binphilxiao/AxisLabs/GR0102/Certification/Doc provided/SmartShade Spec.md

**Model:** GR-0203
**Dimensions:** 1.8 x 1.8 x 5.1 in
**Power:** Optional 12V⎓2.0A Adapter (with 9 ft. cable)
**Operating Humidity:** 10% to 85%
**Compatibility:** #10 size beaded chain
**Weight:** 330 g
**Radio Frequency:** 2.4 -2.48GHz
**OS Requirements:** iOS - 16 or later, Android - 8.0 or later
**Connectivity:** Bluetooth LE
**Radio Power:** +8 dBm
**Operating Temperature:** 0°C to 40°C (32°F to 104°F)
**Supported Shade Sizes:** Up to 9 x 9 ft. or 10 lbs of weight
