binphilxiao/AxisLabs/RC0101&DC0101/Docs/Preliminary Industrial Design_Remote_BIN.pptx

## Remote Controller

Preliminary Industrial Design

## Slide 2

Front

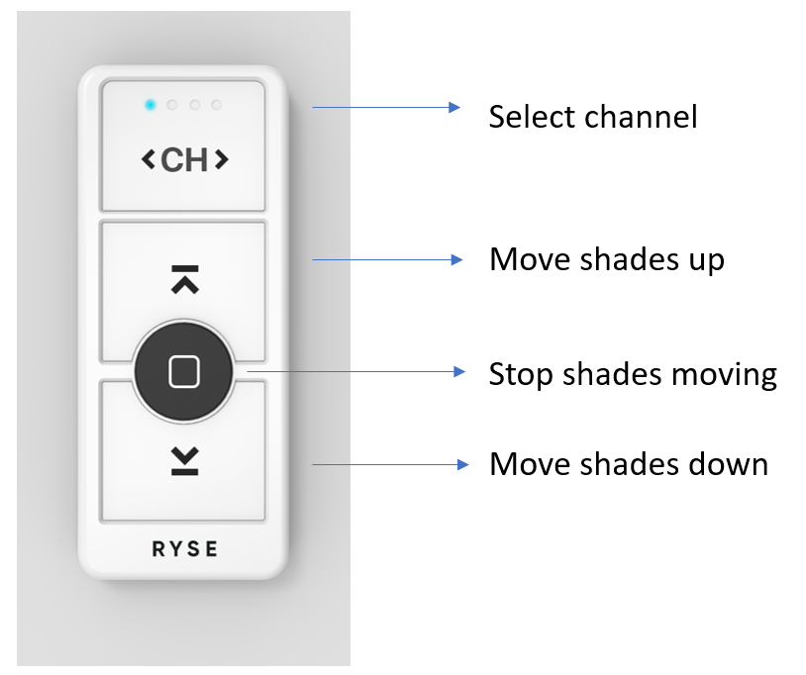
[picture p1: figure]

## Slide 3

Back

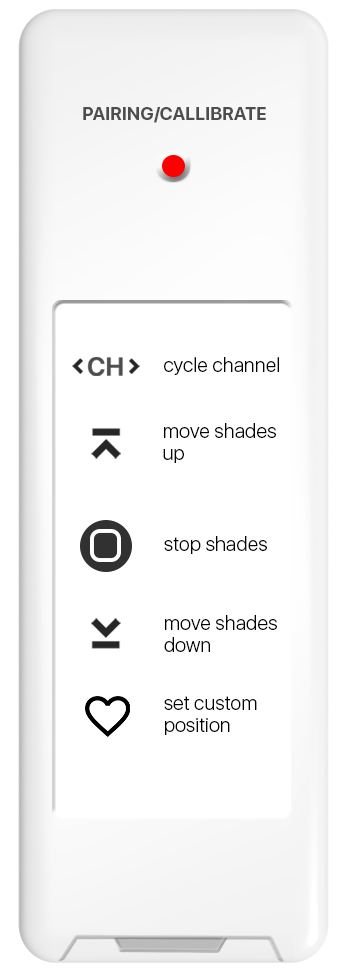
[picture p2: figure]

Reset button

Coin cell Battery Slot
(Doesn’t have to be here)
