binphilxiao/AxisLabs/PositionTracker/Fabric tracker.pptx

## Fabric tracker design thoughts

2024.05

## Inatallation

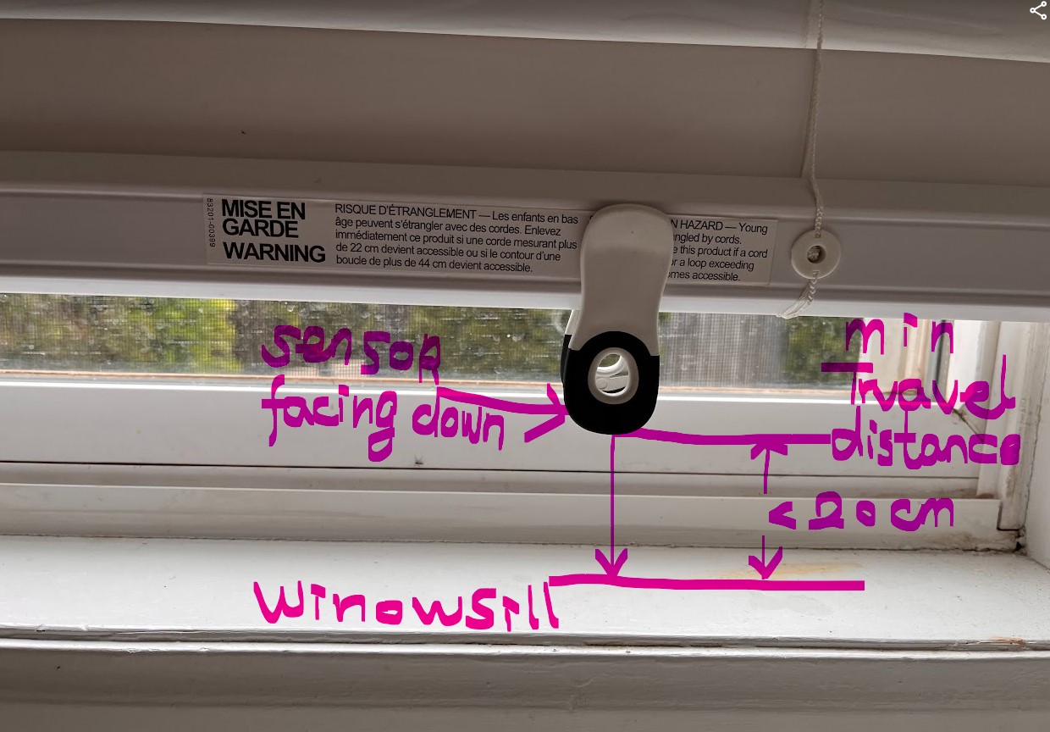
[picture p11: figure]

- Fabric tracker is installed on the bottom rod and looks like a clamp on the bottom rod.
- Time-of-flight sensor is facing down and measure the distance between the sensor and the window sill

## Operation

- Assume that the shade move 10cm/s.
- The sensor will measure the distance every 2S.
- The sensor will report each measure that is <=20cm to SmartShade and Smartshade can compensate.

## Diagram

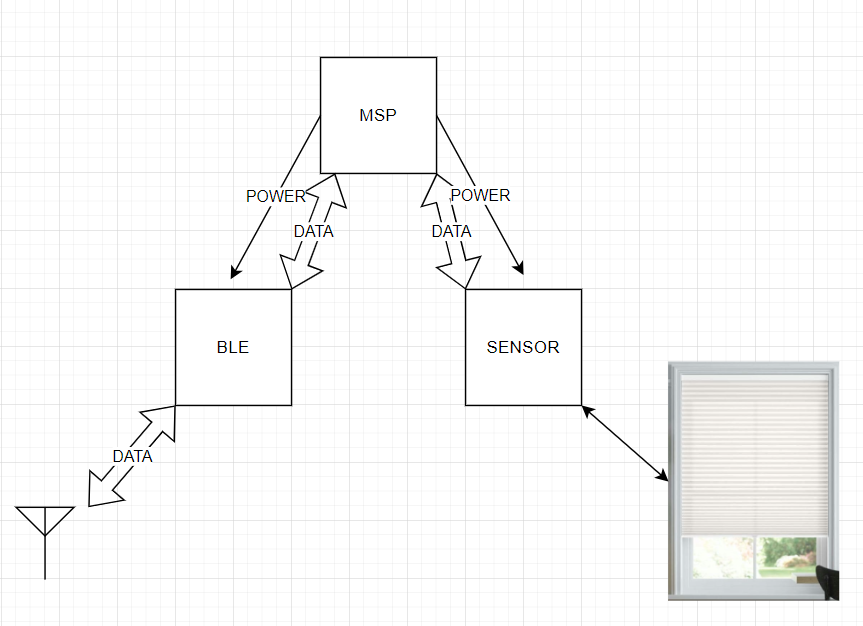
[picture p12: figure]

- MSP controls the power of BLE module and TOF sensor
- MSP get data from TOF and sent it through BLE to Smartshade

## Multi-host and other issues

- The Fabric tracker will be a host in BLE connection.
- Conflicts when Fabric tracker try to sent message and SmartShade is connected to a Mobile, Bridge or Remote ???
- Maybe message sent via broadcasting ???

## TOF sensor

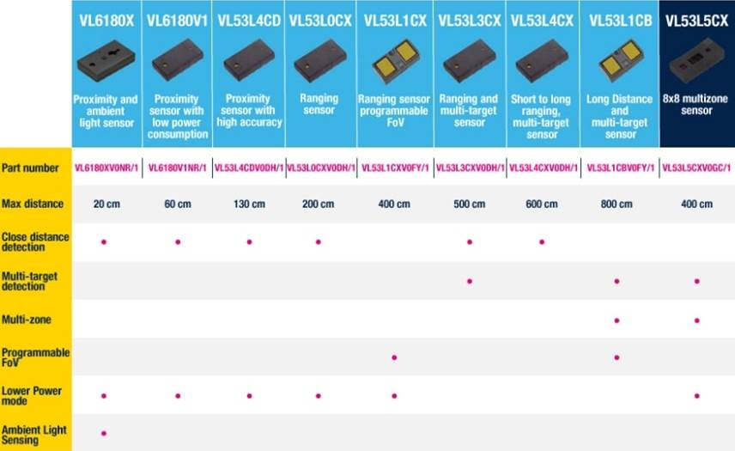
[picture p13: figure]

## BLE module

- ESP32-C3 single chip
- ESP32-C3-MINI-1-N4
- ESP32-C3-WROOM-02

## Power consumption

- Power consumption of TOF sensor(2s interval)
- Power consumption of BLE module(ESP32-C3-WROOM-02U-N4).
(it only works when d <20 cm is detected and only report once.)
- Power consumption of MSP MCU(MSP430FR2311 as example)
standby all the time

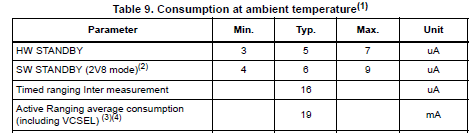
[picture p14: figure]
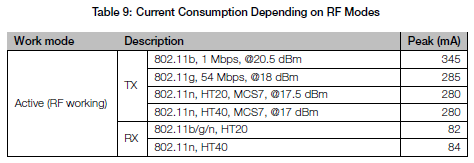
[picture p15: figure]

## Cost estimate

- ESP32-C3-WROOM-02U-N4
- VL53L0X
- MSP
- A boost converter
- Battery
- Plastic

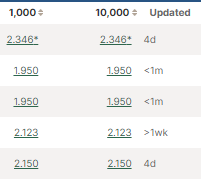
[picture p16: figure]
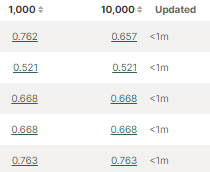
[picture p17: figure]

## The other way to communicate

- Fabric tracker is a z-wave like accessary. It attaches the Smartshade and use MFP to communicate.
- The sensor detect if the window shade is blocking or not.
- It save the money spend on BLE module and batteries.

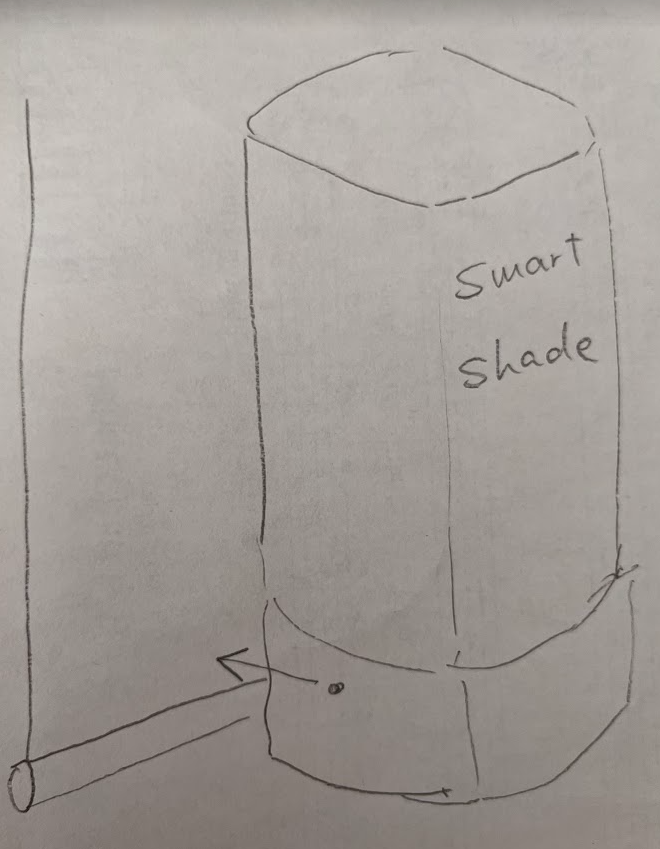
[picture p18: figure]

## Use a buzzer or ultrasound to communicate

- We need to modify Smartshade
- Can not share time stamp and other details?

## Design support

- FW
  - FW in SmartShade monitors messages from Fabric tracker.
  - Decode timestamp and sensor value.
  - Do necessary smooth and average.
  - Estimate speed of window shade.
  - Do compensation
- ID
  - Concepts
- Mechanical
  - Mechanical design, demo, tooling
- Mobile
  - At configuration state, Mobile scan a code on Fabric tracker(maybe MAC)
  - Sync time stamp, position, and speed.
