binphilxiao/AxisLabs/GR0102/Certification/Doc provided/Submitted/QB-Pub-7.1-013-8 化学开案申请表 (通用) RoHs WEEE.docx

以下内容为倍科内部填写： Fill in the item below by BACL only | | Report No.报告号:
Test Start Date测试开始日期： | | Sales Name 销售代表： | | Check By 审核：
Committed Day 结 案 日 期： | | Ext. 分机号： | | Quo. No. 合同号：
CS 客服部确认（样品状态）： | | Accountant财务部确认： | | Engineering工程部确认：

以下内容请客户填写Fill in the item below by customer

Report Required 报告要求 [ ] English 英文 [ ] Chinese中文 [ ] English and Chinese comparison中英文对照 | | | | “” means must be filled items. one application form one report “”号处为必填项目，一份申请表对应一份报告； Default english report, RMB 200 reporting surcharge will be billed if request Chinese-English report. Fax, copy of the application both valid, our test result only responsible for submitted samples. 默认为英文报告，如增加中英文报告，加收200元报告费。该申请表传真件、复印件均有效，实验室的测试结果只对来样负责。
Company Name | RYSE Inc. 公司名称：
Address： | 20 Camden St. Suite 200, Toronto, Ontario, M5V 1V1 Canada 公司地址：
Contact Person联系人： Trung Pham | | | | | Telephone电话/ Fax传真： +1(929)219-3299 / +1(877)563-5047 | | | | E-Mail 电子邮件：support@helloryse.com

请填写以下样品信息：Please test the sample identified as below :

声明Declaration：送测的样品具有Sample Properties: [ ] 危险性Dangerous [ ] 腐蚀性Corrosive [ ] 毒性Toxicity [ ] 易燃易爆Iinflammable and Explosive [ ] 放射性Radioactivity [ ] 其他Others 请注明Pls Specify：_______

测试样品量Sample Weight：[ ] 部件Component：Cd/Pb/Hg (20g/sample)；Cr⁶⁺ (100cm² /sample)；PBBs&PBDEs (20g/sample) [ ] 整机Whole machine：more than 2Sets 2套以上
Sample Description 样品描述: | | | Style/Item No. 型号： | | | | | P.O. No. 订单号：
Sample quantity样品数量： | | | Country of Origin 原产地： | | | | | /Country of Destination 目的地：
Supplier供应商： | | | Manufacturer制造商： | | | | | Buyer买家： Brand 品牌商：

如果您的报告还需要注明其他项目，请说明： If you need other items in report, please specify

Test Required测试项目：(请在所需测试项目前打“[x] ”，以下项目如有指定测试方法请注明). 请务必提供不少于指定重量（或表面积）的样品以避免因样品不足补样而造成的时间损失。Please draw[x] In your choice items and .specify the test method in the following items for your special requirements. pls supply no less than specified sample weight to avoid to waste test time due to sample shortage.

测试的方法/标准test method(请在相应的前面打“[x] ”,如果没有指定，默认为IEC 62321。Please draw [x] on your choice method, default method is IEC 62321.)

[x] IEC 62321 [ ] US EPA [ ] SJ/T 11365:2006 [ ] SN/T2004 [ ] ISO 3613 [ ] GB/T26125:2011[ ] GB/T20155:2006 [ ] GB/T26572-2011[ ] Others其它

[x] RoHS directive指令(请在相应的测试项目前打“[x] ” Please draw [x] on your choice items)

[ ] XRF Scan 扫描测试：[ ] Cd镉: [ ] Pb铅；[ ] Hg汞； [ ] Cr铬； [ ] Br溴； [ ] All所有五项 [ ] Others 其他

[ ] Chemical test化学测试：[ ] RoHS 两项：PBBs多溴联苯；PBDEs多溴二苯醚 [ ] RoHS 四项：Cd镉；Pb铅；Hg汞；Cr⁶＋六价铬 [ ] RoHS六项：Cd镉；Pb铅；Hg汞；Cr⁶＋六价铬；PBBs多溴联苯；PBDEs多溴二苯醚 [ ] RoHS十项：Cd镉；Pb铅；Hg汞；Cr⁶＋六价铬；PBBs多溴联苯；PBDEs多溴二苯醚；DEHP邻苯二甲酸二(2-乙基己基)酯；BBP邻苯二甲酸丁苄酯；DBP邻苯二甲酸二丁基酯；DiBP邻苯二甲酸二异丁基酯[ ] XRF Scan 扫描+Chemical test化学测试: [ ] ROHS1.0（6 项）； [ ] ROHS2.0（10项）；[ ] Others 其他

[x] WEEE directive指令

[ ] EC No. 1907/2006 REACH regulation SVHC高度关注物质

[ ] Other Chemical test items(as below) 其他化学测试项目(如下)：

[ ] SCCP 短链氯化石钠 [ ] HBCDD 六溴环十二烷 [ ] PAH 多环芳香烃（[ ] 8种/[ ] 18种）[ ] TBBPA 四溴双酚A [ ] BPA 双酚A [ ] PFOA, PFOS全氟辛酸铵/全氟辛烷磺酸盐 [ ] 欧盟电池指令(2006/66/EC) [ ] 94/62/EC欧盟包装指令 [ ] PCBs 多氯联苯 [ ] Halogen 卤素（[ ] F/ [ ] Cl/ [ ] Br/ [ ] I） [ ] 美国电池指令（HR.2024））[ ] TPCH/CONEG美国包装指令 [ ] Be content 铍含量 [ ] Hg content 汞含量 (SOR/2014-254) [ ] Others 其他

[x] CA65 加州65法案: [ ] Pb铅 [ ] Cd镉 [ ] Phthalates 邻苯二甲酸盐 P

[ ] Organotin 有机锡 : [ ] TBT 三丁基锡 [ ] 二丁基锡DBT [ ] 一丁基锡MBT [ ] TPhT三苯基锡 [ ] others:TTBT / MOT / DOT / TPT / TCyT / MPhT / DPhT / TOT

判定规则Decision Rule：[ ] 不需要判定No Need

[ ] 根据申请商提供的判定规则According to the rule provided by the applicant. (是否考虑不确定度consider the uncertainty or not：[ ] 否No [ ] 是Yes)

[x] 根据产品法规According to Product Regulations（是否考虑不确定度consider the uncertainty or not：[x] 否No [ ] 是Yes）

Service Required 服务类型：(请在相应选择上打“[x] ”，普通测试星期六，日及节假日不计入工作日内 Saturday, Sunday and holiday not count in workdays)

仅化学测试周期：[x] Regular Service, 5 workdays标准服务, 5个工作日完成; [ ] Express Service (50%Surcharge), 3 workdays加急服务, 加收50%费用, 3个工作日完成; [ ] Emergency Service(100% Surcharge), 1.5 workdays特急服务, 加收100%费用, 1.5个工作日完成;

扫描和扫描+化学测试周期（依据实际样品）：[ ] 7 workdays 7个工作日 [ ] 8 workdays 8个工作日 [ ] 9 workdays 9个工作日 [ ] 其它others：

Report Delivery取报告方式：[x] self Pick-up自取 [ ] express快递(预收费RMB：15) [x] E-mail 邮件__bin@helloryse.com____

Report Delivery To 报告寄往(中文)：bin@helloryse.com Return Sample样品退回： [x] Yes [ ] No

同意倍科集团内分包Agree with subcontracting within BACL Group if need: [x] 是Yes [ ] 否 No
Authorized Signature 申请人签名(盖章)： | | | | | | Date 日期：

※ 客户必须保证所提供的测试样品材质与最终销售产品材质的一致性，否则，本公司不负任何责任！Customer must ensure the submitted sample is consistent with the final products placed in the market, or else , BACL will not be liable for any responsibility. Version 2.0 （2019-09-17） Page 1 of 1 QB-Pub-7.1-013-1

CHEMICAL TESTING APPLICATION FORM 化学测试申请表(电子电器产品)
