binphilxiao/AxisLabs/BR0101/doc/MFI343S00177-L_Mechanical.pdf

... ‘

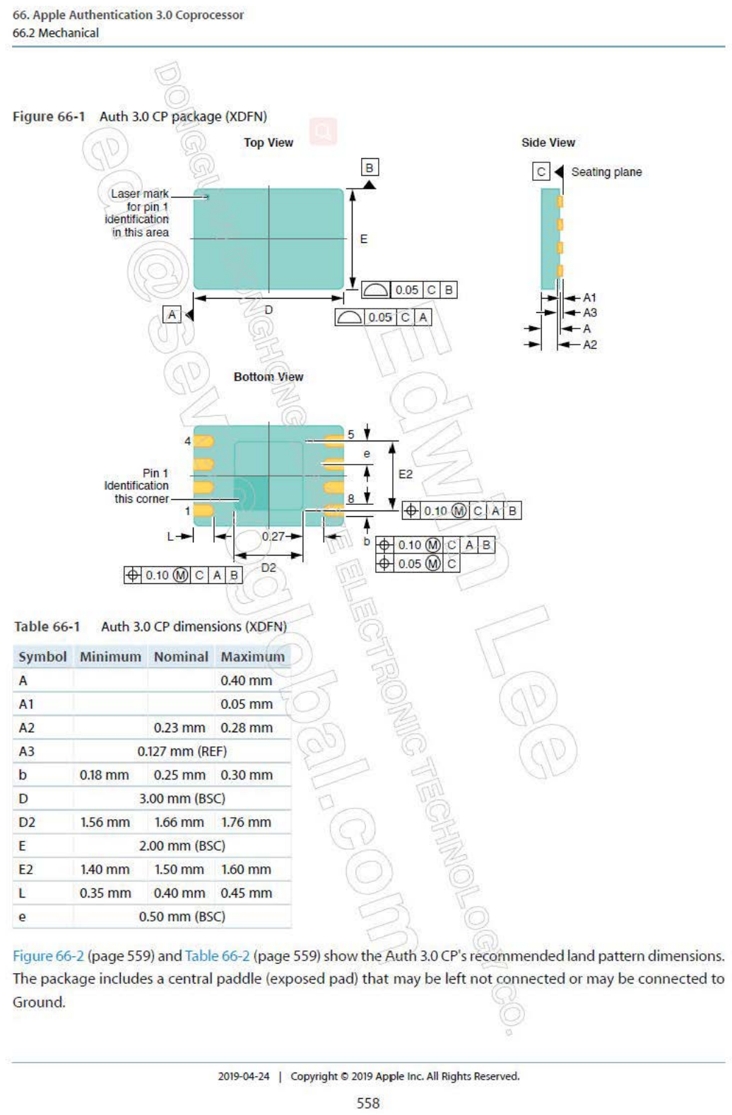
[picture p19: page 1]

66. Apple Authentication 3.0 Coprocessor 66.2 Mechanical

Figure 66·1Auth3.OCPRqEHage {XDFN}

F Laser"mruk ----1!::
10r pin 1 r
identifîcation
his rea

TOp View

BottorÍ1 View

E

### lol o.05 ~

U~1 905 I>.

I

Table 66-1 Auth 3.0 CP dimensions (XOFN)

Symbol Minimum Non>inal Maximum
A | 0.40mm . A1 | 0.05 mm
A2 | 0.23 mm 0.28mm
A3 | 0.127 mm (REF)
b | 0.18 mm | 0.25 mm 0.30 mm
D | 3.00 mm (B5C)
02 | 1. 56 盯1m | 1.66 mm 1.76 mm
E | 2.00 mm (BSC)
E2 | 1.40 1m | 1.50 mm 1.60 町、
L | 0.35 mm | 40 町、 | 0.45mm
e | 0.50 mm (BSC)

Side

plane

Figure 66.2 (page 559) and Table 66-2 (page 559) show the 8uth 0ζp s rRFDmmended |and pattem dimensions-The package includes a central pacldle (exposecl pacl) that may be left not connected or may be connect ecl to Grouncl.

01 9-04剖 | Copyrìght Q 2019 Appl. 10(. AIl Rìghts Reserved
| 558

xt 8

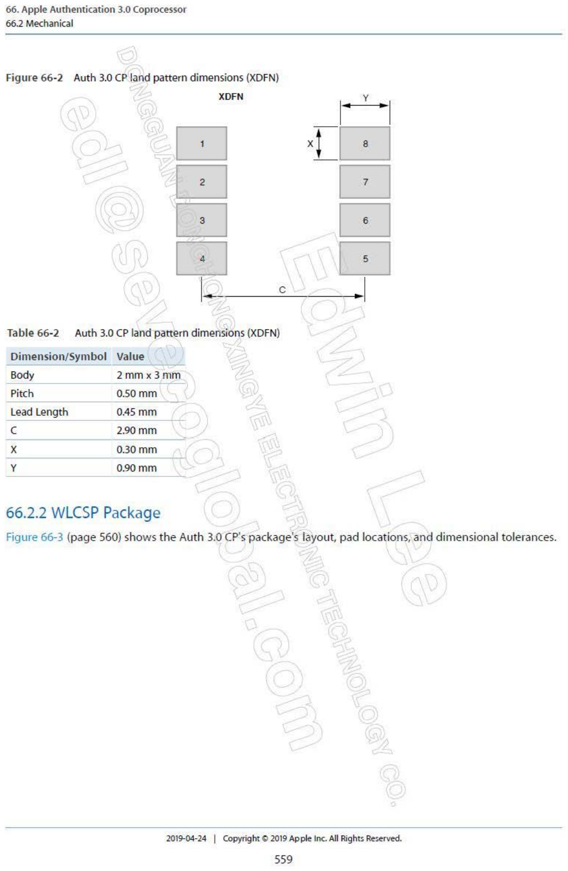
[picture p20: page 2]

66. Apple Authentication 3.0 Coprocessor 66.2 Mechanical

Figure 66.2 Auth 3.0 CP lal1d ern dimensions (XDFN) XDFN

ι

，飞
Table 66.2 | Auth 3.0 CP land p': | rn dimensions (XDFN)

Dimension/Symbol Value
Body | 2 mm x 3 mm
Pitch
Lead Length
c

X
Y

0.50 mm
0.45 mm
2.90 mm

0.30 IT飞
0.90 mm

## 66.2.2 WLCSP Package

Figure 66-3 (page 560) shows the Auth 0ζ s | ag | làyout pad locations,.and dimensional tolerances.
争饵 | ζ0 rig | Q 2019 Appl. 1n(. AII Rights Reserved.
| | 559
