binphilxiao/AxisLabs/ZW0101/2024.08-ZwaveTestJig/doc/PinoutName.pdf

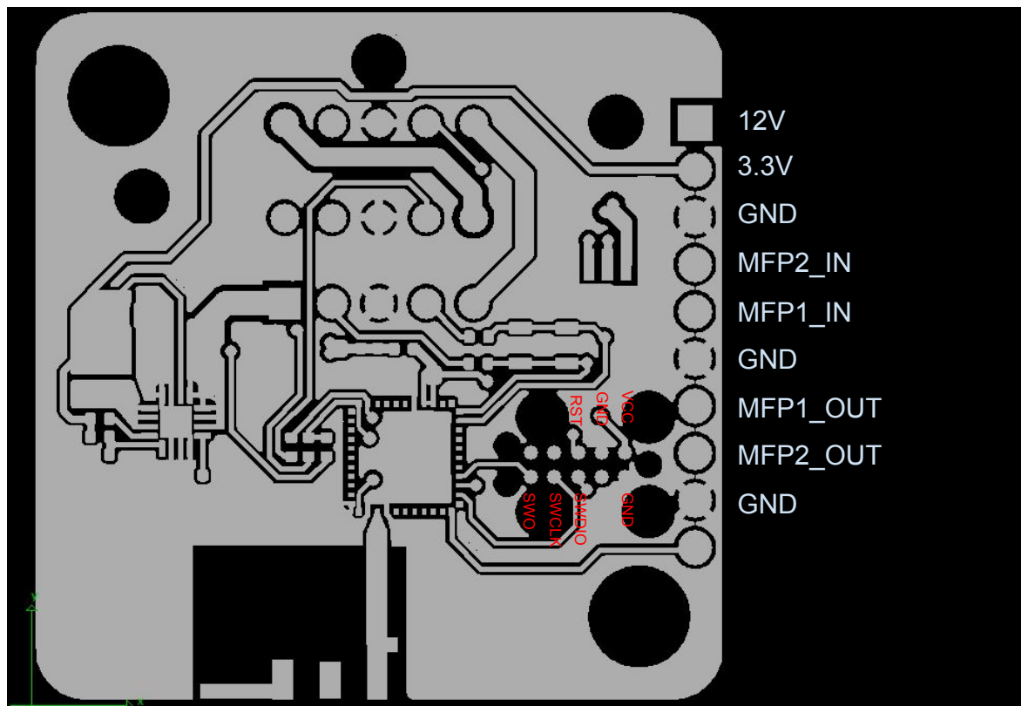
[picture p21: page 1]

12V

3.3V

MFP1_IN

GND

MFP1_OUT

MFP2_IN

GND

GND

MFP2_OUT

RST

GND

VCC

SWO

SWCLK
SWDIO

GND
