binphilxiao/AxisLabs/GB0102/2025.09.11_Rev.F/CN3303.pdf

# 如韵电子 CONSONANCE

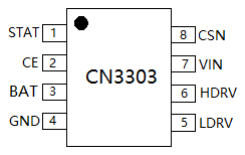
[picture p23: figure]

www.consonance-elec.com | 1 | REV 1.1

# PFM 升压型三节锂电池充电控制集成电路

CN3303

概述：

CN3303是一款工作于2.7V到6.5V的PFM升压型三 节锂电池充电控制集成电路。CN3303采用恒流和
准恒压模式(Quasi-CVTM)对电池进行充电管理，内 部集成有基准电压源，电感电流检测单元，电池
电压检测电路和片外场效应晶体管驱动电路等，
具有外部元件少，电路简单等优点。
当接通输入电源后，CN3303进入充电状态，控制
片外N沟道MOSFET导通，电感电流上升，当上升
到外部电流检测电阻设置的上限时，片外N沟道
MOSFET截止，电感电流下降，电感中的能量转
移到电池中。当电感电流下降到外部电流检测电
阻设置的下限时，片外N沟道MOSFET再次导通，
如此循环。当BAT管脚电压第一次达到内部设置
的12.6V(典型值)时，CN3303进入准恒压充电模 式，以较小电流对电池充电。只有当BAT管脚电
压第二次达到12.6V时，充电过程才结束，片外N
沟道MOSFET保持截止状态。当BAT管脚电压下
降到再充电阈值时，CN3303再次进入充电状态。
CN3303最高工作频率可达1MHz，工作温度范围
从－40℃到＋85℃。
当电池电压低于输入电压或电池短路时，CN3303
在片外N沟道MOSFET和P沟道MOSFET的共同作 用下，用较小电流继续对电池充电，对电池起到
保护作用。
其他功能包括芯片使能输入，状态指示输出端等。
CN3303采用8管脚的SOP8封装。

应用：

⚫ | 三节锂电池充电控制
⚫ | 按摩机，筋膜枪等
⚫ | 音响
⚫ | 独立充电器

特点：

⚫ | 输入电压范围：2.7V 到 6.5V
⚫ | 工作电流：280微安@VIN=5V
⚫ | 电感电流检测
⚫ | 高达1MHz开关频率
⚫ | 准恒压充电模式补偿电池内阻和电池连接线
| 电阻产生的电压损失
⚫ | 自动再充电功能
⚫ | 高达35W输出功率
⚫ | 当电池电压低于输入电压或者电池短路时，
| 以较小电流充电。
⚫ | 输入电源的自适应功能
⚫ | 芯片使能输入端
⚫ | 电池端过压保护
⚫ | 状态指示输出
⚫ | 工作温度范围：－40℃到85℃
⚫ | 8管脚SOP8封装
⚫ | 产品无铅，满足rohs指令要求，不含卤素

## 管脚排列图：

注：Quasi-CV 是如韵电子注册商标

## 典型应用电路：

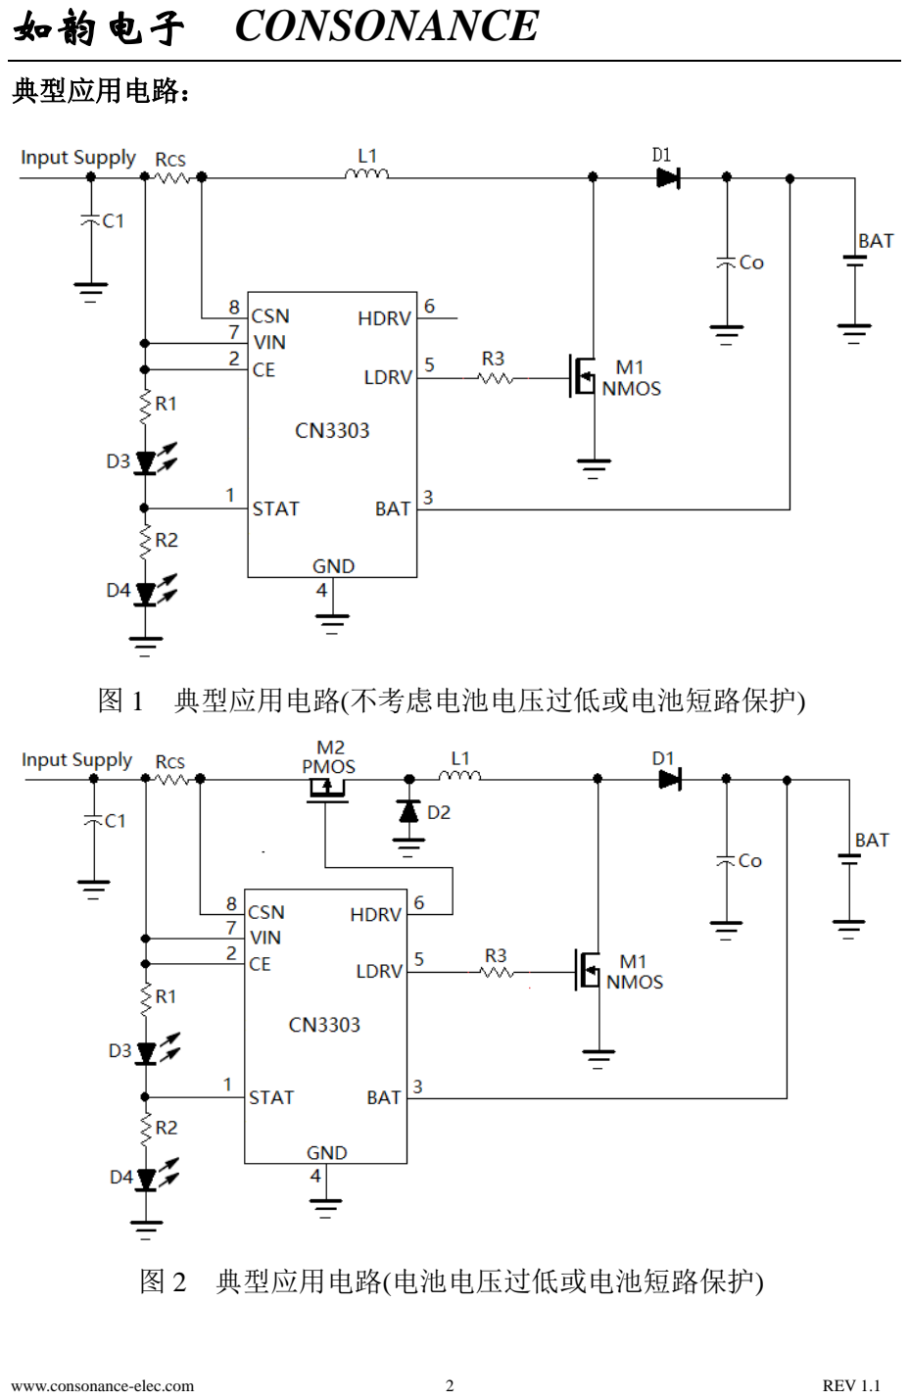
[picture p24: page 2]

www.consonance-elec.com | 2 | REV 1.1

## 图 1 典型应用电路(不考虑电池电压过低或电池短路保护)

## 图 2 典型应用电路(电池电压过低或电池短路保护)

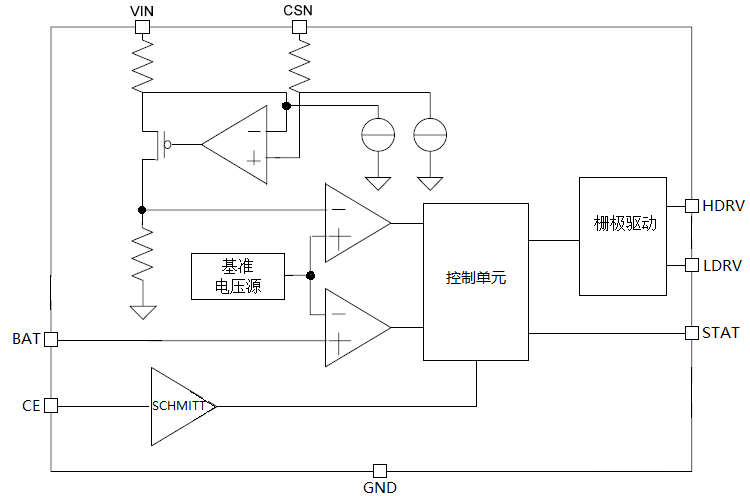
[picture p25: figure]

www.consonance-elec.com | 3 | REV 1.1

## 订购信息：

器件型号 | 封装形式 | 包装 | 工作环境温度
CN3303 | SOP-8 | 盘装，每盘 4000 只 | －40℃ 到 85℃

## 功能框图：

## 图 3 功能框图

www.consonance-elec.com | 4 | REV 1.1

## 管脚描述：

序号 | 名称 | 功能描述
1 | STAT | 充电状态指示输出端。CMOS输出端，当此管脚为高电平时，表示充电器 处于充电状态；当此管脚为低电平时，表示充电器处于充电结束状态。
2 | CE | 芯片使能输入端。高输入电平将使CN3303处于正常工作状态；低输入电平 使CN3303处于被禁止状态。 CE管脚可以被TTL电平或者CMOS电平驱动。
3 | BAT | 电池电压反馈输入端。此管脚直接连接到电池正极以检测电池电压。
4 | GND | 电源地。输入电源和电池的负极。
5 | LDRV | 片外N沟道功率管栅极驱动端。连接到外部N沟道场效应晶体管（MOSFET） 的栅极。
6 | HDRV | 片外P沟道功率管栅极驱动端。连接到外部P沟道场效应晶体管（MOSFET） 的栅极。 当不需要考虑电池电压过低保护或者电池端短路保护时，不需要使用外部 的P沟道场效应晶体管，此管脚悬空即可。
7 | VIN | 电源正输入端。VIN管脚为CN3303内部电路提供工作电源，同时也是电感 电流 (输入电流)检测的正输入端。
8 | CSN | 电感电流检测负输入端。在VIN管脚和CSN管脚之间接一个电流检测电阻 RCS，用以检测电感电流 (输入电流)。正常工作时，(VIN－CSN)的上限为 125毫伏(典型值)，下限为85毫伏(典型值)。

## 极限参数

VIN，CSN 和 CE 管脚电压 | －0.3V to 7.0V | 最大结温 | 150℃
BAT 管脚电压 | －0.3V to 18V | 工作温度范围 | －40℃ to 85℃
CSN 与 VIN 管脚电压 | －0.3V to 0.3V | 存储温度 | －65℃ to 150℃
STAT，LDRV 和 HDRV 管脚电压.. －0.3V to VIN | 焊接温度(10 秒) | 260℃

超出以上所列的极限参数可能造成器件的永久损坏。以上给出的仅仅是极限范围，在这样的极限条件下 工作，器件的技术指标将得不到保证，长期在这种条件下还会影响器件的可靠性。

www.consonance-elec.com | 5 | REV 1.1

## 电气参数：

(VIN = 5V，TA＝－40°C to +85°C，典型值在 TA＝+25°C 时测得，除非另有说明。)
参数 | 符号 | 测试条件 | 最小 典型 最大 | 单位
输入电压范围 | VIN | | 2.7 6.5 | 伏特
工作电流 | IVIN | VBAT＝12.9V，No Switching | 200 280 360 | 微安
关断电流 | Ioff | CE管脚低电平 | 0 2 | 微安
开关频率 | fSW | | 200 1000 | KHz
电感电流检测比较器
检测电压高端阈值 | VCSHI | 恒流 | (VIN－VCSN) 从0V上 升，直到 VLDRV ＜0.5V | 113 123 133 | 毫伏
| | 准恒压 | | 65 75 85
检测电压低端阈值 | VCSLO | 恒流 | (VIN－VCSN) 从0.2V 下降，直到 VLDRV＞ (VCC－0.5V) | 77 87 97 | 毫伏
| | 准恒压 | | 32 42 52
输出高电平传输延时 | tDPDH | (VIN－VCSN)：0.15V到0.075V | | 72 | 纳秒
输出低电平传输延时 | tDPDL | (VIN－VCSN)：0.06V到0.135V | | 66 | 纳秒
CSN管脚输入电流 | ICSN | | | 1 | 微安
BAT管脚
BAT管脚充电终止阈值 | Vterm | BAT管脚电压上升 | 12.478 12.6 12.726 | 伏特
BAT管脚再充电阈值 | Vrech | BAT管脚电压下降 | 11.95 12.14 12.33 | 伏特
BAT管脚电流 | IBAT | VBAT＝12.6V | 10 14 18 | 微安
电池过压保护阈值 | VOV | BAT管脚电压上升 | 1.044 1.0663 1.088
| VOVRLS | BAT管脚电压下降 | 1.003 1.0249 1.047 | %Vterm 电池过压释放阈值

LDRV管脚
LDRV管脚输出电流 | | VCSN＝VIN, VDRV＝0.5×VCC | 0.65 | 安培
LDRV管脚下拉电流 | | VCSN＝VIN－0.2V， VLDRV＝0.5×VCC | 0.65 | 安培
LDRV输出高电平 | VOH | ILDRV＝5mA | VCC－0.3 | 伏特
LDRV输出低电平 | VOL | ILDRV＝－5mA | 0.3 | 伏特
HDRV管脚
HDRV管脚输出电流 | | VCSN＝VIN, VDRV＝0.5×VCC | 0.8 | 安培
HDRV管脚下拉电流 | | VCSN＝VIN－0.2V， VHDRV＝0.5×VCC | 0.8 | 安培
HDRV输出高电平 | VOH | IHDRV＝5mA | VCC－0.3 | 伏特
HDRV输出低电平 | VOL | IHDRV＝－5mA | 0.3 | 伏特
CE管脚
输入低电平 | VCEL | CE电压下降 | 0.7 | V
输入高电平 | VCEH | CE电压上升 | 2.2 | V
输入电流 | ICEL | CE=GND，VIN=6V | －1 | 微安
| ICEH | CE=VIN=6V | 1
STAT管脚
下拉电流 | ISINK | VSTAT=0.3V，结束模式 | 10 | mA
输出电流 | ISRC | VSTAT=4.7V，充电模式 | 10 | mA

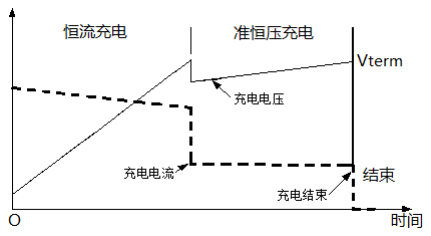
[picture p26: figure]

www.consonance-elec.com | 6 | REV 1.1

## 详细描述：

CN3303是一款PFM升压型三节锂电池充电控制集成电路。CN3303输入电压范围2.7V到6.5V，内部集成有 基准电压源，电感电流检测单元，电池电压检测电路，输出过压保护电路，电池电压过低保护单元，控 制单元和片外场效应晶体管驱动电路等，非常适合5V输入，为三节锂电池的充电控制应用，具有外部元 件少，功能多，电路简单等优点。
当接通输入电源后，CN3303进入充电状态，STAT管脚输出高电平，片外N沟道场效应晶体管导通，电感 电流上升，输出电容中的能量转移到电池中。当电感电流上升到外部电流检测电阻设置的上限时，片外N 沟道场效应晶体管截止，电感电流下降，电感中的能量转移到输出电容和电池中。当电感电流下降到外 部电流检测电阻设置的下限时，片外N沟道场效应晶体管再次导通，如此循环。电池电压经过芯片内部的 电阻分压网络反馈到电压比较器，当BAT管脚电压第一次达到12.6V(典型值)时，经过去抖动延时后， CN3303进入准恒压充电状态，输入电流降低到恒流时的60%，所以充电电流也降低。当电池电压第二次 达到12.6V时，经过去抖动延时后，充电过程结束，片外N沟道MOSFET截止，CN3303进入充电结束状态， STAT管脚输出低电平。在充电结束状态，没有电流从输入端流向电池。当BAT管脚电压下降到再充电阈 值12.142V(典型值)时，CN3303再次进入充电状态。CN3303最高工作频率可达1MHz。 CN3303为升压型充电控制集成电路，正常情况下，电池电压高于输入电压。在某些情况下，如果电池电 压低于输入电压，甚至电池短路，那么片外N沟道场效应晶体管关断时间延长，充电电流变小，对电池起 到保护作用。
其他功能包括芯片使能输入端，BAT管脚过压保护等。

充电过程如图4所示。

## 图4 充电过程示意图

www.consonance-elec.com | 7 | REV 1.1

## 应用信息：

输入电压范围
CN3303 在输入电压在 2.7V 到 6.5V 的范围内均能正常工作。CN3303 内部有输入电源低电压检测电路， 如果输入电压小于 2.65V(最大值)，那么 CN3303 被关断。
芯片使能／关断
当 CE 管脚电压低于 0.7V 时，CN3303 被关断。为了使 CN3303 正常工作，在 CE 管脚需要施加 2.2V 以 上的电压。当 CN3303 被关断时，芯片内部电路被关断。
不要在 CE 管脚施加 0.7V 到 2.2V 电压，否则将使 CN3303 处于不确定状态，并消耗比较大的电流。 关于准恒压（Quasi-CV）充电模式
CN3303 先以恒流模式对电池充电，当电池(BAT 管脚)电压第一次达到充电终止电压 12.6V(典型值)时， CN3303 进入准恒压模式，此时输入电流降低到恒流时的 60%，所以充电电流变小，此时 CN3303 继续 对电池充电，直到电池电压再次达到充电终止电压 12.6V 时，经过去干扰延时后，CN3303 才结束充电。 此充电过程可以部分补偿电池内阻和电池连接线的电阻等引起的电压损失，类似于通常的恒压充电过程， 所以称为准恒压充电过程。
电感电流(输入电流)
在图1和图2所示的电路中，CN3303通过连接在VIN和CSN管脚之间的电流检测电阻RCS设置电感电流。 当外部N沟道场效应导通时，输入电源向电感充电，电感电流上升，当电感电流上升到(典型值)：
ILhigh = 0.123V / RCS | （恒流模式）
ILhigh = 0.075V / RCS | （准恒压模式）
外部N沟道场效应晶体管截止，电感电流开始下降，电感中的能量转移到输出电容和电池中。当电感电流 下降到(典型值)：
ILlow = 0.087V / RCS | （恒流模式）
ILlow = 0.042V / RCS | （准恒压模式）
外部N沟道场效应晶体管再次导通，开始新的周期。
所以，电感平均电流为： | IL = 0.105V / RCS | （恒流模式）
| IL = 0.06V / RCS | （准恒压模式）
在上面的三个公式中，
ILhigh是电感电流上限，单位是安培(A)
ILlow是电感电流下限，单位是安培(A)
RCS是电感电流检测电阻值，单位是欧姆(Ω)
计算开关频率和电感值
在图1所示的应用电路中，外部N沟道场效应晶体管导通时间为：

外部N沟道场效应晶体管截止时间为：

所以CN3303开关频率为：

www.consonance-elec.com | 8 | REV 1.1

CN3303要求根据上式计算的开关频率不小于200KHz。一般开关频率选择在300KHz到600KHz之间可以达 到比较好的转换效率和电感尺寸平衡。
开关频率随着输入电压和电池电压的变化而变化，所以在确定开关频率时，电池电压选用标称电压11.1V。 根据输入电压范围，充电电流和开关频率的要求，一般电感值在4.7uH与22uH之间可以满足要求。 CN3303的LDRV管脚输出脉冲信号占空比为：

在上面的两个公式中，L为电感值，单位为亨利（H）
VIN为输入电压，单位为伏特（V）
VBAT为电池电压，单位为伏特（V）
VD为二极管D1的正向导通电压，单位为伏特（V）
RCS为电感电流检测电阻，单位为欧姆(Ω)
估算恒流模式充电电流
CN3303是通过监测电感电流（输入电流）而控制充电电流，所以恒流模式充电电流会随输入电压和电池 电压的变化而变化。
一般情况下，可通过下面的公式估算恒流模式充电电流：

其中， ICH是流向电池的充电电流，单位为安培(A) VIN是输入电压，单位为伏特(V) IL是电感平均电流，为0.106／RCS，单位为安培(A) η是转换效率，一般在80%到90%之间，可取典型值85% VBAT是电池电压，单位为伏特(V)

充电结束
当 BAT 管脚电压达到 12.6V(典型值)时，充电过程结束，片外 N 沟道场效应晶体管截止，CN3303 进入 充电结束状态。在充电结束状态，没有电流从输入端流向电池。
再充电
在充电结束状态，当 BAT 管脚电压下降到再充电阈值 12.14V(典型值)时，CN3303 再次进入充电状态。 N沟道MOSFET的选择
CN3303需要使用一个外部N沟道场效应晶体管。选择场效应晶体管应考虑最高电池电压，电感电流，开 启电压，导通电阻和栅极总电荷等因素。MOS场效应晶体管的击穿电压应该大于最高电池电压；较低的 导通电阻和较低的总栅极电荷(Qg)有助于提高效率；开启电压要保证MOS场效应晶体管在工作电压最低 端仍能完全导通。
二极管的选择
为了提高效率，在图1和图2中的二极管D1的正向导通电压要尽量低，最好使用肖特基二极管；二极管通 过电流能力要比充电电流大；击穿电压要大于最高电池电压。 图2中的二极管D2只在输入电压大于电池电压的情况下才使用，此时电感电流明显降低。所以二极管D2 的正向导通电压要尽量低，最好使用肖特基二极管；二极管通过电流能力要比电感电流大；击穿电压要 大于最高输入电压。
输入电容
电源输入端VIN和地之间需要接一个至少为4.7微法的陶瓷滤波电容(图1和图2中的C1),如果电感电流比 较大，或者输入电源的输出阻抗比较大，或者输入电源连接导线比较长，电容值要相应增加；电容的耐 压应高于最大输入电压。一般输入电容值在4.7uF到47uF之间，在频率为1MHz时具有比较低的阻抗。推

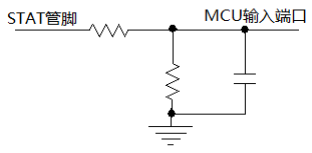
[picture p27: figure]
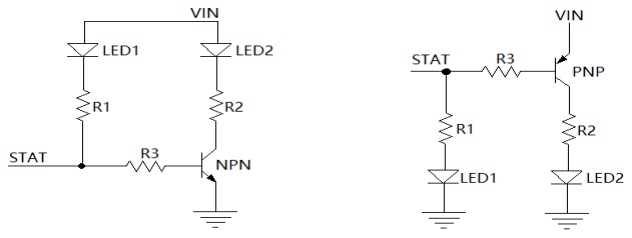
[picture p28: figure]

www.consonance-elec.com | 9 | REV 1.1

荐使用串联等效电阻(ESR)比较低的X5R或X7R贴片陶瓷电容或者贴片陶瓷电容与电解电容并联组成。 输出电容
在充电器的输出端到地之间需要电容对电池电压滤波(图1和图2中的Co)，以及在片外N沟道场效应晶体管 导通时向电池提供充电电流。
对输出电容的要求是有电池正极纹波电压的要求决定的。电池正极纹波电压由下式决定：

其中， ICH是电池端的充电电流
toff是片外场效应晶体管关断时间，由第6页公式(2)决定 Co是输出电容
Resr是输出电容串联等效电阻
Rcs是图1和图2中的电感电流检测电阻
所以要求输出电容的串联等效电阻要小，推荐使用串联等效电阻(ESR)比较低的X5R或X7R贴片陶瓷电容 或者贴片陶瓷电容与电解电容并联组成。
状态指示
CN3303的CMOS输出STAT管脚可以实现状态指示功能，在充电状态，STAT管脚输出高电平；在结束状态， STAT管脚输出低电平。
STAT管脚可以驱动发光二极管(LED)或者与单片机(MCU)接口相连。 在图1和图2中，STAT管脚驱动发光二极管。
当STAT管脚需要同单片机的输入端口连接时，如果CN3303工作电压大于单片机工作电压，那么可以通过 图5所示的电路。

## 图5 STAT管脚与工作电压低的单片机输入端口连接

如果STAT管脚需要驱动两颗共阳或者共阴的发光二极管，那么可以采用图6所示电路：

## 图6 驱动两颗共阳或共阴发光二极管

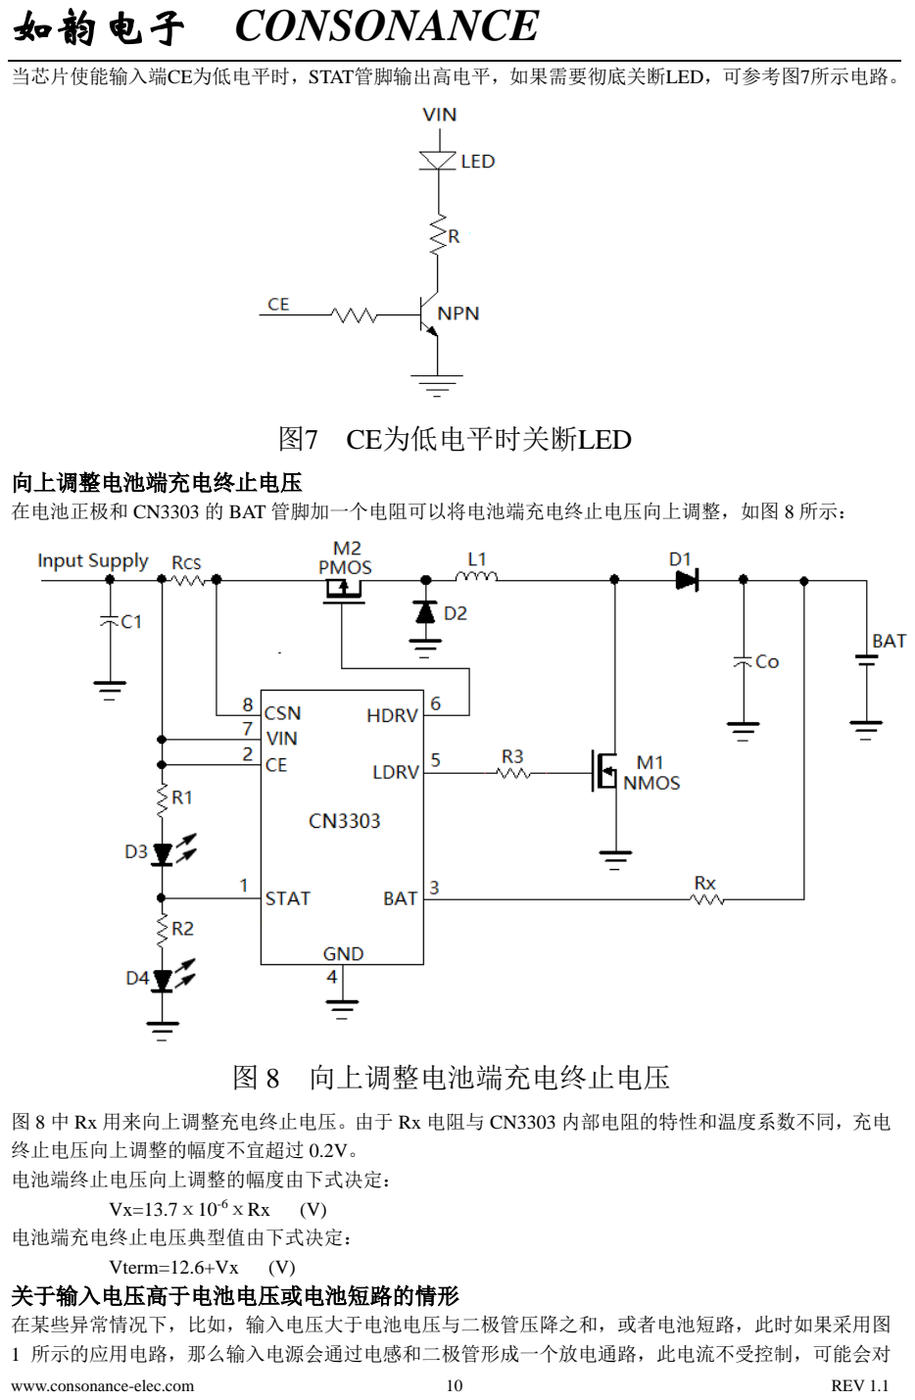
[picture p29: page 10]

www.consonance-elec.com | 10 | REV 1.1

当芯片使能输入端CE为低电平时，STAT管脚输出高电平，如果需要彻底关断LED，可参考图7所示电路。

## 图7 CE为低电平时关断LED

向上调整电池端充电终止电压
在电池正极和 CN3303 的 BAT 管脚加一个电阻可以将电池端充电终止电压向上调整，如图 8 所示：

## 图 8 向上调整电池端充电终止电压

图 8 中 Rx 用来向上调整充电终止电压。由于 Rx 电阻与 CN3303 内部电阻的特性和温度系数不同，充电 终止电压向上调整的幅度不宜超过 0.2V。
电池端终止电压向上调整的幅度由下式决定：
Vx=13.7ⅹ10⁻⁶ⅹRx (V)
电池端充电终止电压典型值由下式决定：

Vterm=12.6+Vx (V)
关于输入电压高于电池电压或电池短路的情形
在某些异常情况下，比如，输入电压大于电池电压与二极管压降之和，或者电池短路，此时如果采用图 1 所示的应用电路，那么输入电源会通过电感和二极管形成一个放电通路，此电流不受控制，可能会对

www.consonance-elec.com | 11 | REV 1.1

电池造成损坏。
此时如果采用图 2 所示应用电路，CN3303 的 LDRV 管脚和 HDRV 管脚会控制片外 N 沟道和 P 沟道场效 应晶体管，采用降压模式对电池充电。在前半个周期，N 沟道和 P 沟道场效应晶体管同时导通，输入电 源对电感充电；在后半个周期，N 沟道和 P 沟道场效应晶体管同时关断，电感通过二极管 D1 和 D2 向电 池释放能量，此半个周期至少维持 5 微秒，有效降低了充电电流，对电池起到保护作用。 关于输入电源自适应功能
CN3303 的输入电压范围在 2.7V 与 6.5V 之间，当输入电源的带载能力小于 CN3303 所设计的输入电流时， 输入电压会被拉低以满足 CN3303 输入电流要求，当输入电压降低到 2.38V 时（典型值），内部电路禁止 LDRV 管脚输出高电平，外部 N 沟道场效应晶体管关断；当输入电压上升到 2.5V 时（典型值），内部电 路允许 LDRV 管脚输出高电平，即允许对电池充电。依此循环，以适应输入电源的带载能力。 在输入电源自适应模式，输入电压可能会降低到 2.4V（典型值），所以须保证所选择的 MOS 晶体管在 2.4V 左右能够完全导通。
设计流程
可根据下面的流程设计CN3303的应用电路参数：
（1） 根据电池容量和充电时间要求确定所需要的充电电流。
（2） 根据输入电压范围，电池电压范围和充电电流，估算电感平均电流，也即输入电流。 （3） 根据输入电源特性，输入电源导线长度和输入电流确定输入滤波电容。
（4） 根据输入电压，电感电流和电池最高电压，选择二极管，N沟道和P沟道场效应晶体管。 （5） 根据电感平均电流计算电流检测电阻RCS
（6） 根据所需要的开关频率确定电感值。开关频率最低200KHz，最高1MHz。一般开关频率选择在 300KHz到600KHz之间可以达到比较好的转换效率和电感尺寸平衡。
（7） 根据选定的开关频率和充电电流，确定输出电容。
设计实例
下表列出了一些典型应用所对应的图 1 和图 2 中的电路参数。由于用户产品的技术要求，应用条件和应 用环境千差万别，下表所列信息是根据典型情况进行计算，仅供参考。用户需要根据产品的具体技术要 求，应用条件和应用环境等因素做差别设计。
下表电路参数都是针对输入电压范围 5V，为 3 节锂电池充电应用，充电截止电压典型值 12.6V。
| 充电电流 0.5A | 充电电流 1A | 充电电流 2A | 充电电流 3A | 充电电流 4A
电感平均电流 | 1.35A | 2.7A | 5.4A | 8.1A | 10.8A
输入滤波电容 C1 | 10uF,0805 | 22uF,1206 | 2 个 22uF,1206 电容并联 | 3 个 22uF,1206 电容并联 | 4 个 22uF,1206 电容并联
二极管 D1 | SS24 或 SS34 | SS24 或 SS34 | SS24 或 SS34 | SS54 或 1N5824 | SS54 或 1N5824
二极管 D2 | SS24 或 SS34 | SS24 或 SS34 | SS24 或 SS34 | SS34 | SS34
N 沟道 MOS M1 | SI2300,SI2302 | AO4468 | AO4468, AO4410 | AO4410, NCE3018S | AON7140
P 沟道 MOS M2 | SI2301,SI2305 | AO4435 | AO4435 | AO4407A | AO4407A
电流检测电阻 RCS | 80mΩ, 0.15W | 40 mΩ,0.25W | 20 mΩ,0.5W | 13 mΩ,1W | 10 mΩ,1W
电感 L1 | 10uH, ISAT>2A | 6.8uH,ISAT>3A | 3.3uH,ISAT>5A | 2.2uH,ISAT>7.5A | 2.2uH,ISAT>7.5A
开关频率 | 568KHz | 420KHz | 430KHz | 420KHz | 310KHz
输出滤波电容 Co | 10uF,0805 | 22uF,1206 | 2 个 22uF,1206 电容并联 | 3 个 22uF,1206 电容并联 | 4 个 22uF,1206 电容并联

注：上表中，二极管和场效应晶体管可以选用电参数类似的其他型号。输入滤波电容和输出滤波电容如 果使用电解电容，那么须同电解电容至少再并联一个尺寸 0805 的 10uF 贴片陶瓷电容。

www.consonance-elec.com | 12 | REV 1.1

关于电磁干扰(EMI)的抑制
电磁干扰(EMI)同电路设计，外围元器件的选择，PCB设计等因素都有关系。
CN3303 的 LDRV 管脚驱动能力比较强，以满足输出 35 瓦功率的要求。如果选用的外部 N 沟道场效应晶 体管(MOSFET)的栅极总电荷 Qg 比较小，那么 LDRV 管脚的脉冲信号上升时间和下降时间比较短，产生 高频电磁干扰。在这种情况下，需要使用图 1 和图 2 中的电阻 R3，增大 LDRV 管脚的脉冲信号上升时 间和下降时间。
电阻 R3 应该使得 LDRV 管脚的脉冲信号上升时间和下降时间在 60 纳秒左右，不超过 80 纳秒为宜，尺 寸 0603 或 0805。
PCB设计注意事项
良好的 PCB 布线对降低开关损耗和保证稳定的工作非常重要。
⚫ | 如果可能的话，尽量使用多层 PCB 布线，以增强抗干扰能力。
⚫ | 输入电容的接地端，N 沟道场效应晶体管的源极，输出电容接地端和电池负极要连到 PCB 上同一块
| 铜皮，然后再返回系统地。此块铜皮要尽量宽，并且与 CN3303 的第 4 管脚分开连接到系统地。
⚫ | 为了保证尽可能低的电磁辐射，二极管，N 沟道 MOS 场效应晶体管，电感，输入电容和输出电容
| 的引线要足够宽，尽量短，连接这些元器件的铜皮的面积要尽量小。
⚫ | 电流检测电阻 RCS要尽量靠近输入电源和输入电源的滤波电容。

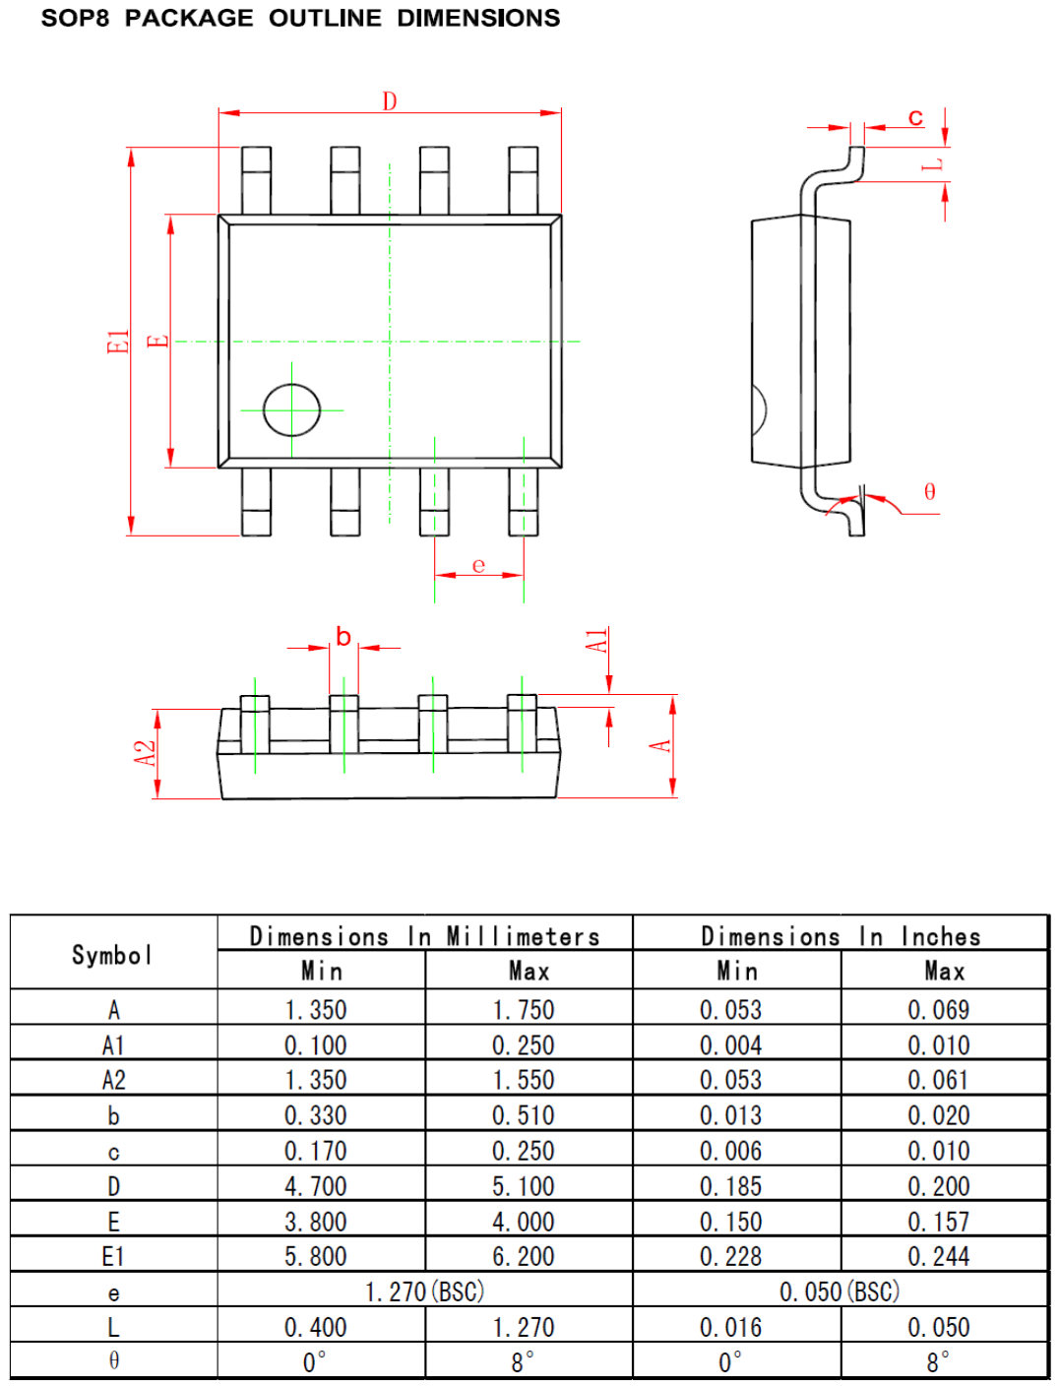
[picture p30: figure]

www.consonance-elec.com | 13 | REV 1.1

## 封装信息

本文中所描述的电路仅供参考，上海如韵电子有限公司对使用本文中所描述的电路不承担任何责任。 上海如韵电子有限公司保留对器件的设计或者器件的技术规格书随时做出修改而不特别通知的权利。
