binphilxiao/AxisLabs/RB0101/Certification/PCBA-000051 PCBA-BUTTON Rev.B_BlockDiagram.pdf

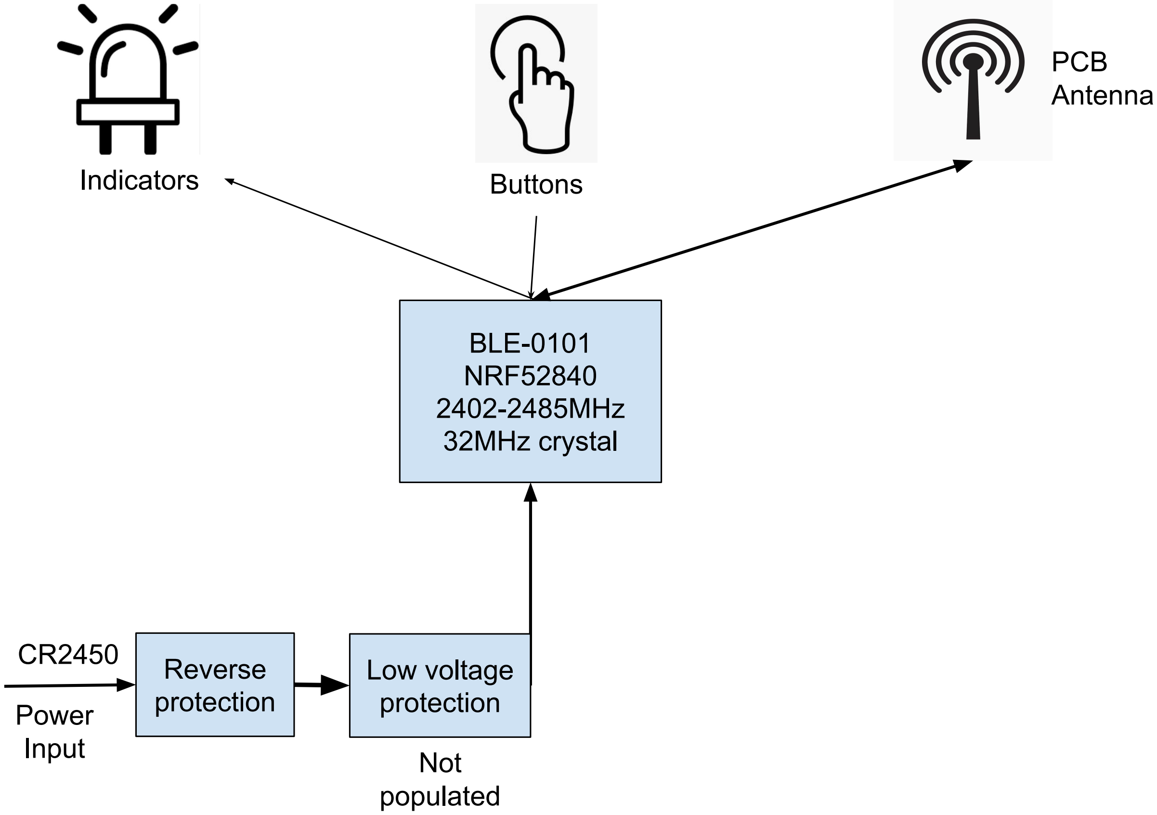
[picture p31: figure]
Indicators; BLE-0101 NRF52840 2402-2485MHz 32MHz crystal; Low voltage protection; Reverse protection; Buttons; PCB Antenna; Not populated; Power Input

## RYSE SmartButton Diagram
