binphilxiao/AxisLabs/SC0101/Certification/SmartCurtain Diagram.pdf

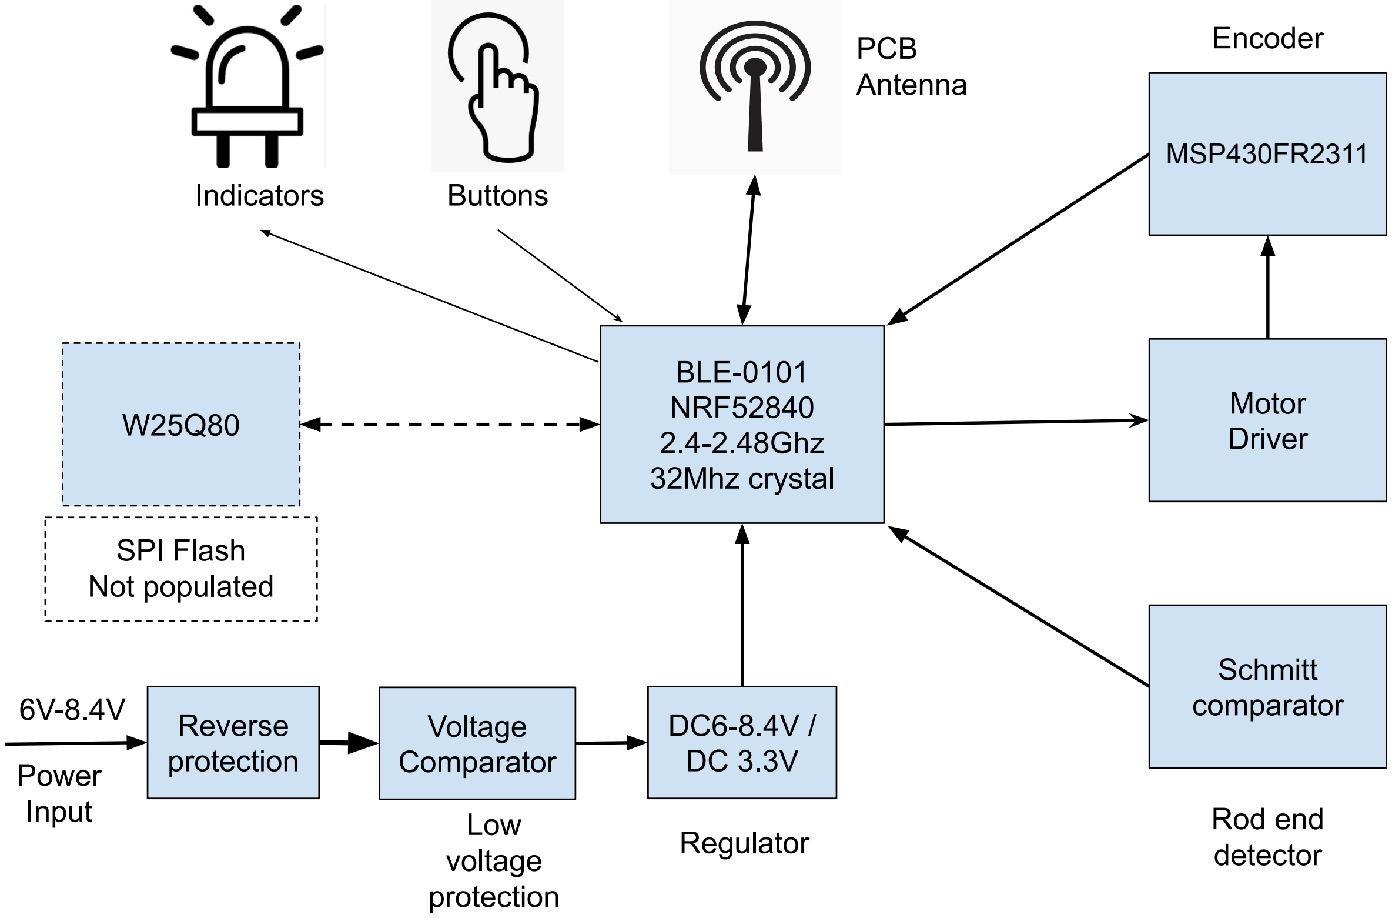
[picture p32: figure]
Indicators; BLE-0101 NRF52840 2.4-2.48Ghz 32Mhz crystal; MSP430FR2311; Motor Driver; Schmitt comparator Voltage; Comparator; Reverse protection; Buttons; PCB Antenna; Regulator; Rod end detector; Encoder; Low voltage protection; SPI Flash Not populated; Power Input

## RYSE SmartCurtain Diagram
