binphilxiao/AxisLabs/GR0102/Certification/Doc provided/SmartShade Diagram.pdf

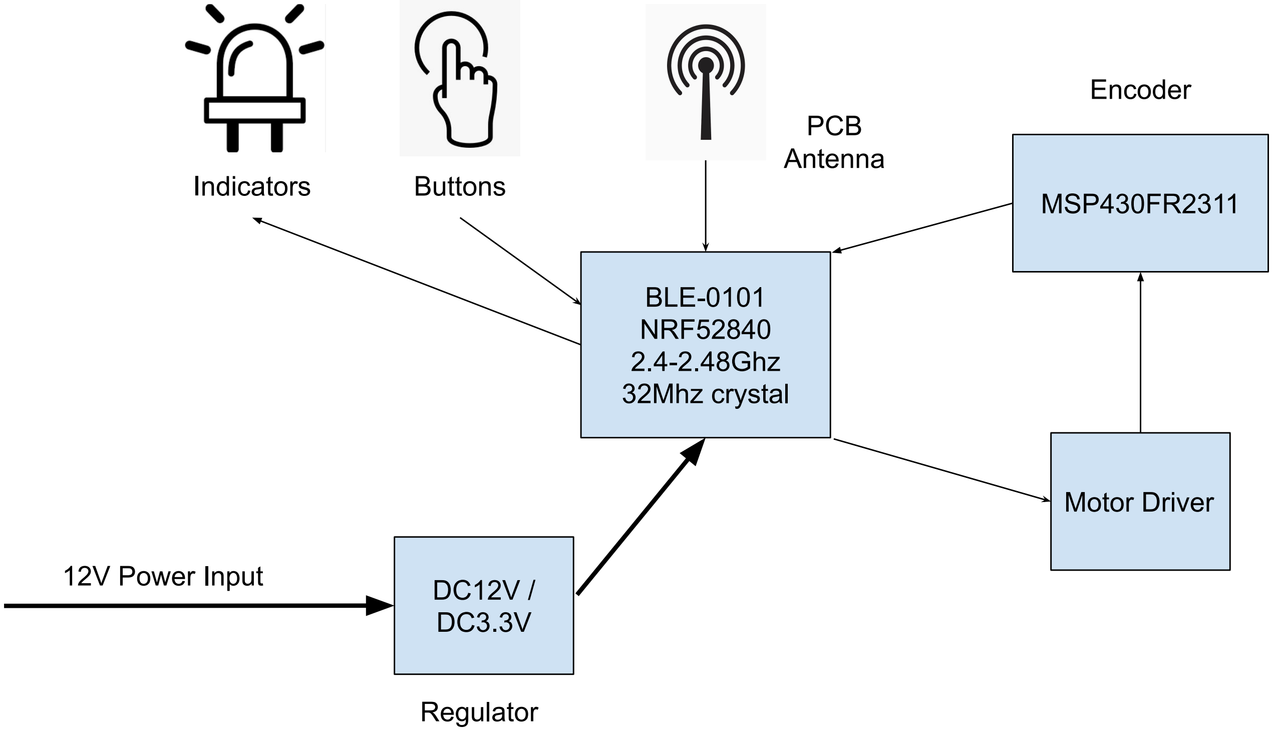
[picture p33: figure]
Indicators; Encoder; Regulator; 12V Power Input; BLE-0101 NRF52840 2.4-2.48Ghz 32Mhz crystal; Motor Driver; MSP430FR2311 Buttons; PCB Antenna

## RYSE SmartShade Diagram
