binphilxiao/AxisLabs/GB0101/DesignNotes/CalSheetGearV2.ods

Sheet: BQ24296
Design Basics | V_bus(V) | V_bat_min(V) | I_chg(A) | I_ripp(%) | T_cold(℃) | T_hot(℃) | V_regn(V) | V_LTF(%) | V_HTF(%) | V_TCO(%)
 | 5.00 | 2.50 | 1.20 | 30.00% | 0 | 45 | 4.8 | 73.50% | 47.20% | 44.70%
Chip Basics | K_lim
 | 435
Design Parameter | D(%) | f-sw(Mhz)
 | 50.00% | 1.5
 | Ind(uH) | I_sat(A) | Ind_sel(uH)
 | 2.31 | 1.38 | 2.20
 | I_cin_rms(A) | C_in(uF)
 | 0.60 | 1.00
 | I_cout_rms(A) | V_ripp(mV) | C_out(uF) | I_ripp(A) | f-res(kHz)
 | 0.10 | 1.43 | 22 | 0.38 | 15-36
 | I_in_max(A) | R_Ilim(kOhm)
 | 1.00 | 0.44
 | V_LTF(V) | V_HTF(V) | V_TCO(V) | RTH_cold(kOhm) | RTH_hot(kOhm)
 | 3.53 | 2.27 | 2.15 | 27.28 | 4.91
 | RT1(kOhm) | RT2(kOhm)
 | 5.25 | 31.23

Sheet: BQ24155
Design Basics | Vbus(V) | Vbat_min(V) | I-chg(A) | I-ripp(%)
 | 5.00 | 2.50 | 1.20 | 30.00%
Chip Basics | f_rsn(kHz) | V_rsns(mV)
 | 40 | 85
Switching Parameter | f_sw(MHz)
 | 3
 | L_out(uH) | C_out | R_sns(mOhm) | L_out_sel(uH)
 | 1.16 | 15.83 | 70.83 | 1.00
 | ∆I_l(A) | I_l_pk(A)
 | 0.42 | 1.41

Sheet: BQ25570
Chip Basics | V_bias(V) | R_sumok(MOhm) | R_sum_oc(MOhm) | R_sum_ov(MOhm) | R_sum_out(MOhm)
 | 1.21 | 13 | 20 | 13 | 13
Solar Basics | Vref_samp(V) | Vin_dc_oc(V) | Maximum Power Point (%)
 | 0.8 | 1 | 80%
Battery Overvoltage | Overvoltage(V) | R_ov1(Mohm) | R_ov2(MOhm) |  |  | The sum of the resistors is recommended to be no higher than 13 MΩ ROV1 + ROV2 <= 13 MΩ.
 | 4.2 | 5.62 | 7.38
Battery Operating range | Stop discharging Voltage(V) VBAT_OK_PROG | Restart charging Voltage(V) VBAT_OK_HYST | R_ok1(MOhm) | R_ok2(MOhm) | R_ok3(kOhm) | The sum of the resistors is recommended to be no higher than 13 MΩ ROK1 + ROK2 +ROK3 <= 13 MΩ.
 | 3 | 3.25 | 4.84 | 7.16 | 1000.0
Vout Regulation | Vout(V) | R_out1(MOhm) | R_out2(MOhm) |  |  | The sum of the resistors is recommended to be no higher than 13 MΩ ROUT1 + ROUT2 <= 13 MΩ.
 | 3.3 | 4.77 | 8.23
MPPT | R_oc1(MOhm) | R_oc2(MOhm) |  |  |  | The sum of the resistors is recommended to be no higher than 20 MΩ Roc1 + Roc2 <= 13 MΩ.
 | 16.0 | 4.00
 |  |  |  |  | `

Sheet: TPS61089
Design Basics | Vin_min(V) | Vin_max(V) | Vin(V) | Vout(V) | Iout(A)
 | 3 | 3.5 | 3.25 | 12 | 2
 | Efficiency(%)
 | 80
Chip Basics | t_dly(ns) | C_freq(pF) | Vref_pwm(V) | Vref_pfm(V) |  | Note: 1. The TPS61089x operates at a quasi-constant frequency PWM at moderate to heavy load currents. At light load current, the TPS61089 operates in PFM mode and the TPS610891 operates in forced PWM (FPWM) mode.
 | 86 | 24 | 1.212 | 1.224
 | Rds_on_main(mOhm) | Rds_on_rec(mOhm) | R_sense(Ohm) | G_EA(us)
 | 19 | 27 | 0.08 | 190
Regulation Parameter | R2(kOhm) | R1(kOhm) | I_lim(A) | R_lim(kOhm)
 | 100 | 890.1 | 8.0 | 128.75
Switching Parameter | f-sw(kHz) | R_freq(kOhm) | Duty(%) |  |  |  | CCM: - The voltage gain is not dependent of the load. - The input current is continuous and not pulsating. - The ripple component of the inductor current is lower than the average component. - Higher efficiencies can be achieved in comparison with DCM. DCM: - The voltage gain depends on the load and design parameters (L and Fs). - The ripple componente of the inductor current is higher and its RMS value is higher. - The on commutation of the controlled switch is made with zero current reducing commutation losses. - The size of the inductor can be considerably reduced in comparison with CCM. - Input current is pulsating. I-Lpeak * R_ESR ???
 | 500 | 280 | 78
 | I_dc(A) | I_pp(A) | I_peak | Ind(uH)
 | 9.23 | 2.1 | 10.3 | 2.26
 | V_ripple_dis(mV) | ESR(mOhm) | V_ripple_ESR(mV) | C_out(uF)
 | 80 | 70 | 147 | 37.5
Compensation Loop | f-crossover(kHz) | Ro(Ohm) |  |  |  |  | Power stage small signal loop response of constant off time D is the switching duty cycle RO is the output load resistance. Rsense is the equivalent internal current sense resistor, which is 0.08 Ω. ƒP is the pole's frequency ƒESRZ is the zero's frequency ƒRHPZ is the right-half-plane-zero's frequency
 | 20 | 6 |  |  |  |  | • Rsense is the equivalent internal current sense resistor, which is 0.08 Ω.
 | R5(kOhm) | C5(pF) | C6(pF) |  |  |  | Small signal transfer function of compensation network. GEA is the amplifier’s transconductance REA is the amplifier’s output resistance VREF is the refernce voltage at the FB pin VOUT is the output voltage ƒCOMP1, ƒCOMP2 are the poles' frequency of the compensation network. ƒCOMZ is the zero's frequency of the compensation network.
 | 90.7 | 1,241 | 29
