binphilxiao/AxisLabs/BLE0101/Docs/mac programing/img/hardware.jpg

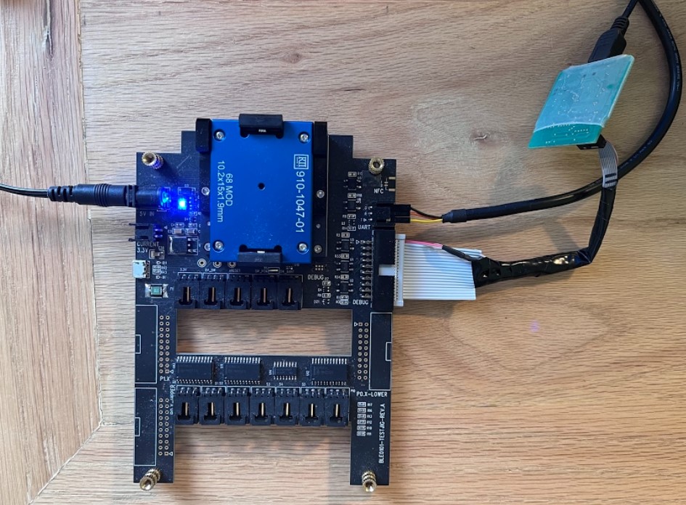
BLE0101/Docs/mac programing/img/hardware.jpg
