binphilxiao/AxisLabs/GR0101/052350-9/Docs/2.JPG

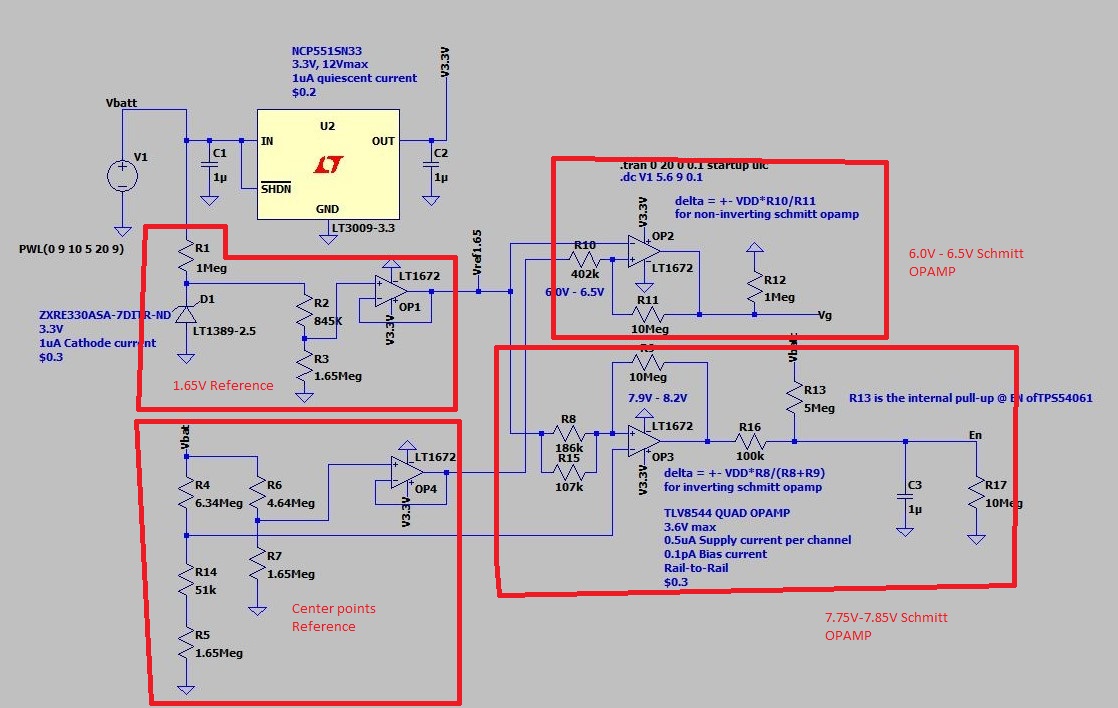
GR0101/052350-9/Docs/2.JPG
