binphilxiao/AxisLabs/GR0101/052350-9/Docs/3.JPG

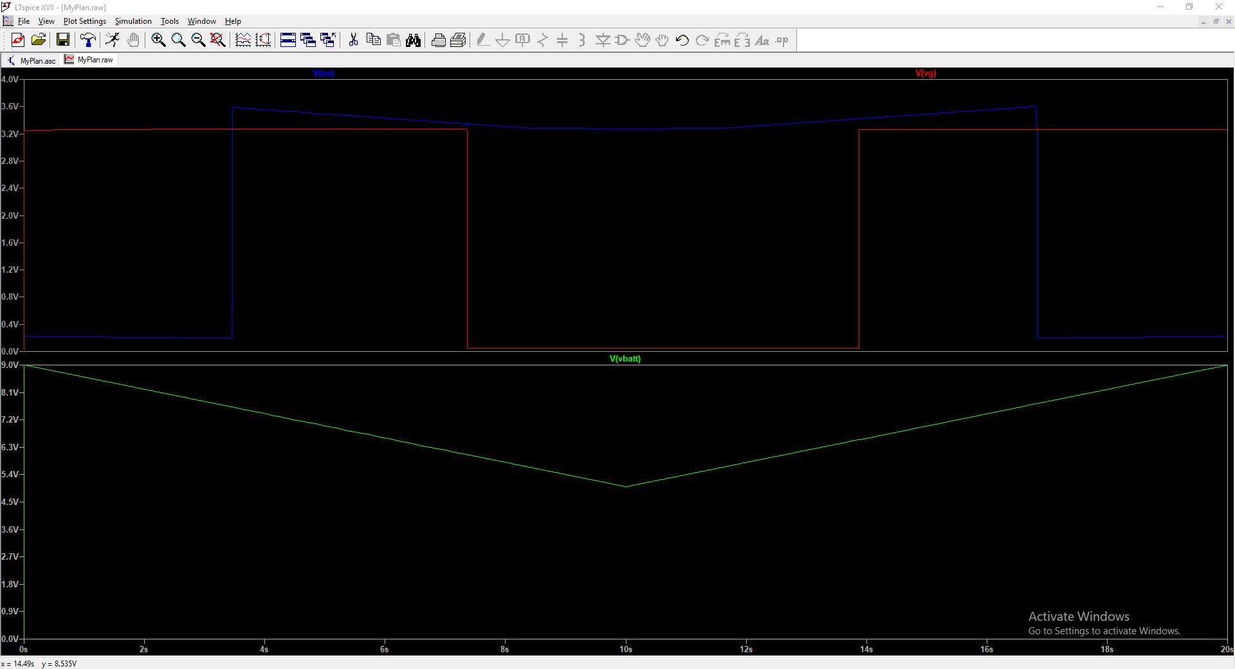
GR0101/052350-9/Docs/3.JPG
