binphilxiao/AxisLabs/GR0101/052350-9/Docs/Diagram.jpg

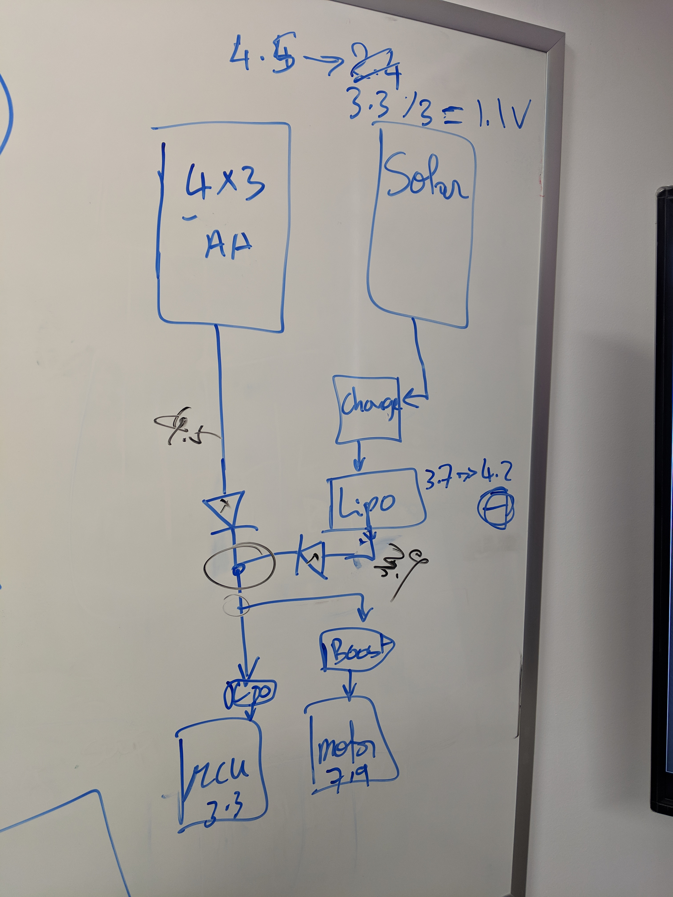
GR0101/052350-9/Docs/Diagram.jpg
