binphilxiao/AxisLabs/GR0101/052350-9/Docs/IMG_20190221_115919.jpg

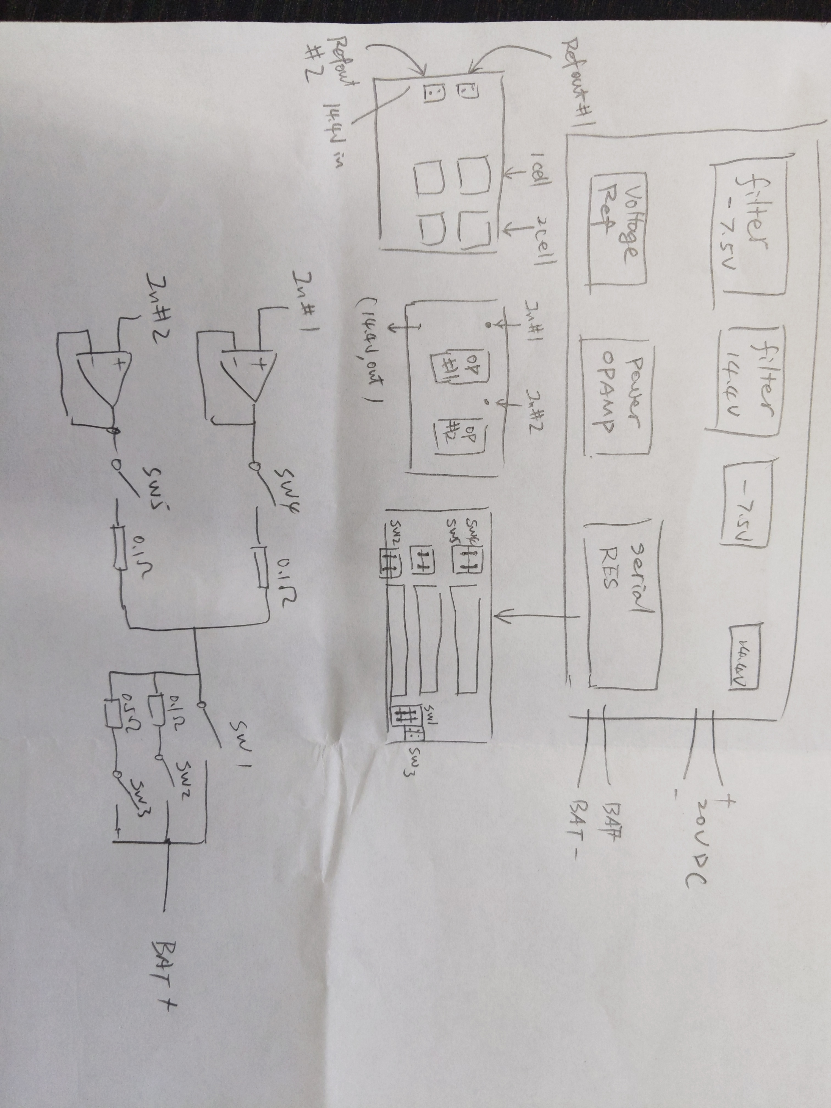
GR0101/052350-9/Docs/IMG_20190221_115919.jpg
