binphilxiao/AxisLabs/GR0101/052350-9/Docs/IMG_20190222_161704.jpg

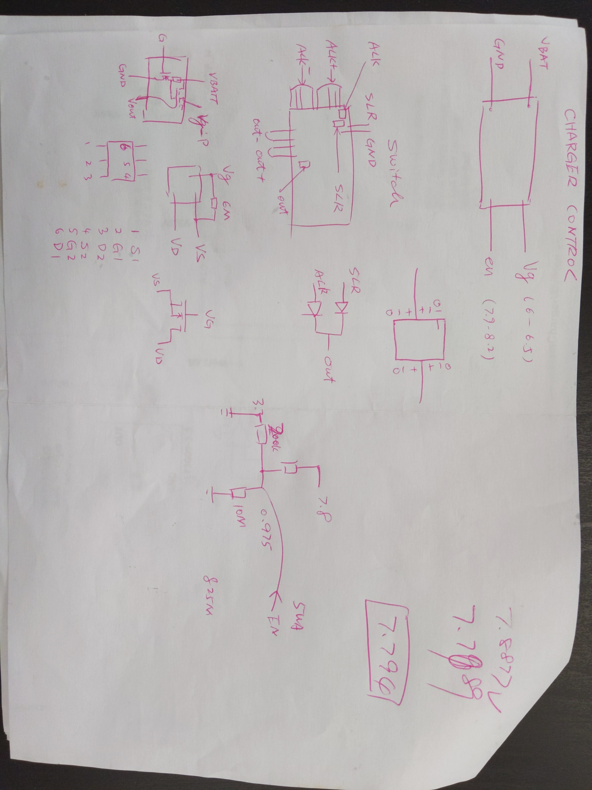
GR0101/052350-9/Docs/IMG_20190222_161704.jpg
