binphilxiao/AxisLabs/GR0101/052350-9/Docs/Interview/Screen Shot 2018-02-03 at 9.51.31 AM.png

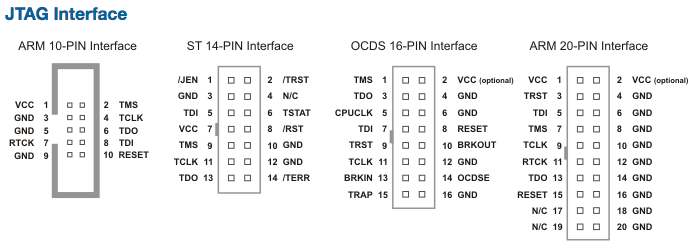
GR0101/052350-9/Docs/Interview/Screen Shot 2018-02-03 at 9.51.31 AM.png
