binphilxiao/AxisLabs/GR0101/052350-9/Simulation/ResistorEqu.png

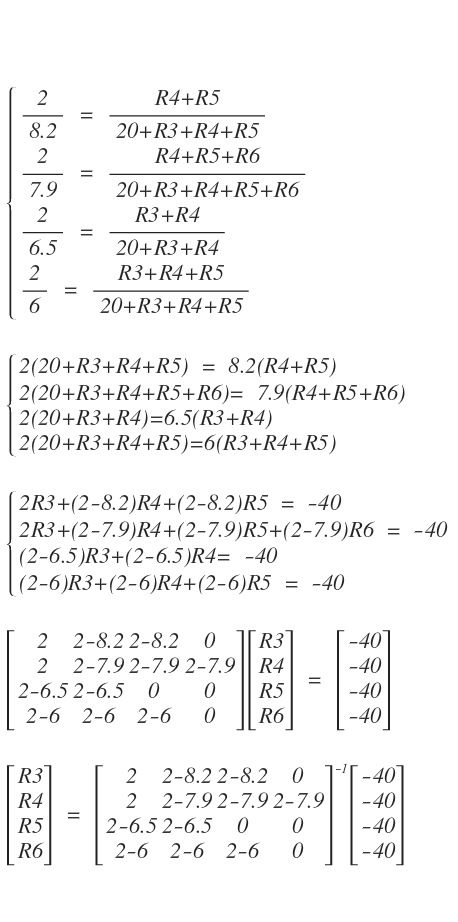
GR0101/052350-9/Simulation/ResistorEqu.png
