binphilxiao/AxisLabs/GR0102/Certification/Doc provided/img/5.jpg

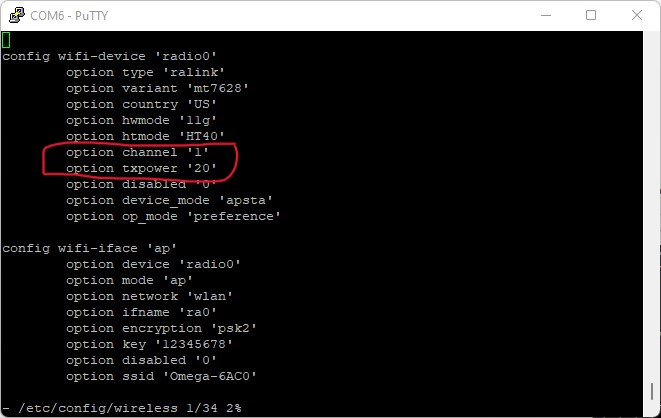
GR0102/Certification/Doc provided/img/5.jpg
