binphilxiao/AxisLabs/GR0102/Certification/Doc provided/img/6.PNG

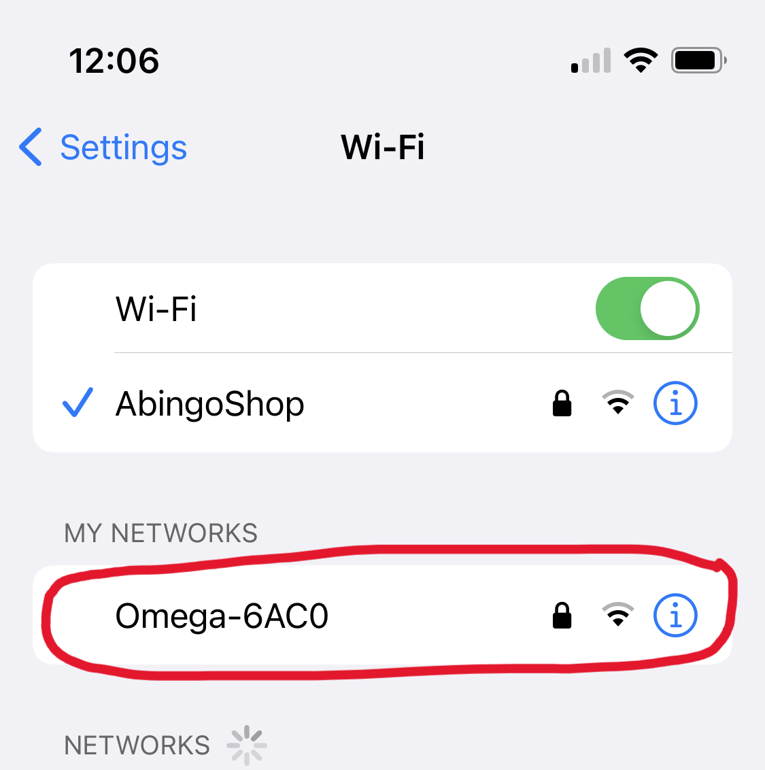
GR0102/Certification/Doc provided/img/6.PNG
