binphilxiao/AxisLabs/GR0102/Certification/Doc provided/img/7.jpg

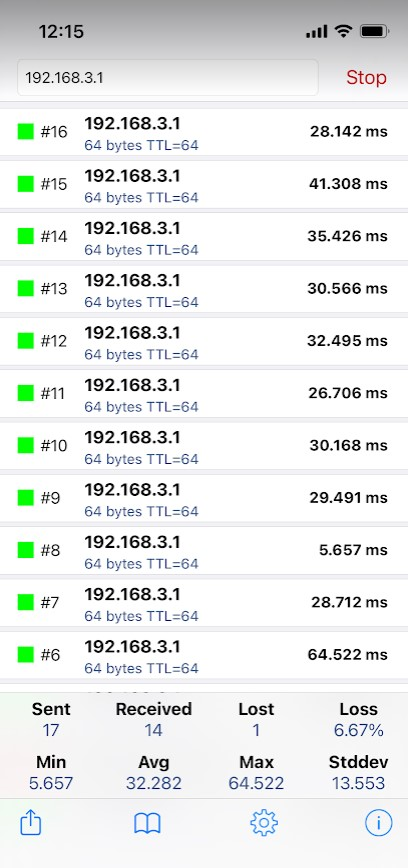
GR0102/Certification/Doc provided/img/7.jpg
