binphilxiao/AxisLabs/GR0102/Certification/Doc provided/img/8.jpg

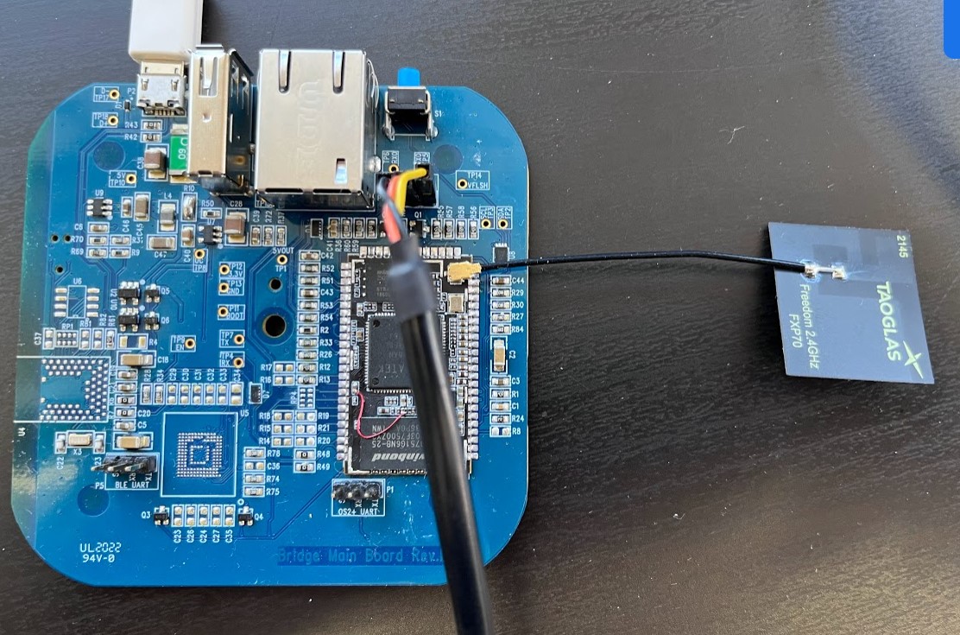
GR0102/Certification/Doc provided/img/8.jpg
