binphilxiao/AxisLabs/GR0102/Certification/Doc provided/img/app.jpg

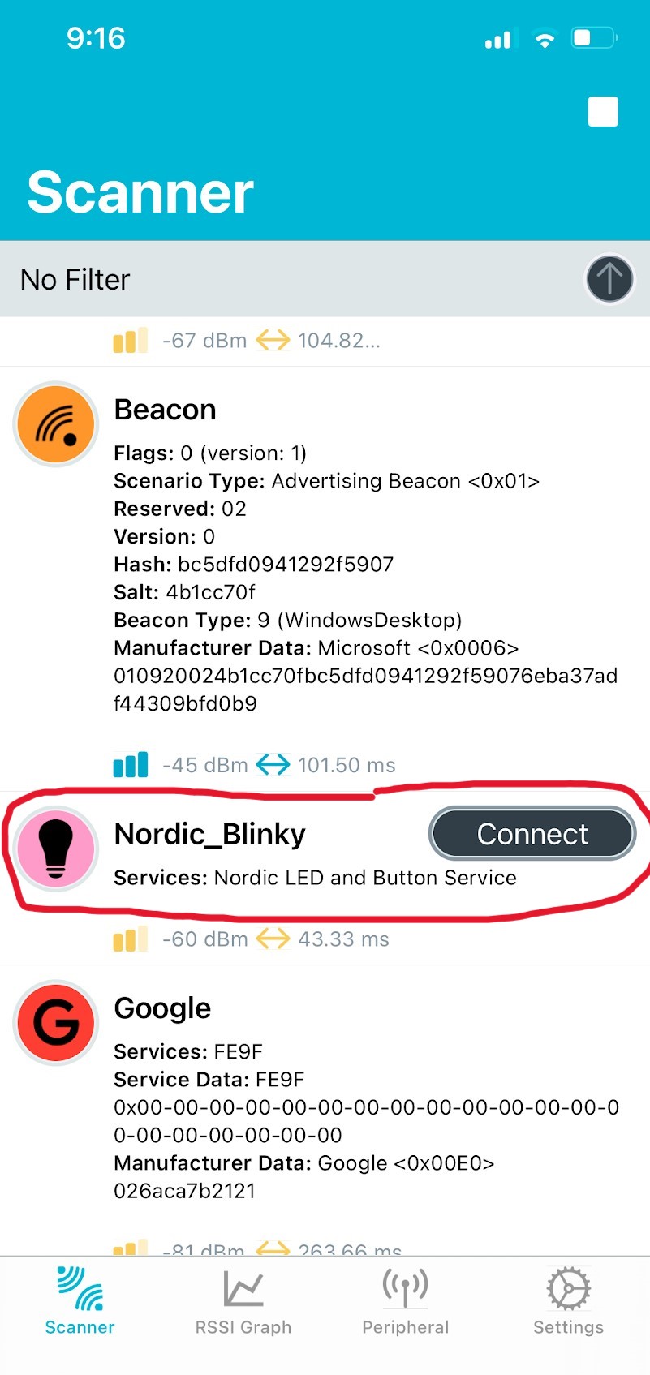
GR0102/Certification/Doc provided/img/app.jpg
