binphilxiao/AxisLabs/GR0102/Certification/Doc provided/img/command promot.jpg

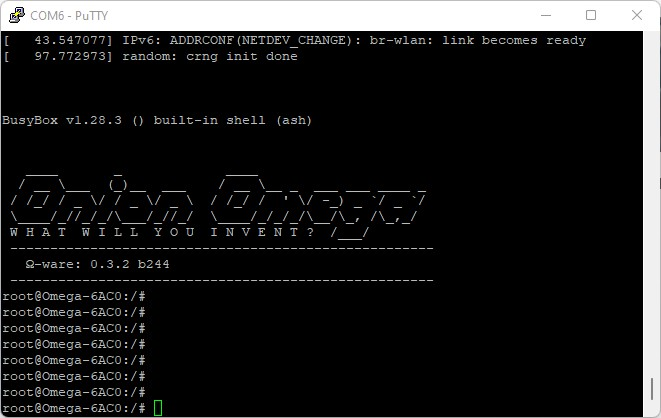
GR0102/Certification/Doc provided/img/command promot.jpg
