binphilxiao/AxisLabs/GR0102/Certification/Doc provided/img/iwinfo.jpg

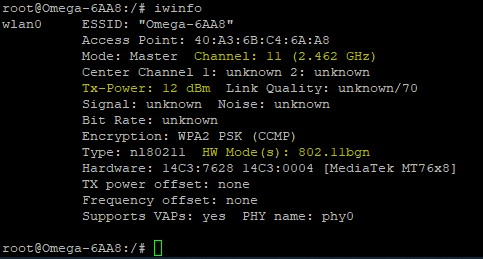
GR0102/Certification/Doc provided/img/iwinfo.jpg
