binphilxiao/AxisLabs/GR0102/Certification/Doc provided/img/Screenshot_20240820-103740.png

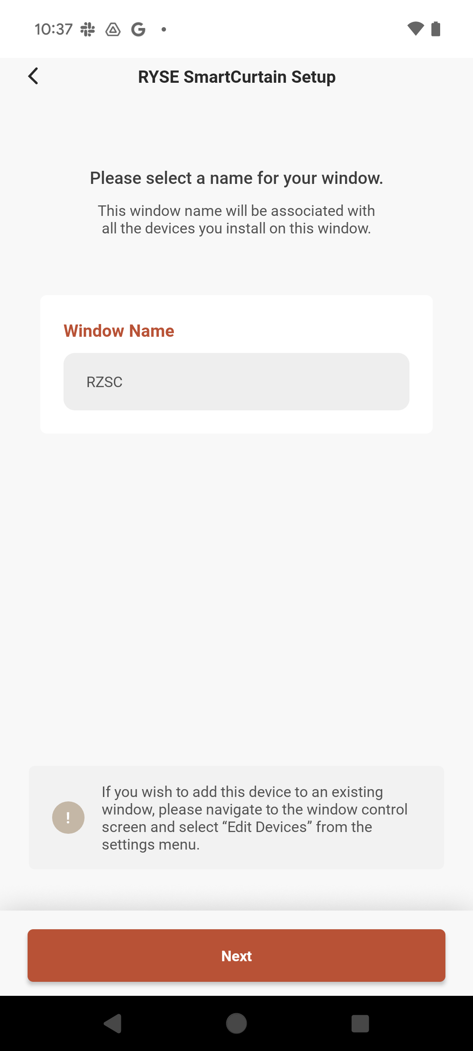
GR0102/Certification/Doc provided/img/Screenshot_20240820-103740.png
