binphilxiao/AxisLabs/GR0102/Certification/Doc provided/img/Screenshot_20240820-104101.png

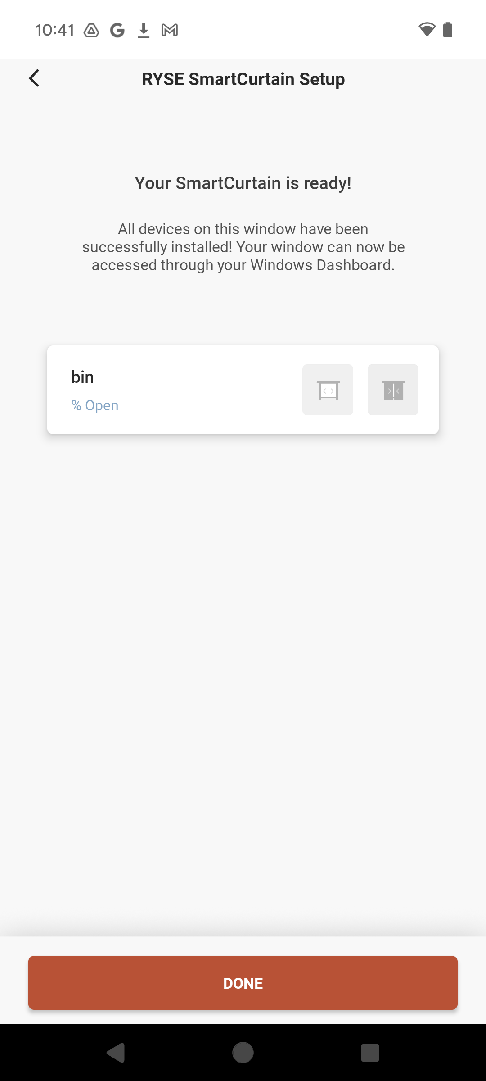
GR0102/Certification/Doc provided/img/Screenshot_20240820-104101.png
