binphilxiao/AxisLabs/GR0102/Certification/Doc provided/img/UART.jpg

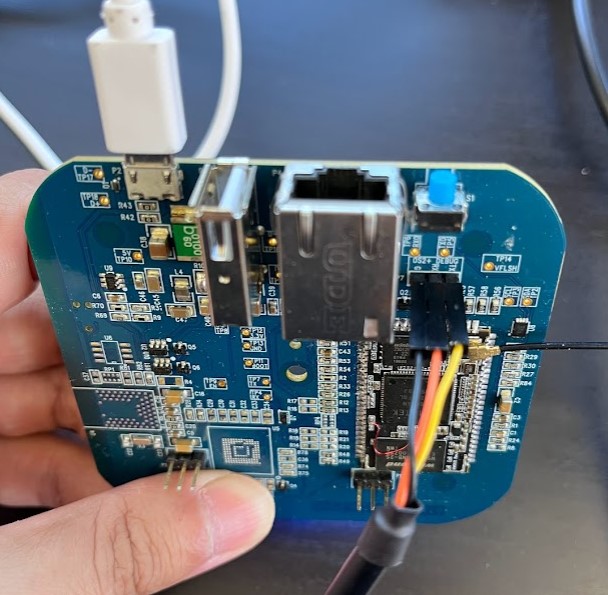
GR0102/Certification/Doc provided/img/UART.jpg
