binphilxiao/AxisLabs/NW0101/Docs/PCB-NW0101 Rev.B_Pogopins.jpg

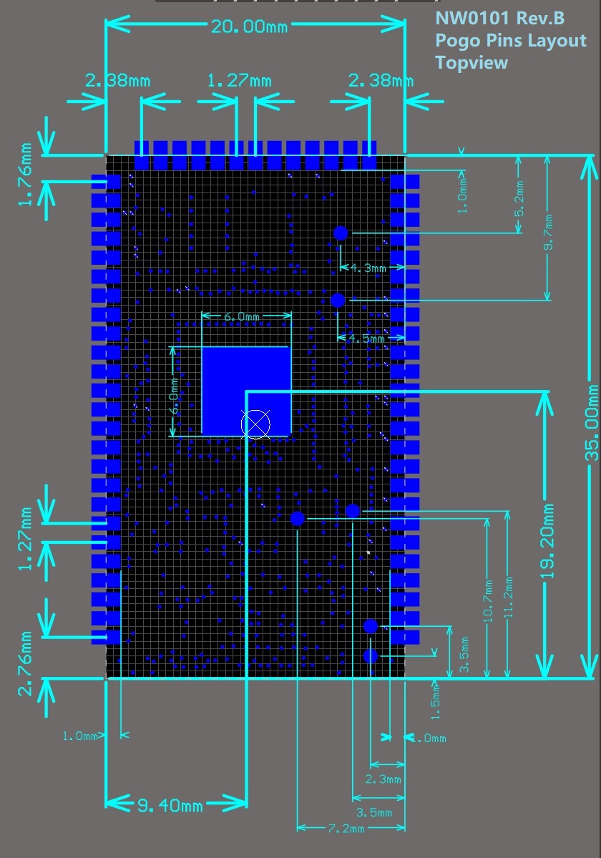
NW0101/Docs/PCB-NW0101 Rev.B_Pogopins.jpg
