binphilxiao/AxisLabs/RC0101&DC0101/Docs/image1.png

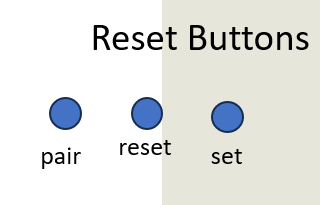
RC0101&DC0101/Docs/image1.png
