binphilxiao/AxisLabs/RC0101&DC0101/Docs/image2.png

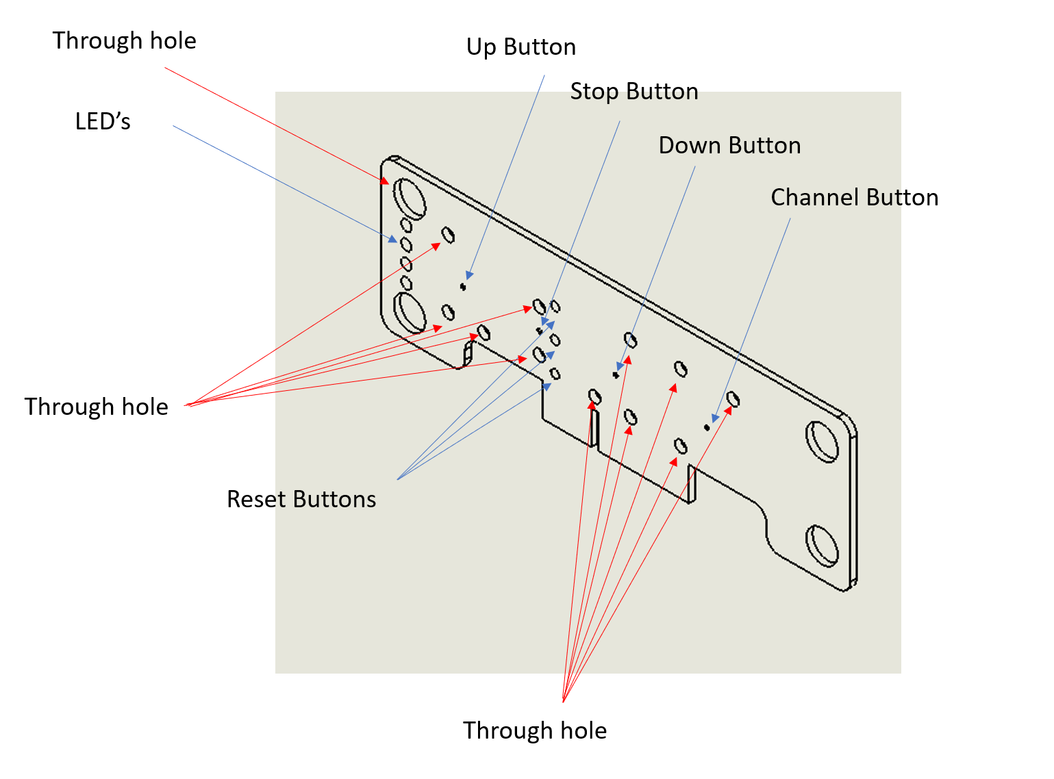
RC0101&DC0101/Docs/image2.png
