binphilxiao/AxisLabs/RC0101&DC0101/Docs/image (2).png

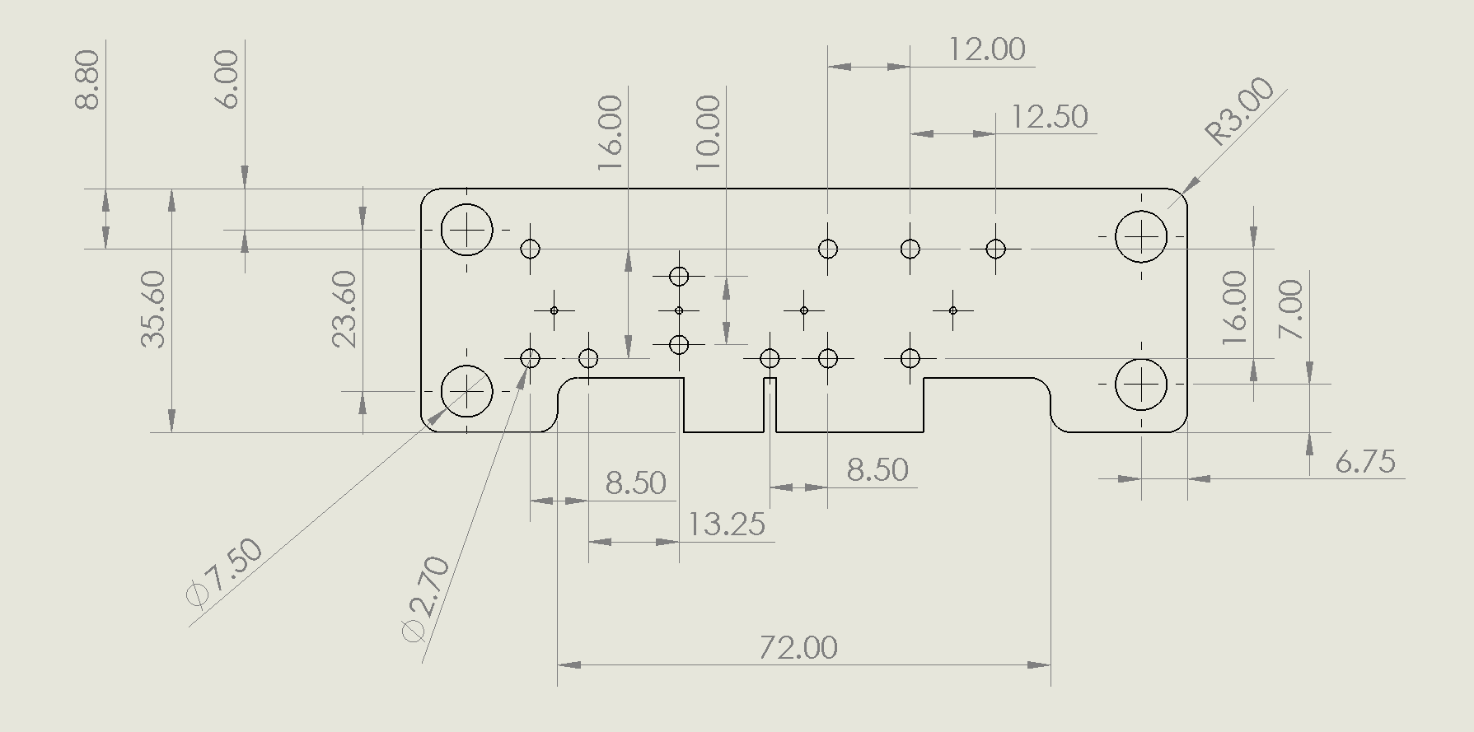
RC0101&DC0101/Docs/image (2).png
