binphilxiao/AxisLabs/RC0101&DC0101/Docs/image.png

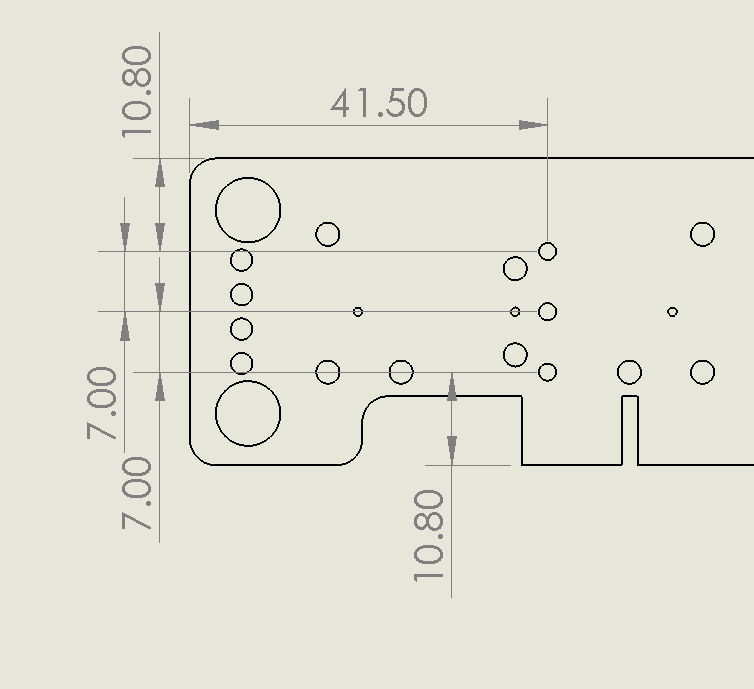
RC0101&DC0101/Docs/image.png
