binphilxiao/AxisLabs/SC0101/Doc/image.png

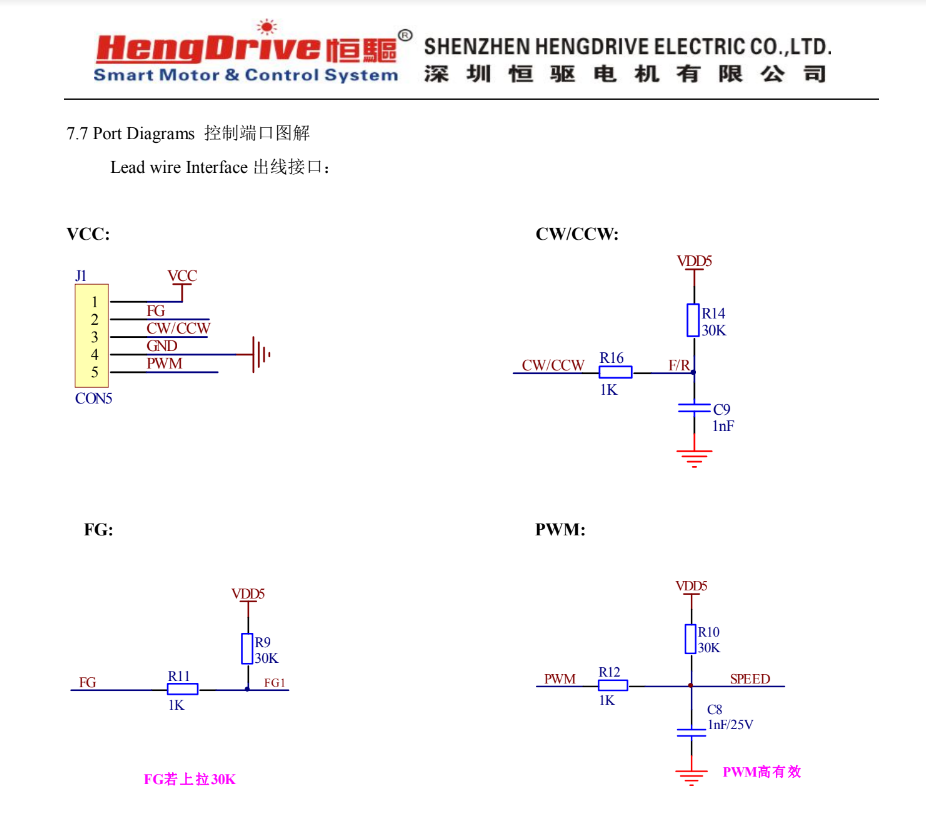
SC0101/Doc/image.png
