binphilxiao/AxisLabs/GR0101/052350-9/Manufacture/BillOfMaterials.rep.xlsx

Reference | Part# | Qty | Link
C1 C2 C5 C6 C7 C8 C11 C12 C13 C14 C15 C16 C17 C18 C19 C20 C26 C29 C31 C34 C36 C38 C39 C40 C42 C44 C46 C47 C52 C53 C55 | GCJ188R71E104KA12D | 31
C10 C48 C49 C54 C35 | CL10B105MO8NNWC | 5
C22 C23 C32 C41 C43 | GRM21BR61E226ME44L | 5
C24 | GRM188R6YA225MA12D | 1
C25 | 06033C100KAT2A | 1
C27 C37 | CC0603JRNPO9BN101 | 2
C3 | CL21B475KPFNNNE | 1
C30 | CC0603KRX7R7BB683 | 1
C33 C51 | GCM31CR71C106KA64L | 2
C4 | GCD188R71H103KA01D | 1
C50 | GCM21BR71C475KA73L | 1
C9 C28 C45 | GRM21BR61E106MA73L | 3
D1 | TV02W200B-G | 1
D4 | ZXRE330ASA-7 | 1
D5 D6 | PMEG10010ELRX | 2
D8 | BAT54WX-TP | 1
F1 | 0ZCF0200AF2C | 1
F3 | 0ZCJ0025AF2E | 1
J3 | DF37B-10DP-0.4V(53) | 1
J4 | B3B-PH-SM4-TB(LF)(SN) | 1
L1 L2 L3 L5 L6 L7 | MPZ1608S331ATA00 | 6
L4 | SRN4018-221M | 1
LED1 LED2 LED3 LED4 LED5 LED6 LED7 LED8 LED9 LED10 | SK6812MINI | 10 | https://cdn-shop.adafruit.com/product-files/2686/SK6812MINI_REV.01-1-2.pdf
P2 P3 | PREC002SBAN-M71RC | 2
P4 | SM02B-SFHRS-TF(LF)(SN) | 1
P5 | A2501LF-06A | 1 | http://www.huakevision.com/h-pd-634.html
P6 | B2B-PH-SM4-TB(LF)(SN) | 1
P7 P8 P9 P10 P11 | 120220-0311 | 5
Q1 Q8 Q15 | DMP3099L-7 | 3
Q2 Q5 | BSS123WQ-7-F | 2
Q4 | BSS223PWH6327XTSA1 | 1
Q9 Q10 Q12 Q19 | SSM3K7002CFU,LF | 4
R1 | CRCW06032R00FKEAHP | 1
R10 | CRCW0603220KFKEAC | 1
R11 | NCP15WF104J03RC | 1
R12 | RC0603FR-07143KL | 1
R15 R59 | CRCW0603174KFKEA | 2 | https://www.digikey.ca/product-detail/en/vishay-dale/CRCW0603174KFKEA/541-174KHCT-ND/1180063
R16 R19 | CRCW060356K2FKEA | 2
R17 R18 | RC0603FR-0743KL | 2
R2 | ERJ-6DQF1R3V | 1 | https://www.digikey.ca/product-detail/en/panasonic-electronic-components/ERJ-6DQF1R3V/P19271CT-ND/6004626
R21 R43 R44 R46 R47 | CRCW060310K0FKEA | 5
R22 | CRCW06031K65FKEA | 1 | https://www.digikey.ca/product-detail/en/vishay-dale/CRCW06031K65FKEA/541-1.65KHDKR-ND/1184965
R23 R68 | CRCW06033K30FKEAC | 2
R24 | CRCW0603560RFKEA | 1
R26 R62 R63 R64 | CRCW06031M65FKEA | 4
R27 | RC0603FR-07100RL | 1
R28 | CRCW06031R21FKEA | 1
R3 R6 R52 R53 R61 | CRCW060310M0FKEAC | 5
R34 | RMCF0603FT2M37 | 1 | https://www.digikey.ca/product-detail/en/stackpole-electronics-inc/RMCF0603FT2M37/RMCF0603FT2M37CT-ND/7790160
R35 R40 | CRCW06036M04FKEA | 2
R37 | RCG06031M00FKEA | 1
R4 R29 R45 R49 R50 R51 R60 | CRCW0603100KFKEAC | 7
R42 | RC0805FR-074M64L | 1
R54 | RC0201FR-07402KL | 1
R55 | RMCF0603FT7M50 | 1 | https://www.digikey.ca/product-detail/en/stackpole-electronics-inc/RMCF0603FT7M50/RMCF0603FT7M50CT-ND/7790073
R56 | RC0603FR-07130KL | 1
R57 R58 | CRCW0603470RFKEAC | 2
R69 | CRCW0603820RFKEAHP | 1
R7 R30 R32 R33 R36 R72 | CRCW06033M00FKEA | 6
U1 | ZXCT1023DFGTA | 1
U10 | AT25SF041-SSHD-B | 1
U11 | CYBLE-214009-00 | 1
U12 | 74LVC1T45Z6-7 | 1
U13 | MCP1702T-3302E/CB | 1
U15 | BQ2057TTSTR | 1
U16 | TLV8544PWR | 1
U17 | NCP551SN33T1G | 1
U2 | TPS76633DR | 1
U3 | MIC5219-5.0YMT-TR | 1
U4 | LMV358DMR2G | 1
U5 | TPS54061DRBR | 1
U6 | 74VHC4052AFT | 1
U7 | DMHC3025LSD-13 | 1
U8 | NC7WZ08K8X | 1
U9 | Z357PA40-SMT-P-NC-N | 1 | https://www.digikey.ca/products/en?keywords=Z357PA40-SMT-P-NC-N
