binphilxiao/AxisLabs/GR0101/052355-9/052355-9G_Manufacture/052355-9G Axis Apollo Proximity PCB BOM.xlsx

Ref | Part Name | Manufacture | Description | Qty
M1, M2, M3, M4 | SMTSO-M1.6-1ET | Penn Engineering | PEM Surface Mount Nut M1.6 Steel | 4
U1 | CY8CMBR3116-LQXI | Cypress | IC SM Capacitive Sensing 16 INput QFN24 4x4-0.55 | 1
R10, R13 | ERJ-2GEJ152X | Panasonic | RES SM 0402 5%, 1K5 | 2
R12 | ERJ-2GEJ222X | Panasonic | RES SM 0402 5%, 2K2 | 1
R9 | ERJ-2GEJ302X | Panasonic | RES SM 0402 5%, 3K0 | 1
R7, R8 | ERJ-2GEJ331X | Panasonic | RES SM 0402 5%, 330R | 2
R6 | ERJ-2GEJ392X | Panasonic | RES SM 0402 5%, 3K9 | 1
R5, R17, R18 | ERJ-2GEJ472X | Panasonic | RES SM 0402 5%, 4K7 | 3
R1, R11, R15, R16, R2, R3, R4 | ERJ-2GEJ561X | Panasonic | RES SM 0402 5%, 560R | 7
R14 | ERJ-2GEJ751X | Panasonic | RES SM 0402 5%, 750R | 1
C3 | UMK107AB7105KA-T | Taiyo Yuden | CAP SM CER 0603 X7R 16V 10%, 1U0 | 1
C1, C4 | CL05B104KO5NNNC | Samsung | CAP SM CER 0402 X7R 16V 10%,100N | 2
C2 | C0402C222K3RACTU | KEMET | CAP SM CER 0402 X7R 16V 10%, 2N2 | 1
P1 | 1447360-9 | TE Connectivity | Contact Spring SMD | 1
D1 | ESD8351XV2T1G | ON Semiconductor | TVS SM SOD523 3V3 | 1
