binphilxiao/AxisLabs/GR0101/currentMonitorWithLED/Production_2018.12.04/BillOfMaterials.xlsx

Reference | Type | Part Number_DiffMode | Part Number_SingleMode | Qty | Description_DiffMode | Description_SingleMode | Manufacturer | FootPrint
J2 | Connector | 801-43-002-20-001000 | 801-43-002-20-001000 | 1 | 2 Pins 2.54mm Long RightAngle Receptacle Header | 2 Pins 2.54mm Long RightAngle Receptacle Header | Mill-Max Manufacturing Corp. | XPXC021LGBN-RC
U1 U3 | IC | MCP6032T-E/SN | MCP6032T-E/SN | 2 | 1.8-5.5V Rail-to-Rail 10khz 1pA IB 0.9uA/ch 150uV offset 115dB | 1.8-5.5V Rail-to-Rail 10khz 1pA IB 0.9uA/ch 150uV offset 115dB | Microchip Technology | SO8
U2 | IC | LTC2064IMS8#PBF | LTC2064IMS8#PBF | 1 | 1.7-5.25V Rail-to-Rail 20khz 3pA IB 1.3uA/ch 1uV offset | 1.7-5.25V Rail-to-Rail 20khz 3pA IB 1.3uA/ch 1uV offset | Linear Technology/Analog Devices | MSOP8
J1 | Connector | BU2450SM-JJ-GTR | BU2450SM-JJ-GTR | 1 | BATTERY HOLDER COIN 24.5MM SMD | BATTERY HOLDER COIN 24.5MM SMD | MPD (Memory Protection Devices) | BU2450SM
Q1-2 | MOSFET | BSS123WQ-7-F | BSS123WQ-7-F | 2 | NMOSFET 0.17A 100V | NMOSFET 0.17A 100V | Diodes Incorporated | SOT323
R18 | Resistor | CRCW06031K00FKEAC | CRCW06031K00FKEAC | 1 | 1k 0603 1% 1/10W | 1k 0603 1% 1/10W | Vishay Dale | RC0603
R29 | Resistor | CRCW06031K00FKEAC | NOP | 1 | 1k 0603 1% 1/10W | NOP | Vishay Dale | RC0603
R19 | Resistor | CRCW0603100KFKEAC | CRCW06031K00FKEAC | 1 | 100k 0603 1% 1/10W | 1k 0603 1% 1/10W | Vishay Dale | RC0603
R28 | Resistor | CRCW06032K00FKEAC | CRCW06030000Z0EAC | 1 | 1k 0603 1% 1/10W | 0ohm 0603 | Vishay Dale | RC0603
R1-2 R4-7 R21 R23 | Resistor | CRCW06031M00FKEAHP | CRCW06031M00FKEAHP | 8 | 1M 0603 1% 1/10W | 1M 0603 1% 1/10W | Vishay Dale | RC0603
R20 R22 | Resistor | CRCW06031K50FKEAC | CRCW06031K50FKEAC | 2 | 1.5k 0603 1% 1/10W | 1.5k 0603 1% 1/10W | Vishay Dale | RC0603
R15 | Resistor | CRCW06033K24FKEA | CRCW06033K24FKEA | 1 | 3.24k 0603 1% 1/10W | 3.24k 0603 1% 1/10W | Vishay Dale | RC0603
R17 | Resistor | NOP | RT0603BRD0730K9L | 1 | NOP | 30.9k 0603 1% 1/10W | Panasonic Electronic Components | RC0603
R9 | Resistor | CRCW0603143KFKEA | CRCW0603143KFKEA | 1 | 143k 0603 1% 1/10W | 143k 0603 1% 1/10W | Vishay Dale | RC0603
R14 | Resistor | CRCW06035K76FKEA | CRCW06035K76FKEA | 1 | 5.76k 0603 1% 1/10W | 5.76k 0603 1% 1/10W | Vishay Dale | RC0603
R11 | Resistor | CRCW0603100KFKEAC | NOP | 1 | 100k 0603 1% 1/10W | NOP | Vishay Dale | RC0603
R16 | Resistor | NOP | CRCW060368K1FKEA | 1 | NOP | 68.1k 0603 1% 1/10W | Vishay Dale | RC0603
R8 | Resistor | CRCW0603866KFKEA | CRCW0603866KFKEA | 1 | 866k 0603 1% 1/10W | 866k 0603 1% 1/10W | Vishay Dale | RC0603
R10 | Resistor | RL2512FK-070R1L | RL2512FK-070R1L | 1 | 100mOhm 2512 1% 1/10W | 100mOhm 2512 1% 1/10W | Yageo | 2512
R3 R12-13 | Resistor | CRCW06030000Z0EAC | CRCW06030000Z0EAC | 3 | 0ohm 0603 | 0ohm 0603 | Vishay Dale | RC0603
C1-4 | Capacitor | GRM188R70J104KA01D | GRM188R70J104KA01D | 4 | 0.1uF 6.3V X7R | 0.1uF 6.3V X7R | Murata Electronics North America | RC0603
C5-6 | Capacitor | GCM21BR70J106KE22K | GCM21BR70J106KE22K | 2 | 10uF 6.3V X7R | 10uF 6.3V X7R | Murata Electronics North America | 1206
D1 | LED | LG L29K-F2J1-24-Z | LG L29K-F2J1-24-Z | 1 | Green 0603 | Green 0603 | OSRAM Opto Semiconductors Inc. | RC0603P
D2 | LED | LTST-C190CKT | LTST-C190CKT | 1 | Red 0603 | Red 0603 | Lite-On Inc. | RC0603P
R27 | resistor | CRCW06030000Z0EAC | NOP | 1 | 0ohm 0603 | NOP | Vishay Dale | RC0603
R25-26 | resistor | NOP | CRCW06030000Z0EAC | 2 | NOP | 0ohm 0603 | Vishay Dale | RC0603
