binphilxiao/AxisLabs/MAT0101/Ref/nRF7002 Development Kit - Hardware files 0_7_2/BOM/nRF6840_BOM.xls

Bill of material
Kit: | nRF6840 - nRF7002 Development Kit
Version: | 0.7.2
Designator | Value | Description | Manufacturer | Manufacturer Part Number
Design_1 | PCA10143 - nRF7002 Development Board | Circuit board assembly
Design_2 | PCA64110 - NFC Listener-6 antenna | Circuit board assembly
