binphilxiao/AxisLabs/BLE0201/Ref/nRF5340 Development Kit - Hardware files 2_0_0/PCA10095-nRF5340 Development Board 2_0_0/Production files/BOM/PCA10095_BOM_Web.xls

Bill of material
Board: | PCA10095
Version: | 2.0.0
Designator | Value | Description | Assembly | Footprint Doc | Manufacturer | Manufacturer Part Number
Bat1 | Bat Holder CR2032 | Bat Holder CR2032 SMD |  | CR2032_HOLDER | KLS Electronic | L-KLS5-CR2032-23-B1
C1 | 0.7pF | Ceramic Capacitor C0G, NP0 0201, ±0.1pF 25V |  | 0201 | Murata | GJM0335C1ER70BB01D
C2, C3, C5, C7, C16, C25, C26, C38, C39, C66, C74 | 1.0µF | Capacitor, X5R, ±5%, 6.3V |  | 0402 | N.A. | N.A.
C4, C27 | 2.2nF | Capacitor, X7R, ±10%, 10V |  | 0201 | N.A. | N.A.
C6, C8, C9, C10, C11, C12, C13, C14, C15, C24, C30, C31, C32, C33, C34, C35, C36, C37, C41, C42, C45, C46, C48, C50, C52, C54, C55, C56, C65, C68, C69, C70, C71, C73 | 100nF | Capacitor, X5R, ±10% |  | 0201 | N.A. | N.A.
C17, C18, C20, C40 | 4.7µF | Capacitor, X7S, ±10%, 10V |  | 0603 | N.A. | N.A.
C19 | 2.2µF | Capacitor, X7R, ±10% |  | 0603 | N.A. | N.A.
C21, C28, C29 | N.C. | Not mounted | Not mounted | 0201 | N.A. | N.A.
C22, C47, C49 | 10nF | Capacitor, X7R, ±10% |  | 0201 | N.A. | N.A.
C23 | 1.2pF | Capacitor, NP0, ±0.1pF |  | 0402 | N.A. | N.A.
C43, C44 | 300pF | Capacitor, NP0, ±5% |  | 0402 | N.A. | N.A.
C51, C53, C67 | 1.0µF | Capacitor, X7R, ±10% |  | 0603 | N.A. | N.A.
C57, C59, C60, C63 | 10µF | Capacitor, X5R, ±20%, 25V |  | 0603 | Samsung Electro-Mechanics America | CL10A106MA8NRNC
C58 | 15pF | Ceramic Capacitor C0G, NP0 0201, ±5% 25V |  | 0201 | Walsin Technology Corporation | 0201N150J250CT
C61 | 4.7µF | CAP CER 4.7UF 10V X5R 0402 |  | 0402 | Murata | GRM155R61A475MEAAD
C62 | 150pF | Ceramic Capacitor C0G, NP0 0201, ±5% 25V |  | 0201 | Murata | GRM0335C1E151JA01D
C64 | 470nF | Ceramic Capacitor X5R 0201, ±10% 16V |  | 0201 | Taiyo Yuden | EMK063BBJ474KPLF
C72 | 4.7µF | Capacitor, X7R, ±10%, 6.3V |  | 0603 | Samsung Electro-Mechanics America | CL10B475KQ8NQNC
D1, D2 | PRTR5V0U2X | Ultra low capacitance double rail-to-rail ESD protection diode |  | SOT-143B | NXP Semiconductors | PRTR5V0U2X
D3, D5, D6, D7 | NSR0620P2T5G | 20V schottky barrier diode, Vf 350 mV @ 100 mA, Ir 2.0 µA @ 10 V, If 500 mA |  | SOD-923 | ON Semiconductor | NSR0620P2T5G
D4 | MBRM110E | Diode Schottky Vf=0.455V @ 100mA, Vr=10V, If=1000mA, Ir=1µA @ 10V |  | DO-216AA | ON Semiconductor | MBRM110ET1G
FB1, FB2, FB3, FB4, FB5, FB6 | 120R/0.55A | Ferrite Bead, 120 Ohm @ 100MHz, 500mA, 250 mOhm Max |  | 0402 | Murata | BLM15AG121SN1D
Fid1, Fid2 |  | Fiducial Mark |  | Fiducial
J1 | MM8130-2600 | Coaxial Connector with Switch |  | COAXIAL-SWF | Murata | MM8130-2600
J2, J3 | MicroUSB-B | MicroUSB-B-SMT |  | USB-Micro-B-RA-SMD-PiP | Allen Creations Corp. | AJU55-BS2111-L
J5 | FPC 0.5mm RA SMD | 0.5mm FPC, 5P,Right Angle SMT,Double Contact,H=1.2mm,White, Tin plated |  | FPC_05P-0.5mm-RA-SMD | W-CON | 5141-05RZDNWR01
J6 | HDR-2, 1mm | 1.0mm pitch connector side entry SMD |  | SM02B-SRSS-TB | JST Sales America Inc. | SM02B-SRSS-TB(LF)(SN)
L1 | 2.2nH | FIXED IND 2.2NH 600MA 120 MOHM |  | 0201 | Murata | LQP03HQ2N2B02D
L2, L3, L4 | 10µH | Inductor, 250mA, ±20%, 1.05ohm. -55°C ~ 125°C |  | 0603 | TDK Corporation | MLZ1608M100WTD25
L6 | 4.7µH | Ferrite Inductor, Shielded, 1,04A, 144mOhm |  | 1212 | Taiyo Yuden | NR3015T4R7M
L7 | 2.2µH | Ferrite Inductor, Shielded, 1,5A, 72mOhm |  | 1212 | Taiyo Yuden | NR3015T2R2M
LED1, LED2, LED3, LED4 | L0603G | LED, Green, 0603, 573nm, Vf=2.0V, 24mcd, - 40 to +85°C |  | 0603 | Victory Electronics | VS 25C7M5
LED5 | L0603G | LED, Green, 0603, 570nm, Vf=1.7V, 2.24..5.6mcd, - 40 to +100°C |  | 0603 | Osram | LG L29K-G2J1-24-Z
P1, P3, P6 | Socket 1x8 | Socket 1x8, 2.54mm (100mil), SMD |  | SOCKET_1x8_SMD | W-CON | 2171-108MS0CUNR1
P2 | Socket 1x6 | Socket 1x6, 2.54mm (100mil), SMD |  | SOCKET_1x6_SMD | W-CON | 2171-106MS0CUNR1
P4 | Socket 1x10 | Socket 1x10, 2.54mm (100mil), SMD |  | SOCKET_1x10_SMD | W-CON | 2171-110MS0CUNR1
P5 | Pin Hdr 2x3 | Pin Header 2x3, 2.54mm (100mil) SMD |  | HDR_2x3-SMD | W-CON | 1125-1203S0M116R1
P7, P9, P12 | Pin List 1x8 | Pin List 1x8, 2.54mm (100mil), SMD | Not mounted | LIST_1x8_SMD | W-CON | 1125-1108S0M116R2
P8 | Pin List 1x6 | Pin List 1x6, 2.54mm (100mil), SMD | Not mounted | LIST_1x6_SMD | W-CON | 1125-1106S0M116R2
P10 | Pin List 1x10 | Pin List 1x10, 2.54mm (100mil), SMD | Not mounted | LIST_1x10_SMD | W-CON | 1125-1110S0M116R2
P11 | Socket 2x3 | Socket 2x3, 2.54mm (100mil), SMD | Not mounted | SOCKET_2x3_SMD-2.54mm-bottom | W-CON | 2171-203MS0CUNR1
P13, P15, P17 | Pin Header 2x8 | Pin Header 2x8, 2.54mm (100mil) | Not mounted | HDR_2x8 | N.A. | N.A.
P14 | Pin Header 2x6 | Pin Header 2x6, 2.54mm (100mil) | Not mounted | HDR_2x6 | N.A. | N.A.
P16 | Pin Header 2x10 | Pin Header 2x10, 2.54mm (100mil) | Not mounted | HDR_2x10 | N.A. | N.A.
P18, P19 | Pin Header 2x5, 1.27mm | Pin Header 2x5, 1.27mm (50mil), SMD, Keying Shroud |  | HDR_2x5-SMD-1.27mm | W-CON | 3132-10MS0BK00R1
P20 | Pin List 1x13 | Pin List 1x13, 2.54mm (100mil), SMD |  | LIST_1x13_SMD | N.A. | N.A.
P21, P22, P23 | Pin List 1x2, Angled | Pin List 1x2, 2.54mm (100mil), Right Angled, SMD |  | LIST_ANG_1x2-SMD-2.54MM | W-CON | 1125B-1102S0Z135R2
P24 | Socket 2x10 | Socket 2x10, 2.54mm (100mil), SMD |  | SOCKET_2x10_SMD-2.54mm | W-CON | 2171-210MS0CUNR1
P25 | Pin Header 2x10, 1.27mm | Pin Header 2x10, 1.27mm (50mil), SMD, Keying Shroud | Not mounted | HDR_2x10-SMD-1.27mm | W-CON | 3132-20MS0BK00R1
P26 | Socket 1x13 | Socket 1x13, 2.54mm (100mil), SMD | Not mounted | SOCKET_1x13_SMD | W-CON | 2171-113MS0CUNR1
P27 | Pin List 1x2 | Pin List 1x2, 2.54mm (100mil) | Not mounted | LIST_1x2 | N.A. | N.A.
P28 | Pin List 1x3 | Pin List 1x3, 2.54mm (100mil) | Not mounted | LIST_1x3 | N.A. | N.A.
Q1, Q2, Q3, Q6, Q9 | RV2C010UNT2L | N-Channel MOSFET, 20V, 1A, 470mOhm, 400mW |  | DFN-3 | Rohm Semiconductor | RV2C010UNT2L
Q5, Q10 | PMCPB5530 | Mosfet Array N and P-Channel 20V 4A (Ta), 3.4A (Ta) 490mW Surface Mount 6-HUSON-EP (2x2) |  | 6-UDFN | Nexperia | PMCPB5530X,115
Q7 | FCX690BTA | 45V NPN high gain power transistor |  | SOT-89 | Diodes Incorporated | FCX690BTA
Q8 | TSM250N02DCQ RFG | Dual N Ch MOFET, 5.8A, 55mOhm max, 620mW |  | VDFN-6 | Taiwan Semiconductor | TSM250N02DCQ RFG
R1, R10 | 2R2 | Resistor, ±1%, 0.05W |  | 0201 | N.A. | N.A.
R2, R3, R4, R5 | 220R | Resistor, ±1%, 0.05W |  | 0201 | N.A. | N.A.
R6, R47, R71 | 100k | Resistor, ±1%, 0.05W |  | 0201 | N.A. | N.A.
R7 | 560R | Resistor, ±1%, 0.05W |  | 0201 | N.A. | N.A.
R8, R25, R51, R57, R68, R69, R72, R74 | 1M0 | Resistor, ±1%, 0.05W |  | 0201 | N.A. | N.A.
R9, R13, R42, R45 | N.C. | Not mounted | Not mounted | 0201 | N.A. | N.A.
R11 | 49.9R | Resistor, ±1%, 0.05W |  | 0201 | N.A. | N.A.
R12, R50 | 47k | Resistor, ±1%, 0.05W |  | 0201 | N.A. | N.A.
R14, R15, R16, R17, R19, R21, R22, R23 | 150R | Resistor, ±1%, 0.05W |  | 0201 | N.A. | N.A.
R20, R24, R43, R46, R53, R54 | 0R | Resistor, ±5%, 0.05W |  | 0201 | N.A. | N.A.
R44, R55, R56, R77 | 10k | Resistor, ±1%, 0.05W |  | 0201 | N.A. | N.A.
R48, R49 | 4k7 | Resistor, ±1%, 0.05W |  | 0201 | N.A. | N.A.
R52 | 150k | Resistor, ±1%, 0.05W |  | 0201 | N.A. | N.A.
R58 | 1k | Resistor, ±1%, 0.05W |  | 0201 | N.A. | N.A.
R59 | 270k | Resistor, ±1%, 0.05W |  | 0201 | N.A. | N.A.
R60 | 330k | Resistor, ±1%, 0.05W |  | 0201 | N.A. | N.A.
R61, R70, R73 | 10M | Resistor, ±1%, 0.05W |  | 0201 | N.A. | N.A.
R62 | 30k | Resistor, ±1%, 0.05W |  | 0201 | N.A. | N.A.
R63 | 120k | Resistor, ±1%, 0.05W |  | 0201 | N.A. | N.A.
R64, R67 | N.C. | Not mounted | Not mounted | 0402 | N.A. | N.A.
R65 | 820k | Resistor, ±1%, 0.05W |  | 0201 | N.A. | N.A.
R66 | 470k | Resistor, ±1%, 0.05W |  | 0201 | N.A. | N.A.
R75 | 205R | Resistor, ±1%, 0.05W |  | 0201 | N.A. | N.A.
R78 | 4R7 | Resistor, ±1%, 0.05W |  | 0201 | N.A. | N.A.
SW1, SW2, SW3, SW4, SW5 | PB SW | Tactile Switch, SPNO, SMD, 160gf, 6.2x6.3x2.5mm |  | Switch-PB-6.2x6.3mm-SMD | Dailywell | TS604VM1-025BR-R
SW6, SW10 | CAS-220TA | Slide Switch DPDT J Hook |  | CAS-220TA | Copal Electronics Inc | CAS-220TA
SW7 | Switch | SMD slide Switch 2xSPDT |  | CAS-D20A | Copal Electronics Inc | CAS-D20TA
SW8 | MK-22D14-G2 | Slide Switch DPDT |  | MK-22D14-G2 | HUA-JIE CORP. | MK-22D14-G2
SW9 | JS203011JCQN | Slide Switch DP3T 300mA 6V |  | Switch-Slide-J-Lead-DP3T-13x3.5mm | C&K | JS203011JCQN
U1, U2 | nRF5340-QKAA | Multi-protocol Bluetooth Low Energy, IEEE 802.15.4, ANT and 2.4GHz proprietary system-on-chip |  | AQFN-98 | Nordic Semiconductor | nRF5340-QKAAD0
U3, U5, U6, U25 | FSA2466UMX | Data / Audio Low-Voltage Dual DPDT Analog Switch |  | UFQFN-16 | ON Semiconductor | FSA2466UMX
U4, U12, U13, U14, U15, U17, U19, U20, U22, U23 | TCK106AG | 1.0 A Load Switch IC with Slew Rate Control Driver in Ultra Small Package |  | WLCSP-4 | Toshiba | TCK106AG,LF
U7 | MX25R6435F | Ultra low power, 64M-bit, serial multi I/O flash memory |  | WSON-8 | Macronix | MX25R6435FZNIL0
U9 | TS27L2IPT | Precision very low power CMOS dual operational amplifier |  | TSSOP-8 | STMicroelectronics | TS27L2IPT
U10 | XC9131 | 1A Driver Transistor Built-In, Multi Functional Step-Up DC/DC Converter |  | UFDFN-10 | Torex Semiconductor | XC9131H05CDR-G
U11 | XC9236 | 600mA Driver Transistor Built-In, Synchronous Step-Down DC/DC Converters |  | USP-6C | Torex Semiconductor | XC9236D08CER-G
U16, U24 | 74LVC1G08 | Single 2-Input AND Gate |  | SC70-5 | NXP Semiconductors | 74LVC1G08GW
U18, U21 | 74LVC1G11 | Single 3-input AND gate |  | SC70-6 | NXP Semiconductors | 74LVC1G11GW
X1, X3 | 32MHz | XTAL SMD 2016, 32MHz, Cl=8pF, Tol: ±10ppm, Stab: ±15ppm |  | XTAL_2016 | Golledge | MP06003
X2 | 32.768kHz | XTAL SMD 2012, 32.768kHz, 9pF, ±20ppm |  | XTAL_2012 | Golledge | MP07668
