binphilxiao/AxisLabs/BLE0201/Ref/nRF5340 Development Kit - Hardware files 2_0_0/PCA64110-NFC Antenna Flexprint 1_0_0/Production files/BOM/PCA64110_BOM.xls

Bill of material
PCB: | PCA64110
Version: | 1.0.0
Designator | Value | Description | Footprint Doc | Manufacturer | Manufacturer Part Number
