binphilxiao/AxisLabs/MAT0101/Ref/nRF7002 Development Kit - Hardware files 0_7_2/PCA10143-nRF7002 Development Kit 0_7_2/Production files/BOM/PCA10143_BOM_Web.xls

Bill of material
Board: | PCA10143
Version: | 0.7.2
Designator | Value | Description | Fitted | Footprint Doc | Manufacturer | Manufacturer Part Number
A1 | 2450AD18A6050 | 2.4, 5, and 6GHz BT/WiFi6E Mini Antenna, Single-feed, Tri-band, Corner Mount | Fitted | 2450AD18A6050 | Johanson Technology | 2450AD18A6050
A2 | 2450AT18D0100 | 2.45 GHz chip antenna | Fitted | 2450AT18D0100 | Johanson Technology | 2450AT18D0100
C1 | 0.7pF | Capacitor, Ceramic, NP0, ±0.1pF, 25V | Fitted | 0201 | Murata | GJM0335C1ER70BB01D
C2, C3, C5, C7, C16, C25, C26, C38, C39, C74 | 1.0µF | Capacitor, X5R, ±5%, 6.3V | Fitted | 0402 | N.A. | N.A.
C4, C27 | 2.2nF | Capacitor, X7R, ±10%, 10V | Fitted | 0201 | N.A. | N.A.
C6, C8, C9, C10, C11, C12, C13, C14, C15, C24, C30, C31, C32, C33, C34, C35, C36, C37, C41, C42, C45, C48, C50, C52, C54, C65, C73, C92 | 100nF | Capacitor, X5R, ±10% | Fitted | 0201 | N.A. | N.A.
C17, C18, C20, C40 | 4.7µF | Capacitor, X7S, ±10%, 10V | Fitted | 0603 | N.A. | N.A.
C19 | 2.2µF | Capacitor, X7R, ±10% | Fitted | 0603 | N.A. | N.A.
C22, C47, C49 | 10nF | Capacitor, X7R, ±10% | Fitted | 0201 | N.A. | N.A.
C43, C44 | 300pF | Capacitor, C0G, ±5%, 50V | Fitted | 0402 | N.A. | N.A.
C51, C53, C67 | 1.0µF | Capacitor, X7R, ±10% | Fitted | 0603 | N.A. | N.A.
C57, C59, C60 | 10µF | Capacitor, X5R, ±20%, 25V | Fitted | 0603 | Samsung Electro-Mechanics America | CL10A106MA8NRNC
C58 | 1.0µF | Capacitor, Ceramic, 1.0µF 16V X6S 0402,±10% | Fitted | 0402 | Murata | GRM155C81C105KE11
C61, C66 | 4.7µF | Capacitor, X5R, 10V | Fitted | 0402 | Murata | GRM155R61A475MEAAD
C62, C69 | 150pF | Capacitor, Ceramic, NP0, ±5%, 25V | Fitted | 0201 | Murata | GRM0335C1E151JA01D
C63, C70 | 10µF | Capacitor, Ceramic, X5R, ±20%, 25V | Fitted | 0603 | Murata | GRM188R61E106MA73J
C64 | 2.2µF | Capacitor, Ceramic, 2.2µF 25V X5R 0201,±10% | Fitted | 0402 | Murata | GRM155R61E225KE11
C68, C77 | 2.2µF | Capacitor, Ceramic, 2.2µF 16V X7S 0603,±10% | Fitted | 0603 | Murata | GRM188C71C225KE11
C71, C80 | 100nF | Capacitor, Ceramic, 100nF 16V X7S 0201,±10% | Fitted | 0201 | Murata | GRM033C71C104KE14
C72 | 4.7µF | Capacitor, X7R, ±10%, 6.3V | Fitted | 0603 | Samsung Electro-Mechanics America | CL10B475KQ8NQNC
C75, C79 | 0.47µF | Capacitor, Ceramic, 0.47µF 6.3V X5R 0201,±10% | Fitted | 0201 | Murata | GRM033R60J474KE90
C76 | 10nF | Capacitor, Ceramic, 10nF 16V X7R 0201,±10% | Fitted | 0201 | Murata | GRM033R71C103KE14
C78, C81, C82, C83 | 4.7µF | Capacitor, Ceramic, 4.7µF 25V X6S 0603,±10% | Fitted | 0603 | Murata | GRM188C81E475KE11
C84 | 22nF | Capacitor, Ceramic, 22nF 10V X5R 0201,±10% | Fitted | 0201 | Murata | GRM033R61A223KE84
C85 | 0.22µF | Capacitor, Ceramic, 0.22µF 10V X5R 0201, ±10% | Fitted | 0201 | Murata | GRM033R61A224KE90
C86 | 2.2µF | Capacitor, Ceramic, 2.2µF 10V X5R 0201,±10% | Fitted | 0201 | Murata | GRM033R61A225KE47
C87 | 1.0µF | Capacitor, Ceramic, 1.0µF 10V X7S 0402,±10% | Fitted | 0402 | Murata | GRM155C71A105KE11
C88 | 1.0µF | Capacitor, Ceramic, 1.0µF 35V X5R 0402,±10% | Fitted | 0402 | Murata | GRM155R6YA105KE11
C91 | 0.5pF | Capacitor, NP0, ±0.05pF | Fitted | 0201 | N.A. | N.A.
D1, D2 | PRTR5V0U2X | Ultra low capacitance double rail-to-rail ESD protection diode | Fitted | SOT-143B | NXP Semiconductors | PRTR5V0U2X
D3, D4, D5, D6, D7, D8 | NSR0620P2T5G | 20V schottky barrier diode, Vf 350 mV @ 100 mA, Ir 2.0 µA @ 10 V, If 500 mA | Fitted | SOD-923 | ON Semiconductor | NSR0620P2T5G
FB1, FB2, FB3, FB4 | 120R/0.55A | Ferrite Bead, 120 Ohm @ 100MHz, 500mA, 250 mOhm Max | Fitted | 0402 | Murata | BLM15AG121SN1D
Fid1, Fid2 | N.A. | Fiducial Mark | Fitted | Fiducial | N.A. | N.A.
J1, J7 | MM8130-2600 | Coaxial Connector with Switch | Fitted | COAXIAL-SWF | Murata | MM8130-2600
J2, J3 | MicroUSB-B | MicroUSB-B-SMT | Fitted | USB-Micro-B-RA-SMD-PiP | Allen Creations Corp. | AJU55-BS2111-L
J5 | FPC 0.5mm RA SMD | 0.5mm FPC, 5P,Right Angle SMT,Double Contact,H=1.2mm,White, Tin plated | Fitted | FPC_05P-0.5mm-RA-SMD | W-CON | 5141-05RZDNWR02
J6 | HDR-2, 1mm | 1.0mm pitch connector side entry SMD | Fitted | SM02B-SRSS-TB | JST Sales America Inc. | SM02B-SRSS-TB(LF)(SN)
JP1, JP2 | Shunt 2.54mm | Shunt Jumper 2.54mm Black, open top | Fitted | SHUNT JUMPER 2.54mm | Samtec | SNT-100-BK-T
L1 | 2.2nH | Inductor, 600mA, ±0.1ｎH, 120mOhm | Fitted | 0201 | Murata | LQP03HQ2N2B02
L2, L3, L4 | 10µH | Inductor, 250mA, ±20%, 1.05ohm. -55°C ~ 125°C | Fitted | 0603 | TDK Corporation | MLZ1608M100WTD25
L5 | 3.3µH | Inductor, 1A, ±20%, 200mOhm | Fitted | 1008 | Murata | LQM2HPN3R3MGCL
L6, L8 | 4.7µH | Ferrite Inductor, Shielded, 1,04A, 144mOhm | Fitted | 1212 | Taiyo Yuden | NR3015T4R7M
L7 | 4.7µH | 4.7µH Shielded Wirewound Inductor 2.23A 201 mOhm Max Nonstandard | Fitted | VLS3012HBX | TDK Corporation | VLS3012HBX-4R7M-N
L40 | 3.3nH | Inductor, 500mA, ±0.1ｎH, 170mOhm | Fitted | 0201 | Murata | LQP03HQ3N3B02
L80 | 1.5nH | Inductor, 1000mA, ±0.1ｎH, 50mOhm | Fitted | 0201 | Murata | LQP03HQ1N5B02
LED1, LED2, LED5 | L0603G | LED, Green, 0603, 573nm, Vf=2.0V, 24mcd, - 40 to +85°C | Fitted | 0603 | Victory Electronics | VS 25C7M5
P1, P3, P6 | Socket 1x8 | Socket 1x8, 2.54mm (100mil), SMD | Fitted | SOCKET_1x8_SMD | W-CON | 2171-108MS0CUNR1
P2 | Socket 1x6 | Socket 1x6, 2.54mm (100mil), SMD | Fitted | SOCKET_1x6_SMD | W-CON | 2171-106MS0CUNR1
P4 | Socket 1x10 | Socket 1x10, 2.54mm (100mil), SMD | Fitted | SOCKET_1x10_SMD | W-CON | 2171-110MS0CUNR1
P5 | Pin Hdr 2x3 | Pin Header 2x3, 2.54mm (100mil) SMD | Fitted | HDR_2x3-SMD | W-CON | 1125-1203S0M116R1
P18, P19 | Pin Header 2x5, 1.27mm | Pin Header 2x5, 1.27mm (50mil), SMD, Keying Shroud | Fitted | HDR_2x5-SMD-1.27mm | W-CON | 3132-10MS0BK00R1
P20 | Pin List 1x13 | Pin List 1x13, 2.54mm (100mil), SMD | Fitted | LIST_1x13_SMD | N.A. | N.A.
P21, P22, P23 | Pin List 1x2, Angled | Pin List 1x2, 2.54mm (100mil), Right Angled, SMD | Fitted | LIST_ANG_1x2-SMD-2.54MM | W-CON | 1125B-1102S0Z135R2
P24 | Socket 2x10 | Socket 2x10, 2.54mm (100mil), SMD | Fitted | SOCKET_2x10_SMD-2.54mm | W-CON | 2171-210MS0CUNR1
Q1, Q2, Q3, Q4, Q6, Q8, Q9, Q10 | RV2C010UNT2L | N-Channel MOSFET, 20V, 1A, 470mOhm, 400mW | Fitted | DFN-3 | Rohm Semiconductor | RV2C010UNT2L
Q5 | PMCPB5530 | Mosfet Array N and P-Channel 20V 4A (Ta), 3.4A (Ta) 490mW Surface Mount 6-HUSON-EP (2x2) | Fitted | 6-UDFN | Nexperia | PMCPB5530X,115
Q7 | FCX690BTA | 45V NPN high gain power transistor | Fitted | SOT-89 | Diodes Incorporated | FCX690BTA
R1, R10 | 2R2 | Resistor, ±1%, 0.05W | Fitted | 0201 | N.A. | N.A.
R2, R3 | 330R | Resistor, ±1%, 0.05W | Fitted | 0201 | N.A. | N.A.
R4, R6, R36, R37, R41, R47, R59, R62 | 100k | Resistor, ±1%, 0.05W | Fitted | 0201 | N.A. | N.A.
R7 | 560R | Resistor, ±1%, 0.05W | Fitted | 0201 | N.A. | N.A.
R8, R25, R51, R57, R69 | 1M0 | Resistor, ±1%, 0.05W | Fitted | 0201 | N.A. | N.A.
R11 | 49.9R | Resistor, ±1%, 0.05W | Fitted | 0201 | N.A. | N.A.
R12, R50 | 47k | Resistor, ±1%, 0.05W | Fitted | 0201 | N.A. | N.A.
R14, R15, R16, R17, R19, R21, R22, R23 | 150R | Resistor, ±1%, 0.05W | Fitted | 0201 | N.A. | N.A.
R20, R24, R26, R27, R28, R29, R30, R31, R43, R46, R53, R54, R81 | 0R | Resistor, ±5%, 0.05W | Fitted | 0201 | N.A. | N.A.
R38 | 560k | Resistor, ±1%, 0.05W | Fitted | 0201 | N.A. | N.A.
R39 | 160k | Resistor, ±1%, 0.05W | Fitted | 0201 | N.A. | N.A.
R48, R49 | 4k7 | Resistor, ±1%, 0.05W | Fitted | 0201 | N.A. | N.A.
R52, R60 | 150k | Resistor, ±1%, 0.05W | Fitted | 0201 | N.A. | N.A.
R58 | 1k | Resistor, ±1%, 0.05W | Fitted | 0201 | N.A. | N.A.
R61, R70 | 10M | Resistor, ±1%, 0.05W | Fitted | 0201 | N.A. | N.A.
R63 | 120k | Resistor, ±1%, 0.05W | Fitted | 0201 | N.A. | N.A.
R75 | 1k62 | Resistor, ±1%, 0.05W | Fitted | 0201 | N.A. | N.A.
R77 | 10k | Resistor, ±1%, 0.05W | Fitted | 0201 | N.A. | N.A.
SW1, SW2, SW5 | PB SW | Tactile Switch, SPNO, SMD, 160gf, 6.2x6.3x2.5mm | Fitted | Switch-PB-6.2x6.3mm-SMD | Dailywell | TS604VM1-025BR-R
SW6, SW10 | CAS-220TA | Slide Switch DPDT J Hook | Fitted | CAS-220TA | Copal Electronics Inc | CAS-220TA
SW7 | Switch | SMD slide Switch 2xSPDT | Fitted | CAS-D20A | Copal Electronics Inc | CAS-D20TA
SW8 | MK-22D14-G2 | Slide Switch DPDT | Fitted | MK-22D14-G2 | HUA-JIE CORP. | MK-22D14-G2
U1, U2 | nRF5340-QKAA | Multi-protocol Bluetooth Low Energy, IEEE 802.15.4, ANT and 2.4GHz proprietary system-on-chip | Fitted | AQFN-98 | Nordic Semiconductor | nRF5340-QKAAD0
U3, U5, U6, U25 | FSA2466UMX | Data / Audio Low-Voltage Dual DPDT Analog Switch | Fitted | UFQFN-16 | ON Semiconductor | FSA2466UMX
U7, U11 | XC9236 | 600mA Driver Transistor Built-In, Synchronous Step-Down DC/DC Converters | Fitted | USP-6C | Torex Semiconductor | XC9236D08CER-G
U8 | nRF7002 | Wifi Dual Band Companion chip | Fitted | QFN-48 | Nordic Semiconductor | nRF7002-QFAABB
U9 | TS27L2IPT | Precision very low power CMOS dual operational amplifier | Fitted | TSSOP-8 | STMicroelectronics | TS27L2IPT
U10 | XC9148 | 1.4A Driver Transistor Built-In, Multi Functional Step-Up DC/DC Converter | Fitted | USP-6C | Torex Semiconductor | XC9148A50CER-G
U12, U14, U16, U19, U20, U22 | TCK106AG | 1.0 A Load Switch IC with Slew Rate Control Driver in Ultra Small Package | Fitted | WLCSP-4 | Toshiba | TCK106AG,LF
U13, U50 | BGS12SN6 | Wideband SPDT RF Switch, 50MHz-6GHz. Max 30dBm, 1.8-3.5V | Fitted | TSNP-6-8 | Infineon Technologies | BGS12SN6E6327XTSA1
U15 | MX25R6435F | Ultra low power, 64M-bit, serial multi I/O flash memory | Fitted | WSON-8 | Macronix | MX25R6435FZNIL0
U26 | LFD182G45DCJD247 | Signal Conditioning 2.4GHz and 5GHz Diplexer | Fitted | CAF | Murata | LFD182G45DCJD247
X1, X3 | 32MHz | XTAL SMD 2016, 32MHz, Cl=8pF, ±30ppm, -40°C ~ 105°C | Fitted | XTAL_2016 | Kyocera | CX2016SA32000D0WRQG1
X2 | 32.768kHz | XTAL SMD 2012, 32.768kHz, 9pF, ±20ppm | Fitted | XTAL_2012 | Golledge | MP07668
X4 | 40MHz | XTAL SMD 1612, 40MHz, Cl=8pF, Total Tol: ±10ppm, -30 - 85C | Fitted | XTAL_1612 | KDS | DSX1612_40MHz
C21, C23, C28, C29, C46, C89, C90, C94 | N.C. | Not mounted | Not Fitted | 0201 | N.A. | N.A.
C55, C56 | 100nF | Capacitor, X5R, ±10% | Not Fitted | 0201 | N.A. | N.A.
C93 | 10µF | Capacitor, X5R, ±20%, 25V | Not Fitted | 0603 | Samsung Electro-Mechanics America | CL10A106MA8NRNC
FB5, FB6 | 120R/0.55A | Ferrite Bead, 120 Ohm @ 100MHz, 500mA, 250 mOhm Max | Not Fitted | 0402 | Murata | BLM15AG121SN1D
P7, P9, P12 | Pin List 1x8 | Pin List 1x8, 2.54mm (100mil), SMD | Not Fitted | LIST_1x8_SMD | W-CON | 1125-1108S0M116R2
P8 | Pin List 1x6 | Pin List 1x6, 2.54mm (100mil), SMD | Not Fitted | LIST_1x6_SMD | W-CON | 1125-1106S0M116R2
P10 | Pin List 1x10 | Pin List 1x10, 2.54mm (100mil), SMD | Not Fitted | LIST_1x10_SMD | W-CON | 1125-1110S0M116R2
P11 | Socket 2x3 | Socket 2x3, 2.54mm (100mil), SMD | Not Fitted | SOCKET_2x3_SMD-2.54mm-bottom | W-CON | 2171-203MS0CUNR1
P13, P15, P17 | Pin Header 2x8 | Pin Header 2x8, 2.54mm (100mil) | Not Fitted | HDR_2x8 | N.A. | N.A.
P14 | Pin Header 2x6 | Pin Header 2x6, 2.54mm (100mil) | Not Fitted | HDR_2x6 | N.A. | N.A.
P16 | Pin Header 2x10 | Pin Header 2x10, 2.54mm (100mil) | Not Fitted | HDR_2x10 | N.A. | N.A.
P25 | Pin Header 2x10, 1.27mm | Pin Header 2x10, 1.27mm (50mil), SMD, Keying Shroud | Not Fitted | HDR_2x10-SMD-1.27mm | W-CON | 3132-20MS0BK00R1
P26 | Socket 1x13 | Socket 1x13, 2.54mm (100mil), SMD | Not Fitted | SOCKET_1x13_SMD | W-CON | 2171-113MS0CUNR1
P28 | Pin List 1x3 | Pin List 1x3, 2.54mm (100mil) | Not Fitted | LIST_1x3 | N.A. | N.A.
R9, R13, R42, R45, R65, R66 | N.C. | Not mounted | Not Fitted | 0201 | N.A. | N.A.
R55, R56 | 10k | Resistor, ±1%, 0.05W | Not Fitted | 0201 | N.A. | N.A.
