binphilxiao/AxisLabs/GB0101/DesignNotes/PowerCordCal.ods

Sheet: Sheet2
Option 1, 2.c, Boost in the power module
PartNo. | AWG | Strand | Jacket | Material | Cross Section Diameter(mm) | length (m) | resistance1 (Ohm) | resistance2 (Ohm) | resistance3 (Ohm) | Avg resistance (Ohm) | offset (Ohm) | Resistance/3m For one way | Voltage drop @ 3m,2A For whole loop | Voltage drop @ 3m,0.5A For whole loop | Efficiency loss @12V, heavy load (%) | Efficiency loss @9V, heavy load (%) | Efficiency loss @12V, light load (%) | Efficiency loss @9V, light load (%)
1552200143 | 19 | 42 | WSOR | Copper, Bare | 6.40 | 1.40 | 0.24 | 0.24 | 0.24 | 0.05 | 0.19 | 0.10 | 0.42 | 0.10 | 3.48% | 4.63% | 0.87% | 1.16%
30-00368 | 20 | 26/34 | PVC | Copper, Tinned | 4.95 | 1.06 | 0.22 | 0.22 | 0.22 | 0.03 | 0.19 | 0.08 | 0.33 | 0.08 | 2.74% | 3.65% | 0.68% | 0.91%
44AM1131-22-MST3-9CS2275 | 22 | 19/34 | PVDF | Copper, Tinned | 3.43 | 0.30 | 0.20 | 0.20 | 0.20 | 0.01 | 0.19 | 0.10 | 0.41 | 0.10 | 3.44% | 4.59% | 0.86% | 1.15%
44AM1131-24-MST3-9CS2275 | 24 | 19/36 | PVDF | Copper, Tinned | 3.02 | 0.30 | 0.21 | 0.21 | 0.21 | 0.02 | 0.19 | 0.24 | 0.97 | 0.24 | 8.11% | 10.81% | 2.03% | 2.70%
55A1836-24-MST3-9CS2275 | 24 | 19/36 | ETFE | Copper Alloy, Nickel Coated | 3.30 | 0.30 | 0.22 | 0.22 | 0.22 | 0.03 | 0.19 | 0.34 | 1.35 | 0.34 | 11.22% | 14.96% | 2.81% | 3.74%
Universal USB3.0 |  |  |  | Copper, Bare |  | 3.00 | 0.30 | 0.30 |  | 0.10 | 0.20 | 0.10 | 0.39 | 0.10 | 3.25% | 4.33% | 0.81% | 1.08%
Option 2.a, 2.b, Boost in the Gear
PartNo. | AWG | Strand | Jacket | Material | Cross Section Diameter(mm) | length (m) | resistance1 (Ohm) | resistance2 (Ohm) | resistance3 (Ohm) | Avg resistance (Ohm) | offset (Ohm) | Resistance/3m For one way | Voltage drop @ 3m,6A For whole loop | Voltage drop @ 3m,1.5A For whole loop | Efficiency loss @12V, heavy load (%) | Efficiency loss @9V, heavy load (%) | Efficiency loss @12V, light load (%) | Efficiency loss @9V, light load (%)
1552200143 | 19 | 42 | WSOR | Copper, Bare | 6.40 | 1.40 | 0.24 | 0.24 | 0.24 | 0.05 | 0.19 | 0.10 | 1.25 | 0.31 | 10.43% | 10.43% | 2.61% | 2.61%
30-00368 | 20 | 26/34 | PVC | Copper, Tinned | 4.95 | 1.06 | 0.22 | 0.22 | 0.22 | 0.03 | 0.19 | 0.08 | 0.98 | 0.25 | 8.21% | 8.21% | 2.05% | 2.05%
44AM1131-22-MST3-9CS2275 | 22 | 19/34 | PVDF | Copper, Tinned | 3.43 | 0.30 | 0.20 | 0.20 | 0.20 | 0.01 | 0.19 | 0.10 | 1.24 | 0.31 | 10.33% | 10.33% | 2.58% | 2.58%
44AM1131-24-MST3-9CS2275 | 24 | 19/36 | PVDF | Copper, Tinned | 3.02 | 0.30 | 0.21 | 0.21 | 0.21 | 0.02 | 0.19 | 0.24 | 2.92 | 0.73 | 24.33% | 24.33% | 6.08% | 6.08%
55A1836-24-MST3-9CS2275 | 24 | 19/36 | ETFE | Copper Alloy, Nickel Coated | 3.30 | 0.30 | 0.22 | 0.22 | 0.22 | 0.03 | 0.19 | 0.34 | 4.04 | 1.01 | 33.67% | 33.67% | 8.42% | 8.42%
Universal USB3.0 |  |  |  | Copper, Bare |  | 3.00 | 0.30 | 0.30 |  | 0.10 | 0.20 | 0.10 | 1.17 | 0.29 | 9.75% | 9.75% | 2.44% | 2.44%

Sheet: Sheet1
AWG gauge | Conductor Diameter Inches | Conductor Diameter mm | Conductor cross section in mm2 | Ohms per 1000 ft. | Ohms per km | Maximum amps for chassis wiring | Maximum amps for power transmission | Maximum frequency for 100% skin depth for solid conductor copper | Breaking force Soft Annealed Cu 37000 PSI | 10ft voltage drop @2A
0 | 0.46 | 11.684 | 107 | 0.049 | 0.16072 | 380 | 302 | 125 Hz | 6120 lbs | 0.00098
0 | 0.4096 | 10.40384 | 84.9 | 0.0618 | 0.202704 | 328 | 239 | 160 Hz | 4860 lbs | 0.001236
0 | 0.3648 | 9.26592 | 67.4 | 0.0779 | 0.255512 | 283 | 190 | 200 Hz | 3860 lbs | 0.001558
0 | 0.3249 | 8.25246 | 53.5 | 0.0983 | 0.322424 | 245 | 150 | 250 Hz | 3060 lbs | 0.001966
1 | 0.2893 | 7.34822 | 42.4 | 0.1239 | 0.406392 | 211 | 119 | 325 Hz | 2430 lbs | 0.002478
2 | 0.2576 | 6.54304 | 33.6 | 0.1563 | 0.512664 | 181 | 94 | 410 Hz | 1930 lbs | 0.003126
3 | 0.2294 | 5.82676 | 26.7 | 0.197 | 0.64616 | 158 | 75 | 500 Hz | 1530 lbs | 0.00394
4 | 0.2043 | 5.18922 | 21.1 | 0.2485 | 0.81508 | 135 | 60 | 650 Hz | 1210 lbs | 0.00497
5 | 0.1819 | 4.62026 | 16.8 | 0.3133 | 1.027624 | 118 | 47 | 810 Hz | 960 lbs | 0.006266
6 | 0.162 | 4.1148 | 13.3 | 0.3951 | 1.295928 | 101 | 37 | 1100 Hz | 760 lbs | 0.007902
7 | 0.1443 | 3.66522 | 10.6 | 0.4982 | 1.634096 | 89 | 30 | 1300 Hz | 605 lbs | 0.009964
8 | 0.1285 | 3.2639 | 8.37 | 0.6282 | 2.060496 | 73 | 24 | 1650 Hz | 480 lbs | 0.012564
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
Metric 1 | 0.00394 | 0.1 | 0.00785 | 670.2 | 2198 | 0.126 | 0.0225 | 1750 kHz |  | 13.404
39 | 0.0035 | 0.0889 | 0.00621 | 831.8 | 2728 | 0.11 | 0.0175 | 2250 kHz | 0.36 lbs | 16.636
40 | 0.0031 | 0.07874 | 0.00487 | 1049 | 3440 | 0.09 | 0.0137 | 2900 kHz | 0.29 lbs | 20.98
