binphilxiao/AxisLabs/GR0101/052357-9/052357-9 Encoder Manufacture/BillOfMaterials.rep.txt

"C1 C4"	""	"GRM188R70J104KA01D"	"2"	"GRM188R70J104KA01D"	"Murata Electronics North America"	"0603"	""
"C2"	""	"CL10B104KO8NNNC"	"1"	"CL10B104KO8NNNC"	"Samsung Electro-Mechanics"	"0603"	""
"C5"	""	"C0603C102K9RAC7867"	"1"	"C0603C102K9RAC7867"	"KEMET"	"0603"	""
"C3"	""	"CL31B106KQHNFNE"	"1"	"CL31B106KQHNFNE"	"Samsung Electro-Mechanics"	"1206"	""
"J1"	""	"DF3EA-6P-2H(21)"	"1"	"DF3EA-6P-2H(21)"	"Hirose Electric Co Ltd"	"DF3EA-6P-2H(21)"	""
"U1-2"	""	"AH1806-P-B"	"2"	"AH1806-P-B"	"Diodes Incorporated"	"SIP-3-50MIL"	""
"U4"	""	"MSP430FR2000IPW16R"	"1"	"MSP430FR2000IPW16R"	"Texas Instruments"	"TSSOP-16"	""
"R4 R6"	""	"CRCW06030000Z0EC"	"2"	"CRCW06030000Z0EC"	"Vishay Dale"	"0603"	""
"R3"	""	"CRCW060347K0FKEA"	"1"	"CRCW060347K0FKEA"	"Vishay Dale"	"0603"	""
"R1-2"	""	"CRCW06035K10FKEA"	"2"	"CRCW06035K10FKEA"	"Vishay Dale"	"0603"	""
