binphilxiao/AxisLabs/GB0102/AWG26 THERMAL TEST/74033002.CSV

START | 2074/03/30 | 11:28:32
ID | 170800000
INTERVAL | 000 | sec
 |  |  | MAIN |  |  | SUB-1 |  |  | SUB-2 |  |  | Remark
No. | Date | Time | Func. | Value | Unit | Func. | Value | Unit | Func. | Value | Unit
1 | 2074/03/30 | 11:28:32 | TEMP. | 00021.1 | 'C
2 | 2074/03/30 | 11:28:32 | TEMP. | 00021.1 | 'C
3 | 2074/03/30 | 11:28:32 | TEMP. | 00021.1 | 'C
4 | 2074/03/30 | 11:28:32 | TEMP. | 00021.1 | 'C
5 | 2074/03/30 | 11:28:32 | TEMP. | 00021.0 | 'C
6 | 2074/03/30 | 11:28:33 | TEMP. | 00021.0 | 'C
7 | 2074/03/30 | 11:28:33 | TEMP. | 00021.0 | 'C
8 | 2074/03/30 | 11:28:33 | TEMP. | 00021.0 | 'C
9 | 2074/03/30 | 11:28:33 | TEMP. | 00021.0 | 'C
10 | 2074/03/30 | 11:28:33 | TEMP. | 00021.0 | 'C
11 | 2074/03/30 | 11:28:34 | TEMP. | 00021.0 | 'C
12 | 2074/03/30 | 11:28:34 | TEMP. | 00021.0 | 'C
13 | 2074/03/30 | 11:28:34 | TEMP. | 00021.0 | 'C
14 | 2074/03/30 | 11:28:34 | TEMP. | 00021.0 | 'C
15 | 2074/03/30 | 11:28:34 | TEMP. | 00021.0 | 'C
16 | 2074/03/30 | 11:28:35 | TEMP. | 00021.0 | 'C
17 | 2074/03/30 | 11:28:35 | TEMP. | 00021.0 | 'C
18 | 2074/03/30 | 11:28:35 | TEMP. | 00021.0 | 'C
19 | 2074/03/30 | 11:28:35 | TEMP. | 00021.0 | 'C
20 | 2074/03/30 | 11:28:35 | TEMP. | 00021.0 | 'C
21 | 2074/03/30 | 11:28:36 | TEMP. | 00021.0 | 'C
22 | 2074/03/30 | 11:28:36 | TEMP. | 00021.0 | 'C
23 | 2074/03/30 | 11:28:36 | TEMP. | 00021.0 | 'C
24 | 2074/03/30 | 11:28:36 | TEMP. | 00021.0 | 'C
25 | 2074/03/30 | 11:28:36 | TEMP. | 00021.0 | 'C
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
2320 | 2074/03/30 | 11:36:15 | TEMP. | 00021.3 | 'C
2321 | 2074/03/30 | 11:36:16 | TEMP. | 00021.3 | 'C
2322 | 2074/03/30 | 11:36:16 | TEMP. | 00021.3 | 'C
2323 | 2074/03/30 | 11:36:16 | TEMP. | 00021.3 | 'C
2324 | 2074/03/30 | 11:36:16 | TEMP. | 00021.3 | 'C
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
