binphilxiao/AxisLabs/CADModels/Shield/GearV2MainRevBShield.STEP

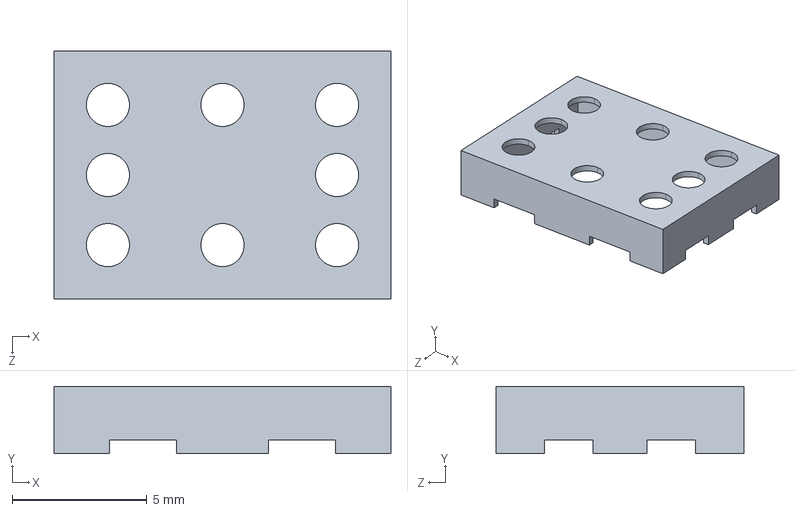
[picture p77: CAD file, 2020-12-17]
CADModels/Shield/GearV2MainRevBShield.STEP
12.5 x 2.50 x 9.20 mm
