binphilxiao/AxisLabs/CADModels/Connectors/PCBA-000029 (Pulley Sensor Assembly A).STEP

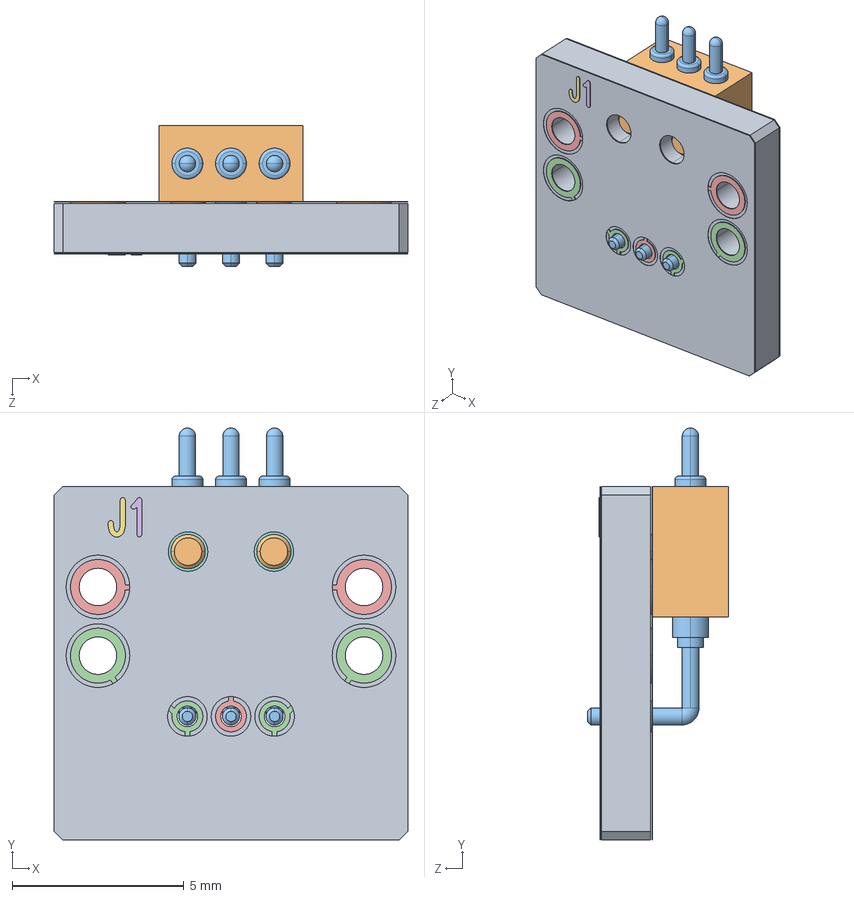
[picture p78: CAD file, 2022-04-04]
CADModels/Connectors/PCBA-000029 (Pulley Sensor Assembly A).STEP
10.3 x 12.0 x 4.11 mm
GearV2PullyARevB_BoardAndModels_REv 3
GearV2PullyARevB_CopperBottom
GearV2PullyARevB_CopperTop
GearV2PullyARevB_Silkscreen
GearV2PullyARevB_Soldermask
CFE Luis Pogo Housing
CFE Luis Pin x 3
