binphilxiao/AxisLabs/BLE0101/Docs/Shield/SH-10.2MM9.8MM1.4MM-AL 3D Rev.A.STEP

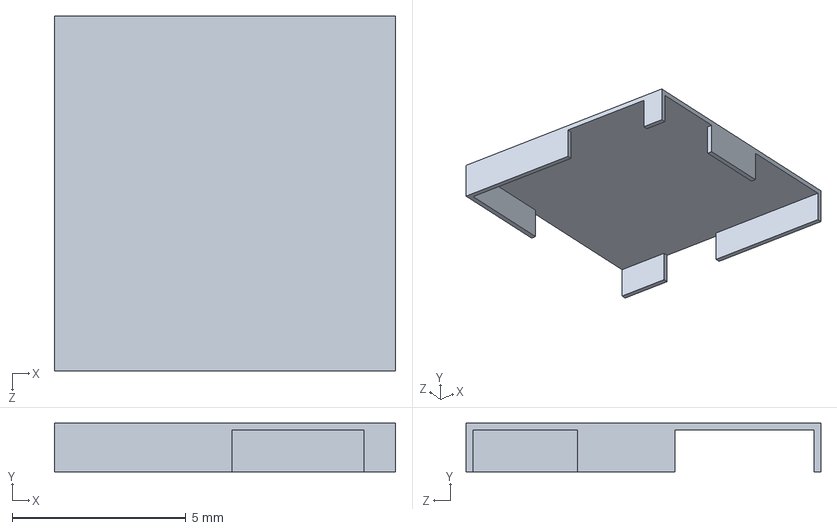
[picture p79: CAD file, 2022-06-01]
BLE0101/Docs/Shield/SH-10.2MM9.8MM1.4MM-AL 3D Rev.A.STEP
9.80 x 1.40 x 10.2 mm
