binphilxiao/AxisLabs/Button/smartbutton_V3-20250328-dwg-forPCB.DXF

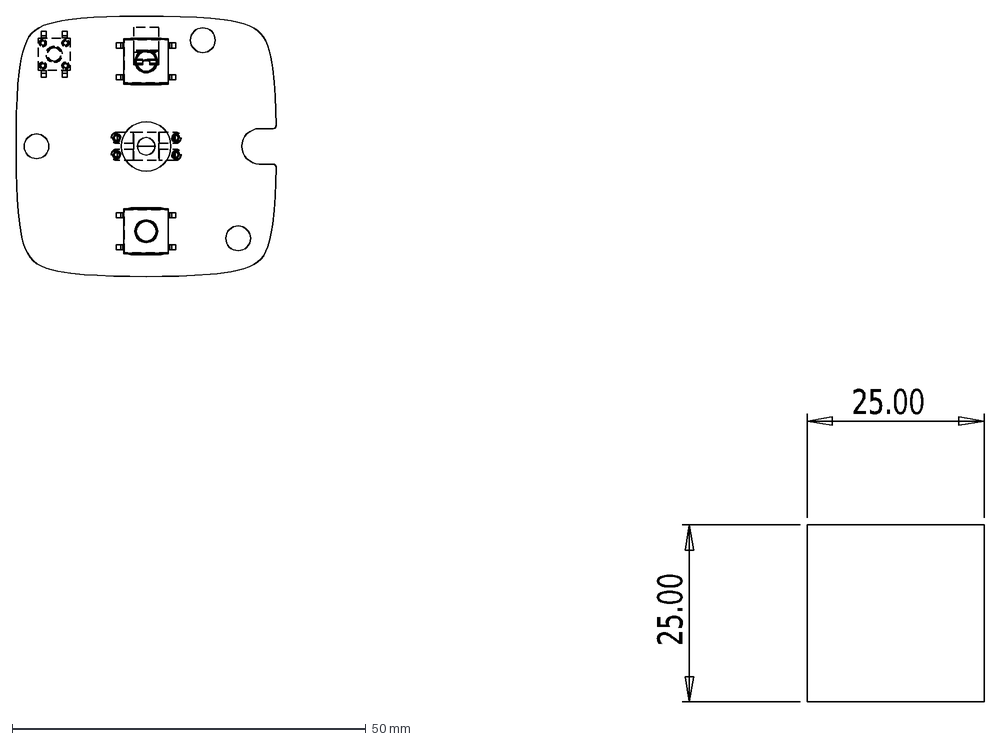
[picture p80: CAD file, 2025-06-10]
Button/smartbutton_V3-20250328-dwg-forPCB.DXF
25.00
