binphilxiao/AxisLabs/CADModels/Buttons/JB15FP.stp

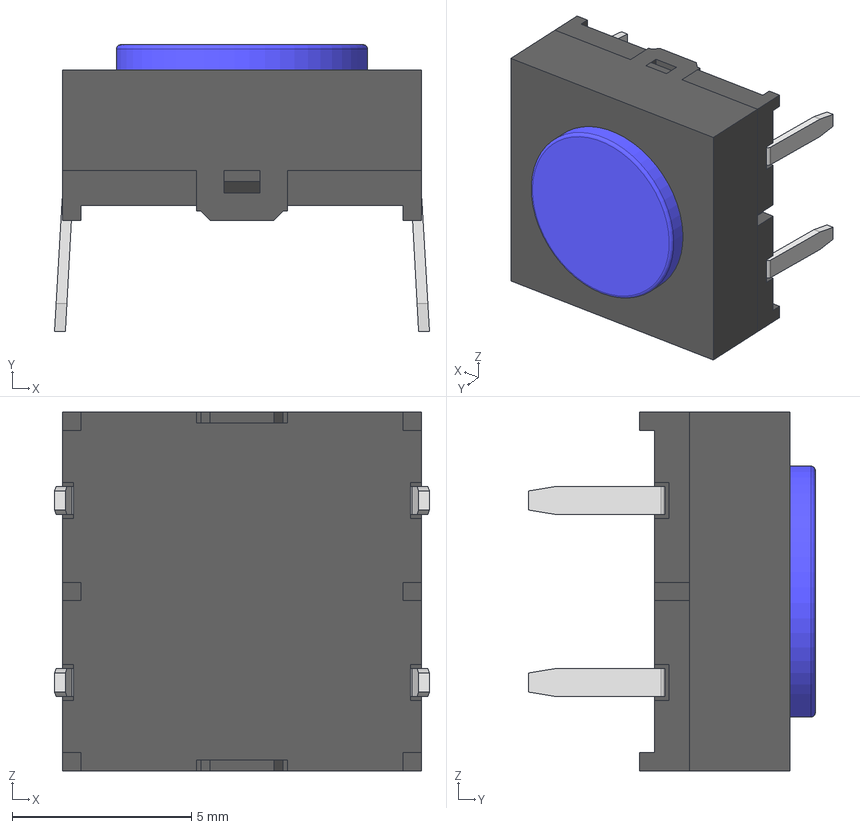
[picture p81: CAD file, 2024-03-25]
CADModels/Buttons/JB15FP.stp
10.5 x 8.00 x 10.0 mm
JB15FPblue
JB15FPtrmn x 4
JB15FPterm
JB15FPfs
