binphilxiao/AxisLabs/CADModels/Chips/DFN-6 2x2 Pad.step

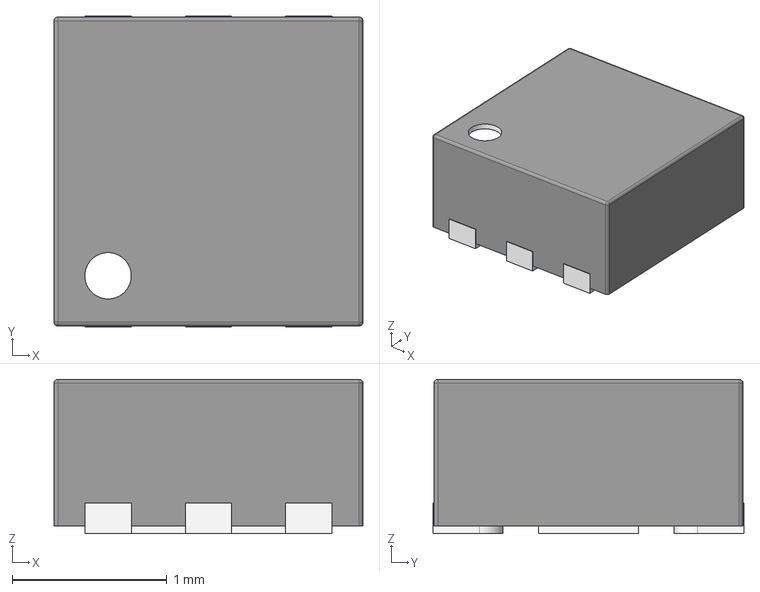
[picture p82: CAD file, 2026-03-16]
CADModels/Chips/DFN-6 2x2 Pad.step
2.00 x 2.01 x 1.00 mm
