binphilxiao/AxisLabs/CADModels/Connectors/0.5K-DX-5PWB.stp

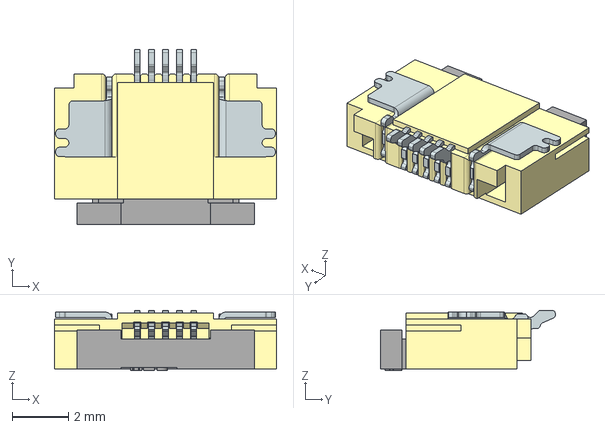
[picture p83: CAD file, 2026-03-16]
CADModels/Connectors/0.5K-DX-5PWB.stp
7.90 x 6.21 x 2.14 mm
