binphilxiao/AxisLabs/CADModels/Crystal/ABM12W-48.0000MHZ-8-D1X-T3--3DModel-STEP-400430.STEP

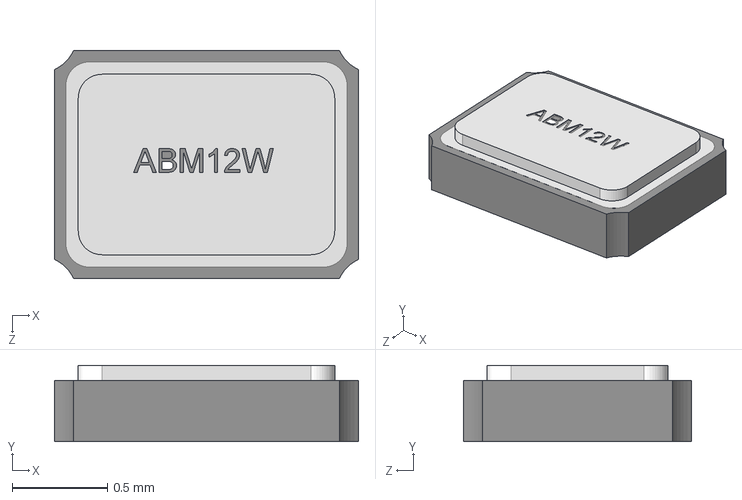
[picture p84: CAD file, 2022-04-04]
CADModels/Crystal/ABM12W-48.0000MHZ-8-D1X-T3--3DModel-STEP-400430.STEP
1.60 x 0.4 x 1.20 mm
