binphilxiao/AxisLabs/CADModels/FET&Diode/SOT-89-5.step

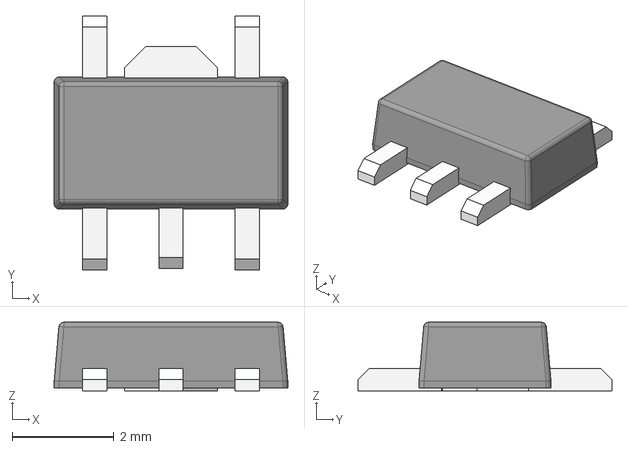
[picture p85: CAD file, 2022-11-22]
CADModels/FET&Diode/SOT-89-5.step
4.60 x 5.00 x 1.35 mm
