binphilxiao/AxisLabs/CADModels/Fuse/PTC1812.stp

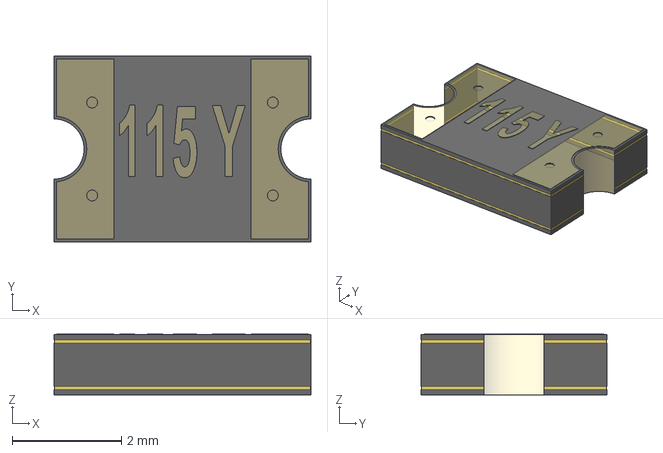
[picture p86: CAD file, 2021-04-16]
CADModels/Fuse/PTC1812.stp
4.70 x 3.40 x 1.11 mm
