binphilxiao/AxisLabs/CADModels/Inductors/L_0806.STEP

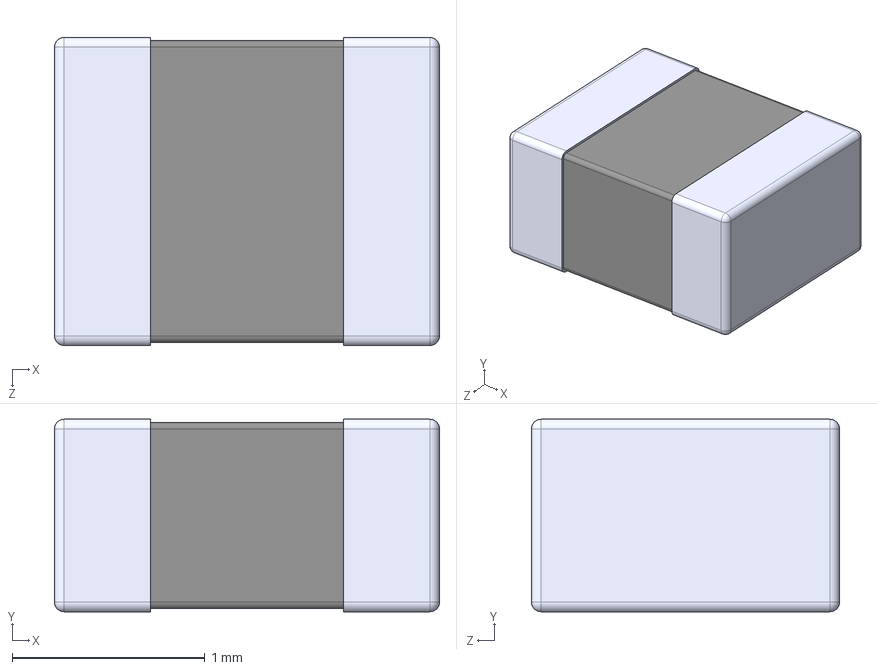
[picture p87: CAD file, 2025-04-29]
CADModels/Inductors/L_0806.STEP
2.00 x 1.00 x 1.60 mm
