binphilxiao/AxisLabs/CADModels/LED/0805 LED.STEP

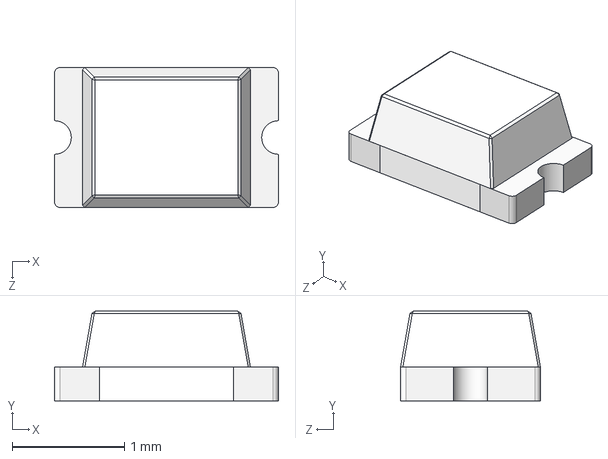
[picture p88: CAD file, 2021-04-16]
CADModels/LED/0805 LED.STEP
2.00 x 0.8 x 1.25 mm
