binphilxiao/AxisLabs/CADModels/Modules/AN7002Q-P.stp

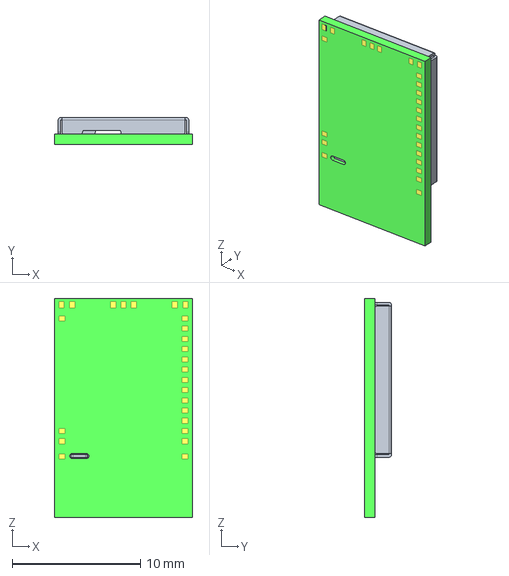
[picture p89: CAD file, 2026-03-16]
CADModels/Modules/AN7002Q-P.stp
10.8 x 2.11 x 17.1 mm
