binphilxiao/AxisLabs/CADModels/RC components/0402 resistor array.step

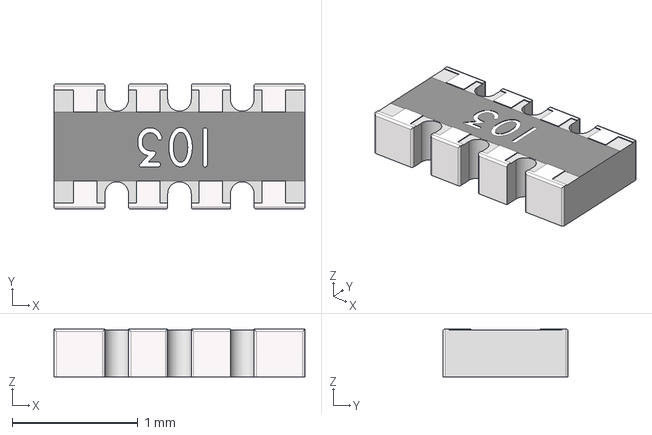
[picture p90: CAD file, 2022-06-01]
CADModels/RC components/0402 resistor array.step
2.00 x 1.00 x 0.381 mm
