binphilxiao/AxisLabs/CADModels/Relay/G5V_1.step

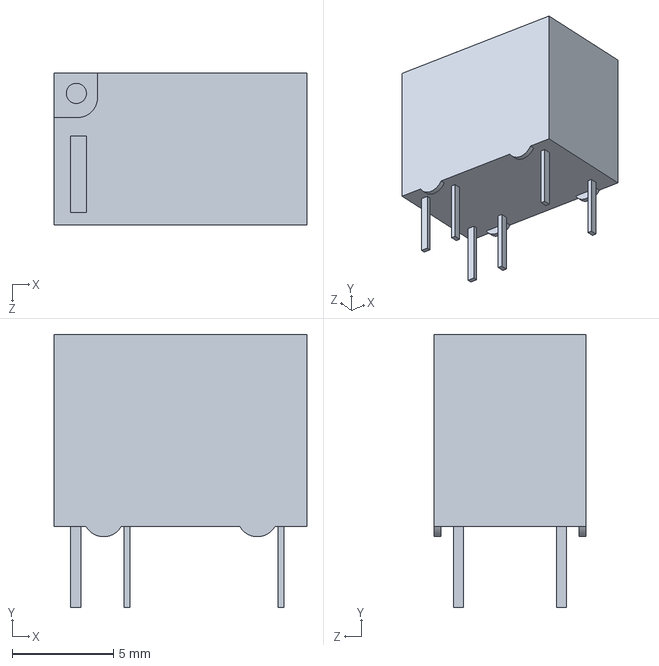
[picture p91: CAD file, 2021-05-04]
CADModels/Relay/G5V_1.step
12.5 x 13.5 x 7.50 mm
