binphilxiao/AxisLabs/CADModels/Switch/Toggle Switch.step

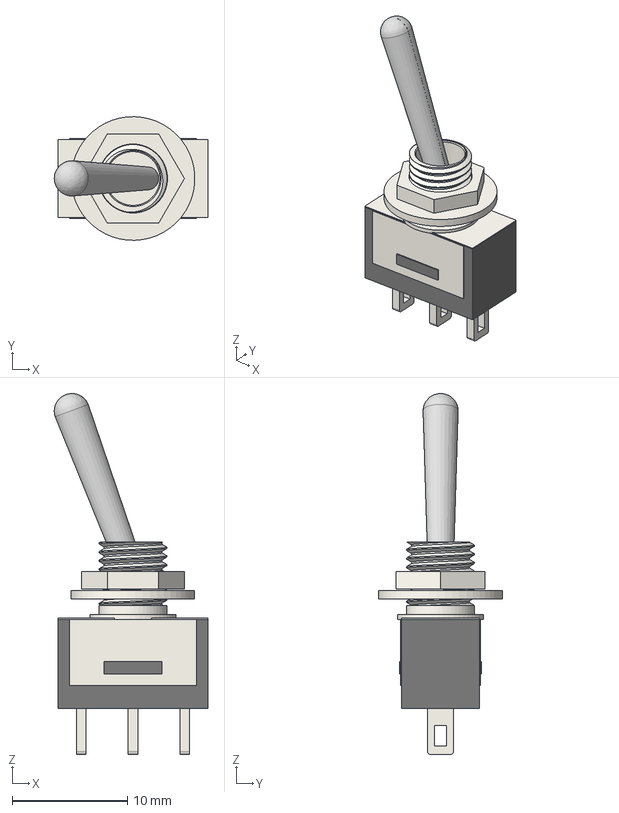
[picture p92: CAD file, 2021-04-16]
CADModels/Switch/Toggle Switch.step
13.3 x 10.7 x 31.4 mm
