binphilxiao/AxisLabs/GB0102/Drawing/BatteryPackRevDShield/BatteryPackRevDShield.STEP

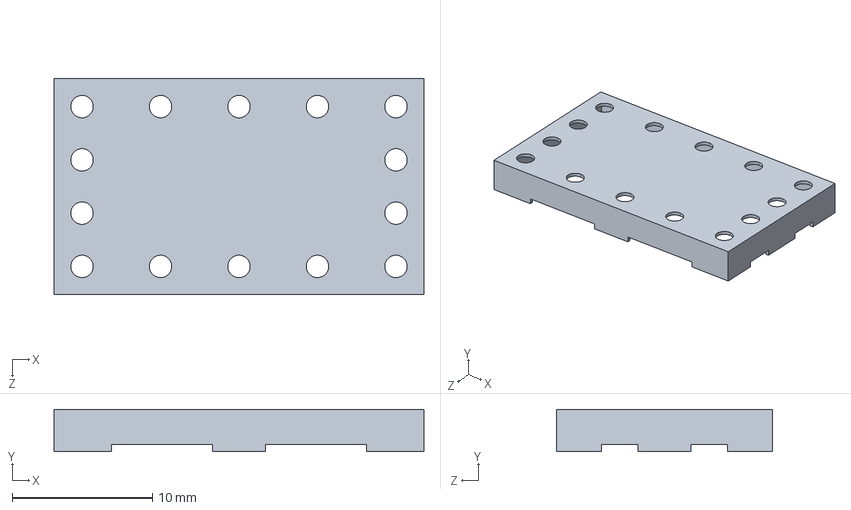
[picture p93: CAD file, 2020-12-17]
GB0102/Drawing/BatteryPackRevDShield/BatteryPackRevDShield.STEP
26.4 x 3.00 x 15.4 mm
