binphilxiao/AxisLabs/CADModels/Buttons/JF15RP2CC.stp

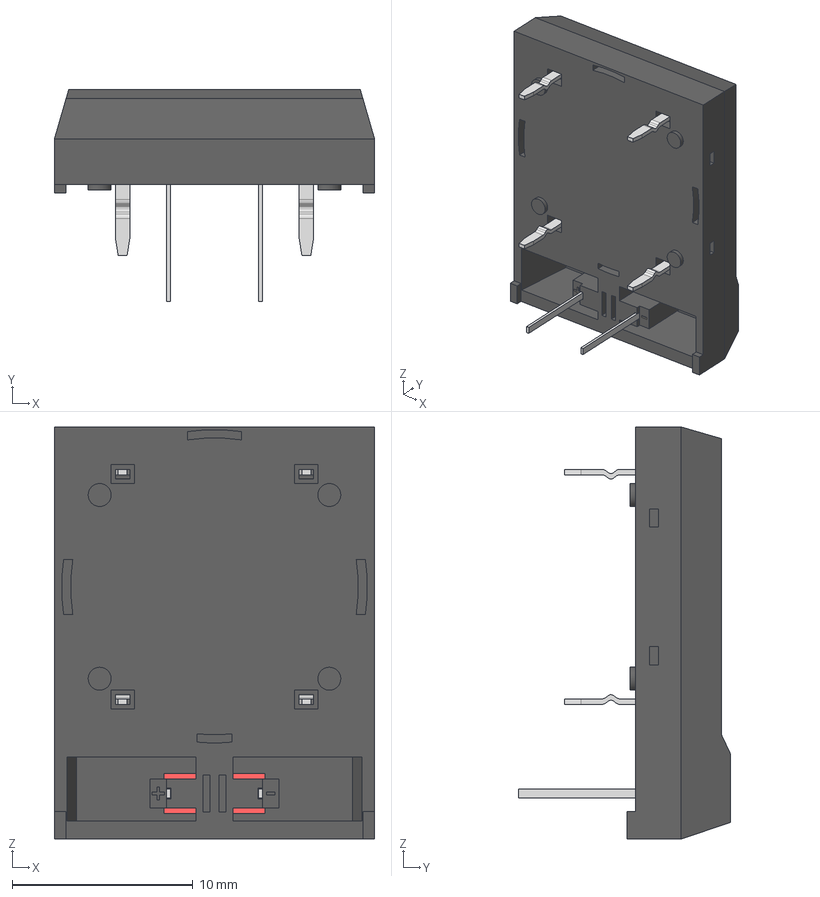
[picture p95: CAD file, 2023-06-06]
CADModels/Buttons/JF15RP2CC.stp
17.7 x 11.7 x 22.8 mm
R2C-actuator
JFRC2C-led
RJF-terminal
JFR2-housing
