binphilxiao/AxisLabs/CADModels/Chips/DFN-8 2x3.step

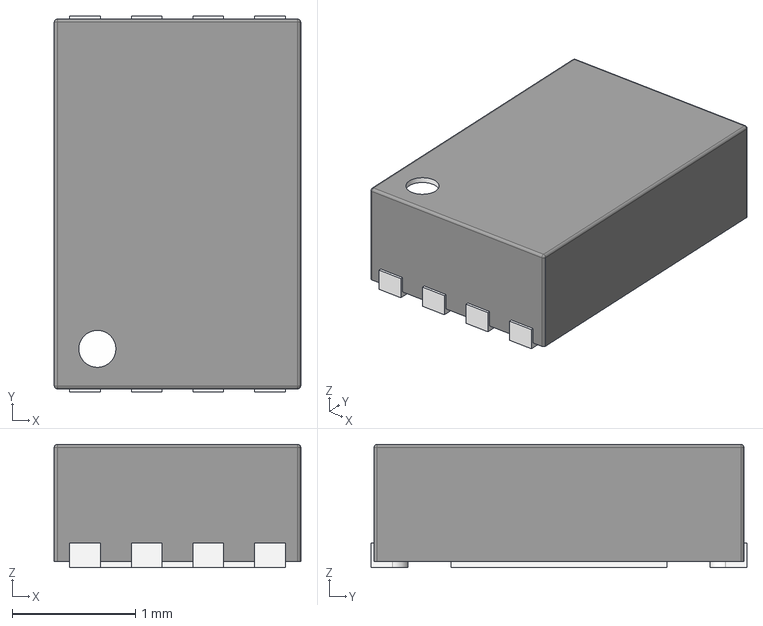
[picture p96: CAD file, 2026-03-16]
CADModels/Chips/DFN-8 2x3.step
2.00 x 3.05 x 1.00 mm
