binphilxiao/AxisLabs/CADModels/Connectors/SM02B-SRSS-TB.stp

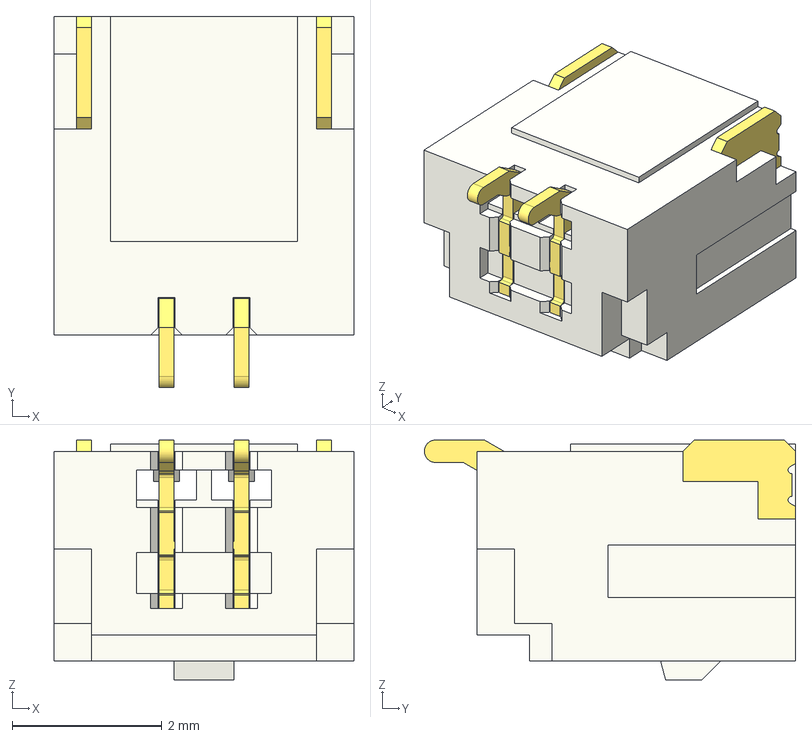
[picture p97: CAD file, 2026-03-16]
CADModels/Connectors/SM02B-SRSS-TB.stp
4.00 x 4.95 x 3.20 mm
T1T1M-02-T-S-RA-TR
P2T1M-02-GF-S-RA-TR
P22T1M-02-GF-S-RA-TR
WT-68-01-X_wt x 2
