binphilxiao/AxisLabs/CADModels/Crystal/2520 SMD Crystal Oscillator.STEP

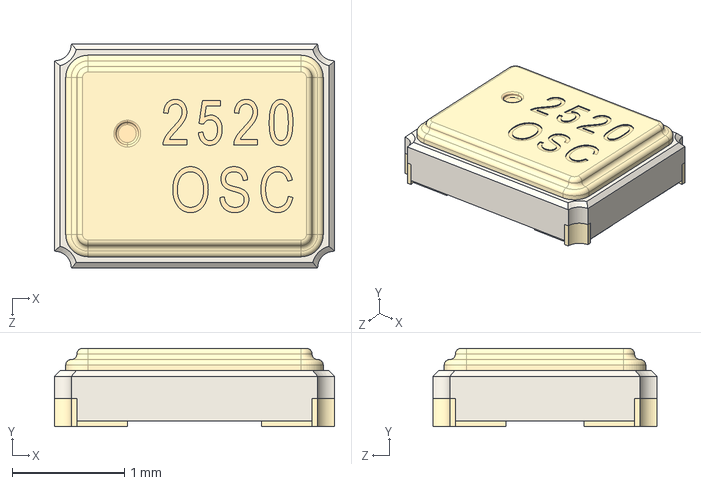
[picture p98: CAD file, 2022-04-04]
CADModels/Crystal/2520 SMD Crystal Oscillator.STEP
2.50 x 0.7 x 2.00 mm
