binphilxiao/AxisLabs/CADModels/FET&Diode/TO-92 flat SMD.stp

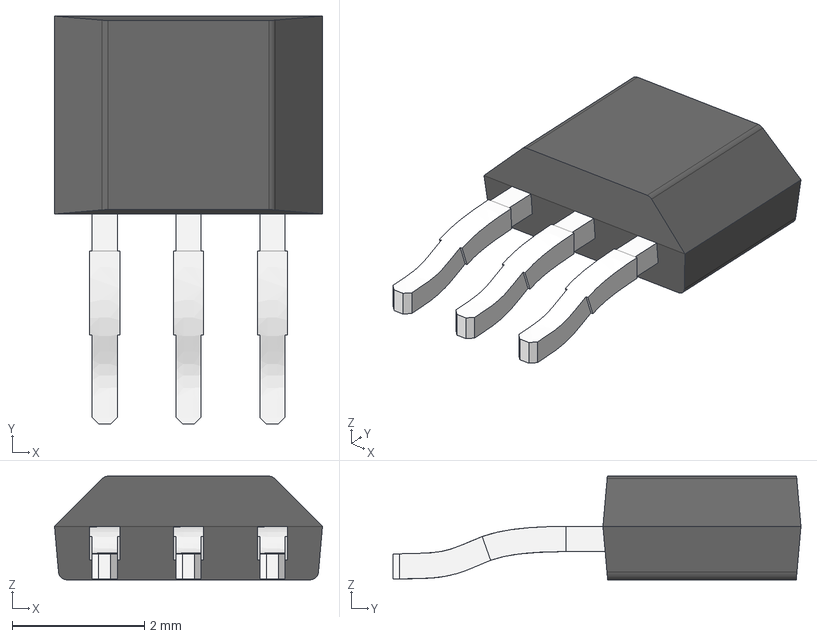
[picture p99: CAD file, 2022-09-12]
CADModels/FET&Diode/TO-92 flat SMD.stp
4.06 x 6.18 x 1.57 mm
