binphilxiao/AxisLabs/CADModels/Inductors/L_0402.stp

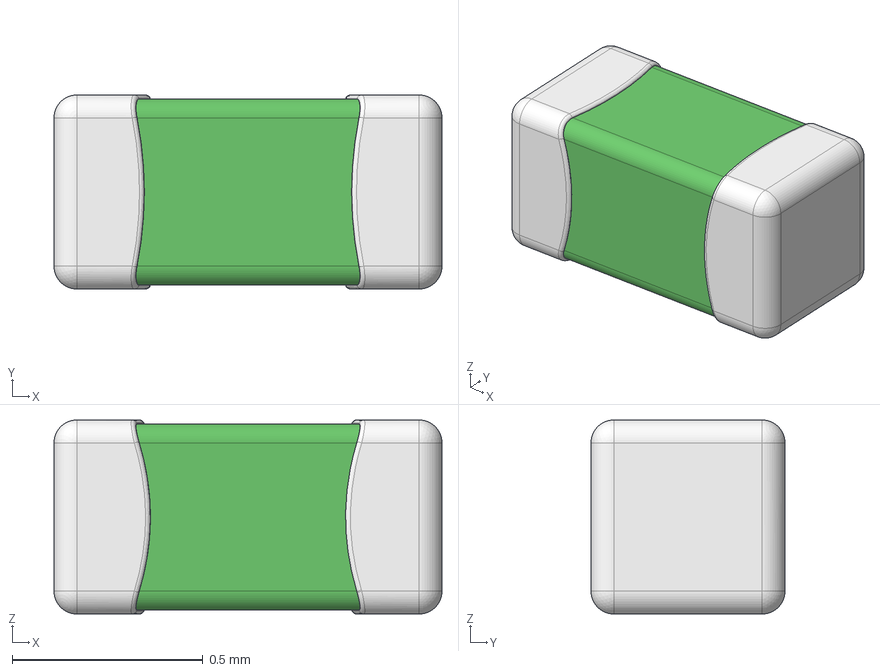
[picture p100: CAD file, 2022-04-04]
CADModels/Inductors/L_0402.stp
1.02 x 0.508 x 0.508 mm
Pin1
Pin2
CeramicBody
