binphilxiao/AxisLabs/CADModels/LED/HSMF-C145.STEP

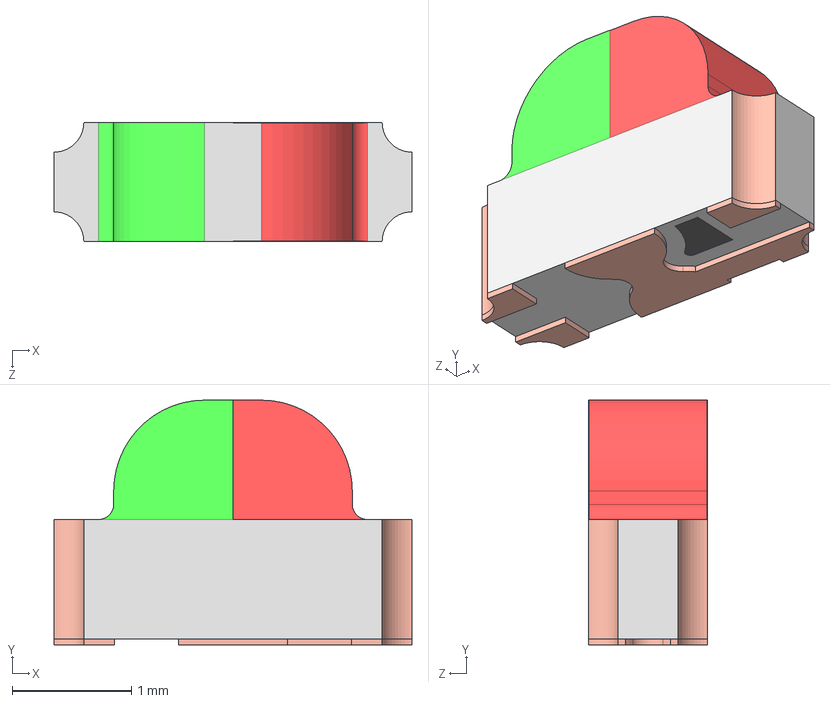
[picture p101: CAD file, 2020-12-17]
CADModels/LED/HSMF-C145.STEP
3.00 x 2.05 x 1.00 mm
