binphilxiao/AxisLabs/CADModels/Modules/ESP32-C3-MINI-1-N4.step

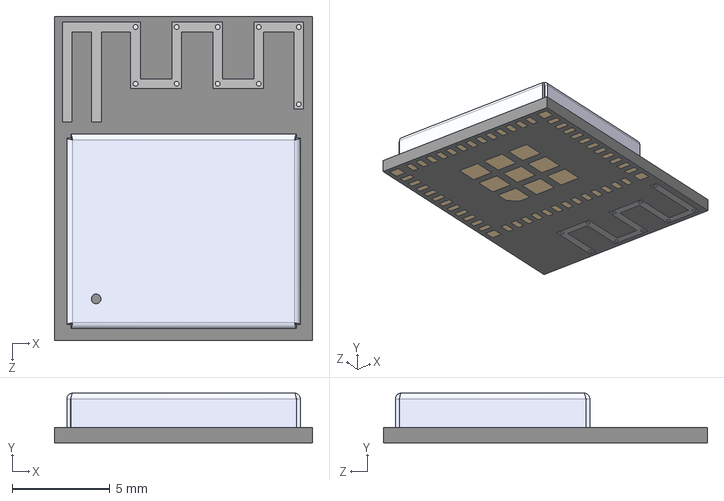
[picture p102: CAD file, 2024-09-04]
CADModels/Modules/ESP32-C3-MINI-1-N4.step
13.2 x 2.55 x 16.6 mm
