binphilxiao/AxisLabs/CADModels/Nuts/MOC-000015 Rev 01 (M2 0.4x2.5MM insert nut).STEP

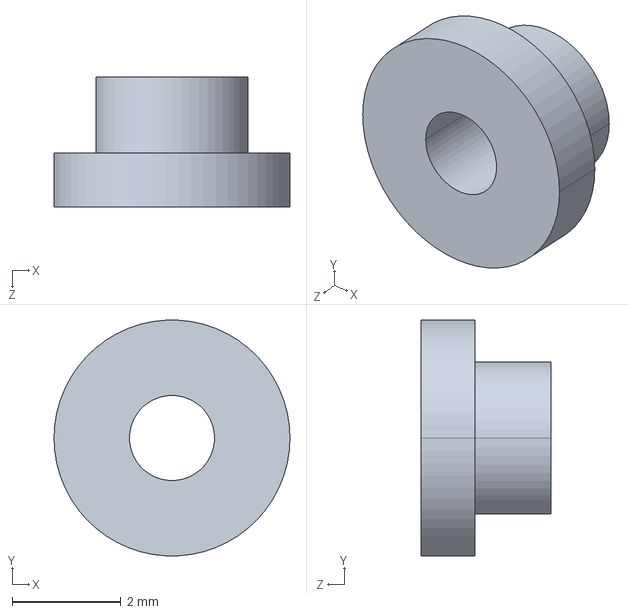
[picture p103: CAD file, 2020-12-17]
CADModels/Nuts/MOC-000015 Rev 01 (M2 0.4x2.5MM insert nut).STEP
4.35 x 4.34 x 2.40 mm
