binphilxiao/AxisLabs/CADModels/RC components/res array 4x 1206.stp

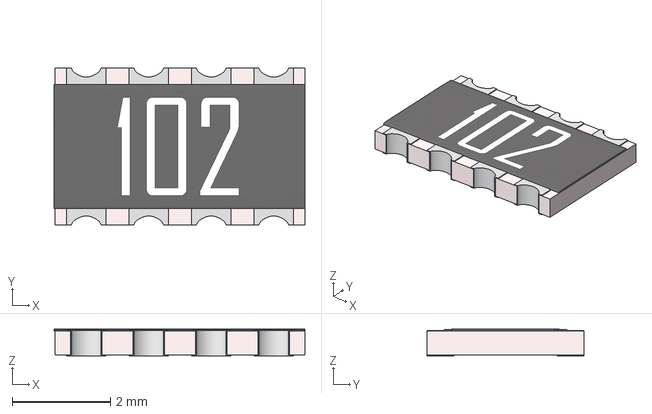
[picture p104: CAD file, 2022-06-01]
CADModels/RC components/res array 4x 1206.stp
5.10 x 3.20 x 0.542 mm
