binphilxiao/AxisLabs/GR0101/052357-9/CAD/ETONM WGM46- Modified - V2.step

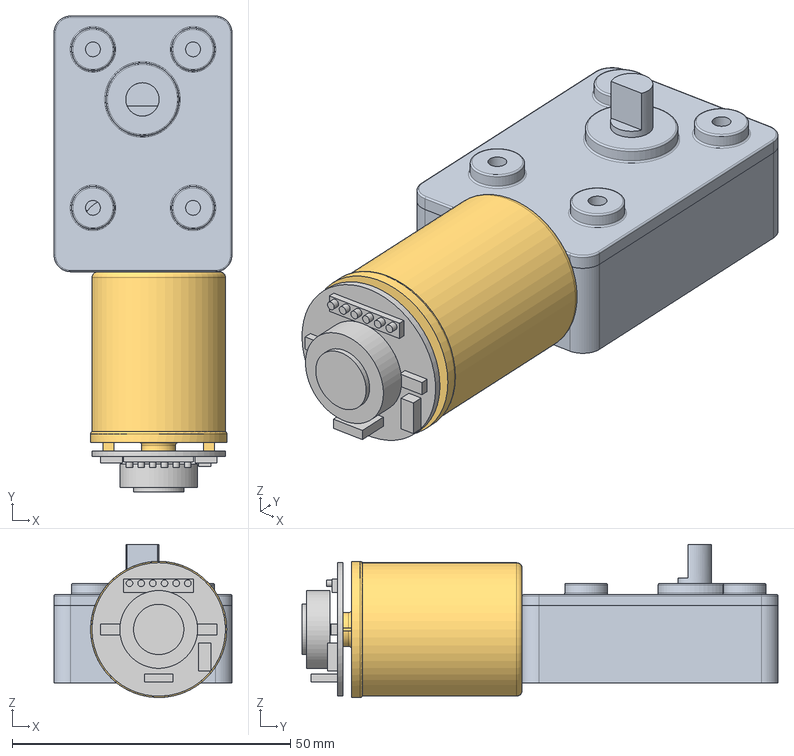
[picture p105: CAD file, 2018-12-14]
GR0101/052357-9/CAD/ETONM WGM46- Modified - V2.step
32.0 x 85.6 x 27.5 mm
Etonm 150901 - Motor v2
Worm
gearbox back
gearbox front
2nd stage
Output Gear
1st stage
Etonm Encoder v5
