binphilxiao/AxisLabs/CADModels/Buttons/JF15CP2C.stp

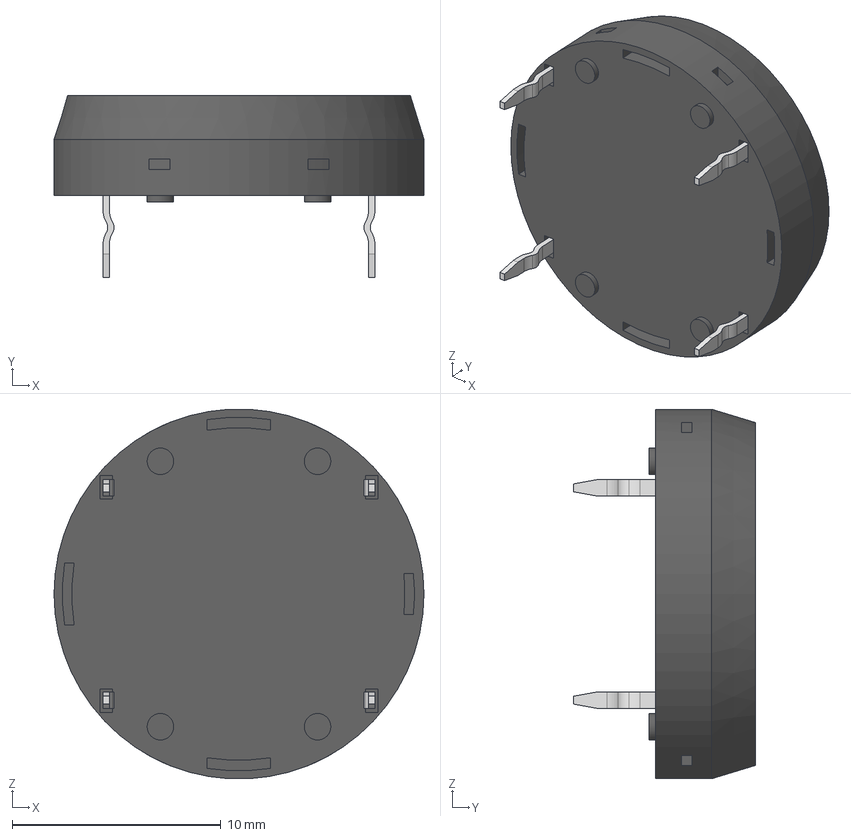
[picture p106: CAD file, 2023-06-06]
CADModels/Buttons/JF15CP2C.stp
17.7 x 8.69 x 17.7 mm
P-Straight_PCJF-terminal
C2C_
C2-body
