binphilxiao/AxisLabs/CADModels/Chips/DFN-8 3x3.step

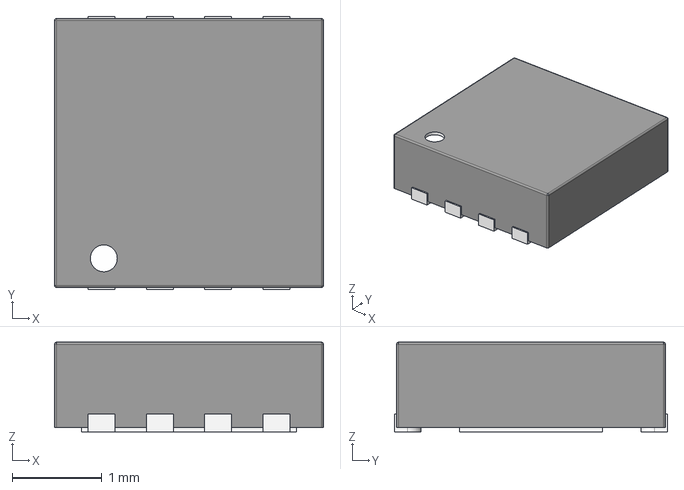
[picture p107: CAD file, 2026-03-16]
CADModels/Chips/DFN-8 3x3.step
3.00 x 3.05 x 1.00 mm
