binphilxiao/AxisLabs/CADModels/Connectors/TSW-105-22-G-S-RA.stp

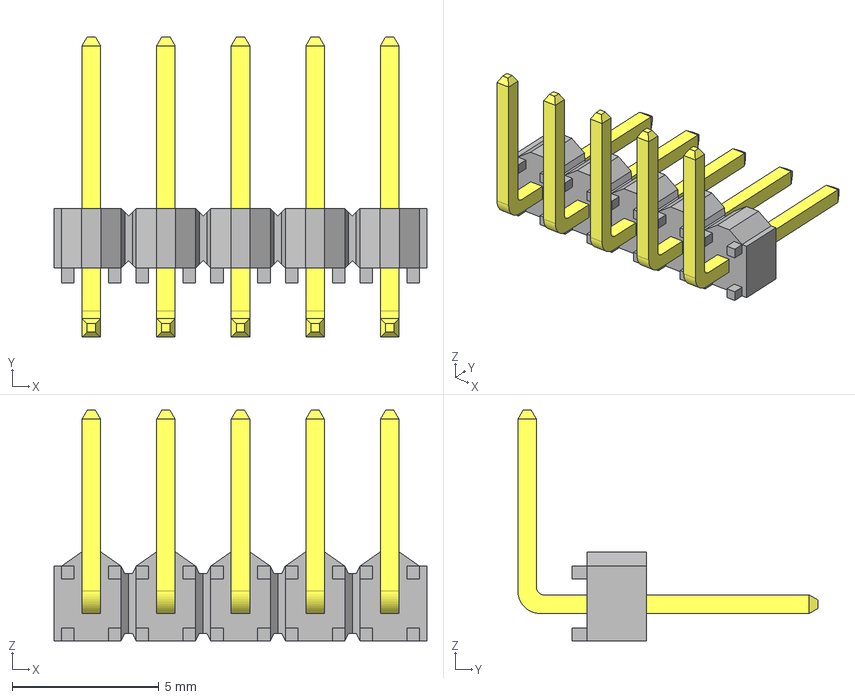
[picture p108: CAD file, 2026-03-16]
CADModels/Connectors/TSW-105-22-G-S-RA.stp
12.7 x 10.2 x 7.85 mm
TSW-105-22-G-S-RA_body
T-1S6-15-TSW-1-22-5-RA-S
