binphilxiao/AxisLabs/CADModels/Crystal/QFN_2016_4pins.STEP

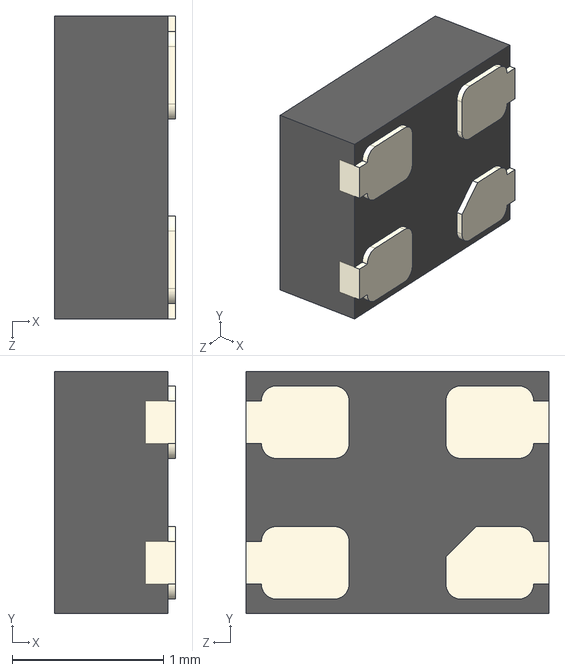
[picture p109: CAD file, 2022-04-04]
CADModels/Crystal/QFN_2016_4pins.STEP
0.8 x 1.60 x 2.00 mm
