binphilxiao/AxisLabs/CADModels/FET&Diode/TO-92 flat Straight Long Leads.stp

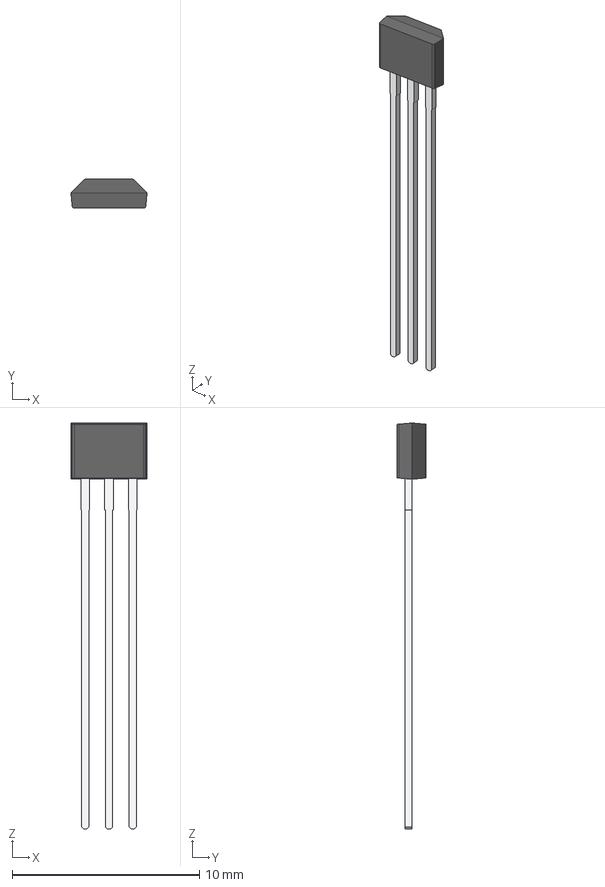
[picture p110: CAD file, 2022-09-12]
CADModels/FET&Diode/TO-92 flat Straight Long Leads.stp
4.06 x 1.57 x 21.7 mm
