binphilxiao/AxisLabs/CADModels/Inductors/L_0603.stp

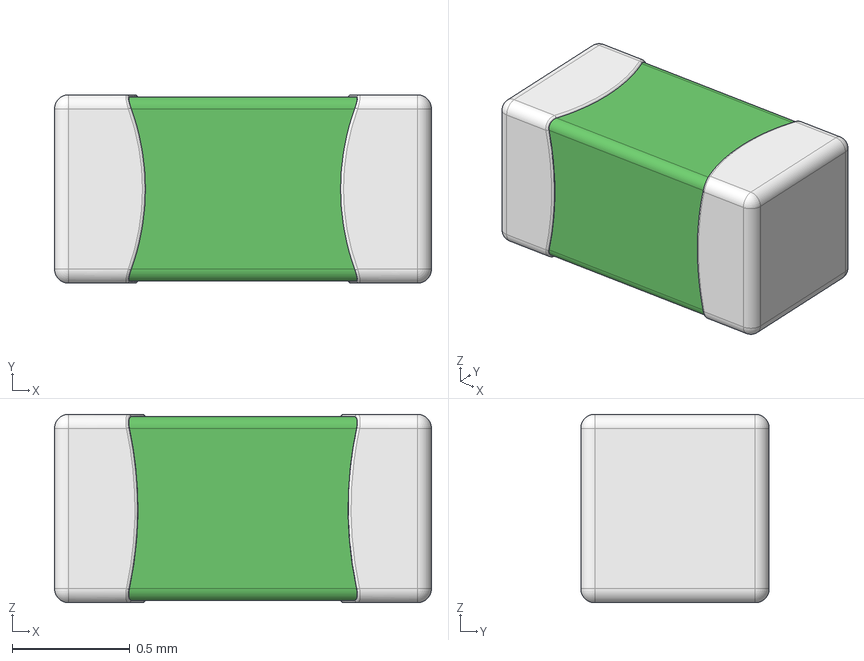
[picture p111: CAD file, 2022-04-04]
CADModels/Inductors/L_0603.stp
1.60 x 0.8 x 0.8 mm
Pin1
Pin2
CeramicBody
