binphilxiao/AxisLabs/CADModels/LED/LED-000002 Rev 01 (Blue LED).STEP

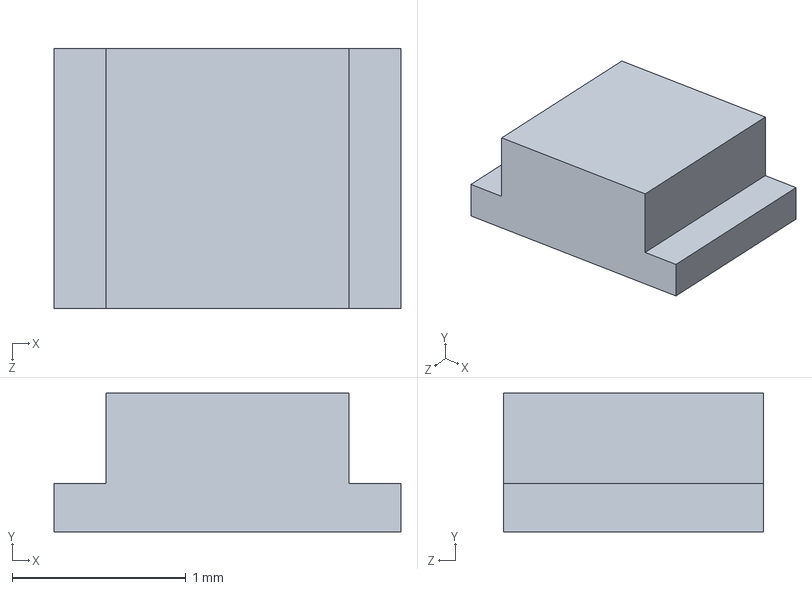
[picture p112: CAD file, 2020-12-17]
CADModels/LED/LED-000002 Rev 01 (Blue LED).STEP
2.00 x 0.8 x 1.50 mm
