binphilxiao/AxisLabs/CADModels/Modules/ESP32-C3-WROOM-02-H4.step

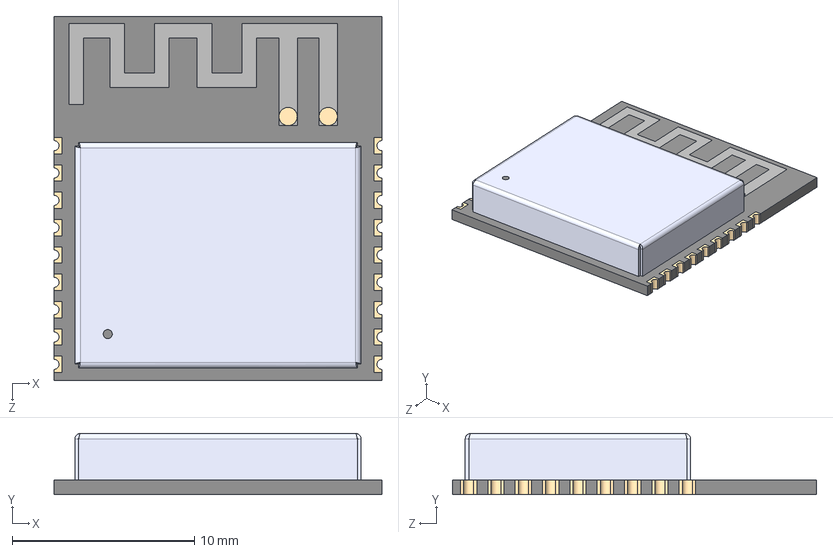
[picture p113: CAD file, 2024-08-21]
CADModels/Modules/ESP32-C3-WROOM-02-H4.step
18.0 x 3.35 x 20.0 mm
