binphilxiao/AxisLabs/CADModels/RC components/CAT16-F4, -J4.STEP

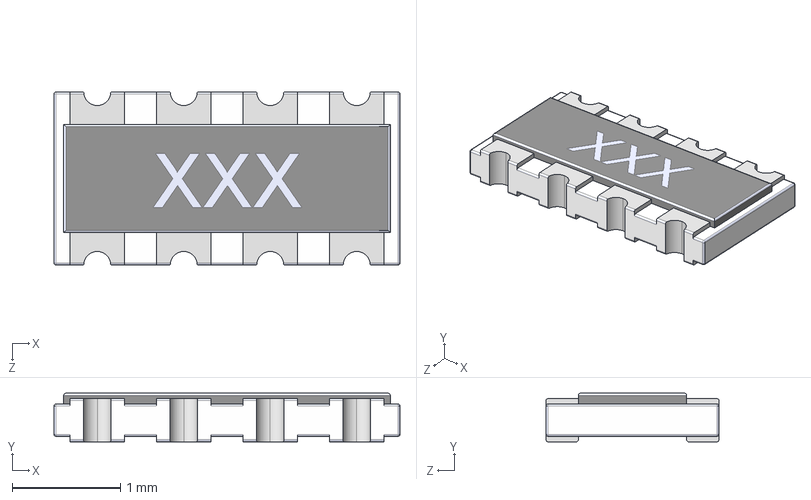
[picture p114: CAD file, 2022-06-01]
CADModels/RC components/CAT16-F4, -J4.STEP
3.20 x 0.45 x 1.60 mm
