binphilxiao/AxisLabs/Button/smartbutton-plastic-parts-V3_PCBRefDXF.DXF

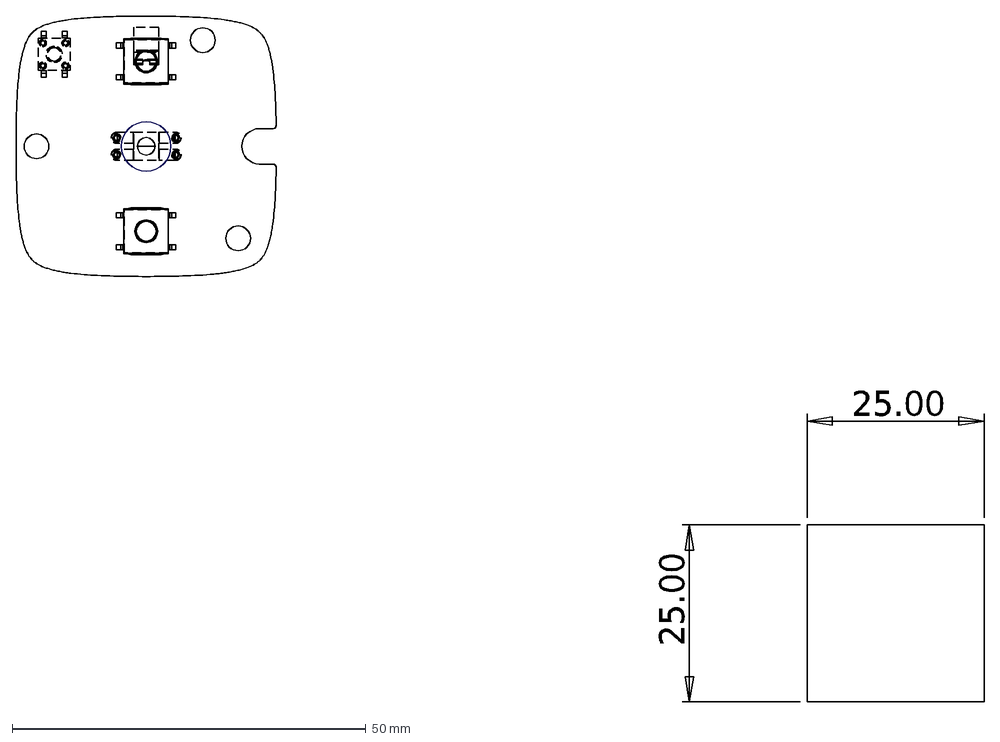
[picture p115: CAD file, 2025-04-29]
Button/smartbutton-plastic-parts-V3_PCBRefDXF.DXF
25.00
