binphilxiao/AxisLabs/CADModels/Buttons/BUT-000002 Rev 01 (Stop Button Switch).STEP

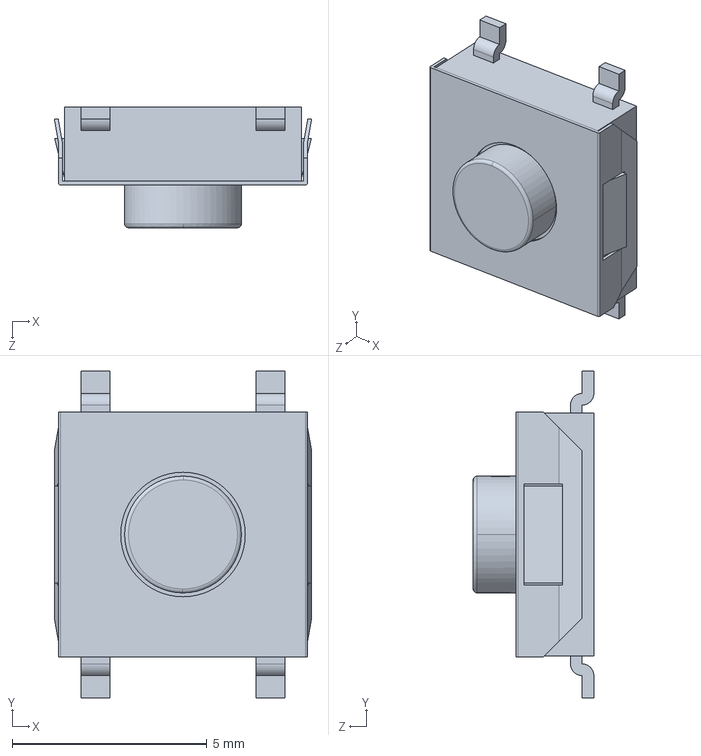
[picture p116: CAD file, 2020-12-17]
CADModels/Buttons/BUT-000002 Rev 01 (Stop Button Switch).STEP
6.61 x 8.40 x 3.10 mm
