binphilxiao/AxisLabs/CADModels/Chips/MSP430FR2476TRHAR.STEP

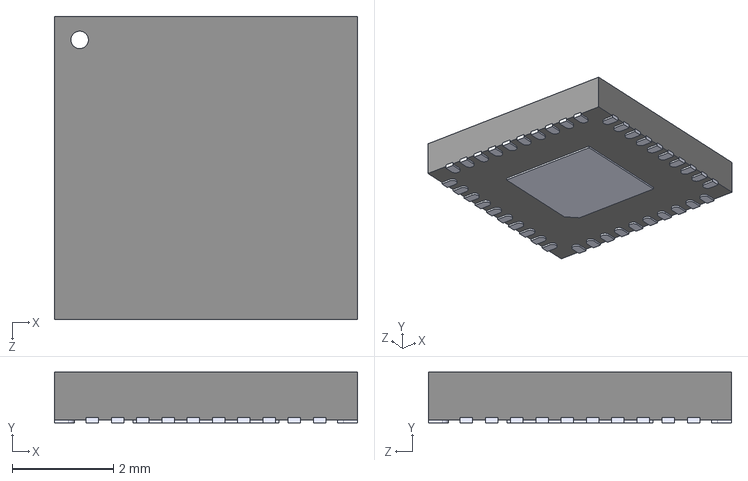
[picture p117: CAD file, 2026-03-16]
CADModels/Chips/MSP430FR2476TRHAR.STEP
6.00 x 1.00 x 6.00 mm
