binphilxiao/AxisLabs/CADModels/Crystal/3225 SMD Crystal Oscillator.STEP

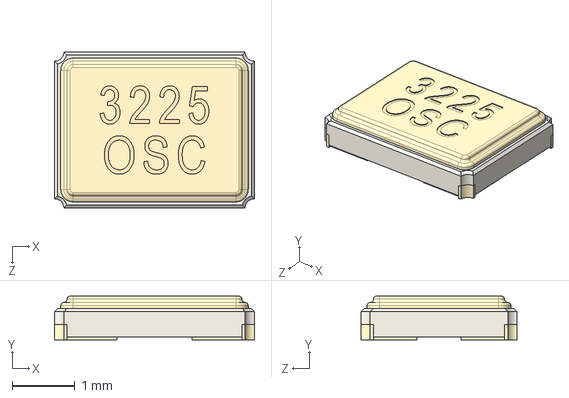
[picture p118: CAD file, 2022-04-04]
CADModels/Crystal/3225 SMD Crystal Oscillator.STEP
3.20 x 0.7 x 2.50 mm
