binphilxiao/AxisLabs/CADModels/Inductors/L_1210.stp

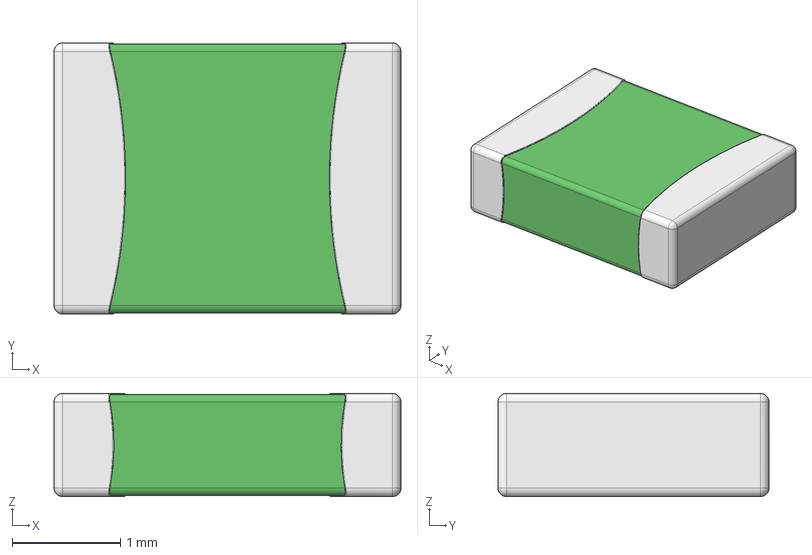
[picture p119: CAD file, 2022-04-04]
CADModels/Inductors/L_1210.stp
3.20 x 2.50 x 0.95 mm
Pin1
Pin2
CeramicBody
