binphilxiao/AxisLabs/CADModels/LED/LTST-S326KGJRKT.STEP

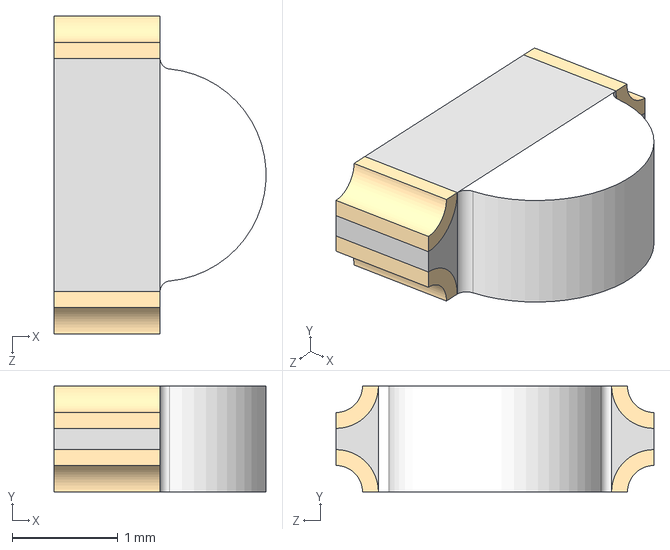
[picture p120: CAD file, 2020-09-30]
CADModels/LED/LTST-S326KGJRKT.STEP
2.00 x 1.00 x 3.00 mm
