binphilxiao/AxisLabs/CADModels/Modules/PCB-NW0101 Rev.A.step

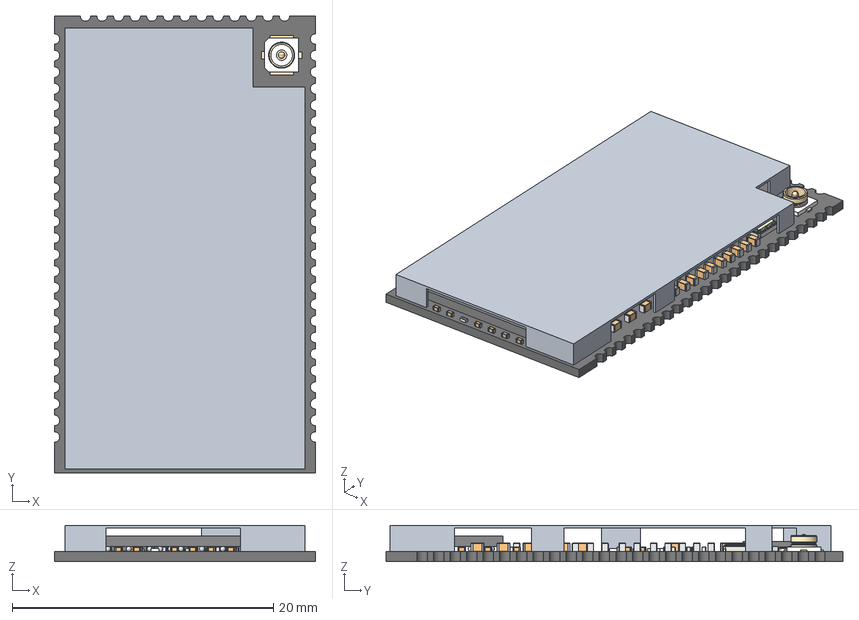
[picture p121: CAD file, 2022-06-01]
CADModels/Modules/PCB-NW0101 Rev.A.step
20.0 x 35.0 x 2.76 mm
C0201_035 x 159
C0402_065 x 72
rsmd-0201_l0-6_w0-3_h0-23 x 23
SH-33.6MM18.2MM2MM-AL_3D_Rev.A
2520_SMD_Crystal_Oscillator
WSON-8
W971GG6KB
L_0201 x 6
Pin1
Pin2
CeramicBody
CONMHF1-SMD-G-T
