binphilxiao/AxisLabs/CADModels/RC components/rsmd-0612_l1-6_w3-2_h0-6.stp

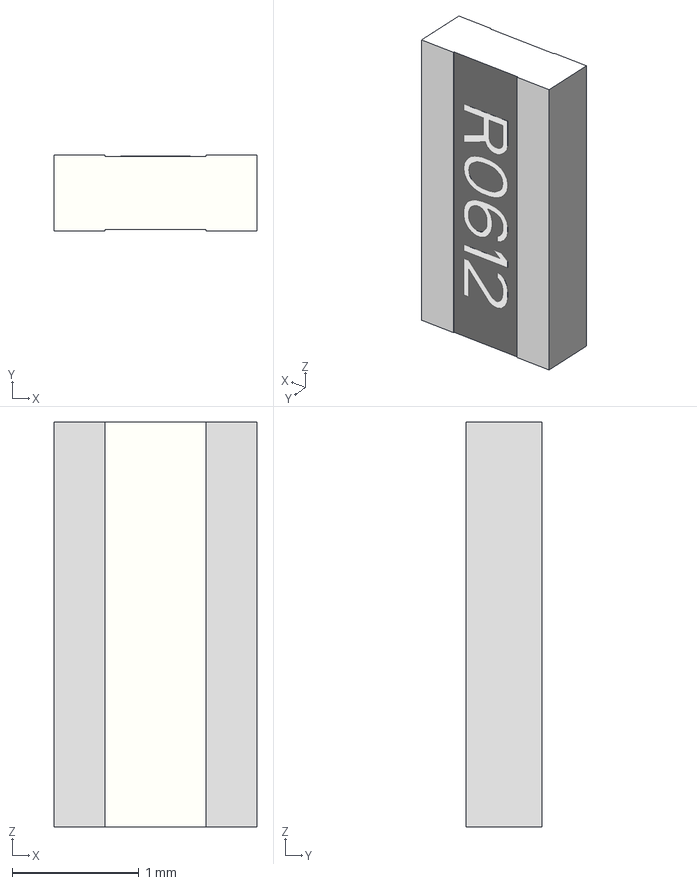
[picture p122: CAD file, 2022-04-04]
CADModels/RC components/rsmd-0612_l1-6_w3-2_h0-6.stp
1.60 x 0.6 x 3.20 mm
