binphilxiao/AxisLabs/CADModels/Buttons/BUT-000000 Rev 01 (Pair,Set button switch).STEP

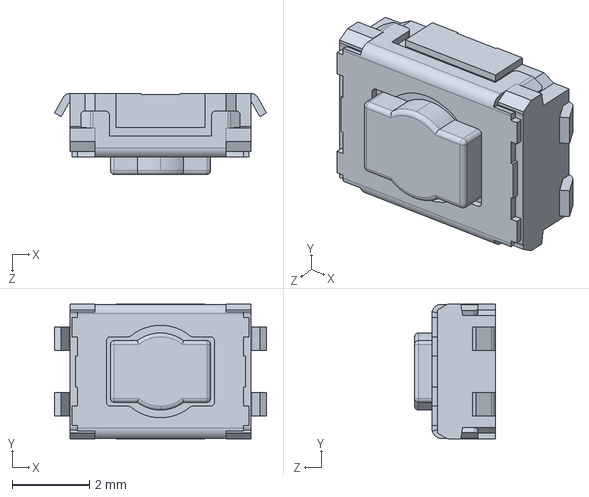
[picture p123: CAD file, 2020-12-17]
CADModels/Buttons/BUT-000000 Rev 01 (Pair,Set button switch).STEP
5.50 x 3.50 x 2.10 mm
