binphilxiao/AxisLabs/CADModels/Chips/DFN-6 2x3 Pad.step

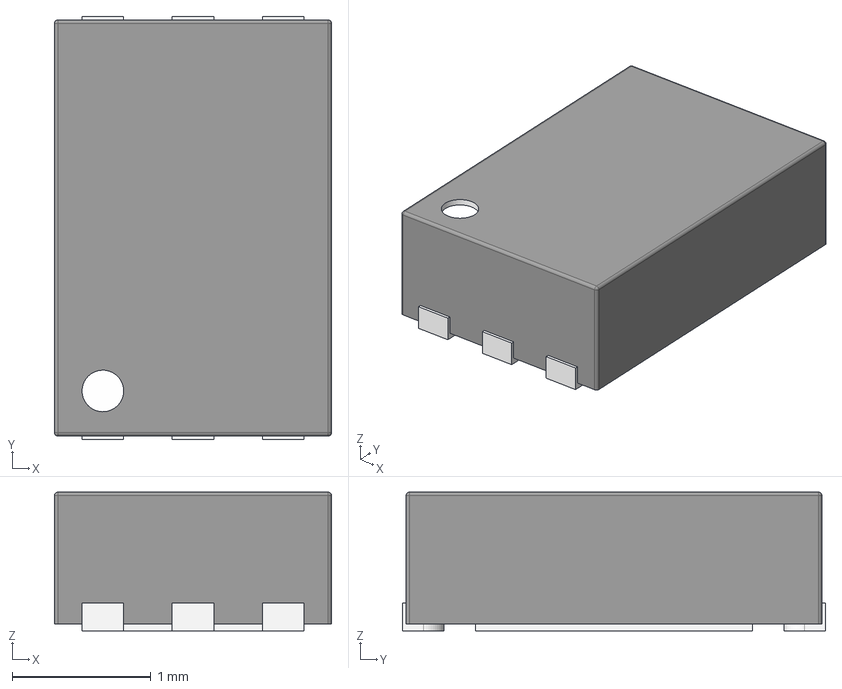
[picture p124: CAD file, 2026-03-16]
CADModels/Chips/DFN-6 2x3 Pad.step
2.00 x 3.05 x 1.00 mm
