binphilxiao/AxisLabs/CADModels/Connectors/112TR.STEP

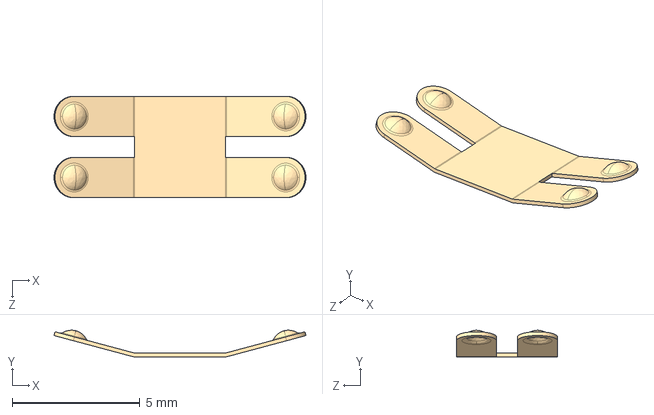
[picture p125: CAD file, 2025-06-10]
CADModels/Connectors/112TR.STEP
9.85 x 1.04 x 3.96 mm
