binphilxiao/AxisLabs/CADModels/FET&Diode/TO-92 flat Formed Leads.stp

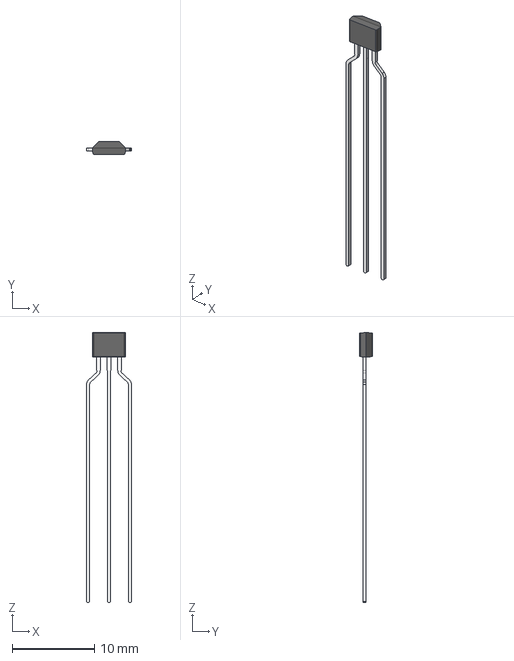
[picture p126: CAD file, 2022-09-12]
CADModels/FET&Diode/TO-92 flat Formed Leads.stp
5.46 x 1.57 x 32.9 mm
