binphilxiao/AxisLabs/CADModels/Inductors/L_0201.STEP

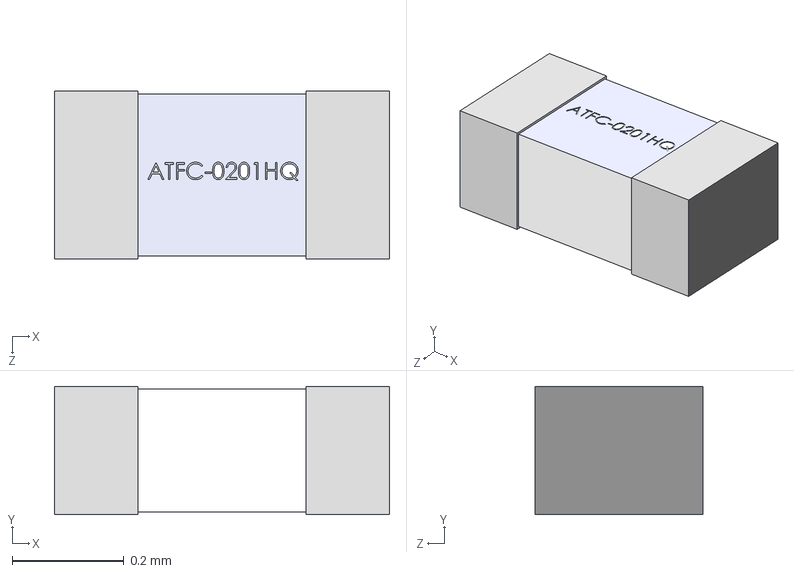
[picture p127: CAD file, 2022-04-04]
CADModels/Inductors/L_0201.STEP
0.6 x 0.23 x 0.3 mm
