binphilxiao/AxisLabs/CADModels/LED/LTST-S270TBKT.STEP

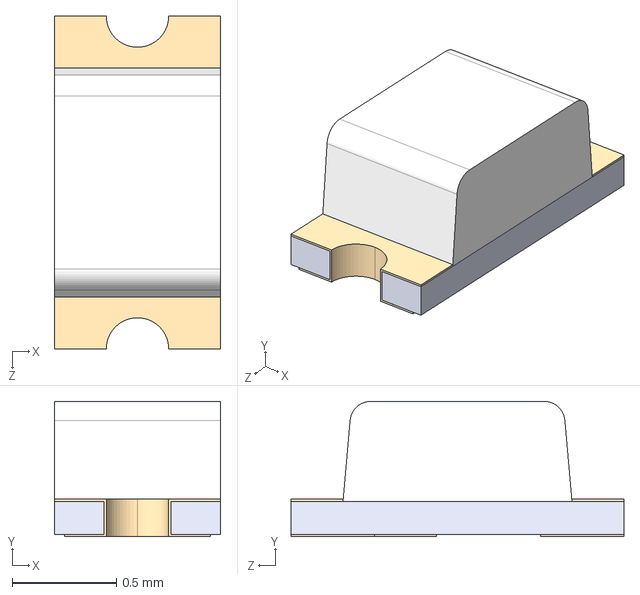
[picture p128: CAD file, 2020-05-12]
CADModels/LED/LTST-S270TBKT.STEP
0.8 x 0.65 x 1.60 mm
