binphilxiao/AxisLabs/CADModels/Modules/Omega2S.STEP

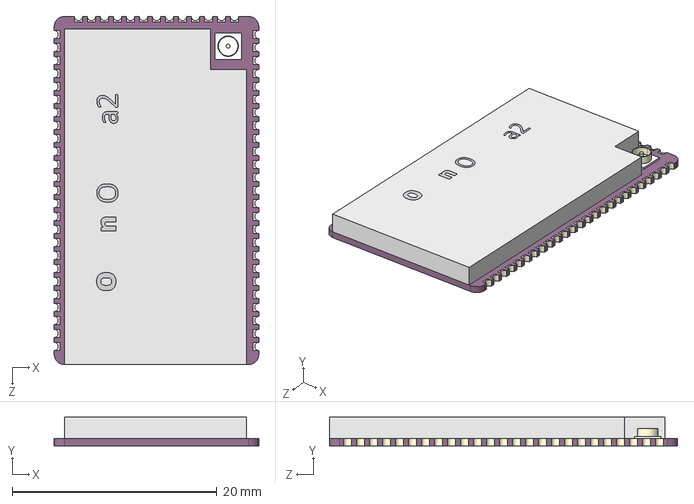
[picture p129: CAD file, 2021-05-04]
CADModels/Modules/Omega2S.STEP
20.0 x 2.80 x 34.0 mm
