binphilxiao/AxisLabs/CADModels/RC components/rsmd-1210_l3-1_w2-6_h0-5.stp

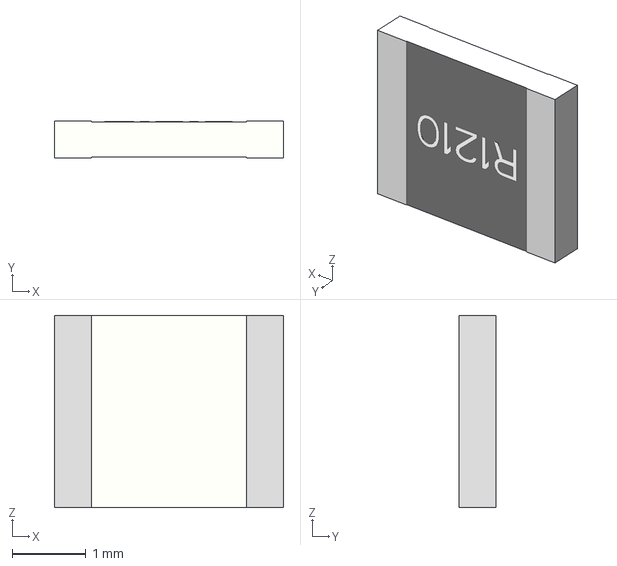
[picture p130: CAD file, 2022-04-04]
CADModels/RC components/rsmd-1210_l3-1_w2-6_h0-5.stp
3.10 x 0.5 x 2.60 mm
