binphilxiao/AxisLabs/CADModels/Buttons/BUT-000001 Rev 01 (Reset Button Switch).STEP

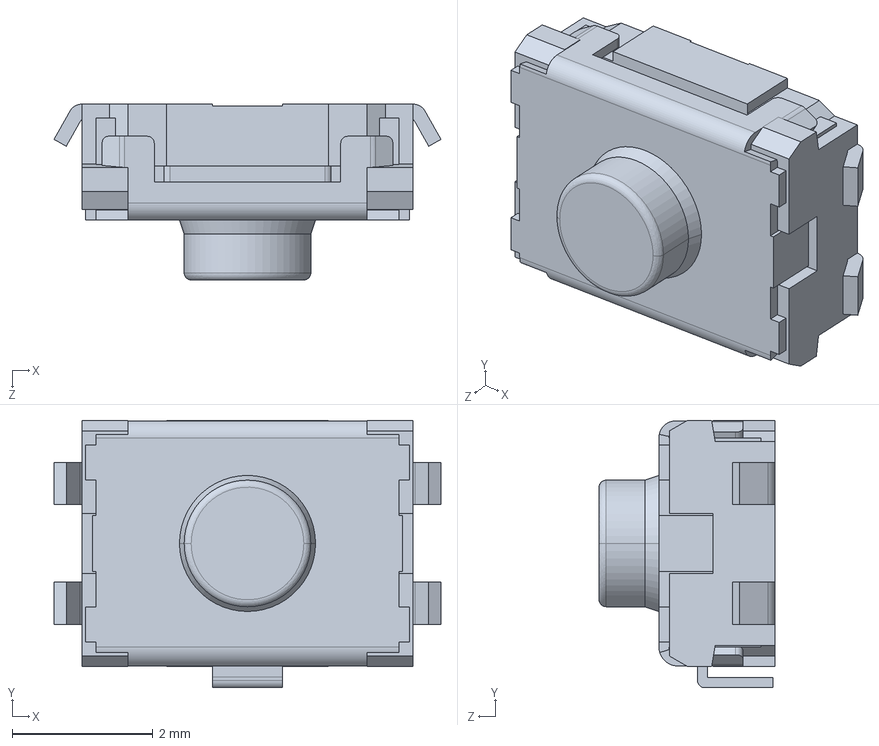
[picture p131: CAD file, 2020-12-17]
CADModels/Buttons/BUT-000001 Rev 01 (Reset Button Switch).STEP
5.50 x 3.80 x 2.50 mm
