binphilxiao/AxisLabs/CADModels/Chips/DFN-8 4x3.step

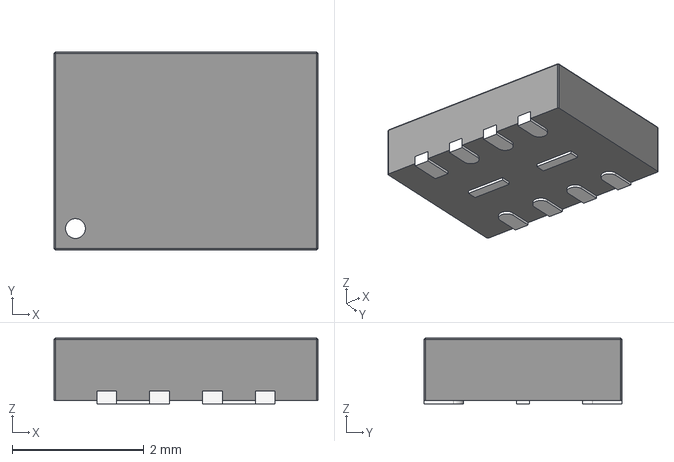
[picture p132: CAD file, 2026-03-16]
CADModels/Chips/DFN-8 4x3.step
4.00 x 3.00 x 1.00 mm
