binphilxiao/AxisLabs/CADModels/Connectors/MEC1-105-02-L-D-RA1-NP-SL-TR.stp

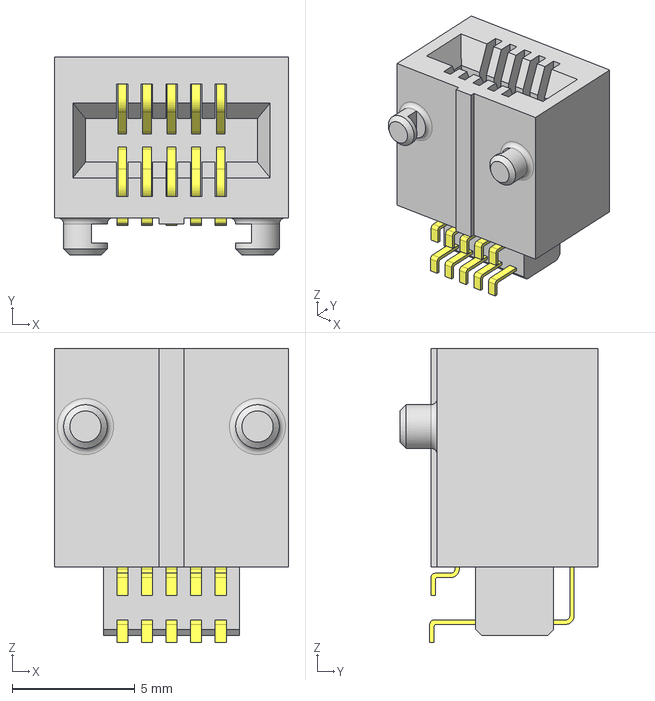
[picture p133: CAD file, 2025-06-10]
CADModels/Connectors/MEC1-105-02-L-D-RA1-NP-SL-TR.stp
9.54 x 8.08 x 12.0 mm
MEC1-105-02-D-RA1-NP_socket
MEC1-105-02-D-RA1-NP_pins
