binphilxiao/AxisLabs/CADModels/FET&Diode/sot223.stp

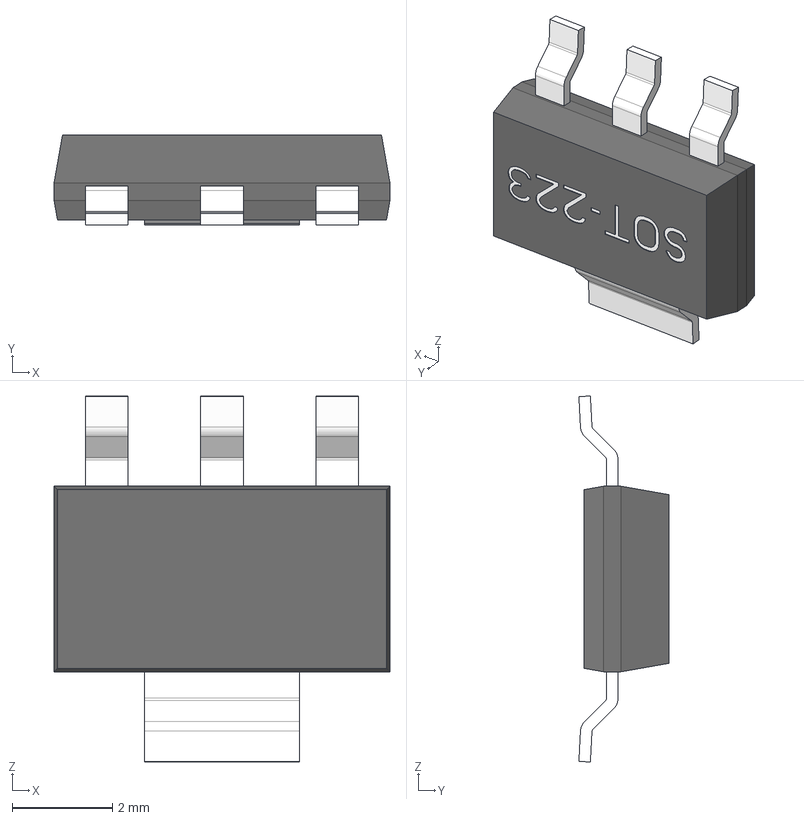
[picture p134: CAD file, 2022-06-01]
CADModels/FET&Diode/sot223.stp
6.70 x 1.80 x 7.30 mm
