binphilxiao/AxisLabs/CADModels/Inductors/L_1812.stp

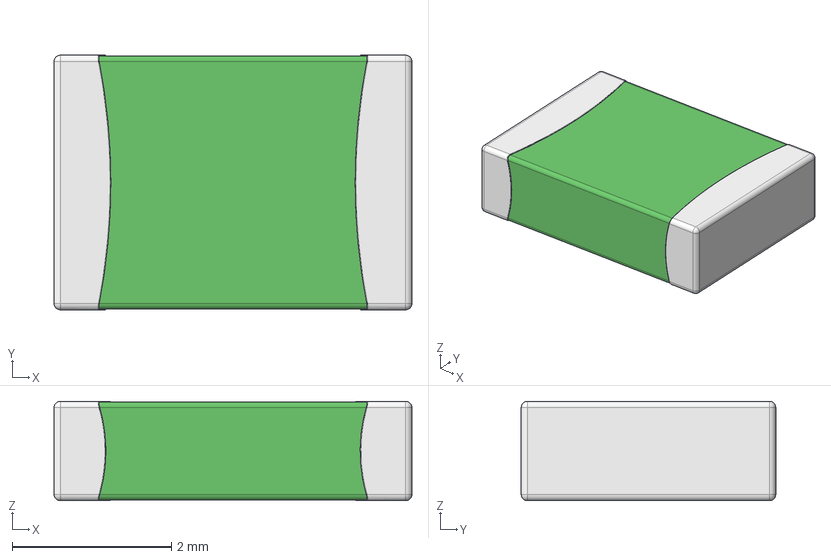
[picture p135: CAD file, 2022-04-04]
CADModels/Inductors/L_1812.stp
4.50 x 3.20 x 1.25 mm
Pin1
Pin2
CeramicBody
