binphilxiao/AxisLabs/CADModels/LED/15-21.STEP

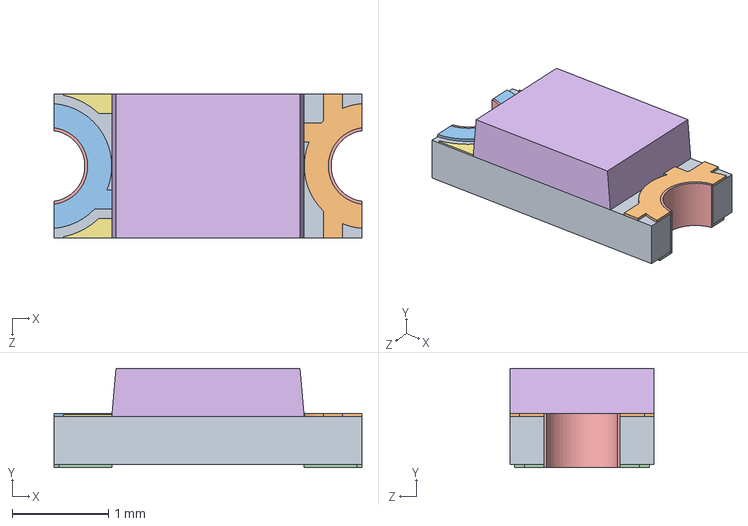
[picture p136: CAD file, 2020-05-12]
CADModels/LED/15-21.STEP
3.20 x 1.03 x 1.50 mm
