binphilxiao/AxisLabs/CADModels/Buttons/c-1825027-8-g-3d.step

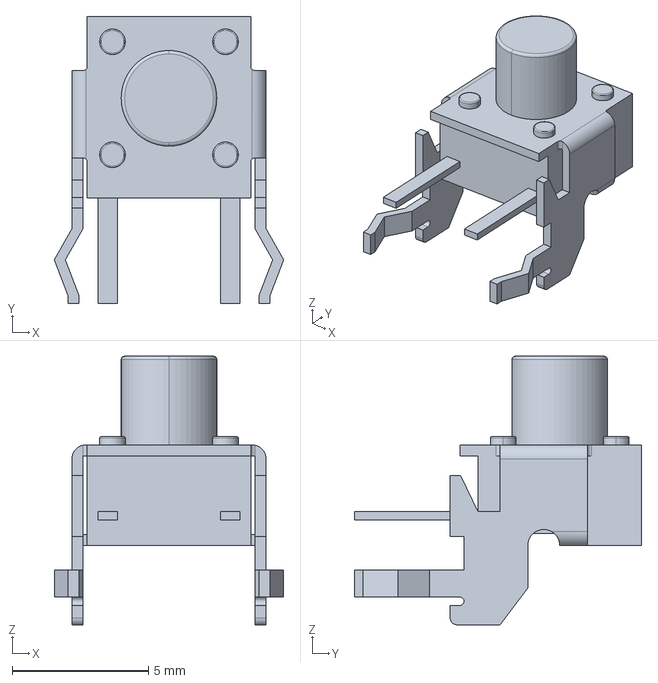
[picture p137: CAD file, 2020-05-12]
CADModels/Buttons/c-1825027-8-g-3d.step
8.41 x 10.5 x 9.84 mm
