binphilxiao/AxisLabs/CADModels/Chips/TSSOP-20.stp

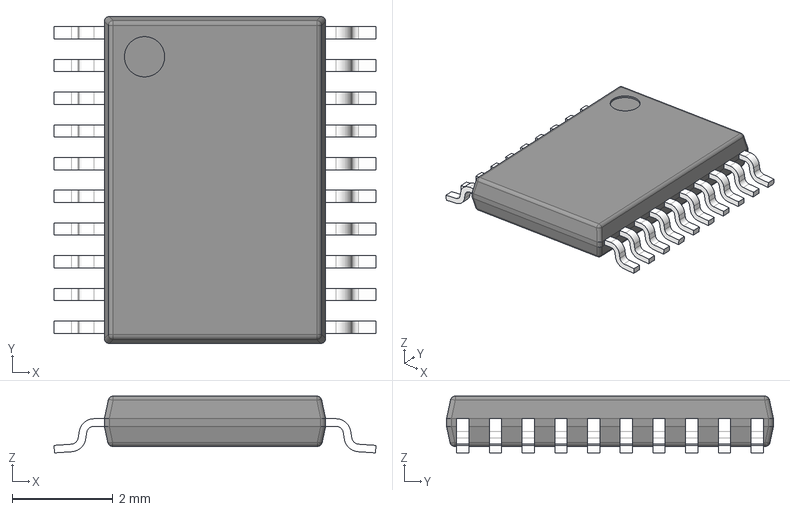
[picture p138: CAD file, 2025-06-10]
CADModels/Chips/TSSOP-20.stp
6.40 x 6.50 x 1.13 mm
BODY-TSSOP
LEAD-TSSOP x 20
PIN1
