binphilxiao/AxisLabs/CADModels/Connectors/122TR.STEP

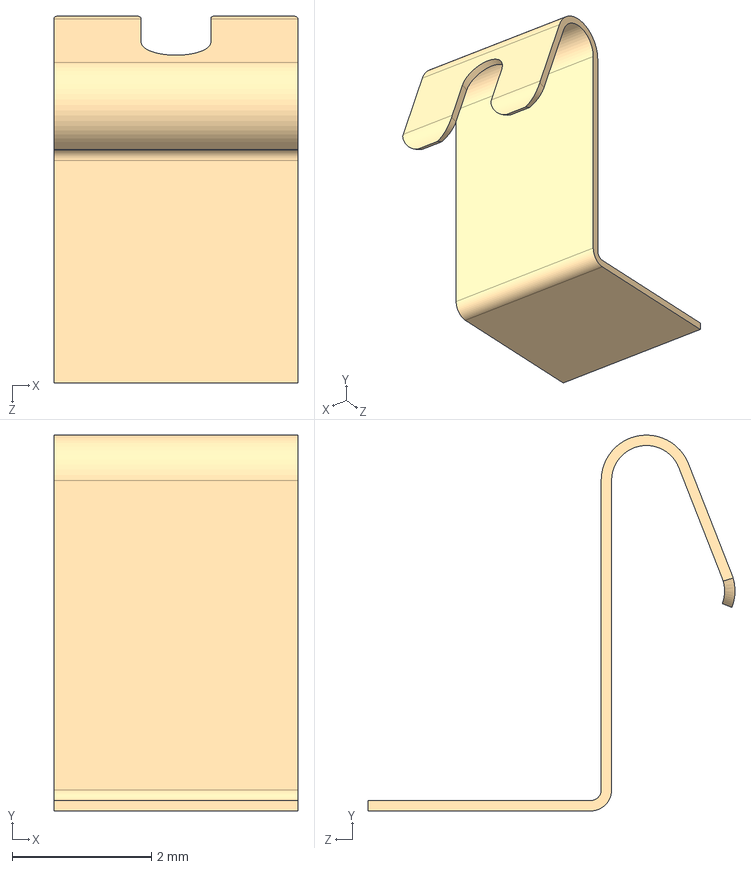
[picture p139: CAD file, 2025-06-10]
CADModels/Connectors/122TR.STEP
3.50 x 5.40 x 5.27 mm
