binphilxiao/AxisLabs/CADModels/FET&Diode/TO-252-3_6P6X6P1_DIO.step

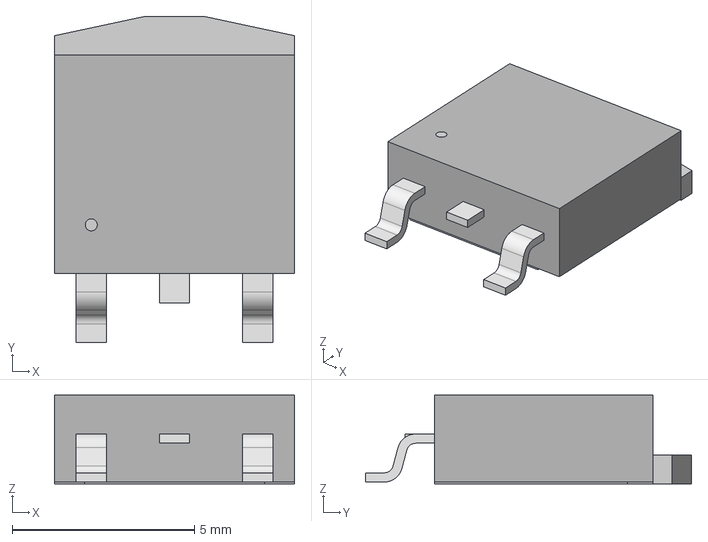
[picture p140: CAD file, 2022-06-01]
CADModels/FET&Diode/TO-252-3_6P6X6P1_DIO.step
6.60 x 8.96 x 2.44 mm
