binphilxiao/AxisLabs/CADModels/Inductors/L_0805.stp

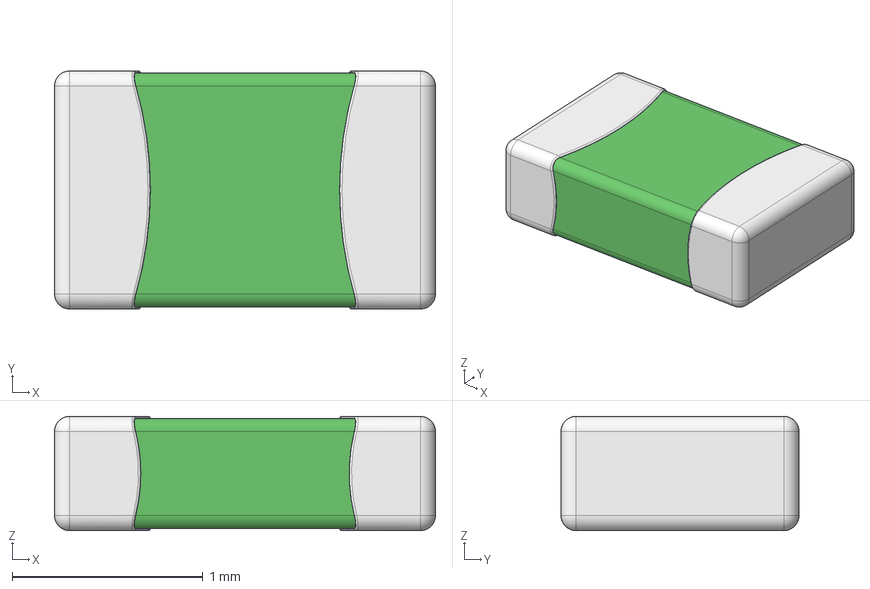
[picture p141: CAD file, 2022-04-04]
CADModels/Inductors/L_0805.stp
2.00 x 1.25 x 0.6 mm
Pin1
Pin2
CeramicBody
