binphilxiao/AxisLabs/CADModels/Buttons/TL3301NFxxxxG.stp

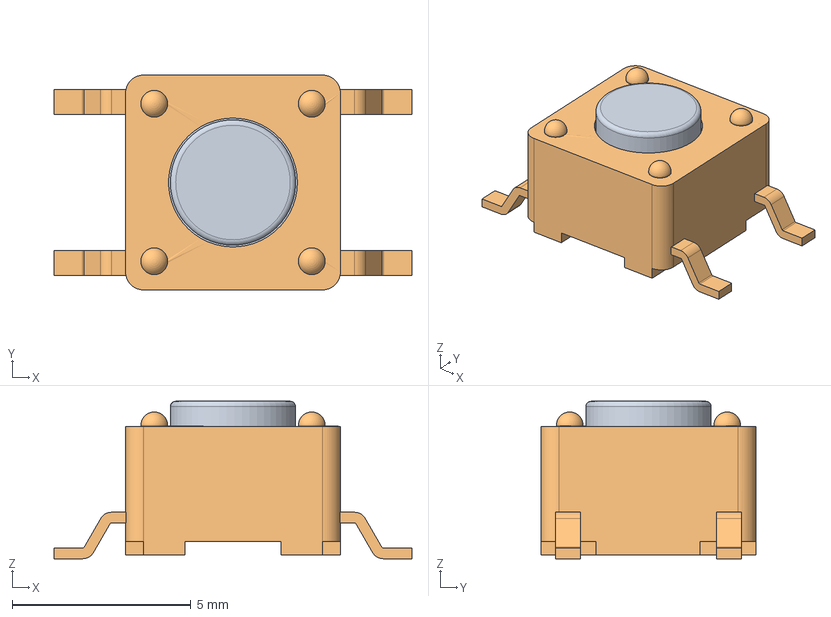
[picture p142: CAD file, 2020-05-12]
CADModels/Buttons/TL3301NFxxxxG.stp
10.0 x 6.00 x 4.40 mm
