binphilxiao/AxisLabs/CADModels/Chips/MSP430FR2433IRGER.step

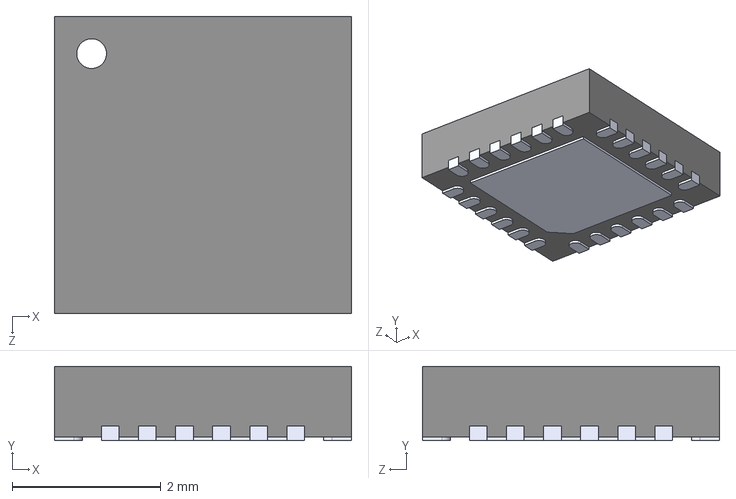
[picture p143: CAD file, 2025-06-10]
CADModels/Chips/MSP430FR2433IRGER.step
4.00 x 1.00 x 4.00 mm
