binphilxiao/AxisLabs/CADModels/Connectors/MEC1-105-02-F-D-A--2X5P.stp

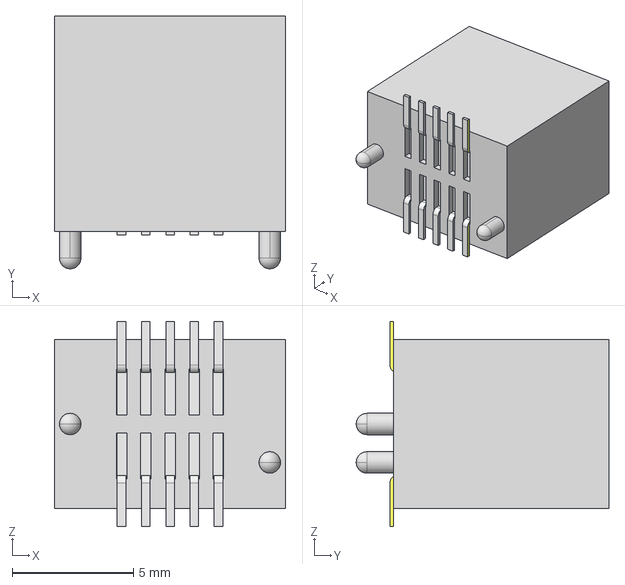
[picture p144: CAD file, 2025-06-10]
CADModels/Connectors/MEC1-105-02-F-D-A--2X5P.stp
9.54 x 10.4 x 8.48 mm
