binphilxiao/AxisLabs/CADModels/FET&Diode/SMA.step

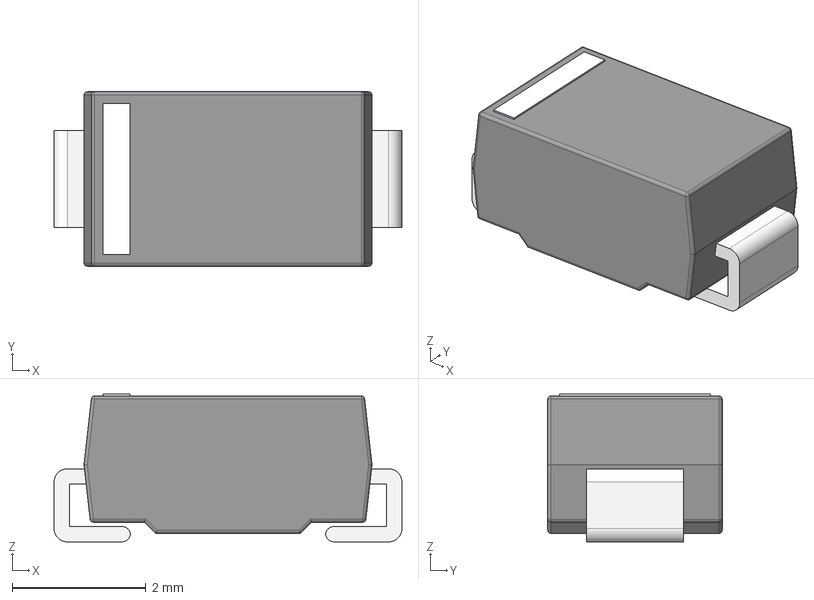
[picture p145: CAD file, 2021-04-16]
CADModels/FET&Diode/SMA.step
5.20 x 2.60 x 2.21 mm
