binphilxiao/AxisLabs/CADModels/Inductors/L_1206.stp

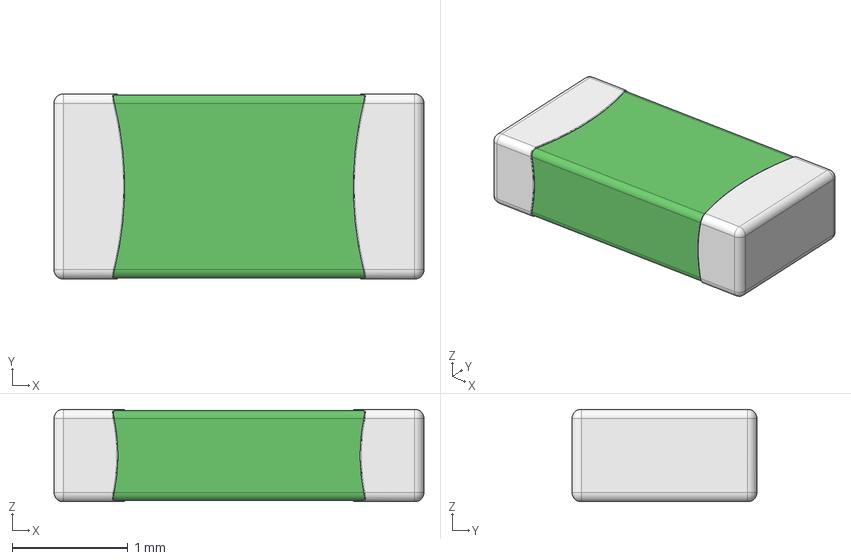
[picture p146: CAD file, 2022-04-04]
CADModels/Inductors/L_1206.stp
3.20 x 1.60 x 0.8 mm
Pin1
Pin2
CeramicBody
