binphilxiao/AxisLabs/CADModels/RC components/rsmd-0201_l0-6_w0-3_h0-25.stp

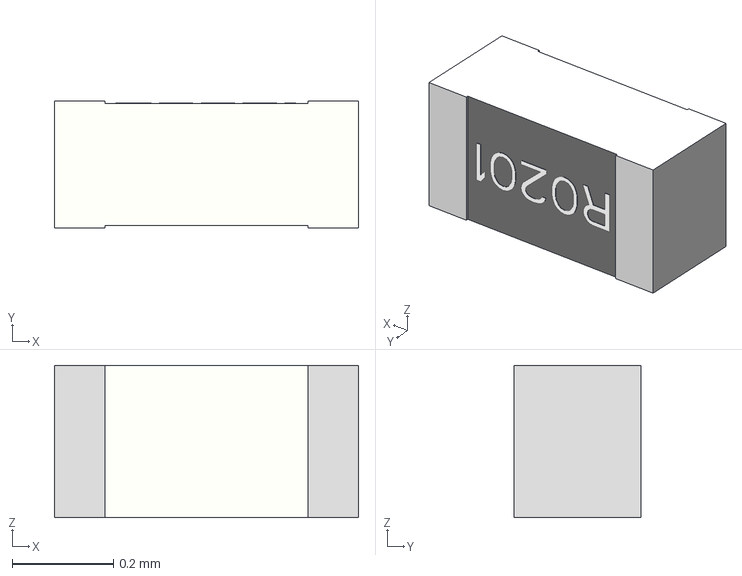
[picture p147: CAD file, 2022-04-04]
CADModels/RC components/rsmd-0201_l0-6_w0-3_h0-25.stp
0.6 x 0.25 x 0.3 mm
