binphilxiao/AxisLabs/CADModels/Chips/MSP430FR2422IRHLR.stp

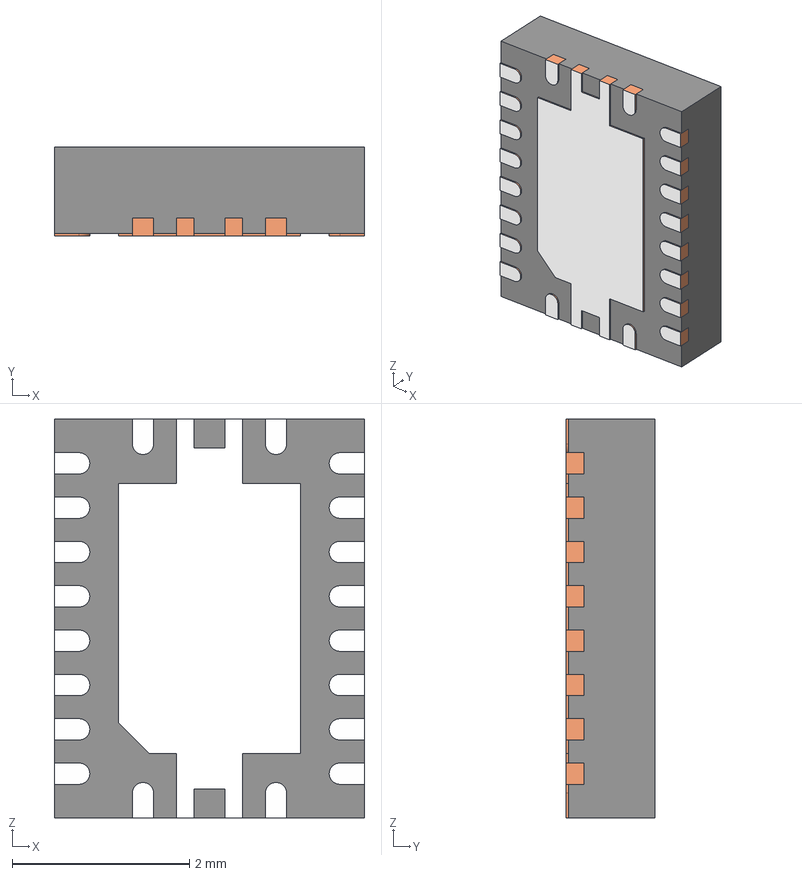
[picture p148: CAD file, 2025-06-10]
CADModels/Chips/MSP430FR2422IRHLR.stp
3.50 x 1.00 x 4.50 mm
BODY-QFN
FRAME-RHL0020A
PIN1-ID
