binphilxiao/AxisLabs/CADModels/FET&Diode/SMB.step

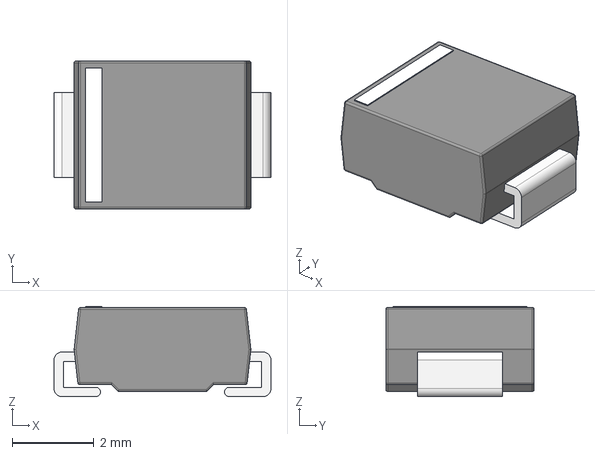
[picture p149: CAD file, 2021-04-16]
CADModels/FET&Diode/SMB.step
5.29 x 3.62 x 2.21 mm
