binphilxiao/AxisLabs/CADModels/RC components/rsmd-0603_l1-6_w0-8_h0-45.stp

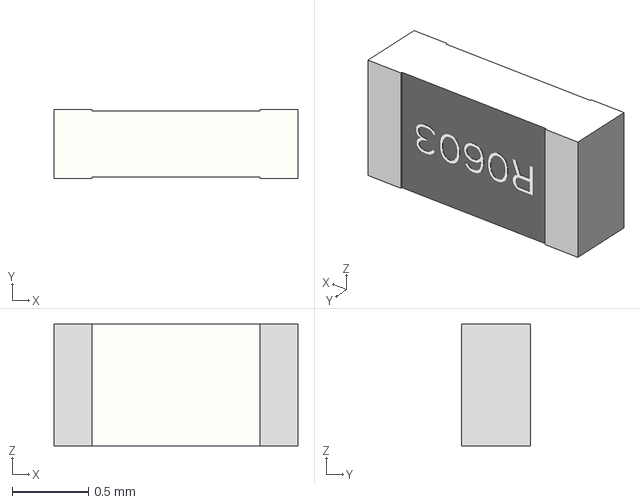
[picture p150: CAD file, 2022-04-04]
CADModels/RC components/rsmd-0603_l1-6_w0-8_h0-45.stp
1.60 x 0.45 x 0.8 mm
