binphilxiao/AxisLabs/CADModels/Chips/DRV8212PDSGR.stp

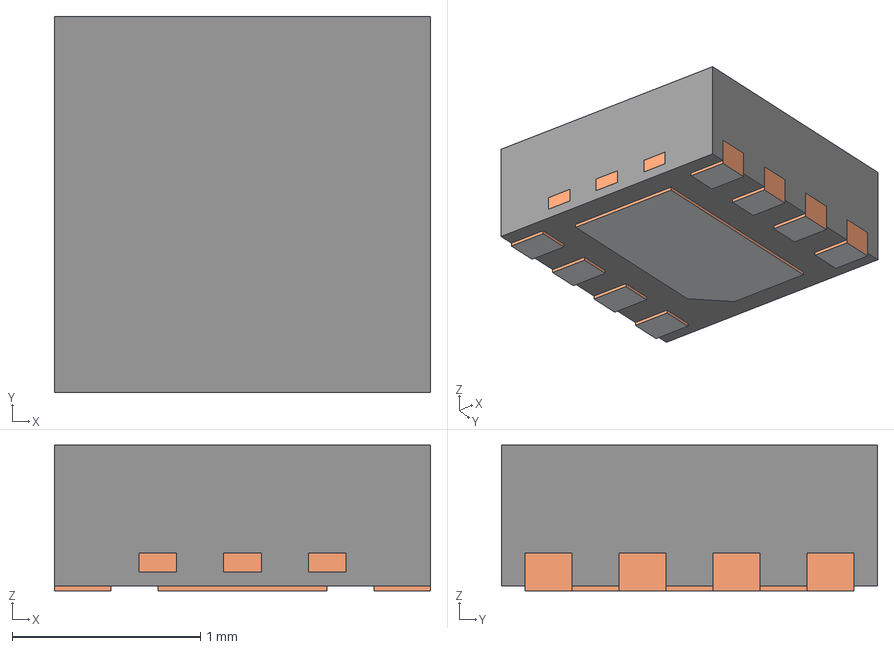
[picture p151: CAD file, 2025-06-10]
CADModels/Chips/DRV8212PDSGR.stp
2.00 x 2.00 x 0.775 mm
BODY-SON
FRAME-DSG0008A
PIN1-ID
