binphilxiao/AxisLabs/CADModels/Connectors/BK-950.STEP

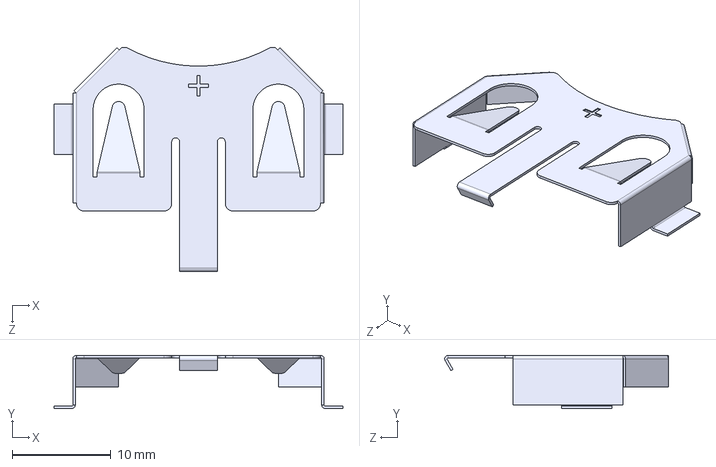
[picture p152: CAD file, 2025-06-10]
CADModels/Connectors/BK-950.STEP
29.2 x 5.38 x 22.6 mm
