binphilxiao/AxisLabs/CADModels/FET&Diode/SMC.step

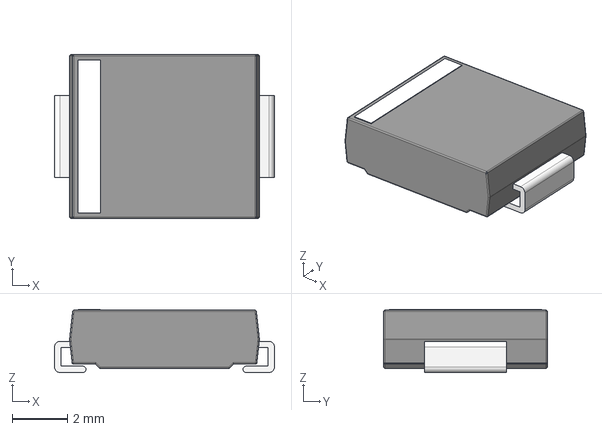
[picture p153: CAD file, 2021-04-16]
CADModels/FET&Diode/SMC.step
7.94 x 5.90 x 2.27 mm
