binphilxiao/AxisLabs/CADModels/RC components/rsmd-1218_l3-1_w4-6_h0-55.stp

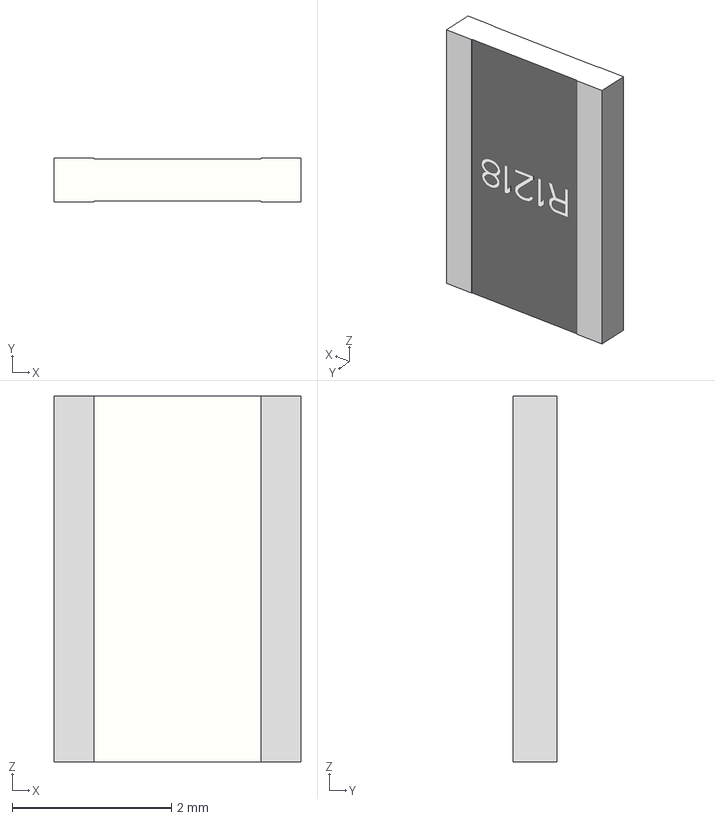
[picture p154: CAD file, 2022-04-04]
CADModels/RC components/rsmd-1218_l3-1_w4-6_h0-55.stp
3.10 x 0.55 x 4.60 mm
