binphilxiao/AxisLabs/CADModels/Chips/DRV8214.stp

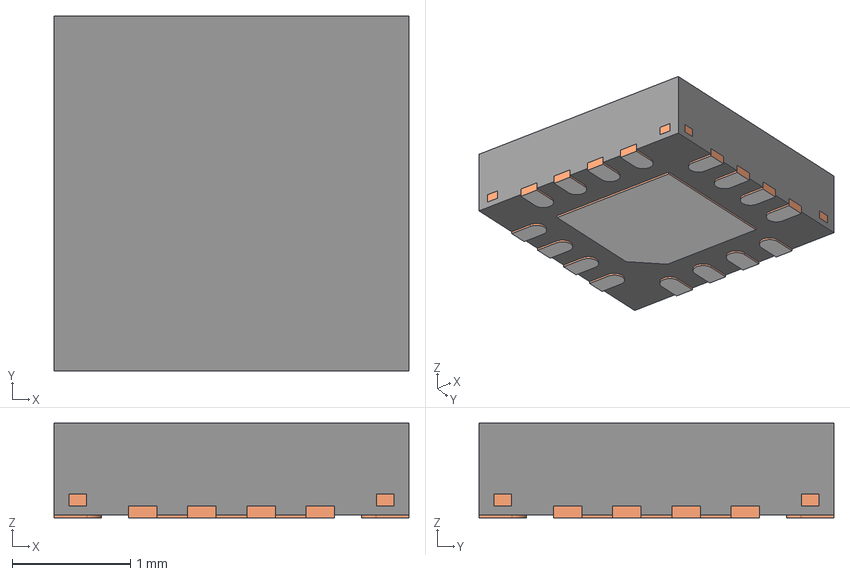
[picture p155: CAD file, 2025-04-29]
CADModels/Chips/DRV8214.stp
3.00 x 3.00 x 0.8 mm
BODY-QFN
FRAME-RTE0016C
PIN1-ID
