binphilxiao/AxisLabs/CADModels/Connectors/BM05B-SRSS-TB.STEP

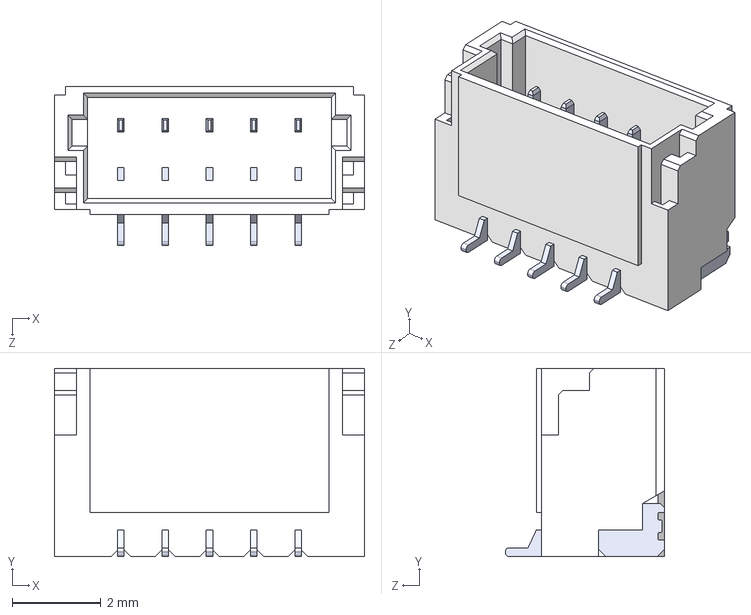
[picture p156: CAD file, 2025-06-10]
CADModels/Connectors/BM05B-SRSS-TB.STEP
7.00 x 4.25 x 3.60 mm
