binphilxiao/AxisLabs/CADModels/FET&Diode/SOD-123F.step

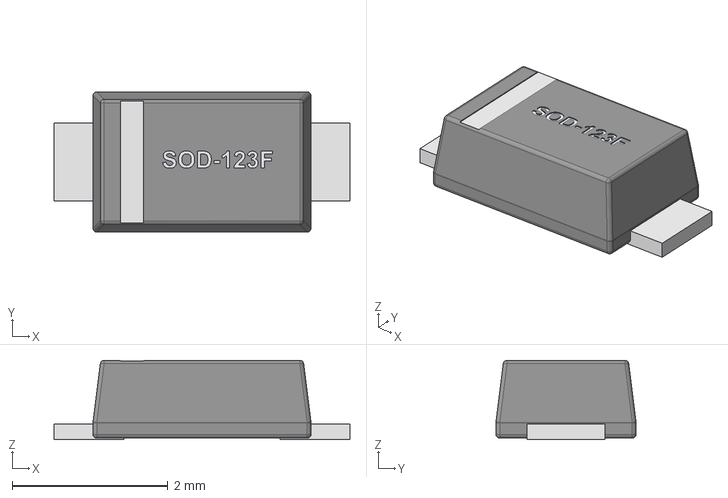
[picture p157: CAD file, 2020-12-18]
CADModels/FET&Diode/SOD-123F.step
3.80 x 1.80 x 1.02 mm
