binphilxiao/AxisLabs/CADModels/RC components/rsmd-1812_l4-5_w3-2_h0-6.stp

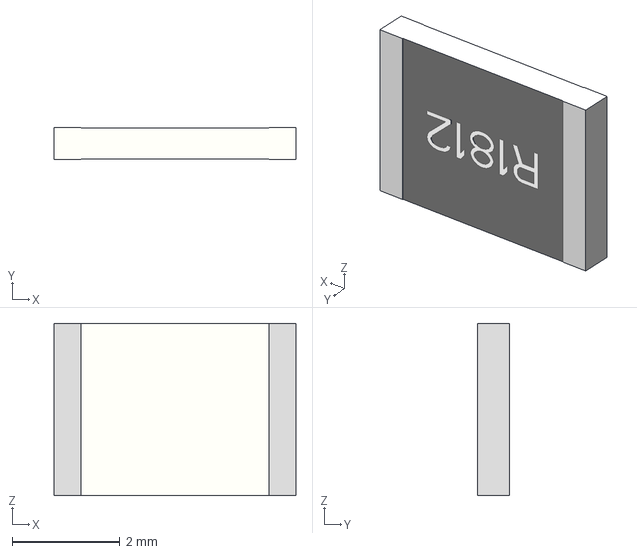
[picture p158: CAD file, 2022-04-04]
CADModels/RC components/rsmd-1812_l4-5_w3-2_h0-6.stp
4.50 x 0.6 x 3.20 mm
