binphilxiao/AxisLabs/CADModels/FET&Diode/SC-76.stp

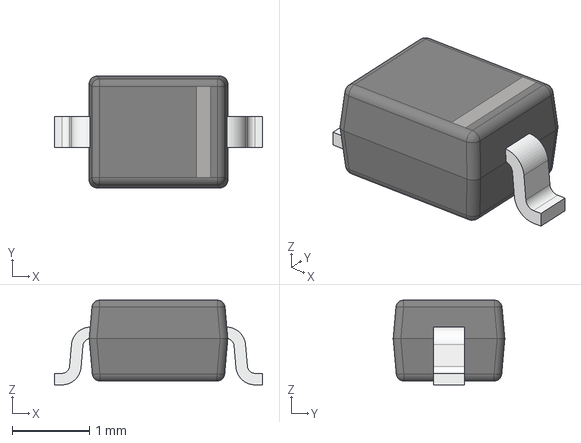
[picture p159: CAD file, 2020-12-17]
CADModels/FET&Diode/SC-76.stp
2.70 x 1.45 x 1.10 mm
