binphilxiao/AxisLabs/CADModels/Chips/KXTJ3-1057.step

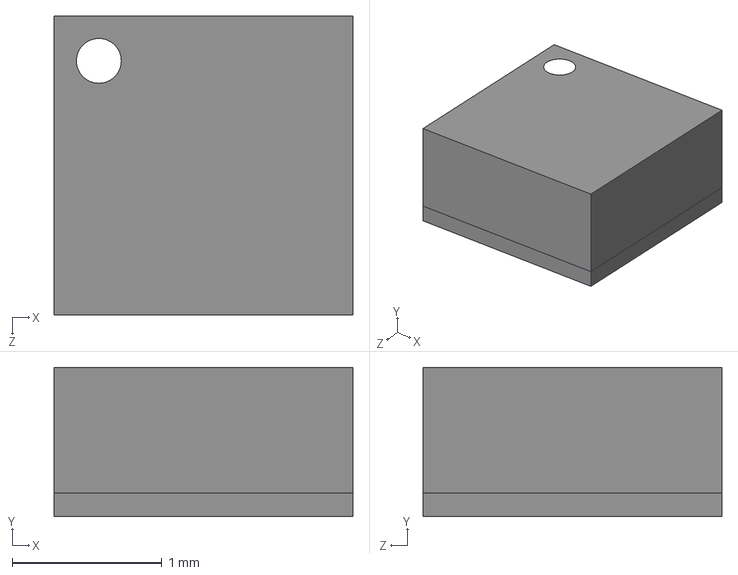
[picture p161: CAD file, 2024-08-30]
CADModels/Chips/KXTJ3-1057.step
2.00 x 1.00 x 2.00 mm
