binphilxiao/AxisLabs/CADModels/Connectors/CF3110xD0x0-05-NH.STEP

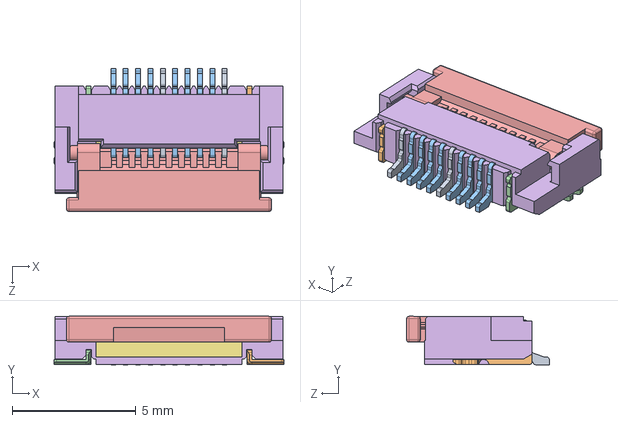
[picture p162: CAD file, 2025-06-10]
CADModels/Connectors/CF3110xD0x0-05-NH.STEP
9.30 x 1.96 x 5.77 mm
