binphilxiao/AxisLabs/CADModels/FET&Diode/SC-75.stp

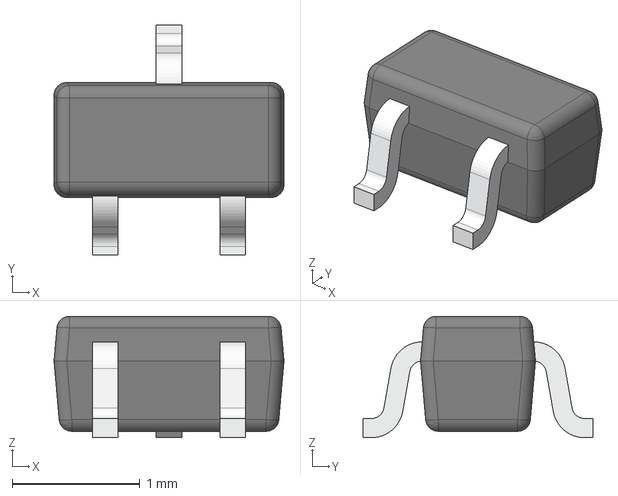
[picture p163: CAD file, 2020-12-17]
CADModels/FET&Diode/SC-75.stp
1.80 x 1.80 x 0.95 mm
