binphilxiao/AxisLabs/CADModels/RC components/rsmd-1210_l3-1_w2-6_h0-55.stp

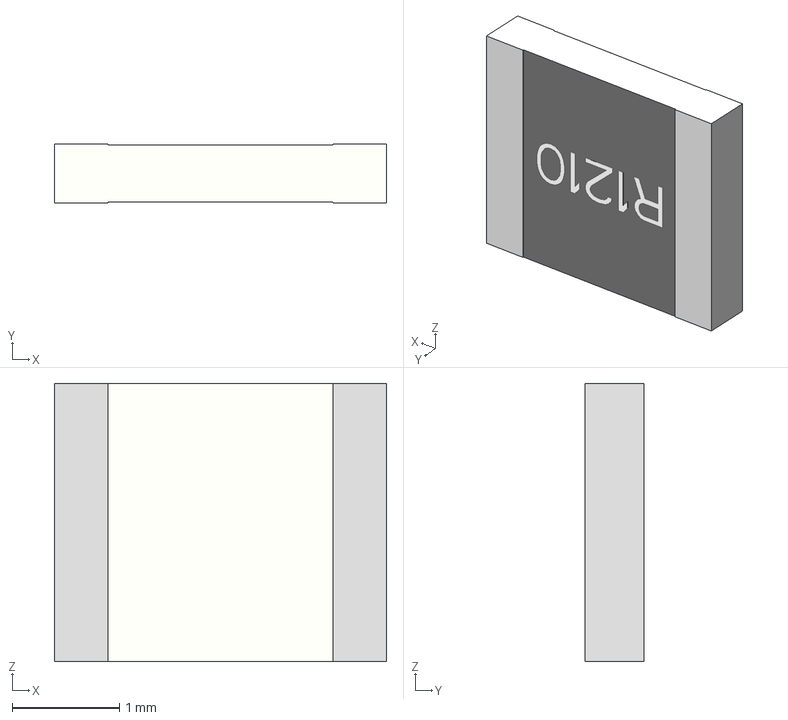
[picture p164: CAD file, 2022-04-04]
CADModels/RC components/rsmd-1210_l3-1_w2-6_h0-55.stp
3.10 x 0.55 x 2.60 mm
