binphilxiao/AxisLabs/CADModels/Chips/MMA8652FCR1.step

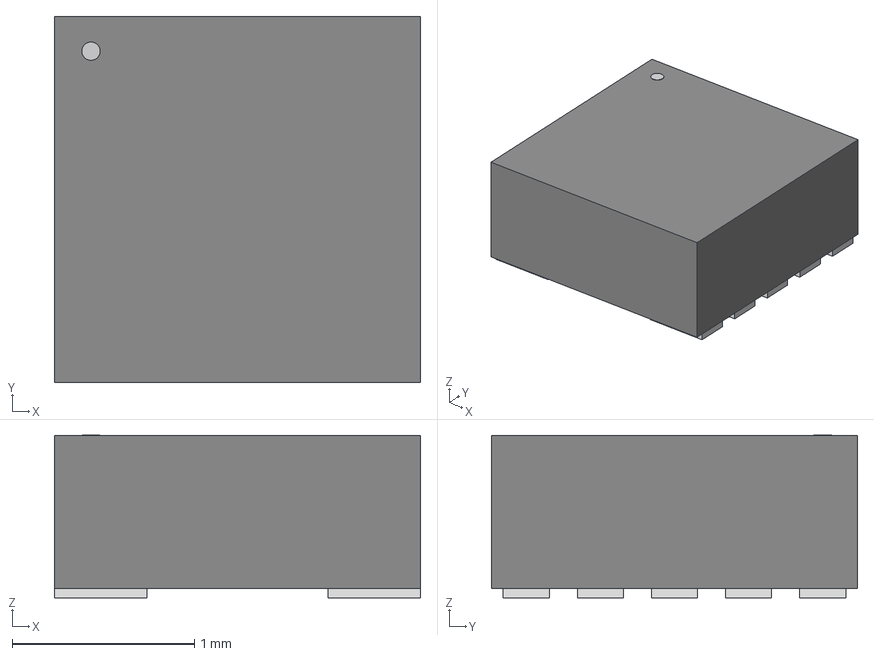
[picture p165: CAD file, 2024-08-21]
CADModels/Chips/MMA8652FCR1.step
2.01 x 2.01 x 0.892 mm
