binphilxiao/AxisLabs/CADModels/Connectors/FFC3B07-05-T.STEP

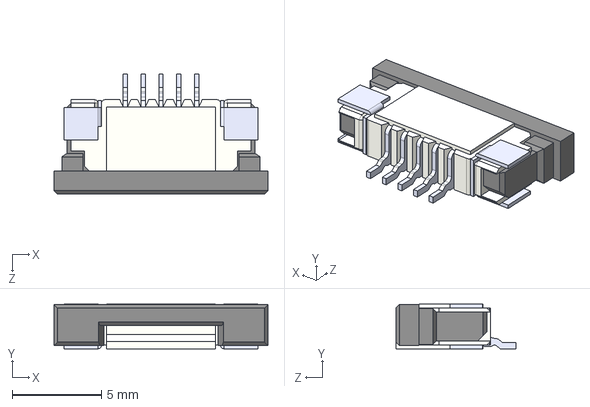
[picture p166: CAD file, 2025-04-29]
CADModels/Connectors/FFC3B07-05-T.STEP
12.0 x 2.50 x 6.75 mm
FFC3B07-xxxx_05
pin^FFC3B07-xxxx ass x 5
