binphilxiao/AxisLabs/CADModels/FET&Diode/SC-76A.stp

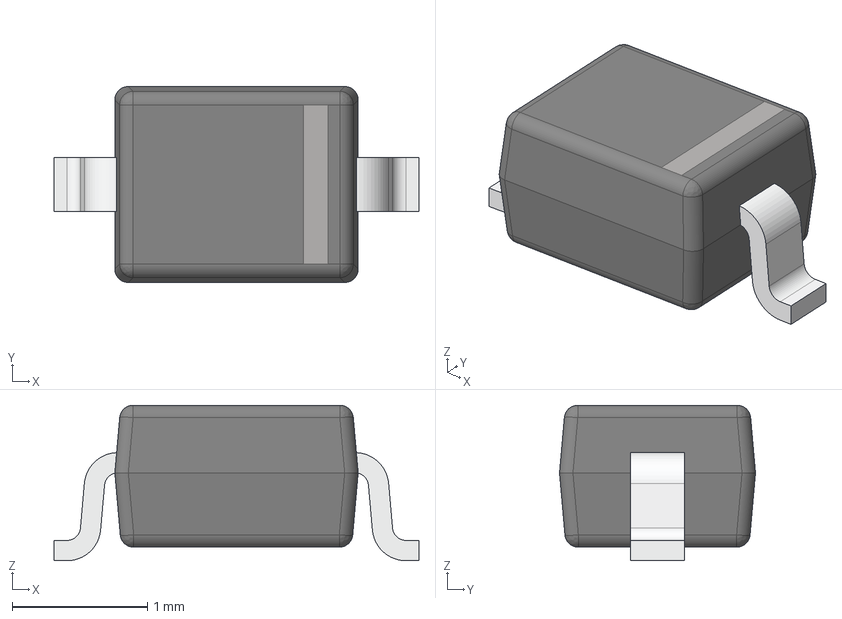
[picture p167: CAD file, 2020-12-17]
CADModels/FET&Diode/SC-76A.stp
2.70 x 1.45 x 1.15 mm
