binphilxiao/AxisLabs/CADModels/RC components/rsmd-1206_l3-1_w1-6_h0-55.stp

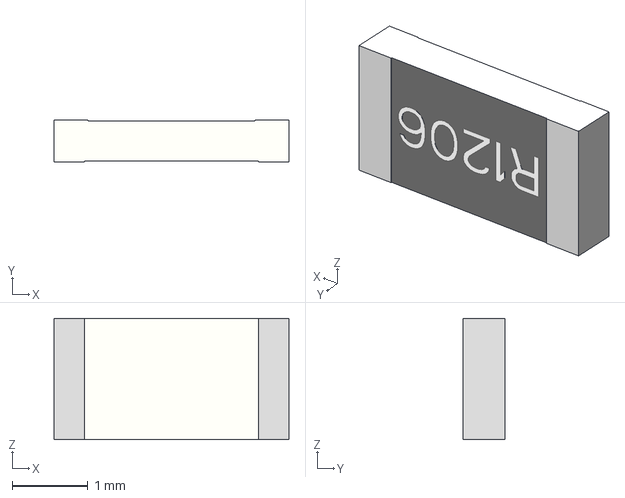
[picture p168: CAD file, 2022-04-04]
CADModels/RC components/rsmd-1206_l3-1_w1-6_h0-55.stp
3.10 x 0.55 x 1.60 mm
