binphilxiao/AxisLabs/CADModels/Chips/VL53L0 3D Model.step

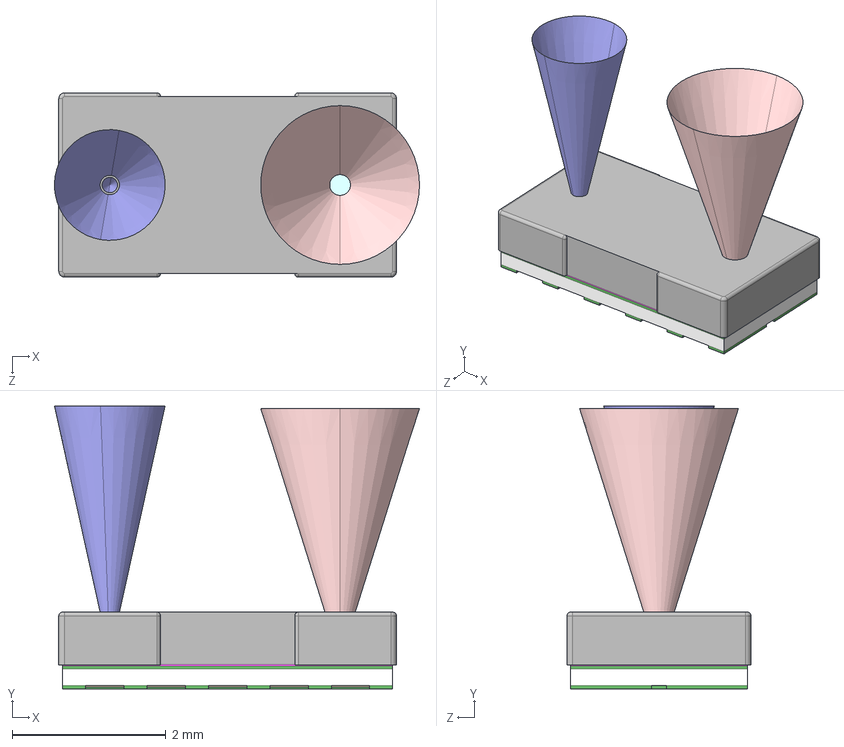
[picture p169: CAD file, 2024-08-21]
CADModels/Chips/VL53L0 3D Model.step
4.75 x 3.68 x 2.40 mm
DM00266747 - VL53L0 Module
DM00266747 - VL53L0 Exclusion cones
