binphilxiao/AxisLabs/CADModels/Connectors/S5B-PH-SM4-TB.STEP

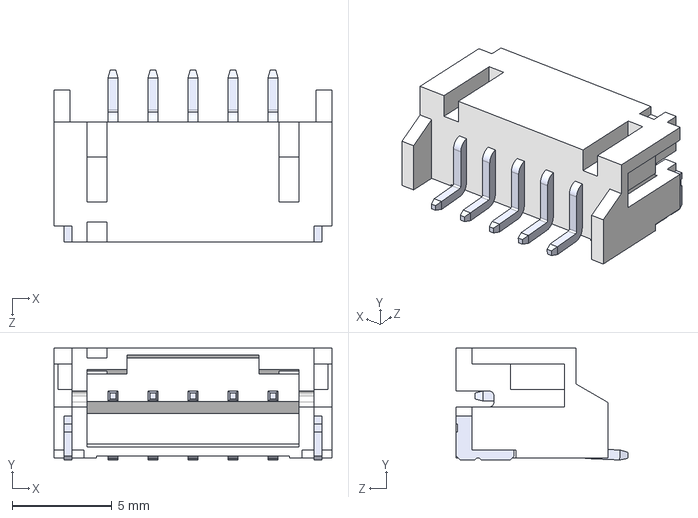
[picture p170: CAD file, 2025-04-29]
CADModels/Connectors/S5B-PH-SM4-TB.STEP
13.9 x 5.60 x 8.60 mm
