binphilxiao/AxisLabs/CADModels/FET&Diode/SOT23-4.step

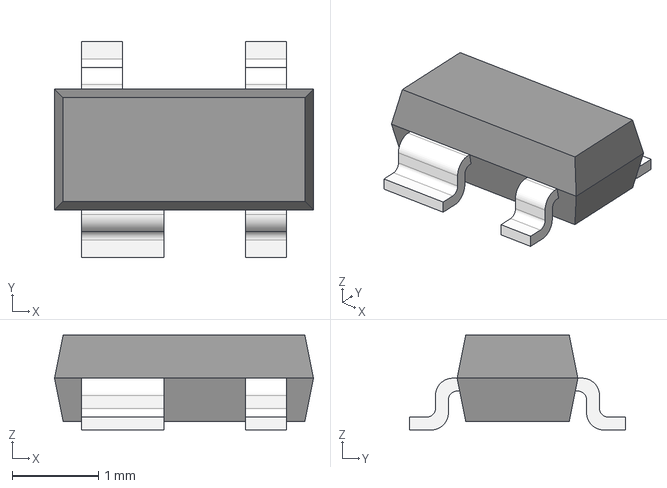
[picture p171: CAD file, 2020-12-17]
CADModels/FET&Diode/SOT23-4.step
3.00 x 2.50 x 1.10 mm
