binphilxiao/AxisLabs/CADModels/RC components/rsmd-1210_l3-2_w2-5_h0-6.stp

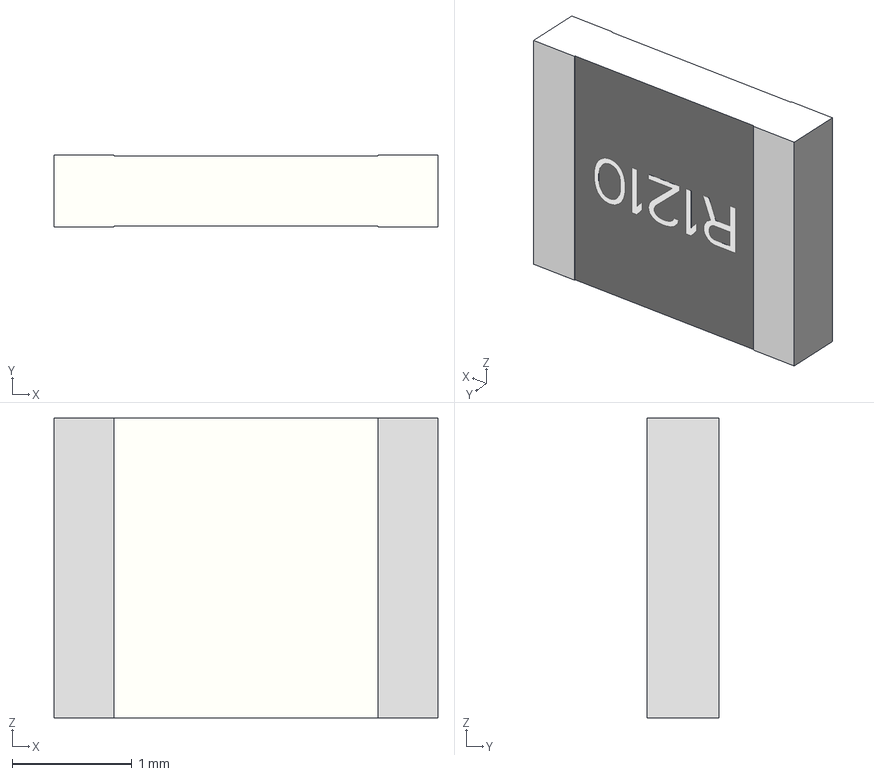
[picture p172: CAD file, 2022-04-04]
CADModels/RC components/rsmd-1210_l3-2_w2-5_h0-6.stp
3.20 x 0.6 x 2.50 mm
