binphilxiao/AxisLabs/CADModels/Chips/DRV5012AEDMRT.stp

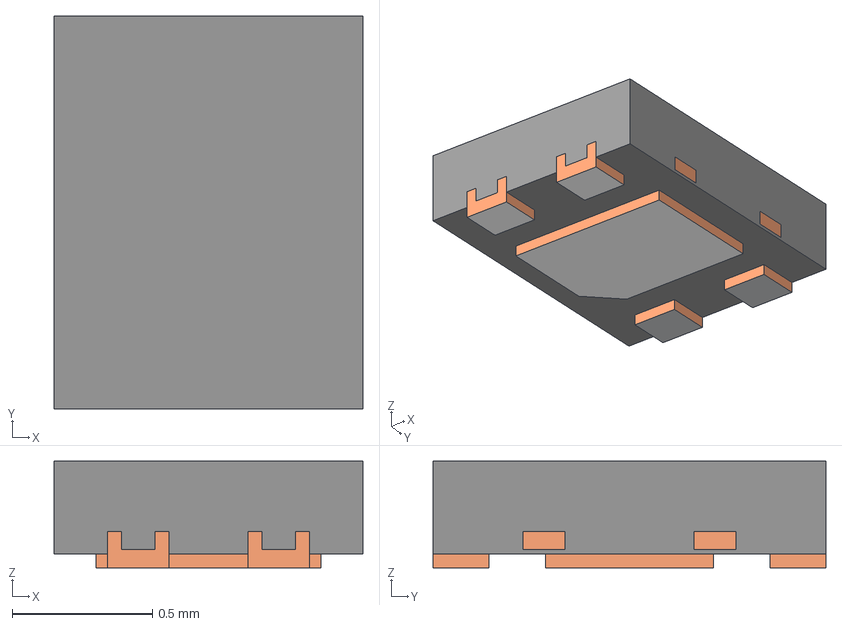
[picture p173: CAD file, 2023-06-28]
CADModels/Chips/DRV5012AEDMRT.stp
1.10 x 1.40 x 0.38 mm
BODY-SON
FRAME-DMR0004A
PIN1-ID
