binphilxiao/AxisLabs/CADModels/Connectors/UJC-HP2-3-SMT-TR.step

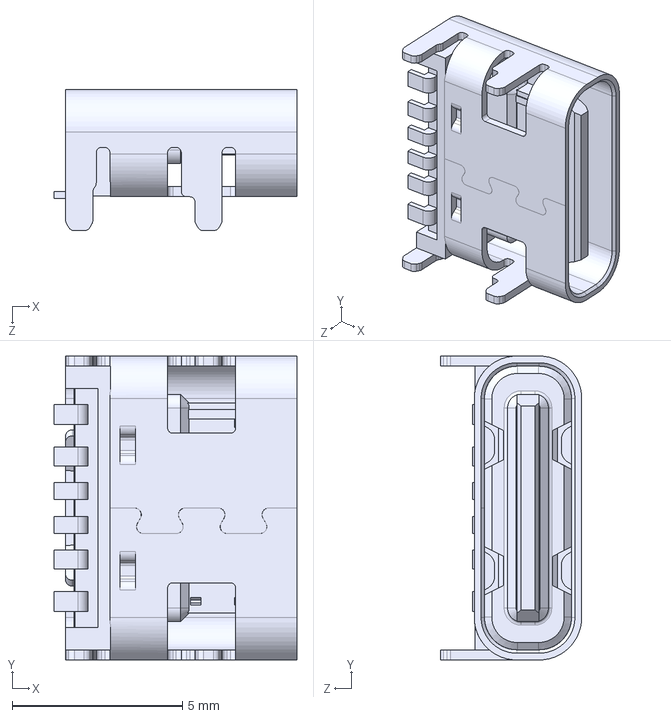
[picture p174: CAD file, 2025-02-07]
CADModels/Connectors/UJC-HP2-3-SMT-TR.step
7.14 x 8.94 x 4.16 mm
