binphilxiao/AxisLabs/CADModels/FET&Diode/SC-90.stp

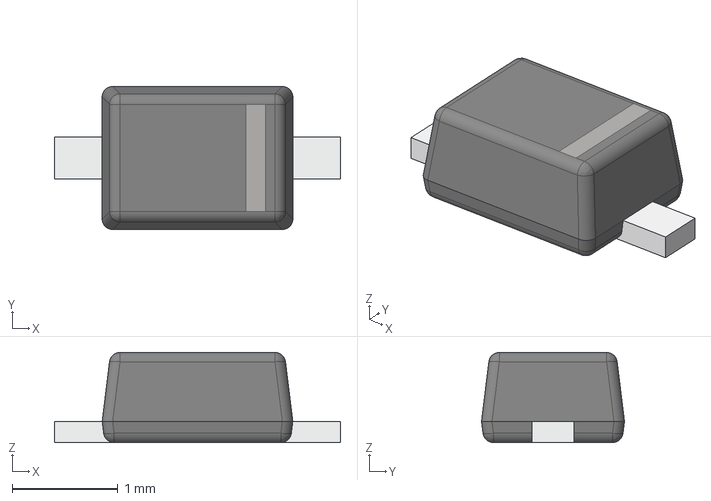
[picture p175: CAD file, 2020-12-17]
CADModels/FET&Diode/SC-90.stp
2.70 x 1.35 x 0.85 mm
