binphilxiao/AxisLabs/CADModels/RC components/rsmd-0805_l2_w1-25_h0-6.stp

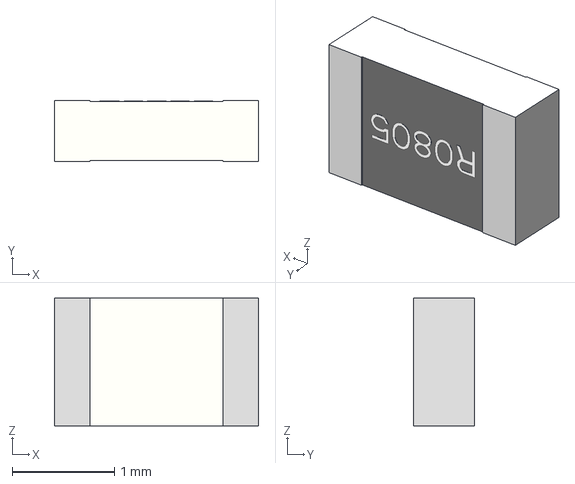
[picture p176: CAD file, 2022-04-04]
CADModels/RC components/rsmd-0805_l2_w1-25_h0-6.stp
2.00 x 0.6 x 1.25 mm
