binphilxiao/AxisLabs/CADModels/Connectors/395-010-559-212 - EDAC Card Edge Connector.STEP

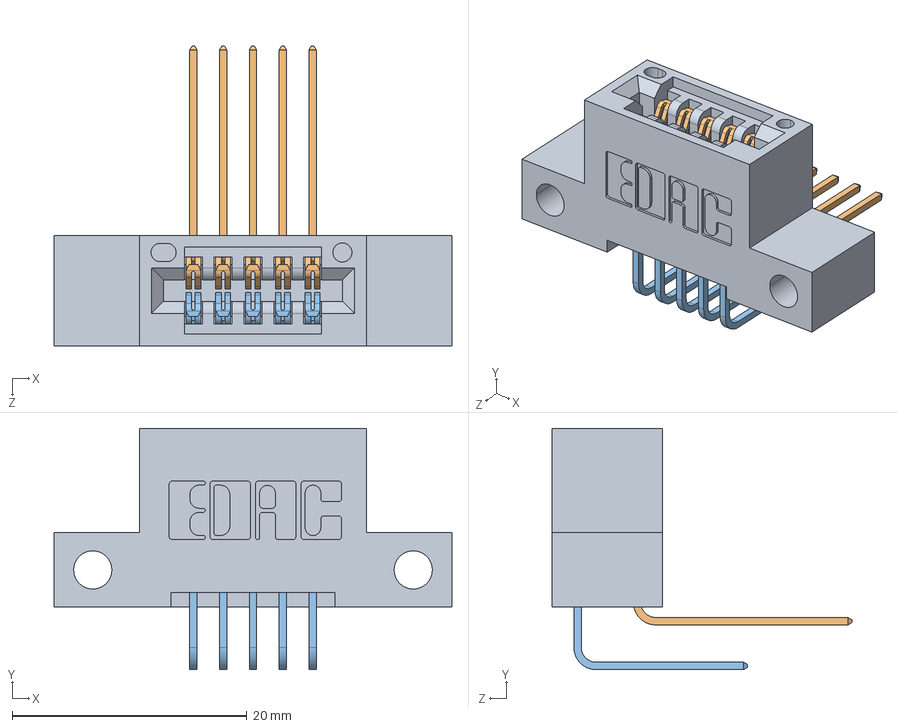
[picture p177: CAD file, 2024-08-30]
CADModels/Connectors/395-010-559-212 - EDAC Card Edge Connector.STEP
33.9 x 20.6 x 25.5 mm
345 Part_Flush Mounting Lugs - Side Mount
345-292-001_558 559 Tail - 1 x 5
345-292-001_559 Tail - 2 x 5
