binphilxiao/AxisLabs/CADModels/FET&Diode/SOT23-6.step

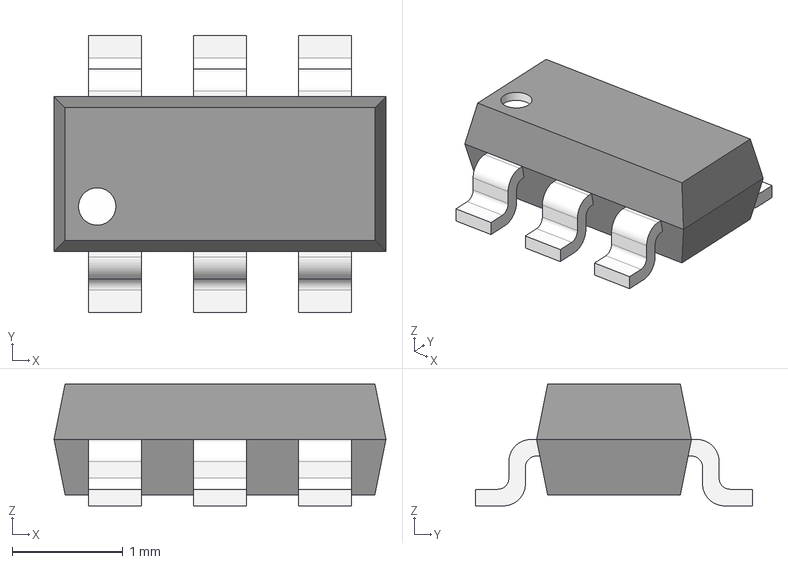
[picture p178: CAD file, 2020-12-17]
CADModels/FET&Diode/SOT23-6.step
3.00 x 2.50 x 1.10 mm
