binphilxiao/AxisLabs/CADModels/RC components/rsmd-2010_l5_w2-5_h0-55.stp

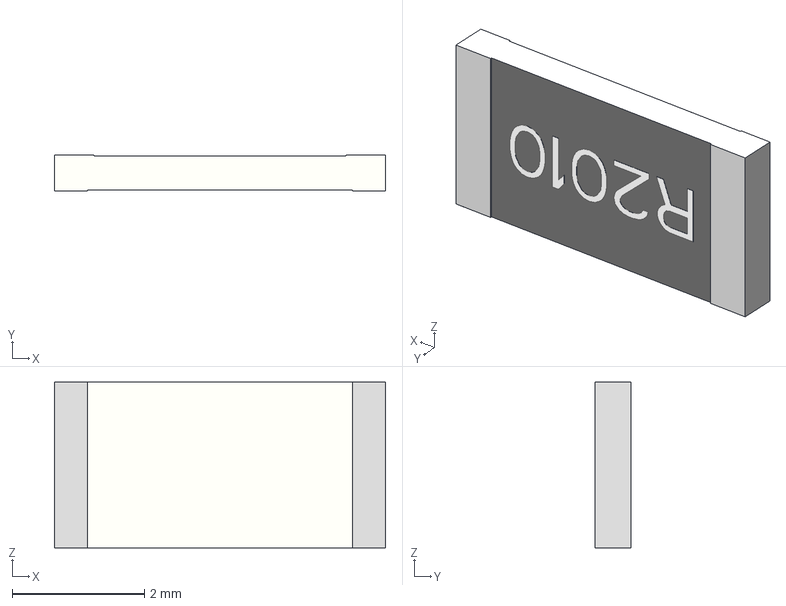
[picture p179: CAD file, 2022-04-04]
CADModels/RC components/rsmd-2010_l5_w2-5_h0-55.stp
5.00 x 0.55 x 2.50 mm
