binphilxiao/AxisLabs/CADModels/Chips/DFN10_NXP.step

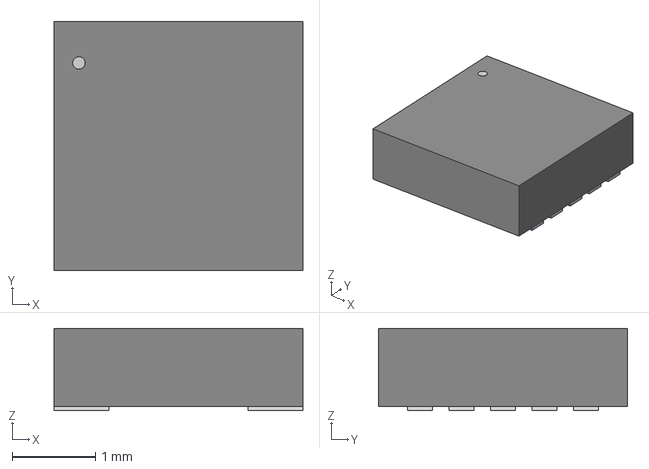
[picture p180: CAD file, 2022-11-22]
CADModels/Chips/DFN10_NXP.step
3.00 x 3.00 x 0.993 mm
