binphilxiao/AxisLabs/CADModels/Connectors/BS-2450.step

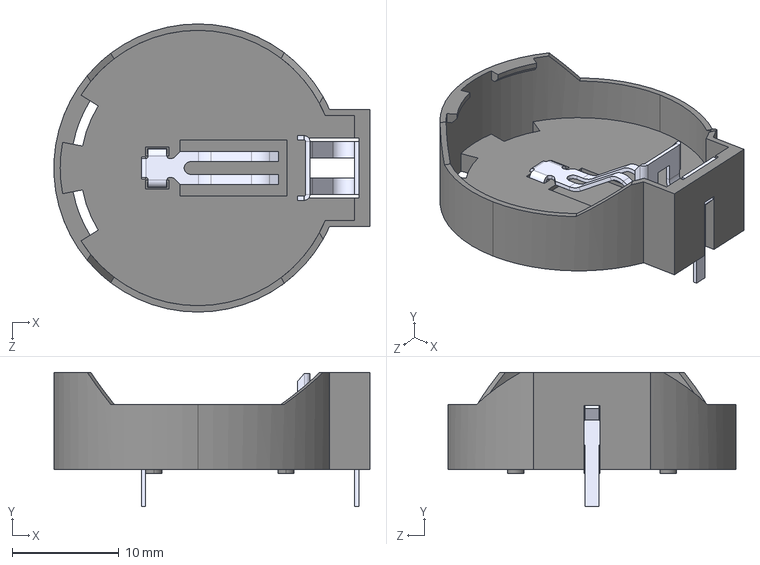
[picture p181: CAD file, 2024-08-21]
CADModels/Connectors/BS-2450.step
29.6 x 12.6 x 27.0 mm
