binphilxiao/AxisLabs/CADModels/RC components/rsmd-2512_l6-35_w3-2_h0-55.stp

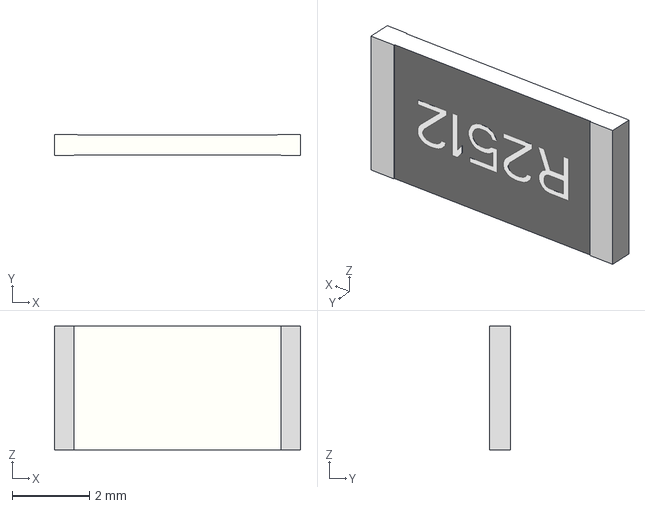
[picture p182: CAD file, 2022-04-04]
CADModels/RC components/rsmd-2512_l6-35_w3-2_h0-55.stp
6.35 x 0.55 x 3.20 mm
