binphilxiao/AxisLabs/CADModels/Chips/SOT-89.step

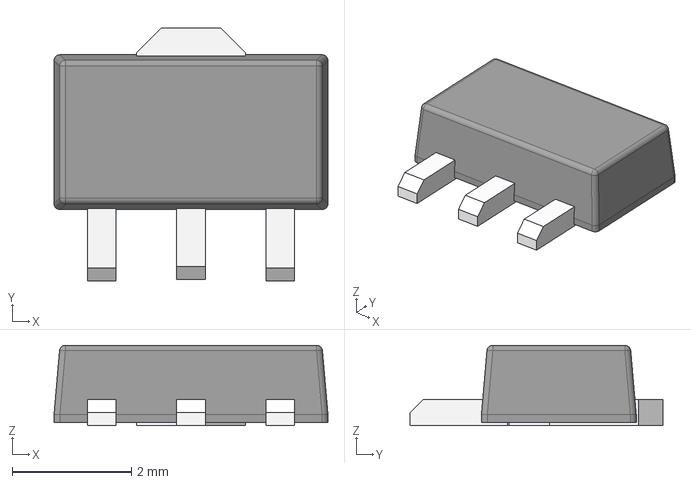
[picture p183: CAD file, 2022-11-22]
CADModels/Chips/SOT-89.step
4.60 x 4.25 x 1.35 mm
