binphilxiao/AxisLabs/CADModels/Connectors/CON2_1X2_TU_TSW.step

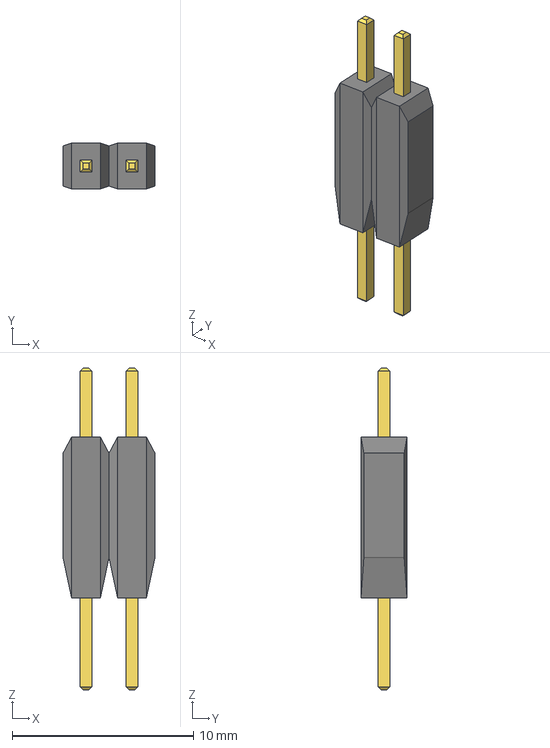
[picture p184: CAD file, 2024-07-24]
CADModels/Connectors/CON2_1X2_TU_TSW.step
5.08 x 2.54 x 17.8 mm
