binphilxiao/AxisLabs/CADModels/RC components/rsmd-2512_l6-4_w3-2_h1-1.stp

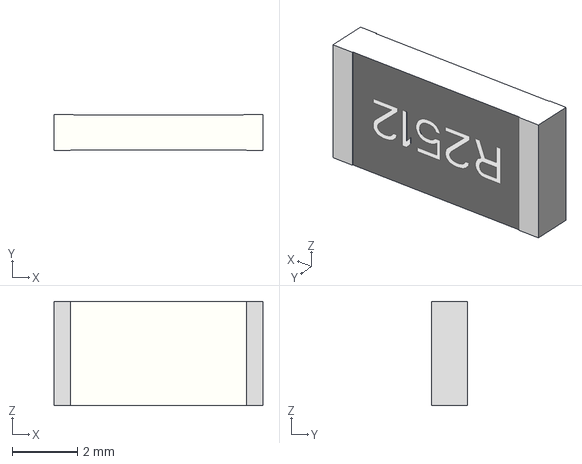
[picture p186: CAD file, 2022-04-04]
CADModels/RC components/rsmd-2512_l6-4_w3-2_h1-1.stp
6.40 x 1.10 x 3.20 mm
