binphilxiao/AxisLabs/CADModels/Chips/dfn10.stp

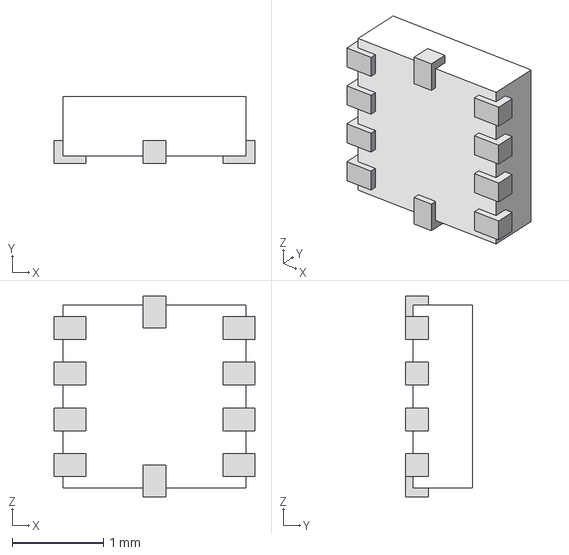
[picture p187: CAD file, 2022-11-22]
CADModels/Chips/dfn10.stp
2.20 x 0.73 x 2.20 mm
