binphilxiao/AxisLabs/CADModels/RC components/rsmd-0402_l1_w0-5_h0-32.stp

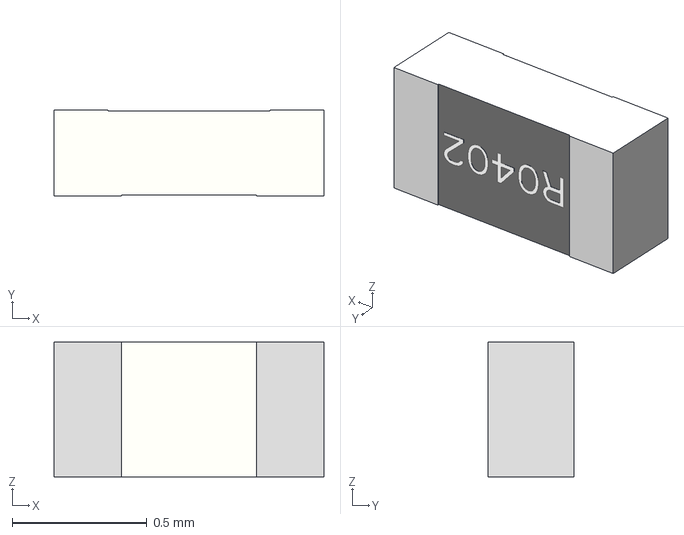
[picture p188: CAD file, 2022-04-04]
CADModels/RC components/rsmd-0402_l1_w0-5_h0-32.stp
1.00 x 0.32 x 0.5 mm
