binphilxiao/AxisLabs/CADModels/Chips/SOIC24.STEP

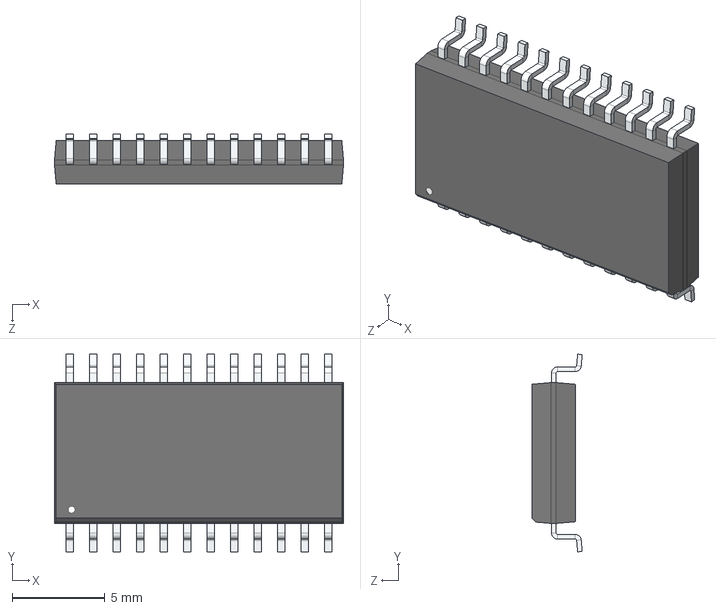
[picture p189: CAD file, 2022-09-12]
CADModels/Chips/SOIC24.STEP
15.6 x 10.7 x 2.72 mm
