binphilxiao/AxisLabs/CADModels/RC components/rsmd-2512_l6-4_w3-2_h0-6.stp

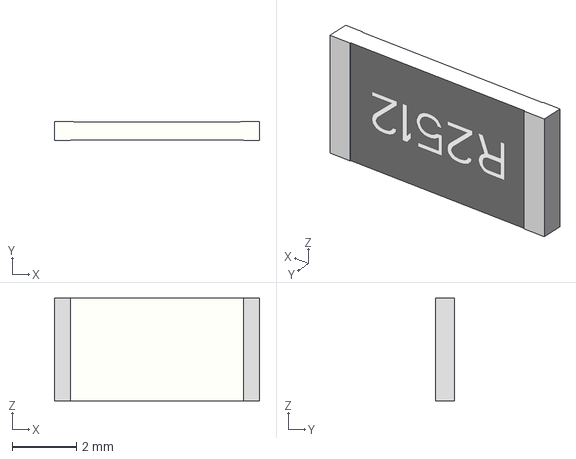
[picture p190: CAD file, 2022-04-04]
CADModels/RC components/rsmd-2512_l6-4_w3-2_h0-6.stp
6.40 x 0.6 x 3.20 mm
