binphilxiao/AxisLabs/CADModels/Chips/SOIC-4.STEP

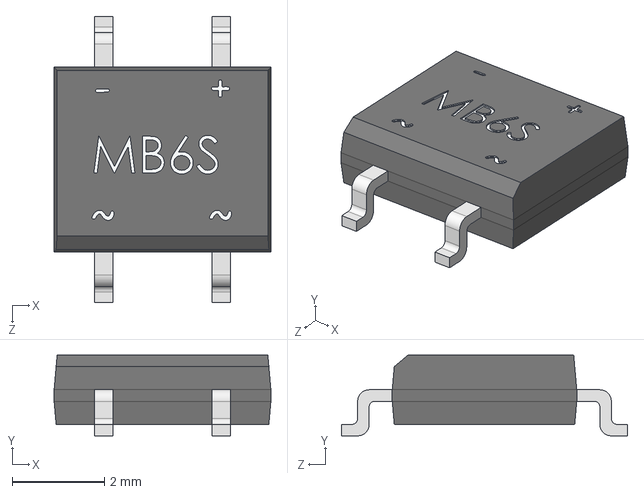
[picture p191: CAD file, 2022-06-01]
CADModels/Chips/SOIC-4.STEP
4.70 x 1.75 x 6.20 mm
