binphilxiao/AxisLabs/CADModels/Connectors/BM04B-NSHSS-TBT.STEP

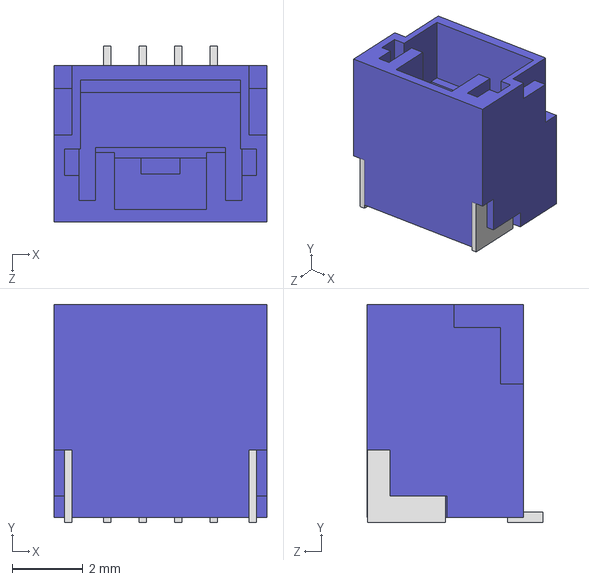
[picture p192: CAD file, 2023-06-06]
CADModels/Connectors/BM04B-NSHSS-TBT.STEP
6.00 x 6.15 x 4.95 mm
