binphilxiao/AxisLabs/CADModels/Chips/TWBGA-84.step

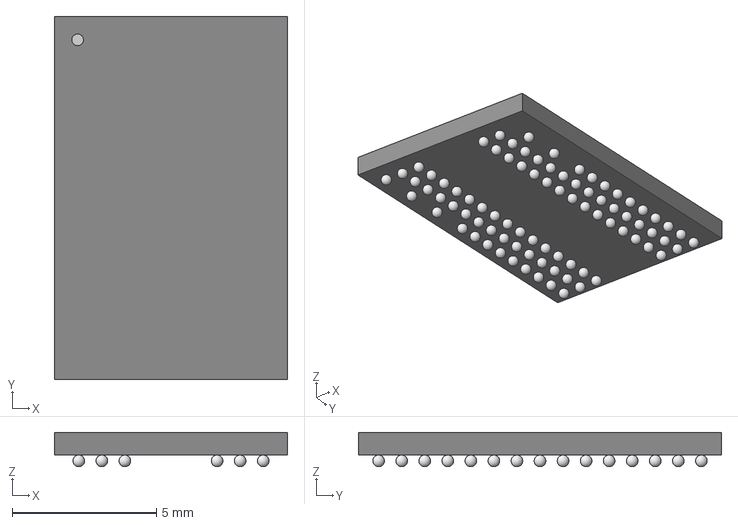
[picture p193: CAD file, 2022-04-04]
CADModels/Chips/TWBGA-84.step
8.10 x 12.6 x 1.20 mm
