binphilxiao/AxisLabs/CADModels/Connectors/BM02B-NSHSS-TBT.STEP

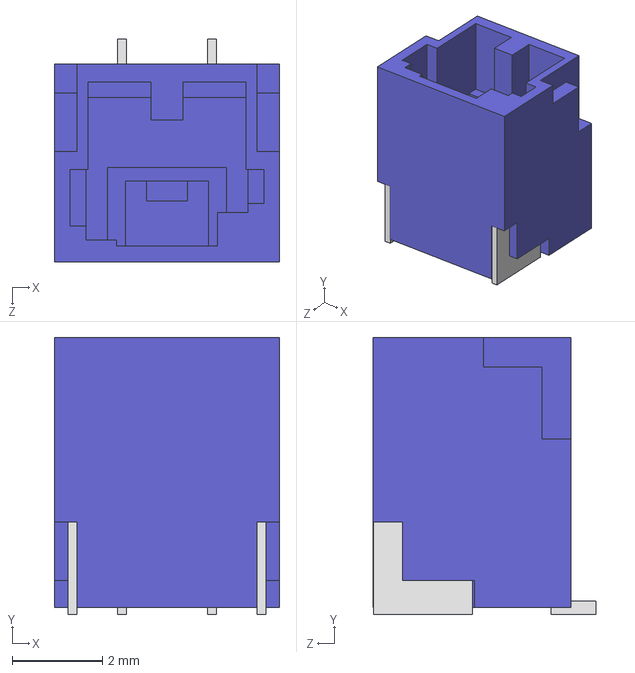
[picture p194: CAD file, 2023-06-06]
CADModels/Connectors/BM02B-NSHSS-TBT.STEP
5.00 x 6.15 x 4.95 mm
