binphilxiao/AxisLabs/CADModels/RC components/res_1812.stp

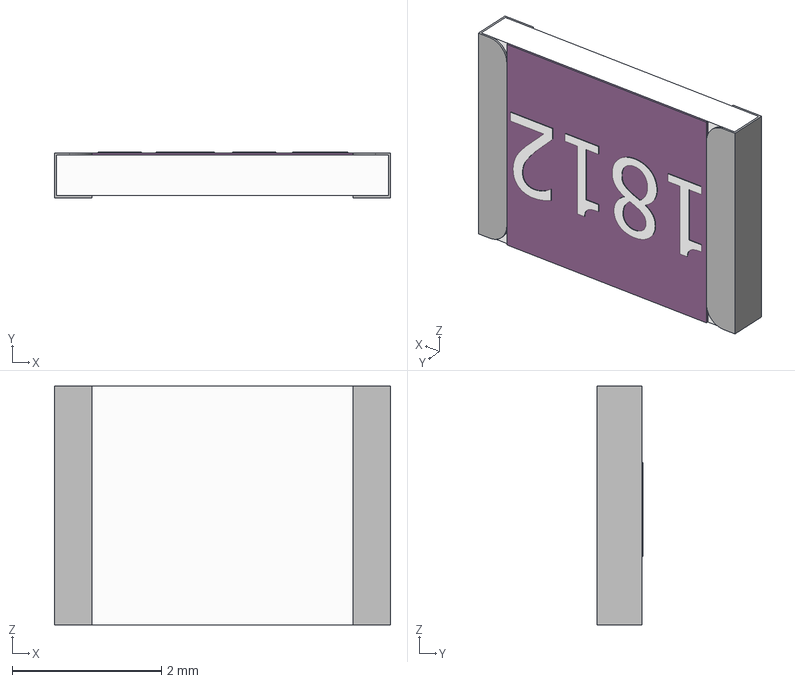
[picture p195: CAD file, 2022-02-01]
CADModels/RC components/res_1812.stp
4.50 x 0.61 x 3.20 mm
Capsule
Encapsulation x 2
TopCover
