binphilxiao/AxisLabs/CADModels/Chips/WSON-8.step

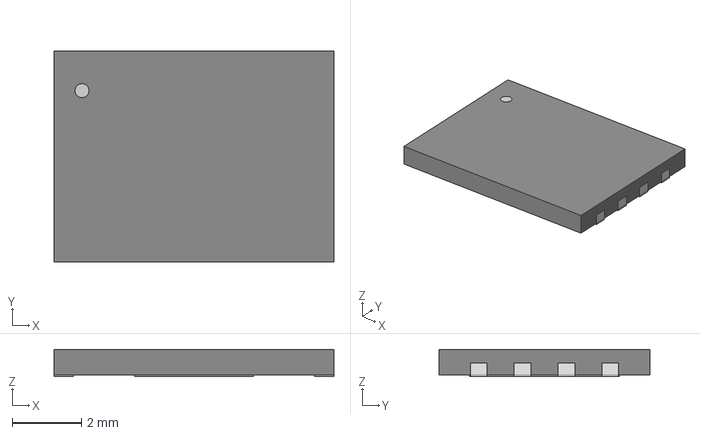
[picture p196: CAD file, 2022-04-04]
CADModels/Chips/WSON-8.step
8.10 x 6.10 x 0.79 mm
