binphilxiao/AxisLabs/CADModels/Connectors/DIP SWITCH 8 POS CTS 206.step

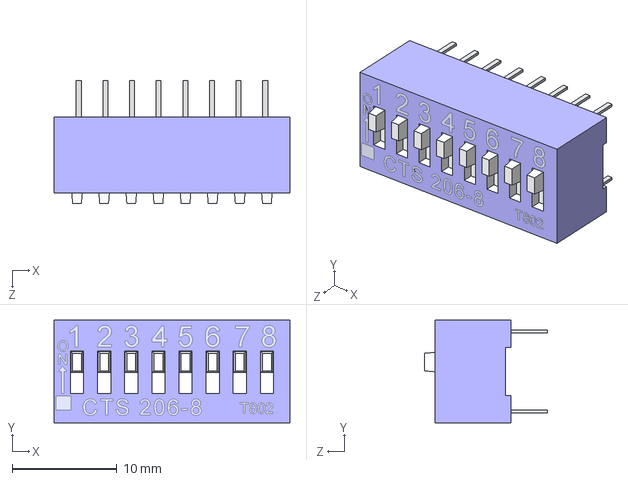
[picture p197: CAD file, 2023-06-06]
CADModels/Connectors/DIP SWITCH 8 POS CTS 206.step
22.5 x 9.78 x 11.8 mm
