binphilxiao/AxisLabs/CADModels/RC components/C0603_070.step

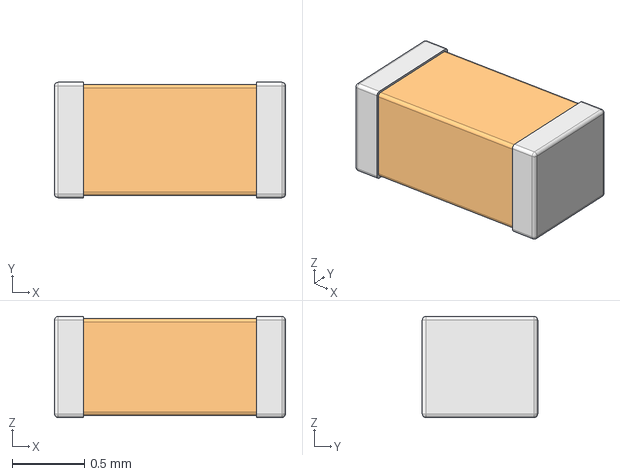
[picture p198: CAD file, 2020-12-17]
CADModels/RC components/C0603_070.step
1.60 x 0.8 x 0.7 mm
