binphilxiao/AxisLabs/CADModels/Connectors/PCIE-064-02-F-D-RA.stp

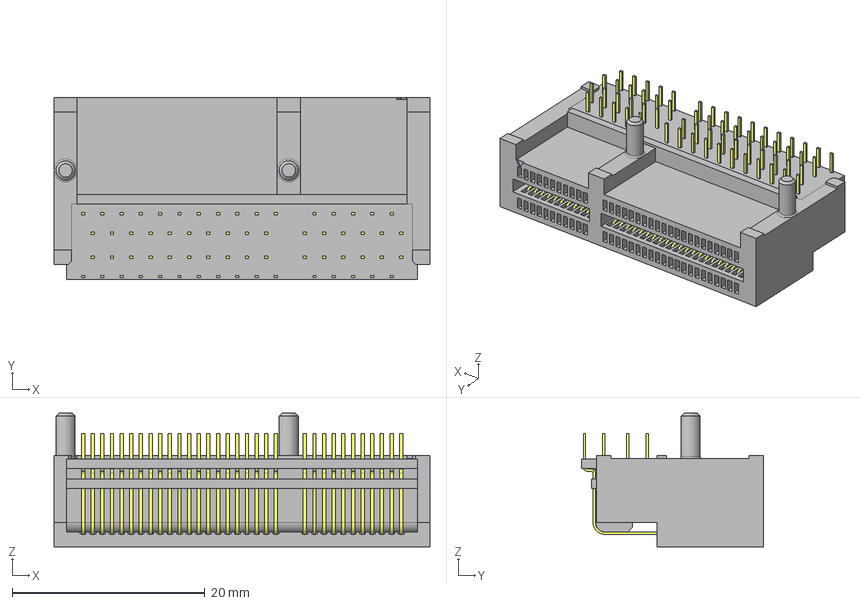
[picture p199: CAD file, 2023-06-06]
CADModels/Connectors/PCIE-064-02-F-D-RA.stp
39.0 x 18.9 x 13.9 mm
PCIE-064-02-F-D-RA_pins2
PCIE-064-02-F-D-RA_pins1
PCIE-064-02-F-D-RA_body
