binphilxiao/AxisLabs/CADModels/RC components/C1210_190.step

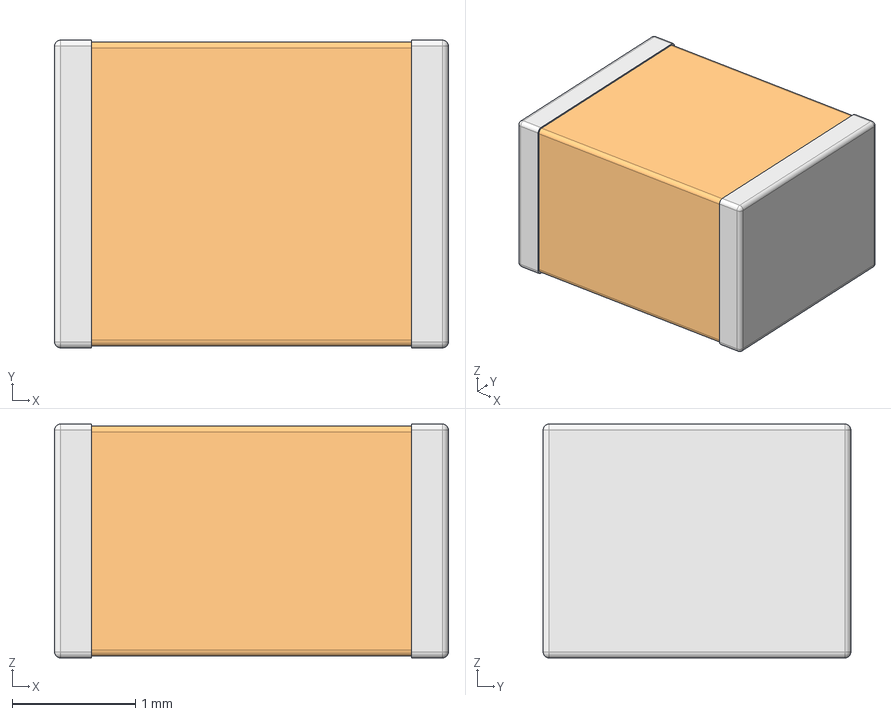
[picture p200: CAD file, 2020-12-17]
CADModels/RC components/C1210_190.step
3.20 x 2.50 x 1.90 mm
