binphilxiao/AxisLabs/CADModels/Connectors/B04B-PASK-1.step

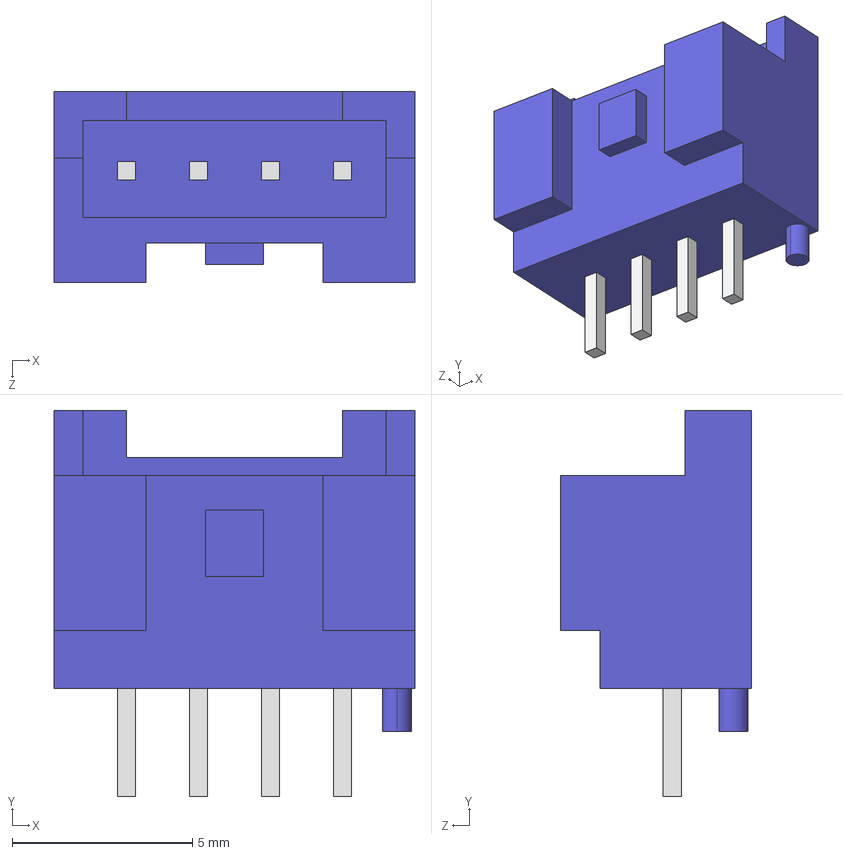
[picture p201: CAD file, 2023-06-06]
CADModels/Connectors/B04B-PASK-1.step
10.0 x 10.7 x 5.30 mm
