binphilxiao/AxisLabs/CADModels/RC components/res_1206.stp

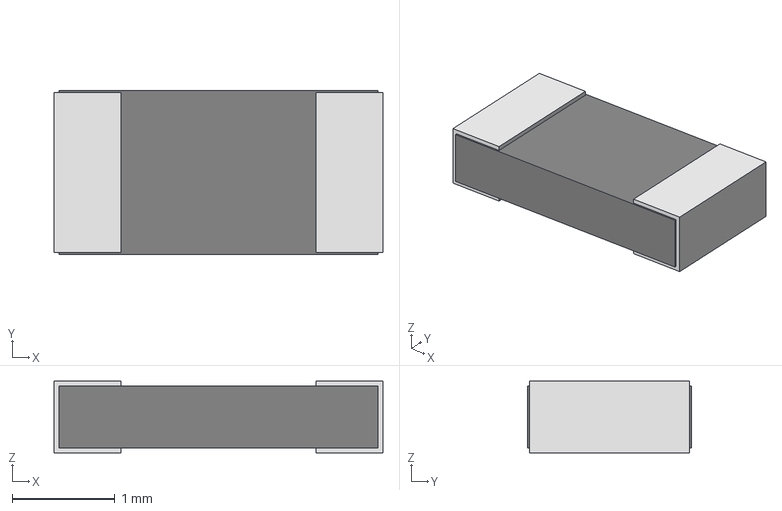
[picture p202: CAD file, 2020-12-17]
CADModels/RC components/res_1206.stp
3.20 x 1.60 x 0.7 mm
