binphilxiao/AxisLabs/CADModels/Connectors/CONN10_2x05_DRXN_SUL.step

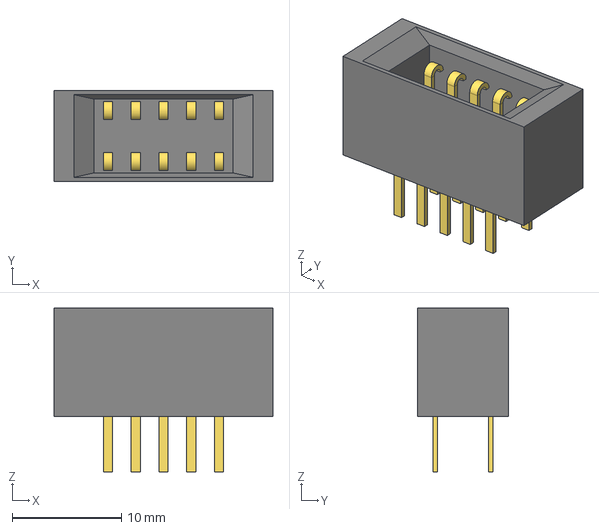
[picture p203: CAD file, 2023-03-07]
CADModels/Connectors/CONN10_2x05_DRXN_SUL.step
20.1 x 8.38 x 15.0 mm
