binphilxiao/AxisLabs/CADModels/RC components/C1206_170.step

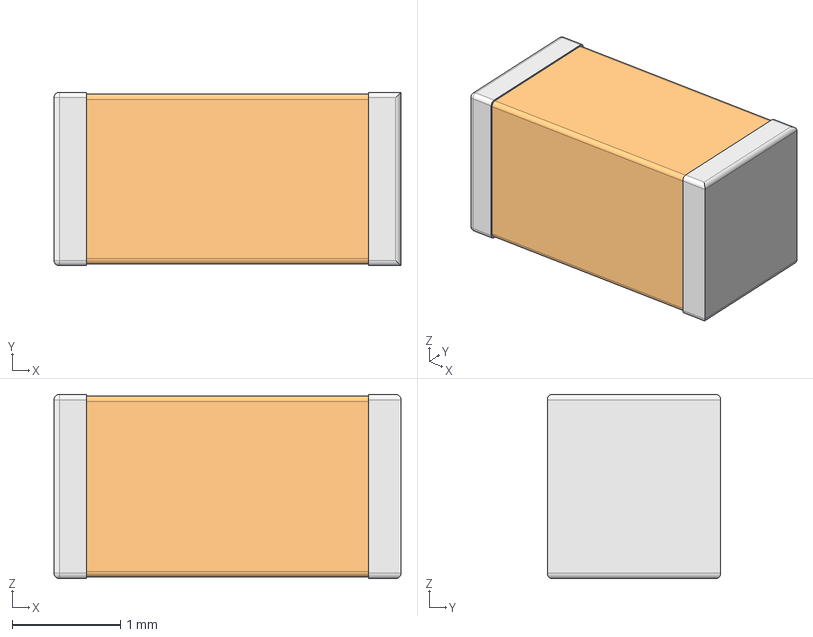
[picture p204: CAD file, 2020-12-17]
CADModels/RC components/C1206_170.step
3.20 x 1.60 x 1.70 mm
