binphilxiao/AxisLabs/CADModels/Chips/User Library-xdfn.STEP

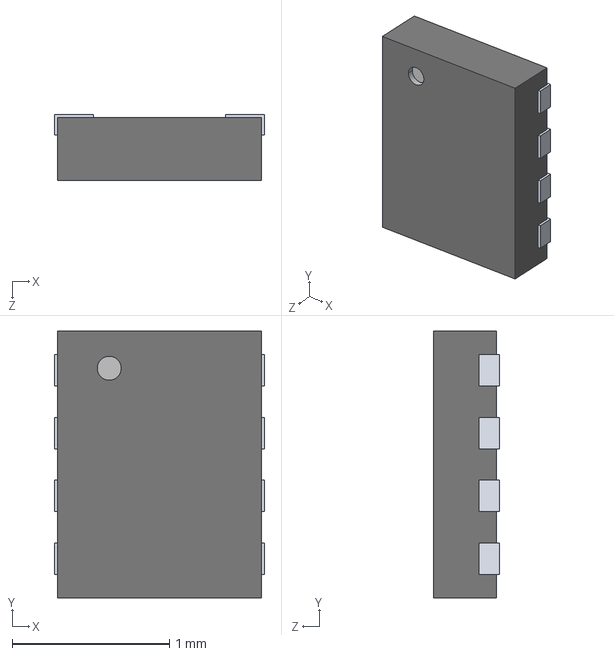
[picture p205: CAD file, 2021-05-04]
CADModels/Chips/User Library-xdfn.STEP
1.34 x 1.70 x 0.42 mm
