binphilxiao/AxisLabs/CADModels/Connectors/BM02B-SRSS-TB_LF__SN_.stp

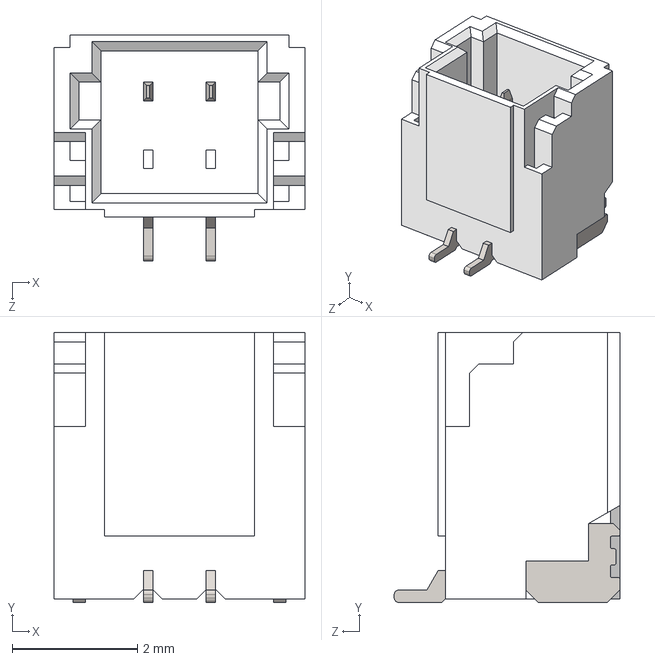
[picture p206: CAD file, 2022-11-22]
CADModels/Connectors/BM02B-SRSS-TB_LF__SN_.stp
4.00 x 4.31 x 3.60 mm
