binphilxiao/AxisLabs/CADModels/RC components/C0603_040.step

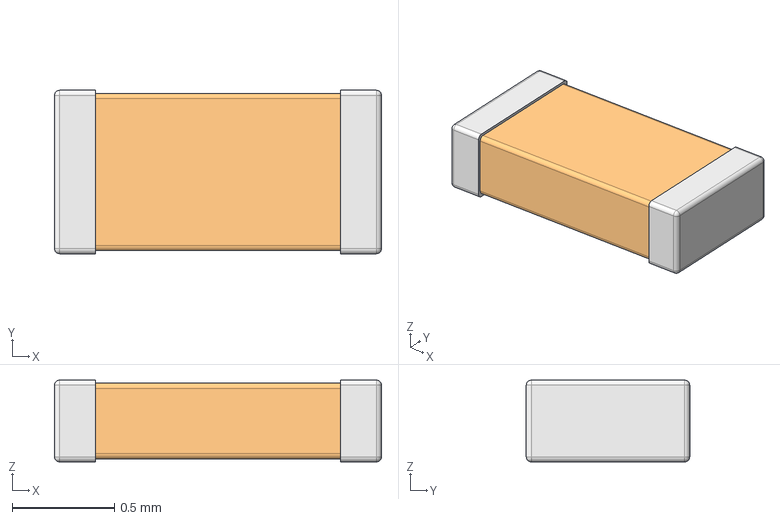
[picture p207: CAD file, 2020-12-17]
CADModels/RC components/C0603_040.step
1.60 x 0.8 x 0.4 mm
