binphilxiao/AxisLabs/CADModels/Chips/SOIC16 narrow.stp

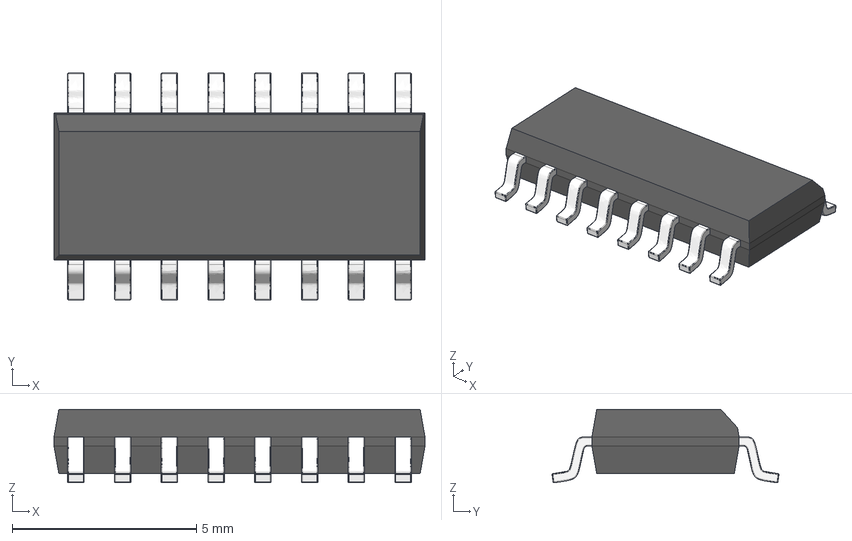
[picture p208: CAD file, 2021-04-16]
CADModels/Chips/SOIC16 narrow.stp
10.1 x 6.16 x 2.00 mm
