binphilxiao/AxisLabs/CADModels/RC components/C0402_020.step

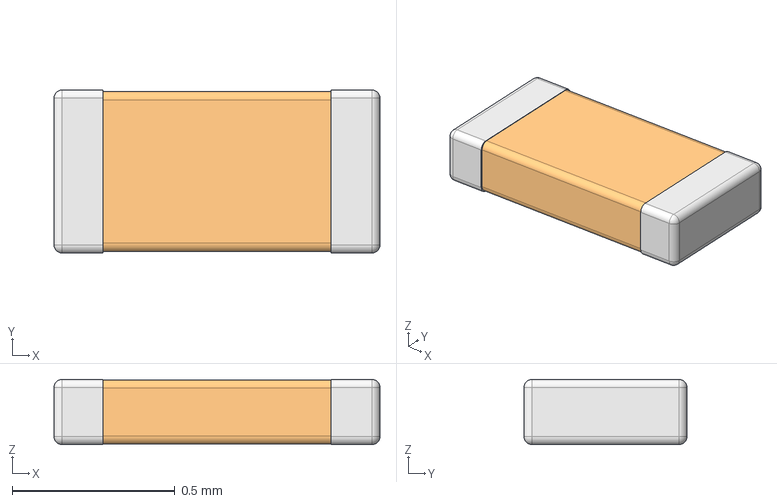
[picture p209: CAD file, 2020-12-17]
CADModels/RC components/C0402_020.step
1.00 x 0.5 x 0.2 mm
