binphilxiao/AxisLabs/CADModels/Chips/SOIC14 narrow.stp

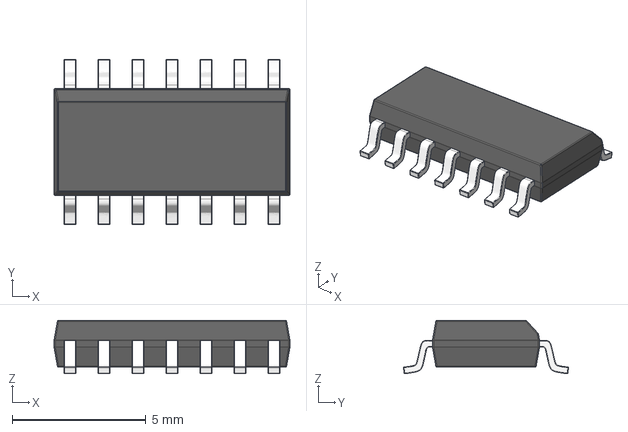
[picture p210: CAD file, 2021-04-16]
CADModels/Chips/SOIC14 narrow.stp
8.81 x 6.16 x 2.00 mm
