binphilxiao/AxisLabs/CADModels/Connectors/BM02B-PASS-1-TFT_LF_SN_eec.STEP

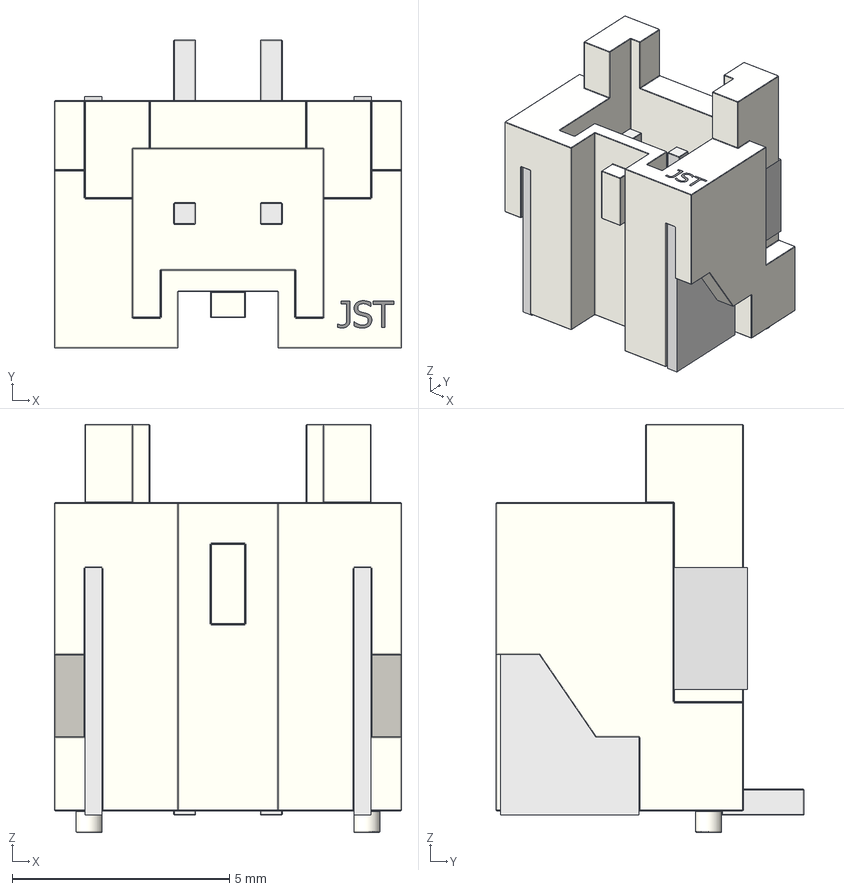
[picture p211: CAD file, 2022-11-22]
CADModels/Connectors/BM02B-PASS-1-TFT_LF_SN_eec.STEP
8.00 x 7.10 x 9.40 mm
JST
