binphilxiao/AxisLabs/CADModels/RC components/C1206_115.step

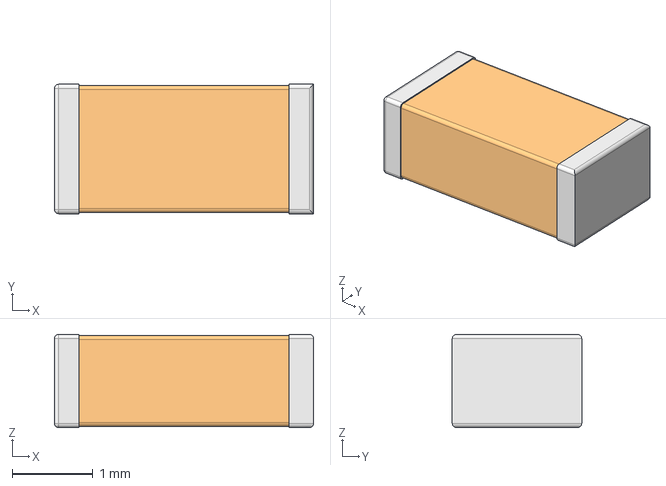
[picture p212: CAD file, 2020-12-17]
CADModels/RC components/C1206_115.step
3.20 x 1.60 x 1.15 mm
