binphilxiao/AxisLabs/(list of files, cad)

Other CAD files:
GR0102/Drawing/GearV2MainRevBShield/GearV2MainRevBShield.DWG
GR0101/052357-9/CAD/SGM25PCB(H15019).dwg
CADModels/Connectors/T1M-02-GF-S-RA-TR.stl
CADModels/FET&Diode/TO-92 flat Straight Standard Leads.stp
CADModels/RC components/rsmd-0201_l0-6_w0-3_h0-23.stp
CADModels/Connectors/LB1090-G10-B0R (mec1)- 无三角型.stp
CADModels/FET&Diode/SOT23-5.step
CADModels/RC components/rsmd-1206_l3-2_w1-6_h0-6.stp
CADModels/Chips/W971GG6KB.step
CADModels/Chips/WBGA-84.step
Button/140525-SBv2Assy PCB-battery-clip-check-rev-1.DXF
Button/140525-SBv2Assy PCB-battery-clip-check-rev-1.DXF.STEP
CADModels/Chips/BQ25713BRSNR.stp
CADModels/Chips/BQ7791500PWT.STEP
CADModels/Chips/MSP430FR2311IPW16.STEP
CADModels/Chips/NCV8170AXV330T2G.STEP
CADModels/Chips/NRF52840-QIAA-R.STEP
CADModels/Chips/SOIC-4.skp
CADModels/Chips/SOIC08 narrow.stp
CADModels/Chips/SOIC10 narrow.stp
CADModels/Chips/TPS62152AQRGTRQ1.STEP
CADModels/Chips/TPS631010YBGR.STEP
CADModels/Connectors/10-Pin Shrouded Header (IDC) Straight.stp
CADModels/Connectors/10118194-0001LF.STEP
CADModels/Connectors/10129378-902003BLF.STEP
CADModels/Connectors/10147606-2p.stp
CADModels/Connectors/103670-2-t-3d.stp
CADModels/Connectors/12-Pin Shrouded Header (IDC) Straight.stp
CADModels/Connectors/14-Pin Shrouded Header (IDC) Straight.stp
CADModels/Connectors/16-Pin Shrouded Header (IDC) Straight.stp
CADModels/Connectors/18-Pin Shrouded Header (IDC) Straight.stp
CADModels/Connectors/1824440000.stp
CADModels/Connectors/2-644803-2-g-3d.stp
CADModels/Connectors/2-644803-3.stp
CADModels/Connectors/2-644803-4.stp
CADModels/Connectors/2-644803-5-g-3d.stp
CADModels/Connectors/20-Pin Shrouded Header (IDC) Straight.stp
CADModels/Connectors/22-Pin Shrouded Header (IDC) Straight.stp
CADModels/Connectors/24-Pin Shrouded Header (IDC) Straight.stp
CADModels/Connectors/26-Pin Shrouded Header (IDC) Straight.stp
CADModels/Connectors/28-Pin Shrouded Header (IDC) Straight.stp
CADModels/Connectors/282834-2.stp
CADModels/Connectors/30-Pin Shrouded Header (IDC) Straight.stp
CADModels/Connectors/32-Pin Shrouded Header (IDC) Straight.stp
CADModels/Connectors/34-Pin Shrouded Header (IDC) Straight.stp
CADModels/Connectors/36-Pin Shrouded Header (IDC) Straight.stp
CADModels/Connectors/40-Pin Shrouded Header (IDC) Straight.stp
CADModels/Connectors/44-Pin Shrouded Header (IDC) Straight.stp
CADModels/Connectors/48-Pin Shrouded Header (IDC) Straight.stp
CADModels/Connectors/50-Pin Shrouded Header (IDC) Straight.stp
CADModels/Connectors/5025840270.stp
CADModels/Connectors/5055670281.stp
CADModels/Connectors/56-Pin Shrouded Header (IDC) Straight.stp
CADModels/Connectors/6-Pin Shrouded Header (IDC) Straight.stp
CADModels/Connectors/60-Pin Shrouded Header (IDC) Straight.stp
CADModels/Connectors/64-Pin Shrouded Header (IDC) Straight.stp
CADModels/Connectors/66-Pin Shrouded Header (IDC) Straight.stp
CADModels/Connectors/665304124022_Download_STP_665304124022_rev1.stp
CADModels/Connectors/68-Pin Shrouded Header (IDC) Straight.stp
CADModels/Connectors/70-Pin Shrouded Header (IDC) Straight.stp
CADModels/Connectors/705530002.stp
CADModels/Connectors/705530004.stp
CADModels/Connectors/72-Pin Shrouded Header (IDC) Straight.stp
CADModels/Connectors/76341-305LF.stp
CADModels/Connectors/8-Pin Shrouded Header (IDC) Straight.stp
CADModels/Connectors/877590614.stp
CADModels/Connectors/BM02B-PASS-TFT_LF__SN_.stp
CADModels/Connectors/BM04B-SRSS-TB-LF--SN---3DModel-STEP-56544.STEP
CADModels/Connectors/BM05B-ADHKS-GAN-ETB(HF).STEP
CADModels/Connectors/BM05B-PASS-TFT_LF_SN_eec.STEP
CADModels/Connectors/BP274601-03127T0A.STEP
CADModels/Connectors/CF50051D0R0-05-NH.STEP
CADModels/Connectors/CFE Pogo Pin Asembly.STEP
CADModels/Connectors/CONMHF1-SMD-G-T.STEP
CADModels/Connectors/DW-05-07-T-S-240.stp
CADModels/Connectors/EBC05DRXN.STEP
CADModels/Connectors/EBC05DRXN.stl
CADModels/Connectors/HLW10S-2C7LF.STEP
CADModels/Connectors/IDC10X2_2.54_TH_RA.igs
CADModels/Connectors/IDC5X2_2.54_TH_RA.igs
CADModels/Connectors/IDC7X2_2.54_TH_RA.stp
CADModels/Connectors/MEM2061-01-188-00-A.stp
CADModels/Connectors/N3432-5302RB.STEP
CADModels/Connectors/PH1RB-02-UA.STEP
CADModels/Connectors/PJ-002A.STEP
CADModels/Connectors/Pin Header 1x1 TH Pitch 2.54mm.stp
CADModels/Connectors/Pin Header 1x10 TH Pitch 2.54mm.stp
CADModels/Connectors/Pin Header 1x11 TH Pitch 2.54mm.stp
CADModels/Connectors/Pin Header 1x12 TH Pitch 2.54mm.stp
CADModels/Connectors/Pin Header 1x13 TH Pitch 2.54mm.stp
CADModels/Connectors/Pin Header 1x14 TH Pitch 2.54mm.stp
CADModels/Connectors/Pin Header 1x15 TH Pitch 2.54mm.stp
CADModels/Connectors/Pin Header 1x16 TH Pitch 2.54mm.stp
CADModels/Connectors/Pin Header 1x2 TH Pitch 2.54mm.stp
CADModels/Connectors/Pin Header 1x3 TH Pitch 2.54mm.stp
CADModels/Connectors/Pin Header 1x4 TH Pitch 2.54mm.stp
CADModels/Connectors/Pin Header 1x5 TH Pitch 2.54mm.stp
CADModels/Connectors/Pin Header 1x6 TH Pitch 2.54mm.stp
CADModels/Connectors/Pin Header 1x7 TH Pitch 2.54mm.stp
CADModels/Connectors/Pin Header 1x8 TH Pitch 2.54mm.stp
CADModels/Connectors/Pin Header 1x9 TH Pitch 2.54mm.stp
CADModels/Connectors/RB1-125BAG1A.STEP
CADModels/Connectors/S4B-PH-SM4-TB_LF__SN_.stp
CADModels/Connectors/SD SLOT.STEP
CADModels/Connectors/SIP-2.STEP
CADModels/Connectors/SJ-3523-SMT-TR.STEP
CADModels/Connectors/SM02B-PASS-TBT-LF--SN.STEP
CADModels/Connectors/SM02B-SRSS-TB-LF--SN---3DModel-STEP-56544.STEP
CADModels/Connectors/SM04B-ZESS-TB-LF--SN.STEP
CADModels/Connectors/SM05B-PASS-TBT_LF__SN_.stp
CADModels/Connectors/SM06B-PASS-TBT_LF_SN.STEP
CADModels/Connectors/TC2030-IDC.STEP
CADModels/Connectors/USB-A SM RA.stp
CADModels/Connectors/USB-A1SSW6.STEP
CADModels/Connectors/c-5499786-9-b-3d.stp
CADModels/Connectors/mill-max-854-22-003-40-001101.STEP
CADModels/Connectors/zl201-17_p2-54_l43-2_w2-54_h8-9.stp
CADModels/Connectors/zl201-18_p2-54_l45-7_w2-54_h8-9.stp
CADModels/Connectors/zl201-19_p2-54_l48-3_w2-54_h8-9.stp
CADModels/Connectors/zl201-20_p2-54_l50-8_w2-54_h8-9.stp
CADModels/FET&Diode/SMA.iges
CADModels/FET&Diode/SMB.iges
CADModels/FET&Diode/SMC.iges
CADModels/Nuts/9774040360R.stp
CADModels/RC components/C0201_020.step
CADModels/RC components/C0201_035.step
CADModels/RC components/C0201_045.step
CADModels/RC components/C0402_035.step
CADModels/RC components/C0402_045.step
CADModels/RC components/C0402_055.step
CADModels/RC components/C0402_065.step
CADModels/RC components/C0603_060.step
CADModels/RC components/C0603_080.step
CADModels/RC components/C0805_060.step
CADModels/RC components/C0805_085.step
CADModels/RC components/C0805_125.step
CADModels/RC components/C0805_135.step
CADModels/RC components/C1206_060.step
CADModels/RC components/C1206_085.step
CADModels/RC components/C1206_090.step
CADModels/RC components/C1206_120.step
CADModels/RC components/C1206_145.step
CADModels/RC components/C1206_150.step
CADModels/RC components/C1206_180.step
CADModels/RC components/C1210_090.step
CADModels/RC components/C1210_115.step
CADModels/RC components/C1210_140.step
CADModels/RC components/C1210_170.step
CADModels/RC components/C1210_210.step
CADModels/RC components/C1210_220.step
CADModels/RC components/C1210_260.step
CADModels/RC components/C1210_270.step
CADModels/RC components/CAT16-F4, -J4.SLDPRT
CADModels/RC components/res_0805.stp
CADModels/RC components/res_1210.stp
CADModels/RC components/res_2010.stp
CADModels/RC components/res_2512.stp
GB0102/Drawing/BatteryPackRevDShield/BatteryPackRevDShield.DWG
RC0101&DC0101/Docs/230209-RemoteController-Rev01.STEP
RC0101&DC0101/Docs/231107-PCB.STEP
