binphilxiao/AxisLabs/GR0102/Certification/Doc provided/SmartShade Manual.md

# How to use a SmartShade

### Download RYSE app on cell phone(Android or IOS)

- #### Launch App Store or google store.

- #### Download RYSE app

### Add a SmartShade

- #### Go to main menu in the app.

- #### Power up the SmartShade.

- #### Press “+” to add a SmartShade

- #### Follow the steps in the app.

- #### Do pairing and calibration as the app instructed
