binphilxiao/AxisLabs/NW0101/Docs/Programing Instructions/ProgramingWithGANG-M for BatchProgramming.md

#### 硬件连接：

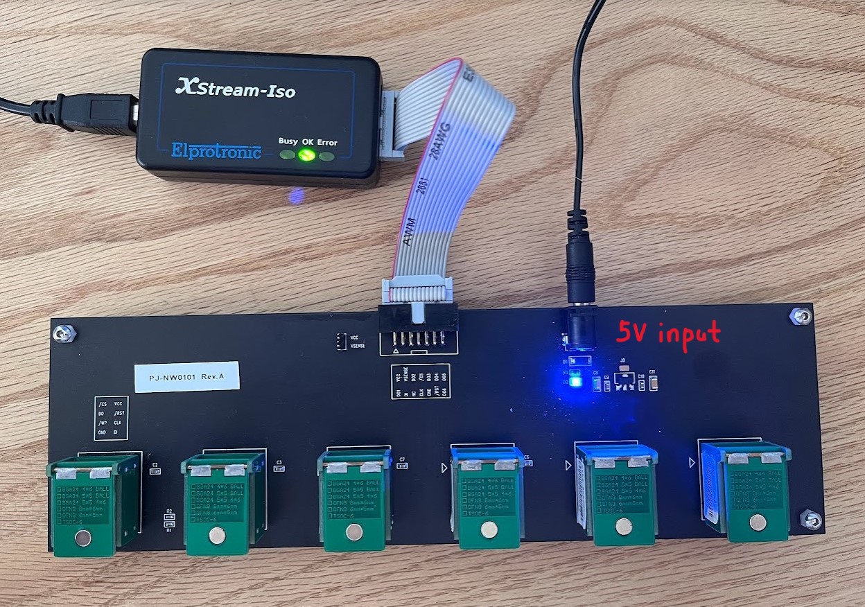
[picture p222: NW0101/Docs/Programing Instructions/img/hardware_batch programming.jpg]


#### 下载烧写软件：

https://content.elprotronic.ca/downloads/M-win.zip

#### 软件配置：

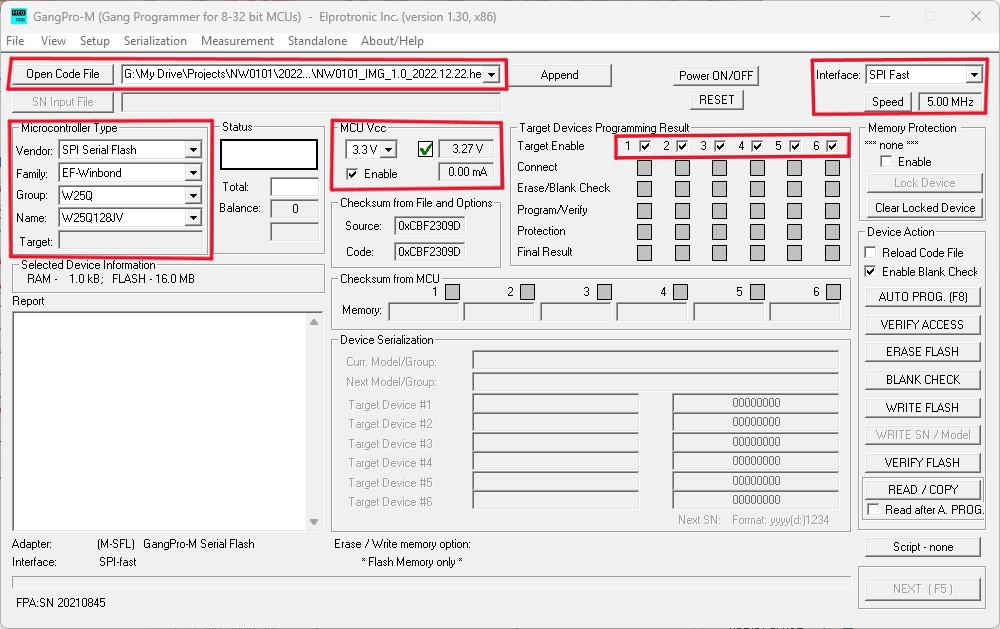
[picture p223: NW0101/Docs/Programing Instructions/img/3.jpg]


#### 烧写步骤：

1. 检查回读电压，应为3.3V.

3. 点击 'AUTO PROG' ，开始自动烧写.

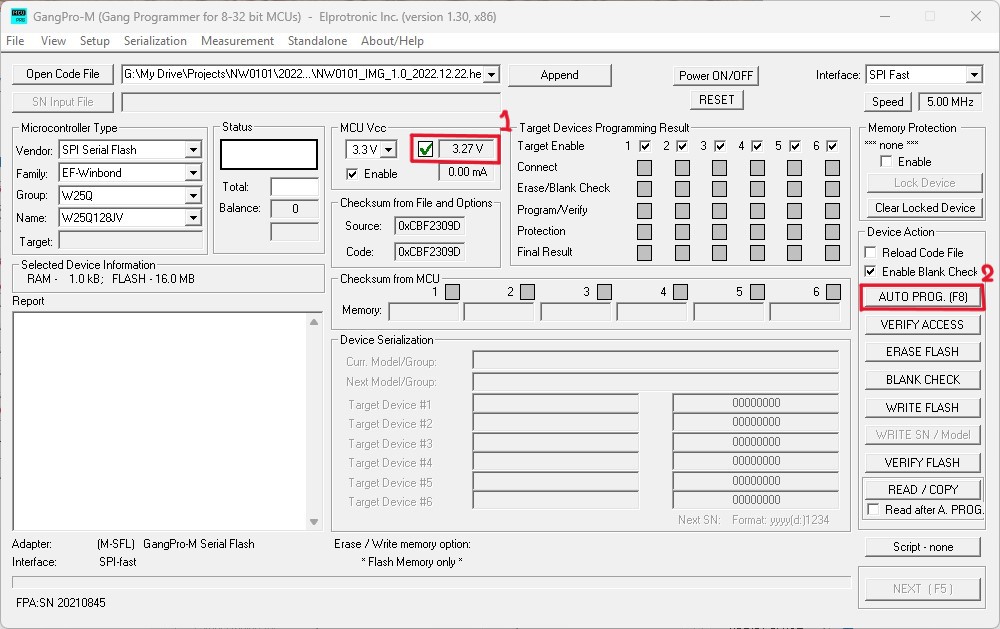
[picture p224: NW0101/Docs/Programing Instructions/img/4.jpg]
