binphilxiao/AxisLabs/NW0101/Docs/AntennaInsturction/AntennaHardwareInatallInstruction.md

#### How to connect patch antenna on PCBA-NW0101_Rev.C

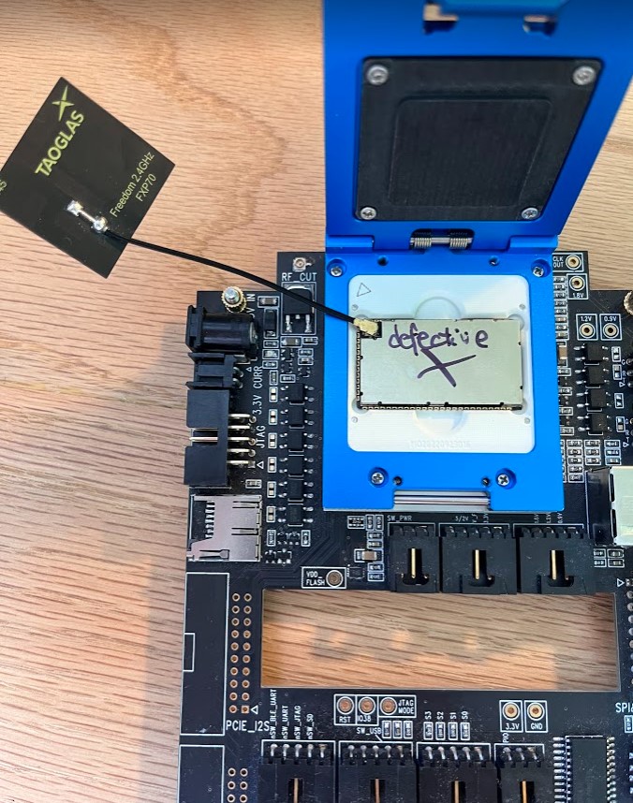
[picture p225: NW0101/Docs/AntennaInsturction/img/6.jpg]


#### How to connect patch antenna on PCBA-NW0101_Rev.C.1

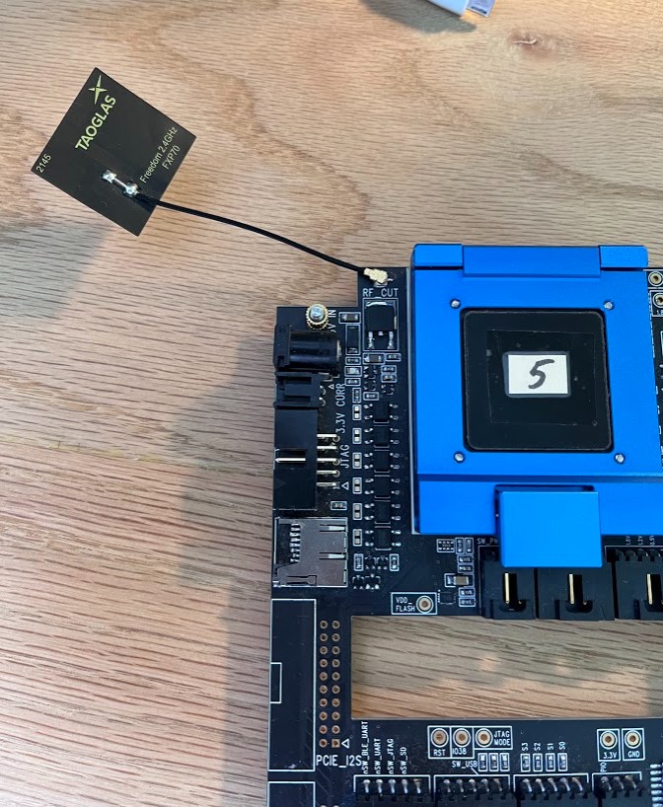
[picture p226: NW0101/Docs/AntennaInsturction/img/5.jpg]
