binphilxiao/AxisLabs/NW0101/Docs/Programing Instructions/ProgramingWithGANG-M.md

#### 硬件连接：

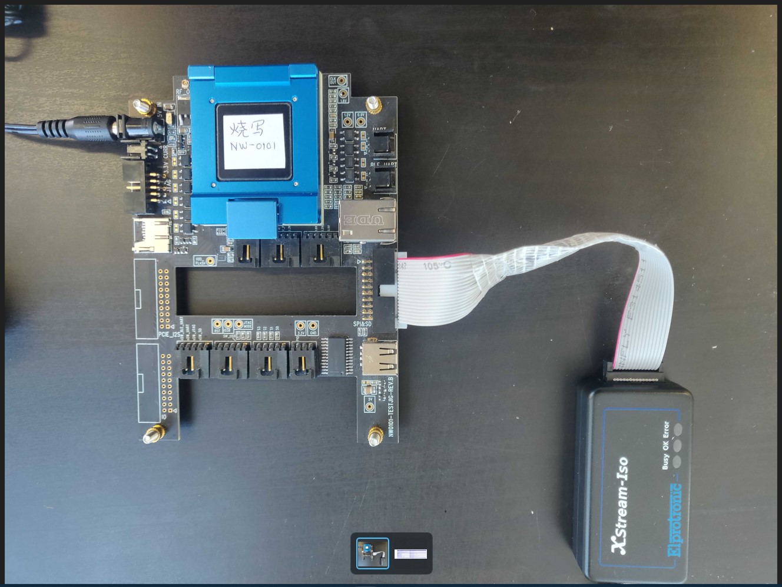
[picture p229: NW0101/Docs/Programing Instructions/img/hardware.jpg]


#### 下载烧写软件：

https://content.elprotronic.ca/downloads/M-win.zip

#### 软件配置：

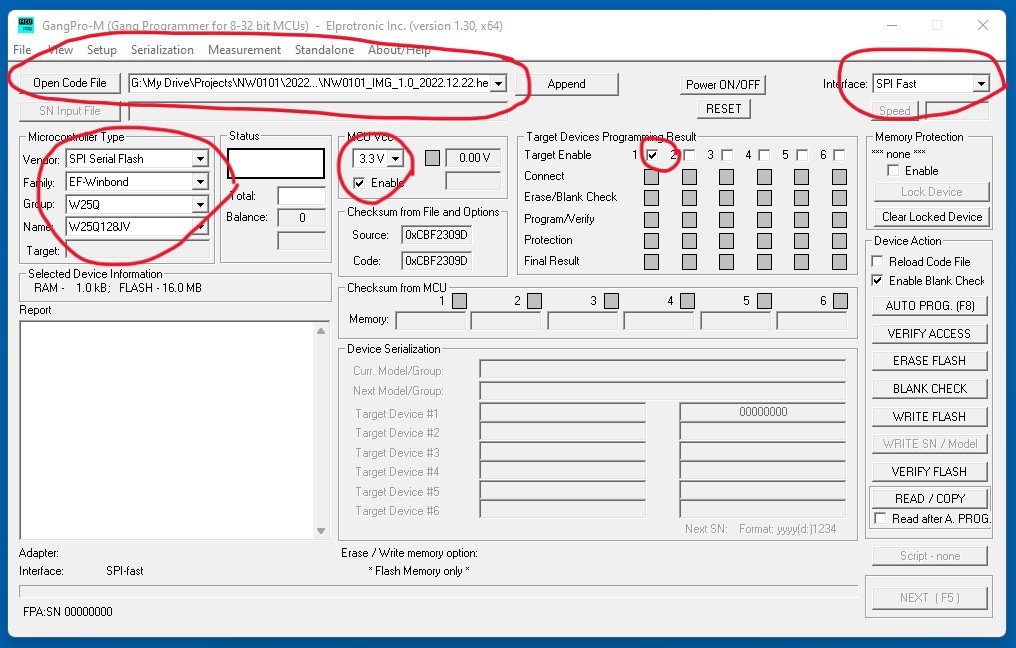
[picture p230: NW0101/Docs/Programing Instructions/img/1 (2).jpg]


#### 烧写步骤：

1. 点击 'Power ON/OFF' 按钮.

2. 检查回读电压，应为3.3V.

3. 点击 'AUTO PROG' ，开始自动烧写.

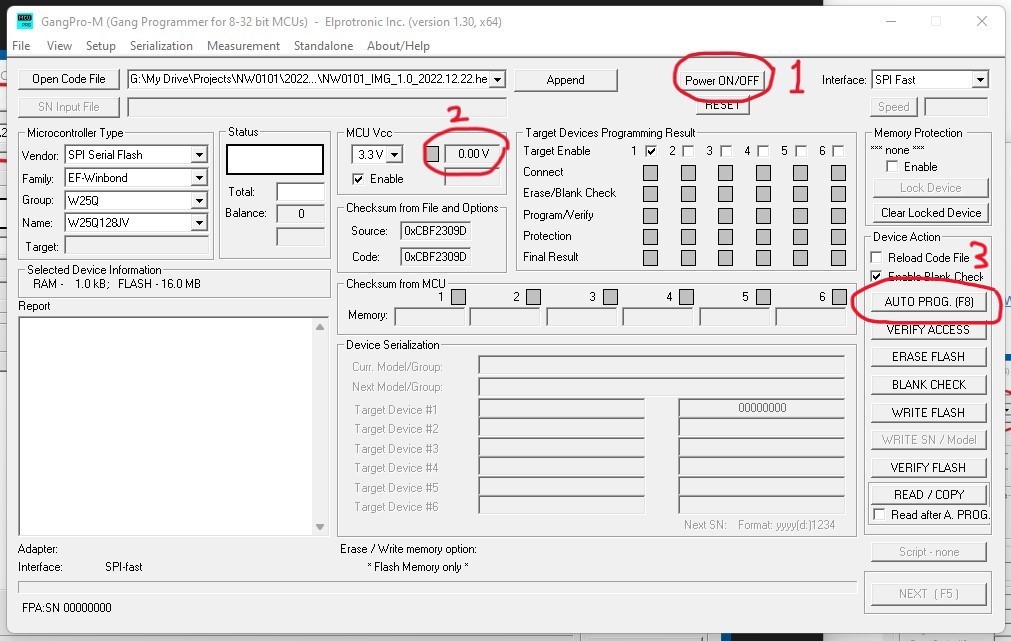
[picture p231: NW0101/Docs/Programing Instructions/img/2.jpg]
