binphilxiao/AxisLabs/NW0101/2022.05.18_Jlink/Doc/How to Make a J-LINK by Raspberry Pi 4B.docx

How to Make a J-LINK by Raspberry Pi Zero

1. Set up Raspberry Pi 4
  a. Download Raspberry Pi Imager from https://www.raspberrypi.com/software/
  b. Download the image from https://raspi.debian.net/daily/raspi_4_bullseye.img.xz
  c. Flash Debian TF card
  d. Edit /boot/config.txt and add ‘enable_uart=1’ and ‘gpu_freq=360 ’to the end of the file, and save.
  e. Login by user: root, no password
  f. apt-get update
  g. apt-get install net-tools
  h. apt-get install nano vim screen
  i. apt-get install openssh-server telnetd telnet
  j. Edit /etc/ssh/sshd_config

nano /etc/ssh/sshd_config

edit 'PermitRootLogin AUTH' to 'PermitRootLogin yes'

  k. service ssh restart
  l. apt-get install samba
  m. smbpasswd -a (def:123456)
  n. mkdir /home/shared
  o. nano /etc/samba/smb.conf

#add this to the very end of the file:

[shared]

path = /home/shared

valid users = root

read only = no

  p. service smbd restart
  q. testparm
  r. passwd root (def: 123456)
2. JTAG Pinout

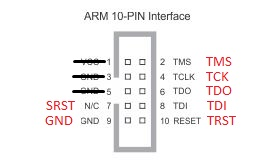
[picture p232: figure]
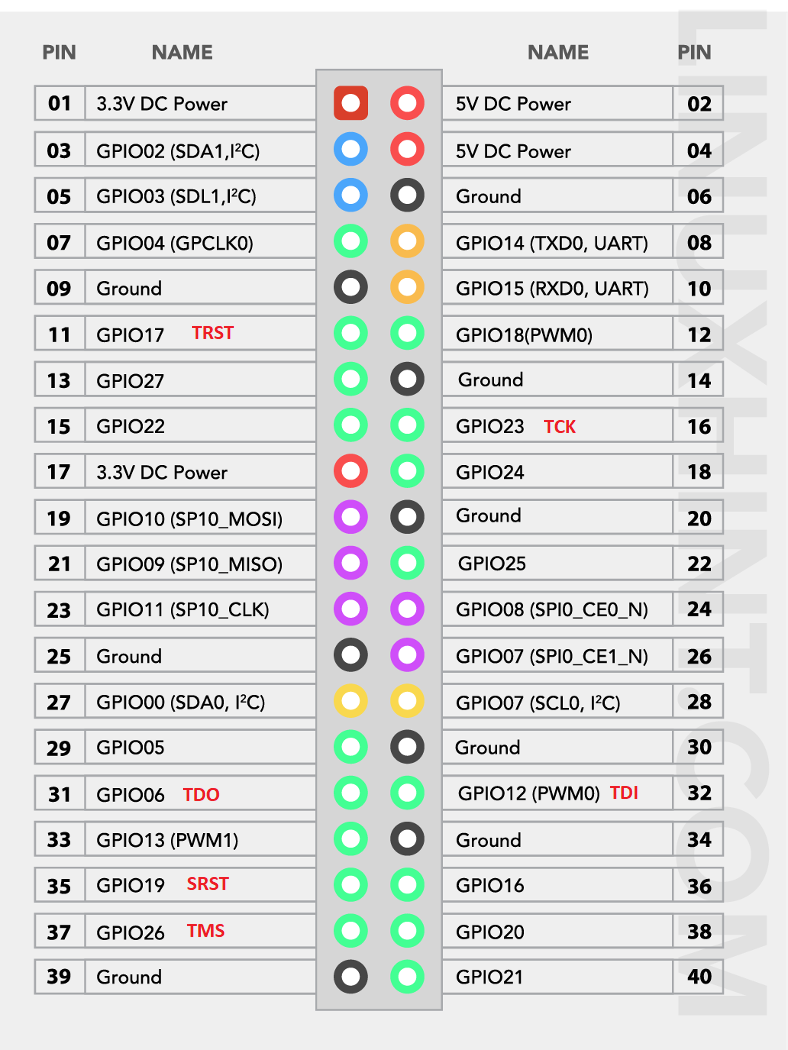
[picture p233: figure]

3. Install and config OpenOCD (Also see: https://neucrack.com/p/142)
  a. sudo apt-get update
  b. sudo apt-get install -y autoconf libtool libftdi-dev libusb-1.0-0 libusb-1.0-0-dev git
  c. sudo apt-get install gpiod libgpiod-dev build-essential pkg-config libtool
  d. git clone --recursive git://git.code.sf.net/p/openocd/code openocd-code
  e. cd openocd-code
  f. ./bootstrap
  g. ./configure --enable-sysfsgpio\

--enable-linuxgpiod \

--enable-maintainer-mode \

--disable-werror \

--enable-ft2232_libftdi \

--enable-ep93xx \

--enable-at91rm9200 \

--enable-usbprog \

--enable-presto_libftdi \

--enable-jlink \

--enable-vsllink \

--enable-rlink \

--enable-arm-jtag-ew \

--enable-dummy \

--enable-buspirate \

--enable-ulink \

--enable-presto_libftdi \

--enable-usb_blaster_libftdi \

--enable-ft2232_libftdi\

--prefix=/usr

--disable-dependency-tracking

  h. make
  i. make install
  j. git clone https://github.com/Neutree/MT7688-OpenOCD (download the cfg file from Angelic47)
  k. Edit jlink_gpio.cfg for JTAG I/Os

adapter driver linuxgpiod

transport select jtag

linuxgpiod gpiochip 0

linuxgpiod jtag_nums 23 26 12 3

linuxgpiod trst_num 17

linuxgpiod srst_num 19

adapter srst delay 100

jtag_ntrst_delay 100

reset_config trst_and_srst

  l. openocd -f jlink_gpio.cfg
  m. telnet localhost 4444
  n. load_image cc.mp4 0x88000000
4. Reference: GPIO commands example

gpiodetect # detect GPIO devices

gpioinfo 0 # check the configuration of GPIO device 0

gpioset 0 6=1 # set the GPIO line 6 of the gpio controller 0

gpioget 0 6 # get the GPIO line 6 of the gpio controller 0

gpiomon 0 6 # print out the behavior of GPIO line 6 of the gpio controller 0

5. Use Bus Priate to program SPI flash

apt-get install flashrom

flashrom -p buspirate_spi:dev=/dev/ttyUSB0,spispeed=8M -r /home/shared/MT7688-OpenOCD/backup.bin

flashrom -p buspirate_spi:dev=/dev/ttyUSB0,spispeed=8M -w /home/shared/MT7688-OpenOCD/O2S_entire_img.bin

flashrom -p buspirate_spi:dev=/dev/ttyACM0,spispeed=8M -r /home/shared/MT7688-OpenOCD/backup.bin

flashrom -p buspirate_spi:dev=/dev/ttyACM0,spispeed=8M -w /home/shared/MT7688-OpenOCD/O2S_entire_img.bin

6. Wiring of hardware

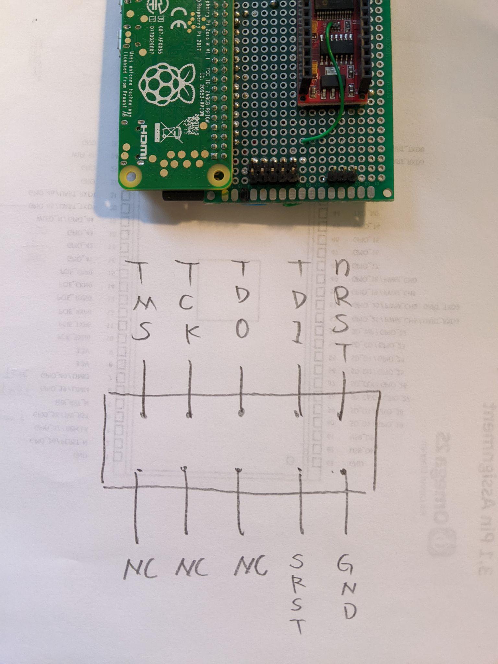
[picture p234: figure]
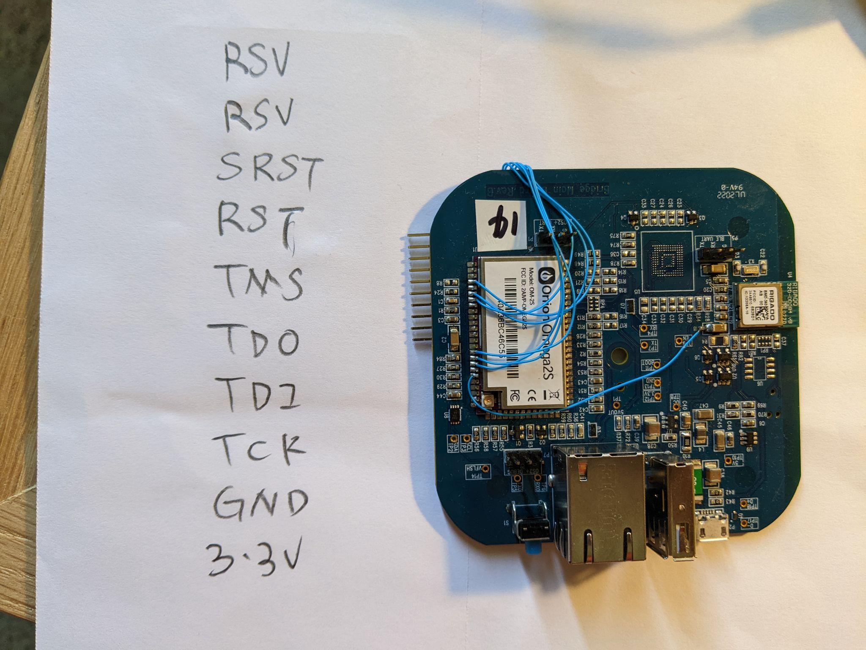
[picture p235: figure]
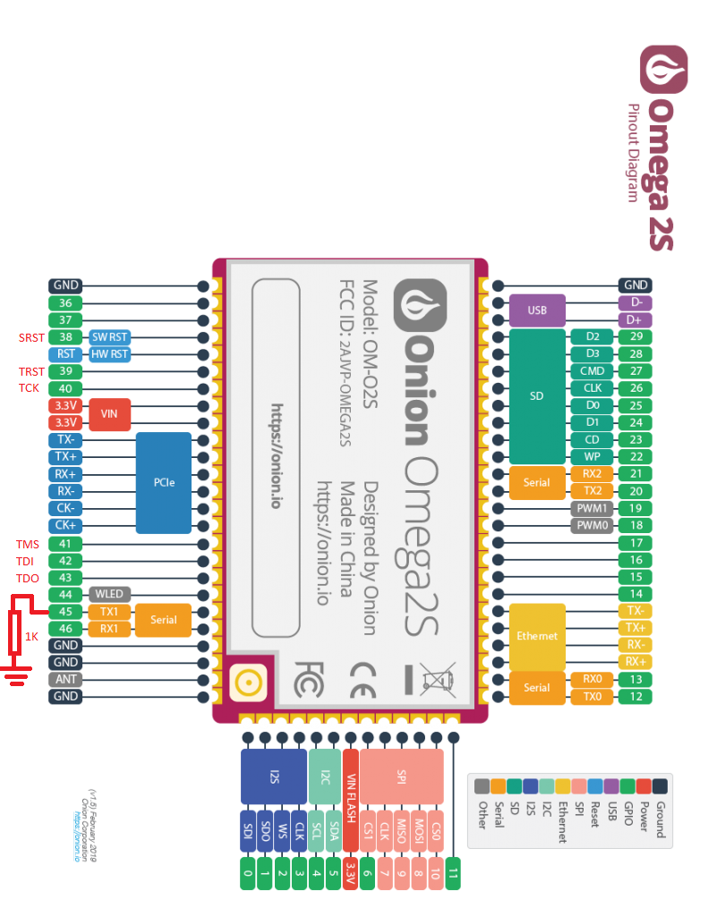
[picture p236: figure]

Signal Name | MT7688 Pin Name | O2S Pin Name
TDO | EPHY_LED0, 143
TDI | EPHY_LED1, 142
TMS | EPHY_LED2, 141
TCK | EPHY_LED3, 140
TRST | EPHY_LED4, 139

7. rsv
