binphilxiao/AxisLabs/NW0101/2022.05.18_Jlink/Doc/How to Make a J-LINK by Raspberry Pi Zero.docx

How to Make a J-LINK by Raspberry Pi Zero

1. Set up Raspberry Pi Zero
  a. Download Raspberry Pi Imager from https://www.raspberrypi.com/software/
  b. Flash Debian TF card
  c. Edit /boot/config.txt and add ‘enable_uart=1’ to the end of the file, and save.
  d. Login by user: pi, pass: raspberry
2. Set up ethernet extension board
  a. Connect a Raspberry Pi Zero to an ethernet extension board, pinout as below

Take an ethernet extension PCB from Amazon

(https://www.amazon.ca/gp/product/B087TD33KM/ref=ppx_yo_dt_b_asin_title_o00_s00?ie=UTF8&psc=1)

as example:

Signal name | Raspberry Pi Zero | Ethernet Extension
SCK | Pin 23(GPIO14) | Pin 16
MISO | Pin 21(GPIO13) | Pin 15
MOSI | Pin 19(GPIO12) | Pin 14
SS | Pin 24(GPIO10) | Pin 13
INT | Pin 22(GPIO6) | Pin 4 of ENC28J60 on PCB

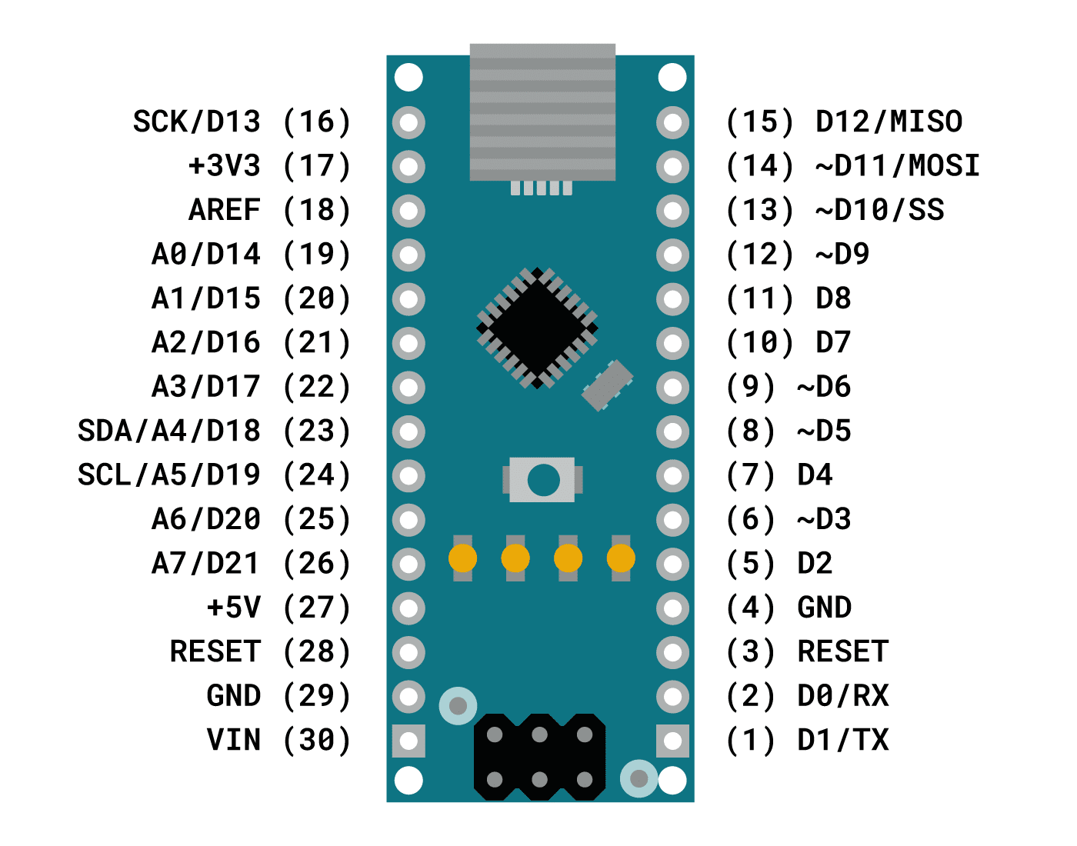
[picture p237: figure]
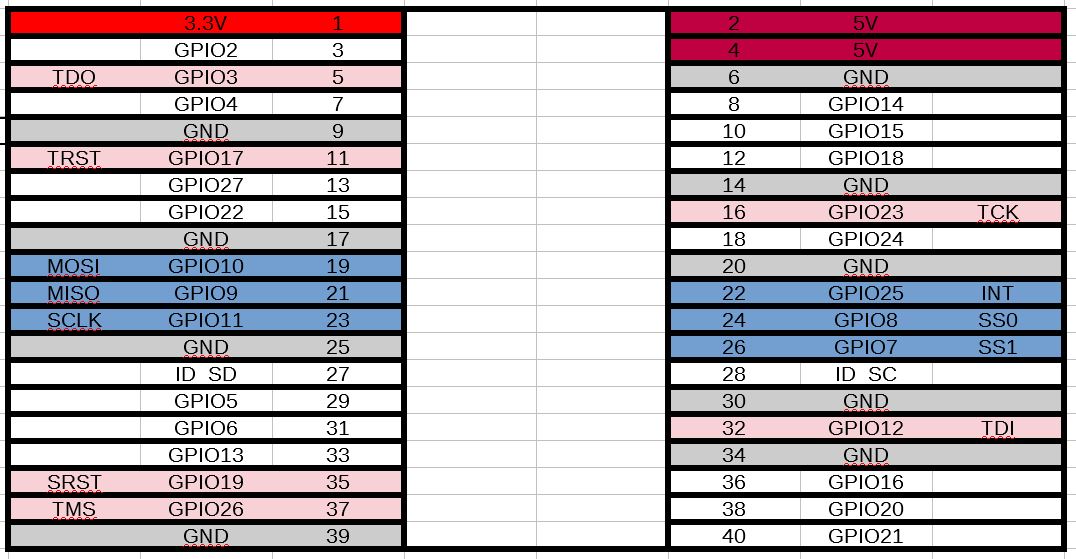
[picture p238: figure]

  b. Edit /boot/config.txt and add ‘dtoverlay=enc28j60’ to the end of the file, and save.
  c. Enable SPI as below:

#sudo raspi-config

Go to Interface options, enable SPI

  d. Assign a static IP

sudo nano /etc/dhcpcd.conf

Add:

interface eth0

static ip_address=192.168.1.142/24

static routers=192.168.2.1

static domain_name_servers=192.168.2.1

  e. Reboot
3. JTAG Pinout


4. Install and config OpenOCD (Also see: https://neucrack.com/p/142)
  a. sudo apt-get update
  b. sudo apt-get install -y autoconf libtool libftdi-dev libusb-1.0-0 libusb-1.0-0-dev git
  c. sudo apt-get install gpiod
  d. sudo apt-get install libgpiod-dev
  e. sudo apt-get install git
  f. git clone --recursive git://git.code.sf.net/p/openocd/code openocd-code
  g. cd openocd-code
  h. ./bootstrap

./configure --enable-sysfsgpio\

--enable-linuxgpiod \

--enable-maintainer-mode \

--disable-werror \

--enable-ft2232_libftdi \

--enable-ep93xx \

--enable-at91rm9200 \

--enable-usbprog \

--enable-presto_libftdi \

--enable-jlink \

--enable-vsllink \

--enable-rlink \

--enable-arm-jtag-ew \

--enable-dummy \

--enable-buspirate \

--enable-ulink \

--enable-presto_libftdi \

--enable-usb_blaster_libftdi \

--enable-ft2232_libftdi\

--prefix=/usr

  i. make
  j. sudo make install
  k. git clone https://github.com/Neutree/MT7688-OpenOCD (download the cfg file from Angelic47)
  l. Edit jlink_gpio.cfg for JTAG I/Os

adapter driver linuxgpiod

transport select jtag

# tck tms tdi tdo

linuxgpiod gpiochip 0

linuxgpiod jtag_nums 23 26 12 3

linuxgpiod trst_num 17

linuxgpiod srst_num 19

adapter srst delay 100

jtag_ntrst_delay 100

reset_config trst_and_srst

  m. Edit jlink_gpio.cfg as promoted after sudo openocd -f jlink_gpio.cfg
  n. sudo openocd -f jlink_gpio.cfg
  o. telnet localhost 4444
5. Check the availability of GPIOs

gpiodetect # detect GPIO devices

gpioinfo 0 # check the configuration of GPIO device 0

6. Install telnet

sudo apt-get install telnetd

7. Enable ssh
  a. Go into /boot
  b. sudo touch ssh
  c. Reboot
  d. sudo raspi-config
  e. Goto ‘interface options->ssh->enable it’
8. Telnet or ssh from another windows computer by PUTTY.
9. Sftp from another window computer by PSFTP
  a. lcd C:\Users\bin\Downloads
10. Rsv
11. Wiring of hardware


Signal Name | MT7688 Pin Name | O2S Pin Name
TDO | EPHY_LED0, 143
TDI | EPHY_LED1, 142
TMS | EPHY_LED2, 141
TCK | EPHY_LED3, 140
TRST | EPHY_LED4, 139

12. rsv
