binphilxiao/AxisLabs/NW0101/Docs/Programing Instructions/SPI flash烧写说明.pdf

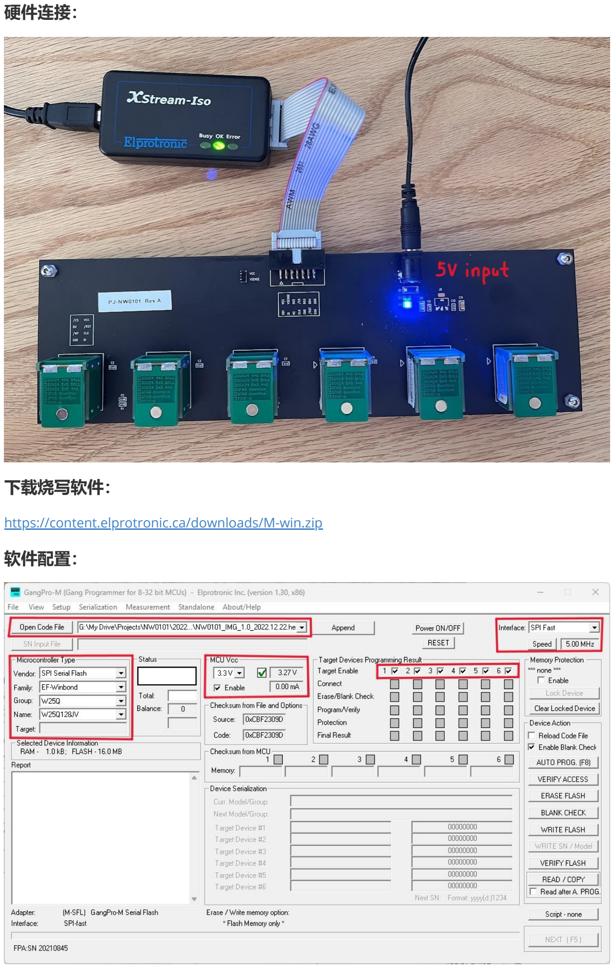
[picture p239: page 1]

### 硬件连接：

### 下载烧写软件：

https://content.elprotronic.ca/downloads/M-win.zip

### 软件配置：

### 烧写步骤：

1. 检查回读电压，应为3.3V.
2. 点击 'AUTO PROG' ，开始自动烧写.
