binphilxiao/AxisLabs/NW0101/Docs/AntennaInsturction/AntennaHardwareInatallInstruction.pdf

How to connect patch antenna on PCBA-NW0101_Rev.C


How to connect patch antenna on PCBA-NW0101_Rev.C.1
