binphilxiao/AxisLabs/NW0101/Docs/Certification/NW-0101_Test Instructions.pdf

# Connect UART to computer and WIFI antenna

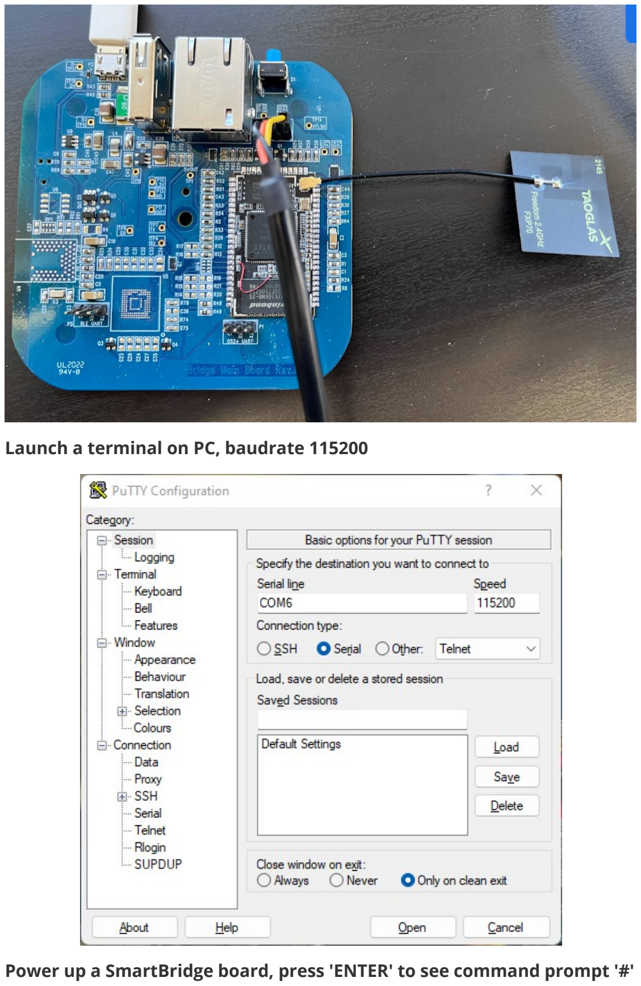
[picture p243: page 2]

# Launch a terminal on PC, baudrate 115200

# Power up a SmartBridge board, press 'ENTER' to see command prompt '#'


# Set default WIFI, Channel=7, TxPower=18, Mode=802.11g

# Set Channel

iwpriv ra0 set ATE=ATESTART
iwpriv ra0 set ATEDA=00:11:22:33:44:55 iwpriv ra0 set ATESA=00:aa:bb:cc:dd:ee iwpriv ra0 set ATEBSSID=00:11:22:33:44:55 iwpriv ra0 set ATETXMODE=1
iwpriv ra0 set ATETXMCS=0
iwpriv ra0 set ATETXBW=0
iwpriv ra0 set ATECHANNEL=7 iwpriv ra0 set ATETXGI=1
iwpriv ra0 set ATETXLEN=1500 iwpriv ra0 set ATETXANT=1
iwpriv ra0 set ATETXPOW0=18 iwpriv ra0 set ATETXCNT=100000 iwpriv ra0 set ATETXFREQOFFSET=10 iwpriv ra0 set ATE=TXFRAME
iwpriv ra0 set ATECHANNEL=7 | # Channel 1-11

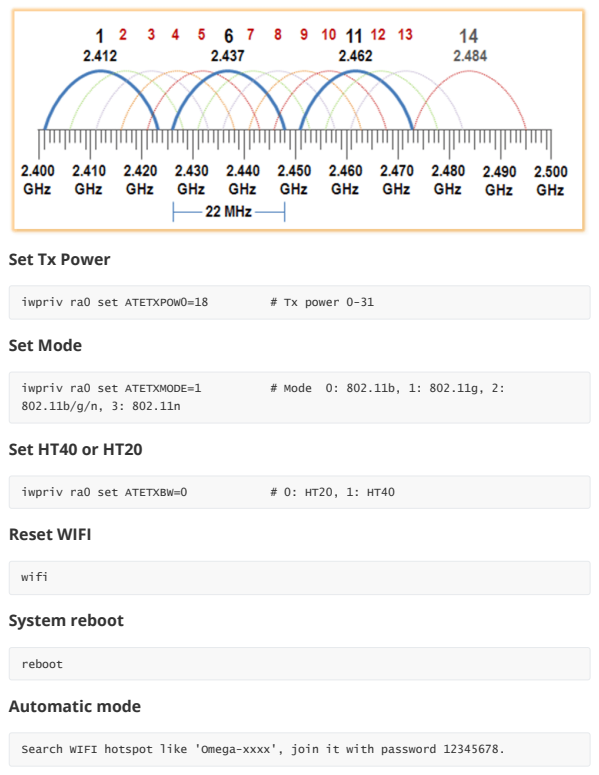
[picture p244: page 4]
Set Mode; Set HT40 or HT20; Reset WIFI; System reboot; Automatic mode; iwpriv ra0 set ATETXPOW0=18; # Tx power 0-31; iwpriv ra0 set ATETXMODE=1; # Mode; iwpriv ra0 set ATETXBW=0; wifi; reboot

Set Tx Power

Search WIFI hotspot like 'Omega-xxxx', join it with password 12345678.

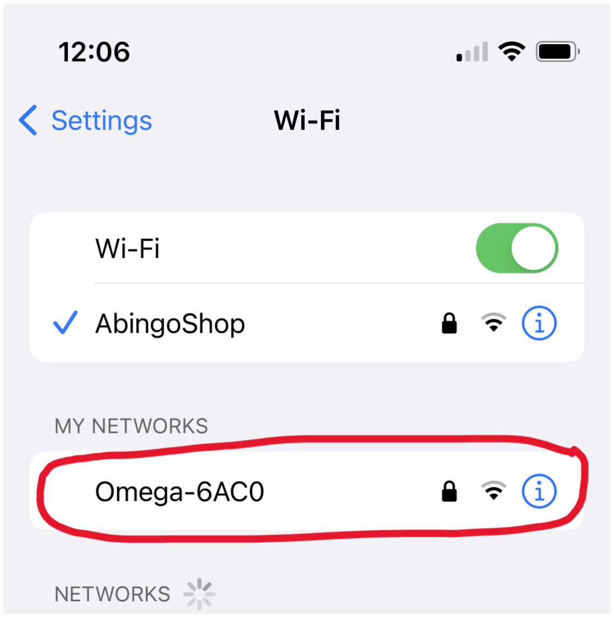
[picture p245: figure]

# Ping test samples by cell phone, laptop or other devices

# On Windows PC

ping -t -l 4096 192.168.3.1
# On linux PC

ping -s 4096 -f 192.168.2.1
# On cell phone, download a App that can do 'ping'
