binphilxiao/AxisLabs/NW0101/2022.05.18_Jlink/Doc/OpenOCD User's Guide.pdf

# Open On-Chip Debugger:

# OpenOCD User’s Guide

for release 0.11.0+dev
13 December 2021

This User’s Guide documents release 0.11.0+dev, dated 13 December 2021, of the Open On-Chip Debugger (OpenOCD).
- Copyright
c 2008 The OpenOCD Project
- Copyright
c 2007-2008 Spencer Oliver spen@spen-soft.co.uk
- Copyright
c 2008-2010 Oyvind Harboe oyvind.harboe@zylin.com
- Copyright
c 2008 Duane Ellis openocd@duaneellis.com
- Copyright
c 2009-2010 David Brownell

Permission is granted to copy, distribute and/or modify this document under the terms of the GNU Free Documentation License, Version 1.2 or any later version published by the Free Software Foundation; with no Invariant Sections, no Front-Cover Texts, and no Back-Cover Texts. A copy of the license is included in the section entitled “GNU Free Documentation License”.

i

## Short Contents

ii

## Table of Contents

iii

iv

10.8 DAP declaration (ARMv6-M, ARMv7 and ARMv8 targets). . . 66

v

16.6.3 ARM CoreSight TPIU and SWO specific commands . . . . 143

vi

vii

## Appendix A The GNU Free

1

## About

OpenOCD was created by Dominic Rath as part of a 2005 diploma thesis written at the University of Applied Sciences Augsburg (http://www.hs-augsburg.de). Since that time, the project has grown into an active open-source project, supported by a diverse community of software and hardware developers from around the world.

## What is OpenOCD?

The Open On-Chip Debugger (OpenOCD) aims to provide debugging, in-system programming and boundary-scan testing for embedded target devices.
It does so with the assistance of a debug adapter, which is a small hardware module which helps provide the right kind of electrical signaling to the target being debugged. These are required since the debug host (on which OpenOCD runs) won’t usually have native support for such signaling, or the connector needed to hook up to the target.
Such debug adapters support one or more transport protocols, each of which involves different electrical signaling (and uses different messaging protocols on top of that signaling). There are many types of debug adapter, and little uniformity in what they are called. (There are also product naming differences.)
These adapters are sometimes packaged as discrete dongles, which may generically be called hardware interface dongles. Some development boards also integrate them directly, which may let the development board connect directly to the debug host over USB (and sometimes also to power it over USB).
For example, a JTAG Adapter supports JTAG signaling, and is used to communicate with JTAG (IEEE 1149.1) compliant TAPs on your target board. A TAP is a “Test Access Port”, a module which processes special instructions and data. TAPs are daisy-chained within and between chips and boards. JTAG supports debugging and boundary scan operations. There are also SWD Adapters that support Serial Wire Debug (SWD) signaling to communicate with some newer ARM cores, as well as debug adapters which support both JTAG and SWD transports. SWD supports only debugging, whereas JTAG also supports boundary scan operations.
For some chips, there are also Programming Adapters supporting special transports used only to write code to flash memory, without support for on-chip debugging or boundary scan. (At this writing, OpenOCD does not support such non-debug adapters.)
Dongles: OpenOCD currently supports many types of hardware dongles: USB-based, parallel port-based, and other standalone boxes that run OpenOCD internally. See Chapter 2 [Debug Adapter Hardware], page 5.
GDB Debug: It allows ARM7 (ARM7TDMI and ARM720t), ARM9 (ARM920T, ARM922T, ARM926EJ–S, ARM966E–S), XScale (PXA25x, IXP42x), Cortex-M3 (Stellaris LM3, STMicroelectronics STM32 and Energy Micro EFM32) and Intel Quark (x10xx) based cores to be debugged via the GDB protocol.
Flash Programming: Flash writing is supported for external CFI-compatible NOR flashes (Intel and AMD/Spansion command set) and several internal flashes (LPC1700, LPC1800, LPC2000, LPC4300, AT91SAM7, AT91SAM3U, STR7x, STR9x, LM3, STM32x and EFM32). Preliminary support for various NAND flash controllers (LPC3180, Orion, S3C24xx, more) is included.

About | 2

## OpenOCD Web Site

The OpenOCD web site provides the latest public news from the community:

http://openocd.org/

## Latest User’s Guide:

The user’s guide you are now reading may not be the latest one available. A version for more recent code may be available. Its HTML form is published regularly at:

http://openocd.org/doc/html/index.html
PDF form is likewise published at:

http://openocd.org/doc/pdf/openocd.pdf

## OpenOCD User’s Forum

There is an OpenOCD forum (phpBB) hosted by SparkFun, which might be helpful to you. Note that if you want anything to come to the attention of developers, you should post it to the OpenOCD Developer Mailing List instead of this forum.

http://forum.sparkfun.com/viewforum.php?f=18

## OpenOCD User’s Mailing List

The OpenOCD User Mailing List provides the primary means of communication between users:

https://lists.sourceforge.net/mailman/listinfo/openocd-user

## OpenOCD IRC

Support can also be found on irc: irc://irc.libera.chat/openocd

3

## 1 OpenOCD Developer Resources

If you are interested in improving the state of OpenOCD’s debugging and testing support, new contributions will be welcome. Motivated developers can produce new target, flash or interface drivers, improve the documentation, as well as more conventional bug fixes and enhancements.
The resources in this chapter are available for developers wishing to explore or expand the OpenOCD source code.

## 1.1 OpenOCD Git Repository

During the 0.3.x release cycle, OpenOCD switched from Subversion to a Git repository hosted at SourceForge. The repository URL is:

git://git.code.sf.net/p/openocd/code
or via http

http://git.code.sf.net/p/openocd/code
You may prefer to use a mirror and the HTTP protocol:

http://repo.or.cz/r/openocd.git
With standard Git tools, use git clone to initialize a local repository, and git pull to update it. There are also gitweb pages letting you browse the repository with a web browser, or download arbitrary snapshots without needing a Git client:

http://repo.or.cz/w/openocd.git
The README file contains the instructions for building the project from the repository or a snapshot.
Developers that want to contribute patches to the OpenOCD system are strongly encouraged to work against mainline. Patches created against older versions may require additional work from their submitter in order to be updated for newer releases.

## 1.2 Doxygen Developer Manual

During the 0.2.x release cycle, the OpenOCD project began providing a Doxygen reference manual. This document contains more technical information about the software internals, development processes, and similar documentation:

http://openocd.org/doc/doxygen/html/index.html
This document is a work-in-progress, but contributions would be welcome to fill in the gaps. All of the source files are provided in-tree, listed in the Doxyfile configuration at the top of the source tree.

## 1.3 Gerrit Review System

All changes in the OpenOCD Git repository go through the web-based Gerrit Code Review System:

https://review.openocd.org/
After a one-time registration and repository setup, anyone can push commits from their local Git repository directly into Gerrit. All users and developers are encouraged to review,

Chapter 1: OpenOCD Developer Resources | 4

test, discuss and vote for changes in Gerrit. The feedback provides the basis for a maintainer to eventually submit the change to the main Git repository.
The HACKING file, also available as the Patch Guide in the Doxygen Developer Manual, contains basic information about how to connect a repository to Gerrit, prepare and push patches. Patch authors are expected to maintain their changes while they’re in Gerrit, respond to feedback and if necessary rework and push improved versions of the change.

## 1.4 OpenOCD Developer Mailing List

The OpenOCD Developer Mailing List provides the primary means of communication between developers:

https://lists.sourceforge.net/mailman/listinfo/openocd-devel

## 1.5 OpenOCD Bug Tracker

The OpenOCD Bug Tracker is hosted on SourceForge:

http://bugs.openocd.org/

5

## 2 Debug Adapter Hardware

Defined: dongle: A small device that plugs into a computer and serves as an adapter .... [snip]
In the OpenOCD case, this generally refers to a small adapter that attaches to your computer via USB or the parallel port.

## 2.1 Choosing a Dongle

There are several things you should keep in mind when choosing a dongle.
1. Transport Does it support the kind of communication that you need? OpenOCD focuses mostly on JTAG. Your version may also support other ways to communicate with target devices.
2. Voltage What voltage is your target - 1.8, 2.8, 3.3, or 5V? Does your dongle support it? You might need a level converter.
3. Pinout What pinout does your target board use? Does your dongle support it? You may be able to use jumper wires, or an "octopus" connector, to convert pinouts.
4. Connection Does your computer have the USB, parallel, or Ethernet port needed?
5. RTCK Do you expect to use it with ARM chips and boards with RTCK support (also known as “adaptive clocking”)?

## 2.2 USB FT2232 Based

There are many USB JTAG dongles on the market, many of them based on a chip from “Future Technology Devices International” (FTDI) known as the FTDI FT2232; this is a USB full speed (12 Mbps) chip. See: http://www.ftdichip.com for more information. In summer 2009, USB high speed (480 Mbps) versions of these FTDI chips started to become available in JTAG adapters. Around 2012, a new variant appeared - FT232H - this is a single-channel version of FT2232H. (Adapters using those high speed FT2232H or FT232H chips may support adaptive clocking.)
The FT2232 chips are flexible enough to support some other transport options, such as SWD or the SPI variants used to program some chips. They have two communications channels, and one can be used for a UART adapter at the same time the other one is used to provide a debug adapter.
Also, some development boards integrate an FT2232 chip to serve as a built-in low-cost debug adapter and USB-to-serial solution.
- usbjtag
Link http://elk.informatik.fh-augsburg.de/hhweb/doc/openocd/usbjtag/usbjtag.html (http://elk.informatik.fh-augsburg.de/hhweb/doc/openocd/usbjtag/usbjtag.html)
- jtagkey
See: http://www.amontec.com/jtagkey.shtml
- jtagkey2
See: http://www.amontec.com/jtagkey2.shtml
- oocdlink
See: http://www.oocdlink.com By Joern Kaipf

Chapter 2: Debug Adapter Hardware | 6
- signalyzer
See: http://www.signalyzer.com
- Stellaris Eval Boards
See: http://www.ti.com - The Stellaris eval boards bundle FT2232-based JTAG and SWD support, which can be used to debug the Stellaris chips. Using separate JTAG adapters is optional. These boards can also be used in a "pass through" mode as JTAG adapters to other target boards, disabling the Stellaris chip.
- TI/Luminary ICDI
See: http://www.ti.com - TI/Luminary In-Circuit Debug Interface (ICDI) Boards are included in Stellaris LM3S9B9x Evaluation Kits. Like the non-detachable FT2232 support on the other Stellaris eval boards, they can be used to debug other target boards.
- olimex-jtag
See: http://www.olimex.com
- Flyswatter/Flyswatter2
See: http://www.tincantools.com
- turtelizer2
See: Turtelizer 2 (http://www.ethernut.de/en/hardware/turtelizer/index. html), (http://www.ethernut.de/en/hardware/turtelizer/index.html) or http://www.ethernut.de
- comstick
Link: http://www.hitex.com/index.php?id=383
- stm32stick
Link http://www.hitex.com/stm32-stick
- axm0432 jtag
Axiom AXM-0432 Link http://www.axman.com - NOTE: This JTAG does not appear to be available anymore as of April 2012.
- cortino
Link http://www.hitex.com/index.php?id=cortino
- dlp-usb1232h
Link http://www.dlpdesign.com/usb/usb1232h.shtml
- digilent-hs1
Link http://www.digilentinc.com/Products/Detail.cfm?Prod=JTAG-HS1
- opendous
Link http://code.google.com/p/opendous/wiki/JTAG FT2232H-based (OpenHardware).
- JTAG-lock-pick Tiny 2
Link http://www.distortec.com/jtag-lock-pick-tiny-2 FT232H-based
- GW16042
Link: | http://shop.gateworks.com/index.php?route=product/product&
path=70_80&product_id=64 (http://shop.gateworks.com/index.php?route=product/product&path=70_80&product_id=64) FT2232H-based

## 2.3 USB-JTAG / Altera USB-Blaster compatibles

These devices also show up as FTDI devices, but are not protocol-compatible with the FT2232 devices. They are, however, protocol-compatible among themselves. USB-JTAG

Chapter 2: Debug Adapter Hardware | 7

devices typically consist of a FT245 followed by a CPLD that understands a particular protocol, or emulates this protocol using some other hardware.
They may appear under different USB VID/PID depending on the particular product. The driver can be configured to search for any VID/PID pair (see the section on driver commands).
- USB-JTAG Kolja Waschk’s USB Blaster-compatible adapter
Link: http://ixo-jtag.sourceforge.net/
- Altera USB-Blaster
Link: http://www.altera.com/literature/ug/ug_usb_blstr.pdf

## 2.4 USB J-Link based

There are several OEM versions of the SEGGER J-Link adapter. It is an example of a microcontroller based JTAG adapter, it uses an AT91SAM764 internally.
- SEGGER J-Link
Link: http://www.segger.com/jlink.html
- Atmel SAM-ICE (Only works with Atmel chips!)
Link: http://www.atmel.com/tools/atmelsam-ice.aspx
- IAR J-Link

## 2.5 USB RLINK based

Raisonance has an adapter called RLink. It exists in a stripped-down form on the STM32 Primer, permanently attached to the JTAG lines. It also exists on the STM32 Primer2, but that is wired for SWD and not JTAG, thus not supported.
- Raisonance RLink
Link: | http://www.mcu-raisonance.com/~rlink-debugger-programmer__
microcontrollers__tool~tool__T018:4cn9ziz4bnx6.html (http://www.mcu-raisonance.com/~rlink-debugger-programmer__microcontrollers__tool~tool__T018:4cn9ziz4bnx6.html)
- STM32 Primer
Link: http://www.stm32circle.com/resources/stm32primer.php
- STM32 Primer2
Link: http://www.stm32circle.com/resources/stm32primer2.php

## 2.6 USB ST-LINK based

STMicroelectronics has an adapter called ST-LINK. They only work with STMicroelectronics chips, notably STM32 and STM8.
- ST-LINK
This is available standalone and as part of some kits, eg. STM32VLDISCOVERY. Link: http://www.st.com/internet/evalboard/product/219866.jsp
- ST-LINK/V2
This is available standalone and as part of some kits, eg. STM32F4DISCOVERY. Link: http://www.st.com/internet/evalboard/product/251168.jsp
- STLINK-V3
This is available standalone and as part of some kits.
Link: http://www.st.com/stlink-v3

Chapter 2: Debug Adapter Hardware | 8

For info the original ST-LINK enumerates using the mass storage usb class; however, its implementation is completely broken. The result is this causes issues under Linux. The simplest solution is to get Linux to ignore the ST-LINK using one of the following methods:
- modprobe -r usb-storage && modprobe usb-storage quirks=483:3744:i
- add "options usb-storage quirks=483:3744:i" to /etc/modprobe.conf

## 2.7 USB TI/Stellaris ICDI based

Texas Instruments has an adapter called ICDI. It is not to be confused with the FTDI based adapters that were originally fitted to their evaluation boards. This is the adapter fitted to the Stellaris LaunchPad.

## 2.8 USB Nuvoton Nu-Link

Nuvoton has an adapter called Nu-Link. It is available either as stand-alone dongle and embedded on development boards. It supports SWD, serial port bridge and mass storage for firmware update. Both Nu-Link v1 and v2 are supported.

## 2.9 USB CMSIS-DAP based

ARM has released a interface standard called CMSIS-DAP that simplifies connecting debuggers to ARM Cortex based targets http://www.keil.com/support/man/docs/dapdebug/dapdebug_introduction.htm. (http://www.keil.com/support/man/docs/dapdebug/dapdebug_introduction.htm)

## 2.10 USB Other

- USBprog
Link: http://shop.embedded-projects.net/ - which uses an Atmel MEGA32 and a UBN9604
- USB - Presto
Link: http://tools.asix.net/prg_presto.htm
- Versaloon-Link
Link: http://www.versaloon.com
- ARM-JTAG-EW
Link: http://www.olimex.com/dev/arm-jtag-ew.html
- Buspirate
Link: http://dangerousprototypes.com/bus-pirate-manual/
- opendous
Link: http://code.google.com/p/opendous-jtag/ - which uses an AT90USB162
- estick
Link: http://code.google.com/p/estick-jtag/
- Keil ULINK v1
Link: http://www.keil.com/ulink1/
- TI XDS110 Debug Probe
Link: | https://software-dl.ti.com/ccs/esd/documents/xdsdebugprobes/
emu_xds110.html (https://software-dl.ti.com/ccs/esd/documents/xdsdebugprobes/emu_xds110.html)

Chapter 2: Debug Adapter Hardware | 9
Link: | https://software-dl.ti.com/ccs/esd/documents/xdsdebugprobes/
emu_xds_software_package_download.html#xds110-support-utilities (https://software-dl.ti.com/ccs/esd/documents/xdsdebugprobes/emu_xds_software_package_download.html)

## 2.11 IBM PC Parallel Printer Port Based

The two well-known “JTAG Parallel Ports” cables are the Xilinx DLC5 and the Macraigor Wiggler. There are many clones and variations of these on the market.
Note that parallel ports are becoming much less common, so if you have the choice you should probably avoid these adapters in favor of USB-based ones.
- Wiggler - There are many clones of this.
Link: http://www.macraigor.com/wiggler.htm
- DLC5 - From XILINX - There are many clones of this
Link: Search the web for: “XILINX DLC5” - it is no longer produced, PDF schematics are easily found and it is easy to make.
- Amontec - JTAG Accelerator
Link: http://www.amontec.com/jtag_accelerator.shtml
- Wiggler2
Link: | http://www.ccac.rwth-aachen.de/~michaels/index.php/hardware/
armjtag (http://www.ccac.rwth-aachen.de/~michaels/index.php/hardware/armjtag)
- Wiggler ntrst inverted
Yet another variation - See the source code, src/jtag/parport.c
- old amt wiggler
Unknown - probably not on the market today
- arm-jtag
Link: Most likely http://www.olimex.com/dev/arm-jtag.html [another wiggler clone]
- chameleon
Link: http://www.amontec.com/chameleon.shtml
- Triton
Unknown.
- Lattice
ispDownload from Lattice Semiconductor http://www.latticesemi.com/lit/docs/devtools/dlcable.pdf (http://www.latticesemi.com/lit/docs/devtools/dlcable.pdf)
- flashlink
From STMicroelectronics;
Link: http://www.st.com/internet/com/TECHNICAL_RESOURCES/TECHNICAL_LITERATURE/DATA_BRIEF/DM00039500.pdf (http://www.st.com/internet/com/TECHNICAL_RESOURCES/TECHNICAL_LITERATURE/DATA_BRIEF/DM00039500.pdf)

2.12 Other...

- ep93xx
An EP93xx based Linux machine using the GPIO pins directly.
- at91rm9200
Like the EP93xx - but an ATMEL AT91RM9200 based solution using the GPIO pins on the chip.

Chapter 2: Debug Adapter Hardware | 10
- bcm2835gpio
A BCM2835-based board (e.g. Raspberry Pi) using the GPIO pins of the expansion header.
- imx gpio
A NXP i.MX-based board (e.g. Wandboard) using the GPIO pins (should work on any i.MX processor).
- jtag vpi
A JTAG driver acting as a client for the JTAG VPI server interface.
Link: http://github.com/fjullien/jtag_vpi
- jtag dpi
A JTAG driver acting as a client for the SystemVerilog Direct Programming Interface (DPI) for JTAG devices. DPI allows OpenOCD to connect to the JTAG interface of a hardware model written in SystemVerilog, for example, on an emulation model of target hardware.
- xlnx pcie xvc
A JTAG driver exposing Xilinx Virtual Cable over PCI Express to OpenOCD as JTAG/SWD interface.
- linuxgpiod
A bitbang JTAG driver using Linux GPIO through library libgpiod.
- sysfsgpio
A bitbang JTAG driver using Linux legacy sysfs GPIO. This is deprecated from Linux v5.3; prefer using linuxgpiod.

11

## 3 About Jim-Tcl

OpenOCD uses a small “Tcl Interpreter” known as Jim-Tcl. This programming language provides a simple and extensible command interpreter.
All commands presented in this Guide are extensions to Jim-Tcl. You can use them as simple commands, without needing to learn much of anything about Tcl. Alternatively, you can write Tcl programs with them.
You can learn more about Jim at its website, http://jim.tcl.tk. There is an active and responsive community, get on the mailing list if you have any questions. Jim-Tcl maintainers also lurk on the OpenOCD mailing list.
- Jim vs. Tcl
Jim-Tcl is a stripped down version of the well known Tcl language, which can be found here: http://www.tcl.tk. Jim-Tcl has far fewer features. Jim-Tcl is several dozens of .C files and .H files and implements the basic Tcl command set. In contrast: Tcl 8.6 is a 4.2 MB .zip file containing 1540 files.
- Missing Features
Our practice has been: Add/clone the real Tcl feature if/when needed. We welcome Jim-Tcl improvements, not bloat. Also there are a large number of optional Jim-Tcl features that are not enabled in OpenOCD.
- Scripts
OpenOCD configuration scripts are Jim-Tcl Scripts. OpenOCD’s command interpreter today is a mixture of (newer) Jim-Tcl commands, and the (older) original command interpreter.
- Commands
At the OpenOCD telnet command line (or via the GDB monitor command) one can type a Tcl for() loop, set variables, etc. Some of the commands documented in this guide are implemented as Tcl scripts, from a startup.tcl file internal to the server.
- Historical Note
Jim-Tcl was introduced to OpenOCD in spring 2008. Fall 2010, before OpenOCD 0.5 release, OpenOCD switched to using Jim-Tcl as a Git submodule, which greatly simplified upgrading Jim-Tcl to benefit from new features and bugfixes in Jim-Tcl.
- Need a crash course in Tcl?
See Chapter 23 [Tcl Crash Course], page 178.

12

## 4 Running

Properly installing OpenOCD sets up your operating system to grant it access to the debug adapters. On Linux, this usually involves installing a file in /etc/udev/rules.d, so OpenOCD has permissions. An example rules file that works for many common adapters is shipped with OpenOCD in the contrib directory. MS-Windows needs complex and confusing driver configuration for every peripheral. Such issues are unique to each operating system, and are not detailed in this User’s Guide.

Then later you will invoke the OpenOCD server, with various options to tell it how each debug session should work. The --help option shows:

bash$ openocd --help

--help | | -h | display this help
--version | | -v | display OpenOCD version
--file | | -f | use configuration file <name>
--search | | -s | dir to search for config files and scripts
--debug | | -d | set debug level to 3
| | -d<n> | set debug level to <level>
--log_output | -l | redirect log output to file <name>
--command | | -c | run <command>

If you don’t give any -f or -c options, OpenOCD tries to read the configuration file openocd.cfg. To specify one or more different configuration files, use -f options. For example:

openocd -f config1.cfg -f config2.cfg -f config3.cfg

Configuration files and scripts are searched for in

1. the current directory,
2. any search dir specified on the command line using the -s option,
3. any search dir specified using the add_script_search_dir command,
4. a directory in the OPENOCD_SCRIPTS environment variable (if set),
5. %APPDATA%/OpenOCD (only on Windows),
6. $HOME/Library/Preferences/org.openocd (only on Darwin),
7. $XDG_CONFIG_HOME/openocd ($XDG_CONFIG_HOME defaults to $HOME/.config),
8. $HOME/.openocd,
9. the site wide script library $pkgdatadir/site and
10. the OpenOCD-supplied script library $pkgdatadir/scripts.

The first found file with a matching file name will be used.

Note: Don’t try to use configuration script names or paths which include the "#" character. That character begins Tcl comments.

Chapter 4: Running | 13

## 4.1 Simple setup, no customization

In the best case, you can use two scripts from one of the script libraries, hook up your JTAG adapter, and start the server ... and your JTAG setup will just work "out of the box". Always try to start by reusing those scripts, but assume you’ll need more customization even if this works. See Chapter 5 [OpenOCD Project Setup], page 14.
If you find a script for your JTAG adapter, and for your board or target, you may be able to hook up your JTAG adapter then start the server with some variation of one of the following:

openocd -f interface/ADAPTER.cfg -f board/MYBOARD.cfg
openocd -f interface/ftdi/ADAPTER.cfg -f board/MYBOARD.cfg
You might also need to configure which reset signals are present, using -c ’reset_config trst_and_srst’ or something similar. If all goes well you’ll see output something like

Open On-Chip Debugger 0.4.0 (2010-01-14-15:06)
For bug reports, read
http://openocd.org/doc/doxygen/bugs.html Info : JTAG tap: lm3s.cpu tap/device found: 0x3ba00477
(mfg: 0x23b, part: 0xba00, ver: 0x3) Seeing that "tap/device found" message, and no warnings, means the JTAG communication is working. That’s a key milestone, but you’ll probably need more project-specific setup.

## 4.2 What OpenOCD does as it starts

OpenOCD starts by processing the configuration commands provided on the command line or, if there were no -c command or -f file.cfg options given, in openocd.cfg. See [Configuration Stage], page 32. At the end of the configuration stage it verifies the JTAG scan chain defined using those commands; your configuration should ensure that this always succeeds. Normally, OpenOCD then starts running as a server. Alternatively, commands may be used to terminate the configuration stage early, perform work (such as updating some flash memory), and then shut down without acting as a server.
Once OpenOCD starts running as a server, it waits for connections from clients (Telnet, GDB, RPC) and processes the commands issued through those channels.

If you are having problems, you can enable internal debug messages via the -d option. Also it is possible to interleave Jim-Tcl commands w/config scripts using the -c command line switch.
To enable debug output (when reporting problems or working on OpenOCD itself), use the -d command line switch. This sets the debug_level to "3", outputting the most information, including debug messages. The default setting is "2", outputting only informational messages, warnings and errors. You can also change this setting from within a telnet or gdb session using debug_level<n> (see [debug level], page 125).

You can redirect all output from the server to a file using the -l <logfile> switch. Note! OpenOCD will launch the GDB & telnet server even if it can not establish a connection with the target. In general, it is possible for the JTAG controller to be unresponsive until the target is set up correctly via e.g. GDB monitor commands in a GDB init script.

14

## 5 OpenOCD Project Setup

To use OpenOCD with your development projects, you need to do more than just connect the JTAG adapter hardware (dongle) to your development board and start the OpenOCD server. You also need to configure your OpenOCD server so that it knows about your adapter and board, and helps your work. You may also want to connect OpenOCD to GDB, possibly using Eclipse or some other GUI.

## 5.1 Hooking up the JTAG Adapter

Today’s most common case is a dongle with a JTAG cable on one side (such as a ribbon cable with a 10-pin or 20-pin IDC connector) and a USB cable on the other. Instead of USB, some dongles use Ethernet; older ones may use a PC parallel port, or even a serial port.
1. Start with power to your target board turned off, and nothing connected to your JTAG adapter. If you’re particularly paranoid, unplug power to the board. It’s important to have the ground signal properly set up, unless you are using a JTAG adapter which provides galvanic isolation between the target board and the debugging host.
2. Be sure it’s the right kind of JTAG connector. If your dongle has a 20-pin ARM connector, you need some kind of adapter (or octopus, see below) to hook it up to boards using 14-pin or 10-pin connectors ... or to 20-pin connectors which don’t use ARM’s pinout.
In the same vein, make sure the voltage levels are compatible. Not all JTAG adapters have the level shifters needed to work with 1.2 Volt boards.
3. Be certain the cable is properly oriented or you might damage your board. In most cases there are only two possible ways to connect the cable. Connect the JTAG cable from your adapter to the board. Be sure it’s firmly connected.
In the best case, the connector is keyed to physically prevent you from inserting it wrong. This is most often done using a slot on the board’s male connector housing, which must match a key on the JTAG cable’s female connector. If there’s no housing, then you must look carefully and make sure pin 1 on the cable hooks up to pin 1 on the board. Ribbon cables are frequently all grey except for a wire on one edge, which is red. The red wire is pin 1.
Sometimes dongles provide cables where one end is an “octopus” of color coded singlewire connectors, instead of a connector block. These are great when converting from one JTAG pinout to another, but are tedious to set up. Use these with connector pinout diagrams to help you match up the adapter signals to the right board pins.
4. Connect the adapter’s other end once the JTAG cable is connected. A USB, parallel, or serial port connector will go to the host which you are using to run OpenOCD. For Ethernet, consult the documentation and your network administrator.
For USB-based JTAG adapters you have an easy sanity check at this point: does the host operating system see the JTAG adapter? If you’re running Linux, try the lsusb command. If that host is an MS-Windows host, you’ll need to install a driver before OpenOCD works.
5. Connect the adapter’s power supply, if needed. This step is primarily for non-USB adapters, but sometimes USB adapters need extra power.

Chapter 5: OpenOCD Project Setup | 15
6. Power up the target board. Unless you just let the magic smoke escape, you’re now ready to set up the OpenOCD server so you can use JTAG to work with that board.

Talk with the OpenOCD server using telnet (telnet localhost 4444 on many systems) or GDB. See Chapter 20 [GDB and OpenOCD], page 165.

## 5.2 Project Directory

There are many ways you can configure OpenOCD and start it up.

A simple way to organize them all involves keeping a single directory for your work with a given board. When you start OpenOCD from that directory, it searches there first for configuration files, scripts, files accessed through semihosting, and for code you upload to the target board. It is also the natural place to write files, such as log files and data you download from the board.

## 5.3 Configuration Basics

There are two basic ways of configuring OpenOCD, and a variety of ways you can mix them. Think of the difference as just being how you start the server:

- Many -f file or -c command options on the command line
- No options, but a user config file in the current directory named openocd.cfg

Here is an example openocd.cfg file for a setup using a Signalyzer FT2232-based JTAG adapter to talk to a board with an Atmel AT91SAM7X256 microcontroller:

source [find interface/ftdi/signalyzer.cfg]

# GDB can also flash my flash! gdb_memory_map enable

gdb_flash_program enable

source [find target/sam7x256.cfg]

Here is the command line equivalent of that configuration:

openocd -f interface/ftdi/signalyzer.cfg \ -c "gdb_memory_map enable" \ -c "gdb_flash_program enable" \ -f target/sam7x256.cfg

You could wrap such long command lines in shell scripts, each supporting a different development task. One might re-flash the board with a specific firmware version. Another might set up a particular debugging or run-time environment.

Important: At this writing (October 2009) the command line method has problems with how it treats variables. For example, after -c "set VAR value", or doing the same in a script, the variable VAR will have no value that can be tested in a later script.

Here we will focus on the simpler solution: one user config file, including basic configuration plus any TCL procedures to simplify your work.

Chapter 5: OpenOCD Project Setup | 16

## 5.4 User Config Files

A user configuration file ties together all the parts of a project in one place. One of the following will match your situation best:
- Ideally almost everything comes from configuration files provided by someone else. For example, OpenOCD distributes a scripts directory (probably in /usr/share/openocd/scripts on Linux). Board and tool vendors can provide these too, as can individual user sites; the -s command line option lets you say where to find these files. (See Chapter 4 [Running], page 12.) The AT91SAM7X256 example above works this way.
Three main types of non-user configuration file each have their own subdirectory in the scripts directory:
1. interface – one for each different debug adapter;
2. board – one for each different board
3. target – the chips which integrate CPUs and other JTAG TAPs

Best case: include just two files, and they handle everything else. The first is an interface config file. The second is board-specific, and it sets up the JTAG TAPs and their GDB targets (by deferring to some target.cfg file), declares all flash memory, and leaves you nothing to do except meet your deadline:
| source [find interface/olimex-jtag-tiny.cfg] source [find board/csb337.cfg]

Boards with a single microcontroller often won’t need more than the target config file, as in the AT91SAM7X256 example. That’s because there is no external memory (flash, DDR RAM), and the board differences are encapsulated by application code.
- Maybe you don’t know yet what your board looks like to JTAG. Once you know the interface.cfg file to use, you may need help from OpenOCD to discover what’s on the board. Once you find the JTAG TAPs, you can just search for appropriate target and board configuration files ... or write your own, from the bottom up. See [Autoprobing], page 65.
- You can often reuse some standard config files but need to write a few new ones, probably a board.cfg file. You will be using commands described later in this User’s Guide, and working with the guidelines in the next chapter.
For example, there may be configuration files for your JTAG adapter and target chip, but you need a new board-specific config file giving access to your particular flash chips. Or you might need to write another target chip configuration file for a new chip built around the Cortex-M3 core.
| Note: When you write new configuration files, please submit them for inclu- sion in the next OpenOCD release. For example, a board/newboard.cfg file will help the next users of that board, and a target/newcpu.cfg will help support users of any board using that chip.
- You may need to write some C code. It may be as simple as supporting a new FT2232 or parport based adapter; a bit more involved, like a NAND or NOR flash controller driver; or a big piece of work like supporting a new chip architecture.

Reuse the existing config files when you can. Look first in the scripts/boards area, then scripts/targets. You may find a board configuration that’s a good example to follow.

Chapter 5: OpenOCD Project Setup | 17

When you write config files, separate the reusable parts (things every user of that interface, chip, or board needs) from ones specific to your environment and debugging approach.

- For example, a gdb-attach event handler that invokes the reset init command will interfere with debugging early boot code, which performs some of the same actions that the reset-init event handler does.
- Likewise, the arm9 vector_catch command (or its siblings xscale vector_catch and cortex_m vector_catch) can be a time-saver during some debug sessions, but don’t make everyone use that either. Keep those kinds of debugging aids in your user config file, along with messaging and tracing setup. (See [Software Debug Messages and Tracing], page 157.)
- You might need to override some defaults. For example, you might need to move, shrink, or back up the target’s work area if your application needs much SRAM.
- TCP/IP port configuration is another example of something which is environment-specific, and should only appear in a user config file. See [TCP/IP Ports], page 33.

## 5.5 Project-Specific Utilities

A few project-specific utility routines may well speed up your work. Write them, and keep them in your project’s user config file.

For example, if you are making a boot loader work on a board, it’s nice to be able to debug the “after it’s loaded to RAM” parts separately from the finicky early code which sets up the DDR RAM controller and clocks. A script like this one, or a more GDB-aware sibling, may help:

proc ramboot { } {
# Reset, running the target’s "reset-init" scripts # to initialize clocks and the DDR RAM controller. # Leave the CPU halted.

reset init

# Load CONFIG_SKIP_LOWLEVEL_INIT version into DDR RAM. load_image u-boot.bin 0x20000000

# Start running.

resume 0x20000000
}

Then once that code is working you will need to make it boot from NOR flash; a different utility would help. Alternatively, some developers write to flash using GDB. (You might use a similar script if you’re working with a flash based microcontroller application instead of a boot loader.)

proc newboot { } {
# Reset, leaving the CPU halted. The "reset-init" event # proc gives faster access to the CPU and to NOR flash; # "reset halt" would be slower.

reset init

Chapter 5: OpenOCD Project Setup | 18

# Write standard version of U-Boot into the first two # sectors of NOR flash ... the standard version should # do the same lowlevel init as "reset-init".

flash protect 0 0 1 off
flash erase_sector 0 0 1
flash write_bank 0 u-boot.bin 0x0
flash protect 0 0 1 on

# Reboot from scratch using that new boot loader. reset run

}
You may need more complicated utility procedures when booting from NAND. That often involves an extra bootloader stage, running from on-chip SRAM to perform DDR RAM setup so it can load the main bootloader code (which won’t fit into that SRAM).

Other helper scripts might be used to write production system images, involving considerably more than just a three stage bootloader.

## 5.6 Target Software Changes

Sometimes you may want to make some small changes to the software you’re developing, to help make JTAG debugging work better. For example, in C or assembly language code you might use #ifdef JTAG_DEBUG (or its converse) around code handling issues like:
- Watchdog Timers... Watchdog timers are typically used to automatically reset systems if some application task doesn’t periodically reset the timer. (The assumption is that the system has locked up if the task can’t run.) When a JTAG debugger halts the system, that task won’t be able to run and reset the timer ... potentially causing resets in the middle of your debug sessions.
It’s rarely a good idea to disable such watchdogs, since their usage needs to be debugged just like all other parts of your firmware. That might however be your only option. Look instead for chip-specific ways to stop the watchdog from counting while the system is in a debug halt state. It may be simplest to set that non-counting mode in your debugger startup scripts. You may however need a different approach when, for example, a motor could be physically damaged by firmware remaining inactive in a debug halt state. That might involve a type of firmware mode where that "non-counting" mode is disabled at the beginning then re-enabled at the end; a watchdog reset might fire and complicate the debug session, but hardware (or people) would be protected.¹
- ARM Semihosting... When linked with a special runtime library provided with many toolchains²
, your target code can use I/O facilities on the debug host. That library provides a small set of system calls which are handled by OpenOCD. It can let the

1 Note that many systems support a "monitor mode" debug that is a somewhat cleaner way to address such issues. You can think of it as only halting part of the system, maybe just one task, instead of the whole thing. At this writing, January 2010, OpenOCD based debugging does not support monitor mode debug, only "halt mode" debug.
2 See chapter 8 "Semihosting" in ARM DUI 0203I (http://infocenter.arm.com/help/topic/com.arm.doc.dui0203i/DUI0203I_rvct_developer_guide.pdf), (http://infocenter.arm.com/help/topic/com.arm.doc.dui0203i/DUI0203I_rvct_developer_guide.pdf) the "RealView Compilation Tools Developer Guide". The CodeSourcery EABI toolchain also includes a semihosting library.

Chapter 5: OpenOCD Project Setup | 19

debugger provide your system console and a file system, helping with early debugging or providing a more capable environment for sometimes-complex tasks like installing system firmware onto NAND or SPI flash.
- ARM Wait-For-Interrupt... Many ARM chips synchronize the JTAG clock using the core clock. Low power states which stop that core clock thus prevent JTAG access. Idle loops in tasking environments often enter those low power states via the WFI instruction (or its coprocessor equivalent, before ARMv7).

You may want to disable that instruction in source code, or otherwise prevent using that state, to ensure you can get JTAG access at any time.³ For example, the OpenOCD halt command may not work for an idle processor otherwise.
- Delay after reset... Not all chips have good support for debugger access right after reset; many LPC2xxx chips have issues here. Similarly, applications that reconfigure pins used for JTAG access as they start will also block debugger access.

To work with boards like this, enable a short delay loop the first thing after reset, before "real" startup activities. For example, one second’s delay is usually more than enough time for a JTAG debugger to attach, so that early code execution can be debugged or firmware can be replaced.
- Debug Communications Channel (DCC)... Some processors include mechanisms to send messages over JTAG. Many ARM cores support these, as do some cores from other vendors. (OpenOCD may be able to use this DCC internally, speeding up some operations like writing to memory.)

Your application may want to deliver various debugging messages over JTAG, by linking with a small library of code provided with OpenOCD and using the utilities there to send various kinds of message. See [Software Debug Messages and Tracing], page 157.

## 5.7 Target Hardware Setup

Chip vendors often provide software development boards which are highly configurable, so that they can support all options that product boards may require. Make sure that any jumpers or switches match the system configuration you are working with.

Common issues include:

- JTAG setup ... Boards may support more than one JTAG configuration. Examples include jumpers controlling pullups versus pulldowns on the nTRST and/or nSRST signals, and choice of connectors (e.g. which of two headers on the base board, or one from a daughtercard). For some Texas Instruments boards, you may need to jumper the EMU0 and EMU1 signals (which OpenOCD won’t currently control).
- Boot Modes ... Complex chips often support multiple boot modes, controlled by external jumpers. Make sure this is set up correctly. For example many i.MX boards from NXP need to be jumpered to "ATX mode" to start booting using the on-chip ROM, when using second stage bootloader code stored in a NAND flash chip.

3 As a more polite alternative, some processors have special debug-oriented registers which can be used to change various features including how the low power states are clocked while debugging. The STM32 DBGMCU CR register is an example; at the cost of extra power consumption, JTAG can be used during low power states.

Chapter 5: OpenOCD Project Setup | 20

Such explicit configuration is common, and not limited to booting from NAND. You might also need to set jumpers to start booting using code loaded from an MMC/SD card; external SPI flash; Ethernet, UART, or USB links; NOR flash; OneNAND flash; some external host; or various other sources.
- Memory Addressing ... Boards which support multiple boot modes may also have jumpers to configure memory addressing. One board, for example, jumpers external chipselect 0 (used for booting) to address either a large SRAM (which must be preloaded via JTAG), NOR flash, or NAND flash. When it’s jumpered to address NAND flash, that board must also be told to start booting from on-chip ROM.
Your board.cfg file may also need to be told this jumper configuration, so that it can know whether to declare NOR flash using flash bank or instead declare NAND flash with nand device; and likewise which probe to perform in its reset-init handler. A closely related issue is bus width. Jumpers might need to distinguish between 8 bit or 16 bit bus access for the flash used to start booting.
- Peripheral Access ... Development boards generally provide access to every peripheral on the chip, sometimes in multiple modes (such as by providing multiple audio codec chips). This interacts with software configuration of pin multiplexing, where for example a given pin may be routed either to the MMC/SD controller or the GPIO controller. It also often interacts with configuration jumpers. One jumper may be used to route signals to an MMC/SD card slot or an expansion bus (which might in turn affect booting); others might control which audio or video codecs are used.

Plus you should of course have reset-init event handlers which set up the hardware to match that jumper configuration. That includes in particular any oscillator or PLL used to clock the CPU, and any memory controllers needed to access external memory and peripherals. Without such handlers, you won’t be able to access those resources without working target firmware which can do that setup ... this can be awkward when you’re trying to debug that target firmware. Even if there’s a ROM bootloader which handles a few issues, it rarely provides full access to all board-specific capabilities.

21

## 6 Config File Guidelines

This chapter is aimed at any user who needs to write a config file, including developers and integrators of OpenOCD and any user who needs to get a new board working smoothly. It provides guidelines for creating those files.

You should find the following directories under $(INSTALLDIR)/scripts, with config files maintained upstream. Use them as-is where you can; or as models for new files.

- interface ... These are for debug adapters. Files that specify configuration to use specific JTAG, SWD and other adapters go here.
- board ... Think Circuit Board, PWA, PCB, they go by many names. Board files contain initialization items that are specific to a board.

They reuse target configuration files, since the same microprocessor chips are used on many boards, but support for external parts varies widely. For example, the SDRAM initialization sequence for the board, or the type of external flash and what address it uses. Any initialization sequence to enable that external flash or SDRAM should be found in the board file. Boards may also contain multiple targets: two CPUs; or a CPU and an FPGA.
- target ... Think chip. The “target” directory represents the JTAG TAPs on a chip which OpenOCD should control, not a board. Two common types of targets are ARM chips and FPGA or CPLD chips. When a chip has multiple TAPs (maybe it has both ARM and DSP cores), the target config file defines all of them.
- more ... browse for other library files which may be useful. For example, there are various generic and CPU-specific utilities.

The openocd.cfg user config file may override features in any of the above files by setting variables before sourcing the target file, or by adding commands specific to their situation.

## 6.1 Interface Config Files

The user config file should be able to source one of these files with a command like this:

source [find interface/FOOBAR.cfg]

A preconfigured interface file should exist for every debug adapter in use today with OpenOCD. That said, perhaps some of these config files have only been used by the developer who created it.

A separate chapter gives information about how to set these up. See Chapter 8 [Debug Adapter Configuration], page 37. Read the OpenOCD source code (and Developer’s Guide) if you have a new kind of hardware interface and need to provide a driver for it.

find ’filename’ | [Command]
Prints full path to filename according to OpenOCD search rules.
ocd_find ’filename’ | [Command]
Prints full path to filename according to OpenOCD search rules. This is a low level function used by the find. Usually you want to use find, instead.

Chapter 6: Config File Guidelines | 22

## 6.2 Board Config Files

The user config file should be able to source one of these files with a command like this:

source [find board/FOOBAR.cfg]
The point of a board config file is to package everything about a given board that user config files need to know. In summary the board files should contain (if present)
1. One or more source [find target/...cfg] statements
2. NOR flash configuration (see [NOR Configuration], page 79)
3. NAND flash configuration (see [NAND Configuration], page 115)
4. Target reset handlers for SDRAM and I/O configuration
5. JTAG adapter reset configuration (see Chapter 9 [Reset Configuration], page 56)
6. All things that are not “inside a chip”

Generic things inside target chips belong in target config files, not board config files. So for example a reset-init event handler should know board-specific oscillator and PLL parameters, which it passes to target-specific utility code.
The most complex task of a board config file is creating such a reset-init event handler. Define those handlers last, after you verify the rest of the board configuration works.

### 6.2.1 Communication Between Config files

In addition to target-specific utility code, another way that board and target config files communicate is by following a convention on how to use certain variables.
The full Tcl/Tk language supports “namespaces”, but Jim-Tcl does not. Thus the rule we follow in OpenOCD is this: Variables that begin with a leading underscore are temporary in nature, and can be modified and used at will within a target configuration file.
Complex board config files can do the things like this, for a board with three chips:

# Chip #1: PXA270 for network side, big endian

set CHIPNAME network
set ENDIAN big
source [find target/pxa270.cfg]
# on return: _TARGETNAME = network.cpu

# other commands can refer to the "network.cpu" target. $_TARGETNAME configure .... events for this CPU..

# Chip #2: PXA270 for video side, little endian

set CHIPNAME video
set ENDIAN little
source [find target/pxa270.cfg]
# on return: _TARGETNAME = video.cpu

# other commands can refer to the "video.cpu" target. $_TARGETNAME configure .... events for this CPU..

# Chip #3: Xilinx FPGA for glue logic

set CHIPNAME xilinx
unset ENDIAN

Chapter 6: Config File Guidelines | 23

source [find target/spartan3.cfg]
That example is oversimplified because it doesn’t show any flash memory, or the reset-init event handlers to initialize external DRAM or (assuming it needs it) load a configuration into the FPGA. Such features are usually needed for low-level work with many boards, where “low level” implies that the board initialization software may not be working. (That’s a common reason to need JTAG tools. Another is to enable working with microcontrollerbased systems, which often have no debugging support except a JTAG connector.) Target config files may also export utility functions to board and user config files. Such functions should use name prefixes, to help avoid naming collisions.
Board files could also accept input variables from user config files. For example, there might be a J4_JUMPER setting used to identify what kind of flash memory a development board is using, or how to set up other clocks and peripherals.

### 6.2.2 Variable Naming Convention

Most boards have only one instance of a chip. However, it should be easy to create a board with more than one such chip (as shown above). Accordingly, we encourage these conventions for naming variables associated with different target.cfg files, to promote consistency and so that board files can override target defaults.
Inputs to target config files include:
- CHIPNAME ... This gives a name to the overall chip, and is used as part of tap identifier dotted names. While the default is normally provided by the chip manufacturer, board files may need to distinguish between instances of a chip.
- ENDIAN ... By default little - although chips may hard-wire big. Chips that can’t change endianness don’t need to use this variable.
- CPUTAPID ... When OpenOCD examines the JTAG chain, it can be told verify the chips against the JTAG IDCODE register. The target file will hold one or more defaults, but sometimes the chip in a board will use a different ID (perhaps a newer revision).

Outputs from target config files include:
- _TARGETNAME ... By convention, this variable is created by the target configuration script. The board configuration file may make use of this variable to configure things like a “reset init” script, or other things specific to that board and that target. If the chip has 2 targets, the names are _TARGETNAME0, _TARGETNAME1, ... etc.

### 6.2.3 The reset-init Event Handler

Board config files run in the OpenOCD configuration stage; they can’t use TAPs or targets, since they haven’t been fully set up yet. This means you can’t write memory or access chip registers; you can’t even verify that a flash chip is present. That’s done later in event handlers, of which the target reset-init handler is one of the most important.
Except on microcontrollers, the basic job of reset-init event handlers is setting up flash and DRAM, as normally handled by boot loaders. Microcontrollers rarely use boot loaders; they run right out of their on-chip flash and SRAM memory. But they may want to use one of these handlers too, if just for developer convenience.
Note: Because this is so very board-specific, and chip-specific, no examples
are included here. Instead, look at the board config files distributed with

Chapter 6: Config File Guidelines | 24

OpenOCD. If you have a boot loader, its source code will help; so will configuration files for other JTAG tools (see [Translating Configuration Files], page 30).
Some of this code could probably be shared between different boards. For example, setting up a DRAM controller often doesn’t differ by much except the bus width (16 bits or 32?) and memory timings, so a reusable TCL procedure loaded by the target.cfg file might take those as parameters. Similarly with oscillator, PLL, and clock setup; and disabling the watchdog. Structure the code cleanly, and provide comments to help the next developer doing such work. (You might be that next person trying to reuse init code!)
The last thing normally done in a reset-init handler is probing whatever flash memory was configured. For most chips that needs to be done while the associated target is halted, either because JTAG memory access uses the CPU or to prevent conflicting CPU access.

### 6.2.4 JTAG Clock Rate

Before your reset-init handler has set up the PLLs and clocking, you may need to run with a low JTAG clock rate. See [JTAG Speed], page 55. Then you’d increase that rate after your handler has made it possible to use the faster JTAG clock. When the initial low speed is board-specific, for example because it depends on a board-specific oscillator speed, then you should probably set it up in the board config file; if it’s target-specific, it belongs in the target config file.
For most ARM-based processors the fastest JTAG clock¹
is one sixth of the CPU clock; or one eighth for ARM11 cores. Consult chip documentation to determine the peak JTAG clock rate, which might be less than that.
Warning: On most ARMs, JTAG clock detection is coupled to the core clock, so software using a wait for interrupt operation blocks JTAG access. Adaptive clocking provides a partial workaround, but a more complete solution just avoids using that instruction with JTAG debuggers.
If both the chip and the board support adaptive clocking, use the jtag_rclk command, in case your board is used with JTAG adapter which also supports it. Otherwise use adapter speed. Set the slow rate at the beginning of the reset sequence, and the faster rate as soon as the clocks are at full speed.

### 6.2.5 The init board procedure

The concept of init_board procedure is very similar to init_targets (See [The init targets procedure], page 29.) - it’s a replacement of “linear” configuration scripts. This procedure is meant to be executed when OpenOCD enters run stage (See [Entering the Run Stage], page 32,) after init_targets. The idea to have separate init_targets and init_board procedures is to allow the first one to configure everything target specific (internal flash, internal RAM, etc.) and the second one to configure everything board specific (reset signals, chip frequency, reset-init event handler, external memory, etc.). Additionally “linear” board config file will most likely fail when target config file uses init_targets scheme (“linear” script is executed before init and init_targets - after), so separating these two configuration stages is very convenient, as the easiest way to overcome this problem is to convert board config file to use init_board procedure. Board config scripts don’t need to override init_targets defined in target config files when they only need to add some specifics.

1 A FAQ http://www.arm.com/support/faqdev/4170.html gives details.

Chapter 6: Config File Guidelines | 25

Just as init_targets, the init_board procedure can be overridden by “next level” script (which sources the original), allowing greater code reuse.

### board_file.cfg ###

# source target file that does most of the config in init_targets source [find target/target.cfg]

proc enable_fast_clock {} {
# enables fast on-board clock source # configures the chip to use it

}

# initialize only board specifics - reset, clock, adapter frequency proc init_board {} {

reset_config trst_and_srst trst_pulls_srst

$_TARGETNAME configure -event reset-start { adapter speed 100
}

$_TARGETNAME configure -event reset-init { enable_fast_clock
adapter speed 10000
}
}

## 6.3 Target Config Files

Board config files communicate with target config files using naming conventions as described above, and may source one or more target config files like this:

source [find target/FOOBAR.cfg]

The point of a target config file is to package everything about a given chip that board config files need to know. In summary the target files should contain

1. Set defaults
2. Add TAPs to the scan chain
3. Add CPU targets (includes GDB support)
4. CPU/Chip/CPU-Core specific features
5. On-Chip flash

As a rule of thumb, a target file sets up only one chip. For a microcontroller, that will often include a single TAP, which is a CPU needing a GDB target, and its on-chip flash.

More complex chips may include multiple TAPs, and the target config file may need to define them all before OpenOCD can talk to the chip. For example, some phone chips have JTAG scan chains that include an ARM core for operating system use, a DSP, another ARM core embedded in an image processing engine, and other processing engines.

Chapter 6: Config File Guidelines | 26

### 6.3.1 Default Value Boiler Plate Code

All target configuration files should start with code like this, letting board config files express environment-specific differences in how things should be set up.

# Boards may override chip names, perhaps based on role,

# but the default should match what the vendor uses

if { [info exists CHIPNAME] } {
set _CHIPNAME $CHIPNAME
} else {
set _CHIPNAME sam7x256
}

# ONLY use ENDIAN with targets that can change it. if { [info exists ENDIAN] } {

set _ENDIAN $ENDIAN
} else {
set _ENDIAN little
}

# TAP identifiers may change as chips mature, for example with # new revision fields (the "3" here). Pick a good default; you # can pass several such identifiers to the "jtag newtap" command. if { [info exists CPUTAPID ] } {

set _CPUTAPID $CPUTAPID
} else {
set _CPUTAPID 0x3f0f0f0f
}
Remember: Board config files may include multiple target config files, or the same target file multiple times (changing at least CHIPNAME).
Likewise, the target configuration file should define _TARGETNAME (or _TARGETNAME0 etc) and use it later on when defining debug targets:
set _TARGETNAME $_CHIPNAME.cpu
target create $_TARGETNAME arm7tdmi -chain-position $_TARGETNAME

### 6.3.2 Adding TAPs to the Scan Chain

After the “defaults” are set up, add the TAPs on each chip to the JTAG scan chain. See Chapter 10 [TAP Declaration], page 61, and the naming convention for taps.
In the simplest case the chip has only one TAP, probably for a CPU or FPGA. The config file for the Atmel AT91SAM7X256 looks (in part) like this:

jtag newtap $_CHIPNAME cpu -irlen 4 -expected-id $_CPUTAPID
A board with two such at91sam7 chips would be able to source such a config file twice, with different values for CHIPNAME, so it adds a different TAP each time.
If there are nonzero -expected-id values, OpenOCD attempts to verify the actual tap id against those values. It will issue error messages if there is mismatch, which can help to pinpoint problems in OpenOCD configurations.
JTAG tap: sam7x256.cpu tap/device found: 0x3f0f0f0f

Chapter 6: Config File Guidelines | 27

(Manufacturer: 0x787, Part: 0xf0f0, Version: 0x3) ERROR: Tap: sam7x256.cpu - Expected id: 0x12345678, Got: 0x3f0f0f0f ERROR: expected: mfg: 0x33c, part: 0x2345, ver: 0x1
ERROR: | got: mfg: 0x787, part: 0xf0f0, ver: 0x3
There are more complex examples too, with chips that have multiple TAPs. Ones worth looking at include:
- target/omap3530.cfg – with disabled ARM and DSP, plus a JRC to enable them
- target/str912.cfg – with flash, CPU, and boundary scan
- target/ti_dm355.cfg – with ETM, ARM, and JRC (this JRC is not currently used)

### 6.3.3 Add CPU targets

After adding a TAP for a CPU, you should set it up so that GDB and other commands can use it. See Chapter 11 [CPU Configuration], page 69. For the at91sam7 example above, the command can look like this; note that $_ENDIAN is not needed, since OpenOCD defaults to little endian, and this chip doesn’t support changing that.

set _TARGETNAME $_CHIPNAME.cpu
target create $_TARGETNAME arm7tdmi -chain-position $_TARGETNAME
Work areas are small RAM areas associated with CPU targets. They are used by OpenOCD to speed up downloads, and to download small snippets of code to program flash chips. If the chip includes a form of “on-chip-ram” - and many do - define a work area if you can. Again using the at91sam7 as an example, this can look like:

$_TARGETNAME configure -work-area-phys 0x00200000 \
| -work-area-size 0x4000 -work-area-backup 0

### 6.3.4 Define CPU targets working in SMP

After setting targets, you can define a list of targets working in SMP.

set _TARGETNAME_1 $_CHIPNAME.cpu1
set _TARGETNAME_2 $_CHIPNAME.cpu2
target create $_TARGETNAME_1 cortex_a -chain-position $_CHIPNAME.dap \ -coreid 0 -dbgbase $_DAP_DBG1
target create $_TARGETNAME_2 cortex_a -chain-position $_CHIPNAME.dap \ -coreid 1 -dbgbase $_DAP_DBG2
#define 2 targets working in smp.

target smp $_CHIPNAME.cpu2 $_CHIPNAME.cpu1
In the above example on cortex a, 2 cpus are working in SMP. In SMP only one GDB instance is created and :
- a set of hardware breakpoint sets the same breakpoint on all targets in the list.
- halt command triggers the halt of all targets in the list.
- resume command triggers the write context and the restart of all targets in the list.
- following a breakpoint: the target stopped by the breakpoint is displayed to the GDB session.
- dedicated GDB serial protocol packets are implemented for switching/retrieving the target displayed by the GDB session see [Using OpenOCD SMP with GDB], page 169.

Chapter 6: Config File Guidelines | 28

The SMP behaviour can be disabled/enabled dynamically. On cortex a following command have been implemented.
- cortex a smp on : enable SMP mode, behaviour is as described above.
- cortex a smp off : disable SMP mode, the current target is the one displayed in the GDB session, only this target is now controlled by GDB session. This behaviour is useful during system boot up.
- cortex a smp : display current SMP mode.
- cortex a smp gdb : display/fix the core id displayed in GDB session see following example.

>cortex_a smp_gdb
gdb coreid 0 -> -1
#0 : coreid 0 is displayed to GDB ,

#-> -1 : next resume triggers a real resume > cortex_a smp_gdb 1

gdb coreid 0 -> 1
#0 :coreid 0 is displayed to GDB ,

#->1 : next resume displays coreid 1 to GDB > resume

> cortex_a smp_gdb
gdb coreid 1 -> 1
#1 :coreid 1 is displayed to GDB ,

#->1 : next resume displays coreid 1 to GDB > cortex_a smp_gdb -1

gdb coreid 1 -> -1
#1 :coreid 1 is displayed to GDB,

#->-1 : next resume triggers a real resume

### 6.3.5 Chip Reset Setup

As a rule, you should put the reset_config command into the board file. Most things you think you know about a chip can be tweaked by the board.
Some chips have specific ways the TRST and SRST signals are managed. In the unusual case that these are chip specific and can never be changed by board wiring, they could go here. For example, some chips can’t support JTAG debugging without both signals. Provide a reset-assert event handler if you can. Such a handler uses JTAG operations to reset the target, letting this target config be used in systems which don’t provide the optional SRST signal, or on systems where you don’t want to reset all targets at once. Such a handler might write to chip registers to force a reset, use a JRC to do that (preferable – the target may be wedged!), or force a watchdog timer to trigger. (For Cortex-M targets, this is not necessary. The target driver knows how to use trigger an NVIC reset when SRST is not available.)

Some chips need special attention during reset handling if they’re going to be used with JTAG. An example might be needing to send some commands right after the target’s TAP has been reset, providing a reset-deassert-post event handler that writes a chip register to report that JTAG debugging is being done. Another would be reconfiguring the watchdog so that it stops counting while the core is halted in the debugger.

Chapter 6: Config File Guidelines | 29

JTAG clocking constraints often change during reset, and in some cases target config files (rather than board config files) are the right places to handle some of those issues. For example, immediately after reset most chips run using a slower clock than they will use later. That means that after reset (and potentially, as OpenOCD first starts up) they must use a slower JTAG clock rate than they will use later. See [JTAG Speed], page 55.

Important: When you are debugging code that runs right after chip reset, getting these issues right is critical. In particular, if you see intermittent failures
when OpenOCD verifies the scan chain after reset, look at how you are setting up JTAG clocking.

### 6.3.6 The init targets procedure

Target config files can either be “linear” (script executed line-by-line when parsed in configuration stage, See [Configuration Stage], page 32,) or they can contain a special procedure called init_targets, which will be executed when entering run stage (after parsing all config files or after init command, See [Entering the Run Stage], page 32.) Such procedure can be overridden by “next level” script (which sources the original). This concept facilitates code reuse when basic target config files provide generic configuration procedures and init_targets procedure, which can then be sourced and enhanced or changed in a “more specific” target config file. This is not possible with “linear” config scripts, because sourcing them executes every initialization commands they provide.

### generic_file.cfg ###

proc setup_my_chip {chip_name flash_size ram_size} { # basic initialization procedure ...
}

proc init_targets {} {
# initializes generic chip with 4kB of flash and 1kB of RAM setup_my_chip MY_GENERIC_CHIP 4096 1024

}

### specific_file.cfg ###

source [find target/generic_file.cfg]

proc init_targets {} {
# initializes specific chip with 128kB of flash and 64kB of RAM setup_my_chip MY_CHIP_WITH_128K_FLASH_64KB_RAM 131072 65536

}

The easiest way to convert “linear” config files to init_targets version is to enclose every line of “code” (i.e. not source commands, procedures, etc.) in this procedure.

For an example of this scheme see LPC2000 target config files.

The init_boards procedure is a similar concept concerning board config files (See [The init board procedure], page 24.)

Chapter 6: Config File Guidelines | 30

### 6.3.7 The init target events procedure

A special procedure called init_target_events is run just after init_targets (See [The init targets procedure], page 29.) and before init_board (See [The init board procedure], page 24.) It is used to set up default target events for the targets that do not have those events already assigned.

### 6.3.8 ARM Core Specific Hacks

If the chip has a DCC, enable it. If the chip is an ARM9 with some special high speed download features - enable it.
If present, the MMU, the MPU and the CACHE should be disabled.
Some ARM cores are equipped with trace support, which permits examination of the instruction and data bus activity. Trace activity is controlled through an “Embedded Trace Module” (ETM) on one of the core’s scan chains. The ETM emits voluminous data through a “trace port”. (See [ARM Hardware Tracing], page 132.) If you are using an external trace port, configure it in your board config file. If you are using an on-chip “Embedded Trace Buffer” (ETB), configure it in your target config file.

etm config $_TARGETNAME 16 normal full etb
etb config $_TARGETNAME $_CHIPNAME.etb

### 6.3.9 Internal Flash Configuration

This applies ONLY TO MICROCONTROLLERS that have flash built in.
Never ever in the “target configuration file” define any type of flash that is external to the chip. (For example a BOOT flash on Chip Select 0.) Such flash information goes in a board file - not the TARGET (chip) file.

Examples:
- at91sam7x256 - has 256K flash YES enable it.
- str912 - has flash internal YES enable it.
- imx27 - uses boot flash on CS0 - it goes in the board file.
- pxa270 - again - CS0 flash - it goes in the board file.

## 6.4 Translating Configuration Files

If you have a configuration file for another hardware debugger or toolset (Abatron, BDI2000, BDI3000, CCS, Lauterbach, SEGGER, Macraigor, etc.), translating it into OpenOCD syntax is often quite straightforward. The most tricky part of creating a configuration script is oftentimes the reset init sequence where e.g. PLLs, DRAM and the like is set up.
One trick that you can use when translating is to write small Tcl procedures to translate the syntax into OpenOCD syntax. This can avoid manual translation errors and make it easier to convert other scripts later on.
Example of transforming quirky arguments to a simple search and replace job:

# Lauterbach syntax(?)

# | Data.Set c15:0x042f %long 0x40000015

Chapter 6: Config File Guidelines | 31
# | OpenOCD syntax when using procedure below.

# | setc15 0x01 0x00050078

proc setc15 {regs value} {
| global TARGETNAME
| echo [format "set p15 0x%04x, 0x%08x" $regs $value]
| arm mcr 15 [expr ($regs>>12)&0x7] \
| [expr ($regs>>0)&0xf] [expr ($regs>>4)&0xf] \
| [expr ($regs>>8)&0x7] $value
}

32

## 7 Server Configuration

The commands here are commonly found in the openocd.cfg file and are used to specify what TCP/IP ports are used, and how GDB should be supported.

## 7.1 Configuration Stage

When the OpenOCD server process starts up, it enters a configuration stage which is the only time that certain commands, configuration commands, may be issued. Normally, configuration commands are only available inside startup scripts.
In this manual, the definition of a configuration command is presented as a Config Command, not as a Command which may be issued interactively. The runtime help command also highlights configuration commands, and those which may be issued at any time. Those configuration commands include declaration of TAPs, flash banks, the interface used for JTAG communication, and other basic setup. The server must leave the configuration stage before it may access or activate TAPs. After it leaves this stage, configuration commands may no longer be issued.
command mode [command name] | [Command]
Returns the command modes allowed by a command: ’any’, ’config’, or ’exec’. If no command is specified, returns the current command mode. Returns ’unknown’ if an unknown command is given. Command can be multiple tokens. (command valid any time)

In this document, the modes are described as stages, ’config’ and ’exec’ mode correspond configuration stage and run stage. ’any’ means the command can be executed in either stages. See [Configuration Stage], page 32, and See [Entering the Run Stage], page 32.

## 7.2 Entering the Run Stage

The first thing OpenOCD does after leaving the configuration stage is to verify that it can talk to the scan chain (list of TAPs) which has been configured. It will warn if it doesn’t find TAPs it expects to find, or finds TAPs that aren’t supposed to be there. You should see no errors at this point. If you see errors, resolve them by correcting the commands you used to configure the server. Common errors include using an initial JTAG speed that’s too fast, and not providing the right IDCODE values for the TAPs on the scan chain. Once OpenOCD has entered the run stage, a number of commands become available. A number of these relate to the debug targets you may have declared. For example, the mww command will not be available until a target has been successfully instantiated. If you want to use those commands, you may need to force entry to the run stage.

init | [Config Command]
This command terminates the configuration stage and enters the run stage. This helps when you need to have the startup scripts manage tasks such as resetting the target, programming flash, etc. To reset the CPU upon startup, add "init" and "reset" at the end of the config script or at the end of the OpenOCD command line using the -c command line switch.

Chapter 7: Server Configuration | 33

If this command does not appear in any startup/configuration file OpenOCD executes the command for you after processing all configuration files and/or command line options.
NOTE: This command normally occurs near the end of your openocd.cfg file to force OpenOCD to “initialize” and make the targets ready. For example: If your openocd.cfg file needs to read/write memory on your target, init must occur before the memory read/write commands. This includes nand probe.

init calls the following internal OpenOCD commands to initialize corresponding subsystems:

target init | [Config Command]
transport init | [Command]
dap init | [Command]
flash init | [Config Command]
nand init | [Config Command]
pld init | [Config Command]
tpiu init | [Command]
noinit | [Config Command]
Prevent OpenOCD from implicit init call at the end of startup. Allows issuing configuration commands over telnet or Tcl connection. When you are done with configuration use init to enter the run stage.
jtag_init | [Overridable Procedure]
This is invoked at server startup to verify that it can talk to the scan chain (list of TAPs) which has been configured.

The default implementation first tries jtag arp_init, which uses only a lightweight JTAG reset before examining the scan chain. If that fails, it tries again, using a harder reset from the overridable procedure init_reset.
Implementations must have verified the JTAG scan chain before they return. This is done by calling jtag arp_init (or jtag arp_init-reset).

## 7.3 TCP/IP Ports

The OpenOCD server accepts remote commands in several syntaxes. Each syntax uses a different TCP/IP port, which you may specify only during configuration (before those ports are opened).

For reasons including security, you may wish to prevent remote access using one or more of these ports. In such cases, just specify the relevant port number as "disabled". If you disable all access through TCP/IP, you will need to use the command line -pipe option.

gdb_port [number] | [Config Command]
Normally gdb listens to a TCP/IP port, but GDB can also communicate via pipes(stdin/out or named pipes). The name "gdb port" stuck because it covers probably more than 90% of the normal use cases.

No arguments reports GDB port. "pipe" means listen to stdin output to stdout, an integer is base port number, "disabled" disables the gdb server.

Chapter 7: Server Configuration | 34

When using "pipe", also use log output to redirect the log output to a file so as not to flood the stdin/out pipes.

Any other string is interpreted as named pipe to listen to. Output pipe is the same name as input pipe, but with ’o’ appended, e.g. /var/gdb, /var/gdbo.

The GDB port for the first target will be the base port, the second target will listen on gdb port + 1, and so on. When not specified during the configuration stage, the port number defaults to 3333. When number is not a numeric value, incrementing it to compute the next port number does not work. In this case, specify the proper number for each target by using the option -gdb-port of the commands target create or $target_name configure. See [option -gdb-port], page 73.
Note: when using "gdb port pipe", increasing the default remote timeout in gdb (with ’set remotetimeout’) is recommended. An insufficient timeout may cause initialization to fail with "Unknown remote qXfer reply: OK".
tcl_port [number] | [Config Command]
Specify or query the port used for a simplified RPC connection that can be used by clients to issue TCL commands and get the output from the Tcl engine. Intended as a machine interface. When not specified during the configuration stage, the port number defaults to 6666. When specified as "disabled", this service is not activated.
telnet_port [number] | [Config Command]
Specify or query the port on which to listen for incoming telnet connections. This port is intended for interaction with one human through TCL commands. When not specified during the configuration stage, the port number defaults to 4444. When specified as "disabled", this service is not activated.

## 7.4 GDB Configuration

You can reconfigure some GDB behaviors if needed. The ones listed here are static and global. See [Target Configuration], page 71, about configuring individual targets. See [Target Events], page 75, about configuring target-specific event handling.

gdb_breakpoint_override [hard|soft|disable] | [Command]
Force breakpoint type for gdb break commands. This option supports GDB GUIs which don’t distinguish hard versus soft breakpoints, if the default OpenOCD and GDB behaviour is not sufficient. GDB normally uses hardware breakpoints if the memory map has been set up for flash regions.
gdb_flash_program (enable|disable) | [Config Command]
Set to enable to cause OpenOCD to program the flash memory when a vFlash packet is received. The default behaviour is enable.
gdb_memory_map (enable|disable) | [Config Command]
Set to enable to cause OpenOCD to send the memory configuration to GDB when requested. GDB will then know when to set hardware breakpoints, and program flash using the GDB load command. gdb_flash_program enable must also be enabled for flash programming to work. Default behaviour is enable. See [gdb flash program], page 34.

Chapter 7: Server Configuration | 35
gdb_report_data_abort (enable|disable) | [Config Command]
Specifies whether data aborts cause an error to be reported by GDB memory read packets. The default behaviour is disable; use enable see these errors reported.
gdb_report_register_access_error (enable|disable) | [Config Command]
Specifies whether register accesses requested by GDB register read/write packets report errors or not. The default behaviour is disable; use enable see these errors reported.
gdb_target_description (enable|disable) | [Config Command]
Set to enable to cause OpenOCD to send the target descriptions to gdb via qXfer:features:read packet. The default behaviour is enable.
gdb_save_tdesc | [Command]
Saves the target description file to the local file system.
The file name is target name.xml.

## 7.5 Event Polling

Hardware debuggers are parts of asynchronous systems, where significant events can happen at any time. The OpenOCD server needs to detect some of these events, so it can report them to through TCL command line or to GDB.
Examples of such events include:
- One of the targets can stop running ... maybe it triggers a code breakpoint or data watchpoint, or halts itself.
- Messages may be sent over “debug message” channels ... many targets support such messages sent over JTAG, for receipt by the person debugging or tools.
- Loss of power ... some adapters can detect these events.
- Resets not issued through JTAG ... such reset sources can include button presses or other system hardware, sometimes including the target itself (perhaps through a watchdog).
- Debug instrumentation sometimes supports event triggering such as “trace buffer full” (so it can quickly be emptied) or other signals (to correlate with code behavior).

None of those events are signaled through standard JTAG signals. However, most conventions for JTAG connectors include voltage level and system reset (SRST) signal detection. Some connectors also include instrumentation signals, which can imply events when those signals are inputs.
In general, OpenOCD needs to periodically check for those events, either by looking at the status of signals on the JTAG connector or by sending synchronous “tell me your status” JTAG requests to the various active targets. There is a command to manage and monitor that polling, which is normally done in the background.
poll [on|off] | [Command]
Poll the current target for its current state. (Also, see [target curstate], page 75.) If that target is in debug mode, architecture specific information about the current state is printed. An optional parameter allows background polling to be enabled and disabled.

Chapter 7: Server Configuration | 36

You could use this from the TCL command shell, or from GDB using monitor poll command. Leave background polling enabled while you’re using GDB.

> poll
background polling: on
target state: halted
target halted in ARM state due to debug-request, \ current mode: Supervisor
cpsr: 0x800000d3 pc: 0x11081bfc
MMU: disabled, D-Cache: disabled, I-Cache: enabled >

37

## 8 Debug Adapter Configuration

Correctly installing OpenOCD includes making your operating system give OpenOCD access to debug adapters. Once that has been done, Tcl commands are used to select which one is used, and to configure how it is used.
Note: Because OpenOCD started out with a focus purely on JTAG, you may find places where it wrongly presumes JTAG is the only transport protocol in use. Be aware that recent versions of OpenOCD are removing that limitation. JTAG remains more functional than most other transports. Other transports do not support boundary scan operations, or may be specific to a given chip vendor. Some might be usable only for programming flash memory, instead of also for debugging.
Debug Adapters/Interfaces/Dongles are normally configured through commands in an interface configuration file which is sourced by your openocd.cfg file, or through a command line -f interface/....cfg option.
source [find interface/olimex-jtag-tiny.cfg]
These commands tell OpenOCD what type of JTAG adapter you have, and how to talk to it. A few cases are so simple that you only need to say what driver to use:

# jlink interface

adapter driver jlink
Most adapters need a bit more configuration than that.

## 8.1 Adapter Configuration

The adapter driver command tells OpenOCD what type of debug adapter you are using. Depending on the type of adapter, you may need to use one or more additional commands to further identify or configure the adapter.

adapter driver name | [Config Command]
Use the adapter driver name to connect to the target.
adapter list | [Command]
List the debug adapter drivers that have been built into the running copy of OpenOCD.
adapter transports transport name+ | [Config Command]
Specifies the transports supported by this debug adapter. The adapter driver buildsin similar knowledge; use this only when external configuration (such as jumpering) changes what the hardware can support.
adapter name | [Command]
Returns the name of the debug adapter driver being used.
adapter usb location [<bus>-<port>[.<port>]...] | [Config Command]
Displays or specifies the physical USB port of the adapter to use. The path roots at bus and walks down the physical ports, with each port option specifying a deeper level in the bus topology, the last port denoting where the target adapter is actually plugged. The USB bus topology can be queried with the command lsusb -t or dmesg. This command is only available if your libusb1 is at least version 1.0.16.

Chapter 8: Debug Adapter Configuration | 38
adapter serial serial string | [Config Command]
Specifies the serial string of the adapter to use. If this command is not specified, serial strings are not checked. Only the following adapter drivers use the serial string from this command: aice (aice usb), arm-jtag-ew, cmsis dap, ft232r, ftdi, hla (stlink, ti-icdi), jlink, kitprog, opendus, openjtag, osbdm, presto, rlink, st-link, usb blaster (ublast2), usbprog, vsllink, xds110.

## 8.2 Interface Drivers

Each of the interface drivers listed here must be explicitly enabled when OpenOCD is configured, in order to be made available at run time.

amt_jtagaccel | [Interface Driver]
Amontec Chameleon in its JTAG Accelerator configuration, connected to a PC’s EPP mode parallel port. This defines some driver-specific commands:
parport port number | [Config Command]
Specifies either the address of the I/O port (default: 0x378 for LPT1) or the number of the /dev/parport device.
rtck [enable|disable] | [Config Command]
Displays status of RTCK option. Optionally sets that option first.
arm-jtag-ew | [Interface Driver]
Olimex ARM-JTAG-EW USB adapter This has one driver-specific command:
armjtagew_info | [Command]
Logs some status
at91rm9200 | [Interface Driver]
Supports bitbanged JTAG from the local system, presuming that system is an Atmel AT91rm9200 and a specific set of GPIOs is used.
cmsis-dap | [Interface Driver]
ARM CMSIS-DAP compliant based adapter v1 (USB HID based) or v2 (USB bulk).
cmsis_dap_vid_pid [vid pid]+ | [Config Command]
The vendor ID and product ID of the CMSIS-DAP device. If not specified the driver will attempt to auto detect the CMSIS-DAP device. Currently, up to eight [vid, pid] pairs may be given, e.g.

cmsis_dap_vid_pid 0xc251 0xf001 0x0d28 0x0204

cmsis_dap_backend [auto|usb_bulk|hid] | [Config Command]
Specifies how to communicate with the adapter:
− hid Use HID generic reports - CMSIS-DAP v1
− usb_bulk Use USB bulk - CMSIS-DAP v2
− auto First try USB bulk CMSIS-DAP v2, if not found try HID CMSIS-DAP v1. This is the default if cmsis_dap_backend is not specified.

Chapter 8: Debug Adapter Configuration | 39
cmsis_dap_usb interface [number] | [Config Command]
Specifies the number of the USB interface to use in v2 mode (USB bulk). In most cases need not to be specified and interfaces are searched by interface string or for user class interface.
cmsis-dap info | [Command]
Display various device information, like hardware version, firmware version, current bus status.
cmsis-dap cmd number number ... | [Command]
Execute an arbitrary CMSIS-DAP command. Use for adapter testing or for handling of an adapter vendor specific command from a Tcl script.
Take given numbers as bytes, assemble a CMSIS-DAP protocol command packet from them and send it to the adapter. The first 4 bytes of the adapter response are logged. See https://arm-software.github.io/CMSIS_5/DAP/html/group__DAP__Commands__gr.html (https://arm-software.github.io/CMSIS_5/DAP/html/group__DAP__Commands__gr.html)
dummy | [Interface Driver]
A dummy software-only driver for debugging.
ep93xx | [Interface Driver]
Cirrus Logic EP93xx based single-board computer bit-banging (in development)
ftdi | [Interface Driver]
This driver is for adapters using the MPSSE (Multi-Protocol Synchronous Serial Engine) mode built into many FTDI chips, such as the FT2232, FT4232 and FT232H.

The driver is using libusb-1.0 in asynchronous mode to talk to the FTDI device, bypassing intermediate libraries like libftdi.

Support for new FTDI based adapters can be added completely through configuration files, without the need to patch and rebuild OpenOCD.

The driver uses a signal abstraction to enable Tcl configuration files to define outputs for one or several FTDI GPIO. These outputs can then be controlled using the ftdi set_signal command. Special signal names are reserved for nTRST, nSRST and LED (for blink) so that they, if defined, will be used for their customary purpose. Inputs can be read using the ftdi get_signal command.
To support SWD, a signal named SWD EN must be defined. It is set to 1 when the SWD protocol is selected. When set, the adapter should route the SWDIO pin to the data input. An SWDIO OE signal, if defined, will be set to 1 or 0 as required by the protocol, to tell the adapter to drive the data output onto the SWDIO pin or keep the SWDIO pin Hi-Z, respectively.

Depending on the type of buffer attached to the FTDI GPIO, the outputs have to be controlled differently. In order to support tristateable signals such as nSRST, both a data GPIO and an output-enable GPIO can be specified for each signal. The following output buffer configurations are supported:
− Push-pull with one FTDI output as (non-)inverted data line
− Open drain with one FTDI output as (non-)inverted output-enable

Chapter 8: Debug Adapter Configuration | 40

− Tristate with one FTDI output as (non-)inverted data line and another FTDI output as (non-)inverted output-enable
− Unbuffered, using the FTDI GPIO as a tristate output directly by switching data and direction as necessary

These interfaces have several commands, used to configure the driver before initializing the JTAG scan chain:

ftdi vid_pid [vid pid]+ | [Config Command]
The vendor ID and product ID of the adapter. Up to eight [vid, pid] pairs may be given, e.g.

ftdi vid_pid 0x0403 0xcff8 0x15ba 0x0003

ftdi device_desc description | [Config Command]
Provides the USB device description (the iProduct string) of the adapter. If not specified, the device description is ignored during device selection.
ftdi channel channel | [Config Command]
Selects the channel of the FTDI device to use for MPSSE operations. Most adapters use the default, channel 0, but there are exceptions.
ftdi layout_init data direction | [Config Command]
Specifies the initial values of the FTDI GPIO data and direction registers. Each value is a 16-bit number corresponding to the concatenation of the high and low FTDI GPIO registers. The values should be selected based on the schematics of the adapter, such that all signals are set to safe levels with minimal impact on the target system. Avoid floating inputs, conflicting outputs and initially asserted reset signals.
ftdi layout_signal name [-data|-ndata data mask] | [Command]
[-input|-ninput input mask] [-oe|-noe oe mask] [-alias|-nalias name]
Creates a signal with the specified name, controlled by one or more FTDI GPIO pins via a range of possible buffer connections. The masks are FTDI GPIO register bitmasks to tell the driver the connection and type of the output buffer driving the respective signal. data mask is the bitmask for the pin(s) connected to the data input of the output buffer. -ndata is used with inverting data inputs and -data with non-inverting inputs. The -oe (or -noe) option tells where the output-enable (or not-output-enable) input to the output buffer is connected. The options -input and -ninput specify the bitmask for pins to be read with the method ftdi get_signal.
Both data mask and oe mask need not be specified. For example, a simple open-collector transistor driver would be specified with -oe only. In that case the signal can only be set to drive low or to Hi-Z and the driver will complain if the signal is set to drive high. Which means that if it’s a reset signal, reset_ config must be specified as srst_open_drain, not srst_push_pull.
A special case is provided when -data and -oe is set to the same bitmask. Then the FTDI pin is considered being connected straight to the target without any

Chapter 8: Debug Adapter Configuration | 41

buffer. The FTDI pin is then switched between output and input as necessary to provide the full set of low, high and Hi-Z characteristics. In all other cases, the pins specified in a signal definition are always driven by the FTDI.
If -alias or -nalias is used, the signal is created identical (or with data inverted) to an already specified signal name.
ftdi set_signal name 0|1|z | [Command]
Set a previously defined signal to the specified level.
− 0, drive low
− 1, drive high
− z, set to high-impedance
ftdi get_signal name | [Command]
Get the value of a previously defined signal.
ftdi tdo_sample_edge rising|falling | [Command]
Configure TCK edge at which the adapter samples the value of the TDO signal Due to signal propagation delays, sampling TDO on rising TCK can become quite peculiar at high JTAG clock speeds. However, FTDI chips offer a possibility to sample TDO on falling edge of TCK. With some board/adapter configurations, this may increase stability at higher JTAG clocks.
− rising, sample TDO on rising edge of TCK - this is the default
− falling, sample TDO on falling edge of TCK

For example adapter definitions, see the configuration files shipped in the interface/ftdi directory.

ft232r | [Interface Driver]
This driver is implementing synchronous bitbang mode of an FTDI FT232R, FT230X, FT231X and similar USB UART bridge ICs by reusing RS232 signals as GPIO. It currently doesn’t support using CBUS pins as GPIO.
List of connections (default physical pin numbers for FT232R in 28-pin SSOP package):
− RXD(5) - TDI
− TXD(1) - TCK
− RTS(3) - TDO
− CTS(11) - TMS
− DTR(2) - TRST
− DCD(10) - SRST

User can change default pinout by supplying configuration commands with GPIO numbers or RS232 signal names. GPIO numbers correspond to bit numbers in FTDI GPIO register. They differ from physical pin numbers. For details see actual FTDI chip datasheets. Every JTAG line must be configured to unique GPIO number different than any other JTAG line, even those lines that are sometimes not used like TRST or SRST.

Chapter 8: Debug Adapter Configuration | 42

FT232R
− bit 7 - RI
− bit 6 - DCD
− bit 5 - DSR
− bit 4 - DTR
− bit 3 - CTS
− bit 2 - RTS
− bit 1 - RXD
− bit 0 - TXD

These interfaces have several commands, used to configure the driver before initializing the JTAG scan chain:

ft232r vid_pid vid pid | [Config Command]
The vendor ID and product ID of the adapter. | If not specified, default
0x0403:0x6001 is used.
ft232r jtag_nums tck tms tdi tdo | [Config Command]
Set four JTAG GPIO numbers at once. If not specified, default 0 3 1 2 or TXD CTS RXD RTS is used.
ft232r tck_num tck | [Config Command]
Set TCK GPIO number. If not specified, default 0 or TXD is used.
ft232r tms_num tms | [Config Command]
Set TMS GPIO number. If not specified, default 3 or CTS is used.
ft232r tdi_num tdi | [Config Command]
Set TDI GPIO number. If not specified, default 1 or RXD is used.
ft232r tdo_num tdo | [Config Command]
Set TDO GPIO number. If not specified, default 2 or RTS is used.
ft232r trst_num trst | [Config Command]
Set TRST GPIO number. If not specified, default 4 or DTR is used.
ft232r srst_num srst | [Config Command]
Set SRST GPIO number. If not specified, default 6 or DCD is used.
ft232r restore_serial word | [Config Command]
Restore serial port after JTAG. This USB bitmode control word (16-bit) will be sent before quit. Lower byte should set GPIO direction register to a "sane" state: 0x15 for TXD RTS DTR as outputs (1), others as inputs (0). Higher byte is usually 0 to disable bitbang mode. When kernel driver reattaches, serial port should continue to work. Value 0xFFFF disables sending control word and serial port, then kernel driver will not reattach. If not specified, default 0xFFFF is used.

Chapter 8: Debug Adapter Configuration | 43
remote_bitbang | [Interface Driver]
Drive JTAG from a remote process. This sets up a UNIX or TCP socket connection with a remote process and sends ASCII encoded bitbang requests to that process instead of directly driving JTAG.

The remote bitbang driver is useful for debugging software running on processors which are being simulated.

remote_bitbang port number | [Config Command]
Specifies the TCP port of the remote process to connect to or 0 to use UNIX sockets instead of TCP.
remote_bitbang host hostname | [Config Command]
Specifies the hostname of the remote process to connect to using TCP, or the name of the UNIX socket to use if remote bitbang port is 0.

For example, to connect remotely via TCP to the host foobar you might have something like:

adapter driver remote_bitbang
remote_bitbang port 3335
remote_bitbang host foobar
To connect to another process running locally via UNIX sockets with socket named mysocket:

adapter driver remote_bitbang
remote_bitbang port 0
remote_bitbang host mysocket
usb_blaster | [Interface Driver]
USB JTAG/USB-Blaster compatibles over one of the userspace libraries for FTDI chips. These interfaces have several commands, used to configure the driver before initializing the JTAG scan chain:
usb_blaster vid_pid vid pid | [Config Command]
The vendor ID and product ID of the FTDI FT245 device. If not specified, default values are used. Currently, only one vid, pid pair may be given, e.g. for Altera USB-Blaster (default):

usb_blaster vid_pid 0x09FB 0x6001
The following VID/PID is for Kolja Waschk’s USB JTAG:

usb_blaster vid_pid 0x16C0 0x06AD

usb_blaster pin (pin6|pin8) (0|1|s|t) | [Command]
Sets the state or function of the unused GPIO pins on USB-Blasters (pins 6 and 8 on the female JTAG header). These pins can be used as SRST and/or TRST provided the appropriate connections are made on the target board.

For example, to use pin 6 as SRST:

usb_blaster pin pin6 s
reset_config srst_only

Chapter 8: Debug Adapter Configuration | 44
usb_blaster lowlevel_driver (ftdi|ublast2) | [Config Command]
Chooses the low level access method for the adapter. If not specified, ftdi is selected unless it wasn’t enabled during the configure stage. USB-Blaster II needs ublast2.
usb_blaster firmware path | [Config Command]
This command specifies path to access USB-Blaster II firmware image. To be used with USB-Blaster II only.
gw16012 | [Interface Driver]
Gateworks GW16012 JTAG programmer. This has one driver-specific command:
parport port [port number] | [Config Command]
Display either the address of the I/O port (default: 0x378 for LPT1) or the number of the /dev/parport device. If a parameter is provided, first switch to use that port. This is a write-once setting.
jlink | [Interface Driver]
SEGGER J-Link family of USB adapters. It currently supports JTAG and SWD transports.
Compatibility Note: SEGGER released many firmware versions for the many hardware versions they produced. OpenOCD was extensively tested and intended to run on all of them, but some combinations were reported as incompatible. As a general recommendation, it is advisable to use the latest firmware version available for each hardware version. However the current V8 is a moving target, and SEGGER firmware versions released after the OpenOCD was released may not be compatible. In such cases it is recommended to revert to the last known functional version. For 0.5.0, this is from "Feb 8 2012 14:30:39", packed with 4.42c. For 0.6.0, the last known version is from "May 3 2012 18:36:22", packed with 4.46f.
jlink hwstatus | [Command]
Display various hardware related information, for example target voltage and pin states.
jlink freemem | [Command]
Display free device internal memory.
jlink jtag [2|3] | [Command]
Set the JTAG command version to be used. Without argument, show the actual JTAG command version.
jlink config | [Command]
Display the device configuration.
jlink config targetpower [on|off] | [Command]
Set the target power state on JTAG-pin 19. Without argument, show the target power state.

Chapter 8: Debug Adapter Configuration | 45
jlink config mac [ff:ff:ff:ff:ff:ff] | [Command]
Set the MAC address of the device. Without argument, show the MAC address.
jlink config ip [A.B.C.D(/E|F.G.H.I)] | [Command]
Set the IP configuration of the device, where A.B.C.D is the IP address, E the bit of the subnet mask and F.G.H.I the subnet mask. Without arguments, show the IP configuration.
jlink config usb [0 to 3] | [Command]
Set the USB address of the device. This will also change the USB Product ID (PID) of the device. Without argument, show the USB address.
jlink config reset | [Command]
Reset the current configuration.
jlink config write | [Command]
Write the current configuration to the internal persistent storage.
jlink emucom write <channel> <data> | [Command]
Write data to an EMUCOM channel. The data needs to be encoded as hexadecimal pairs.
The following example shows how to write the three bytes 0xaa, 0x0b and 0x23 to the EMUCOM channel 0x10:

> jlink emucom write 0x10 aa0b23

jlink emucom read <channel> <length> | [Command]
Read data from an EMUCOM channel. The read data is encoded as hexadecimal pairs.
The following example shows how to read 4 bytes from the EMUCOM channel 0x0:

> jlink emucom read 0x0 4
77a90000
jlink usb <0 to 3> | [Config Command]
Set the USB address of the interface, in case more than one adapter is connected to the host. If not specified, USB addresses are not considered. Device selection via USB address is not always unambiguous. It is recommended to use the serial number instead, if possible.
As a configuration command, it can be used only before ’init’.
kitprog | [Interface Driver]
This driver is for Cypress Semiconductor’s KitProg adapters. The KitProg is an SWD-only adapter that is designed to be used with Cypress’s PSoC and PRoC device families, but it is possible to use it with some other devices. If you are using this adapter with a PSoC or a PRoC, you may need to add kitprog_init_acquire_psoc or kitprog acquire_psoc to your configuration script.
Note that this driver is for the proprietary KitProg protocol, not the CMSIS-DAP mode introduced in firmware 2.14. If the KitProg is in CMSIS-DAP mode, it cannot

Chapter 8: Debug Adapter Configuration | 46

be used with this driver, and must either be used with the cmsis-dap driver or switched back to KitProg mode. See the Cypress KitProg User Guide for instructions on how to switch KitProg modes.
Known limitations:
- The frequency of SWCLK cannot be configured, and varies between 1.6 MHz and 2.7 MHz.
- For firmware versions below 2.14, "JTAG to SWD" sequences are replaced by "SWD line reset" in the driver. This is for two reasons. First, the KitProg does not support sending arbitrary SWD sequences, and only firmware 2.14 and later implement both "JTAG to SWD" and "SWD line reset" in firmware. Earlier firmware versions only implement "SWD line reset". Second, due to a firmware quirk, an SWD sequence must be sent after every target reset in order to reestablish communications with the target.
- Due in part to the limitation above, KitProg devices with firmware below version 2.14 will need to use kitprog_init_acquire_psoc in order to communicate with PSoC 5LP devices. This is because, assuming debug is not disabled on the PSoC, the PSoC 5LP needs its JTAG interface switched to SWD mode before communication can begin, but prior to firmware 2.14, "JTAG to SWD" could only be sent with an acquisition sequence.
kitprog_init_acquire_psoc | [Config Command]
Indicate that a PSoC acquisition sequence needs to be run during adapter init. Please be aware that the acquisition sequence hard-resets the target.
kitprog acquire_psoc | [Command]
Run a PSoC acquisition sequence immediately. Typically, this should not be used outside of the target-specific configuration scripts since it hard-resets the target as a side-effect. This is necessary for "reset halt" on some PSoC 4 series devices.
kitprog info | [Command]
Display various adapter information, such as the hardware version, firmware version, and target voltage.
parport | [Interface Driver]
Supports PC parallel port bit-banging cables: Wigglers, PLD download cable, and more. These interfaces have several commands, used to configure the driver before initializing the JTAG scan chain:
parport cable name | [Config Command]
Set the layout of the parallel port cable used to connect to the target. This is a write-once setting. Currently valid cable name values include:
− altium Altium Universal JTAG cable.
− arm-jtag Same as original wiggler except SRST and TRST connections reversed and TRST is also inverted.
− chameleon The Amontec Chameleon’s CPLD when operated in configuration mode. This is only used to program the Chameleon itself, not a connected target.

Chapter 8: Debug Adapter Configuration | 47

− dlc5 The Xilinx Parallel cable III.
− flashlink The ST Parallel cable.
− lattice Lattice ispDOWNLOAD Cable
− old amt wiggler The Wiggler configuration that comes with some versions of Amontec’s Chameleon Programmer. The new version available from the website uses the original Wiggler layout (’wiggler’)
− triton The parallel port adapter found on the “Karo Triton 1 Development Board”. This is also the layout used by the HollyGates design (see http://www.lartmaker.nl/projects/jtag/).
− wiggler The original Wiggler layout, also supported by several clones, such as the Olimex ARM-JTAG
− wiggler2 Same as original wiggler except an led is fitted on D5.
− wiggler ntrst inverted Same as original wiggler except TRST is inverted.
parport port [port number] | [Config Command]
Display either the address of the I/O port (default: 0x378 for LPT1) or the number of the /dev/parport device. If a parameter is provided, first switch to use that port. This is a write-once setting.
When using PPDEV to access the parallel port, use the number of the parallel port: parport port 0 (the default). If parport port 0x378 is specified you may encounter a problem.
parport toggling_time [nanoseconds] | [Config Command]
Displays how many nanoseconds the hardware needs to toggle TCK; the parport driver uses this value to obey the adapter speed configuration. When the optional nanoseconds parameter is given, that setting is changed before displaying the current value.
The default setting should work reasonably well on commodity PC hardware. However, you may want to calibrate for your specific hardware.
Tip: To measure the toggling time with a logic analyzer or a digital storage oscilloscope, follow the procedure below:

> parport toggling_time 1000
> adapter speed 500
This sets the maximum JTAG clock speed of the hardware, but the actual speed probably deviates from the requested 500 kHz. Now, measure the time between the two closest spaced TCK transitions. You can use runtest 1000 or something similar to generate a large set of samples. Update the setting to match your measurement:

> parport toggling_time <measured nanoseconds> Now the clock speed will be a better match for adapter speed command given in OpenOCD scripts and event handlers.
You can do something similar with many digital multimeters, but note that you’ll probably need to run the clock continuously for several seconds before it decides what clock rate to show. Adjust

Chapter 8: Debug Adapter Configuration | 48

the toggling time up or down until the measured clock rate is a good match with the rate you specified in the adapter speed command; be conservative.

parport write_on_exit (on|off) | [Config Command]
This will configure the parallel driver to write a known cable-specific value to the parallel interface on exiting OpenOCD.

For example, the interface configuration file for a classic “Wiggler” cable on LPT2 might look something like this:

adapter driver parport
parport port 0x278
parport cable wiggler
presto | [Interface Driver]
ASIX PRESTO USB JTAG programmer.
rlink | [Interface Driver]
Raisonance RLink USB adapter
usbprog | [Interface Driver]
usbprog is a freely programmable USB adapter.
vsllink | [Interface Driver]
vsllink is part of Versaloon which is a versatile USB programmer.
Note: This defines quite a few driver-specific commands, which are not currently documented here.
hla | [Interface Driver]
This is a driver that supports multiple High Level Adapters. This type of adapter does not expose some of the lower level api’s that OpenOCD would normally use to access the target.
Currently supported adapters include the STMicroelectronics ST-LINK, TI ICDI and Nuvoton Nu-Link. ST-LINK firmware version >= V2.J21.S4 recommended due to issues with earlier versions of firmware where serial number is reset after first use. Suggest using ST firmware update utility to upgrade ST-LINK firmware even if current version reported is V2.J21.S4.
hla_device_desc description | [Config Command]
Currently Not Supported.
hla_layout (stlink|icdi|nulink) | [Config Command]
Specifies the adapter layout to use.
hla_vid_pid [vid pid]+ | [Config Command]
Pairs of vendor IDs and product IDs of the device.
hla_stlink_backend (usb | tcp [port]) | [Config Command]
ST-Link only: Choose between ’exclusive’ USB communication (the default backend) or ’shared’ mode using ST-Link TCP server (the default port is 7184).

Chapter 8: Debug Adapter Configuration | 49
Note: | ST-Link TCP server is a binary application provided by ST
available from ST-LINK server software module (https://www.st.com/en/development-tools/st-link-server.html). (https://www.st.com/en/development-tools/st-link-server.html)
hla_command command | [Command]
Execute a custom adapter-specific command. The command string is passed as is to the underlying adapter layout handler.
st-link | [Interface Driver]
This is a driver that supports STMicroelectronics adapters ST-LINK/V2 (from firmware V2J24) and STLINK-V3, thanks to a new API that provides directly access the arm ADIv5 DAP.
The new API provide access to multiple AP on the same DAP, but the maximum number of the AP port is limited by the specific firmware version (e.g. firmware V2J29 has 3 as maximum AP number, while V2J32 has 8). An error is returned for any AP number above the maximum allowed value.
Note: Either these same adapters and their older versions are also supported by [hla interface], page 48.
st-link backend (usb | tcp [port]) | [Config Command]
Choose between ’exclusive’ USB communication (the default backend) or ’shared’ mode using ST-Link TCP server (the default port is 7184).

Note: ST-Link TCP server is a binary application provided by ST available from ST-LINK server software module (https://www.st.com/en/development-tools/st-link-server.html). (https://www.st.com/en/development-tools/st-link-server.html)

Note: ST-Link TCP server does not support the SWIM transport.

st-link vid_pid [vid pid]+ | [Config Command]
Pairs of vendor IDs and product IDs of the device.
st-link cmd rx n (tx byte)+ | [Command]
Sends an arbitrary command composed by the sequence of bytes tx byte and receives rx n bytes.
For example, the command to read the target’s supply voltage is one byte 0xf7 followed by 15 bytes zero. It returns 8 bytes, where the first 4 bytes represent the ADC sampling of the reference voltage 1.2V and the last 4 bytes represent the ADC sampling of half the target’s supply voltage.

> st-link cmd 8 0xf7 0 0 0 0 0 0 0 0 0 0 0 0 0 0 0
0xf1 0x05 0x00 0x00 0x0b 0x08 0x00 0x00
The result can be converted to Volts (ignoring the most significant bytes, always
zero)

> set a [st-link cmd 8 0xf7 0 0 0 0 0 0 0 0 0 0 0 0 0 0 0]
> echo [expr 2*1.2*([lindex $a 4]+256*[lindex $a 5])/([lindex $a 0]+256*[lindex $a 1])] 3.24891518738
opendous | [Interface Driver]
opendous-jtag is a freely programmable USB adapter.

Chapter 8: Debug Adapter Configuration | 50
ulink | [Interface Driver]
This is the Keil ULINK v1 JTAG debugger.
xds110 | [Interface Driver]
The XDS110 is included as the embedded debug probe on many Texas Instruments LaunchPad evaluation boards. The XDS110 is also available as a stand-alone USB debug probe with the added capability to supply power to the target board. The following commands are supported by the XDS110 driver:
xds110 supply voltage in millivolts | [Config Command]
Available only on the XDS110 stand-alone probe. Sets the voltage level of the XDS110 power supply. A value of 0 leaves the supply off. Otherwise, the supply can be set to any value in the range 1800 to 3600 millivolts.
xds110 info | [Command]
Displays information about the connected XDS110 debug probe (e.g. firmware version).
xlnx_pcie_xvc | [Interface Driver]
This driver supports the Xilinx Virtual Cable (XVC) over PCI Express. It is commonly found in Xilinx based PCI Express designs. It allows debugging fabric based JTAG/SWD devices such as Cortex-M1/M3 microcontrollers. Access to this is exposed via extended capability registers in the PCI Express configuration space.

For more information see Xilinx PG245 (Section on From PCIE to JTAG mode).

xlnx_pcie_xvc config device | [Config Command]
Specifies the PCI Express device via parameter device to use.

The correct value for device can be obtained by looking at the output of lscpi -D (first column) for the corresponding device.

The string will be of the format "DDDD:BB:SS.F" such as "0000:65:00.1".

bcm2835gpio | [Interface Driver]
This SoC is present in Raspberry Pi which is a cheap single-board computer exposing some GPIOs on its expansion header.

The driver accesses memory-mapped GPIO peripheral registers directly for maximum performance, but the only possible race condition is for the pins’ modes/muxing (which is highly unlikely), so it should be able to coexist nicely with both sysfs bitbanging and various peripherals’ kernel drivers. The driver restores the previous configuration on exit.

GPIO numbers >= 32 can’t be used for performance reasons.

See interface/raspberrypi-native.cfg for a sample config and pinout.

bcm2835gpio jtag_nums tck tms tdi tdo | [Config Command]
Set JTAG transport GPIO numbers for TCK, TMS, TDI, and TDO (in that order). Must be specified to enable JTAG transport. These pins can also be specified individually.

Chapter 8: Debug Adapter Configuration | 51
bcm2835gpio tck_num tck | [Config Command]
Set TCK GPIO number. Must be specified to enable JTAG transport. Can also be specified using the configuration command bcm2835gpio jtag_nums.
bcm2835gpio tms_num tms | [Config Command]
Set TMS GPIO number. Must be specified to enable JTAG transport. Can also be specified using the configuration command bcm2835gpio jtag_nums.
bcm2835gpio tdo_num tdo | [Config Command]
Set TDO GPIO number. Must be specified to enable JTAG transport. Can also be specified using the configuration command bcm2835gpio jtag_nums.
bcm2835gpio tdi_num tdi | [Config Command]
Set TDI GPIO number. Must be specified to enable JTAG transport. Can also be specified using the configuration command bcm2835gpio jtag_nums.
bcm2835gpio swd_nums swclk swdio | [Config Command]
Set SWD transport GPIO numbers for SWCLK and SWDIO (in that order). Must be specified to enable SWD transport. These pins can also be specified individually.
bcm2835gpio swclk_num swclk | [Config Command]
Set SWCLK GPIO number. Must be specified to enable SWD transport. Can also be specified using the configuration command bcm2835gpio swd_nums.
bcm2835gpio swdio_num swdio | [Config Command]
Set SWDIO GPIO number. Must be specified to enable SWD transport. Can also be specified using the configuration command bcm2835gpio swd_nums.
bcm2835gpio swdio_dir_num swdio dir | [Config Command]
Set SWDIO direction control pin GPIO number. If specified, this pin can be used to control the direction of an external buffer on the SWDIO pin (set=output mode, clear=input mode). If not specified, this feature is disabled.
bcm2835gpio srst_num srst | [Config Command]
Set SRST GPIO number. Must be specified to enable SRST.
bcm2835gpio trst_num trst | [Config Command]
Set TRST GPIO number. Must be specified to enable TRST.
bcm2835gpio speed_coeffs speed_coeff | [Config Command]
speed_offset
Set SPEED COEFF and SPEED OFFSET for delay calculations. If unspecified, speed coeff defaults to 113714, and speed offset defaults to 28.
bcm2835gpio peripheral_base base | [Config Command]
Set the peripheral base register address to access GPIOs. For the RPi1, use 0x20000000. For RPi2 and RPi3, use 0x3F000000. For RPi4, use 0xFE000000. A full list can be found in the official guide (https://www.raspberrypi.org/documentation/hardware/raspberrypi/peripheral_addresses.md). (https://www.raspberrypi.org/documentation/hardware/raspberrypi/peripheral_addresses.md)

Chapter 8: Debug Adapter Configuration | 52
imx_gpio | [Interface Driver]
i.MX SoC is present in many community boards. Wandboard is an example of the one which is most popular.
This driver is mostly the same as bcm2835gpio.
See interface/imx-native.cfg for a sample config and pinout.
linuxgpiod | [Interface Driver]
Linux provides userspace access to GPIO through libgpiod since Linux kernel version v4.6. The driver emulates either JTAG and SWD transport through bitbanging.

See interface/dln-2-gpiod.cfg for a sample config.

sysfsgpio | [Interface Driver]
Linux legacy userspace access to GPIO through sysfs is deprecated from Linux kernel version v5.3. Prefer using linuxgpiod, instead.

See interface/sysfsgpio-raspberrypi.cfg for a sample config.

openjtag | [Interface Driver]
OpenJTAG compatible USB adapter. This defines some driver-specific commands:
openjtag variant variant | [Config Command]
Specifies the variant of the OpenJTAG adapter (see http://www.openjtag.org/). (http://www.openjtag.org/) Currently valid variant values include:
− standard Standard variant (default).
− cy7c65215 Cypress CY7C65215 Dual Channel USB-Serial Bridge Controller (see http://www.cypress.com/?rID=82870).
openjtag device_desc string | [Config Command]
The USB device description string of the adapter. This value is only used with the standard variant.
jtag_dpi | [Interface Driver]
SystemVerilog Direct Programming Interface (DPI) compatible driver for JTAG devices in emulation. The driver acts as a client for the SystemVerilog DPI server interface.
jtag_dpi set_port port | [Config Command]
Specifies the TCP/IP port number of the SystemVerilog DPI server interface.
jtag_dpi set_address address | [Config Command]
Specifies the TCP/IP address of the SystemVerilog DPI server interface.
buspirate | [Interface Driver]
This driver is for the Bus Pirate (see http://dangerousprototypes.com/docs/Bus_Pirate) (http://dangerousprototypes.com/docs/Bus_Pirate) and compatible devices. It uses a simple data protocol over a serial port connection.
Most hardware development boards have a UART, a real serial port, or a virtual USB serial device, so this driver allows you to start building your own JTAG adapter without the complexity of a custom USB connection.

Chapter 8: Debug Adapter Configuration | 53
buspirate port serial port | [Config Command]
Specify the serial port’s filename. For example:
buspirate port /dev/ttyUSB0
buspirate speed (normal|fast) | [Config Command]
Set the communication speed to 115k (normal) or 1M (fast). For example:

buspirate speed normal

buspirate mode (normal|open-drain) | [Config Command]
Set the Bus Pirate output mode.
− In normal mode (push/pull), do not enable the pull-ups, and do not connect I/O header pin VPU to JTAG VREF.
− In open drain mode, you will then need to enable the pull-ups.

For example:

buspirate mode normal

buspirate pullup (0|1) | [Config Command]
Whether to connect (1) or not (0) the I/O header pin VPU (JTAG VREF) to the pull-up/pull-down resistors on MOSI (JTAG TDI), CLK (JTAG TCK), MISO (JTAG TDO) and CS (JTAG TMS). For example:

buspirate pullup 0

buspirate vreg (0|1) | [Config Command]
Whether to enable (1) or disable (0) the built-in voltage regulator, which can be used to supply power to a test circuit through I/O header pins +3V3 and +5V. For example:

buspirate vreg 0

buspirate led (0|1) | [Command]
Turns the Bus Pirate’s LED on (1) or off (0). For example:

buspirate led 1

## 8.3 Transport Configuration

As noted earlier, depending on the version of OpenOCD you use, and the debug adapter you are using, several transports may be available to communicate with debug targets (or perhaps to program flash memory).

transport list | [Command]
displays the names of the transports supported by this version of OpenOCD.
transport select transport_name | [Command]
Select which of the supported transports to use in this OpenOCD session.
When invoked with transport_name, attempts to select the named transport. The transport must be supported by the debug adapter hardware and by the version of OpenOCD you are using (including the adapter’s driver).
If no transport has been selected and no transport_name is provided, transport select auto-selects the first transport supported by the debug adapter.
transport select always returns the name of the session’s selected transport, if any.

Chapter 8: Debug Adapter Configuration | 54

### 8.3.1 JTAG Transport

JTAG is the original transport supported by OpenOCD, and most of the OpenOCD commands support it. JTAG transports expose a chain of one or more Test Access Points (TAPs), each of which must be explicitly declared. JTAG supports both debugging and boundary scan testing. Flash programming support is built on top of debug support. JTAG transport is selected with the command transport select jtag. Unless your adapter uses either [hla interface], page 48, (in which case the command is transport select hla_jtag) or [st link dap interface], page 49, (in which case the command is transport select dapdirect_jtag).

### 8.3.2 SWD Transport

SWD (Serial Wire Debug) is an ARM-specific transport which exposes one Debug Access Point (DAP, which must be explicitly declared. (SWD uses fewer signal wires than JTAG.) SWD is debug-oriented, and does not support boundary scan testing. Flash programming support is built on top of debug support. (Some processors support both JTAG and SWD.)

SWD transport is selected with the command transport select swd. Unless your adapter uses either [hla interface], page 48, (in which case the command is transport select hla_ swd) or [st link dap interface], page 49, (in which case the command is transport select dapdirect_swd).

swd newdap ... | [Config Command]
Declares a single DAP which uses SWD transport. Parameters are currently the same as "jtag newtap" but this is expected to change.

The newer SWD devices (SW-DP v2 or SWJ-DP v2) support the multi-drop extension of SWD protocol: two or more devices can be connected to one SWD adapter. SWD transport works in multi-drop mode if [dap create], page 67, is configured with both -dp-id and -instance-id parameters regardless how many DAPs are created.

Not all adapters and adapter drivers support SWD multi-drop. Only the following adapter drivers are SWD multi-drop capable: cmsis dap (use an adapter with CMSIS-DAP version 2.0), ftdi, all bitbang based.

### 8.3.3 SPI Transport

The Serial Peripheral Interface (SPI) is a general purpose transport which uses four wire signaling. Some processors use it as part of a solution for flash programming.

### 8.3.4 SWIM Transport

The Single Wire Interface Module (SWIM) is a low-pin-count debug protocol used by the STMicroelectronics MCU family STM8 and documented in the User Manual UM470 (https://www.st.com/resource/en/user_manual/cd00173911.pdf).

SWIM does not support boundary scan testing nor multiple cores.
The SWIM transport is selected with the command transport select swim.
The concept of TAPs does not fit in the protocol since SWIM does not implement a scan chain. Nevertheless, the current SW model of OpenOCD requires defining a virtual SWIM TAP through the command swim newtap basename tap_type. The TAP definition

Chapter 8: Debug Adapter Configuration | 55

must precede the target definition command target create target_name stm8 -chain-position basename.tap_type.

## 8.4 JTAG Speed

JTAG clock setup is part of system setup. It does not belong with interface setup since any interface only knows a few of the constraints for the JTAG clock speed. Sometimes the JTAG speed is changed during the target initialization process: (1) slow at reset, (2) program the CPU clocks, (3) run fast. Both the "slow" and "fast" clock rates are functions of the oscillators used, the chip, the board design, and sometimes power management software that may be active.
The speed used during reset, and the scan chain verification which follows reset, can be adjusted using a reset-start target event handler. It can then be reconfigured to a faster speed by a reset-init target event handler after it reprograms those CPU clocks, or manually (if something else, such as a boot loader, sets up those clocks). See [Target Events], page 75. When the initial low JTAG speed is a chip characteristic, perhaps because of a required oscillator speed, provide such a handler in the target config file. When that speed is a function of a board-specific characteristic such as which speed oscillator is used, it belongs in the board config file instead. In both cases it’s safest to also set the initial JTAG clock rate to that same slow speed, so that OpenOCD never starts up using a clock speed that’s faster than the scan chain can support.

jtag_rclk 3000
$_TARGET.cpu configure -event reset-start { jtag_rclk 3000 }
If your system supports adaptive clocking (RTCK), configuring JTAG to use that is probably the most robust approach. However, it introduces delays to synchronize clocks; so it may not be the fastest solution.
NOTE: Script writers should consider using jtag_rclk instead of adapter speed, but only for (ARM) cores and boards which support adaptive clocking.
adapter speed max speed kHz | [Command]
A non-zero speed is in KHZ. Hence: 3000 is 3mhz. JTAG interfaces usually support a limited number of speeds. The speed actually used won’t be faster than the speed specified.
Chip data sheets generally include a top JTAG clock rate. The actual rate is often a function of a CPU core clock, and is normally less than that peak rate. For example, most ARM cores accept at most one sixth of the CPU clock.
Speed 0 (khz) selects RTCK method. See [FAQ RTCK], page 173. If your system uses RTCK, you won’t need to change the JTAG clocking after setup. Not all interfaces, boards, or targets support “rtck”. If the interface device can not support it, an error is returned when you try to use RTCK.
jtag_rclk fallback speed kHz | [Function]
This Tcl proc (defined in startup.tcl) attempts to enable RTCK/RCLK. If that fails (maybe the interface, board, or target doesn’t support it), falls back to the specified frequency.

# Fall back to 3mhz if RTCK is not supported

jtag_rclk 3000

56

## 9 Reset Configuration

Every system configuration may require a different reset configuration. This can also be quite confusing. Resets also interact with reset-init event handlers, which do things like setting up clocks and DRAM, and JTAG clock rates. (See [JTAG Speed], page 55.) They can also interact with JTAG routers. Please see the various board files for examples.

Note: To maintainers and integrators: Reset configuration touches several things at once. Normally the board configuration file should define it and assume that the JTAG adapter supports everything that’s wired up to the board’s JTAG connector.

However, the target configuration file could also make note of something the silicon vendor has done inside the chip, which will be true for most (or all) boards using that chip. And when the JTAG adapter doesn’t support everything, the user configuration file will need to override parts of the reset configuration provided by other files.

## 9.1 Types of Reset

There are many kinds of reset possible through JTAG, but they may not all work with a given board and adapter. That’s part of why reset configuration can be error prone.
- System Reset ... the SRST hardware signal resets all chips connected to the JTAG adapter, such as processors, power management chips, and I/O controllers. Normally resets triggered with this signal behave exactly like pressing a RESET button.
- JTAG TAP Reset ... the TRST hardware signal resets just the TAP controllers connected to the JTAG adapter. Such resets should not be visible to the rest of the system; resetting a device’s TAP controller just puts that controller into a known state.
- Emulation Reset ... many devices can be reset through JTAG commands. These resets are often distinguishable from system resets, either explicitly (a "reset reason" register says so) or implicitly (not all parts of the chip get reset).
- Other Resets ... system-on-chip devices often support several other types of reset. You may need to arrange that a watchdog timer stops while debugging, preventing a watchdog reset. There may be individual module resets.

In the best case, OpenOCD can hold SRST, then reset the TAPs via TRST and send commands through JTAG to halt the CPU at the reset vector before the 1st instruction is executed. Then when it finally releases the SRST signal, the system is halted under debugger control before any code has executed. This is the behavior required to support the reset halt and reset init commands; after reset init a board-specific script might do things like setting up DRAM. (See [Reset Command], page 126.)

## 9.2 SRST and TRST Issues

Because SRST and TRST are hardware signals, they can have a variety of system-specific constraints. Some of the most common issues are:
- Signal not available ... Some boards don’t wire SRST or TRST to the JTAG connector. Some JTAG adapters don’t support such signals even if they are wired up. Use the

Chapter 9: Reset Configuration | 57

reset_config signals options to say when either of those signals is not connected. When SRST is not available, your code might not be able to rely on controllers having been fully reset during code startup. Missing TRST is not a problem, since JTAG-level resets can be triggered using with TMS signaling.
- Signals shorted ... Sometimes a chip, board, or adapter will connect SRST to TRST, instead of keeping them separate. Use the reset_config combination options to say when those signals aren’t properly independent.
- Timing ... Reset circuitry like a resistor/capacitor delay circuit, reset supervisor, or on-chip features can extend the effect of a JTAG adapter’s reset for some time after the adapter stops issuing the reset. For example, there may be chip or board requirements that all reset pulses last for at least a certain amount of time; and reset buttons commonly have hardware debouncing. Use the adapter srst delay and jtag_ntrst_ delay commands to say when extra delays are needed.
- Drive type ... Reset lines often have a pullup resistor, letting the JTAG interface treat them as open-drain signals. But that’s not a requirement, so the adapter may need to use push/pull output drivers. Also, with weak pullups it may be advisable to drive signals to both levels (push/pull) to minimize rise times. Use the reset_config trst type and srst type parameters to say how to drive reset signals.
- Special initialization ... Targets sometimes need special JTAG initialization sequences to handle chip-specific issues (not limited to errata). For example, certain JTAG commands might need to be issued while the system as a whole is in a reset state (SRST active) but the JTAG scan chain is usable (TRST inactive). Many systems treat combined assertion of SRST and TRST as a trigger for a harder reset than SRST alone. Such custom reset handling is discussed later in this chapter.

There can also be other issues. Some devices don’t fully conform to the JTAG specifications. Trivial system-specific differences are common, such as SRST and TRST using slightly different names. There are also vendors who distribute key JTAG documentation for their chips only to developers who have signed a Non-Disclosure Agreement (NDA).

Sometimes there are chip-specific extensions like a requirement to use the normally-optional TRST signal (precluding use of JTAG adapters which don’t pass TRST through), or needing extra steps to complete a TAP reset.

In short, SRST and especially TRST handling may be very finicky, needing to cope with both architecture and board specific constraints.

## 9.3 Commands for Handling Resets

adapter srst pulse_width milliseconds | [Command]
Minimum amount of time (in milliseconds) OpenOCD should wait after asserting nSRST (active-low system reset) before allowing it to be deasserted.
adapter srst delay milliseconds | [Command]
How long (in milliseconds) OpenOCD should wait after deasserting nSRST (active-low system reset) before starting new JTAG operations. When a board has a reset button connected to SRST line it will probably have hardware debouncing, implying you should use this.

Chapter 9: Reset Configuration | 58
jtag_ntrst_assert_width milliseconds | [Command]
Minimum amount of time (in milliseconds) OpenOCD should wait after asserting nTRST (active-low JTAG TAP reset) before allowing it to be deasserted.
jtag_ntrst_delay milliseconds | [Command]
How long (in milliseconds) OpenOCD should wait after deasserting nTRST (active-low JTAG TAP reset) before starting new JTAG operations.
reset_config mode flag ... | [Command]
This command displays or modifies the reset configuration of your combination of JTAG board and target in target configuration scripts.
Information earlier in this section describes the kind of problems the command is intended to address (see [SRST and TRST Issues], page 56). As a rule this command belongs only in board config files, describing issues like board doesn’t connect TRST; or in user config files, addressing limitations derived from a particular combination of interface and board. (An unlikely example would be using a TRST-only adapter with a board that only wires up SRST.)

The mode flag options can be specified in any order, but only one of each type – signals, combination, gates, trst type, srst type and connect type – may be specified at a time. If you don’t provide a new value for a given type, its previous value (perhaps the default) is unchanged. For example, this means that you don’t need to say anything at all about TRST just to declare that if the JTAG adapter should want to drive SRST, it must explicitly be driven high (srst_push_pull).
- signals can specify which of the reset signals are connected. For example, If the JTAG interface provides SRST, but the board doesn’t connect that signal properly, then OpenOCD can’t use it. Possible values are none (the default), trst_only, srst_only and trst_and_srst.
Tip: If your board provides SRST and/or TRST through the JTAG connector, you must declare that so those signals can be used.
- The combination is an optional value specifying broken reset signal implementations. The default behaviour if no option given is separate, indicating everything behaves normally. srst_pulls_trst states that the test logic is reset together with the reset of the system (e.g. NXP LPC2000, "broken" board layout), trst_pulls_srst says that the system is reset together with the test logic (only hypothetical, I haven’t seen hardware with such a bug, and can be worked around). combined implies both srst_pulls_trst and trst_pulls_srst.
- The gates tokens control flags that describe some cases where JTAG may be unavailable during reset. srst_gates_jtag (default) indicates that asserting SRST gates the JTAG clock. This means that no communication can happen on JTAG while SRST is asserted. Its converse is srst_nogate, indicating that JTAG commands can safely be issued while SRST is active.
- The connect type tokens control flags that describe some cases where SRST is asserted while connecting to the target. srst_nogate is required to use this option. connect_deassert_srst (default) indicates that SRST will not be asserted while connecting to the target. Its converse is connect_assert_srst, indicating that SRST will be asserted before any target connection. Only some targets

Chapter 9: Reset Configuration | 59

support this feature, STM32 and STR9 are examples. This feature is useful if you are unable to connect to your target due to incorrect options byte config or illegal program execution.

The optional trst type and srst type parameters allow the driver mode of each reset line to be specified. These values only affect JTAG interfaces with support for different driver modes, like the Amontec JTAGkey and JTAG Accelerator. Also, they are necessarily ignored if the relevant signal (TRST or SRST) is not connected.

- Possible trst type driver modes for the test reset signal (TRST) are the default trst_push_pull, and trst_open_drain. Most boards connect this signal to a pulldown, so the JTAG TAPs never leave reset unless they are hooked up to a JTAG adapter.
- Possible srst type driver modes for the system reset signal (SRST) are the default srst_open_drain, and srst_push_pull. Most boards connect this signal to a pullup, and allow the signal to be pulled low by various events including system power-up and pressing a reset button.

## 9.4 Custom Reset Handling

OpenOCD has several ways to help support the various reset mechanisms provided by chip and board vendors. The commands shown in the previous section give standard parameters. There are also event handlers associated with TAPs or Targets. Those handlers are Tcl procedures you can provide, which are invoked at particular points in the reset sequence.

When SRST is not an option you must set up a reset-assert event handler for your target. For example, some JTAG adapters don’t include the SRST signal; and some boards have multiple targets, and you won’t always want to reset everything at once.

After configuring those mechanisms, you might still find your board doesn’t start up or reset correctly. For example, maybe it needs a slightly different sequence of SRST and/or TRST manipulations, because of quirks that the reset_config mechanism doesn’t address; or asserting both might trigger a stronger reset, which needs special attention.

Experiment with lower level operations, such as adapter assert, adapter deassert and the jtag arp_* operations shown here, to find a sequence of operations that works. See Chapter 17 [JTAG Commands], page 159. When you find a working sequence, it can be used to override jtag_init, which fires during OpenOCD startup (see [Configuration Stage], page 32); or init_reset, which fires during reset processing.

You might also want to provide some project-specific reset schemes. For example, on a multi-target board the standard reset command would reset all targets, but you may need the ability to reset only one target at time and thus want to avoid using the board-wide SRST signal.

init_reset mode | [Overridable Procedure]
This is invoked near the beginning of the reset command, usually to provide as much of a cold (power-up) reset as practical. By default it is also invoked from jtag_init if the scan chain does not respond to pure JTAG operations. The mode parameter is the parameter given to the low level reset command (halt, init, or run), setup, or potentially some other value.

Chapter 9: Reset Configuration | 60

The default implementation just invokes jtag arp_init-reset. Replacements will normally build on low level JTAG operations such as adapter assert and adapter deassert. Operations here must not address individual TAPs (or their associated targets) until the JTAG scan chain has first been verified to work.
Implementations must have verified the JTAG scan chain before they return. This is done by calling jtag arp_init (or jtag arp_init-reset).
jtag arp_init | [Command]
This validates the scan chain using just the four standard JTAG signals (TMS, TCK, TDI, TDO). It starts by issuing a JTAG-only reset. Then it performs checks to verify that the scan chain configuration matches the TAPs it can observe. Those checks include checking IDCODE values for each active TAP, and verifying the length of their instruction registers using TAP -ircapture and -irmask values. If these tests all pass, TAP setup events are issued to all TAPs with handlers for that event.
jtag arp_init-reset | [Command]
This uses TRST and SRST to try resetting everything on the JTAG scan chain (and anything else connected to SRST). It then invokes the logic of jtag arp_init.

61

## 10 TAP Declaration

Test Access Ports (TAPs) are the core of JTAG. TAPs serve many roles, including:
- Debug Target A CPU TAP can be used as a GDB debug target.
- Flash Programming Some chips program the flash directly via JTAG. Others do it indirectly, making a CPU do it.
- Program Download Using the same CPU support GDB uses, you can initialize a DRAM controller, download code to DRAM, and then start running that code.
- Boundary Scan Most chips support boundary scan, which helps test for board assembly problems like solder bridges and missing connections.

OpenOCD must know about the active TAPs on your board(s). Setting up the TAPs is the core task of your configuration files. Once those TAPs are set up, you can pass their names to code which sets up CPUs and exports them as GDB targets, probes flash memory, performs low-level JTAG operations, and more.

## 10.1 Scan Chains

TAPs are part of a hardware scan chain, which is a daisy chain of TAPs. They also need to be added to OpenOCD’s software mirror of that hardware list, giving each member a name and associating other data with it. Simple scan chains, with a single TAP, are common in systems with a single microcontroller or microprocessor. More complex chips may have several TAPs internally. Very complex scan chains might have a dozen or more TAPs: several in one chip, more in the next, and connecting to other boards with their own chips and TAPs.
You can display the list with the scan_chain command. (Don’t confuse this with the list displayed by the targets command, presented in the next chapter. That only displays TAPs for CPUs which are configured as debugging targets.) Here’s what the scan chain might look like for a chip more than one TAP:
TapName | Enabled IdCode | Expected | IrLen IrCap IrMask
0 omap5912.dsp | Y | 0x03df1d81 0x03df1d81 | 38 0x01 | 0x03
1 omap5912.arm | Y | 0x0692602f 0x0692602f | 4 0x01 | 0x0f
2 omap5912.unknown | Y | 0x00000000 0x00000000 | 8 0x01 | 0x03
OpenOCD can detect some of that information, but not all of it. See [Autoprobing], page 65. Unfortunately, those TAPs can’t always be autoconfigured, because not all devices provide good support for that. JTAG doesn’t require supporting IDCODE instructions, and chips with JTAG routers may not link TAPs into the chain until they are told to do so.
The configuration mechanism currently supported by OpenOCD requires explicit configuration of all TAP devices using jtag newtap commands, as detailed later in this chapter. A command like this would declare one tap and name it chip1.cpu:

jtag newtap chip1 cpu -irlen 4 -expected-id 0x3ba00477
Each target configuration file lists the TAPs provided by a given chip. Board configuration files combine all the targets on a board, and so forth. Note that the order in which TAPs are declared is very important. That declaration order must match the order in the JTAG scan chain, both inside a single chip and between them. See [FAQ TAP Order], page 176.

Chapter 10: TAP Declaration | 62

For example, the STMicroelectronics STR912 chip has three separate TAPs¹ . To configure
those taps, target/str912.cfg includes commands something like this:

jtag newtap str912 flash ... params ...
jtag newtap str912 cpu ... params ...
jtag newtap str912 bs ... params ...
Actual config files typically use a variable such as $_CHIPNAME instead of literals like str912, to support more than one chip of each type. See Chapter 6 [Config File Guidelines], page 21.
jtag names | [Command]
Returns the names of all current TAPs in the scan chain. Use jtag cget or jtag tapisenabled to examine attributes and state of each TAP.

foreach t [jtag names] {
puts [format "TAP: %s\n" $t] }
scan_chain | [Command]
Displays the TAPs in the scan chain configuration, and their status. The set of TAPs listed by this command is fixed by exiting the OpenOCD configuration stage, but systems with a JTAG router can enable or disable TAPs dynamically.

## 10.2 TAP Names

When TAP objects are declared with jtag newtap, a dotted.name is created for the TAP, combining the name of a module (usually a chip) and a label for the TAP. For example: xilinx.tap, str912.flash, omap3530.jrc, dm6446.dsp, or stm32.cpu. Many other commands use that dotted.name to manipulate or refer to the TAP. For example, CPU configuration uses the name, as does declaration of NAND or NOR flash banks.
The components of a dotted name should follow “C” symbol name rules: start with an alphabetic character, then numbers and underscores are OK; while others (including dots!) are not.

## 10.3 TAP Declaration Commands

jtag newtap chipname tapname configparams... | [Config Command]
Declares a new TAP with the dotted name chipname.tapname, and configured according to the various configparams.
The chipname is a symbolic name for the chip. Conventionally target config files use $_CHIPNAME, defaulting to the model name given by the chip vendor but overridable. The tapname reflects the role of that TAP, and should follow this convention:
- bs – For boundary scan if this is a separate TAP;
- cpu – The main CPU of the chip, alternatively arm and dsp on chips with both ARM and DSP CPUs, arm1 and arm2 on chips with two ARMs, and so forth;
- etb – For an embedded trace buffer (example: an ARM ETB11);

1 See the ST document titled: STR91xFAxxx, Section 3.15 Jtag Interface, Page: 28/102, Figure 3: JTAG chaining inside the STR91xFA. http://eu.st.com/stonline/products/literature/ds/13495.pdf

Chapter 10: TAP Declaration | 63
- flash – If the chip has a flash TAP, like the str912;
- jrc – For JTAG route controller (example: the ICEPick modules on many Texas Instruments chips, like the OMAP3530 on Beagleboards);
- tap – Should be used only for FPGA- or CPLD-like devices with a single TAP;
- unknownN – If you have no idea what the TAP is for (N is a number);
- when in doubt – Use the chip maker’s name in their data sheet. For example, the Freescale i.MX31 has a SDMA (Smart DMA) with a JTAG TAP; that TAP should be named sdma.

Every TAP requires at least the following configparams:

- -irlen NUMBER
The length in bits of the instruction register, such as 4 or 5 bits.

A TAP may also provide optional configparams:

- -disable (or -enable)
Use the -disable parameter to flag a TAP which is not linked into the scan chain after a reset using either TRST or the JTAG state machine’s reset state. You may use -enable to highlight the default state (the TAP is linked in). See [Enabling and Disabling TAPs], page 64.
- -expected-id NUMBER
A non-zero number represents a 32-bit IDCODE which you expect to find when the scan chain is examined. These codes are not required by all JTAG devices. Repeat the option as many times as required if more than one ID code could appear (for example, multiple versions). Specify number as zero to suppress warnings about IDCODE values that were found but not included in the list. Provide this value if at all possible, since it lets OpenOCD tell when the scan chain it sees isn’t right. These values are provided in vendors’ chip documentation, usually a technical reference manual. Sometimes you may need to probe the JTAG hardware to find these values. See [Autoprobing], page 65.
- -ignore-version
Specify this to ignore the JTAG version field in the -expected-id option. When vendors put out multiple versions of a chip, or use the same JTAG-level ID for several largely-compatible chips, it may be more practical to ignore the version field than to update config files to handle all of the various chip IDs. The version field is defined as bit 28-31 of the IDCODE.
- -ircapture NUMBER
The bit pattern loaded by the TAP into the JTAG shift register on entry to the ircapture state, such as 0x01. JTAG requires the two LSBs of this value to be 01. By default, -ircapture and -irmask are set up to verify that two-bit value. You may provide additional bits if you know them, or indicate that a TAP doesn’t conform to the JTAG specification.
- -irmask NUMBER
A mask used with -ircapture to verify that instruction scans work correctly. Such scans are not used by OpenOCD except to verify that there seems to be no problems with JTAG scan chain operations.

Chapter 10: TAP Declaration | 64
- -ignore-syspwrupack
Specify this to ignore the CSYSPWRUPACK bit in the ARM DAP DP CTRL/STAT register during initial examination and when checking the sticky error bit. This bit is normally checked after setting the CSYSPWRUPREQ bit, but some devices do not set the ack bit until sometime later.

## 10.4 Other TAP commands

jtag cget dotted.name -idcode | [Command]
Get the value of the IDCODE found in hardware.
jtag cget dotted.name -event event name | [Command]
jtag configure dotted.name -event event name handler | [Command]
At this writing this TAP attribute mechanism is limited and used mostly for event handling. (It is not a direct analogue of the cget/configure mechanism for debugger targets.) See the next section for information about the available events.

The configure subcommand assigns an event handler, a TCL string which is evaluated when the event is triggered. The cget subcommand returns that handler.

## 10.5 TAP Events

OpenOCD includes two event mechanisms. The one presented here applies to all JTAG TAPs. The other applies to debugger targets, which are associated with certain TAPs. The TAP events currently defined are:
- post-reset
The TAP has just completed a JTAG reset. The tap may still be in the JTAG reset state. Handlers for these events might perform initialization sequences such as issuing TCK cycles, TMS sequences to ensure exit from the ARM SWD mode, and more. Because the scan chain has not yet been verified, handlers for these events should not issue commands which scan the JTAG IR or DR registers of any particular target. NOTE: As this is written (September 2009), nothing prevents such access.
- setup
The scan chain has been reset and verified. This handler may enable TAPs as needed.
- tap-disable
The TAP needs to be disabled. This handler should implement jtag tapdisable by issuing the relevant JTAG commands.
- tap-enable
The TAP needs to be enabled. This handler should implement jtag tapenable by issuing the relevant JTAG commands.

If you need some action after each JTAG reset which isn’t actually specific to any TAP (since you can’t yet trust the scan chain’s contents to be accurate), you might:

jtag configure CHIP.jrc -event post-reset {
echo "JTAG Reset done"
... non-scan jtag operations to be done after reset }

Chapter 10: TAP Declaration | 65

## 10.6 Enabling and Disabling TAPs

In some systems, a JTAG Route Controller (JRC) is used to enable and/or disable specific JTAG TAPs. Many ARM-based chips from Texas Instruments include an “ICEPick” module, which is a JRC. Such chips include DaVinci and OMAP3 processors.

A given TAP may not be visible until the JRC has been told to link it into the scan chain; and if the JRC has been told to unlink that TAP, it will no longer be visible. Such routers address problems that JTAG “bypass mode” ignores, such as:

- The scan chain can only go as fast as its slowest TAP.
- Having many TAPs slows instruction scans, since all TAPs receive new instructions.
- TAPs in the scan chain must be powered up, which wastes power and prevents debugging some power management mechanisms.

The IEEE 1149.1 JTAG standard has no concept of a “disabled” tap, as implied by the existence of JTAG routers. However, the upcoming IEEE 1149.7 framework (layered on top of JTAG) does include a kind of JTAG router functionality.

In OpenOCD, tap enabling/disabling is invoked by the Tcl commands shown below, and is implemented using TAP event handlers. So for example, when defining a TAP for a CPU connected to a JTAG router, your target.cfg file should define TAP event handlers using code that looks something like this:

jtag configure CHIP.cpu -event tap-enable {
... jtag operations using CHIP.jrc
}
jtag configure CHIP.cpu -event tap-disable {
... jtag operations using CHIP.jrc
}

Then you might want that CPU’s TAP enabled almost all the time:

jtag configure $CHIP.jrc -event setup "jtag tapenable $CHIP.cpu"

Note how that particular setup event handler declaration uses quotes to evaluate $CHIP when the event is configured. Using brackets { } would cause it to be evaluated later, at runtime, when it might have a different value.

jtag tapdisable dotted.name | [Command]
If necessary, disables the tap by sending it a tap-disable event. Returns the string "1" if the tap specified by dotted.name is enabled, and "0" if it is disabled.
jtag tapenable dotted.name | [Command]
If necessary, enables the tap by sending it a tap-enable event. Returns the string "1" if the tap specified by dotted.name is enabled, and "0" if it is disabled.
jtag tapisenabled dotted.name | [Command]
Returns the string "1" if the tap specified by dotted.name is enabled, and "0" if it is disabled.

Note: Humans will find the scan_chain command more helpful for querying the state of the JTAG taps.

Chapter 10: TAP Declaration | 66

## 10.7 Autoprobing

TAP configuration is the first thing that needs to be done after interface and reset configuration. Sometimes it’s hard finding out what TAPs exist, or how they are identified. Vendor documentation is not always easy to find and use.

To help you get past such problems, OpenOCD has a limited autoprobing ability to look at the scan chain, doing a blind interrogation and then reporting the TAPs it finds. To use this mechanism, start the OpenOCD server with only data that configures your JTAG interface, and arranges to come up with a slow clock (many devices don’t support fast JTAG clocks right when they come out of reset).

For example, your openocd.cfg file might have:

source [find interface/olimex-arm-usb-tiny-h.cfg]
reset_config trst_and_srst
jtag_rclk 8
When you start the server without any TAPs configured, it will attempt to autoconfigure the TAPs. There are two parts to this:
1. TAP discovery ... After a JTAG reset (sometimes a system reset may be needed too), each TAP’s data registers will hold the contents of either the IDCODE or BYPASS register. If JTAG communication is working, OpenOCD will see each TAP, and report what -expected-id to use with it.
2. IR Length discovery ... Unfortunately JTAG does not provide a reliable way to find out the value of the -irlen parameter to use with a TAP that is discovered. If OpenOCD can discover the length of a TAP’s instruction register, it will report it. Otherwise you may need to consult vendor documentation, such as chip data sheets or BSDL files.

In many cases your board will have a simple scan chain with just a single device. Here’s what OpenOCD reported with one board that’s a bit more complex:

clock speed 8 kHz
There are no enabled taps. AUTO PROBING MIGHT NOT WORK!!
AUTO auto0.tap - use "jtag newtap auto0 tap -expected-id 0x2b900f0f ..." AUTO auto1.tap - use "jtag newtap auto1 tap -expected-id 0x07926001 ..." AUTO auto2.tap - use "jtag newtap auto2 tap -expected-id 0x0b73b02f ..." AUTO auto0.tap - use "... -irlen 4"
AUTO auto1.tap - use "... -irlen 4"
AUTO auto2.tap - use "... -irlen 6"
no gdb ports allocated as no target has been specified
Given that information, you should be able to either find some existing config files to use, or create your own. If you create your own, you would configure from the bottom up: first a target.cfg file with these TAPs, any targets associated with them, and any on-chip resources; then a board.cfg with off-chip resources, clocking, and so forth.

## 10.8 DAP declaration (ARMv6-M, ARMv7 and ARMv8 targets)

Since OpenOCD version 0.11.0, the Debug Access Port (DAP) is no longer implicitly created together with the target. It must be explicitly declared using the dap create command.

Chapter 10: TAP Declaration | 67

For all ARMv6-M, ARMv7 and ARMv8 targets, the option "-dap dap name" has to be used instead of "-chain-position dotted.name" when the target is created.
The dap command group supports the following sub-commands:
dap create dap name -chain-position dotted.name | [Command]
configparams...
Declare a DAP instance named dap name linked to the JTAG tap dotted.name. This also creates a new command (dap_name) which is used for various purposes including additional configuration. There can only be one DAP for each JTAG tap in the system.
A DAP may also provide optional configparams:
- -ignore-syspwrupack
Specify this to ignore the CSYSPWRUPACK bit in the ARM DAP DP CTRL/STAT register during initial examination and when checking the sticky error bit. This bit is normally checked after setting the CSYSPWRUPREQ bit, but some devices do not set the ack bit until sometime later.
- -dp-id number
Debug port identification number for SWD DPv2 multidrop. The number is written to bits 0..27 of DP TARGETSEL during DP selection. To find the id number of a single connected device read DP TARGETID: device.dap dpreg 0x24 Use bits 0..27 of TARGETID.
- -instance-id number
Instance identification number for SWD DPv2 multidrop. The number is written to bits 28..31 of DP TARGETSEL during DP selection. To find the instance number of a single connected device read DP DLPIDR: device.dap dpreg 0x34 The instance number is in bits 28..31 of DLPIDR value.
dap names | [Command]
This command returns a list of all registered DAP objects. It it useful mainly for TCL scripting.
dap info [num] | [Command]
Displays the ROM table for MEM-AP num, defaulting to the currently selected AP of the currently selected target.
dap init | [Command]
Initialize all registered DAPs. This command is used internally during initialization. It can be issued at any time after the initialization, too.

The following commands exist as subcommands of DAP instances:

$dap_name info [num] | [Command]
Displays the ROM table for MEM-AP num, defaulting to the currently selected AP.
$dap_name apid [num] | [Command]
Displays ID register from AP num, defaulting to the currently selected AP.
$dap_name apreg ap num reg [value] | [Command]
Displays content of a register reg from AP ap num or set a new value value. reg is byte address of a word register, 0, 4, 8 ... 0xfc.

Chapter 10: TAP Declaration | 68
$dap_name apsel [num] | [Command]
Select AP num, defaulting to 0.
$dap_name dpreg reg [value] | [Command]
Displays the content of DP register at address reg, or set it to a new value value. In case of SWD, reg is a value in packed format dpbanksel << 4|addr and assumes values 0, 4, 8 ... 0xfc. In case of JTAG it only assumes values 0, 4, 8 and 0xc. Note: Consider using poll off to avoid any disturbing background activity by OpenOCD while you are operating at such low-level.
$dap_name baseaddr [num] | [Command]
Displays debug base address from MEM-AP num, defaulting to the currently selected AP.
$dap_name memaccess [value] | [Command]
Displays the number of extra tck cycles in the JTAG idle to use for MEM-AP memory bus access [0-255], giving additional time to respond to reads. If value is defined, first assigns that.
$dap_name apcsw [value [mask]] | [Command]
Displays or changes CSW bit pattern for MEM-AP transfers.
At the begin of each memory access the CSW pattern is extended (bitwise or-ed) by Size and AddrInc bit-fields according to transfer requirements and the result is written to the real CSW register. All bits except dynamically updated fields Size and AddrInc can be changed by changing the CSW pattern. Refer to ARM ADI v5 manual chapter 7.6.4 and appendix A for details.
Use value only syntax if you want to set the new CSW pattern as a whole. The example sets HPROT1 bit (required by Cortex-M) and clears the rest of the pattern:

kx.dap apcsw 0x2000000
If mask is also used, the CSW pattern is changed only on bit positions where the mask bit is 1. The following example sets HPROT3 (cacheable) and leaves the rest of the pattern intact. It configures memory access through DCache on Cortex-M7.

set CSW_HPROT3_CACHEABLE [expr 1 << 27]
samv.dap apcsw $CSW_HPROT3_CACHEABLE $CSW_HPROT3_CACHEABLE Another example clears SPROT bit and leaves the rest of pattern intact:

set CSW_SPROT [expr 1 << 30]
samv.dap apcsw 0 $CSW_SPROT
Note: If you want to check the real value of CSW, not CSW pattern, use xxx.dap apreg 0. See [DAP subcommand apreg], page 67.
Warning: Some of the CSW bits are vital for working memory transfer. If you set a wrong CSW pattern and MEM-AP stopped working, use the following example with a proper dap name:

xxx.dap apcsw default

$dap_name ti_be_32_quirks [enable] | [Config Command]
Set/get quirks mode for TI TMS450/TMS570 processors Disabled by default

69

## 11 CPU Configuration

This chapter discusses how to set up GDB debug targets for CPUs. You can also access these targets without GDB (see Chapter 16 [Architecture and Core Commands], page 132, and [Target State handling], page 125) and through various kinds of NAND and NOR flash commands. If you have multiple CPUs you can have multiple such targets.

We’ll start by looking at how to examine the targets you have, then look at how to add one more target and how to configure it.

## 11.1 Target List

All targets that have been set up are part of a list, where each member has a name. That name should normally be the same as the TAP name. You can display the list with the targets (plural!) command. This display often has only one CPU; here’s what it might look like with more than one:

| TargetName | Type | Endian TapName | State
0* at91rm9200.cpu | arm920t | little at91rm9200.cpu | running
1 | MyTarget | cortex_m | little mychip.foo | tap-disabled

One member of that list is the current target, which is implicitly referenced by many commands. It’s the one marked with a * near the target name. In particular, memory addresses often refer to the address space seen by that current target. Commands like mdw (memory display words) and flash erase_address (erase NOR flash blocks) are examples; and there are many more.

Several commands let you examine the list of targets:

target current | [Command]
Returns the name of the current target.
target names | [Command]
Lists the names of all current targets in the list.

foreach t [target names] {
puts [format "Target: %s\n" $t] }
targets [name] | [Command]
Note: the name of this command is plural. Other target command names are singular.

With no parameter, this command displays a table of all known targets in a user
| friendly form.

With a parameter, this command sets the current target to the given target with the given name; this is only relevant on boards which have more than one target.

Chapter 11: CPU Configuration | 70

## 11.2 Target CPU Types

Each target has a CPU type, as shown in the output of the targets command. You need to specify that type when calling target create. The CPU type indicates more than just the instruction set. It also indicates how that instruction set is implemented, what kind of debug support it integrates, whether it has an MMU (and if so, what kind), what core-specific commands may be available (see Chapter 16 [Architecture and Core Commands], page 132), and more.

It’s easy to see what target types are supported, since there’s a command to list them.

target types | [Command]
Lists all supported target types. At this writing, the supported CPU types are:
- aarch64 – this is an ARMv8-A core with an MMU.
- arm11 – this is a generation of ARMv6 cores.
- arm720t – this is an ARMv4 core with an MMU.
- arm7tdmi – this is an ARMv4 core.
- arm920t – this is an ARMv4 core with an MMU.
- arm926ejs – this is an ARMv5 core with an MMU.
- arm946e – this is an ARMv5 core with an MMU.
- arm966e – this is an ARMv5 core.
- arm9tdmi – this is an ARMv4 core.
- avr – implements Atmel’s 8-bit AVR instruction set. (Support for this is preliminary and incomplete.)
- avr32_ap7k – this an AVR32 core.
- cortex_a – this is an ARMv7-A core with an MMU.
- cortex_m – this is an ARMv7-M core, supporting only the compact Thumb2 instruction set. Supports also ARMv6-M and ARMv8-M cores
- cortex_r4 – this is an ARMv7-R core.
- dragonite – resembles arm966e.
- dsp563xx – implements Freescale’s 24-bit DSP. (Support for this is still incomplete.)
- dsp5680xx – implements Freescale’s 5680x DSP.
- esirisc – this is an EnSilica eSi-RISC core. The current implementation supports eSi-32xx cores.
- fa526 – resembles arm920 (w/o Thumb).
- feroceon – resembles arm926.
- hla_target – a Cortex-M alternative to work with HL adapters like ST-Link.
- ls1_sap – this is the SAP on NXP LS102x CPUs, allowing access to physical memory addresses independently of CPU cores.
- mem_ap – this is an ARM debug infrastructure Access Port without a CPU, through which bus read and write cycles can be generated; it may be useful for working with non-CPU hardware behind an AP or during development of

Chapter 11: CPU Configuration | 71

support for new CPUs. It’s possible to connect a GDB client to this target (the GDB port has to be specified, See [option -gdb-port], page 73.), and a fake ARM core will be emulated to comply to GDB remote protocol.
- mips_m4k – a MIPS core.
- mips_mips64 – a MIPS64 core.
- nds32_v2 – this is an Andes NDS32 v2 core.
- nds32_v3 – this is an Andes NDS32 v3 core.
- nds32_v3m – this is an Andes NDS32 v3m core.
- or1k – this is an OpenRISC 1000 core. The current implementation supports three JTAG TAP cores:
− OpenCores TAP (See: http://opencores.org/project,jtag)
− Altera Virtual JTAG TAP (See: http://www.altera.com/literature/ug/ug_virtualjtag.pdf) (http://www.altera.com/literature/ug/ug_virtualjtag.pdf)
− Xilinx BSCAN_* virtual JTAG interface (See: http://www.xilinx.com/support/documentation/sw_manuals/xilinx14_2/spartan6_hdl.pdf) (http://www.xilinx.com/support/documentation/sw_manuals/xilinx14_2/spartan6_hdl.pdf)

And two debug interfaces cores:
− Advanced debug interface
(See: http://opencores.org/project,adv_debug_sys) − SoC Debug Interface
(See: http://opencores.org/project,dbg_interface)
- quark_d20xx – an Intel Quark D20xx core.
- quark_x10xx – an Intel Quark X10xx core.
- riscv – a RISC-V core.
- stm8 – implements an STM8 core.
- testee – a dummy target for cases without a real CPU, e.g. CPLD.
- xscale – this is actually an architecture, not a CPU type. It is based on the ARMv5 architecture.

To avoid being confused by the variety of ARM based cores, remember this key point: ARM is a technology licencing company. (See: http://www.arm.com.) The CPU name used by OpenOCD will reflect the CPU design that was licensed, not a vendor brand which incorporates that design. Name prefixes like arm7, arm9, arm11, and cortex reflect design generations; while names like ARMv4, ARMv5, ARMv6, ARMv7 and ARMv8 reflect an architecture version implemented by a CPU design.

## 11.3 Target Configuration

Before creating a “target”, you must have added its TAP to the scan chain. When you’ve added that TAP, you will have a dotted.name which is used to set up the CPU support. The chip-specific configuration file will normally configure its CPU(s) right after it adds all of the chip’s TAPs to the scan chain.
Although you can set up a target in one step, it’s often clearer if you use shorter commands and do it in two steps: create it, then configure optional parts. All operations on the target after it’s created will use a new command, created as part of target creation.

Chapter 11: CPU Configuration | 72

The two main things to configure after target creation are a work area, which usually has target-specific defaults even if the board setup code overrides them later; and event handlers (see [Target Events], page 75), which tend to be much more board-specific. The key steps you use might look something like this

dap create mychip.dap -chain-position mychip.cpu
target create MyTarget cortex_m -dap mychip.dap
MyTarget configure -work-area-phys 0x08000 -work-area-size 8096 MyTarget configure -event reset-deassert-pre { jtag_rclk 5 }
MyTarget configure -event reset-init { myboard_reinit }
You should specify a working area if you can; typically it uses some on-chip SRAM. Such a working area can speed up many things, including bulk writes to target memory; flash operations like checking to see if memory needs to be erased; GDB memory checksumming; and more.
Warning: On more complex chips, the work area can become inaccessible when application code (such as an operating system) enables or disables the MMU.
For example, the particular MMU context used to access the virtual address will probably matter ... and that context might not have easy access to other addresses needed. At this writing, OpenOCD doesn’t have much MMU intelligence.
It’s often very useful to define a reset-init event handler. For systems that are normally used with a boot loader, common tasks include updating clocks and initializing memory controllers. That may be needed to let you write the boot loader into flash, in order to “de-brick” your board; or to load programs into external DDR memory without having run the boot loader.
target create target name type configparams... | [Config Command]
This command creates a GDB debug target that refers to a specific JTAG tap. It enters that target into a list, and creates a new command (target_name) which is used for various purposes including additional configuration.
- target name ... is the name of the debug target. By convention this should be the same as the dotted.name of the TAP associated with this target, which must be specified here using the -chain-position dotted.name configparam.
This name is also used to create the target object command, referred to here as $target_name, and in other places the target needs to be identified.
- type ... specifies the target type. See [target types], page 70.
- configparams ... all parameters accepted by $target_name configure are permitted. If the target is big-endian, set it here with -endian big.
You must set the -chain-position dotted.name or -dap dap_name here.
$target_name configure configparams... | [Command]
The options accepted by this command may also be specified as parameters to target create. Their values can later be queried one at a time by using the $target_name cget command.
Warning: changing some of these after setup is dangerous. For example, moving a target from one TAP to another; and changing its endianness.
- -chain-position dotted.name – names the TAP used to access this target.

Chapter 11: CPU Configuration | 73
- -dap dap name – names the DAP used to access this target. See [DAP declaration], page 66, on how to create and manage DAP instances.
- -endian (big|little) – specifies whether the CPU uses big or little endian conventions
- -event event name event body – See [Target Events], page 75. Note that this updates a list of named event handlers. Calling this twice with two different event names assigns two different handlers, but calling it twice with the same event name assigns only one handler.
Current target is temporarily overridden to the event issuing target before handler code starts and switched back after handler is done.
- -work-area-backup (0|1) – says whether the work area gets backed up; by default, it is not backed up. When possible, use a working area that doesn’t need to be backed up, since performing a backup slows down operations. For example, the beginning of an SRAM block is likely to be used by most build systems, but the end is often unused.
- -work-area-size size – specify work are size, in bytes. The same size applies regardless of whether its physical or virtual address is being used.
- -work-area-phys address – set the work area base address to be used when no MMU is active.
- -work-area-virt address – set the work area base address to be used when an MMU is active. Do not specify a value for this except on targets with an MMU. The value should normally correspond to a static mapping for the -work-areaphys address, set up by the current operating system.
- -rtos rtos type – enable rtos support for target, rtos type can be one of auto, eCos, ThreadX, FreeRTOS, linux, ChibiOS, embKernel, mqx, uCOS-III, nuttx, RIOT, Zephyr See [RTOS Support], page 168.
- -defer-examine – skip target examination at initial JTAG chain scan and after a reset. A manual call to arp examine is required to access the target for debugging.
- -ap-num ap number – set DAP access port for target, ap number is the numeric index of the DAP AP the target is connected to. Use this option with systems where multiple, independent cores are connected to separate access ports of the same DAP.
- -cti cti name – set Cross-Trigger Interface (CTI) connected to the target. Currently, only the aarch64 target makes use of this option, where it is a mandatory configuration for the target run control. See [ARM Cross-Trigger Interface], page 135, for instruction on how to declare and control a CTI instance.
- -gdb-port number – see command gdb_port for the possible values of the parameter number, which are not only numeric values. Use this option to override, for this target only, the global parameter set with command gdb_port. See [command gdb port], page 33.
- -gdb-max-connections number – EXPERIMENTAL: set the maximum number of GDB connections that are allowed for the target. Default is 1. A negative value for number means unlimited connections. See See [Using GDB as a non-intrusive memory inspector], page 167.

Chapter 11: CPU Configuration | 74

## 11.4 Other $target name Commands

The Tcl/Tk language has the concept of object commands, and OpenOCD adopts that same model for targets.
A good Tk example is a on screen button. Once a button is created a button has a name (a path in Tk terms) and that name is useable as a first class command. For example in Tk, one can create a button and later configure it like this:

# Create

button .foobar -background red -command { foo }
# Modify

.foobar configure -foreground blue
# Query

set x [.foobar cget -background]
# Report

puts [format "The button is %s" $x]
In OpenOCD’s terms, the “target” is an object just like a Tcl/Tk button, and its object commands are invoked the same way.
str912.cpu | mww 0x1234 0x42
omap3530.cpu | mww 0x5555 123
The commands supported by OpenOCD target objects are:
$target_name arp_examine allow-defer | [Command]
$target_name arp_halt | [Command]
$target_name arp_poll | [Command]
$target_name arp_reset | [Command]
$target_name arp_waitstate | [Command]
Internal OpenOCD scripts (most notably startup.tcl) use these to deal with specific reset cases. They are not otherwise documented here.
$target_name array2mem arrayname width address count | [Command]
$target_name mem2array arrayname width address count | [Command]
These provide an efficient script-oriented interface to memory. The array2mem primitive writes bytes, halfwords, words or double-words; while mem2array reads them. In both cases, the TCL side uses an array, and the target side uses raw memory.
The efficiency comes from enabling the use of bulk JTAG data transfer operations. The script orientation comes from working with data values that are packaged for use by TCL scripts; mdw type primitives only print data they retrieve, and neither store nor return those values.
- arrayname ... is the name of an array variable
- width ... is 8/16/32/64 - indicating the memory access size
- address ... is the target memory address
- count ... is the number of elements to process
$target_name cget queryparm | [Command]
Each configuration parameter accepted by $target_name configure can be individually queried, to return its current value. The queryparm is a parameter name accepted by that command, such as -work-area-phys. There are a few special cases:

Chapter 11: CPU Configuration | 75
- -event event name – returns the handler for the event named event name. This is a special case because setting a handler requires two parameters.
- -type – returns the target type. This is a special case because this is set using target create and can’t be changed using $target_name configure.

For example, if you wanted to summarize information about all the targets you might use something like this:

foreach name [target names] {
set y [$name cget -endian]
set z [$name cget -type]
puts [format "Chip %d is %s, Endian: %s, type: %s" \ $x $name $y $z]
}
$target_name curstate | [Command]
Displays the current target state: debug-running, halted, reset, running, or unknown. (Also, see [Event Polling], page 35.)
$target_name eventlist | [Command]
Displays a table listing all event handlers currently associated with this target. See [Target Events], page 75.
$target_name invoke-event event name | [Command]
Invokes the handler for the event named event name. (This is primarily intended for use by OpenOCD framework code, for example by the reset code in startup.tcl.)
$target_name mdd [phys] addr [count] | [Command]
$target_name mdw [phys] addr [count] | [Command]
$target_name mdh [phys] addr [count] | [Command]
$target_name mdb [phys] addr [count] | [Command]
Display contents of address addr, as 64-bit doublewords (mdd), 32-bit words (mdw), 16-bit halfwords (mdh), or 8-bit bytes (mdb). When the current target has an MMU which is present and active, addr is interpreted as a virtual address. Otherwise, or if the optional phys flag is specified, addr is interpreted as a physical address. If count is specified, displays that many units. (If you want to manipulate the data instead of displaying it, see the mem2array primitives.)
$target_name mwd [phys] addr doubleword [count] | [Command]
$target_name mww [phys] addr word [count] | [Command]
$target_name mwh [phys] addr halfword [count] | [Command]
$target_name mwb [phys] addr byte [count] | [Command]
Writes the specified doubleword (64 bits), word (32 bits), halfword (16 bits), or byte (8-bit) value, at the specified address addr. When the current target has an MMU which is present and active, addr is interpreted as a virtual address. Otherwise, or if the optional phys flag is specified, addr is interpreted as a physical address. If count is specified, fills that many units of consecutive address.

Chapter 11: CPU Configuration | 76

## 11.5 Target Events

At various times, certain things can happen, or you want them to happen. For example:
- What should happen when GDB connects? Should your target reset?
- When GDB tries to flash the target, do you need to enable the flash via a special command?
- Is using SRST appropriate (and possible) on your system? Or instead of that, do you need to issue JTAG commands to trigger reset? SRST usually resets everything on the scan chain, which can be inappropriate.
- During reset, do you need to write to certain memory locations to set up system clocks or to reconfigure the SDRAM? How about configuring the watchdog timer, or other peripherals, to stop running while you hold the core stopped for debugging?

All of the above items can be addressed by target event handlers. These are set up by $target_name configure -event or target create ... -event.
The programmer’s model matches the -command option used in Tcl/Tk buttons and events. The two examples below act the same, but one creates and invokes a small procedure while the other inlines it.

proc my_init_proc { } {
echo "Disabling watchdog..."
mww 0xfffffd44 0x00008000
}
mychip.cpu configure -event reset-init my_init_proc mychip.cpu configure -event reset-init {
echo "Disabling watchdog..."
mww 0xfffffd44 0x00008000
}
The following target events are defined:
- debug-halted
The target has halted for debug reasons (i.e.: breakpoint)
- debug-resumed
The target has resumed (i.e.: GDB said run)
- early-halted
Occurs early in the halt process
- examine-start
Before target examine is called.
- examine-end
After target examine is called with no errors.
- examine-fail
After target examine fails.
- gdb-attach
When GDB connects. Issued before any GDB communication with the target starts. GDB expects the target is halted during attachment. See [GDB as a non-intrusive memory inspector], page 167, how to connect GDB to running target. The event can be also used to set up the target so it is possible to probe flash. Probing flash

Chapter 11: CPU Configuration | 77

is necessary during GDB connect if you want to use see [programming using GDB], page 167. Another use of the flash memory map is for GDB to automatically choose hardware or software breakpoints depending on whether the breakpoint is in RAM or read only memory. Default is halt
- gdb-detach
When GDB disconnects
- gdb-end
When the target has halted and GDB is not doing anything (see early halt)
- gdb-flash-erase-start
Before the GDB flash process tries to erase the flash (default is reset init)
- gdb-flash-erase-end
After the GDB flash process has finished erasing the flash
- gdb-flash-write-start
Before GDB writes to the flash
- gdb-flash-write-end
After GDB writes to the flash (default is reset halt)
- gdb-start
Before the target steps, GDB is trying to start/resume the target
- halted
The target has halted
- reset-assert-pre
Issued as part of reset processing after reset-start was triggered but before either SRST alone is asserted on the scan chain, or reset-assert is triggered.
- reset-assert
Issued as part of reset processing after reset-assert-pre was triggered. When such a handler is present, cores which support this event will use it instead of asserting SRST. This support is essential for debugging with JTAG interfaces which don’t include an SRST line (JTAG doesn’t require SRST), and for selective reset on scan chains that have multiple targets.
- reset-assert-post
Issued as part of reset processing after reset-assert has been triggered. or the target asserted SRST on the entire scan chain.
- reset-deassert-pre
Issued as part of reset processing after reset-assert-post has been triggered.
- reset-deassert-post
Issued as part of reset processing after reset-deassert-pre has been triggered and (if the target is using it) after SRST has been released on the scan chain.
- reset-end
Issued as the final step in reset processing.
- reset-init
Used by reset init command for board-specific initialization. This event fires after reset-deassert-post.
This is where you would configure PLLs and clocking, set up DRAM so you can download programs that don’t fit in on-chip SRAM, set up pin multiplexing, and so on.

Chapter 11: CPU Configuration | 78

(You may be able to switch to a fast JTAG clock rate here, after the target clocks are fully set up.)
- reset-start
Issued as the first step in reset processing before reset-assert-pre is called.
This is the most robust place to use jtag_rclk or adapter speed to switch to a low JTAG clock rate, when reset disables PLLs needed to use a fast clock.
- resume-start
Before any target is resumed
- resume-end
After all targets have resumed
- resumed
Target has resumed
- step-start
Before a target is single-stepped
- step-end
After single-step has completed
- trace-config
After target hardware trace configuration was changed

Note: OpenOCD events are not supposed to be preempt by another event, but this is not enforced in current code. Only the target event resumed is executed with polling disabled; this avoids polling to trigger the event halted, reversing the logical order of execution of their handlers. Future versions of OpenOCD will prevent the event preemption and will disable the schedule of polling during the event execution. Do not rely on polling in any event handler; this means, don’t expect the status of a core to change during the execution of the handler. The event handler will have to enable polling or use $target_name arp_poll to check if the core has changed status.

79

## 12 Flash Commands

OpenOCD has different commands for NOR and NAND flash; the “flash” command works with NOR flash, while the “nand” command works with NAND flash. This partially reflects different hardware technologies: NOR flash usually supports direct CPU instruction and data bus access, while data from a NAND flash must be copied to memory before it can be used. (SPI flash must also be copied to memory before use.) However, the documentation also uses “flash” as a generic term; for example, “Put flash configuration in board-specific files”.
Flash Steps:
1. Configure via the command flash bank
Do this in a board-specific configuration file, passing parameters as needed by the driver.
2. Operate on the flash via flash subcommand
Often commands to manipulate the flash are typed by a human, or run via a script in some automated way. Common tasks include writing a boot loader, operating system, or other data.
3. GDB Flashing
Flashing via GDB requires the flash be configured via “flash bank”, and the GDB flash features be enabled. See [GDB Configuration], page 34.

Many CPUs have the ability to “boot” from the first flash bank. This means that misprogramming that bank can “brick” a system, so that it can’t boot. JTAG tools, like OpenOCD, are often then used to “de-brick” the board by (re)installing working boot firmware.

## 12.1 Flash Configuration Commands

flash bank name driver base size chip width bus width | [Config Command]
target [driver options]
Configures a flash bank which provides persistent storage for addresses from base to base+size−1. These banks will often be visible to GDB through the target’s memory map. In some cases, configuring a flash bank will activate extra commands; see the driver-specific documentation.
- name ... may be used to reference the flash bank in other flash commands. A number is also available.
- driver ... identifies the controller driver associated with the flash bank being declared. This is usually cfi for external flash, or else the name of a microcontroller with embedded flash memory. See [Flash Driver List], page 83.
- base ... Base address of the flash chip.
- size ... Size of the chip, in bytes. For some drivers, this value is detected from the hardware.
- chip width ... Width of the flash chip, in bytes; ignored for most microcontroller drivers.
- bus width ... Width of the data bus used to access the chip, in bytes; ignored for most microcontroller drivers.

Chapter 12: Flash Commands | 80
- target ... Names the target used to issue commands to the flash controller.
- driver options ... drivers may support, or require, additional parameters. See the driver-specific documentation for more information.

Note: This command is not available after OpenOCD initialization has completed. Use it in board specific configuration files, not interactively.

flash banks | [Command]
Prints a one-line summary of each device that was declared using flash bank, numbered from zero. Note that this is the plural form; the singular form is a very different command.
flash list | [Command]
Retrieves a list of associative arrays for each device that was declared using flash bank, numbered from zero. This returned list can be manipulated easily from within scripts.
flash probe num | [Command]
Identify the flash, or validate the parameters of the configured flash. Operation depends on the flash type. The num parameter is a value shown by flash banks. Most flash commands will implicitly autoprobe the bank; flash drivers can distinguish between probing and autoprobing, but most don’t bother.

## 12.2 Preparing a Target before Flash Programming

The target device should be in well defined state before the flash programming begins. Always issue reset init before [Flash Programming Commands], page 80. Do not issue another reset or reset halt or resume until the programming session is finished.
If you use [Programming using GDB], page 167, the target is prepared automatically in the event gdb-flash-erase-start
The jimtcl script program calls reset init explicitly.

## 12.3 Erasing, Reading, Writing to Flash

One feature distinguishing NOR flash from NAND or serial flash technologies is that for read access, it acts exactly like any other addressable memory. This means you can use normal memory read commands like mdw or dump_image with it, with no special flash subcommands. See [Memory access], page 127, and [Image access], page 128.
Write access works differently. Flash memory normally needs to be erased before it’s written. Erasing a sector turns all of its bits to ones, and writing can turn ones into zeroes. This is why there are special commands for interactive erasing and writing, and why GDB needs to know which parts of the address space hold NOR flash memory.
Note: Most of these erase and write commands leverage the fact that NOR flash chips consume target address space. They implicitly refer to the current
JTAG target, and map from an address in that target’s address space back to a flash bank. A few commands use abstract addressing based on bank and sector numbers, and don’t depend on searching the current target and its address space. Avoid confusing the two command models.

Chapter 12: Flash Commands | 81

Some flash chips implement software protection against accidental writes, since such buggy writes could in some cases “brick” a system. For such systems, erasing and writing may require sector protection to be disabled first. Examples include CFI flash such as “Intel Advanced Bootblock flash”, and AT91SAM7 on-chip flash. See [flash protect], page 83.

flash erase_sector num first last | [Command]
Erase sectors in bank num, starting at sector first up to and including last. Sector numbering starts at 0. Providing a last sector of last specifies "to the end of the flash bank". The num parameter is a value shown by flash banks.
flash erase_address [pad] [unlock] address length | [Command]
Erase sectors starting at address for length bytes. Unless pad is specified, address must begin a flash sector, and address + length − 1 must end a sector. Specifying pad erases extra data at the beginning and/or end of the specified region, as needed to erase only full sectors. The flash bank to use is inferred from the address, and the specified length must stay within that bank. As a special case, when length is zero and address is the start of the bank, the whole flash is erased. If unlock is specified, then the flash is unprotected before erase starts.
flash filld address double-word length | [Command]
flash fillw address word length | [Command]
flash fillh address halfword length | [Command]
flash fillb address byte length | [Command]
Fills flash memory with the specified double-word (64 bits), word (32 bits), halfword (16 bits), or byte (8-bit) pattern, starting at address and continuing for length units (word/halfword/byte). No erasure is done before writing; when needed, that must be done before issuing this command. Writes are done in blocks of up to 1024 bytes, and each write is verified by reading back the data and comparing it to what was written. The flash bank to use is inferred from the address of each block, and the specified length must stay within that bank.
flash mdw addr [count] | [Command]
flash mdh addr [count] | [Command]
flash mdb addr [count] | [Command]
Display contents of address addr, as 32-bit words (mdw), 16-bit halfwords (mdh), or 8-bit bytes (mdb). If count is specified, displays that many units. Reads from flash using the flash driver, therefore it enables reading from a bank not mapped in target address space. The flash bank to use is inferred from the address of each block, and the specified length must stay within that bank.
flash write_bank num filename [offset] | [Command]
Write the binary filename to flash bank num, starting at offset bytes from the beginning of the bank. If offset is omitted, start at the beginning of the flash bank. The num parameter is a value shown by flash banks.
flash read_bank num filename [offset [length]] | [Command]
Read length bytes from the flash bank num starting at offset and write the contents to the binary filename. If offset is omitted, start at the beginning of the flash bank. If length is omitted, read the remaining bytes from the flash bank. The num parameter is a value shown by flash banks.

Chapter 12: Flash Commands | 82
flash verify_bank num filename [offset] | [Command]
Compare the contents of the binary file filename with the contents of the flash bank num starting at offset. If offset is omitted, start at the beginning of the flash bank. Fail if the contents do not match. The num parameter is a value shown by flash banks.
flash write_image [erase] [unlock] filename [offset] [type] | [Command]
Write the image filename to the current target’s flash bank(s). Only loadable sections from the image are written. A relocation offset may be specified, in which case it is added to the base address for each section in the image. The file [type] can be specified explicitly as bin (binary), ihex (Intel hex), elf (ELF file), s19 (Motorola s19). mem, or builder. The relevant flash sectors will be erased prior to programming if the erase parameter is given. If unlock is provided, then the flash banks are unlocked before erase and program. The flash bank to use is inferred from the address of each image section.

Warning: Be careful using the erase flag when the flash is holding data
you want to preserve. Portions of the flash outside those described in the image’s sections might be erased with no notice.
- When a section of the image being written does not fill out all the sectors it uses, the unwritten parts of those sectors are necessarily also erased, because sectors can’t be partially erased.
- Data stored in sector "holes" between image sections are also affected. For example, "flash write_image erase ..." of an image with one byte at the beginning of a flash bank and one byte at the end erases the entire bank – not just the two sectors being written.

Also, when flash protection is important, you must re-apply it after it has been removed by the unlock flag.

flash verify_image filename [offset] [type] | [Command]
Verify the image filename to the current target’s flash bank(s). Parameters follow the description of ’flash write image’. In contrast to the ’verify image’ command, for banks with specific verify method, that one is used instead of the usual target’s read memory methods. This is necessary for flash banks not readable by ordinary memory reads. This command gives only an overall good/bad result for each bank, not addresses of individual failed bytes as it’s intended only as quick check for successful programming.

## 12.4 Other Flash commands

flash erase_check num | [Command]
Check erase state of sectors in flash bank num, and display that status. The num parameter is a value shown by flash banks.
flash info num [sectors] | [Command]
Print info about flash bank num, a list of protection blocks and their status. Use sectors to show a list of sectors instead.

Chapter 12: Flash Commands | 83

The num parameter is a value shown by flash banks. This command will first query the hardware, it does not print cached and possibly stale information.

flash protect num first last (on|off) | [Command]
Enable (on) or disable (off) protection of flash blocks in flash bank num, starting at protection block first and continuing up to and including last. Providing a last block of last specifies "to the end of the flash bank". The num parameter is a value shown by flash banks. The protection block is usually identical to a flash sector. Some devices may utilize a protection block distinct from flash sector. See flash info for a list of protection blocks.
flash padded_value num value | [Command]
Sets the default value used for padding any image sections, This should normally match the flash bank erased value. If not specified by this command or the flash driver then it defaults to 0xff.
program filename [preverify] [verify] [reset] [exit] [offset] | [Command]
This is a helper script that simplifies using OpenOCD as a standalone programmer. The only required parameter is filename, the others are optional. See Chapter 13 [Flash Programming], page 122.

## 12.5 Flash Driver List

As noted above, the flash bank command requires a driver name, and allows driver-specific options and behaviors. Some drivers also activate driver-specific commands.

virtual | [Flash Driver]
This is a special driver that maps a previously defined bank to another address. All bank settings will be copied from the master physical bank.
The virtual driver defines one mandatory parameters,
- master bank The bank that this virtual address refers to.

So in the following example addresses 0xbfc00000 and 0x9fc00000 refer to the flash bank defined at address 0x1fc00000. Any command executed on the virtual banks is actually performed on the physical banks.

flash bank $_FLASHNAME pic32mx 0x1fc00000 0 0 0 $_TARGETNAME flash bank vbank0 virtual 0xbfc00000 0 0 0 \
$_TARGETNAME $_FLASHNAME
flash bank vbank1 virtual 0x9fc00000 0 0 0 \
$_TARGETNAME $_FLASHNAME

### 12.5.1 External Flash

cfi | [Flash Driver]
The “Common Flash Interface” (CFI) is the main standard for external NOR flash chips, each of which connects to a specific external chip select on the CPU. Frequently the first such chip is used to boot the system. Your board’s reset-init handler might need to configure additional chip selects using other commands (like: mww to configure a bus and its timings), or perhaps configure a GPIO pin that controls the

Chapter 12: Flash Commands | 84

“write protect” pin on the flash chip. The CFI driver can use a target-specific working area to significantly speed up operation.

The CFI driver can accept the following optional parameters, in any order:
- jedec probe ... is used to detect certain non-CFI flash ROMs, like AM29LV010 and similar types.
- x16 as x8 ... when a 16-bit flash is hooked up to an 8-bit bus.
- bus swap ... when data bytes in a 16-bit flash needs to be swapped.
- data swap ... when data bytes in a 16-bit flash needs to be swapped when writing data values (i.e. not CFI commands).

To configure two adjacent banks of 16 MBytes each, both sixteen bits (two bytes) wide on a sixteen bit bus:

flash bank $_FLASHNAME cfi 0x00000000 0x01000000 2 2 $_TARGETNAME flash bank $_FLASHNAME cfi 0x01000000 0x01000000 2 2 $_TARGETNAME To configure one bank of 32 MBytes built from two sixteen bit (two byte) wide parts wired in parallel to create a thirty-two bit (four byte) bus with doubled throughput:

flash bank $_FLASHNAME cfi 0x00000000 0x02000000 2 4 $_TARGETNAME

jtagspi | [Flash Driver]
Several FPGAs and CPLDs can retrieve their configuration (bitstream) from a SPI flash connected to them. To access this flash from the host, the device is first programmed with a special proxy bitstream that exposes the SPI flash on the device’s JTAG interface. The flash can then be accessed through JTAG.

Since signaling between JTAG and SPI is compatible, all that is required for a proxy bitstream is to connect TDI-MOSI, TDO-MISO, TCK-CLK and activate the flash chip select when the JTAG state machine is in SHIFT-DR. Such a bitstream for several Xilinx FPGAs can be found in contrib/loaders/flash/fpga/xilinx_ bscan_spi.py. It requires migen (https://github.com/m-labs/migen) and a Xilinx toolchain to build.

This flash bank driver requires a target on a JTAG tap and will access that tap directly. Since no support from the target is needed, the target can be a "testee" dummy. Since the target does not expose the flash memory mapping, target commands that would otherwise be expected to access the flash will not work. These include all *_image and $target_name m* commands as well as program. Equivalent functionality is available through the flash write_bank, flash read_bank, and flash verify_bank commands.

According to device size, 1- to 4-byte addresses are sent. However, some flash chips additionally have to be switched to 4-byte addresses by an extra command, see below.
- ir ... is loaded into the JTAG IR to map the flash as the JTAG DR. For the
| bitstreams generated from xilinx_bscan_spi.py this is the USER1 instruction. target create $_TARGETNAME testee -chain-position $_CHIPNAME.fpga

set _XILINX_USER1 0x02
flash bank $_FLASHNAME spi 0x0 0 0 0 \
$_TARGETNAME $_XILINX_USER1

Chapter 12: Flash Commands | 85
jtagspi set bank id name total size page size read cmd | [Command]
unused pprg cmd mass erase cmd sector size sector erase cmd Sets flash parameters: name human readable string, total size size in bytes,
page size is write page size. | read cmd and pprg cmd are commands for
read and page program, respectively. | mass erase cmd, sector size and
sector erase cmd are optional.

jtagspi set 0 w25q128 0x1000000 0x100 0x03 0 0x02 0xC7 0x10000 0xD8

jtagspi cmd bank id resp num cmd byte ... | [Command]
Sends command cmd byte and at most 20 following bytes and reads resp num
bytes afterwards. E.g. for ’Enter 4-byte address mode’

jtagspi cmd 0 0 0xB7

jtagspi always_4byte bank id [ on | off ] | [Command]
Some devices use 4-byte addresses for all commands except the legacy 0x03 read regardless of device size. This command controls the corresponding hack.
xcf | [Flash Driver]
Xilinx FPGAs can be configured from specialized flash ICs named Platform Flash. It is (almost) regular NOR flash with erase sectors, program pages, etc. The only difference is special registers controlling its FPGA specific behavior. They must be properly configured for successful FPGA loading using additional xcf driver command:
xcf ccb <bank id> | [Command]
command accepts additional parameters:
- external|internal ... selects clock source.
- serial|parallel ... selects serial or parallel data bus mode.
- slave|master ... selects slave of master mode for flash device.
- 40|20 ... selects clock frequency in MHz for internal clock in master mode.

xcf ccb 0 external parallel slave 40
All of them must be specified even if clock frequency is pointless in slave mode. If only bank id specified than command prints current CCB register value. Note: there is no need to write this register every time you erase/program data sectors because it stores in dedicated sector.
xcf configure <bank id> | [Command]
Initiates FPGA loading procedure. Useful if your board has no "configure" button.

xcf configure 0

Additional driver notes:
- Only single revision supported.
- Driver automatically detects need of bit reverse, but only "bin" (raw binary, do not confuse it with "bit") and "mcs" (Intel hex) file types supported.
- For additional info check xapp972.pdf and ug380.pdf.

Chapter 12: Flash Commands | 86
lpcspifi | [Flash Driver]
NXP’s LPC43xx and LPC18xx families include a proprietary SPI Flash Interface (SPIFI) peripheral that can drive and provide memory mapped access to external SPI flash devices.

The lpcspifi driver initializes this interface and provides program and erase functionality for these serial flash devices. Use of this driver requires a working area of at least 1kB to be configured on the target device; more than this will significantly reduce flash programming times.

The setup command only requires the base parameter. All other parameters are ignored, and the flash size and layout are configured by the driver.

| flash bank $_FLASHNAME lpcspifi 0x14000000 0 0 0 $_TARGETNAME
stmsmi | [Flash Driver]
Some devices from STMicroelectronics (e.g. STR75x MCU family, SPEAr MPU family) include a proprietary “Serial Memory Interface” (SMI) controller able to drive external SPI flash devices. Depending on specific device and board configuration, up to 4 external flash devices can be connected.

SMI makes the flash content directly accessible in the CPU address space; each external device is mapped in a memory bank. CPU can directly read data, execute code and boot from SMI banks. Normal OpenOCD commands like mdw can be used to display the flash content.

The setup command only requires the base parameter in order to identify the memory bank. All other parameters are ignored. Additional information, like flash size, are detected automatically.

| flash bank $_FLASHNAME stmsmi 0xf8000000 0 0 0 $_TARGETNAME
stmqspi | [Flash Driver]
Some devices from STMicroelectronics include a proprietary “QuadSPI Interface” (e.g. STM32F4, STM32F7, STM32L4) or “OctoSPI Interface” (e.g. STM32L4+) controller able to drive one or even two (dual mode) external SPI flash devices. The OctoSPI is a superset of QuadSPI, its presence is detected automatically. Currently only the regular command mode is supported, whereas the HyperFlash mode is not.

QuadSPI/OctoSPI makes the flash contents directly accessible in the CPU address space; in case of dual mode both devices must be of the same type and are mapped in the same memory bank (even and odd addresses interleaved). CPU can directly read data, execute code (but not boot) from QuadSPI bank.

The ’flash bank’ command only requires the base parameter and the extra parameter io base in order to identify the memory bank. Both are fixed by hardware, see datasheet or RM. All other parameters are ignored.

The controller must be initialized after each reset and properly configured for memory-mapped read operation for the particular flash chip(s), for the full list of available register settings cf. the controller’s RM. This setup is quite board specific (that’s why booting from this memory is not possible). The flash driver infers all parameters from current controller register values when ’flash probe bank id’ is executed.

Chapter 12: Flash Commands | 87

Normal OpenOCD commands like mdw can be used to display the flash content, but only after proper controller initialization as described above. However, due to a silicon bug in some devices, attempting to access the very last word should be avoided.
It is possible to use two (even different) flash chips alternatingly, if individual bank chip selects are available. For some package variants, this is not the case due to limited pin count. To switch from one to another, adjust FSEL bit accordingly and re-issue ’flash probe bank id’. Note that the bank base address will not change, so the address spaces of both devices will overlap. In dual flash mode both chips must be identical regarding size and most other properties.
Block or sector protection internal to the flash chip is not handled by this driver at all, but can be dealt with manually by the ’cmd’ command, see below. The sector protection via ’flash protect’ command etc. is completely internal to openocd, intended only to prevent accidental erase or overwrite and it does not persist across openocd invocations.
OpenOCD contains a hardcoded list of flash devices with their properties, these are auto-detected. If a device is not included in this list, SFDP discovery is attempted. If this fails or gives inappropriate results, manual setting is required (see ’set’ command).

flash bank $_FLASHNAME stmqspi 0x90000000 0 0 0 \
$_TARGETNAME 0xA0001000
flash bank $_FLASHNAME stmqspi 0x70000000 0 0 0 \
$_TARGETNAME 0xA0001400
There are three specific commands
stmqspi mass_erase bank id | [Command]
Clears sector protections and performs a mass erase. Works only if there is no chip specific write protection engaged.
stmqspi set bank id name total size page size read cmd | [Command]
fread cmd pprg cmd mass erase cmd sector size sector erase cmd Set flash parameters: name human readable string, total size size in bytes, page size is write page size. read cmd, fread cmd and pprg cmd are commands for reading and page programming. fread cmd is used in DPI and QPI modes, read cmd in normal SPI (single line) mode. mass erase cmd, sector size and sector erase cmd are optional.
This command is required if chip id is not hardcoded yet and e.g. for EEPROMs or FRAMs which don’t support an id command.
In dual mode parameters of both chips are set identically. The parameters refer to a single chip, so the whole bank gets twice the specified capacity etc.
stmqspi cmd bank id resp num cmd byte ... | [Command]
If resp num is zero, sends command cmd byte and following data bytes. In dual mode command byte is sent to both chips but data bytes are sent alternatingly to chip 1 and 2, first to flash 1, second to flash 2, etc., i.e. the total number of bytes (including cmd byte) must be odd.

If resp num is not zero, cmd and at most four following data bytes are sent, in dual mode simultaneously to both chips. Then resp num bytes are read

Chapter 12: Flash Commands | 88

interleaved from both chips starting with chip 1. In this case resp num must be even.
Note the hardware dictated subtle difference of those two cases in dual-flash mode.
To check basic communication settings, issue

stmqspi cmd bank_id 0 0x04; stmqspi cmd bank_id 1 0x05 stmqspi cmd bank_id 0 0x06; stmqspi cmd bank_id 1 0x05 for single flash mode or

stmqspi cmd bank_id 0 0x04; stmqspi cmd bank_id 2 0x05 stmqspi cmd bank_id 0 0x06; stmqspi cmd bank_id 2 0x05
for dual flash mode. This should return the status register contents.
In 8-line mode, cmd byte is sent twice - first time as given, second time complemented. Additionally, in 8-line mode only, some commands (e.g. Read Status) need a dummy address, e.g.

stmqspi cmd bank_id 1 0x05 0x00 0x00 0x00 0x00
should return the status register contents.
mrvlqspi | [Flash Driver]
This driver supports QSPI flash controller of Marvell’s Wireless Microcontroller platform.
The flash size is autodetected based on the table of known JEDEC IDs hardcoded in the OpenOCD sources.
| flash bank $_FLASHNAME mrvlqspi 0x0 0 0 0 $_TARGETNAME 0x46010000
ath79 | [Flash Driver]
Members of ATH79 SoC family from Atheros include a SPI interface with 3 chip selects. On reset a SPI flash connected to the first chip select (CS0) is made directly read-accessible in the CPU address space (up to 16MBytes) and is usually used to store the bootloader and operating system. Normal OpenOCD commands like mdw can be used to display the flash content while it is in memory-mapped mode (only the first 4MBytes are accessible without additional configuration on reset).
The setup command only requires the base parameter in order to identify the memory bank. The actual value for the base address is not otherwise used by the driver. However the mapping is passed to gdb. Thus for the memory mapped flash (chipselect CS0) the base address should be the actual memory mapped base address. For unmapped chipselects (CS1 and CS2) care should be taken to use a base address that does not overlap with real memory regions. Additional information, like flash size, are detected automatically. An optional additional parameter sets the chipselect for the bank, with the default CS0. CS1 and CS2 require additional GPIO setup before they can be used since the alternate function must be enabled on the GPIO pin CS1/CS2 is routed to on the given SoC.
| flash bank $_FLASHNAME ath79 0xbf000000 0 0 0 $_TARGETNAME
| # When using multiple chipselects the base should be different # for each, otherwise the write_image command is not able to

Chapter 12: Flash Commands | 89

# distinguish the banks.

flash bank flash0 ath79 0xbf000000 0 0 0 $_TARGETNAME cs0 flash bank flash1 ath79 0x10000000 0 0 0 $_TARGETNAME cs1 flash bank flash2 ath79 0x20000000 0 0 0 $_TARGETNAME cs2
fespi | [Flash Driver]
SiFive’s Freedom E SPI controller, used in HiFive and other boards.

flash bank $_FLASHNAME fespi 0x20000000 0 0 0 $_TARGETNAME

### 12.5.2 Internal Flash (Microcontrollers)

aduc702x | [Flash Driver]
The ADUC702x analog microcontrollers from Analog Devices include internal flash and use ARM7TDMI cores. The aduc702x flash driver works with models ADUC7019 through ADUC7028. The setup command only requires the target argument since all devices in this family have the same memory layout.

flash bank $_FLASHNAME aduc702x 0 0 0 0 $_TARGETNAME

ambiqmicro | [Flash Driver]
All members of the Apollo microcontroller family from Ambiq Micro include internal flash and use ARM’s Cortex-M4 core. The host connects over USB to an FTDI interface that communicates with the target using SWD.
The ambiqmicro driver reads the Chip Information Register detect the device class of the MCU. The Flash and SRAM sizes directly follow device class, and are used to set up the flash banks. If this fails, the driver will use default values set to the minimum sizes of an Apollo chip.
All Apollo chips have two flash banks of the same size. In all cases the first flash bank starts at location 0, and the second bank starts after the first.

# Flash bank 0

flash bank $_FLASHNAME ambiqmicro 0 0x00040000 0 0 $_TARGETNAME # Flash bank 1 - same size as bank0, starts after bank 0.
flash bank $_FLASHNAME ambiqmicro 0x00040000 0x00040000 0 0 \ $_TARGETNAME
Flash is programmed using custom entry points into the bootloader. This is the only way to program the flash as no flash control registers are available to the user.
The ambiqmicro driver adds some additional commands:
ambiqmicro mass_erase <bank> | [Command]
Erase entire bank.
ambiqmicro page_erase <bank> <first> <last> | [Command]
Erase device pages.
ambiqmicro program_otp <bank> <offset> <count> | [Command]
Program OTP is a one time operation to create write protected flash. The user writes sectors to SRAM starting at 0x10000010. Program OTP will write these sectors from SRAM to flash, and write protect the flash.

Chapter 12: Flash Commands | 90
at91samd | [Flash Driver]
All members of the ATSAM D2x, D1x, D0x, ATSAMR, ATSAML and ATSAMC microcontroller families from Atmel include internal flash and use ARM’s Cortex-M0+ core.

Do not use for ATSAM D51 and E5x: use See [atsame5], page 92.

The devices have one flash bank:

flash bank $_FLASHNAME at91samd 0x00000000 0 1 1 $_TARGETNAME

at91samd chip-erase | [Command]
Issues a complete Flash erase via the Device Service Unit (DSU). This can be used to erase a chip back to its factory state and does not require the processor to be halted.
at91samd set-security | [Command]
Secures the Flash via the Set Security Bit (SSB) command. This prevents access to the Flash and can only be undone by using the chip-erase command which erases the Flash contents and turns off the security bit. Warning: at this time, openocd will not be able to communicate with a secured chip and it is therefore not possible to chip-erase it without using another tool.

at91samd set-security enable

at91samd eeprom | [Command]
Shows or sets the EEPROM emulation size configuration, stored in the User Row of the Flash. When setting, the EEPROM size must be specified in bytes and it must be one of the permitted sizes according to the datasheet. Settings are written immediately but only take effect on MCU reset. EEPROM emulation requires additional firmware support and the minimum EEPROM size may not be the same as the minimum that the hardware supports. Set the EEPROM size to 0 in order to disable this feature.

at91samd eeprom
at91samd eeprom 1024
at91samd bootloader | [Command]
Shows or sets the bootloader size configuration, stored in the User Row of the Flash. This is called the BOOTPROT region. When setting, the bootloader size must be specified in bytes and it must be one of the permitted sizes according to the datasheet. Settings are written immediately but only take effect on MCU reset. Setting the bootloader size to 0 disables bootloader protection.

at91samd bootloader
at91samd bootloader 16384
at91samd dsu_reset_deassert | [Command]
This command releases internal reset held by DSU and prepares reset vector catch in case of reset halt. Command is used internally in event reset-deassertpost.

Chapter 12: Flash Commands | 91
at91samd nvmuserrow | [Command]
Writes or reads the entire 64 bit wide NVM user row register which is located at 0x804000. This register includes various fuses lock-bits and factory calibration data. Reading the register is done by invoking this command without any arguments. Writing is possible by giving 1 or 2 hex values. The first argument is the register value to be written and the second one is an optional changemask. Every bit which value in changemask is 0 will stay unchanged. The lock- and reserved-bits are masked out and cannot be changed.

# Read user row

>at91samd nvmuserrow
NVMUSERROW: 0xFFFFFC5DD8E0C788
# Write 0xFFFFFC5DD8E0C788 to user row

>at91samd nvmuserrow 0xFFFFFC5DD8E0C788
# Write 0x12300 to user row but leave other bits and low # byte unchanged

>at91samd nvmuserrow 0x12345 0xFFF00
at91sam3 | [Flash Driver]
All members of the AT91SAM3 microcontroller family from Atmel include internal flash and use ARM’s Cortex-M3 core. The driver currently (6/22/09) recognizes the AT91SAM3U[1/2/4][C/E] chips. Note that the driver was orginaly developed and tested using the AT91SAM3U4E, using a SAM3U-EK eval board. Support for other chips in the family was cribbed from the data sheet. Note to future readers/updaters: Please remove this worrisome comment after other chips are confirmed.
The AT91SAM3U4[E/C] (256K) chips have two flash banks; most other chips have one flash bank. In all cases the flash banks are at the following fixed locations:

# Flash bank 0 - all chips

flash bank $_FLASHNAME at91sam3 0x00080000 0 1 1 $_TARGETNAME
# Flash bank 1 - only 256K chips

flash bank $_FLASHNAME at91sam3 0x00100000 0 1 1 $_TARGETNAME Internally, the AT91SAM3 flash memory is organized as follows. Unlike the AT91SAM7 chips, these are not used as parameters to the flash bank command:
- N-Banks: 256K chips have 2 banks, others have 1 bank.
- Bank Size: 128K/64K Per flash bank
- Sectors: 16 or 8 per bank
- SectorSize: 8K Per Sector
- PageSize: 256 bytes per page. Note that OpenOCD operates on ’sector’ sizes, not page sizes.

The AT91SAM3 driver adds some additional commands:

at91sam3 gpnvm | [Command]
at91sam3 gpnvm clear number | [Command]
at91sam3 gpnvm set number | [Command]
at91sam3 gpnvm show [all|number] | [Command]
With no parameters, show or show all, shows the status of all GPNVM bits. With show number, displays that bit.

Chapter 12: Flash Commands | 92

With set number or clear number, modifies that GPNVM bit.

at91sam3 info | [Command]
This command attempts to display information about the AT91SAM3 chip. First it read the CHIPID_CIDR [address 0x400e0740, see Section 28.2.1, page 505 of the AT91SAM3U 29/may/2009 datasheet, document id: doc6430A] and decodes the values. Second it reads the various clock configuration registers and attempts to display how it believes the chip is configured. By default, the SLOWCLK is assumed to be 32768 Hz, see the command at91sam3 slowclk.
at91sam3 slowclk [value] | [Command]
This command shows/sets the slow clock frequency used in the at91sam3 info command calculations above.
at91sam4 | [Flash Driver]
All members of the AT91SAM4 microcontroller family from Atmel include internal flash and use ARM’s Cortex-M4 core. This driver uses the same command names/syntax as See [at91sam3], page 91.
at91sam4l | [Flash Driver]
All members of the AT91SAM4L microcontroller family from Atmel include internal flash and use ARM’s Cortex-M4 core. This driver uses the same command names/syntax as See [at91sam3], page 91.
The AT91SAM4L driver adds some additional commands:
at91sam4l smap_reset_deassert | [Command]
This command releases internal reset held by SMAP and prepares reset vector catch in case of reset halt. Command is used internally in event reset-deassertpost.
atsame5 | [Flash Driver]
All members of the SAM E54, E53, E51 and D51 microcontroller families from Microchip (former Atmel) include internal flash and use ARM’s Cortex-M4 core.
The devices have two ECC flash banks with a swapping feature. This driver handles both banks together as it were one. Bank swapping is not supported yet.
flash bank $_FLASHNAME atsame5 0x00000000 0 1 1 $_TARGETNAME
atsame5 bootloader | [Command]
Shows or sets the bootloader size configuration, stored in the User Page of the Flash. This is called the BOOTPROT region. When setting, the bootloader size must be specified in bytes. The nearest bigger protection size is used. Settings are written immediately but only take effect on MCU reset. Setting the bootloader size to 0 disables bootloader protection.

atsame5 bootloader
atsame5 bootloader 16384
atsame5 chip-erase | [Command]
Issues a complete Flash erase via the Device Service Unit (DSU). This can be used to erase a chip back to its factory state and does not require the processor to be halted.

Chapter 12: Flash Commands | 93
atsame5 dsu_reset_deassert | [Command]
This command releases internal reset held by DSU and prepares reset vector catch in case of reset halt. Command is used internally in event reset-deassertpost.
atsame5 userpage | [Command]
Writes or reads the first 64 bits of NVM User Page which is located at 0x804000. This field includes various fuses. Reading is done by invoking this command without any arguments. Writing is possible by giving 1 or 2 hex values. The first argument is the value to be written and the second one is an optional bit mask (a zero bit in the mask means the bit stays unchanged). The reserved fields are always masked out and cannot be changed.

# Read

>atsame5 userpage
USER PAGE: 0xAEECFF80FE9A9239
# Write

>atsame5 userpage 0xAEECFF80FE9A9239
# Write 2 to SEESBLK and 4 to SEEPSZ fields but leave other # bits unchanged (setup SmartEEPROM of virtual size 8192 # bytes)

>atsame5 userpage 0x4200000000 0x7f00000000
atsamv | [Flash Driver]
All members of the ATSAMV7x, ATSAMS70, and ATSAME70 families from Atmel include internal flash and use ARM’s Cortex-M7 core. This driver uses the same command names/syntax as See [at91sam3], page 91.

flash bank $_FLASHNAME atsamv 0x00400000 0 0 0 $_TARGETNAME

atsamv gpnvm [show [all|number]] | [Command]
atsamv gpnvm (clr|set) number | [Command]
With no parameters, show or show all, shows the status of all GPNVM bits. With show number, displays that bit.
With set number or clear number, modifies that GPNVM bit.
at91sam7 | [Flash Driver]
All members of the AT91SAM7 microcontroller family from Atmel include internal flash and use ARM7TDMI cores. The driver automatically recognizes a number of these chips using the chip identification register, and autoconfigures itself.

flash bank $_FLASHNAME at91sam7 0 0 0 0 $_TARGETNAME
For chips which are not recognized by the controller driver, you must provide additional parameters in the following order:
- chip model ... label used with flash info
- banks
- sectors per bank
- pages per sector
- pages size

Chapter 12: Flash Commands | 94
- num nvm bits
- freq khz ... required if an external clock is provided, optional (but recommended) when the oscillator frequency is known

It is recommended that you provide zeroes for all of those values except the clock frequency, so that everything except that frequency will be autoconfigured. Knowing the frequency helps ensure correct timings for flash access.
The flash controller handles erases automatically on a page (128/256 byte) basis, so explicit erase commands are not necessary for flash programming. However, there is an “EraseAll“ command that can erase an entire flash plane (of up to 256KB), and it will be used automatically when you issue flash erase_sector or flash erase_ address commands.
at91sam7 gpnvm bitnum (set|clear) | [Command]
Set or clear a “General Purpose Non-Volatile Memory” (GPNVM) bit for the processor. Each processor has a number of such bits, used for controlling features such as brownout detection (so they are not truly general purpose). Note: This assumes that the first flash bank (number 0) is associated with the appropriate at91sam7 target.
avr | [Flash Driver]
The AVR 8-bit microcontrollers from Atmel integrate flash memory. The current implementation is incomplete.
bluenrg-x | [Flash Driver]
STMicroelectronics BlueNRG-1, BlueNRG-2 and BlueNRG-LP Bluetooth low energy wireless system-on-chip. They include ARM Cortex-M0/M0+ core and internal flash memory. The driver automatically recognizes these chips using the chip identification registers, and autoconfigures itself.

flash bank $_FLASHNAME bluenrg-x 0 0 0 0 $_TARGETNAME
Note that when users ask to erase all the sectors of the flash, a mass erase command is used which is faster than erasing each single sector one by one.

flash erase_sector 0 0 last # It will perform a mass erase Triggering a mass erase is also useful when users want to disable readout protection.

cc26xx | [Flash Driver]
All versions of the SimpleLink CC13xx and CC26xx microcontrollers from Texas Instruments include internal flash. The cc26xx flash driver supports both the CC13xx and CC26xx family of devices. The driver automatically recognizes the specific version’s flash parameters and autoconfigures itself. The flash bank starts at address 0.

flash bank $_FLASHNAME cc26xx 0 0 0 0 $_TARGETNAME

cc3220sf | [Flash Driver]
The CC3220SF version of the SimpleLink CC32xx microcontrollers from Texas Instruments includes 1MB of internal flash. The cc3220sf flash driver only supports the internal flash. The serial flash on SimpleLink boards is programmed via the

Chapter 12: Flash Commands | 95

bootloader over a UART connection. Security features of the CC3220SF may erase the internal flash during power on reset. Refer to documentation at www.ti.com/ cc3220sf for details on security features and programming the serial flash.

flash bank $_FLASHNAME cc3220sf 0 0 0 0 $_TARGETNAME

efm32 | [Flash Driver]
All members of the EFM32 microcontroller family from Energy Micro include internal flash and use ARM Cortex-M3 cores. The driver automatically recognizes a number of these chips using the chip identification register, and autoconfigures itself.

flash bank $_FLASHNAME efm32 0 0 0 0 $_TARGETNAME

A special feature of efm32 controllers is that it is possible to completely disable the debug interface by writing the correct values to the ’Debug Lock Word’. OpenOCD supports this via the following command:

efm32 debuglock num
The num parameter is a value shown by flash banks. Note that in order for this command to take effect, the target needs to be reset. The current implementation is incomplete. Unprotecting flash pages is not supported.
esirisc | [Flash Driver]
Members of the eSi-RISC family may optionally include internal flash programmed via the eSi-TSMC Flash interface. Additional parameters are required to configure the driver: cfg_address is the base address of the configuration register interface, clock_ hz is the expected clock frequency, and wait_states is the number of configured read wait states.

flash bank $_FLASHNAME esirisc base_address size_bytes 0 0 \ $_TARGETNAME cfg_address clock_hz wait_states

esirisc flash mass_erase bank id | [Command]
Erase all pages in data memory for the bank identified by bank_id.
esirisc flash ref_erase bank id | [Command]
Erase the reference cell for the bank identified by bank_id. This is an uncommon operation.
fm3 | [Flash Driver]
All members of the FM3 microcontroller family from Fujitsu include internal flash and use ARM Cortex-M3 cores. The fm3 driver uses the target parameter to select the correct bank config, it can currently be one of the following: mb9bfxx1.cpu, mb9bfxx2.cpu, mb9bfxx3.cpu, mb9bfxx4.cpu, mb9bfxx5.cpu or mb9bfxx6.cpu.

flash bank $_FLASHNAME fm3 0 0 0 0 $_TARGETNAME

fm4 | [Flash Driver]
All members of the FM4 microcontroller family from Spansion (formerly Fujitsu) include internal flash and use ARM Cortex-M4 cores. The fm4 driver uses a family parameter to select the correct bank config, it can currently be one of the following: MB9BFx64, MB9BFx65, MB9BFx66, MB9BFx67, MB9BFx68, S6E2Cx8, S6E2Cx9, S6E2CxA

Chapter 12: Flash Commands | 96

or S6E2Dx, with x treated as wildcard and otherwise case (and any trailing characters) ignored.
flash bank ${_FLASHNAME}0 fm4 0x00000000 0 0 0 \
$_TARGETNAME S6E2CCAJ0A
flash bank ${_FLASHNAME}1 fm4 0x00100000 0 0 0 \
$_TARGETNAME S6E2CCAJ0A
The current implementation is incomplete. Protection is not supported, nor is Chip Erase (only Sector Erase is implemented).
kinetis | [Flash Driver]
Kx, KLx, KVx and KE1x members of the Kinetis microcontroller family from NXP (former Freescale) include internal flash and use ARM Cortex-M0+ or M4 cores. The driver automatically recognizes flash size and a number of flash banks (1-4) using the chip identification register, and autoconfigures itself. Use kinetis ke driver for KE0x and KEAx devices.
The kinetis driver defines option:
- -sim-base addr ... base of System Integration Module where chip identification resides. Driver tries two known locations if option is omitted.

flash bank $_FLASHNAME kinetis 0 0 0 0 $_TARGETNAME

kinetis create_banks | [Config Command]
Configuration command enables automatic creation of additional flash banks based on real flash layout of device. Banks are created during device probe. Use ’flash probe 0’ to force probe.
kinetis fcf_source [protection|write] | [Command]
Select what source is used when writing to a Flash Configuration Field. protection mode builds FCF content from protection bits previously set by ’flash protect’ command. This mode is default. MCU is protected from unwanted locking by immediate writing FCF after erase of relevant sector. write mode enables direct write to FCF. Protection cannot be set by ’flash protect’ command. FCF is written along with the rest of a flash image. BEWARE: Incorrect flash configuration may permanently lock the device!
kinetis fopt [num] | [Command]
Set value to write to FOPT byte of Flash Configuration Field. Used in kinetis ’fcf source protection’ mode only.
kinetis mdm check_security | [Command]
Checks status of device security lock. Used internally in examine-end and examine-fail event.
kinetis mdm halt | [Command]
Issues a halt via the MDM-AP. This command can be used to break a watchdog reset loop when connecting to an unsecured target.
kinetis mdm mass_erase | [Command]
Issues a complete flash erase via the MDM-AP. This can be used to erase a chip back to its factory state, removing security. It does not require the processor to

Chapter 12: Flash Commands | 97

be halted, however the target will remain in a halted state after this command completes.

kinetis nvm_partition | [Command]
For FlexNVM devices only (KxxDX and KxxFX). Command shows or sets data flash or EEPROM backup size in kilobytes, sets two EEPROM blocks sizes in bytes and enables/disables loading of EEPROM contents to FlexRAM during reset.
For details see device reference manual, Flash Memory Module, Program Partition command.
Setting is possible only once after mass erase. Reset the device after partition setting.
Show partition size:

kinetis nvm_partition info
Set 32 KB data flash, rest of FlexNVM is EEPROM backup. EEPROM has two blocks of 512 and 1536 bytes and its contents is loaded to FlexRAM during reset:

kinetis nvm_partition dataflash 32 512 1536 on
Set 16 KB EEPROM backup, rest of FlexNVM is a data flash. EEPROM has two blocks of 1024 bytes and its contents is not loaded to FlexRAM during reset:

kinetis nvm_partition eebkp 16 1024 1024 off

kinetis mdm reset | [Command]
Issues a reset via the MDM-AP. This causes the MCU to output a low pulse on the RESET pin, which can be used to reset other hardware on board.
kinetis disable_wdog | [Command]
For Kx devices only (KLx has different COP watchdog, it is not supported). Command disables watchdog timer.
kinetis_ke | [Flash Driver]
KE0x and KEAx members of the Kinetis microcontroller family from NXP include internal flash and use ARM Cortex-M0+. The driver automatically recognizes the KE0x sub-family using the chip identification register, and autoconfigures itself. Use kinetis (not kinetis ke) driver for KE1x devices.

flash bank $_FLASHNAME kinetis_ke 0 0 0 0 $_TARGETNAME

kinetis_ke mdm check_security | [Command]
Checks status of device security lock. Used internally in examine-end event.
kinetis_ke mdm mass_erase | [Command]
Issues a complete Flash erase via the MDM-AP. This can be used to erase a chip back to its factory state. Command removes security lock from a device (use of SRST highly recommended). It does not require the processor to be halted.

Chapter 12: Flash Commands | 98
kinetis_ke disable_wdog | [Command]
Command disables watchdog timer.
lpc2000 | [Flash Driver]
This is the driver to support internal flash of all members of the LPC11(x)00 and LPC1300 microcontroller families and most members of the LPC800, LPC1500, LPC1700, LPC1800, LPC2000, LPC4000, LPC54100, LPC8Nxx and NHS31xx microcontroller families from NXP.
Note: There are LPC2000 devices which are not supported by the lpc2000 driver: The LPC2888 is supported by the lpc288x driver. The LPC29xx family is supported by the lpc2900 driver.
The lpc2000 driver defines two mandatory and two optional parameters, which must appear in the following order:
- variant ... required, may be lpc2000_v1 (older LPC21xx and LPC22xx) lpc2000_v2 (LPC213x, LPC214x, LPC210[123], LPC23xx and LPC24xx) lpc1700 (LPC175x and LPC176x and LPC177x/8x) lpc4300 - available also as lpc1800 alias (LPC18x[2357] and LPC43x[2357]) lpc800 (LPC8xx) lpc1100 (LPC11(x)xx and LPC13xx) lpc1500 (LPC15xx) lpc54100 (LPC541xx) lpc4000 (LPC40xx) or auto - automatically detects flash variant and size for LPC11(x)00, LPC8xx, LPC13xx, LPC17xx, LPC40xx, LPC8Nxx and NHS31xx
- clock kHz ... the frequency, in kiloHertz, at which the core is running
- calc_checksum ... optional (but you probably want to provide this!), telling the driver to calculate a valid checksum for the exception vector table.
Note: If you don’t provide calc_checksum when you’re writing the vector table, the boot ROM will almost certainly ignore your flash image. However, if you do provide it, with most tool chains verify_ image will fail.
- iap_entry ... optional telling the driver to use a different ROM IAP entry point.

LPC flashes don’t require the chip and bus width to be specified.

flash bank $_FLASHNAME lpc2000 0x0 0x7d000 0 0 $_TARGETNAME \ lpc2000_v2 14765 calc_checksum

lpc2000 part_id bank | [Command]
Displays the four byte part identifier associated with the specified flash bank.
lpc288x | [Flash Driver]
The LPC2888 microcontroller from NXP needs slightly different flash support from its lpc2000 siblings. The lpc288x driver defines one mandatory parameter, the programming clock rate in Hz. LPC flashes don’t require the chip and bus width to be specified.

flash bank $_FLASHNAME lpc288x 0 0 0 0 $_TARGETNAME 12000000

lpc2900 | [Flash Driver]
This driver supports the LPC29xx ARM968E based microcontroller family from NXP. The predefined parameters base, size, chip width and bus width of the flash bank command are ignored. Flash size and sector layout are auto-configured by the driver.

Chapter 12: Flash Commands | 99

The driver has one additional mandatory parameter: The CPU clock rate (in kHz) at the time the flash operations will take place. Most of the time this will not be the crystal frequency, but a higher PLL frequency. The reset-init event handler in the board script is usually the place where you start the PLL.
The driver rejects flashless devices (currently the LPC2930).
The EEPROM in LPC2900 devices is not mapped directly into the address space. It must be handled much more like NAND flash memory, and will therefore be handled by a separate lpc2900_eeprom driver (not yet available).
Sector protection in terms of the LPC2900 is handled transparently. Every time a sector needs to be erased or programmed, it is automatically unprotected. What is shown as protection status in the flash info command, is actually the LPC2900 sector security. This is a mechanism to prevent a sector from ever being erased or programmed again. As this is an irreversible mechanism, it is handled by a special command (lpc2900 secure_sector), and not by the standard flash protect command.
Example for a 125 MHz clock frequency:

flash bank $_FLASHNAME lpc2900 0 0 0 0 $_TARGETNAME 125000
Some lpc2900-specific commands are defined. In the following command list, the bank parameter is the bank number as obtained by the flash banks command.
lpc2900 signature bank | [Command]
Calculates a 128-bit hash value, the signature, from the whole flash content. This is a hardware feature of the flash block, hence the calculation is very fast. You may use this to verify the content of a programmed device against a known signature. Example:

lpc2900 signature 0
signature: 0x5f40cdc8:0xc64e592e:0x10490f89:0x32a0f317
lpc2900 read_custom bank filename | [Command]
Reads the 912 bytes of customer information from the flash index sector, and saves it to a file in binary format. Example:

lpc2900 read_custom 0 /path_to/customer_info.bin

The index sector of the flash is a write-only sector. It cannot be erased! In order to guard against unintentional write access, all following commands need to be preceded by a successful call to the password command:

lpc2900 password bank password | [Command]
You need to use this command right before each of the following commands: lpc2900 write_custom, lpc2900 secure_sector, lpc2900 secure_jtag. The password string is fixed to "I know what I am doing". Example:

lpc2900 password 0 I_know_what_I_am_doing
Potentially dangerous operation allowed in next command!
lpc2900 write_custom bank filename type | [Command]
Writes the content of the file into the customer info space of the flash index sector. The filetype can be specified with the type field. Possible values for type

Chapter 12: Flash Commands | 100

are: bin (binary), ihex (Intel hex format), elf (ELF binary) or s19 (Motorola S-records). The file must contain a single section, and the contained data length must be exactly 912 bytes.
Attention: This cannot be reverted! Be careful!
Example:

lpc2900 write_custom 0 /path_to/customer_info.bin bin

lpc2900 secure_sector bank first last | [Command]
Secures the sector range from first to last (including) against further program and erase operations. The sector security will be effective after the next power cycle.
Attention: This cannot be reverted! Be careful!
Secured sectors appear as protected in the flash info command. Example:

lpc2900 secure_sector 0 1 1
flash info 0
#0 : lpc2900 at 0x20000000, size 0x000c0000, (...)

# | 0: 0x00000000 (0x2000 8kB) not protected

# | 1: 0x00002000 (0x2000 8kB) protected

# | 2: 0x00004000 (0x2000 8kB) not protected

lpc2900 secure_jtag bank | [Command]
Irreversibly disable the JTAG port. The new JTAG security setting will be effective after the next power cycle.
Attention: This cannot be reverted! Be careful!
Examples:

lpc2900 secure_jtag 0

mdr | [Flash Driver]
This drivers handles the integrated NOR flash on Milandr Cortex-M based controllers. A known limitation is that the Info memory can’t be read or verified as it’s not memory mapped.

flash bank <name> mdr <base> <size> \
0 0 <target#> type page_count sec_count
- type - 0 for main memory, 1 for info memory
- page count - total number of pages
- sec count - number of sector per page count

Example usage:

if { [info exists IMEMORY] && [string equal $IMEMORY true] } { flash bank ${_CHIPNAME}_info.flash mdr 0x00000000 0x01000 \ 0 0 $_TARGETNAME 1 1 4
} else {
flash bank $_CHIPNAME.flash mdr 0x00000000 0x20000 \
0 0 $_TARGETNAME 0 32 4
}

Chapter 12: Flash Commands | 101
msp432 | [Flash Driver]
All versions of the SimpleLink MSP432 microcontrollers from Texas Instruments include internal flash. The msp432 flash driver automatically recognizes the specific version’s flash parameters and autoconfigures itself. Main program flash starts at address 0. The information flash region on MSP432P4 versions starts at address 0x200000.

flash bank $_FLASHNAME msp432 0 0 0 0 $_TARGETNAME

msp432 mass_erase bank id [main|all] | [Command]
Performs a complete erase of flash. By default, mass_erase will erase only the main program flash.

On MSP432P4 versions, using mass_erase all will erase both the main program and information flash regions. To also erase the BSL in information flash, the user must first use the bsl command.

msp432 bsl bank id [unlock|lock] | [Command]
On MSP432P4 versions, bsl unlocks and locks the bootstrap loader (BSL) region in information flash so that flash commands can erase or write the BSL. Leave the BSL locked to prevent accidentally corrupting the bootstrap loader.

To erase and program the BSL:

msp432 bsl unlock
flash erase_address 0x202000 0x2000 flash write_image bsl.bin 0x202000 msp432 bsl lock
niietcm4 | [Flash Driver]
This drivers handles the integrated NOR flash on NIIET Cortex-M4 based controllers. Flash size and sector layout are auto-configured by the driver. Main flash memory is called "Bootflash" and has main region and info region. Info region is NOT memory mapped by default, but it can replace first part of main region if needed. Full erase, single and block writes are supported for both main and info regions. There is additional not memory mapped flash called "Userflash", which also have division into regions: main and info. Purpose of userflash - to store system and user settings. Driver has special commands to perform operations with this memory.

flash bank $_FLASHNAME niietcm4 0 0 0 0 $_TARGETNAME

Some niietcm4-specific commands are defined:

niietcm4 uflash_read_byte bank (’main’|’info’) address | [Command]
Read byte from main or info userflash region.
niietcm4 uflash_write_byte bank (’main’|’info’) address | [Command]
value
Write byte to main or info userflash region.
niietcm4 uflash_full_erase bank | [Command]
Erase all userflash including info region.

Chapter 12: Flash Commands | 102
niietcm4 uflash_erase bank (’main’|’info’) first sector | [Command]
last sector
Erase sectors of main or info userflash region, starting at sector first up to and including last.
niietcm4 uflash_protect_check bank (’main’|’info’) | [Command]
Check sectors protect.
niietcm4 uflash_protect bank (’main’|’info’) first sector | [Command]
last sector (’on’|’off’)
Protect sectors of main or info userflash region, starting at sector first up to and including last.
niietcm4 bflash_info_remap bank (’on’|’off’) | [Command]
Enable remapping bootflash info region to 0x00000000 (or 0x40000000 if external memory boot used).
niietcm4 extmem_cfg bank | [Command]
(’gpioa’|’gpiob’|’gpioc’|’gpiod’|’gpioe’|’gpiof’|’gpiog’|’gpioh’) pin num (’func1’|’func3’)
Configure external memory interface for boot.
niietcm4 service_mode_erase bank | [Command]
Perform emergency erase of all flash (bootflash and userflash).
niietcm4 driver_info bank | [Command]
Show information about flash driver.
npcx | [Flash Driver]
All versions of the NPCX microcontroller families from Nuvoton include internal flash. The NPCX flash driver supports the NPCX family of devices. The driver automatically recognizes the specific version’s flash parameters and autoconfigures itself. The flash bank starts at address 0x64000000.

flash bank $_FLASHNAME npcx 0x64000000 0 0 0 $_TARGETNAME

nrf5 | [Flash Driver]
All members of the nRF51 microcontroller families from Nordic Semiconductor include internal flash and use ARM Cortex-M0 core. nRF52 family powered by ARM Cortex-M4 or M4F core is supported too. nRF52832 is fully supported including BPROT flash protection scheme. nRF52833 and nRF52840 devices are supported with the exception of security extensions (flash access control list - ACL).

flash bank $_FLASHNAME nrf5 0 0x00000000 0 0 $_TARGETNAME

Some nrf5-specific commands are defined:

nrf5 mass_erase | [Command]
Erases the contents of the code memory and user information configuration registers as well. It must be noted that this command works only for chips that do not have factory pre-programmed region 0 code.

Chapter 12: Flash Commands | 103
nrf5 info | [Command]
Decodes and shows information from FICR and UICR registers.
ocl | [Flash Driver]
This driver is an implementation of the “on chip flash loader” protocol proposed by Pavel Chromy.

It is a minimalistic command-response protocol intended to be used over a DCC when communicating with an internal or external flash loader running from RAM. An example implementation for AT91SAM7x is available in contrib/loaders/flash/at91sam7x/.

flash bank $_FLASHNAME ocl 0 0 0 0 $_TARGETNAME

pic32mx | [Flash Driver]
The PIC32MX microcontrollers are based on the MIPS 4K cores, and integrate flash memory.

flash bank $_FLASHNAME pix32mx 0x1fc00000 0 0 0 $_TARGETNAME flash bank $_FLASHNAME pix32mx 0x1d000000 0 0 0 $_TARGETNAME Some pic32mx-specific commands are defined:

pic32mx pgm_word address value bank | [Command]
Programs the specified 32-bit value at the given address in the specified chip bank.
pic32mx unlock bank | [Command]
Unlock and erase specified chip bank. This will remove any Code Protection.
psoc4 | [Flash Driver]
All members of the PSoC 41xx/42xx microcontroller family from Cypress include internal flash and use ARM Cortex-M0 cores. The driver automatically recognizes a number of these chips using the chip identification register, and autoconfigures itself. Note: Erased internal flash reads as 00. System ROM of PSoC 4 does not implement erase of a flash sector.

flash bank $_FLASHNAME psoc4 0 0 0 0 $_TARGETNAME
psoc4-specific commands
psoc4 flash_autoerase num (on|off) | [Command]
Enables or disables autoerase mode for a flash bank.
If flash autoerase is off, use mass erase before flash programming. Flash erase command fails if region to erase is not whole flash memory.
If flash autoerase is on, a sector is both erased and programmed in one system ROM call. Flash erase command is ignored. This mode is suitable for gdb load.

The num parameter is a value shown by flash banks.

psoc4 mass_erase num | [Command]
Erases the contents of the flash memory, protection and security lock.

The num parameter is a value shown by flash banks.

Chapter 12: Flash Commands | 104
psoc5lp | [Flash Driver]
All members of the PSoC 5LP microcontroller family from Cypress include internal program flash and use ARM Cortex-M3 cores. The driver probes for a number of these chips and autoconfigures itself, apart from the base address.

flash bank $_FLASHNAME psoc5lp 0x00000000 0 0 0 $_TARGETNAME Note: PSoC 5LP chips can be configured to have ECC enabled or disabled. Attention: If flash operations are performed in ECC-disabled mode, they will also affect the ECC flash region. Erasing a 16k flash sector in the 0x00000000 area will then also erase the corresponding 2k data bytes in the 0x48000000 area. Writing to the ECC data bytes in ECC-disabled mode is not implemented.
Commands defined in the psoc5lp driver:
psoc5lp mass_erase | [Command]
Erases all flash data and ECC/configuration bytes, all flash protection rows, and all row latches in all flash arrays on the device.
psoc5lp_eeprom | [Flash Driver]
All members of the PSoC 5LP microcontroller family from Cypress include internal EEPROM and use ARM Cortex-M3 cores. The driver probes for a number of these chips and autoconfigures itself, apart from the base address.

flash bank $_CHIPNAME.eeprom psoc5lp_eeprom 0x40008000 0 0 0 \ $_TARGETNAME

psoc5lp_nvl | [Flash Driver]
All members of the PSoC 5LP microcontroller family from Cypress include internal Nonvolatile Latches and use ARM Cortex-M3 cores. The driver probes for a number of these chips and autoconfigures itself.

flash bank $_CHIPNAME.nvl psoc5lp_nvl 0 0 0 0 $_TARGETNAME
PSoC 5LP chips have multiple NV Latches:
- Device Configuration NV Latch - 4 bytes
- Write Once (WO) NV Latch - 4 bytes

Note: This driver only implements the Device Configuration NVL.
The psoc5lp driver reads the ECC mode from Device Configuration NVL. Attention: Switching ECC mode via write to Device Configuration NVL will require a reset after successful write.
psoc6 | [Flash Driver]
Supports PSoC6 (CY8C6xxx) family of Cypress microcontrollers. | PSoC6 is
a dual-core device with CM0+ and CM4 cores. | Both cores share the same
Flash/RAM/MMIO address space.
Flash in PSoC6 is split into three regions:
- Main Flash - this is the main storage for user application. Total size varies among devices, sector size: 256 kBytes, row size: 512 bytes. Supports erase operation on individual rows.

Chapter 12: Flash Commands | 105
- Work Flash - intended to be used as storage for user data (e.g. EEPROM emulation). Total size: 32 KBytes, sector size: 32 KBytes, row size: 512 bytes.
- Supervisory Flash - special region which contains device-specific service data. This region does not support erase operation. Only few rows can be programmed by the user, most of the rows are read only. Programming operation will erase row automatically.

All three flash regions are supported by the driver. Flash geometry is detected automatically by parsing data in SPCIF GEOMETRY register.
PSoC6 is equipped with NOR Flash so erased Flash reads as 0x00.
flash bank main_flash_cm0 psoc6 0x10000000 0 0 0 \
${TARGET}.cm0
flash bank work_flash_cm0 psoc6 0x14000000 0 0 0 \ ${TARGET}.cm0
flash bank super_flash_user_cm0 psoc6 0x16000800 0 0 0 \ ${TARGET}.cm0
flash bank super_flash_nar_cm0 psoc6 0x16001A00 0 0 0 \ ${TARGET}.cm0
flash bank super_flash_key_cm0 psoc6 0x16005A00 0 0 0 \ ${TARGET}.cm0
flash bank super_flash_toc2_cm0 psoc6 0x16007C00 0 0 0 \ ${TARGET}.cm0

flash bank main_flash_cm4 psoc6 0x10000000 0 0 0 \ ${TARGET}.cm4
flash bank work_flash_cm4 psoc6 0x14000000 0 0 0 \ ${TARGET}.cm4
flash bank super_flash_user_cm4 psoc6 0x16000800 0 0 0 \ ${TARGET}.cm4
flash bank super_flash_nar_cm4 psoc6 0x16001A00 0 0 0 \ ${TARGET}.cm4
flash bank super_flash_key_cm4 psoc6 0x16005A00 0 0 0 \ ${TARGET}.cm4
flash bank super_flash_toc2_cm4 psoc6 0x16007C00 0 0 0 \ ${TARGET}.cm4
psoc6-specific commands
psoc6 reset_halt | [Command]
Command can be used to simulate broken Vector Catch from gdbinit or tcl scripts. When invoked for CM0+ target, it will set break point at application entry point and issue SYSRESETREQ. This will reset both cores and all peripherals. CM0+ will reset CM4 during boot anyway so this is safe. On CM4 target, VECTRESET is used instead of SYSRESETREQ to avoid unwanted reset of CM0+;
psoc6 mass_erase num | [Command]
Erases the contents given flash bank. The num parameter is a value shown by flash banks. Note: only Main and Work flash regions support Erase operation.

Chapter 12: Flash Commands | 106
rp2040 | [Flash Driver]
Supports RP2040 "Raspberry Pi Pico" microcontroller. RP2040 is a dual-core device with two CM0+ cores. Both cores share the same Flash/RAM/MMIO address space. Non-volatile storage is achieved with an external QSPI flash; a Boot ROM provides
helper functions.

flash bank $_FLASHNAME rp2040_flash $_FLASHBASE $_FLASHSIZE 1 32 $_TARGETNAME

sim3x | [Flash Driver]
All members of the SiM3 microcontroller family from Silicon Laboratories include
internal flash and use ARM Cortex-M3 cores. It supports both JTAG and SWD interface. The sim3x driver tries to probe the device to auto detect the MCU. If this fails, it will use the size parameter as the size of flash bank.

flash bank $_FLASHNAME sim3x 0 $_CPUROMSIZE 0 0 $_TARGETNAME

There are 2 commands defined in the sim3x driver:

sim3x mass_erase | [Command]
Erases the complete flash. This is used to unlock the flash. And this command is only possible when using the SWD interface.
sim3x lock | [Command]
Lock the flash. To unlock use the sim3x mass_erase command.
stellaris | [Flash Driver]
All members of the Stellaris LM3Sxxx, LM4x and Tiva C microcontroller families from Texas Instruments include internal flash. The driver automatically recognizes a number of these chips using the chip identification register, and autoconfigures itself.

flash bank $_FLASHNAME stellaris 0 0 0 0 $_TARGETNAME

stellaris recover | [Command]
Performs the Recovering a "Locked" Device procedure to restore the flash and its associated nonvolatile registers to their factory default values (erased). This is the only way to remove flash protection or re-enable debugging if that capability has been disabled.

Note that the final "power cycle the chip" step in this procedure must be performed by hand, since OpenOCD can’t do it.

Warning: if more than one Stellaris chip is connected, the procedure
is applied to all of them.
stm32f1x | [Flash Driver]
All members of the STM32F0, STM32F1 and STM32F3 microcontroller families from STMicroelectronics and all members of the GD32F1x0, GD32F3x0 and GD32E23x microcontroller families from GigaDevice include internal flash and use ARM Cortex-M0/M3/M4/M23 cores. The driver automatically recognizes a number of these chips using the chip identification register, and autoconfigures itself.

flash bank $_FLASHNAME stm32f1x 0 0 0 0 $_TARGETNAME

Chapter 12: Flash Commands | 107

Note that some devices have been found that have a flash size register that contains an invalid value, to workaround this issue you can override the probed value used by the flash driver.
flash bank $_FLASHNAME stm32f1x 0 0x20000 0 0 $_TARGETNAME
If you have a target with dual flash banks then define the second bank as per the following example.
flash bank $_FLASHNAME stm32f1x 0x08080000 0 0 0 $_TARGETNAME Some stm32f1x-specific commands are defined:
stm32f1x lock num | [Command]
Locks the entire stm32 device against reading. The num parameter is a value shown by flash banks.
stm32f1x unlock num | [Command]
Unlocks the entire stm32 device for reading. This command will cause a mass erase of the entire stm32 device if previously locked. The num parameter is a value shown by flash banks.
stm32f1x mass_erase num | [Command]
Mass erases the entire stm32 device. The num parameter is a value shown by flash banks.
stm32f1x options_read num | [Command]
Reads and displays active stm32 option bytes loaded during POR or upon executing the stm32f1x options_load command. The num parameter is a value shown by flash banks.
stm32f1x options_write num (SWWDG|HWWDG) | [Command]
(RSTSTNDBY|NORSTSTNDBY) (RSTSTOP|NORSTSTOP) (USEROPT
user data)
Writes the stm32 option byte with the specified values. The num parameter is a value shown by flash banks. The user data parameter is content of higher 16 bits of the option byte register (Data0 and Data1 as one 16bit number).
stm32f1x options_load num | [Command]
Generates a special kind of reset to re-load the stm32 option bytes written by the stm32f1x options_write or flash protect commands without having to power cycle the target. Not applicable to stm32f1x devices. The num parameter is a value shown by flash banks.
stm32f2x | [Flash Driver]
All members of the STM32F2, STM32F4 and STM32F7 microcontroller families from STMicroelectronics include internal flash and use ARM Cortex-M3/M4/M7 cores. The driver automatically recognizes a number of these chips using the chip identification register, and autoconfigures itself.
flash bank $_FLASHNAME stm32f2x 0 0 0 0 $_TARGETNAME
If you use OTP (One-Time Programmable) memory define it as a second bank as per the following example.
flash bank $_FLASHNAME stm32f2x 0x1FFF7800 0 0 0 $_TARGETNAME

Chapter 12: Flash Commands | 108
stm32f2x otp num (enable|disable|show) | [Command]
Enables or disables OTP write commands for bank num. The num parameter is a value shown by flash banks.

Note that some devices have been found that have a flash size register that contains an invalid value, to workaround this issue you can override the probed value used by the flash driver.
flash bank $_FLASHNAME stm32f2x 0 0x20000 0 0 $_TARGETNAME
Some stm32f2x-specific commands are defined:
stm32f2x lock num | [Command]
Locks the entire stm32 device. The num parameter is a value shown by flash banks.
stm32f2x unlock num | [Command]
Unlocks the entire stm32 device. The num parameter is a value shown by flash banks.
stm32f2x mass_erase num | [Command]
Mass erases the entire stm32f2x device. The num parameter is a value shown by flash banks.
stm32f2x options_read num | [Command]
Reads and displays user options and (where implemented) boot addr0, boot addr1, optcr2. The num parameter is a value shown by flash banks.
stm32f2x options_write num user options boot addr0 | [Command]
boot addr1
Writes user options and (where implemented) boot addr0 and boot addr1 in raw format. Warning: The meaning of the various bits depends on the device, always check datasheet! The num parameter is a value shown by flash banks, user options a 12 bit value, consisting of bits 31-28 and 7-0 of FLASH OPTCR, boot addr0 and boot addr1 two halfwords (of FLASH OPTCR1).
stm32f2x optcr2_write num optcr2 | [Command]
Writes FLASH OPTCR2 options. Warning: Clearing PCROPi bits requires a full mass erase! The num parameter is a value shown by flash banks, optcr2 a 32-bit word.
stm32h7x | [Flash Driver]
All members of the STM32H7 microcontroller families from STMicroelectronics include internal flash and use ARM Cortex-M7 core. The driver automatically recognizes a number of these chips using the chip identification register, and autoconfigures itself.
flash bank $_FLASHNAME stm32h7x 0 0 0 0 $_TARGETNAME
Note that some devices have been found that have a flash size register that contains an invalid value, to workaround this issue you can override the probed value used by the flash driver.
flash bank $_FLASHNAME stm32h7x 0 0x20000 0 0 $_TARGETNAME
Some stm32h7x-specific commands are defined:

Chapter 12: Flash Commands | 109
stm32h7x lock num | [Command]
Locks the entire stm32 device. The num parameter is a value shown by flash banks.
stm32h7x unlock num | [Command]
Unlocks the entire stm32 device. The num parameter is a value shown by flash banks.
stm32h7x mass_erase num | [Command]
Mass erases the entire stm32h7x device. The num parameter is a value shown by flash banks.
stm32h7x option_read num reg offset | [Command]
Reads an option byte register from the stm32h7x device. The num parameter is a value shown by flash banks, reg offset is the register offset of the option byte to read from the used bank registers’ base. For example: in STM32H74x/H75x the bank 1 registers’ base is 0x52002000 and 0x52002100 for bank 2.
Example usage:

# read OPTSR_CUR

stm32h7x option_read 0 0x1c # read WPSN_CUR1R
stm32h7x option_read 0 0x38 # read WPSN_CUR2R
stm32h7x option_read 1 0x38
stm32h7x option_write num reg offset value [reg mask] | [Command]
Writes an option byte register of the stm32h7x device. The num parameter is a value shown by flash banks, reg offset is the register offset of the option byte to write from the used bank register base, and reg mask is the mask to apply when writing the register (only bits with a ’1’ will be touched).
Example usage:

# swap bank 1 and bank 2 in dual bank devices # by setting SWAP_BANK_OPT bit in OPTSR_PRG stm32h7x option_write 0 0x20 0x8000000 0x8000000

stm32lx | [Flash Driver]
All members of the STM32L0 and STM32L1 microcontroller families from STMicroelectronics include internal flash and use ARM Cortex-M3 and Cortex-M0+ cores. The driver automatically recognizes a number of these chips using the chip identification register, and autoconfigures itself.

flash bank $_FLASHNAME stm32lx 0 0 0 0 $_TARGETNAME
Note that some devices have been found that have a flash size register that contains an invalid value, to workaround this issue you can override the probed value used by the flash driver. If you use 0 as the bank base address, it tells the driver to autodetect the bank location assuming you’re configuring the second bank.

flash bank $_FLASHNAME stm32lx 0x08000000 0x20000 0 0 $_TARGETNAME Some stm32lx-specific commands are defined:

Chapter 12: Flash Commands | 110
stm32lx lock num | [Command]
Locks the entire stm32 device. The num parameter is a value shown by flash banks.
stm32lx unlock num | [Command]
Unlocks the entire stm32 device. The num parameter is a value shown by flash banks.
stm32lx mass_erase num | [Command]
Mass erases the entire stm32lx device (all flash banks and EEPROM data). This is the only way to unlock a protected flash (unless RDP Level is 2 which can’t be unlocked at all). The num parameter is a value shown by flash banks.
stm32l4x | [Flash Driver]
All members of the STM32 G0, G4, L4, L4+, L5, U5, WB and WL microcontroller families from STMicroelectronics include internal flash and use ARM Cortex-M0+, M4 and M33 cores. The driver automatically recognizes a number of these chips using the chip identification register, and autoconfigures itself.

flash bank $_FLASHNAME stm32l4x 0 0 0 0 $_TARGETNAME
If you use OTP (One-Time Programmable) memory define it as a second bank as per the following example.

flash bank $_FLASHNAME stm32l4x 0x1FFF7000 0 0 0 $_TARGETNAME

stm32l4x otp num (enable|disable|show) | [Command]
Enables or disables OTP write commands for bank num. The num parameter is a value shown by flash banks.

Note that some devices have been found that have a flash size register that contains an invalid value, to workaround this issue you can override the probed value used by the flash driver. However, specifying a wrong value might lead to a completely wrong flash layout, so this feature must be used carefully.

flash bank $_FLASHNAME stm32l4x 0x08000000 0x40000 0 0 $_TARGETNAME Some stm32l4x-specific commands are defined:

stm32l4x lock num | [Command]
Locks the entire stm32 device. The num parameter is a value shown by flash banks.

Note: To apply the protection change immediately, use stm32l4x option_load.

stm32l4x unlock num | [Command]
Unlocks the entire stm32 device. The num parameter is a value shown by flash banks.

Note: To apply the protection change immediately, use stm32l4x option_load.

stm32l4x mass_erase num | [Command]
Mass erases the entire stm32l4x device. The num parameter is a value shown by flash banks.

Chapter 12: Flash Commands | 111
stm32l4x option_read num reg offset | [Command]
Reads an option byte register from the stm32l4x device. The num parameter is a value shown by flash banks, reg offset is the register offset of the Option byte to read.
For example to read the FLASH OPTR register:

stm32l4x option_read 0 0x20
# Option Register (for STM32L4x): <0x40022020> = 0xffeff8aa # Option Register (for STM32WBx): <0x58004020> = ...

# The correct flash base address will be used automatically The above example will read out the FLASH OPTR register which contains the RDP option byte, Watchdog configuration, BOR level etc.

stm32l4x option_write num reg offset reg mask | [Command]
Write an option byte register of the stm32l4x device. The num parameter is a value shown by flash banks, reg offset is the register offset of the Option byte to write, and reg mask is the mask to apply when writing the register (only bits with a ’1’ will be touched).

Note: To apply the option bytes change immediately, use stm32l4x option_ load.
For example to write the WRP1AR option bytes:

stm32l4x option_write 0 0x28 0x00FF0000 0x00FF00FF
The above example will write the WRP1AR option register configuring
the Write protection Area A for bank 1. | The above example set
WRP1AR END=255, WRP1AR START=0. | This will effectively write
protect all sectors in flash bank 1.
stm32l4x wrp_info num [device bank] | [Command]
List the protected areas using WRP. The num parameter is a value shown by flash banks. device bank parameter is optional, possible values ’bank1’ or ’bank2’, if not specified, the command will display the whole flash protected areas.
Note: device bank is different from banks created using flash bank. Devices supported in this flash driver, can have main flash memory organized in single or dual-banks mode. Thus the usage of device bank is meaningful only in dual-bank mode, to get write protected areas in a specific device bank
stm32l4x option_load num | [Command]
Forces a re-load of the option byte registers. Will cause a system reset of the device. The num parameter is a value shown by flash banks.
stm32l4x trustzone num [enable | disable] | [Command]
Enables or disables Global TrustZone Security, using the TZEN option bit. If neither enabled nor disable are specified, the command will display the Trust-Zone status. Note: This command works only with devices with TrustZone, eg. STM32L5. Note: This command will perform an OBL Launch after modifying the TZEN.

Chapter 12: Flash Commands | 112
str7x | [Flash Driver]
All members of the STR7 microcontroller family from STMicroelectronics include internal flash and use ARM7TDMI cores. The str7x driver defines one mandatory parameter, variant, which is either STR71x, STR73x or STR75x.

flash bank $_FLASHNAME str7x \
0x40000000 0x00040000 0 0 $_TARGETNAME STR71x
str7x disable_jtag bank | [Command]
Activate the Debug/Readout protection mechanism for the specified flash bank.
str9x | [Flash Driver]
Most members of the STR9 microcontroller family from STMicroelectronics include internal flash and use ARM966E cores. The str9 needs the flash controller to be configured using the str9x flash_config command prior to Flash programming.

flash bank $_FLASHNAME str9x 0x40000000 0x00040000 0 0 $_TARGETNAME str9x flash_config 0 4 2 0 0x80000

str9x flash_config num bbsr nbbsr bbadr nbbadr | [Command]
Configures the str9 flash controller. The num parameter is a value shown by flash banks.
- bbsr - Boot Bank Size register
- nbbsr - Non Boot Bank Size register
- bbadr - Boot Bank Start Address register
- nbbadr - Boot Bank Start Address register
str9xpec | [Flash Driver]
Only use this driver for locking/unlocking the device or configuring the option bytes. Use the standard str9 driver for programming. Before using the flash commands the turbo mode must be enabled using the str9xpec enable_turbo command.
Here is some background info to help you better understand how this driver works. OpenOCD has two flash drivers for the str9:
1. Standard driver str9x programmed via the str9 core. Normally used for flash programming as it is faster than the str9xpec driver.
2. Direct programming str9xpec using the flash controller. This is an ISC compliant (IEEE 1532) tap connected in series with the str9 core. The str9 core does not need to be running to program using this flash driver. Typical use for this driver is locking/unlocking the target and programming the option bytes.

Before we run any commands using the str9xpec driver we must first disable the str9 core. This example assumes the str9xpec driver has been configured for flash bank 0.

# assert srst, we do not want core running

# while accessing str9xpec flash driver

adapter assert srst
# turn off target polling

poll off

Chapter 12: Flash Commands | 113

# disable str9 core

str9xpec enable_turbo 0
# read option bytes

str9xpec options_read 0
# re-enable str9 core

str9xpec disable_turbo 0
poll on
reset halt
The above example will read the str9 option bytes. When performing a unlock remember that you will not be able to halt the str9 - it has been locked. Halting the core is not required for the str9xpec driver as mentioned above, just issue the commands above manually or from a telnet prompt.

Several str9xpec-specific commands are defined:

str9xpec disable_turbo num | [Command]
Restore the str9 into JTAG chain.
str9xpec enable_turbo num | [Command]
Enable turbo mode, will simply remove the str9 from the chain and talk directly to the embedded flash controller.
str9xpec lock num | [Command]
Lock str9 device. The str9 will only respond to an unlock command that will erase the device.
str9xpec part_id num | [Command]
Prints the part identifier for bank num.
str9xpec options_cmap num (bank0|bank1) | [Command]
Configure str9 boot bank.
str9xpec options_lvdsel num (vdd|vdd_vddq) | [Command]
Configure str9 lvd source.
str9xpec options_lvdthd num (2.4v|2.7v) | [Command]
Configure str9 lvd threshold.
str9xpec options_lvdwarn bank (vdd|vdd_vddq) | [Command]
Configure str9 lvd reset warning source.
str9xpec options_read num | [Command]
Read str9 option bytes.
str9xpec options_write num | [Command]
Write str9 option bytes.
str9xpec unlock num | [Command]
unlock str9 device.

Chapter 12: Flash Commands | 114
swm050 | [Flash Driver]
All members of the swm050 microcontroller family from Foshan Synwit Tech.

flash bank $_FLASHNAME swm050 0x0 0x2000 0 0 $_TARGETNAME

One swm050-specific command is defined:

swm050 mass_erase bank id | [Command]
Erases the entire flash bank.
tms470 | [Flash Driver]
Most members of the TMS470 microcontroller family from Texas Instruments include internal flash and use ARM7TDMI cores. This driver doesn’t require the chip and bus width to be specified.

Some tms470-specific commands are defined:

tms470 flash_keyset key0 key1 key2 key3 | [Command]
Saves programming keys in a register, to enable flash erase and write commands.
tms470 osc_megahertz clock mhz | [Command]
Reports the clock speed, which is used to calculate timings.
tms470 plldis (0|1) | [Command]
Disables (1) or enables (0) use of the PLL to speed up the flash clock.
w600 | [Flash Driver]
W60x series Wi-Fi SoC from WinnerMicro are designed with ARM Cortex-M3 and have 1M Byte QFLASH inside. The w600 driver uses the target parameter to select the correct bank config.

flash bank $_FLASHNAME w600 0x08000000 0 0 0 $_TARGETNAMEs

xmc1xxx | [Flash Driver]
All members of the XMC1xxx microcontroller family from Infineon. This driver does not require the chip and bus width to be specified.
xmc4xxx | [Flash Driver]
All members of the XMC4xxx microcontroller family from Infineon. This driver does not require the chip and bus width to be specified.

Some xmc4xxx-specific commands are defined:

xmc4xxx flash_password bank id passwd1 passwd2 | [Command]
Saves flash protection passwords which are used to lock the user flash
xmc4xxx flash_unprotect bank id user level[0-1] | [Command]
Removes Flash write protection from the selected user bank

Chapter 12: Flash Commands | 115

## 12.6 NAND Flash Commands

Compared to NOR or SPI flash, NAND devices are inexpensive and high density. Today’s NAND chips, and multi-chip modules, commonly hold multiple GigaBytes of data.

NAND chips consist of a number of “erase blocks” of a given size (such as 128 KBytes), each of which is divided into a number of pages (of perhaps 512 or 2048 bytes each). Each page of a NAND flash has an “out of band” (OOB) area to hold Error Correcting Code (ECC) and other metadata, usually 16 bytes of OOB for every 512 bytes of page data.

One key characteristic of NAND flash is that its error rate is higher than that of NOR flash. In normal operation, that ECC is used to correct and detect errors. However, NAND blocks can also wear out and become unusable; those blocks are then marked "bad". NAND chips are even shipped from the manufacturer with a few bad blocks. The highest density chips use a technology (MLC) that wears out more quickly, so ECC support is increasingly important as a way to detect blocks that have begun to fail, and help to preserve data integrity with techniques such as wear leveling.

Software is used to manage the ECC. Some controllers don’t support ECC directly; in those cases, software ECC is used. Other controllers speed up the ECC calculations with hardware. Single-bit error correction hardware is routine. Controllers geared for newer MLC chips may correct 4 or more errors for every 512 bytes of data.

You will need to make sure that any data you write using OpenOCD includes the appropriate kind of ECC. For example, that may mean passing the oob_softecc flag when writing NAND data, or ensuring that the correct hardware ECC mode is used.

The basic steps for using NAND devices include:

1. Declare via the command nand device
Do this in a board-specific configuration file, passing parameters as needed by the controller.
2. Configure each device using nand probe.
Do this only after the associated target is set up, such as in its reset-init script or in procures defined to access that device.
3. Operate on the flash via nand subcommand
Often commands to manipulate the flash are typed by a human, or run via a script in some automated way. Common task include writing a boot loader, operating system, or other data needed to initialize or de-brick a board.

NOTE: At the time this text was written, the largest NAND flash fully supported by OpenOCD is 2 GiBytes (16 GiBits). This is because the variables used to hold offsets and lengths are only 32 bits wide. (Larger chips may work in some cases, unless an offset or length is larger than 0xffffffff, the largest 32-bit unsigned integer.) Some larger devices will work, since they are actually multi-chip modules with two smaller chips and individual chipselect lines.

### 12.6.1 NAND Configuration Commands

NAND chips must be declared in configuration scripts, plus some additional configuration that’s done after OpenOCD has initialized.

Chapter 12: Flash Commands | 116
nand device name driver target [configparams...] | [Config Command]
Declares a NAND device, which can be read and written to after it has been configured through nand probe. In OpenOCD, devices are single chips; this is unlike some operating systems, which may manage multiple chips as if they were a single (larger) device. In some cases, configuring a device will activate extra commands; see the controller-specific documentation.

NOTE: This command is not available after OpenOCD initialization has completed. Use it in board specific configuration files, not interactively.

- name ... may be used to reference the NAND bank in most other NAND commands. A number is also available.
- driver ... identifies the NAND controller driver associated with the NAND device being declared. See [NAND Driver List], page 119.
- target ... names the target used when issuing commands to the NAND controller.
- configparams ... controllers may support, or require, additional parameters. See the controller-specific documentation for more information.
nand list | [Command]
Prints a summary of each device declared using nand device, numbered from zero. Note that un-probed devices show no details.

> nand list
#0: NAND 1GiB 3,3V 8-bit (Micron) pagesize: 2048, buswidth: 8, blocksize: 131072, blocks: 8192 #1: NAND 1GiB 3,3V 8-bit (Micron) pagesize: 2048, buswidth: 8, blocksize: 131072, blocks: 8192 >

nand probe num | [Command]
Probes the specified device to determine key characteristics like its page and block sizes, and how many blocks it has. The num parameter is the value shown by nand list. You must (successfully) probe a device before you can use it with most other NAND commands.

### 12.6.2 Erasing, Reading, Writing to NAND Flash

nand dump num filename offset length [oob option] | [Command]
Reads binary data from the NAND device and writes it to the file, starting at the specified offset. The num parameter is the value shown by nand list.

Use a complete path name for filename, so you don’t depend on the directory used to start the OpenOCD server.

The offset and length must be exact multiples of the device’s page size. They describe a data region; the OOB data associated with each such page may also be accessed.

NOTE: At the time this text was written, no error correction was done on the data that’s read, unless raw access was disabled and the underlying NAND controller driver had a read_page method which handled that error correction.

Chapter 12: Flash Commands | 117

By default, only page data is saved to the specified file. Use an oob option parameter to save OOB data:
- no oob * parameter
Output file holds only page data; OOB is discarded.
- oob_raw
Output file interleaves page data and OOB data; the file will be longer than "length" by the size of the spare areas associated with each data page. Note that this kind of "raw" access is different from what’s implied by nand raw_access, which just controls whether a hardware-aware access method is used.
- oob_only
Output file has only raw OOB data, and will be smaller than "length" since it will contain only the spare areas associated with each data page.
nand erase num [offset length] | [Command]
Erases blocks on the specified NAND device, starting at the specified offset and continuing for length bytes. Both of those values must be exact multiples of the device’s block size, and the region they specify must fit entirely in the chip. If those parameters are not specified, the whole NAND chip will be erased. The num parameter is the value shown by nand list.
NOTE: This command will try to erase bad blocks, when told to do so, which will probably invalidate the manufacturer’s bad block marker. For the remainder of the current server session, nand info will still report that the block “is” bad.
nand write num filename offset [option...] | [Command]
Writes binary data from the file into the specified NAND device, starting at the specified offset. Those pages should already have been erased; you can’t change zero bits to one bits. The num parameter is the value shown by nand list.
Use a complete path name for filename, so you don’t depend on the directory used to start the OpenOCD server.
The offset must be an exact multiple of the device’s page size. All data in the file will be written, assuming it doesn’t run past the end of the device. Only full pages are written, and any extra space in the last page will be filled with 0xff bytes. (That includes OOB data, if that’s being written.)
NOTE: At the time this text was written, bad blocks are ignored. That is, this routine will not skip bad blocks, but will instead try to write them. This can cause problems. Provide at most one option parameter. With some NAND drivers, the meanings of these parameters may change if nand raw_access was used to disable hardware ECC.
- no oob * parameter
File has only page data, which is written. If raw access is in use, the OOB area will not be written. Otherwise, if the underlying NAND controller driver has a write_page routine, that routine may write the OOB with hardware-computed ECC data.
- oob_only
File has only raw OOB data, which is written to the OOB area. Each page’s data area stays untouched. This can be a dangerous option, since it can invalidate the ECC data. You may need to force raw access to use this mode.

Chapter 12: Flash Commands | 118
- oob_raw
File interleaves data and OOB data, both of which are written If raw access is enabled, the data is written first, then the un-altered OOB. Otherwise, if the underlying NAND controller driver has a write_page routine, that routine may modify the OOB before it’s written, to include hardware-computed ECC data.
- oob_softecc
File has only page data, which is written. The OOB area is filled with 0xff, except for a standard 1-bit software ECC code stored in conventional locations. You might need to force raw access to use this mode, to prevent the underlying driver from applying hardware ECC.
- oob_softecc_kw
File has only page data, which is written. The OOB area is filled with 0xff, except for a 4-bit software ECC specific to the boot ROM in Marvell Kirkwood SoCs. You might need to force raw access to use this mode, to prevent the underlying driver from applying hardware ECC.
nand verify num filename offset [option...] | [Command]
Verify the binary data in the file has been programmed to the specified NAND device, starting at the specified offset. The num parameter is the value shown by nand list. Use a complete path name for filename, so you don’t depend on the directory used to start the OpenOCD server.
The offset must be an exact multiple of the device’s page size. All data in the file will be read and compared to the contents of the flash, assuming it doesn’t run past the end of the device. As with nand write, only full pages are verified, so any extra space in the last page will be filled with 0xff bytes.
The same options accepted by nand write, and the file will be processed similarly to produce the buffers that can be compared against the contents produced from nand dump.
NOTE: This will not work when the underlying NAND controller driver’s write_ page routine must update the OOB with a hardware-computed ECC before the data is written. This limitation may be removed in a future release.

### 12.6.3 Other NAND commands

nand check_bad_blocks num [offset length] | [Command]
Checks for manufacturer bad block markers on the specified NAND device. If no parameters are provided, checks the whole device; otherwise, starts at the specified offset and continues for length bytes. Both of those values must be exact multiples of the device’s block size, and the region they specify must fit entirely in the chip. The num parameter is the value shown by nand list.
NOTE: Before using this command you should force raw access with nand raw_access enable to ensure that the underlying driver will not try to apply hardware ECC.
nand info num | [Command]
The num parameter is the value shown by nand list. This prints the one-line summary from "nand list", plus for devices which have been probed this also prints any known status for each block.

Chapter 12: Flash Commands | 119
nand raw_access num (enable|disable) | [Command]
Sets or clears an flag affecting how page I/O is done. The num parameter is the value shown by nand list.
This flag is cleared (disabled) by default, but changing that value won’t affect all NAND devices. The key factor is whether the underlying driver provides read_page or write_page methods. If it doesn’t provide those methods, the setting of this flag is irrelevant; all access is effectively “raw”.
When those methods exist, they are normally used when reading data (nand dump or reading bad block markers) or writing it (nand write). However, enabling raw access (setting the flag) prevents use of those methods, bypassing hardware ECC logic. This can be a dangerous option, since writing blocks with the wrong ECC data can cause them to be marked as bad.

### 12.6.4 NAND Driver List

As noted above, the nand device command allows driver-specific options and behaviors. Some controllers also activate controller-specific commands.

at91sam9 | [NAND Driver]
This driver handles the NAND controllers found on AT91SAM9 family chips from Atmel. It takes two extra parameters: address of the NAND chip; address of the ECC controller.

nand device $NANDFLASH at91sam9 $CHIPNAME 0x40000000 0xfffffe800 AT91SAM9 chips support single-bit ECC hardware. The write_page and read_page methods are used to utilize the ECC hardware unless they are disabled by using the nand raw_access command. There are four additional commands that are needed to fully configure the AT91SAM9 NAND controller. Two are optional; most boards use the same wiring for ALE/CLE:

at91sam9 cle num addr line | [Config Command]
Configure the address line used for latching commands. The num parameter is the value shown by nand list.
at91sam9 ale num addr line | [Config Command]
Configure the address line used for latching addresses. The num parameter is the value shown by nand list.

For the next two commands, it is assumed that the pins have already been properly configured for input or output.

at91sam9 rdy_busy num pio base addr pin | [Config Command]
Configure the RDY/nBUSY input from the NAND device. The num parameter is the value shown by nand list. pio base addr is the base address of the PIO controller and pin is the pin number.
at91sam9 ce num pio base addr pin | [Config Command]
Configure the chip enable input to the NAND device. The num parameter is the value shown by nand list. pio base addr is the base address of the PIO controller and pin is the pin number.

Chapter 12: Flash Commands | 120
davinci | [NAND Driver]
This driver handles the NAND controllers found on DaVinci family chips from Texas Instruments. It takes three extra parameters: address of the NAND chip; hardware ECC mode to use (hwecc1, hwecc4, hwecc4_infix); address of the AEMIF controller on this processor.

nand device davinci dm355.arm 0x02000000 hwecc4 0x01e10000
All DaVinci processors support the single-bit ECC hardware, and newer ones also support the four-bit ECC hardware. The write_page and read_page methods are used to implement those ECC modes, unless they are disabled using the nand raw_ access command.
lpc3180 | [NAND Driver]
These controllers require an extra nand device parameter: the clock rate used by the controller.
lpc3180 select num [mlc|slc] | [Command]
Configures use of the MLC or SLC controller mode. MLC implies use of hardware ECC. The num parameter is the value shown by nand list.

At this writing, this driver includes write_page and read_page methods. Using nand raw_access to disable those methods will prevent use of hardware ECC in the MLC controller mode, but won’t change SLC behavior.

mx3 | [NAND Driver]
This driver handles the NAND controller in i.MX31. The mxc driver should work for this chip as well.
mxc | [NAND Driver]
This driver handles the NAND controller found in Freescale i.MX chips. It has support for v1 (i.MX27 and i.MX31) and v2 (i.MX35). The driver takes 3 extra arguments, chip (mx27, mx31, mx35), ecc (noecc, hwecc) and optionally if bad block information should be swapped between main area and spare area (biswap), defaults to off.

nand device mx35.nand mxc imx35.cpu mx35 hwecc biswap

mxc biswap bank num [enable|disable] | [Command]
Turns on/off bad block information swapping from main area, without parameter query status.
orion | [NAND Driver]
These controllers require an extra nand device parameter: the address of the controller.

nand device orion 0xd8000000
These controllers don’t define any specialized commands. At this writing, their drivers don’t include write_page or read_page methods, so nand raw_access won’t change any behavior.
s3c2410 | [NAND Driver]
s3c2412 | [NAND Driver]

Chapter 12: Flash Commands | 121
s3c2440 | [NAND Driver]
s3c2443 | [NAND Driver]
s3c6400 | [NAND Driver]
These S3C family controllers don’t have any special nand device options, and don’t define any specialized commands. At this writing, their drivers don’t include write_ page or read_page methods, so nand raw_access won’t change any behavior.

122

## 13 Flash Programming

OpenOCD implements numerous ways to program the target flash, whether internal or external. Programming can be achieved by either using [Programming using GDB], page 167, or using the commands given in [Flash Programming Commands], page 80.

To simplify using the flash commands directly a jimtcl script is available that handles the programming and verify stage. OpenOCD will program/verify/reset the target and optionally shutdown.
The script is executed as follows and by default the following actions will be performed.
1. ’init’ is executed.
2. ’reset init’ is called to reset and halt the target, any ’reset init’ scripts are executed.
3. flash write_image is called to erase and write any flash using the filename given.
4. If the preverify parameter is given, the target is "verified" first and only flashed if this fails.
5. verify_image is called if verify parameter is given.
6. reset run is called if reset parameter is given.
7. OpenOCD is shutdown if exit parameter is given.

An example of usage is given below. See [program], page 83.

# program and verify using elf/hex/s19. verify and reset # are optional parameters

openocd -f board/stm32f3discovery.cfg \
-c "program filename.elf verify reset exit"

# binary files need the flash address passing openocd -f board/stm32f3discovery.cfg \

-c "program filename.bin exit 0x08000000"

123

## 14 PLD/FPGA Commands

Programmable Logic Devices (PLDs) and the more flexible Field Programmable Gate Arrays (FPGAs) are both types of programmable hardware. OpenOCD can support programming them. Although PLDs are generally restrictive (cells are less functional, and there are no special purpose cells for memory or computational tasks), they share the same OpenOCD infrastructure. Accordingly, both are called PLDs here.

## 14.1 PLD/FPGA Configuration and Commands

As it does for JTAG TAPs, debug targets, and flash chips (both NOR and NAND), OpenOCD maintains a list of PLDs available for use in various commands. Also, each such PLD requires a driver.
They are referenced by the number shown by the pld devices command, and new PLDs are defined by pld device driver_name.
pld device driver name tap name [driver options] | [Config Command]
Defines a new PLD device, supported by driver driver name, using the TAP named tap name. The driver may make use of any driver options to configure its behavior.
pld devices | [Command]
Lists the PLDs and their numbers.
pld load num filename | [Command]
Loads the file filename into the PLD identified by num. The file format must be inferred by the driver.

## 14.2 PLD/FPGA Drivers, Options, and Commands

Drivers may support PLD-specific options to the pld device definition command, and may also define commands usable only with that particular type of PLD.

virtex2 [no jstart] | [FPGA Driver]
Virtex-II is a family of FPGAs sold by Xilinx. It supports the IEEE 1532 standard for In-System Configuration (ISC).
If no jstart is non-zero, the JSTART instruction is not used after loading the bitstream. While required for Series2, Series3, and Series6, it breaks bitstream loading on Series7.
virtex2 read_stat num | [Command]
Reads and displays the Virtex-II status register (STAT) for FPGA num.

124

## 15 General Commands

The commands documented in this chapter here are common commands that you, as a human, may want to type and see the output of. Configuration type commands are documented elsewhere.
Intent:
- Source Of Commands
OpenOCD commands can occur in a configuration script (discussed elsewhere) or typed manually by a human or supplied programmatically, or via one of several TCP/IP Ports.
- From the human
A human should interact with the telnet interface (default port: 4444) or via GDB (default port 3333).

To issue commands from within a GDB session, use the monitor command, e.g. use monitor poll to issue the poll command. All output is relayed through the GDB session.
- Machine Interface The Tcl interface’s intent is to be a machine interface. The default Tcl port is 5555.

## 15.1 Server Commands

exit | [Command]
Exits the current telnet session.
help [string] | [Command]
With no parameters, prints help text for all commands. Otherwise, prints each helptext containing string. Not every command provides helptext.
Configuration commands, and commands valid at any time, are explicitly noted in parenthesis. In most cases, no such restriction is listed; this indicates commands which are only available after the configuration stage has completed.
usage [string] | [Command]
With no parameters, prints usage text for all commands. Otherwise, prints all usage text of which command, help text, and usage text containing string. Not every command provides helptext.
sleep msec [busy] | [Command]
Wait for at least msec milliseconds before resuming. If busy is passed, busy-wait instead of sleeping. (This option is strongly discouraged.) Useful in connection with script files (script command and target_name configuration).
shutdown [error] | [Command]
Close the OpenOCD server, disconnecting all clients (GDB, telnet, other). If option error is used, OpenOCD will return a non-zero exit code to the parent process. Like any TCL commands, also shutdown can be redefined, e.g.:

# redefine shutdown

rename shutdown original_shutdown

Chapter 15: General Commands | 125

proc shutdown {} {
puts "This is my implementation of shutdown" # my own stuff before exit OpenOCD original_shutdown
}
If user types CTRL-C or kills OpenOCD, either the command shutdown or its replacement will be automatically executed before OpenOCD exits.
debug_level [n] | [Command]
Display debug level. If n (from 0..4) is provided, then set it to that level. This affects the kind of messages sent to the server log. Level 0 is error messages only; level 1 adds warnings; level 2 adds informational messages; level 3 adds debugging messages; and level 4 adds verbose low-level debug messages. The default is level 2, but that can be overridden on the command line along with the location of that log file (which is normally the server’s standard output). See Chapter 4 [Running], page 12.
echo [-n] message | [Command]
Logs a message at "user" priority. Option "-n" suppresses trailing newline.

echo "Downloading kernel -- please wait"

log_output [filename | "default"] | [Command]
Redirect logging to filename or set it back to default output; the default log output channel is stderr.
add_script_search_dir [directory] | [Command]
Add directory to the file/script search path.
bindto [name] | [Config Command]
Specify hostname or IPv4 address on which to listen for incoming TCP/IP connections. By default, OpenOCD will listen on the loopback interface only. If your network environment is safe, bindto 0.0.0.0 can be used to cover all available interfaces.

## 15.2 Target State handling

In this section “target” refers to a CPU configured as shown earlier (see Chapter 11 [CPU Configuration], page 69). These commands, like many, implicitly refer to a current target which is used to perform the various operations. The current target may be changed by using targets command with the name of the target which should become current.

reg [(number|name) [(value|’force’)]] | [Command]
Access a single register by number or by its name. The target must generally be halted before access to CPU core registers is allowed. Depending on the hardware, some other registers may be accessible while the target is running.
With no arguments: list all available registers for the current target, showing number, name, size, value, and cache status. For valid entries, a value is shown; valid entries which are also dirty (and will be written back later) are flagged as such.
With number/name: display that register’s value. Use force argument to read directly from the target, bypassing any internal cache.

Chapter 15: General Commands | 126

With both number/name and value: set register’s value. Writes may be held in a writeback cache internal to OpenOCD, so that setting the value marks the register as dirty instead of immediately flushing that value. Resuming CPU execution (including by single stepping) or otherwise activating the relevant module will flush such values.

Cores may have surprisingly many registers in their Debug and trace infrastructure:

> reg
===== ARM registers
(0) r0 (/32): 0x0000D3C2 (dirty)
(1) r1 (/32): 0xFD61F31C
(2) r2 (/32)
(164) ETM_contextid_comparator_mask (/32) >
halt [ms] | [Command]
wait_halt [ms] | [Command]
The halt command first sends a halt request to the target, which wait_halt doesn’t. Otherwise these behave the same: wait up to ms milliseconds, or 5 seconds if there is no parameter, for the target to halt (and enter debug mode). Using 0 as the ms parameter prevents OpenOCD from waiting.
Warning: On ARM cores, software using the wait for interrupt operation often blocks the JTAG access needed by a halt command. This is because that operation also puts the core into a low power mode by gating the core clock; but the core clock is needed to detect JTAG clock transitions. One partial workaround uses adaptive clocking: when the core is interrupted the operation completes, then JTAG clocks are accepted at least until the interrupt handler completes. However, this workaround is often unusable since the processor, board, and JTAG adapter must all support adaptive JTAG clocking. Also, it can’t work until an interrupt is issued. A more complete workaround is to not use that operation while you work with a JTAG debugger. Tasking environments generally have idle loops where the body is the wait for interrupt operation. (On older cores, it is a coprocessor action; newer cores have a wfi instruction.) Such loops can just remove that operation, at the cost of higher power consumption (because the CPU is needlessly clocked).
resume [address] | [Command]
Resume the target at its current code position, or the optional address if it is provided. OpenOCD will wait 5 seconds for the target to resume.
step [address] | [Command]
Single-step the target at its current code position, or the optional address if it is provided.
reset | [Command]
reset run | [Command]
reset halt | [Command]

Chapter 15: General Commands | 127
reset init | [Command]
Perform as hard a reset as possible, using SRST if possible. All defined targets will be reset, and target events will fire during the reset sequence.
The optional parameter specifies what should happen after the reset. If there is no parameter, a reset run is executed. The other options will not work on all systems. See Chapter 9 [Reset Configuration], page 56.
− run Let the target run
− halt Immediately halt the target
− init Immediately halt the target, and execute the reset-init script
soft_reset_halt | [Command]
Requesting target halt and executing a soft reset. This is often used when a target cannot be reset and halted. The target, after reset is released begins to execute code. OpenOCD attempts to stop the CPU and then sets the program counter back to the reset vector. Unfortunately the code that was executed may have left the hardware in an unknown state.
adapter assert [signal [assert|deassert signal]] | [Command]
adapter deassert [signal [assert|deassert signal]] | [Command]
Set values of reset signals. Without parameters returns current status of the signals. The signal parameter values may be srst, indicating that srst signal is to be asserted or deasserted, trst, indicating that trst signal is to be asserted or deasserted.
The reset_config command should already have been used to configure how the board and the adapter treat these two signals, and to say if either signal is even present. See Chapter 9 [Reset Configuration], page 56. Trying to assert a signal that is not present triggers an error. If a signal is present on the adapter and not specified in the command, the signal will not be modified.
Note: TRST is specially handled. It actually signifies JTAG’s reset state. So if the board doesn’t support the optional TRST signal, or it doesn’t support it along with the specified SRST value, JTAG reset is triggered with TMS and TCK signals instead of the TRST signal. And no matter how that JTAG reset is triggered, once the scan chain enters reset with TRST inactive, TAP post-reset events are delivered to all TAPs with handlers for that event.

## 15.3 Memory access commands

These commands allow accesses of a specific size to the memory system. Often these are used to configure the current target in some special way. For example - one may need to write certain values to the SDRAM controller to enable SDRAM.
1. Use the targets (plural) command to change the current target.
2. In system level scripts these commands are deprecated. Please use their TARGET object siblings to avoid making assumptions about what TAP is the current target, or about MMU configuration.
mdd [phys] addr [count] | [Command]
mdw [phys] addr [count] | [Command]

Chapter 15: General Commands | 128
mdh [phys] addr [count] | [Command]
mdb [phys] addr [count] | [Command]
Display contents of address addr, as 64-bit doublewords (mdd), 32-bit words (mdw), 16-bit halfwords (mdh), or 8-bit bytes (mdb). When the current target has an MMU which is present and active, addr is interpreted as a virtual address. Otherwise, or if the optional phys flag is specified, addr is interpreted as a physical address. If count is specified, displays that many units. (If you want to manipulate the data instead of displaying it, see the mem2array primitives.)
mwd [phys] addr doubleword [count] | [Command]
mww [phys] addr word [count] | [Command]
mwh [phys] addr halfword [count] | [Command]
mwb [phys] addr byte [count] | [Command]
Writes the specified doubleword (64 bits), word (32 bits), halfword (16 bits), or byte (8-bit) value, at the specified address addr. When the current target has an MMU which is present and active, addr is interpreted as a virtual address. Otherwise, or if the optional phys flag is specified, addr is interpreted as a physical address. If count is specified, fills that many units of consecutive address.

## 15.4 Image loading commands

dump_image filename address size | [Command]
Dump size bytes of target memory starting at address to the binary file named filename.
fast_load | [Command]
Loads an image stored in memory by fast_load_image to the current target. Must be preceded by fast load image.
fast_load_image filename address [bin|ihex|elf|s19] | [Command]
Normally you should be using load_image or GDB load. However, for testing purposes or when I/O overhead is significant(OpenOCD running on an embedded host), storing the image in memory and uploading the image to the target can be a way to upload e.g. multiple debug sessions when the binary does not change. Arguments are the same as load_image, but the image is stored in OpenOCD host memory, i.e. does not affect target. This approach is also useful when profiling target programming performance as I/O and target programming can easily be profiled separately.
load_image filename address [[bin|ihex|elf|s19] min_addr | [Command]
max_length]
Load image from file filename to target memory offset by address from its load address. The file format may optionally be specified (bin, ihex, elf, or s19). In addition the following arguments may be specified: min addr - ignore data below min addr (this is w.r.t. to the target’s load address + address) max length - maximum number of bytes to load.

proc load_image_bin {fname foffset address length } {
# Load data from fname filename at foffset offset to # target at address. Load at most length bytes.

Chapter 15: General Commands | 129

load_image $fname [expr $address - $foffset] bin \ $address $length
}
test_image filename [address [bin|ihex|elf]] | [Command]
Displays image section sizes and addresses as if filename were loaded into target memory starting at address (defaults to zero). The file format may optionally be specified (bin, ihex, or elf)
verify_image filename address [bin|ihex|elf] | [Command]
Verify filename against target memory starting at address. The file format may optionally be specified (bin, ihex, or elf) This will first attempt a comparison using a CRC checksum, if this fails it will try a binary compare.
verify_image_checksum filename address [bin|ihex|elf] | [Command]
Verify filename against target memory starting at address. The file format may optionally be specified (bin, ihex, or elf) This perform a comparison using a CRC checksum only

## 15.5 Breakpoint and Watchpoint commands

CPUs often make debug modules accessible through JTAG, with hardware support for a handful of code breakpoints and data watchpoints. In addition, CPUs almost always support software breakpoints.

bp [address len [hw]] | [Command]
With no parameters, lists all active breakpoints. Else sets a breakpoint on code execution starting at address for length bytes. This is a software breakpoint, unless hw is specified in which case it will be a hardware breakpoint.

(See [arm9 vector catch], page 138, or see [xscale vector catch], page 141, for similar mechanisms that do not consume hardware breakpoints.)

rbp all | address | [Command]
Remove the breakpoint at address or all breakpoints.
rwp address | [Command]
Remove data watchpoint on address
wp [address len [(r|w|a) [value [mask]]]] | [Command]
With no parameters, lists all active watchpoints. Else sets a data watchpoint on data from address for length bytes. The watch point is an "access" watchpoint unless the r or w parameter is provided, defining it as respectively a read or write watchpoint. If a value is provided, that value is used when determining if the watchpoint should trigger. The value may be first be masked using mask to mark “don’t care” fields.

Chapter 15: General Commands | 130

## 15.6 Real Time Transfer (RTT)

Real Time Transfer (RTT) is an interface specified by SEGGER based on basic memory reads and writes to transfer data bidirectionally between target and host. The specification is independent of the target architecture. Every target that supports so called "background memory access", which means that the target memory can be accessed by the debugger while the target is running, can be used. This interface is especially of interest for targets without Serial Wire Output (SWO), such as ARM Cortex-M0, or where semihosting is not applicable because of real-time constraints.

Note: The current implementation supports only single target devices.

The data transfer between host and target device is organized through unidirectional up/down-channels for target-to-host and host-to-target communication, respectively.

Note: The current implementation does not respect channel buffer flags. They
are used to determine what happens when writing to a full buffer, for example.

Channels are exposed via raw TCP/IP connections. One or more RTT servers can be assigned to each channel to make them accessible to an unlimited number of TCP/IP connections.

rtt setup address size ID | [Command]
Configure RTT for the currently selected target. Once RTT is started, OpenOCD searches for a control block with the identifier ID starting at the memory address address within the next size bytes.
rtt start | [Command]
Start RTT. If the control block location is not known, OpenOCD starts searching for it.
rtt stop | [Command]
Stop RTT.
rtt polling_interval [interval] | [Command]
Display the polling interval. If interval is provided, set the polling interval. The polling interval determines (in milliseconds) how often the up-channels are checked for new data.
rtt channels | [Command]
Display a list of all channels and their properties.
rtt channellist | [Command]
Return a list of all channels and their properties as Tcl list. The list can be manipulated easily from within scripts.
rtt server start port channel | [Command]
Start a TCP server on port for the channel channel.
rtt server stop port | [Command]
Stop the TCP sever with port port.

Chapter 15: General Commands | 131

The following example shows how to setup RTT using the SEGGER RTT implementation on the target device.

resume

rtt setup 0x20000000 2048 "SEGGER RTT" rtt start

rtt server start 9090 0
In this example, OpenOCD searches the control block with the ID "SEGGER RTT" starting at 0x20000000 for 2048 bytes. The RTT channel 0 is exposed through the TCP/IP port 9090.

## 15.7 Misc Commands

profile seconds filename [start end] | [Command]
Profiling samples the CPU’s program counter as quickly as possible, which is useful for non-intrusive stochastic profiling. Saves up to 10000 samples in filename using “gmon.out” format. Optional start and end parameters allow to limit the address range.
version | [Command]
Displays a string identifying the version of this OpenOCD server.
virt2phys virtual address | [Command]
Requests the current target to map the specified virtual address to its corresponding physical address, and displays the result.
add_help_text ’command name’ ’help-string’ | [Command]
Add or replace help text on the given command name.
add_usage_text ’command name’ ’help-string’ | [Command]
Add or replace usage text on the given command name.

132

## 16 Architecture and Core Commands

Most CPUs have specialized JTAG operations to support debugging. OpenOCD packages most such operations in its standard command framework. Some of those operations don’t fit well in that framework, so they are exposed here as architecture or implementation (core) specific commands.

## 16.1 ARM Hardware Tracing

CPUs based on ARM cores may include standard tracing interfaces, based on an “Embedded Trace Module” (ETM) which sends voluminous address and data bus trace records to a “Trace Port”.
- Development-oriented boards will sometimes provide a high speed trace connector for collecting that data, when the particular CPU supports such an interface. (The standard connector is a 38-pin Mictor, with both JTAG and trace port support.) Those trace connectors are supported by higher end JTAG adapters and some logic analyzer modules; frequently those modules can buffer several megabytes of trace data. Configuring an ETM coupled to such an external trace port belongs in the board-specific configuration file.
- If the CPU doesn’t provide an external interface, it probably has an “Embedded Trace Buffer” (ETB) on the chip, which is a dedicated SRAM. 4KBytes is one common ETB size. Configuring an ETM coupled only to an ETB belongs in the CPU-specific (target) configuration file, since it works the same on all boards.

ETM support in OpenOCD doesn’t seem to be widely used yet.
Issues: ETM support may be buggy, and at least some etm config parameters should be detected by asking the ETM for them.
ETM trigger events could also implement a kind of complex hardware breakpoint, much more powerful than the simple watchpoint hardware exported by EmbeddedICE modules. Such breakpoints can be triggered even when using the dummy trace port driver.
It seems like a GDB hookup should be possible, as well as tracing only during specific states (perhaps handling IRQ 23 or calls foo()).
There should be GUI tools to manipulate saved trace data and help analyse it in conjunction with the source code. It’s unclear how much of a common interface is shared with the current XScale trace support, or should be shared with eventual Nexus-style trace module support.
At this writing (November 2009) only ARM7, ARM9, and ARM11 support for ETM modules is available. The code should be able to work with some newer cores; but not all of them support this original style of JTAG access.

### 16.1.1 ETM Configuration

ETM setup is coupled with the trace port driver configuration.

etm config target width mode clocking driver | [Config Command]
Declares the ETM associated with target, and associates it with a given trace port driver. See [Trace Port Drivers], page 134.

Chapter 16: Architecture and Core Commands | 133

Several of the parameters must reflect the trace port capabilities, which are a function of silicon capabilities (exposed later using etm info) and of what hardware is connected to that port (such as an external pod, or ETB). The width must be either 4, 8, or 16, except with ETMv3.0 and newer modules which may also support 1, 2, 24, 32, 48, and 64 bit widths. (With those versions, etm info also shows whether the selected port width and mode are supported.)

The mode must be normal, multiplexed, or demultiplexed. The clocking must be half or full.

Warning: With ETMv3.0 and newer, the bits set with the mode and clocking parameters both control the mode. This modified mode does not
map to the values supported by previous ETM modules, so this syntax is subject to change.

Note: You can see the ETM registers using the reg command. Not all possible registers are present in every ETM. Most of the registers are write-only, and are used to configure what CPU activities are traced.

etm info | [Command]
Displays information about the current target’s ETM. This includes resource counts from the ETM_CONFIG register, as well as silicon capabilities (except on rather old modules). from the ETM_SYS_CONFIG register.
etm status | [Command]
Displays status of the current target’s ETM and trace port driver: is the ETM idle, or is it collecting data? Did trace data overflow? Was it triggered?

etm tracemode [type context id bits cycle accurate branch output] [Command] Displays what data that ETM will collect. If arguments are provided, first configures that data. When the configuration changes, tracing is stopped and any buffered trace data is invalidated.

- type ... describing how data accesses are traced, when they pass any ViewData filtering that was set up. The value is one of none (save nothing), data (save data), address (save addresses), all (save data and addresses)
- context id bits ... 0, 8, 16, or 32
- cycle accurate ... enable or disable cycle-accurate instruction tracing. Before ETMv3, enabling this causes much extra data to be recorded.
- branch output ... enable or disable. Disable this unless you need to try reconstructing the instruction trace stream without an image of the code.
etm trigger_debug (enable|disable) | [Command]
Displays whether ETM triggering debug entry (like a breakpoint) is enabled or disabled, after optionally modifying that configuration. The default behaviour is disable. Any change takes effect after the next etm start.

By using script commands to configure ETM registers, you can make the processor enter debug state automatically when certain conditions, more complex than supported by the breakpoint hardware, happen.

Chapter 16: Architecture and Core Commands | 134

### 16.1.2 ETM Trace Operation

After setting up the ETM, you can use it to collect data. That data can be exported to files for later analysis. It can also be parsed with OpenOCD, for basic sanity checking.

To configure what is being traced, you will need to write various trace registers using reg ETM_* commands. For the definitions of these registers, read ARM publication IHI 0014, “Embedded Trace Macrocell, Architecture Specification”. Be aware that most of the relevant registers are write-only, and that ETM resources are limited. There are only a handful of address comparators, data comparators, counters, and so on.

Examples of scenarios you might arrange to trace include:

- Code flow within a function, excluding subroutines it calls. Use address range comparators to enable tracing for instruction access within that function’s body.
- Code flow within a function, including subroutines it calls. Use the sequencer and address comparators to activate tracing on an “entered function” state, then deactivate it by exiting that state when the function’s exit code is invoked.
- Code flow starting at the fifth invocation of a function, combining one of the above models with a counter.
- CPU data accesses to the registers for a particular device, using address range comparators and the ViewData logic.
- Such data accesses only during IRQ handling, combining the above model with sequencer triggers which on entry and exit to the IRQ handler.
- ... more

At this writing, September 2009, there are no Tcl utility procedures to help set up any common tracing scenarios.

etm analyze | [Command]
Reads trace data into memory, if it wasn’t already present. Decodes and prints the data that was collected.
etm dump filename | [Command]
Stores the captured trace data in filename.
etm image filename [base address] [type] | [Command]
Opens an image file.
etm load filename | [Command]
Loads captured trace data from filename.
etm start | [Command]
Starts trace data collection.
etm stop | [Command]
Stops trace data collection.

Chapter 16: Architecture and Core Commands | 135

### 16.1.3 Trace Port Drivers

To use an ETM trace port it must be associated with a driver.

dummy | [Trace Port Driver]
Use the dummy driver if you are configuring an ETM that’s not connected to anything (on-chip ETB or off-chip trace connector). This driver lets OpenOCD talk to the ETM, but it does not expose any trace data collection.
etm_dummy config target | [Config Command]
Associates the ETM for target with a dummy driver.
etb | [Trace Port Driver]
Use the etb driver if you are configuring an ETM to use on-chip ETB memory.
etb config target etb tap | [Config Command]
Associates the ETM for target with the ETB at etb tap. You can see the ETB registers using the reg command.
etb trigger_percent [percent] | [Command]
This displays, or optionally changes, ETB behavior after the ETM’s configured trigger event fires. It controls how much more trace data is saved after the (single) trace trigger becomes active.
- The default corresponds to trace around usage, recording 50 percent data before the event and the rest afterwards.
- The minimum value of percent is 2 percent, recording almost exclusively data before the trigger. Such extreme trace before usage can help figure out what caused that event to happen.
- The maximum value of percent is 100 percent, recording data almost exclusively after the event. This extreme trace after usage might help sort out how the event caused trouble.

## 16.2 ARM Cross-Trigger Interface

The ARM Cross-Trigger Interface (CTI) is a generic CoreSight component that connects event sources like tracing components or CPU cores with each other through a common trigger matrix (CTM). For ARMv8 architecture, a CTI is mandatory for core run control and each core has an individual CTI instance attached to it. OpenOCD has limited support for CTI using the cti group of commands.

cti create cti name -dap dap name -ap-num apn -baseaddr | [Command]
base address
Creates a CTI instance cti name on the DAP instance dap name on MEM-AP apn. The base address must match the base address of the CTI on the respective MEM-AP. All arguments are mandatory. This creates a new command $cti_name which is used for various purposes including additional configuration.
$cti_name enable on|off | [Command]
Enable (on) or disable (off) the CTI.

Chapter 16: Architecture and Core Commands | 136
$cti_name dump | [Command]
Displays a register dump of the CTI.
$cti_name write reg_name value | [Command]
Write value to the CTI register with the symbolic name reg name.
$cti_name read reg_name | [Command]
Print the value read from the CTI register with the symbolic name reg name.
$cti_name ack event | [Command]
Acknowledge a CTI event.
$cti_name channel channel_number operation | [Command]
Perform a specific channel operation, the possible operations are: gate, ungate, set, clear and pulse
$cti_name testmode on|off | [Command]
Enable (on) or disable (off) the integration test mode of the CTI.
cti names | [Command]
Prints a list of names of all CTI objects created. This command is mainly useful in TCL scripting.

## 16.3 Generic ARM

These commands should be available on all ARM processors. They are available in addition to other core-specific commands that may be available.

arm core_state [arm|thumb] | [Command]
Displays the core state, optionally changing it to process either arm or thumb instructions. The target may later be resumed in the currently set core state. (Processors may also support the Jazelle state, but that is not currently supported in OpenOCD.)
arm disassemble address [count [thumb]] | [Command]
Disassembles count instructions starting at address. If count is not specified, a single instruction is disassembled. If thumb is specified, or the low bit of the address is set, Thumb2 (mixed 16/32-bit) instructions are used; else ARM (32-bit) instructions are used. (Processors may also support the Jazelle state, but those instructions are not currently understood by OpenOCD.)

Note that all Thumb instructions are Thumb2 instructions, so older processors (without Thumb2 support) will still see correct disassembly of Thumb code. Also, ThumbEE opcodes are the same as Thumb2, with a handful of exceptions. ThumbEE disassembly currently has no explicit support.

arm mcr pX op1 CRn CRm op2 value | [Command]
Write value to a coprocessor pX register passing parameters CRn, CRm, opcodes opc1 and opc2, and using the MCR instruction. (Parameter sequence matches the ARM instruction, but omits an ARM register.)

Chapter 16: Architecture and Core Commands | 137
arm mrc pX coproc op1 CRn CRm op2 | [Command]
Read a coprocessor pX register passing parameters CRn, CRm, opcodes opc1 and opc2, and the MRC instruction. Returns the result so it can be manipulated by Jim scripts. (Parameter sequence matches the ARM instruction, but omits an ARM register.)
arm reg | [Command]
Display a table of all banked core registers, fetching the current value from every core mode if necessary.
arm semihosting [enable|disable] | [Command]
Display status of semihosting, after optionally changing that status.

Semihosting allows for code executing on an ARM target to use the I/O facilities on the host computer i.e. the system where OpenOCD is running. The target application must be linked against a library implementing the ARM semihosting convention that forwards operation requests by using a special SVC instruction that is trapped at the Supervisor Call vector by OpenOCD.

arm semihosting_cmdline [enable|disable] | [Command]
Set the command line to be passed to the debugger.

arm semihosting_cmdline argv0 argv1 argv2 ...
This option lets one set the command line arguments to be passed to the program. The first argument (argv0) is the program name in a standard C environment (argv[0]). Depending on the program (not much programs look at argv[0]), argv0 is ignored and can be any string.
arm semihosting_fileio [enable|disable] | [Command]
Display status of semihosting fileio, after optionally changing that status.

Enabling this option forwards semihosting I/O to GDB process using the File-I/O remote protocol extension. This is especially useful for interacting with remote files or displaying console messages in the debugger.

arm semihosting_resexit [enable|disable] | [Command]
Enable resumable SEMIHOSTING SYS EXIT.

When SEMIHOSTING SYS EXIT is called outside a debug session, things are simple, the openocd process calls exit() and passes the value returned by the target.

When SEMIHOSTING SYS EXIT is called during a debug session, by default execution returns to the debugger, leaving the debugger in a HALT state, similar to the state entered when encountering a break.

In some use cases, it is useful to have SEMIHOSTING SYS EXIT return normally, as any semihosting call, and do not break to the debugger. The standard allows this to happen, but the condition to trigger it is a bit obscure ("by performing an RDI Execute request or equivalent").

To make the SEMIHOSTING SYS EXIT call return normally, enable this option (default: disabled).

Chapter 16: Architecture and Core Commands | 138

## 16.4 ARMv4 and ARMv5 Architecture

The ARMv4 and ARMv5 architectures are widely used in embedded systems, and introduced core parts of the instruction set in use today. That includes the Thumb instruction set, introduced in the ARMv4T variant.

### 16.4.1 ARM7 and ARM9 specific commands

These commands are specific to ARM7 and ARM9 cores, like ARM7TDMI, ARM720T, ARM9TDMI, ARM920T or ARM926EJ-S. They are available in addition to the ARM commands, and any other core-specific commands that may be available.

arm7_9 dbgrq [enable|disable] | [Command]
Displays the value of the flag controlling use of the EmbeddedIce DBGRQ signal to force entry into debug mode, instead of breakpoints. If a boolean parameter is provided, first assigns that flag.
This should be safe for all but ARM7TDMI-S cores (like NXP LPC). This feature is enabled by default on most ARM9 cores, including ARM9TDMI, ARM920T, and ARM926EJ-S.
arm7_9 dcc_downloads [enable|disable] | [Command]
Displays the value of the flag controlling use of the debug communications channel (DCC) to write larger (>128 byte) amounts of memory. If a boolean parameter is provided, first assigns that flag.
DCC downloads offer a huge speed increase, but might be unsafe, especially with targets running at very low speeds. This command was introduced with OpenOCD rev. 60, and requires a few bytes of working area.
arm7_9 fast_memory_access [enable|disable] | [Command]
Displays the value of the flag controlling use of memory writes and reads that don’t check completion of the operation. If a boolean parameter is provided, first assigns that flag.
This provides a huge speed increase, especially with USB JTAG cables (FT2232), but might be unsafe if used with targets running at very low speeds, like the 32kHz startup clock of an AT91RM9200.

### 16.4.2 ARM9 specific commands

ARM9-family cores are built around ARM9TDMI or ARM9E (including ARM9EJS) integer processors. Such cores include the ARM920T, ARM926EJ-S, and ARM966.

arm9 vector_catch [all|none|list] | [Command]
Vector Catch hardware provides a sort of dedicated breakpoint for hardware events such as reset, interrupt, and abort. You can use this to conserve normal breakpoint resources, so long as you’re not concerned with code that branches directly to those hardware vectors.
This always finishes by listing the current configuration. If parameters are provided, it first reconfigures the vector catch hardware to intercept all of the hardware vectors, none of them, or a list with one or more of the following: reset undef swi pabt dabt irq fiq.

Chapter 16: Architecture and Core Commands | 139

### 16.4.3 ARM920T specific commands

These commands are available to ARM920T based CPUs, which are implementations of the ARMv4T architecture built using the ARM9TDMI integer core. They are available in addition to the ARM, ARM7/ARM9, and ARM9 commands.

arm920t cache_info | [Command]
Print information about the caches found. This allows to see whether your target is an ARM920T (2x16kByte cache) or ARM922T (2x8kByte cache).
arm920t cp15 regnum [value] | [Command]
Display cp15 register regnum; else if a value is provided, that value is written to that register. This uses "physical access" and the register number is as shown in bits 38..33 of table 9-9 in the ARM920T TRM. (Not all registers can be written.)
arm920t read_cache filename | [Command]
Dump the content of ICache and DCache to a file named filename.
arm920t read_mmu filename | [Command]
Dump the content of the ITLB and DTLB to a file named filename.

### 16.4.4 ARM926ej-s specific commands

These commands are available to ARM926ej-s based CPUs, which are implementations of the ARMv5TEJ architecture based on the ARM9EJ-S integer core. They are available in addition to the ARM, ARM7/ARM9, and ARM9 commands.

The Feroceon cores also support these commands, although they are not built from ARM926ej-s designs.

arm926ejs cache_info | [Command]
Print information about the caches found.

### 16.4.5 ARM966E specific commands

These commands are available to ARM966 based CPUs, which are implementations of the ARMv5TE architecture. They are available in addition to the ARM, ARM7/ARM9, and ARM9 commands.

arm966e cp15 regnum [value] | [Command]
Display cp15 register regnum; else if a value is provided, that value is written to that register. The six bit regnum values are bits 37..32 from table 7-2 of the ARM966E-S TRM. There is no current control over bits 31..30 from that table, as required for BIST support.

### 16.4.6 XScale specific commands

Some notes about the debug implementation on the XScale CPUs:
The XScale CPU provides a special debug-only mini-instruction cache (mini-IC) in which exception vectors and target-resident debug handler code are placed by OpenOCD. In order to get access to the CPU, OpenOCD must point vector 0 (the reset vector) to the entry of the debug handler. However, this means that the complete first cacheline in the mini-IC is

Chapter 16: Architecture and Core Commands | 140

marked valid, which makes the CPU fetch all exception handlers from the mini-IC, ignoring the code in RAM.

To address this situation, OpenOCD provides the xscale vector_table command, which allows the user to explicitly write individual entries to either the high or low vector table stored in the mini-IC.

It is recommended to place a pc-relative indirect branch in the vector table, and put the branch destination somewhere in memory. Doing so makes sure the code in the vector table stays constant regardless of code layout in memory:

_vectors:
ldr | pc,[pc,#0x100-8]
ldr | pc,[pc,#0x100-8]
ldr | pc,[pc,#0x100-8]
ldr | pc,[pc,#0x100-8]
ldr | pc,[pc,#0x100-8]
ldr | pc,[pc,#0x100-8]
ldr | pc,[pc,#0x100-8]
ldr | pc,[pc,#0x100-8]
.org 0x100
.long real_reset_vector
.long real_ui_handler
.long real_swi_handler
.long real_pf_abort
.long real_data_abort
.long 0 /* unused */
.long real_irq_handler
.long real_fiq_handler
Alternatively, you may choose to keep some or all of the mini-IC vector table entries synced with those written to memory by your system software. The mini-IC can not be modified while the processor is executing, but for each vector table entry not previously defined using the xscale vector_table command, OpenOCD will copy the value from memory to the mini-IC every time execution resumes from a halt. This is done for both high and low vector tables (although the table not in use may not be mapped to valid memory, and in this case that copy operation will silently fail). This means that you will need to briefly halt execution at some strategic point during system start-up; e.g., after the software has initialized the vector table, but before exceptions are enabled. A breakpoint can be used to accomplish this once the appropriate location in the start-up code has been identified. A watchpoint over the vector table region is helpful in finding the location if you’re not sure. Note that the same situation exists any time the vector table is modified by the system software.

The debug handler must be placed somewhere in the address space using the xscale debug_handler command. The allowed locations for the debug handler are either (0x800 -0x1fef800) or (0xfe000800 - 0xfffff800). The default value is 0xfe000800.

XScale has resources to support two hardware breakpoints and two watchpoints. However, the following restrictions on watchpoint functionality apply: (1) the value and mask arguments to the wp command are not supported, (2) the watchpoint length must be a power

Chapter 16: Architecture and Core Commands | 141

of two and not less than four, and can not be greater than the watchpoint address, and
(3) a watchpoint with a length greater than four consumes all the watchpoint hardware resources. This means that at any one time, you can have enabled either two watchpoints with a length of four, or one watchpoint with a length greater than four.
These commands are available to XScale based CPUs, which are implementations of the ARMv5TE architecture.
xscale analyze_trace | [Command]
Displays the contents of the trace buffer.
xscale cache_clean_address address | [Command]
Changes the address used when cleaning the data cache.
xscale cache_info | [Command]
Displays information about the CPU caches.
xscale cp15 regnum [value] | [Command]
Display cp15 register regnum; else if a value is provided, that value is written to that register.
xscale debug_handler target address | [Command]
Changes the address used for the specified target’s debug handler.
xscale dcache [enable|disable] | [Command]
Enables or disable the CPU’s data cache.
xscale dump_trace filename | [Command]
Dumps the raw contents of the trace buffer to filename.
xscale icache [enable|disable] | [Command]
Enables or disable the CPU’s instruction cache.
xscale mmu [enable|disable] | [Command]
Enables or disable the CPU’s memory management unit.
xscale trace_buffer [enable|disable [fill [n] | wrap]] | [Command]
Displays the trace buffer status, after optionally enabling or disabling the trace buffer and modifying how it is emptied.
xscale trace_image filename [offset [type]] | [Command]
Opens a trace image from filename, optionally rebasing its segment addresses by offset. The image type may be one of bin (binary), ihex (Intel hex), elf (ELF file), s19 (Motorola s19), mem, or builder.
xscale vector_catch [mask] | [Command]
Display a bitmask showing the hardware vectors to catch. If the optional parameter is provided, first set the bitmask to that value.
The mask bits correspond with bit 16..23 in the DCSR:
0x01 | Trap Reset
0x02 | Trap Undefined Instructions

Chapter 16: Architecture and Core Commands | 142
0x04 | Trap Software Interrupt
0x08 | Trap Prefetch Abort
0x10 | Trap Data Abort
0x20 | reserved
0x40 | Trap IRQ
0x80 | Trap FIQ
xscale vector_table [(low|high) index value] | [Command]
Set an entry in the mini-IC vector table. There are two tables: one for low vectors (at 0x00000000), and one for high vectors (0xFFFF0000), each holding the 8 exception vectors. index can be 1-7, because vector 0 points to the debug handler entry and can not be overwritten. value holds the 32-bit opcode that is placed in the mini-IC. Without arguments, the current settings are displayed.

## 16.5 ARMv6 Architecture

### 16.5.1 ARM11 specific commands

arm11 memwrite burst [enable|disable] | [Command]
Displays the value of the memwrite burst-enable flag, which is enabled by default. If a boolean parameter is provided, first assigns that flag. Burst writes are only used for memory writes larger than 1 word. They improve performance by assuming that the CPU has read each data word over JTAG and completed its write before the next word arrives, instead of polling for a status flag to verify that completion. This is usually safe, because JTAG runs much slower than the CPU.
arm11 memwrite error_fatal [enable|disable] | [Command]
Displays the value of the memwrite error fatal flag, which is enabled by default. If a boolean parameter is provided, first assigns that flag. When set, certain memory write errors cause earlier transfer termination.
arm11 step_irq_enable [enable|disable] | [Command]
Displays the value of the flag controlling whether IRQs are enabled during single stepping; they are disabled by default. If a boolean parameter is provided, first assigns that.
arm11 vcr [value] | [Command]
Displays the value of the Vector Catch Register (VCR), coprocessor 14 register 7. If value is defined, first assigns that.
Vector Catch hardware provides dedicated breakpoints for certain hardware events. The specific bit values are core-specific (as in fact is using coprocessor 14 register 7 itself) but all current ARM11 cores except the ARM1176 use the same six bits.

## 16.6 ARMv7 and ARMv8 Architecture

### 16.6.1 ARMv7-A specific commands

cortex_a cache_info | [Command]
display information about target caches

Chapter 16: Architecture and Core Commands | 143
cortex_a dacrfixup [on|off] | [Command]
Work around issues with software breakpoints when the program text is mapped readonly by the operating system. This option sets the CP15 DACR to "all-manager" to bypass MMU permission checks on memory access. Defaults to ’off’.
cortex_a dbginit | [Command]
Initialize core debug Enables debug by unlocking the Software Lock and clearing sticky powerdown indications
cortex_a smp [on|off] | [Command]
Display/set the current SMP mode
cortex_a smp_gdb [core id] | [Command]
Display/set the current core displayed in GDB
cortex_a maskisr [on|off] | [Command]
Selects whether interrupts will be processed when single stepping
cache_config l2x [base way] | [Command]
configure l2x cache
cortex_a mmu dump [0|1|addr address [num_entries]] | [Command]
Dump the MMU translation table from TTB0 or TTB1 register, or from physical memory location address. When dumping the table from address, print at most num entries page table entries. num entries is optional, if omitted, the maximum possible (4096) entries are printed.

### 16.6.2 ARMv7-R specific commands

cortex_r4 dbginit | [Command]
Initialize core debug Enables debug by unlocking the Software Lock and clearing sticky powerdown indications
cortex_r4 maskisr [on|off] | [Command]
Selects whether interrupts will be processed when single stepping

### 16.6.3 ARM CoreSight TPIU and SWO specific commands

ARM CoreSight provides several modules to generate debugging information internally (ITM, DWT and ETM). Their output is directed through TPIU or SWO modules to be captured externally either on an SWO pin (this configuration is called SWV) or on a synchronous parallel trace port.
ARM CoreSight provides independent HW blocks named TPIU and SWO each with its own functionality. Embedded in Cortex-M3 and M4, ARM provides an optional HW block that includes both TPIU and SWO functionalities and is again named TPIU, which causes quite some confusion. The registers map of all the TPIU and SWO implementations allows using a single driver that detects at runtime the features available.

The tpiu is used for either TPIU or SWO. A convenient alias swo is available to help distinguish, in scripts, the commands for SWO from the commands for TPIU.

Chapter 16: Architecture and Core Commands | 144
swo ... | [Command]
Alias of tpiu .... Can be used in scripts to distinguish the commands for SWO from the commands for TPIU.
tpiu create tpiu name configparams... | [Command]
Creates a TPIU or a SWO object. The two commands are equivalent. Add the object in a list and add new commands (tpiu_name) which are used for various purposes including additional configuration.
- tpiu name – the name of the TPIU or SWO object. This name is also used to create the object’s command, referred to here as $tpiu_name, and in other places where the TPIU or SWO needs to be identified.
- configparams – all parameters accepted by $tpiu_name configure are permitted.
You must set here the AP and MEM AP base address through -dap dap_name, -ap-num ap_number and -baseaddr base_address.
tpiu names | [Command]
Lists all the TPIU or SWO objects created so far. The two commands are equivalent.
tpiu init | [Command]
Initialize all registered TPIU and SWO. The two commands are equivalent. These commands are used internally during initialization. They can be issued at any time after the initialization, too.
$tpiu_name cget queryparm | [Command]
Each configuration parameter accepted by $tpiu_name configure can be individually queried, to return its current value. The queryparm is a parameter name accepted by that command, such as -dap.
$tpiu_name configure configparams... | [Command]
The options accepted by this command may also be specified as parameters to tpiu create. Their values can later be queried one at a time by using the $tpiu_name cget command.
- -dap dap name – names the DAP used to access this TPIU. See [DAP declaration], page 66, on how to create and manage DAP instances.
- -ap-num ap number – sets DAP access port for TPIU, ap number is the numeric index of the DAP AP the TPIU is connected to.
- -baseaddr base address – sets the TPIU base address where to access the TPIU in the DAP AP memory space.
- -protocol (sync|uart|manchester) – sets the protocol used for trace data:

− sync – synchronous parallel trace output mode, using port width data bits (default);

− uart – use asynchronous SWO mode with NRZ (same as regular UART 8N1) coding;

− manchester – use asynchronous SWO mode with Manchester coding.

Chapter 16: Architecture and Core Commands | 145
- -event event name event body – assigns an event handler, a TCL string which is evaluated when the event is triggered. The events pre-enable, post-enable, pre-disable and post-disable are defined for TPIU/SWO. A typical use case for the event pre-enable is to enable the trace clock of the TPIU.
- -output (external|:port|filename|-) – specifies the destination of the trace data:
− external – configure TPIU/SWO to let user capture trace output externally, either with an additional UART or with a logic analyzer (default);

− - – configure TPIU/SWO and debug adapter to gather trace data and forward it to tcl_trace command;
− :port – configure TPIU/SWO and debug adapter to gather trace data, open a TCP server at port port and send the trace data to each connected client; − filename – configure TPIU/SWO and debug adapter to gather trace data and append it to filename, which can be either a regular file or a named pipe.
- -traceclk TRACECLKIN freq – mandatory parameter. Specifies the frequency in Hz of the trace clock. For the TPIU embedded in Cortex-M3 or M4, this is usually the same frequency as HCLK. For protocol sync this is twice the frequency of the pin data rate.
- -pin-freq trace freq – specifies the expected data rate in Hz of the SWO pin. Parameter used only on protocols uart and manchester. Can be omitted to let the adapter driver select the maximum supported rate automatically.
- -port-width port width – sets to port width the width of the synchronous parallel port used for trace output. Parameter used only on protocol sync. If not specified, default value is 1.
- -formatter (0|1) – specifies if the formatter should be enabled. Parameter used only on protocol sync. If not specified, default value is 0.
$tpiu_name enable | [Command]
Uses the parameters specified by the previous $tpiu_name configure to configure and enable the TPIU or the SWO. If required, the adapter is also configured and enabled to receive the trace data. This command can be used before init, but it will take effect only after the init.
$tpiu_name disable | [Command]
Disable the TPIU or the SWO, terminating the receiving of the trace data.

Example usage:

1. STM32L152 board is programmed with an application that configures PLL to provide core clock with 24MHz frequency; to use ITM output it’s enough to:

#include <libopencm3/cm3/itm.h>

ITM_STIM8(0) = c;

Chapter 16: Architecture and Core Commands | 146

(the most obvious way is to use the first stimulus port for printf, for that this ITM STIM8 assignment can be used inside write(); to make it blocking to avoid data loss, add while (!(ITM_STIM8(0) & ITM_STIM_FIFOREADY)););

2. An FT2232H UART is connected to the SWO pin of the board;
3. Commands to configure UART for 12MHz baud rate:

$ setserial /dev/ttyUSB1 spd_cust divisor 5
$ stty -F /dev/ttyUSB1 38400
(FT2232H’s base frequency is 60MHz, spd cust allows to alias 38400 baud with our custom divisor to get 12MHz)
4. itmdump -f /dev/ttyUSB1 -d1
5. OpenOCD invocation line:

openocd -f interface/stlink.cfg \
-c "transport select hla_swd" \
-f target/stm32l1.cfg \
-c "stm32l1.tpiu configure -protocol uart" \
-c "stm32l1.tpiu configure -traceclk 24000000 -pin-freq 12000000" \ -c "stm32l1.tpiu enable"

### 16.6.4 ARMv7-M specific commands

itm port port (0|1|on|off) | [Command]
Enable or disable trace output for ITM stimulus port (counting from 0). Port 0 is enabled on target creation automatically.
itm ports (0|1|on|off) | [Command]
Enable or disable trace output for all ITM stimulus ports.

### 16.6.5 Cortex-M specific commands

cortex_m maskisr (auto|on|off|steponly) | [Command]
Control masking (disabling) interrupts during target step/resume.

The auto option handles interrupts during stepping in a way that they get served but don’t disturb the program flow. The step command first allows pending interrupt handlers to execute, then disables interrupts and steps over the next instruction where the core was halted. After the step interrupts are enabled again. If the interrupt handlers don’t complete within 500ms, the step command leaves with the core running.

The steponly option disables interrupts during single-stepping but enables them during normal execution. This can be used as a partial workaround for 702596 erratum in Cortex-M7 r0p1. See "Cortex-M7 (AT610) and Cortex-M7 with FPU (AT611) Software Developer Errata Notice" from ARM for further details.
Note that a free hardware (FPB) breakpoint is required for the auto option. If no breakpoint is available at the time of the step, then the step is taken with interrupts enabled, i.e. the same way the off option does.
Default is auto.

Chapter 16: Architecture and Core Commands | 147
cortex_m vector_catch [all|none|list] | [Command]
Vector Catch hardware provides dedicated breakpoints for certain hardware events. Parameters request interception of all of these hardware event vectors, none of them, or one or more of the following: hard_err for a HardFault exception; mm_err for a MemManage exception; bus_err for a BusFault exception; irq_err, state_err, chk_err, or nocp_err for various UsageFault exceptions; or reset. If NVIC setup code does not enable them, MemManage, BusFault, and UsageFault exceptions are mapped to HardFault. UsageFault checks for divide-by-zero and unaligned access must also be explicitly enabled.
This finishes by listing the current vector catch configuration.
cortex_m reset_config (sysresetreq|vectreset) | [Command]
Control reset handling if hardware srst is not fitted See [reset config], page 58.
− sysresetreq use AIRCR SYSRESETREQ to reset system.
− vectreset use AIRCR VECTRESET to reset system (default).

Using vectreset is a safe option for Cortex-M3, M4 and M7 cores. This however has the disadvantage of only resetting the core, all peripherals are unaffected. A solution would be to use a reset-init event handler to manually reset the peripherals. See [Target Events], page 75.
Cortex-M0, M0+ and M1 do not support vectreset, use sysresetreq instead.

### 16.6.6 ARMv8-A specific commands

aarch64 cache_info | [Command]
Display information about target caches
aarch64 dbginit | [Command]
This command enables debugging by clearing the OS Lock and sticky power-down and reset indications. It also establishes the expected, basic cross-trigger configuration the aarch64 target code relies on. In a configuration file, the command would typically be called from a reset-end or reset-deassert-post handler, to re-enable debugging after a system reset. However, normally it is not necessary to use the command at all.
aarch64 disassemble address [count] | [Command]
Disassembles count instructions starting at address. If count is not specified, a single instruction is disassembled.
aarch64 smp [on|off] | [Command]
Display, enable or disable SMP handling mode. The state of SMP handling influences the way targets in an SMP group are handled by the run control. With SMP handling enabled, issuing halt or resume to one core will trigger halting or resuming of all cores in the group. The command target smp defines which targets are in the SMP group. With SMP handling disabled, all targets need to be treated individually.
aarch64 maskisr [on|off] | [Command]
Selects whether interrupts will be processed when single stepping. The default configuration is on.

Chapter 16: Architecture and Core Commands | 148
$target_name catch_exc | [Command]
[off|sec_el1|sec_el3|nsec_el1|nsec_el2]+
Cause $target_name to halt when an exception is taken. Any combination of Secure (sec) EL1/EL3 or Non-Secure (nsec) EL1/EL2 is valid. The target $target_name will halt before taking the exception. In order to resume the target, the exception catch must be disabled again with $target_name catch_exc off. Issuing the command without options prints the current configuration.

## 16.7 EnSilica eSi-RISC Architecture

eSi-RISC is a highly configurable microprocessor architecture for embedded systems provided by EnSilica. (See: http://www.ensilica.com/risc-ip/.)

### 16.7.1 eSi-RISC Configuration

esirisc cache_arch (harvard|von_neumann) | [Command]
Configure the caching architecture. Targets with the UNIFIED_ADDRESS_SPACE option disabled employ a Harvard architecture. By default, von_neumann is assumed.
esirisc hwdc (all|none|mask ...) | [Command]
Configure hardware debug control. The HWDC register controls which exceptions return control back to the debugger. Possible masks are all, none, reset, interrupt, syscall, error, and debug. By default, reset, error, and debug are enabled.

### 16.7.2 eSi-RISC Operation

esirisc flush_caches | [Command]
Flush instruction and data caches. This command requires that the target is halted when the command is issued and configured with an instruction or data cache.

### 16.7.3 eSi-Trace Configuration

eSi-RISC targets may be configured with support for instruction tracing. Trace data may be written to an in-memory buffer or FIFO. If a FIFO is configured, DMA is typically employed to move trace data off-device using a high-speed peripheral (eg. SPI). Collected trace data is encoded in one of three different formats. At a minimum, esirisc trace buffer or esirisc trace fifo must be issued along with esirisc trace format before trace data can be collected.

OpenOCD provides rudimentary analysis of collected trace data. If more detail is needed, collected trace data can be dumped to a file and processed by external tooling.

Issues: OpenOCD is unable to process trace data sent to a FIFO. A potential workaround for this issue is to configure DMA to copy trace data to an in-memory buffer, which can then be passed to the esirisc trace analyze and esirisc trace dump commands.

It is possible to corrupt trace data when using a FIFO if the peripheral responsible for draining data from the FIFO is not fast enough. This can be managed by enabling flow control, however this can impact timing-sensitive software operation on the CPU.

Chapter 16: Architecture and Core Commands | 149
esirisc trace buffer address size [wrap] | [Command]
Configure trace buffer using the provided address and size. If the wrap option is specified, trace collection will continue once the end of the buffer is reached. By default, wrap is disabled.
esirisc trace fifo address | [Command]
Configure trace FIFO using the provided address.
esirisc trace flow_control (enable|disable) | [Command]
Enable or disable stalling the CPU to collect trace data. By default, flow control is disabled.
esirisc trace format (full|branch|icache) pc bits | [Command]
Configure trace format and number of PC bits to be captured. pc_bits must be within 1 and 31 as the LSB is not collected. If external tooling is used to analyze collected trace data, these values must match.
Supported trace formats:
- full capture full trace data, allowing execution history and timing to be determined.
- branch capture taken branch instructions and branch target addresses.
- icache capture instruction cache misses.
esirisc trace trigger start (condition) [start data | [Command]
start mask]
Configure trigger start condition using the provided start data and mask. A brief description of each condition is provided below; for more detail on how these values are used, see the eSi-RISC Architecture Manual.
Supported conditions:
- none manual tracing (see esirisc trace start).
- pc start tracing if the PC matches start data and mask.
- load start tracing if the effective address of a load instruction matches start data and mask.
- store start tracing if the effective address of a store instruction matches start data and mask.
- exception start tracing if the EID of an exception matches start data and mask.
- eret start tracing when an ERET instruction is executed.
- wait start tracing when a WAIT instruction is executed.
- stop start tracing when a STOP instruction is executed.
- high start tracing when an external signal is a logical high.
- low start tracing when an external signal is a logical low.

esirisc trace trigger stop (condition) [stop data stop mask] [Command] Configure trigger stop condition using the provided stop data and mask. A brief description of each condition is provided below; for more detail on how these values are used, see the eSi-RISC Architecture Manual.

Chapter 16: Architecture and Core Commands | 150

Supported conditions:
- none manual tracing (see esirisc trace stop).
- pc stop tracing if the PC matches stop data and mask.
- load stop tracing if the effective address of a load instruction matches stop data and mask.
- store stop tracing if the effective address of a store instruction matches stop data and mask.
- exception stop tracing if the EID of an exception matches stop data and mask.
- eret stop tracing when an ERET instruction is executed.
- wait stop tracing when a WAIT instruction is executed.
- stop stop tracing when a STOP instruction is executed.
esirisc trace trigger delay (trigger) [cycles] | [Command]
Configure trigger start/stop delay in clock cycles.
Supported triggers:
- none no delay to start or stop collection.
- start delay cycles after trigger to start collection.
- stop delay cycles after trigger to stop collection.
- both delay cycles after both triggers to start or stop collection.

### 16.7.4 eSi-Trace Operation

esirisc trace init | [Command]
Initialize trace collection. This command must be called any time the configuration changes. If a trace buffer has been configured, the contents will be overwritten when trace collection starts.
esirisc trace info | [Command]
Display trace configuration.
esirisc trace status | [Command]
Display trace collection status.
esirisc trace start | [Command]
Start manual trace collection.
esirisc trace stop | [Command]
Stop manual trace collection.
esirisc trace analyze [address size] | [Command]
Analyze collected trace data. This command may only be used if a trace buffer has been configured. If a trace FIFO has been configured, trace data must be copied to an in-memory buffer identified by the address and size options using DMA.
esirisc trace dump [address size] filename | [Command]
Dump collected trace data to file. This command may only be used if a trace buffer has been configured. If a trace FIFO has been configured, trace data must be copied to an in-memory buffer identified by the address and size options using DMA.

Chapter 16: Architecture and Core Commands | 151

## 16.8 Intel Architecture

Intel Quark X10xx is the first product in the Quark family of SoCs. It is an IA-32 (Pentium x86 ISA) compatible SoC. The core CPU in the X10xx is codenamed Lakemont. Lakemont version 1 (LMT1) is used in X10xx. The CPU TAP (Lakemont TAP) is used for software debug and the CLTAP is used for SoC level operations. Useful docs are here: https://communities.intel.com/community/makers/documentation
- Intel Quark SoC X1000 OpenOCD/GDB/Eclipse App Note (web search for doc num 330015)
- Intel Quark SoC X1000 Debug Operations User Guide (web search for doc num 329866)
- Intel Quark SoC X1000 Datasheet (web search for doc num 329676)

### 16.8.1 x86 32-bit specific commands

The three main address spaces for x86 are memory, I/O and configuration space. These commands allow a user to read and write to the 64Kbyte I/O address space.

x86_32 idw address | [Command]
Display the contents of a 32-bit I/O port from address range 0x0000 - 0xffff.
x86_32 idh address | [Command]
Display the contents of a 16-bit I/O port from address range 0x0000 - 0xffff.
x86_32 idb address | [Command]
Display the contents of a 8-bit I/O port from address range 0x0000 - 0xffff.
x86_32 iww address | [Command]
Write the contents of a 32-bit I/O port to address range 0x0000 - 0xffff.
x86_32 iwh address | [Command]
Write the contents of a 16-bit I/O port to address range 0x0000 - 0xffff.
x86_32 iwb address | [Command]
Write the contents of a 8-bit I/O port to address range 0x0000 - 0xffff.

## 16.9 OpenRISC Architecture

The OpenRISC CPU is a soft core. It is used in a programmable SoC which can be configured with any of the TAP / Debug Unit available.

### 16.9.1 TAP and Debug Unit selection commands

tap_select (vjtag|mohor|xilinx_bscan) | [Command]
Select between the Altera Virtual JTAG , Xilinx Virtual JTAG and Mohor TAP.
du_select (adv|mohor) [option] | [Command]
Select between the Advanced Debug Interface and the classic one.
An option can be passed as a second argument to the debug unit.
When using the Advanced Debug Interface, option = 1 means the RTL core is configured with ADBG USE HISPEED = 1. This configuration skips status checking between bytes while doing read or write bursts.

Chapter 16: Architecture and Core Commands | 152

### 16.9.2 Registers commands

addreg [name] [address] [feature] [reg group] | [Command]
Add a new register in the cpu register list. This register will be included in the generated target descriptor file.

[feature] must be "org.gnu.gdb.or1k.group[0..10]".

[reg group] can be anything. The default register list defines "system", "dmmu", "immu", "dcache", "icache", "mac", "debug", "perf", "power", "pic" and "timer" groups.

example:

addreg rtest 0x1234 org.gnu.gdb.or1k.group0 system

## 16.10 RISC-V Architecture

RISC-V (http://riscv.org/) is a free and open ISA. OpenOCD supports JTAG debug of RV32 and RV64 cores in heterogeneous multicore systems of up to 32 harts. (It’s possible to increase this limit to 1024 by changing RISCV MAX HARTS in riscv.h.) OpenOCD primarily supports 0.13 of the RISC-V Debug Specification, but there is also support for legacy targets that implement version 0.11.

### 16.10.1 RISC-V Terminology

A hart is a hardware thread. A hart may share resources (eg. FPU) with another hart, or may be a separate core. RISC-V treats those the same, and OpenOCD exposes each hart as a separate core.

### 16.10.2 RISC-V Debug Configuration Commands

riscv expose_csrs n[-m|=name] [...] | [Config Command]
Configure which CSRs to expose in addition to the standard ones. The CSRs to expose can be specified as individual register numbers or register ranges (inclusive). For the individually listed CSRs, a human-readable name can optionally be set using the n=name syntax, which will get csr_ prepended to it. If no name is provided, the register will be named csr<n>.

By default OpenOCD attempts to expose only CSRs that are mentioned in a spec, and then only if the corresponding extension appears to be implemented. This command can be used if OpenOCD gets this wrong, or if the target implements custom CSRs.

# Expose a single RISC-V CSR number 128 under the name "csr128": $_TARGETNAME expose_csrs 128

# Expose multiple RISC-V CSRs 128..132 under names "csr128" through "csr132": $_TARGETNAME expose_csrs 128-132

# Expose a single RISC-V CSR number 1996 under custom name "csr_myregister": $_TARGETNAME expose_csrs 1996=myregister

Chapter 16: Architecture and Core Commands | 153
riscv expose_custom n[-m|=name] [...] | [Config Command]
The RISC-V Debug Specification allows targets to expose custom registers through abstract commands. (See Section 3.5.1.1 in that document.) This command configures individual registers or register ranges (inclusive) that shall be exposed. Number 0 indicates the first custom register, whose abstract command number is 0xc000. For individually listed registers, a human-readable name can be optionally provided using the n=name syntax, which will get custom_ prepended to it. If no name is provided, the register will be named custom<n>.

# Expose one RISC-V custom register with number 0xc010 (0xc000 + 16) # under the name "custom16":

$_TARGETNAME expose_custom 16

# Expose a range of RISC-V custom registers with numbers 0xc010 .. 0xc018 # (0xc000+16 .. 0xc000+24) under the names "custom16" through "custom24": $_TARGETNAME expose_custom 16-24

# Expose one RISC-V custom register with number 0xc020 (0xc000 + 32) under # user-defined name "custom_myregister":

$_TARGETNAME expose_custom 32=myregister
riscv set_command_timeout_sec [seconds] | [Command]
Set the wall-clock timeout (in seconds) for individual commands. The default should work fine for all but the slowest targets (eg. simulators).
riscv set_reset_timeout_sec [seconds] | [Command]
Set the maximum time to wait for a hart to come out of reset after reset is deasserted.
riscv set_scratch_ram none|[address] | [Command]
Set the address of 16 bytes of scratch RAM the debugger can use, or ’none’. This is used to access 64-bit floating point registers on 32-bit targets.
riscv set_mem_access method1 [method2] [method3] | [Command]
Specify which RISC-V memory access method(s) shall be used, and in which order of priority. At least one method must be specified.
Available methods are:
- progbuf - Use RISC-V Debug Program Buffer to access memory.
- sysbus - Access memory via RISC-V Debug System Bus interface.
- abstract - Access memory via RISC-V Debug abstract commands.

By default, all memory access methods are enabled in the following order: progbuf sysbus abstract.
This command can be used to change the memory access methods if the default behavior is not suitable for a particular target.
riscv set_enable_virtual on|off | [Command]
When on, memory accesses are performed on physical or virtual memory depending on the current system configuration. When off (default), all memory accessses are performed on physical memory.

Chapter 16: Architecture and Core Commands | 154
riscv set_enable_virt2phys on|off | [Command]
When on (default), memory accesses are performed on physical or virtual memory depending on the current satp configuration. When off, all memory accessses are performed on physical memory.
riscv resume_order normal|reversed | [Command]
Some software assumes all harts are executing nearly continuously. Such software may be sensitive to the order that harts are resumed in. On harts that don’t support hasel, this option allows the user to choose the order the harts are resumed in. If you are using this option, it’s probably masking a race condition problem in your code. Normal order is from lowest hart index to highest. This is the default behavior. Reversed order is from highest hart index to lowest.
riscv set_ir (idcode|dtmcs|dmi) [value] | [Command]
Set the IR value for the specified JTAG register. This is useful, for example, when using the existing JTAG interface on a Xilinx FPGA by way of BSCANE2 primitives that only permit a limited selection of IR values.
When utilizing version 0.11 of the RISC-V Debug Specification, dtmcs and dmi set the IR values for the DTMCONTROL and DBUS registers, respectively.
riscv use_bscan_tunnel value | [Command]
Enable or disable use of a BSCAN tunnel to reach DM. Supply the width of the DM transport TAP’s instruction register to enable. Supply a value of 0 to disable.
riscv set_ebreakm on|off | [Command]
Control dcsr.ebreakm. | When on (default), M-mode ebreak instructions trap to
OpenOCD. When off, they generate a breakpoint exception handled internally.
riscv set_ebreaks on|off | [Command]
Control dcsr.ebreaks. | When on (default), S-mode ebreak instructions trap to
OpenOCD. When off, they generate a breakpoint exception handled internally.
riscv set_ebreaku on|off | [Command]
Control dcsr.ebreaku. | When on (default), U-mode ebreak instructions trap to
OpenOCD. When off, they generate a breakpoint exception handled internally.

### 16.10.3 RISC-V Authentication Commands

The following commands can be used to authenticate to a RISC-V system. Eg. a trivial challenge-response protocol could be implemented as follows in a configuration file, immediately following init:

set challenge [riscv authdata_read]
riscv authdata_write [expr $challenge + 1]
riscv authdata_read | [Command]
Return the 32-bit value read from authdata.
riscv authdata_write value | [Command]
Write the 32-bit value to authdata.

Chapter 16: Architecture and Core Commands | 155

### 16.10.4 RISC-V DMI Commands

The following commands allow direct access to the Debug Module Interface, which can be used to interact with custom debug features.

riscv dmi_read address | [Command]
Perform a 32-bit DMI read at address, returning the value.
riscv dmi_write address value | [Command]
Perform a 32-bit DMI write of value at address.

## 16.11 ARC Architecture

Synopsys DesignWare ARC Processors are a family of 32-bit CPUs that SoC designers can optimize for a wide range of uses, from deeply embedded to high-performance host applications in a variety of market segments. See more at: http://www.synopsys.com/IP/ProcessorIP/ARCProcessors/Pages/default.aspx. (http://www.synopsys.com/IP/ProcessorIP/ARCProcessors/Pages/default.aspx) OpenOCD currently supports ARC EM processors. There is a set ARC-specific OpenOCD commands that allow low-level access to the core and provide necessary support for ARC extensibility and configurability capabilities. ARC processors has much more configuration capabilities than most of the other processors and in addition there is an extension interface that allows SoC designers to add custom registers and instructions. For the OpenOCD that mostly means that set of core and AUX registers in target will vary and is not fixed for a particular processor model. To enable extensibility several TCL commands are provided that allow to describe those optional registers in OpenOCD configuration files. Moreover those commands allow for a dynamic target features discovery.

### 16.11.1 General ARC commands

arc add-reg configparams | [Config Command]
Add a new register to processor target. By default newly created register is marked as not existing. configparams must have following required arguments:
- -name name
Name of a register.
- -num number
Architectural register number: core register number or AUX register number.
- -feature XML feature
Name of GDB XML target description feature.

configparams may have following optional arguments:
- -gdbnum number
GDB register number. It is recommended to not assign GDB register number manually, because there would be a risk that two register will have same number. When register GDB number is not set with this option, then register will get a previous register number + 1. This option is required only for those registers that must be at particular address expected by GDB.
- -core
This option specifies that register is a core registers. If not - this is an AUX register. AUX registers and core registers reside in different address spaces.

Chapter 16: Architecture and Core Commands | 156
- -bcr
This options specifies that register is a BCR register. BCR means Build Configuration Registers - this is a special type of AUX registers that are read only and non-volatile, that is - they never change their value. Therefore OpenOCD never invalidates values of those registers in internal caches. Because BCR is a type of AUX registers, this option cannot be used with -core.
- -type type name
Name of type of this register. This can be either one of the basic GDB types, or a custom types described with arc add-reg-type-[flags|struct].
- -g
If specified then this is a "general" register. General registers are always read by OpenOCD on context save (when core has just been halted) and is always transferred to GDB client in a response to g-packet. Contrary to this, nongeneral registers are read and sent to GDB client on-demand. In general it is not recommended to apply this option to custom registers.
arc add-reg-type-flags -name name flags... | [Config Command]
Adds new register type of “flags” class. “Flags” types can contain only one-bit fields. Each flag definition looks like -flag name bit-position.
arc add-reg-type-struct -name name structs... | [Config Command]
Adds new register type of “struct” class. “Struct” types can contain either bit-fields or fields of other types, however at the moment only bit fields are supported. Structure bit field definition looks like -bitfield name startbit endbit.
arc get-reg-field reg-name field-name | [Command]
Returns value of bit-field in a register. Register must be “struct” register type, See [add-reg-type-struct], page 156. command definition.
arc set-reg-exists reg-names... | [Command]
Specify that some register exists. Any amount of names can be passed as an argument for a single command invocation.

### 16.11.2 ARC JTAG commands

arc jtag set-aux-reg regnum value | [Command]
This command writes value to AUX register via its number. This command access register in target directly via JTAG, bypassing any OpenOCD internal caches, therefore it is unsafe to use if that register can be operated by other means.
arc jtag set-core-reg regnum value | [Command]
This command is similar to arc jtag set-aux-reg but is for core registers.
arc jtag get-aux-reg regnum | [Command]
This command returns the value storded in AUX register via its number. This commands access register in target directly via JTAG, bypassing any OpenOCD internal caches, therefore it is unsafe to use if that register can be operated by other means.
arc jtag get-core-reg regnum | [Command]
This command is similar to arc jtag get-aux-reg but is for core registers.

Chapter 16: Architecture and Core Commands | 157

## 16.12 STM8 Architecture

STM8 (http://st.com/stm8/) is a 8-bit microcontroller platform from STMicroelectronics, based on a proprietary 8-bit core architecture.
OpenOCD supports debugging STM8 through the STMicroelectronics debug protocol SWIM, see [SWIM], page 54.

## 16.13 Software Debug Messages and Tracing

OpenOCD can process certain requests from target software, when the target uses appropriate libraries. The most powerful mechanism is semihosting, but there is also a lighter weight mechanism using only the DCC channel.
Currently target_request debugmsgs is supported only for arm7_9 and cortex_m cores. These messages are received as part of target polling, so you need to have poll on active to receive them. They are intrusive in that they will affect program execution times. If that is a problem, see [ARM Hardware Tracing], page 132.
See libdcc in the contrib dir for more details. In addition to sending strings, characters, and arrays of various size integers from the target, libdcc also exports a software trace point mechanism. The target being debugged may issue trace messages which include a 24-bit trace point number. Trace point support includes two distinct mechanisms, each supported by a command:
- History ... A circular buffer of trace points can be set up, and then displayed at any time. This tracks where code has been, which can be invaluable in finding out how some fault was triggered.
The buffer may overflow, since it collects records continuously. It may be useful to use some of the 24 bits to represent a particular event, and other bits to hold data.
- Counting ... An array of counters can be set up, and then displayed at any time. This can help establish code coverage and identify hot spots.
The array of counters is directly indexed by the trace point number, so trace points with higher numbers are not counted.

Linux-ARM kernels have a “Kernel low-level debugging via EmbeddedICE DCC channel” option (CONFIG DEBUG ICEDCC, depends on CONFIG DEBUG LL) which uses this mechanism to deliver messages before a serial console can be activated. This is not the same format used by libdcc. Other software, such as the U-Boot boot loader, sometimes does the same thing.

target_request debugmsgs [enable|disable|charmsg] | [Command]
Displays current handling of target DCC message requests. These messages may be sent to the debugger while the target is running. The optional enable and charmsg parameters both enable the messages, while disable disables them.
With charmsg the DCC words each contain one character, as used by Linux with CONFIG DEBUG ICEDCC; otherwise the libdcc format is used.
trace history [clear|count] | [Command]
With no parameter, displays all the trace points that have triggered in the order they triggered. With the parameter clear, erases all current trace history records. With a count parameter, allocates space for that many history records.

Chapter 16: Architecture and Core Commands | 158
trace point [clear|identifier] | [Command]
With no parameter, displays all trace point identifiers and how many times they have been triggered. With the parameter clear, erases all current trace point counters. With a numeric identifier parameter, creates a new a trace point counter and associates it with that identifier.
Important: The identifier and the trace point number are not related except by this command. These trace point numbers always start at zero (from server startup, or after trace point clear) and count up from there.

159

## 17 JTAG Commands

Most general purpose JTAG commands have been presented earlier. (See [JTAG Speed], page 55, Chapter 9 [Reset Configuration], page 56, and Chapter 10 [TAP Declaration], page 61.) Lower level JTAG commands, as presented here, may be needed to work with targets which require special attention during operations such as reset or initialization.

To use these commands you will need to understand some of the basics of JTAG, including:

- A JTAG scan chain consists of a sequence of individual TAP devices such as a CPUs.
- Control operations involve moving each TAP through the same standard state machine (in parallel) using their shared TMS and clock signals.
- Data transfer involves shifting data through the chain of instruction or data registers of each TAP, writing new register values while the reading previous ones.
- Data register sizes are a function of the instruction active in a given TAP, while instruction register sizes are fixed for each TAP. All TAPs support a BYPASS instruction with a single bit data register.
- The way OpenOCD differentiates between TAP devices is by shifting different instructions into (and out of) their instruction registers.
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
