binphilxiao/AxisLabs/SC0101/2023.02_JigsRev.A_Manufacture/POGO-PIN MAP.xlsx

Pin Number(40 pins connector) | Signal Name(Pogo-pin Name)
1 | GND
2 | DET
3 | PWM
4 | MOTOR_EN
5 | GND
6 | FWD
7 | MOTOR_FG(J2-2)
8 | GND
9 | INTA
10 | INTB
11 | GND
12 | NC
13 | NC
14 | GND
15 | MFP1
16 | MFP2
17 | GND
18 | NC
19 | PULSE2
20 | PULSE1
21 | GND
22 | SWDIO(J1-1)
23 | SWCLK(J1-2)
24 | Nreset(J1-3)
25 | GND(J1-4)
26 | SWO(J1-6)
27 | V_MSP
28 | GND
29 | WTDIO(J5-1)
30 | WTCK(J5-2)
31 | GND(J5-4)
32 | V_ECD
33 | V_MOTOR
34 | GND
35 | V_BAT
36 | VREF2.5
37 | GND
38 | BAT_DIV
39 | THERMAL
40 | 3.3V
