binphilxiao/AxisLabs/SC0101/Certification/How to use SmartCurtain.md

打开RYSE app。



选择‘Add a SmartShade'



点击回退



选择’RYSE SmartCurtain'



选择通过蓝牙连接



按照app中提示按SmartCurtain上的放行按钮，并在app上点击方形按钮图像，使设备进入配对状态。



如果手机询问是否配对是选择‘pair and connect'

此界面会根据系统不同而不同，Pairing request可能跳出多层，都选择‘pair and connect'





配对完成后会显示绿色对勾，这个界面出现后需要等待十几秒，直到app提升输入设备名称。



输入设备名称



进入校准界面，选择第一种窗帘类型。



跳过窗帘安装说明



在下部出现’Machine State：01‘后，按左箭头几秒。



按照提示完成左窗框校准。



在下部出现’Machine State：02‘后，按右箭头几秒。



按照提示完成右窗框校准。





直到出现’Machine State：03‘后，按’next'进入下一步。





SmartCurtain连接和校准完成，设备出现在列表里，可以点击进入并进行控制。
