binphilxiao/AxisLabs/BLE0101/Docs/mac programing/BLE-0101 mac address program guide.md

#### Hardware set up:

#### Download nrf-command-line-tools from Nordic:

https://www.nordicsemi.com/Products/Development-tools/nrf-command-line-tools/download

#### Run 'cmd' on windows

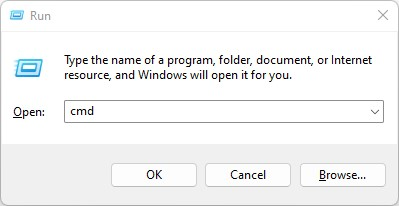
[picture p258: BLE0101/Docs/mac programing/img/run.jpg]


#### Erase UICR registers:

```
nrfjprog --eraseuicr
```

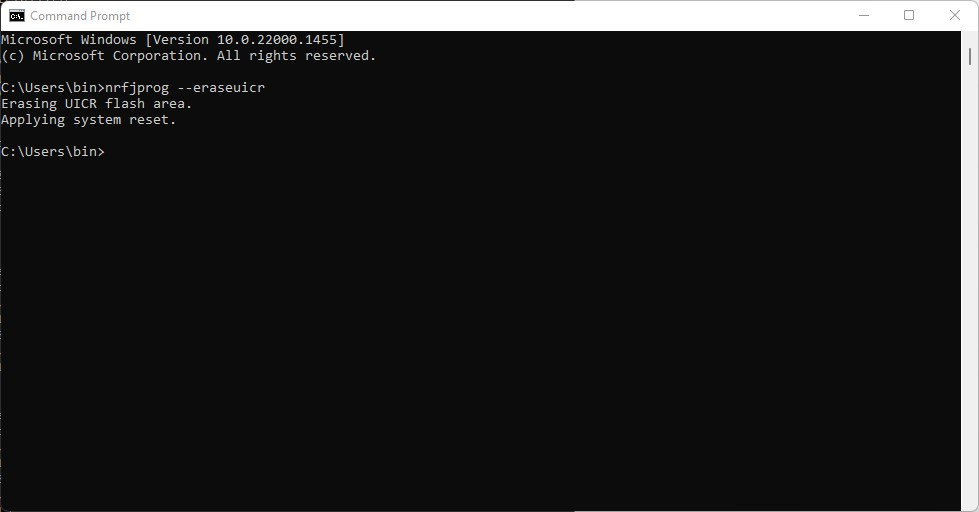
[picture p259: BLE0101/Docs/mac programing/img/erase.jpg]


#### Program MAC address by following commands:

```
nrfjprog --memwr 0x10001080 -f nrf52 --val 0xF021BCDE
nrfjprog --memwr 0x10001084 -f nrf52 --val 0xFFFFD016
# the MAC address D0:16:F0:21:BC:DE will be programmed, unused byte will be filled as 0XFF
```

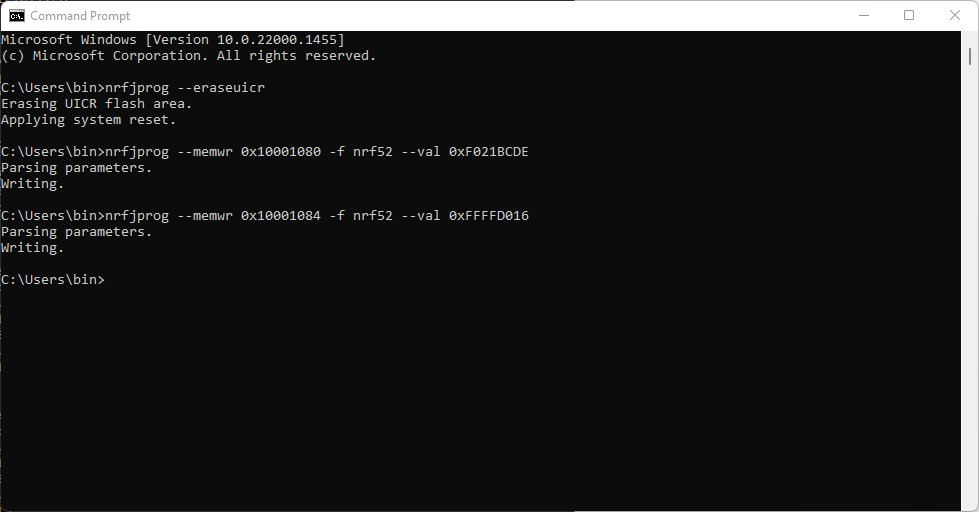
[picture p260: BLE0101/Docs/mac programing/img/program.jpg]


#### Check MAC address in BLE-0101 test firmware:

```
add
```

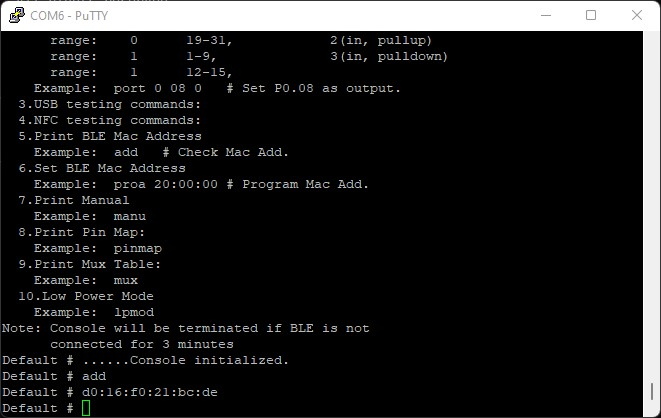
[picture p261: BLE0101/Docs/mac programing/img/check.jpg]
