binphilxiao/AxisLabs/BLE0101/Docs/mac programing/BLE-0101 mac address program guide.pdf

# Hardware set up:

# Download nrf-command-line-tools from Nordic:

## https://www.nordicsemi.com/Products/Development-tools/nrf-command-line-tools/download

# Run 'cmd' on windows


# Erase UICR registers:


# Program MAC address by following commands:

nrfjprog --eraseuicr

nrfjprog --memwr 0x10001080 -f nrf52 --val 0xF021BCDE
nrfjprog --memwr 0x10001084 -f nrf52 --val 0xFFFFD016
# the MAC address D0:16:F0:21:BC:DE will be programmed, unused byte will be

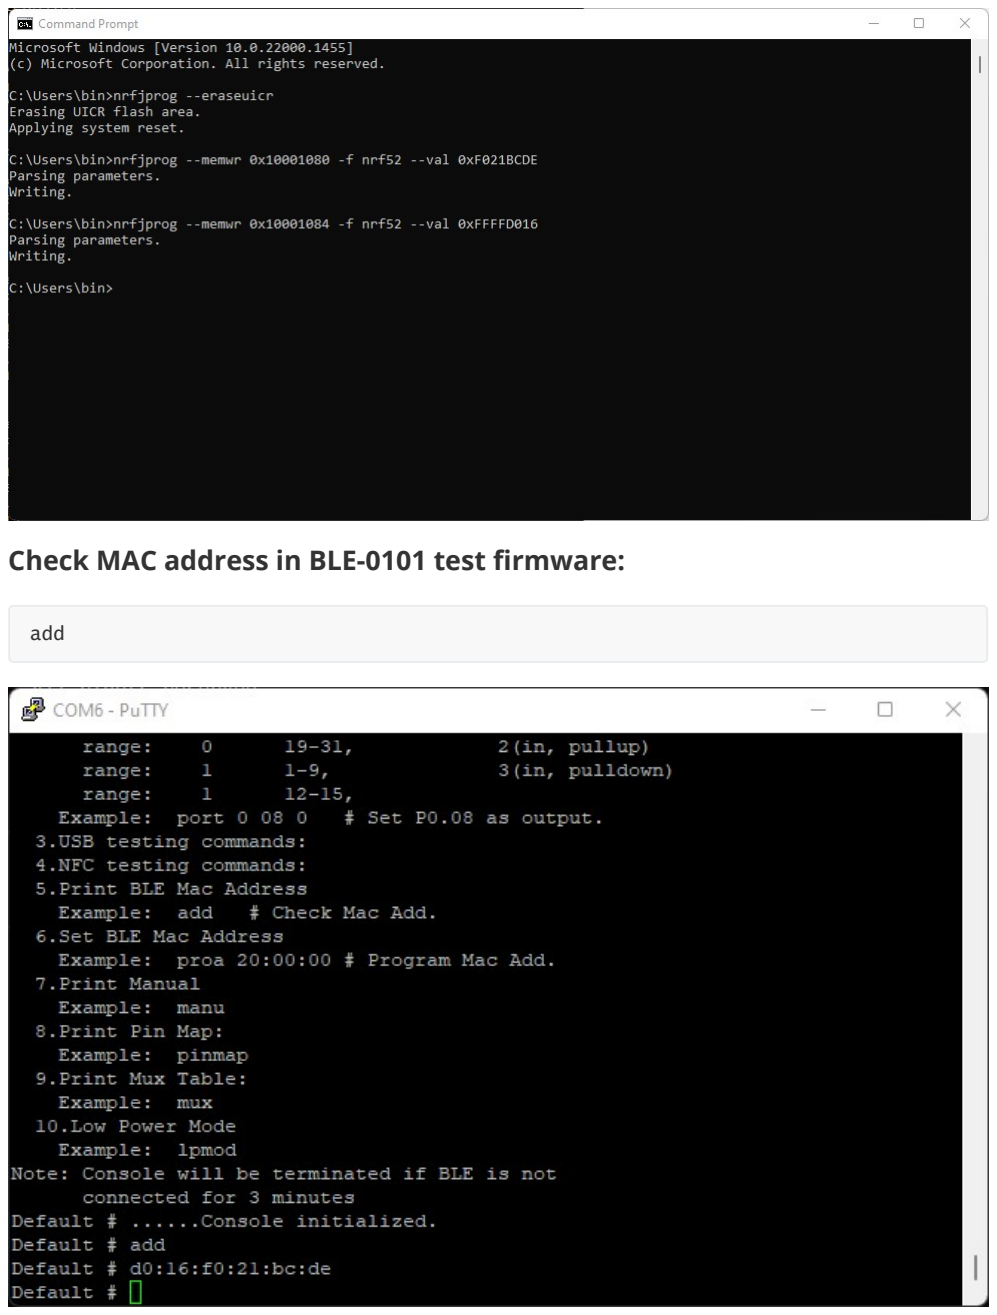
[picture p266: page 2]

# Check MAC address in BLE-0101 test firmware:

add
