binphilxiao/AxisLabs/ZW0101/2024.08-ZwaveTestJig/doc/Z-WAVE-POGO-PIN MAP.xlsx

Pin Number(40 pins connector) | Signal Name(Pogo-pin Name)
1 | GND
2 | NC
3 | NC
4 | NC
5 | GND
6 | NC
7 | NC
8 | GND
9 | NC
10 | NC
11 | GND
12 | NC
13 | NC
14 | GND
15 | MFP1_IN
16 | MFP1_OUT
17 | GND
18 | NC
19 | MFP2_IN
20 | MFP2_OUT
21 | GND
22 | SWDIO
23 | SWCLK
24 | RST
25 | GND
26 | SWO
27 | VCC
28 | GND
29 | NC
30 | NC
31 | GND
32 | NC
33 | 12V
34 | GND
35 | 12V
36 | NC
37 | GND
38 | NC
39 | NC
40 | 3.3V
