binphilxiao/AxisLabs/GB0102/AWG26 THERMAL TEST/AWG26 x 2 2A电流温度测试报告.pdf

## AWG26 x 2 2A电流温度测试报告

### 实验环境

将两根5cm左右长度的AWG26线缆并联在一起，并将温度测试探针附着在线缆绝缘皮表面。使用直流电 源供电，使2A电流通过并联线缆，并测量线缆表面温度。

### 实验图表

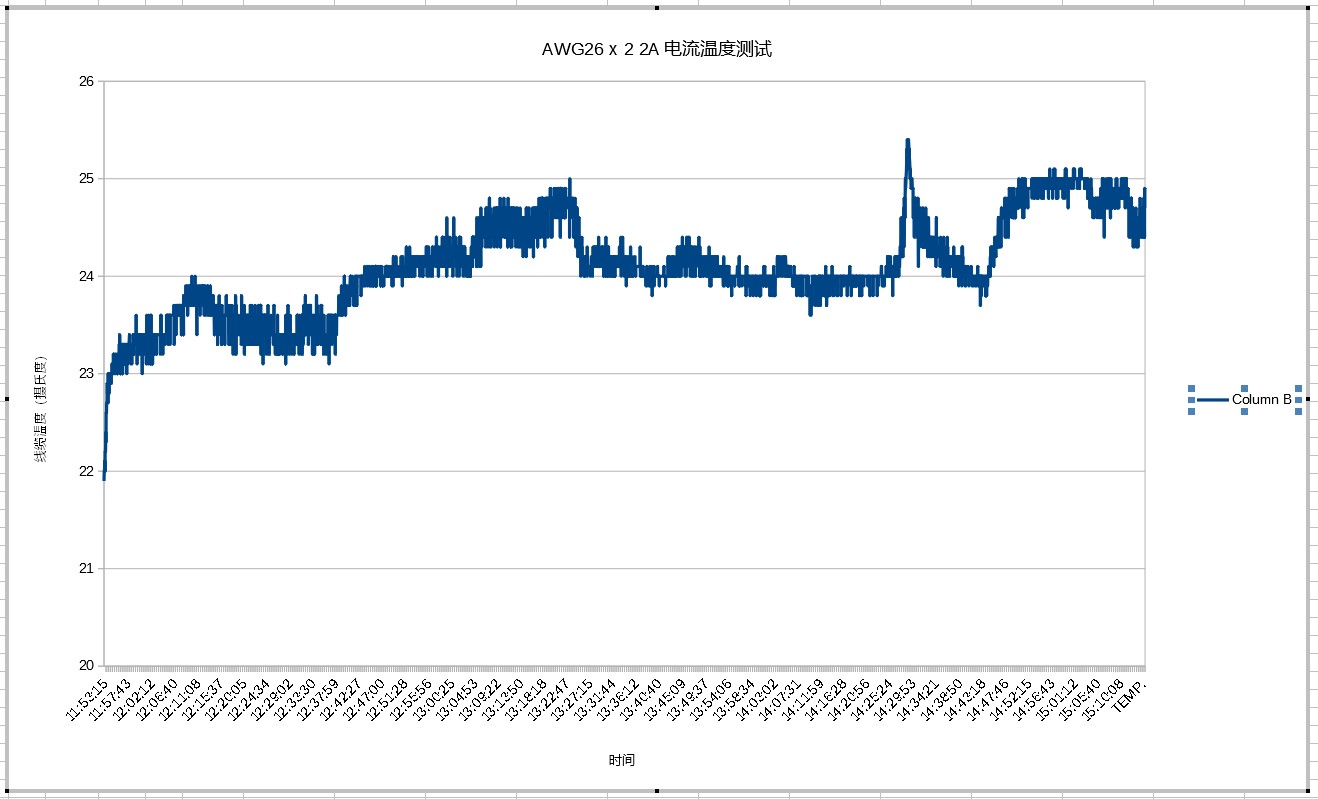
[picture p270: figure]

### 实验数据

见：74033003.CSV
