binphilxiao/AxisLabs/GR0101/052350-9/Docs/Interview/Result.JPG

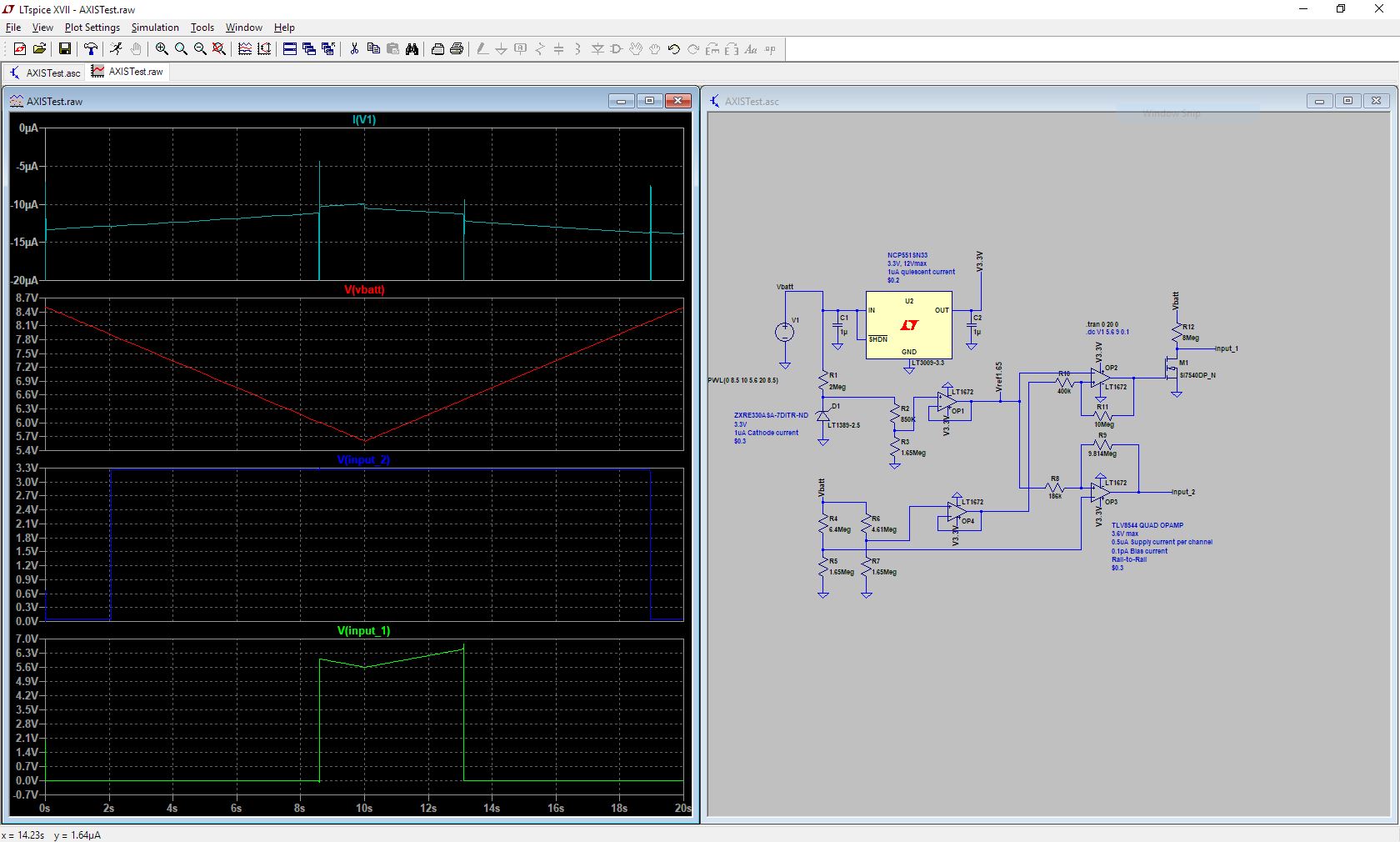
GR0101/052350-9/Docs/Interview/Result.JPG
