binphilxiao/AxisLabs/NW0101/Docs/Certification/HardwareTest/NW0101_onBridge_withoutR25.jpg

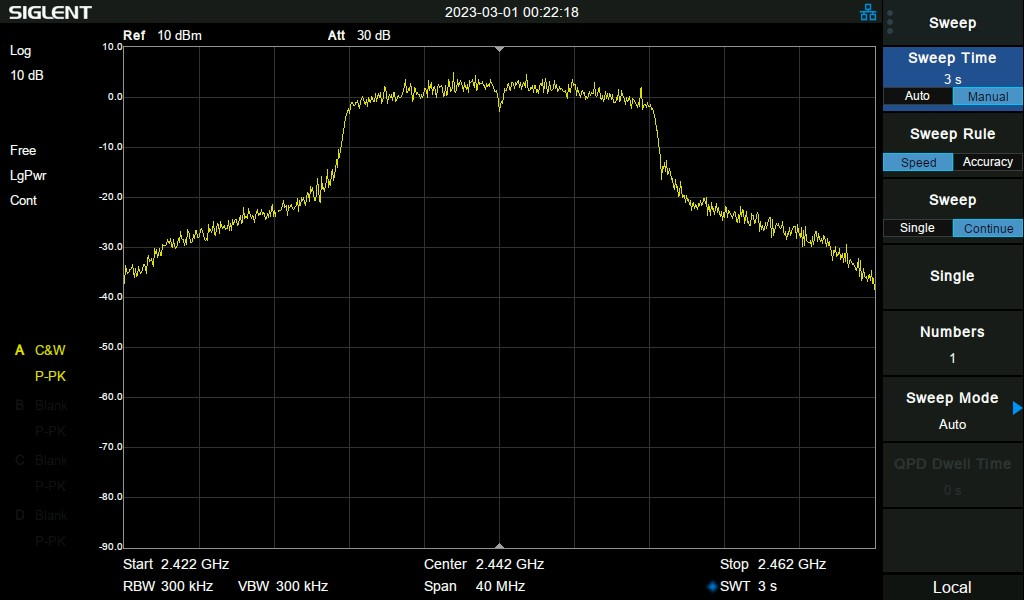
NW0101/Docs/Certification/HardwareTest/NW0101_onBridge_withoutR25.jpg
