binphilxiao/AxisLabs/NW0101/Docs/Certification/HardwareTest/NW0101_onBridge_withoutTerminal.jpg

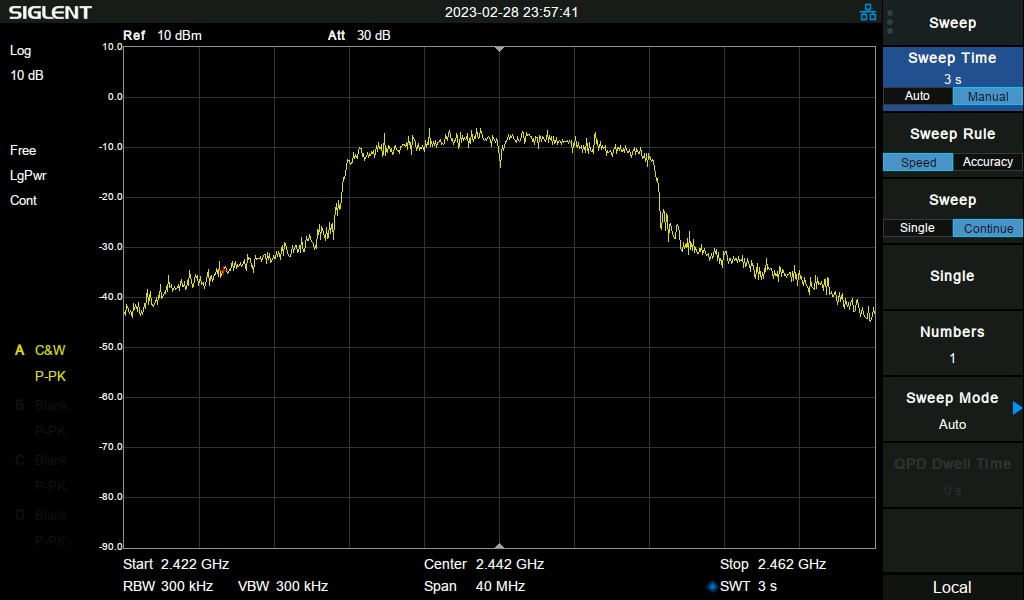
NW0101/Docs/Certification/HardwareTest/NW0101_onBridge_withoutTerminal.jpg
