binphilxiao/AxisLabs/ZW0101/2024.08-ZwaveTestJig/doc/PinMap.jpg

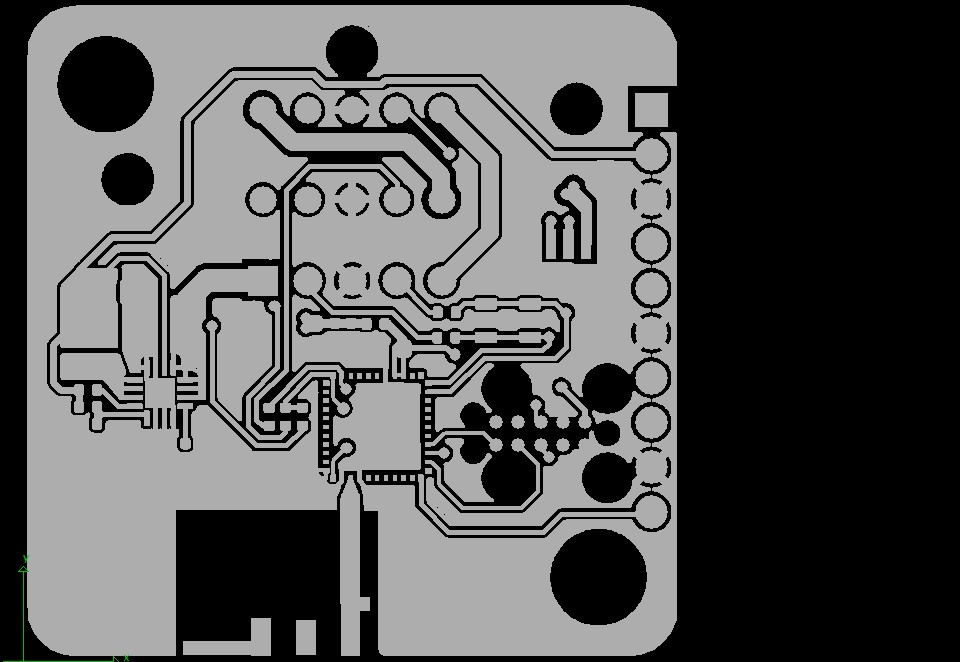
ZW0101/2024.08-ZwaveTestJig/doc/PinMap.jpg
