binphilxiao/AxisLabs/RC0101&DC0101/issues.txt

use mosfet to turn on LEDs,  use green LED instead
