binphilxiao/AxisLabs/NW0101/2022.09_ProgramingJigRev.B_Manufacture/issue.txt

1. short vdd_flash to 3.3v
2. add switch to SPI bus
