binphilxiao/AxisLabs/GR0101/052357-9/ChangeLog.txt

Rev A
12/21/2.18 11:22:37 AM 
SHA-1: 212a12f412ab8d9ca19c3d87cec7d33293b3f445

Rev B
1. U1, U2 pinout error
2. U1, U2 Location error, too far from the wheel.
3. U1, U2 change to DRV5011ADDBZR from TI
	Latch Hall effect sensor
	North Pole, South Pole
	Can work under 3.3V & 5V
	Push-Pull or CMOS output
	SOT-23-3 package
4. Move Uart from P1.2,P1.3 to P1.6,P1.7
