binphilxiao/AxisLabs/GR0101/TestJigShield/ChangeLog.txt

Rev: D
	1. bypass cap is not grounded
	2. J11, J12 signal marking error
	3. Don't use power TVS

Rev: E
12/21/2.18 11:22:37 AM 
SHA-1: 212a12f412ab8d9ca19c3d87cec7d33293b3f445
	1. Fixed errors in RevD
	2. Add Current measurment in TP12
	3. R2,R3,R4 from 5k to 100k
	4. pin5 on J6 from 3.3v to nc

Rev: F
	1. J13 backward
