binphilxiao/AxisLabs/GR0101/052355-9/ChangeLog.txt

Rev G
12/21/2.18 11:22:37 AM 
SHA-1: 212a12f412ab8d9ca19c3d87cec7d33293b3f445
	1. add 5 contacts
