binphilxiao/AxisLabs/GB0102/2025.02_Rev.E_Manufacture/GB0102_RevE_SCH.pdf

D

6 | 5 | 4 | 3 | 2 | 1

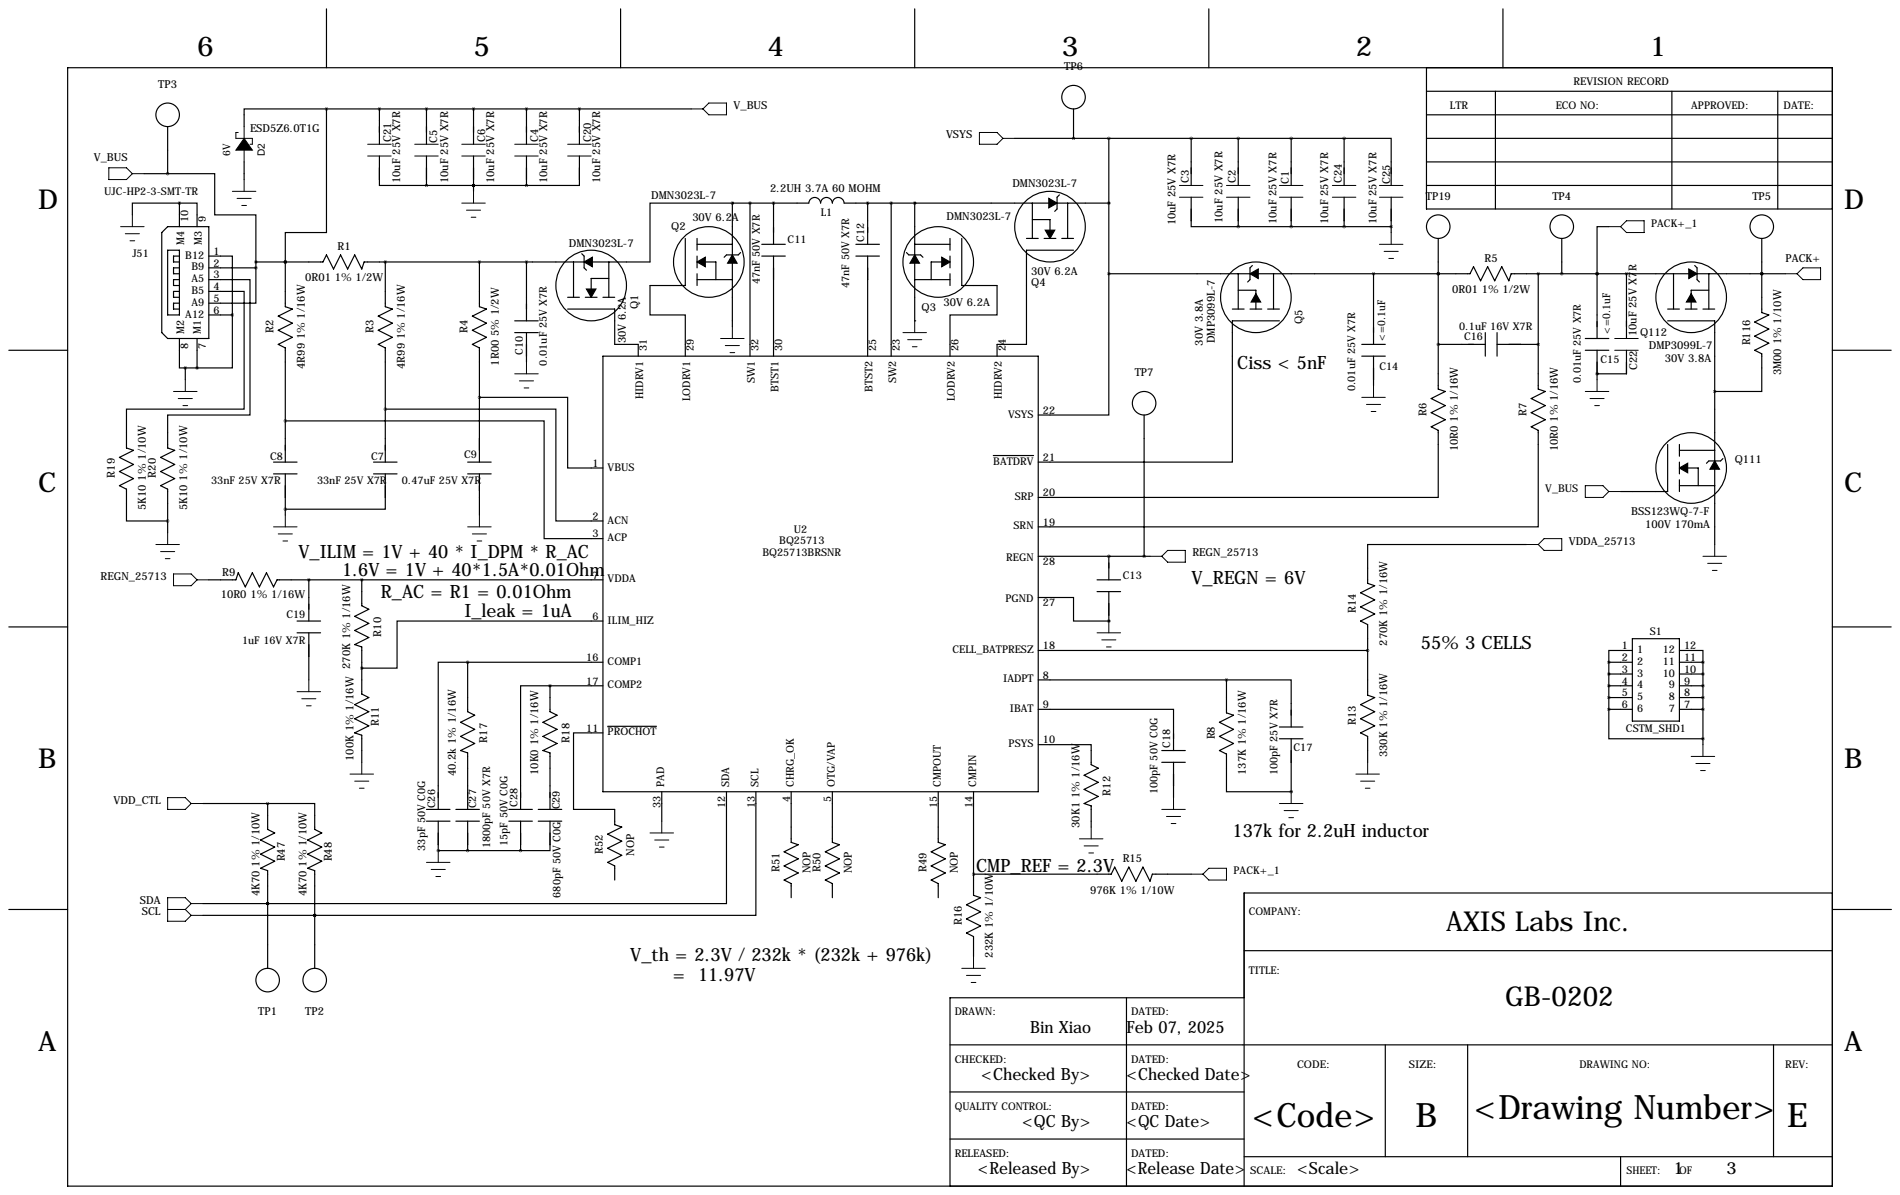
[picture p275: page 1]

TP3 | REVISION RECORD

LTR | ECO NO: | APPROVED: | DATE:

PACK+_1

DRAWN: Bin Xiao | DATED: Feb 07, 2025
CHECKED: <Checked By> | DATED: <Checked Date> | CODE: <Code> | SIZE: B | DRAWING NO: <Drawing Number> | REV: E

QUALITY CONTROL: <QC By> | DATED: <QC Date>

RELEASED: <Released By> | DATED: <Release Date>

<Scale> SCALE: | 1 3 SHEET: OF

D

D

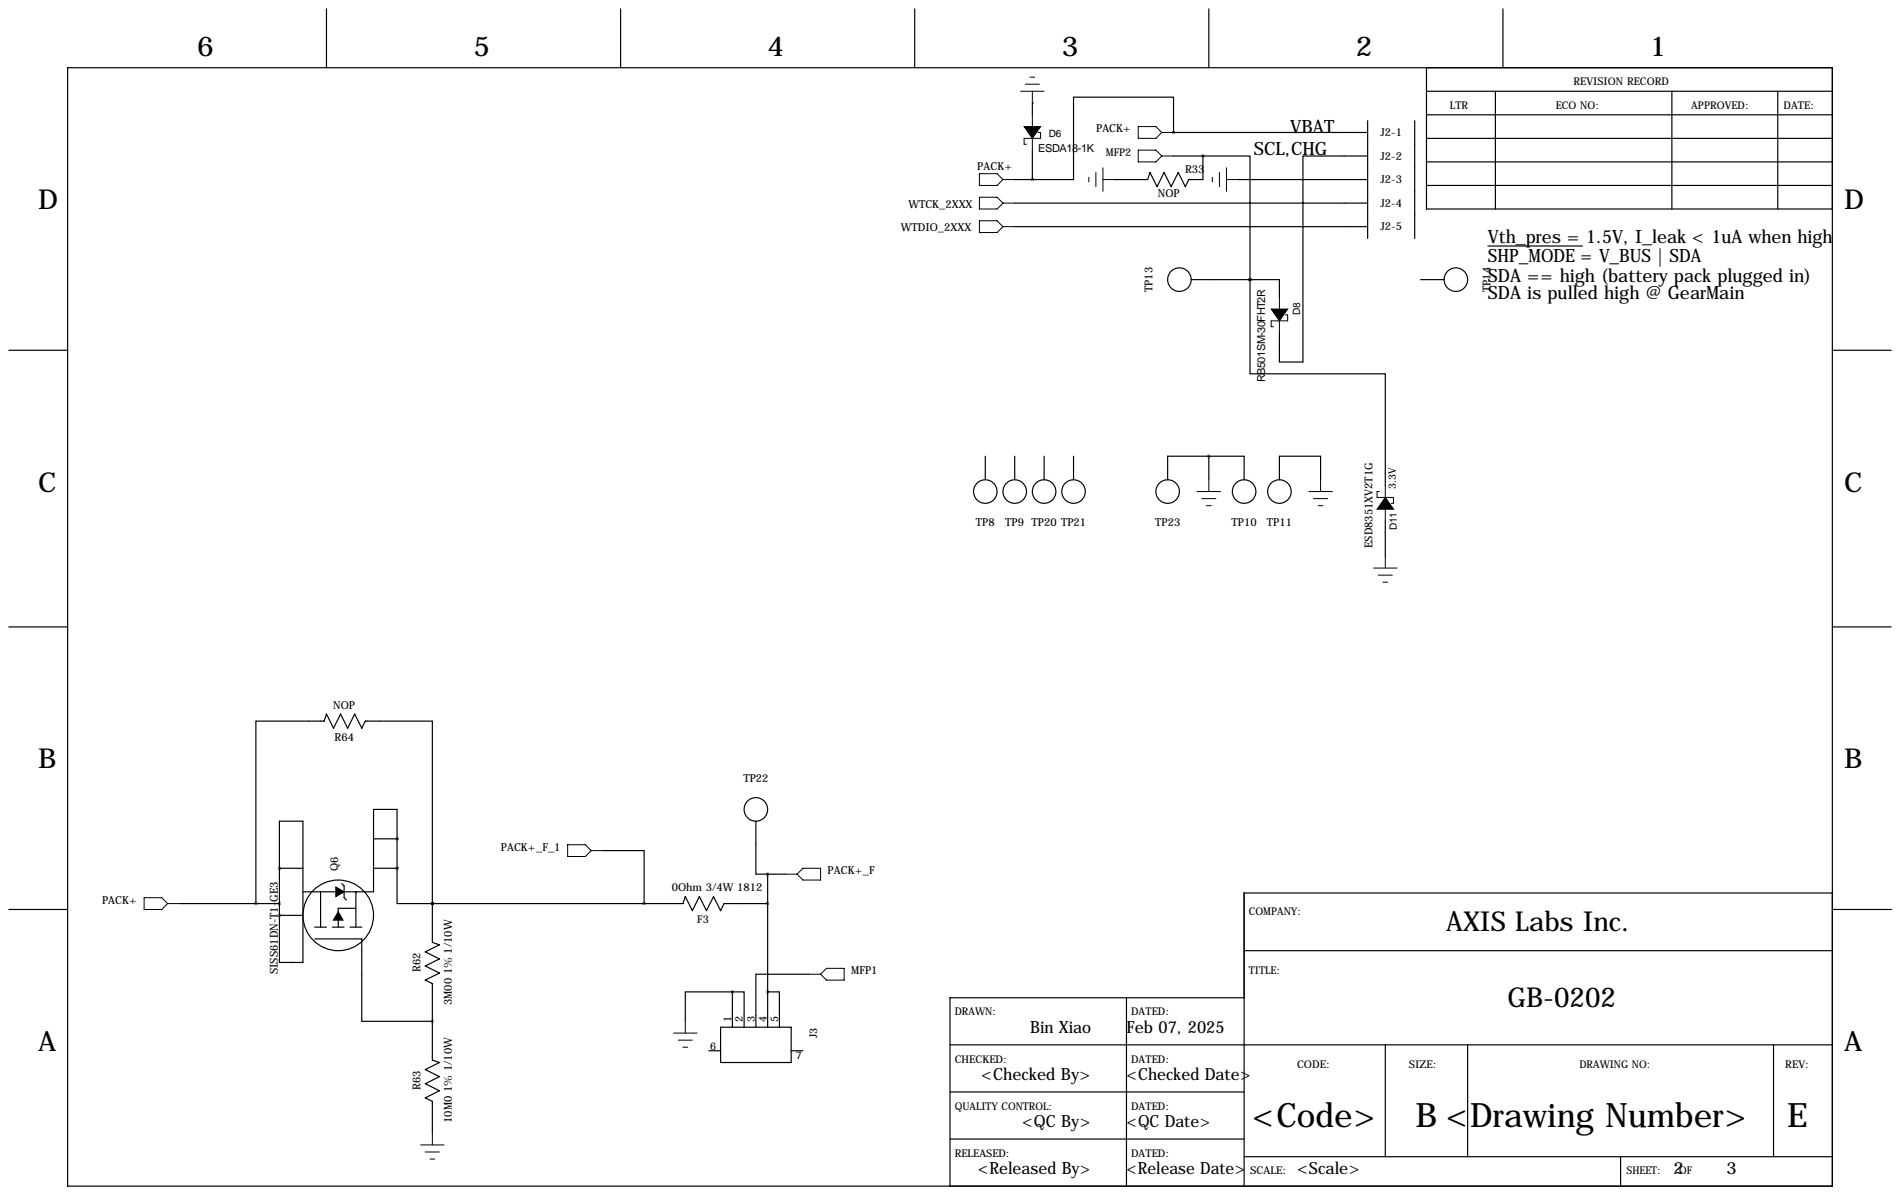
[picture p276: page 2]

REVISION RECORD

LTR | ECO NO: | APPROVED: | DATE:

Vth_pres = 1.5V, I_leak < 1uA when high
SHP_MODE = V_BUS | SDA
SDA == high (battery pack plugged in)
SDA is pulled high @ GearMain

DRAWN: Bin Xiao | DATED: Feb 07, 2025
CHECKED: <Checked By> | DATED: <Checked Date> | CODE: <Code> | SIZE: B <Drawing Number> | DRAWING NO: | REV: E

QUALITY CONTROL: <QC By> | DATED: <QC Date>

D

D

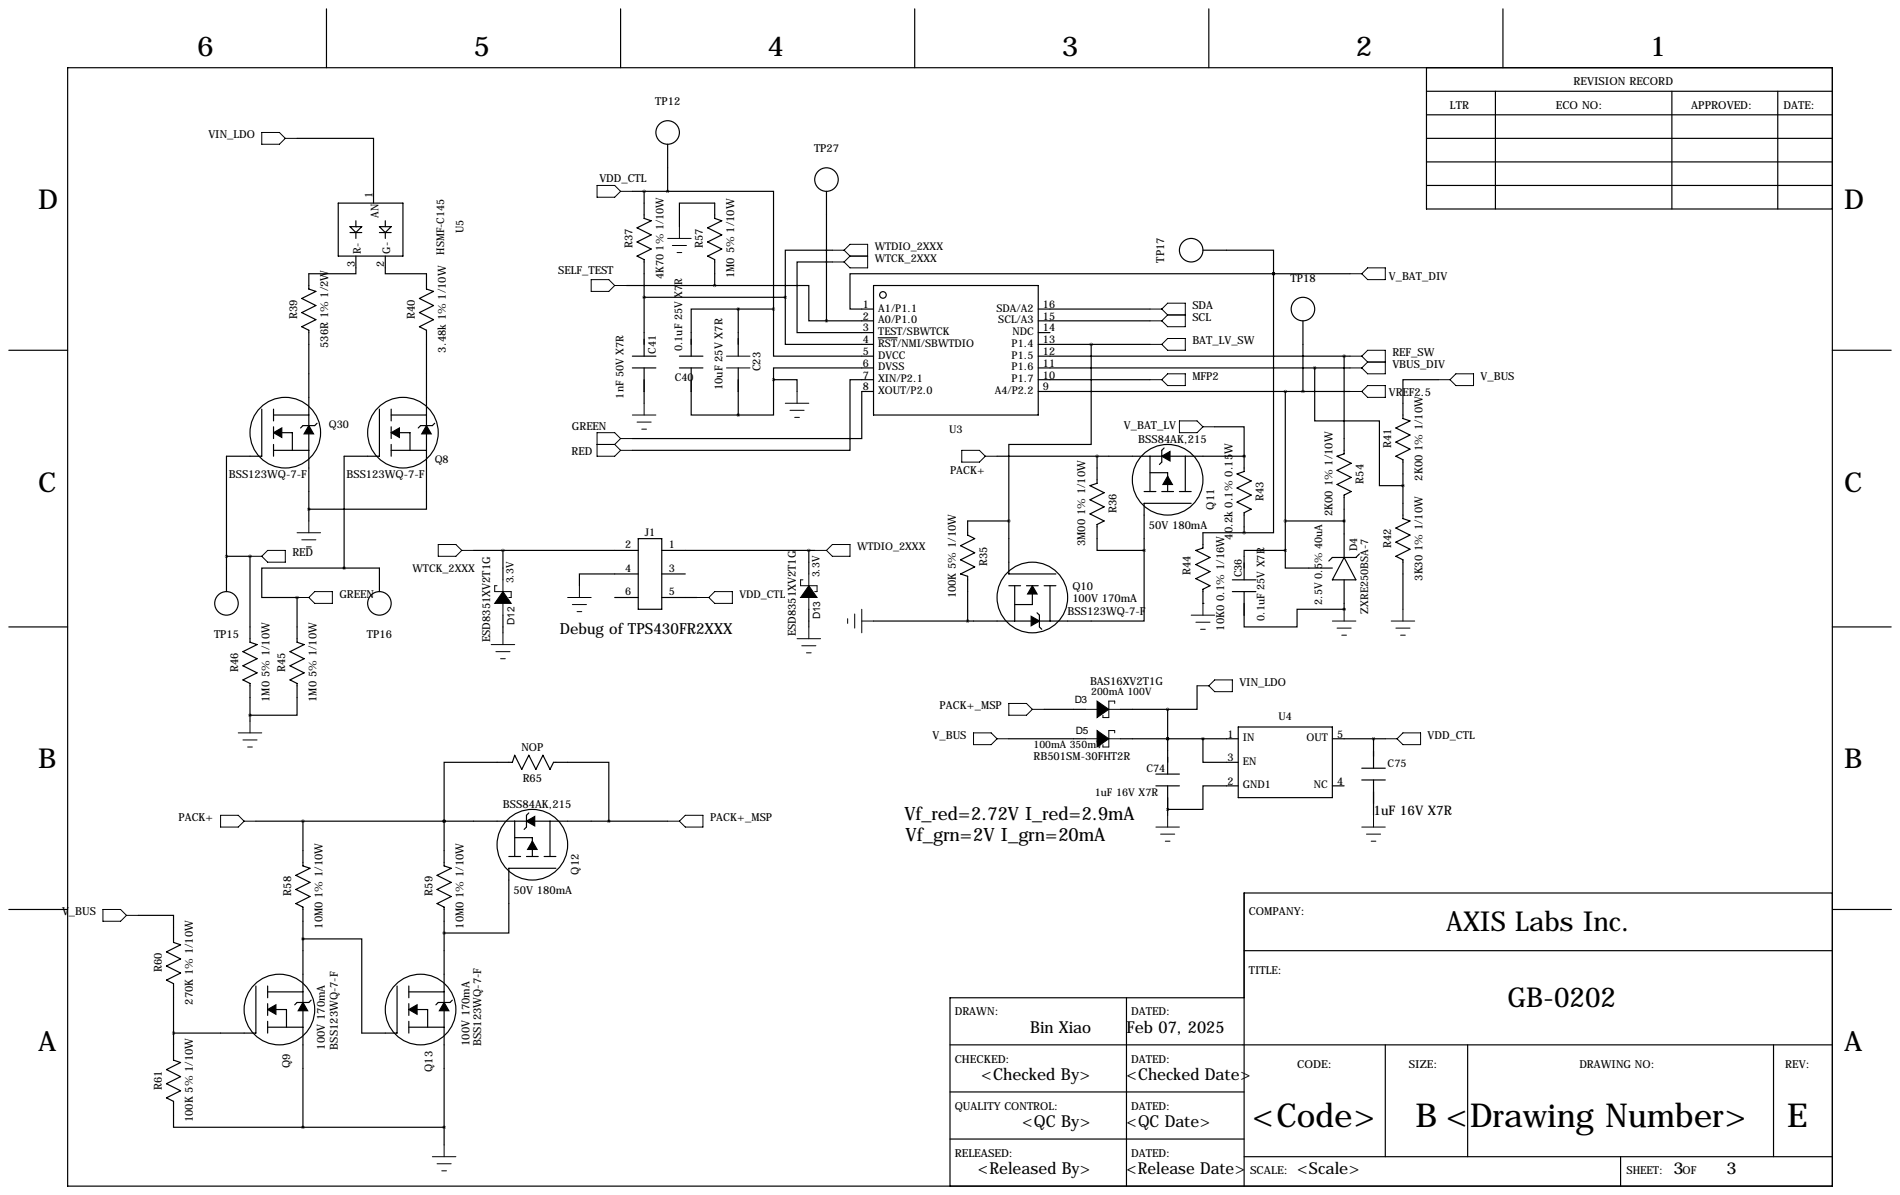
[picture p277: page 3]

REVISION RECORD

LTR | ECO NO: | APPROVED: | DATE:

DRAWN: Bin Xiao | DATED: Feb 07, 2025

CHECKED: <Checked By> | DATED: <Checked Date> | CODE: <Code> | SIZE: B <Drawing Number> | DRAWING NO: | REV: E

QUALITY CONTROL: <QC By> | DATED: <QC Date>
