binphilxiao/AxisLabs/NW0101/2022.07_Rev.B&C_Manufacture/NetworkModule.pdf

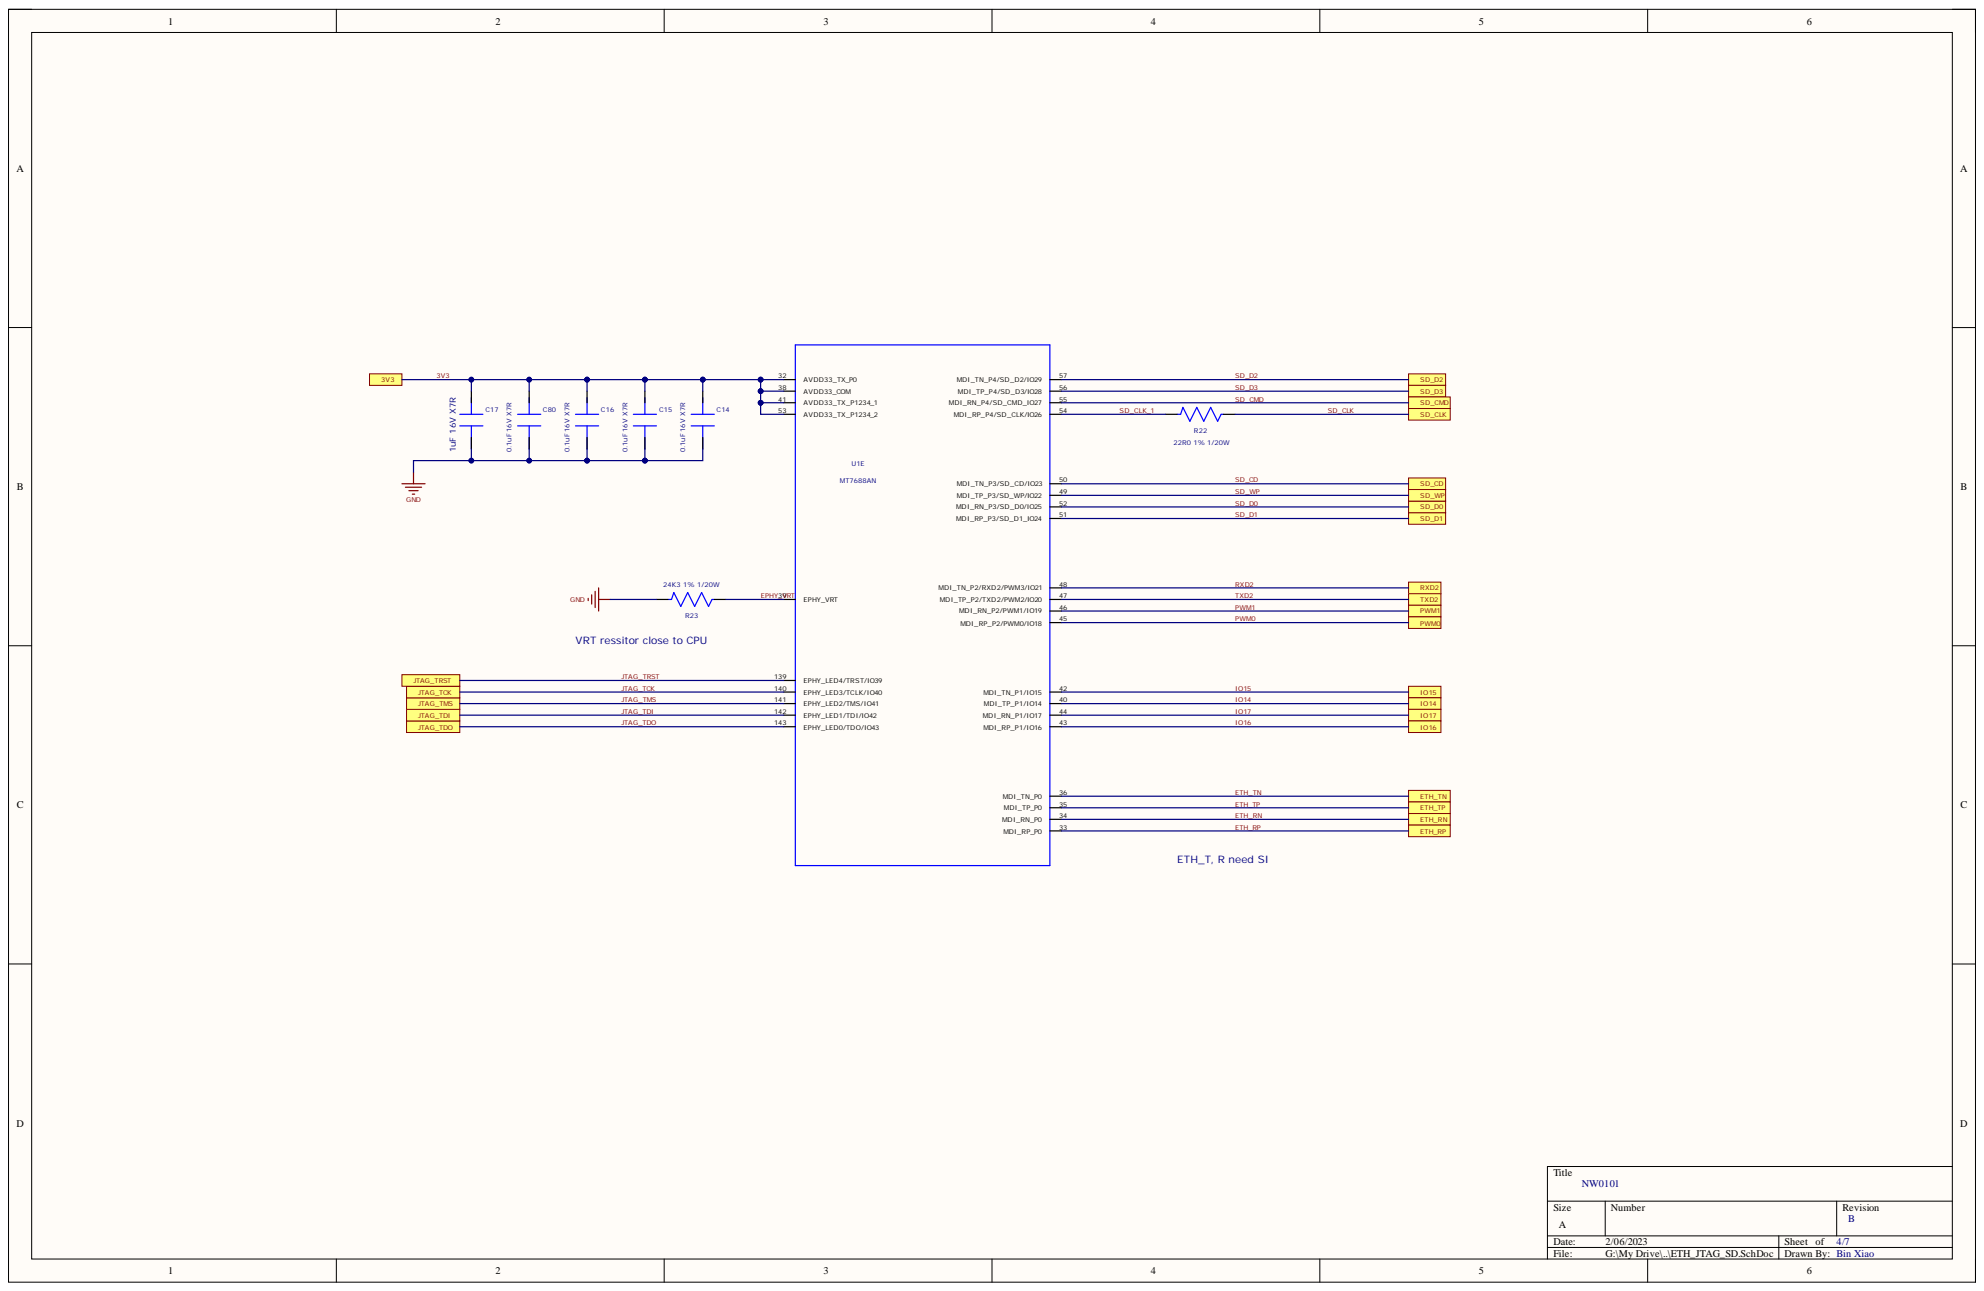
[picture p281: page 1]

JT A G_T R S T | JT A G_T C K
JT A G_T C K JT A G_T MS | JT A G_T MS JT A G_T D I | I O 1 4 I O 1 7 | I O 1 5 I O 1 4

e : 2 / 0 6 / 2 0 2 3 | S h e e t o f 4 /7
Fi l e : G : \My D r i v e \ . . \ E T H _ J TA G_ S D . S c h D o c | D r a w n B y : B i n X i a o

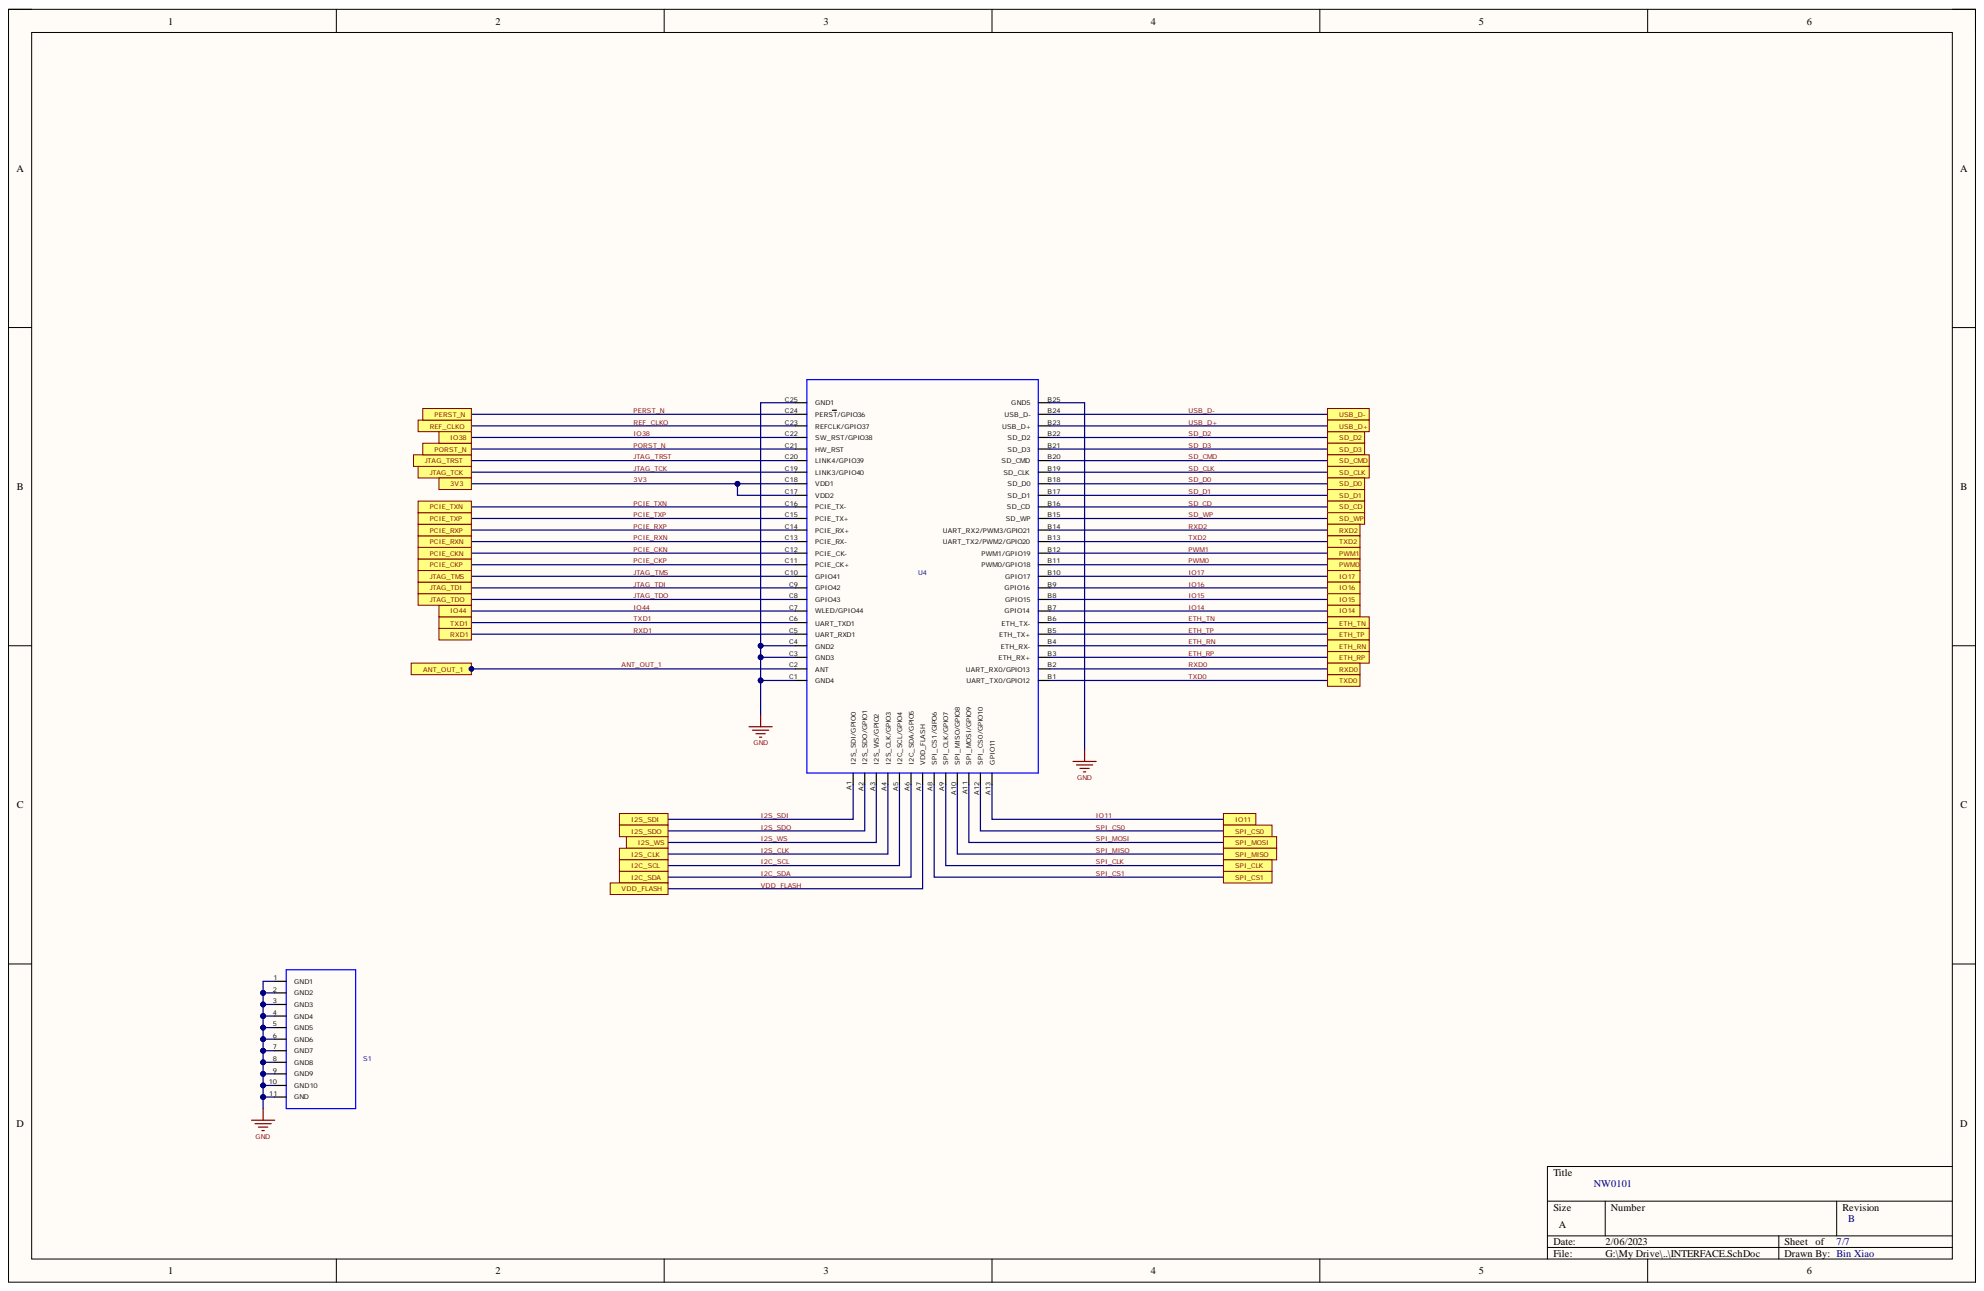
[picture p282: page 2]

PER S T _ N REF_C L K O | REF_C L K O I O 3 8 | C23 C22 | B23 B22 | US B_D + S D _ D 2 | US B_D -US B_D +

I2S_S D I | I2S_S D O | S P I_C S 0 | I O 1 1
I2S_S D O I2S_W S | I2S_W S I2S_C L K | S P I_MO S I S P I_M I S O | S P I_C S 0 S P I_MO S I

e : 2 / 0 6 / 2 0 2 3 | S h e e t o f 7 /7
Fi l e : G : \My D r i v e \ . . \ IN T E R FA C E . S c h D o c | D r a w n B y : B i n X i a o

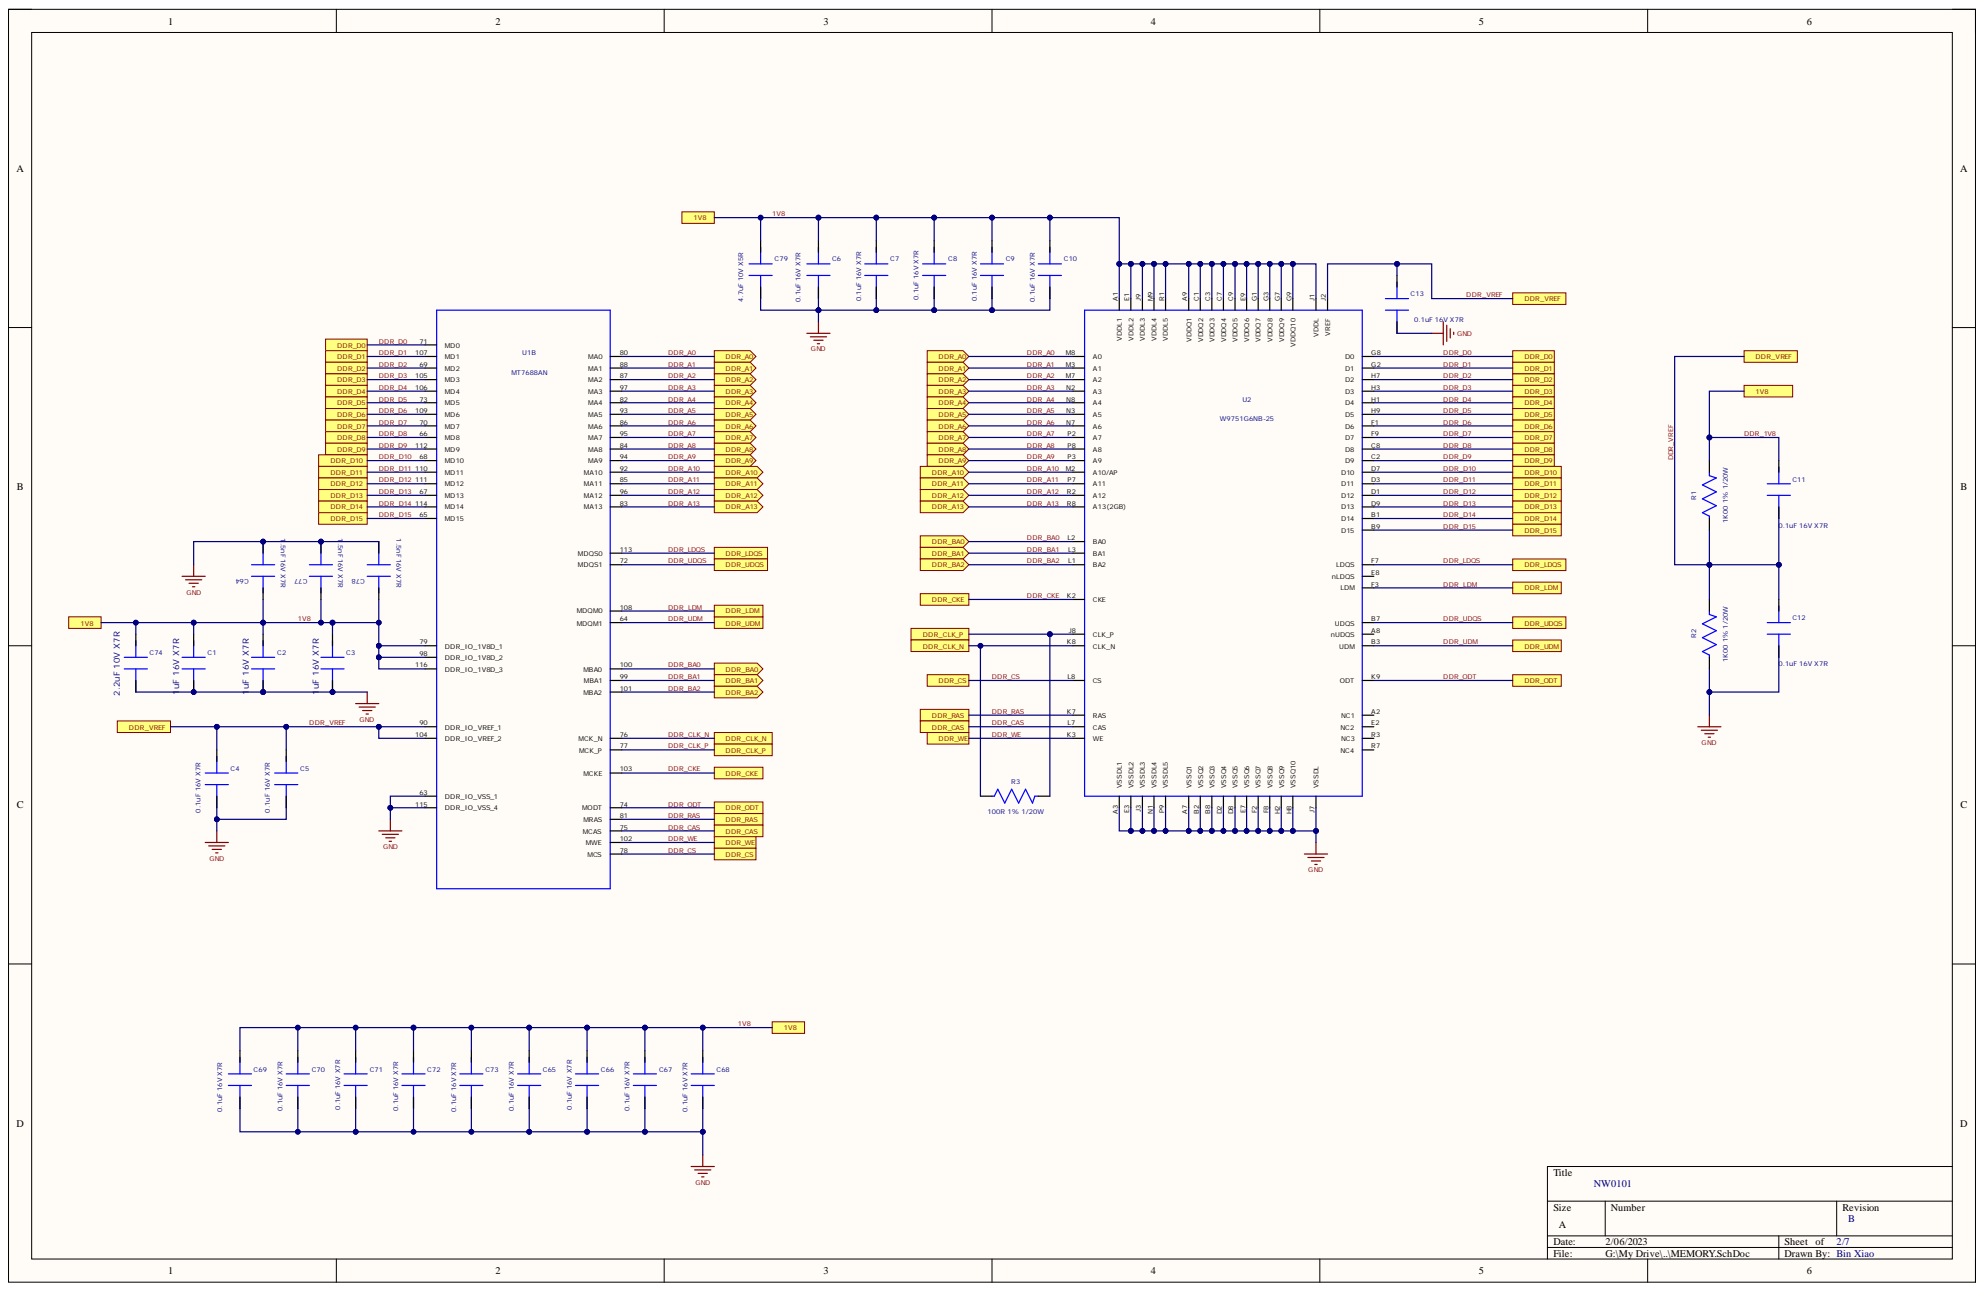
[picture p283: page 3]

e : 2 / 0 6 / 2 0 2 3 | S h e e t o f 2 /7
Fi l e : G : \My D r i v e \ . . \MEMO RY. S c h D o c | D r a w n B y : B i n X i a o

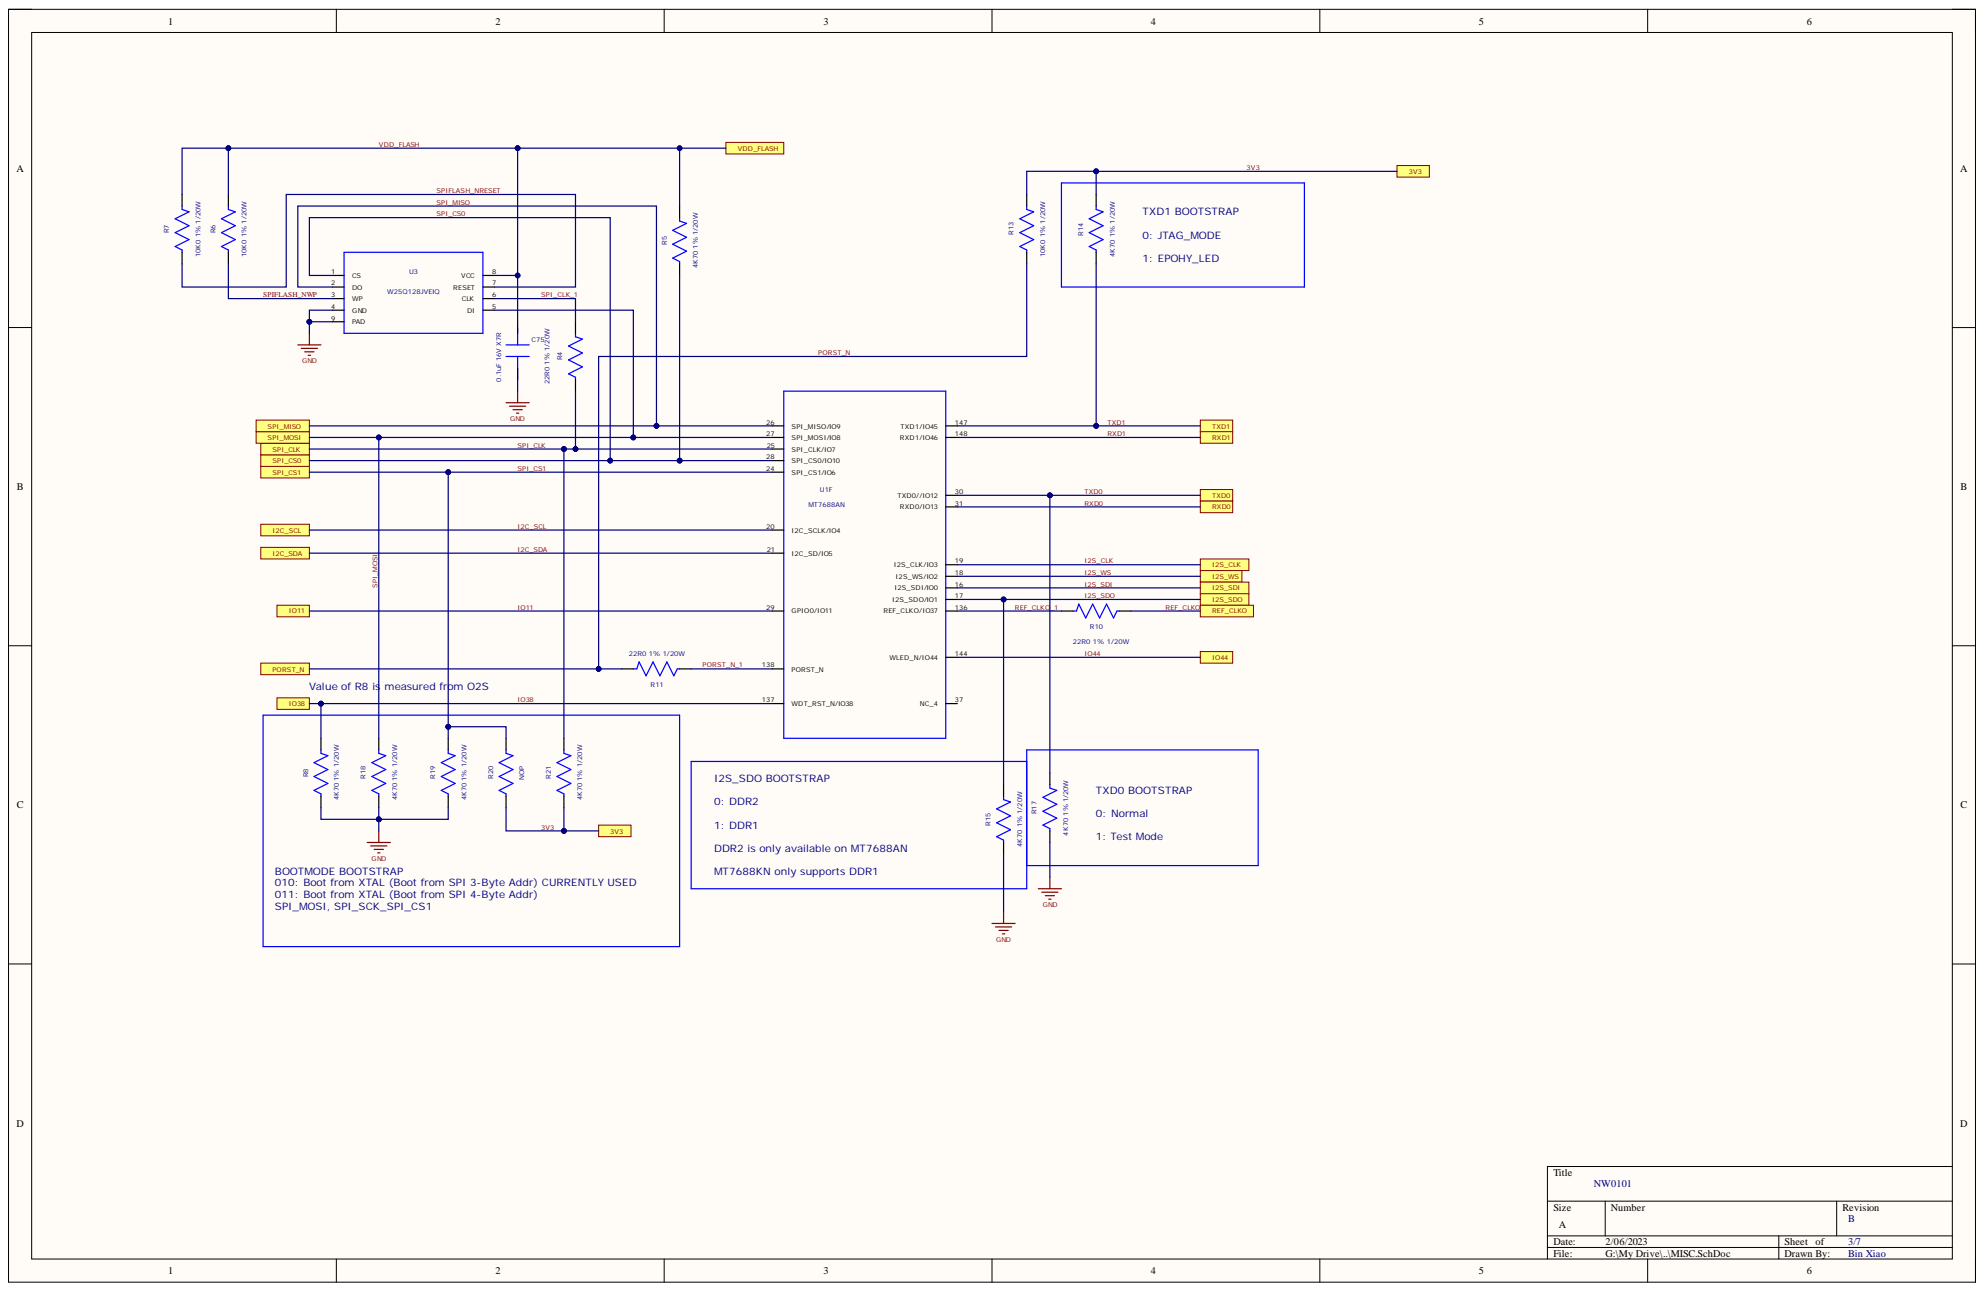
[picture p284: page 4]

SPIFLASH_NRESET

SPI_MISO
SPI_CS0

SPI_CS0 | SPI_CS1 | | SPI_CS0/IO10 28 SPI_CS1/IO6 24

SPI_CS1 | | I2C_SCL | | I2C_SCLK/IO4 20

Value of R8 is measured from O2S

DDR2 is only available on MT7688AN

BOOTMODE BOOTSTRAP
010: Boot from XTAL (Boot from SPI 3-Byte Addr) CURRENTLY USED
011: Boot from XTAL (Boot from SPI 4-Byte Addr)
SPI_MOSI, SPI_SCK_SPI_CS1

Size A | Number | Revision B

Date: 2/06/2023 | Sheet of 3/7
File: G:\My Drive\..\MISC.SchDoc | Drawn By: Bin Xiao

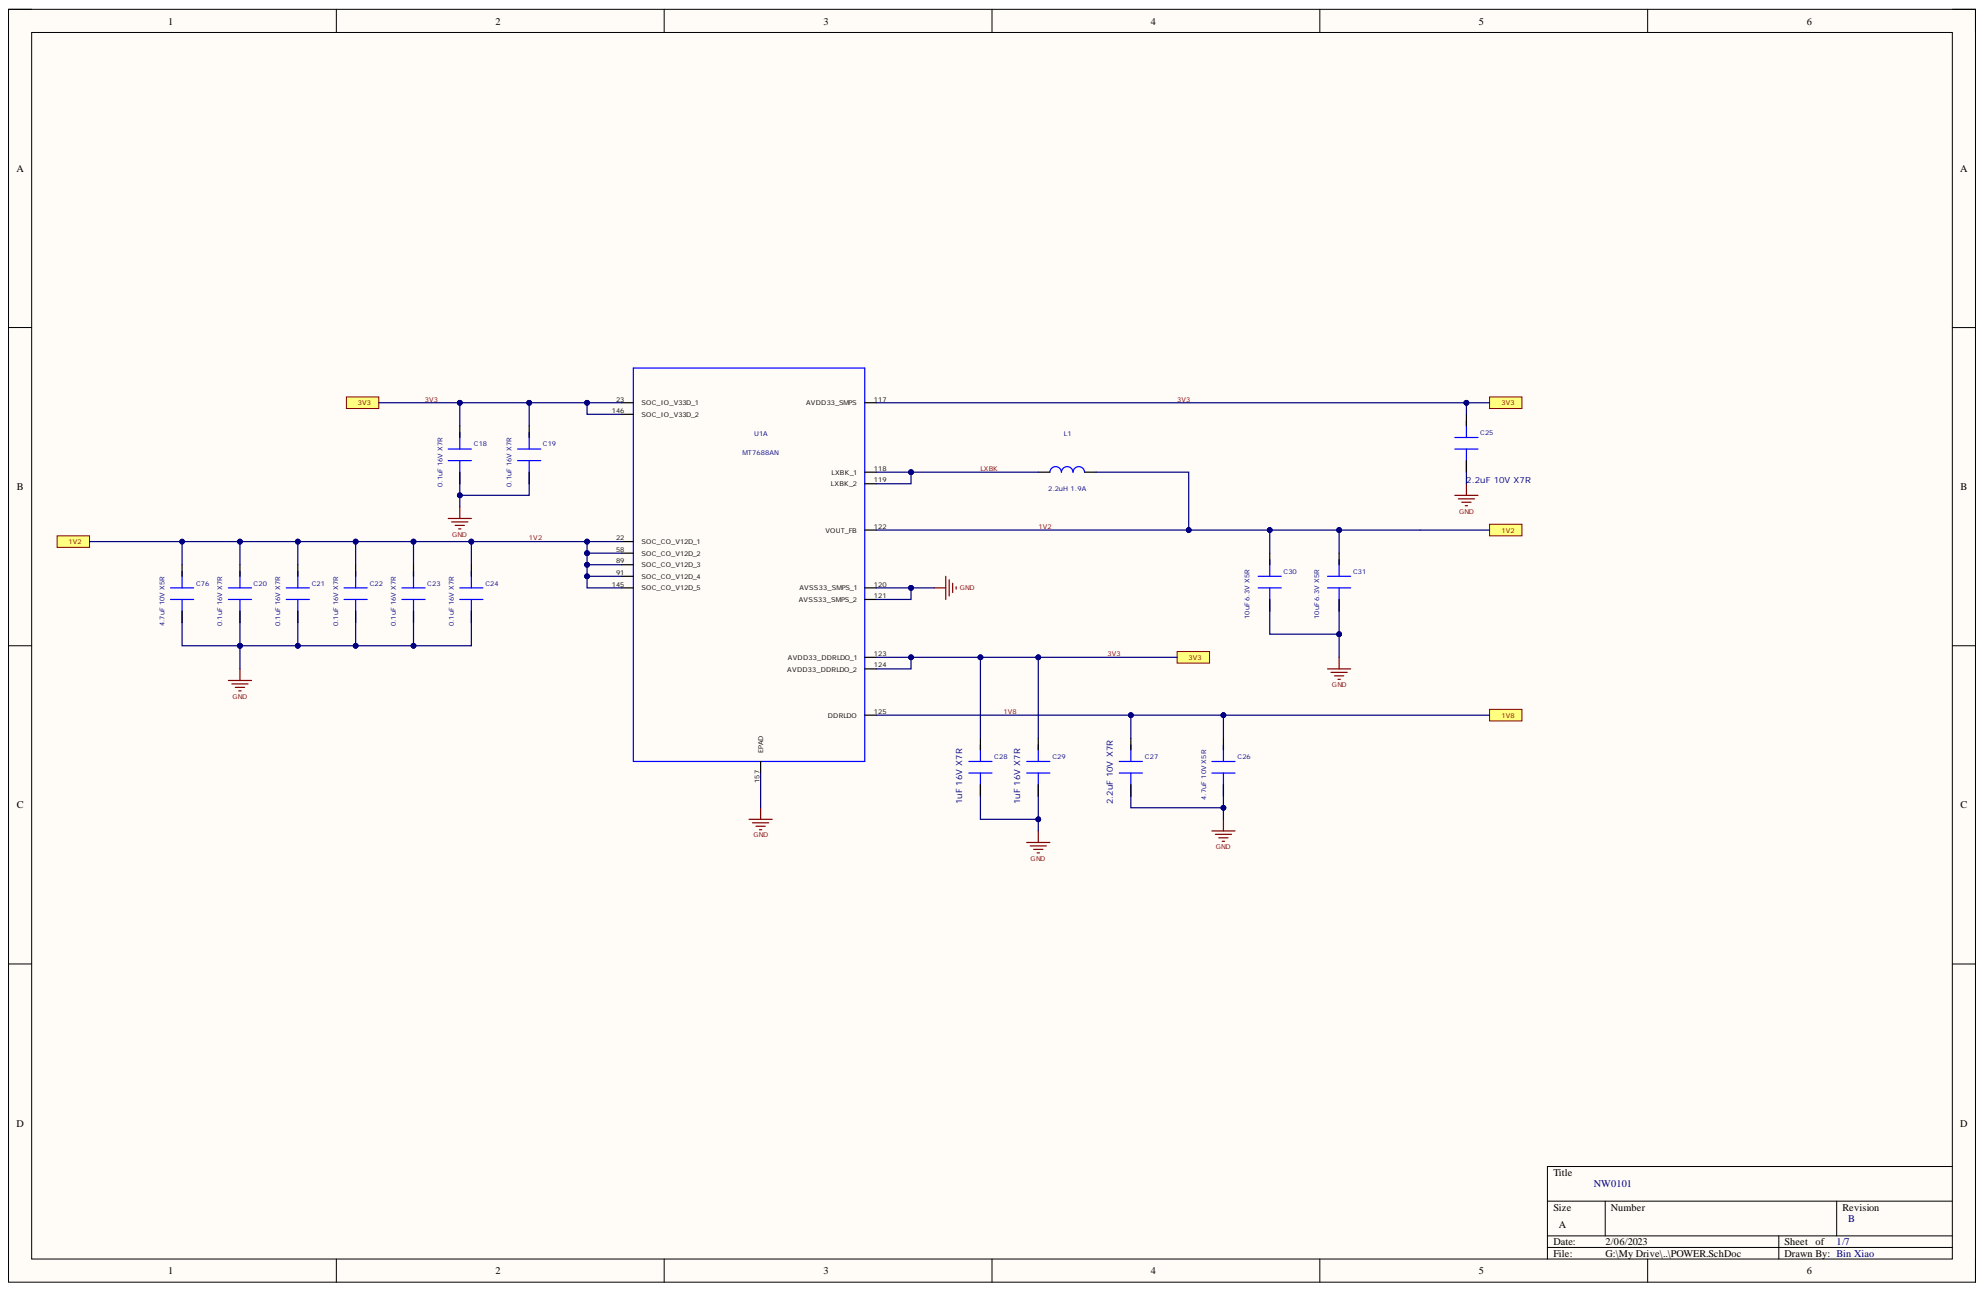
[picture p285: page 5]

e : 2 / 0 6 / 2 0 2 3 | S h e e t o f 1 /7
Fi l e : G : \My D r i v e \ . . \ P OWE R . S c h D o c | D r a w n B y : B i n X i a o

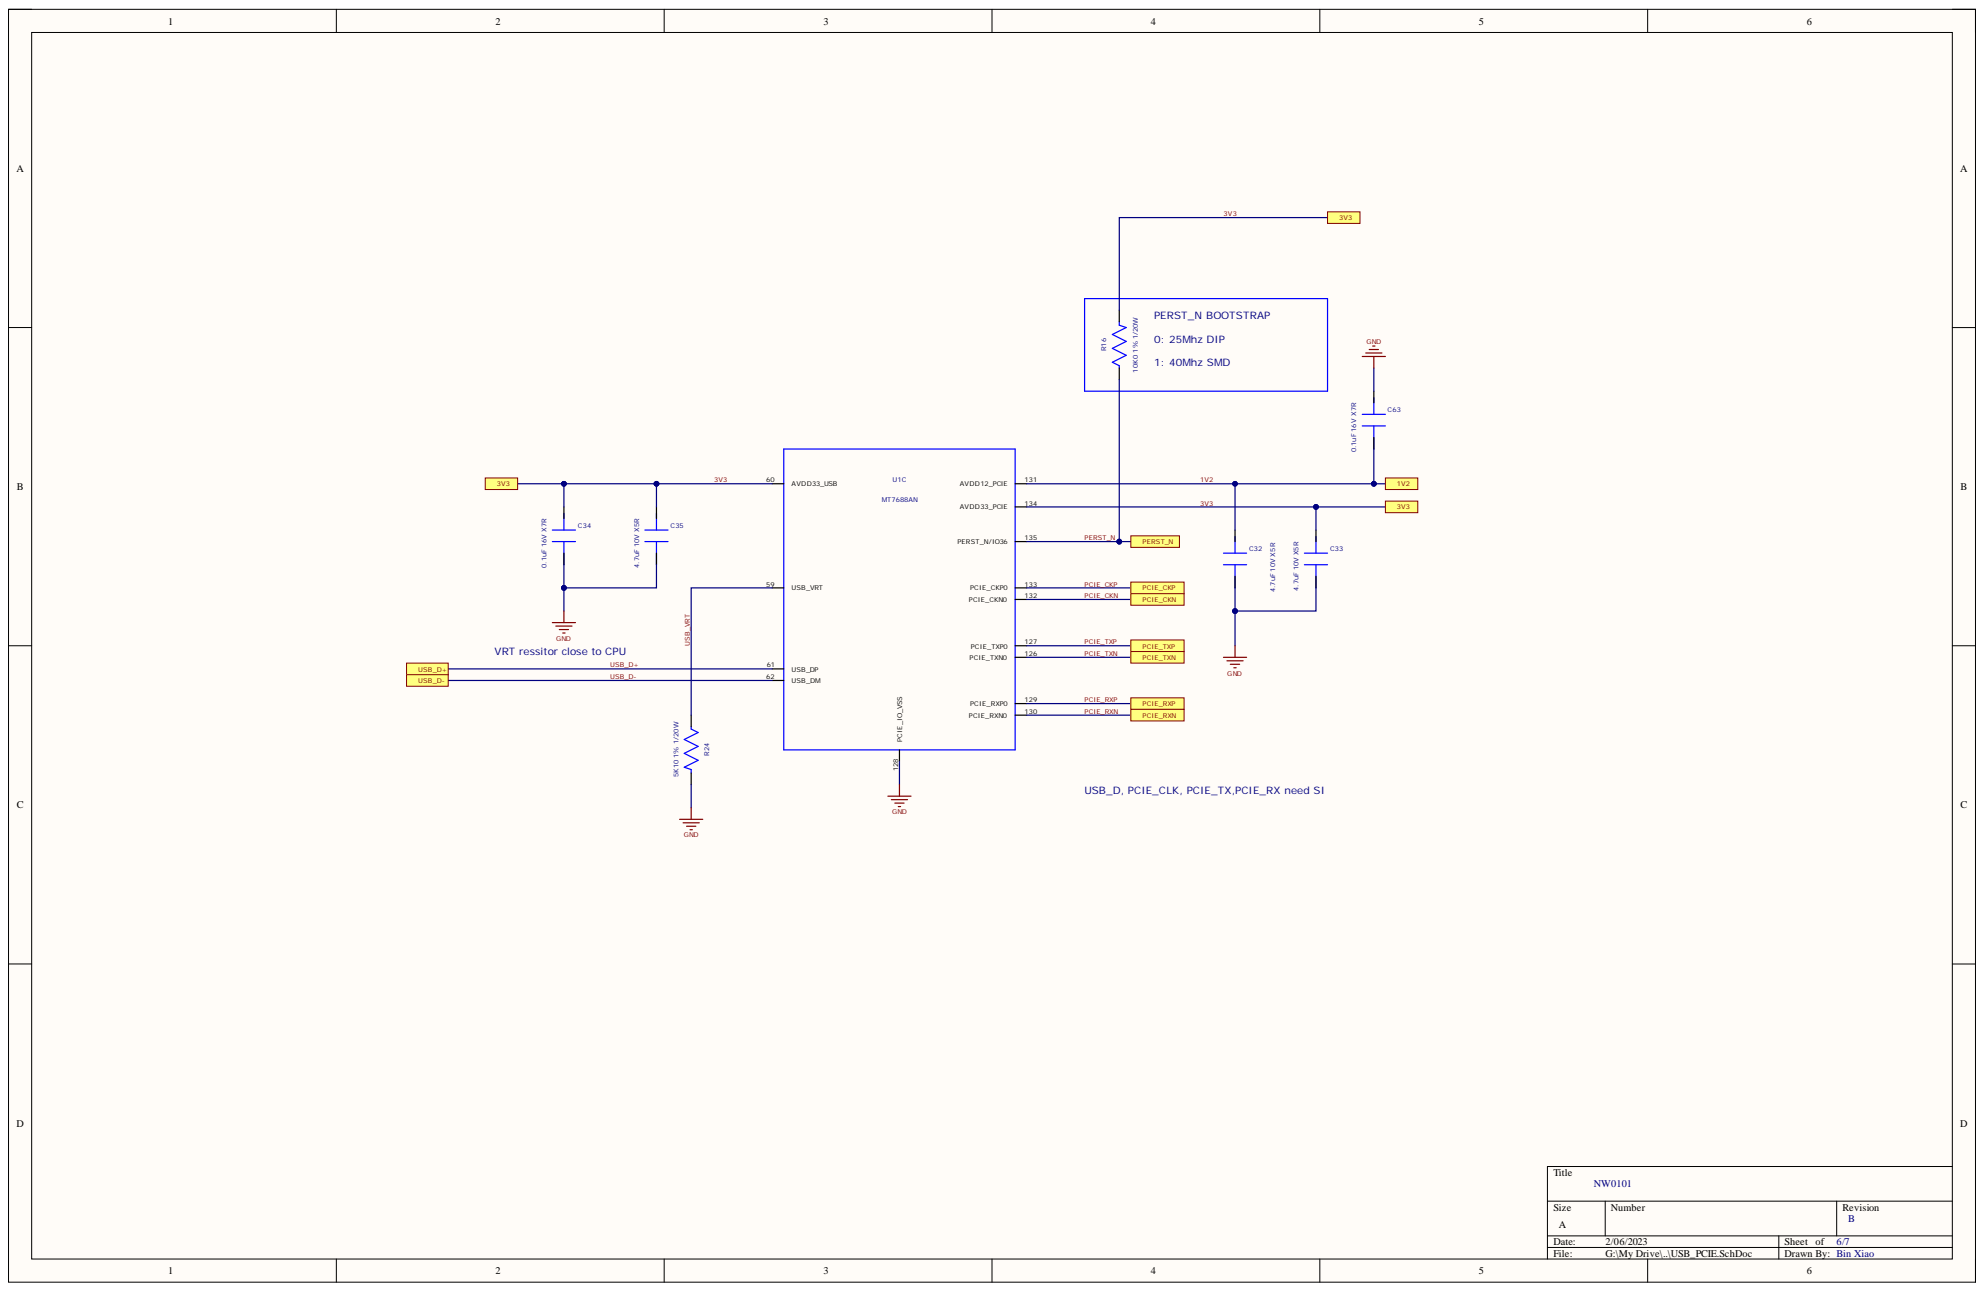
[picture p286: page 6]

e : 2 / 0 6 / 2 0 2 3 | S h e e t o f 6 /7
Fi l e : G : \My D r i v e \ . . \ U S B _ P C IE . S c h D o c | D r a w n B y : B i n X i a o

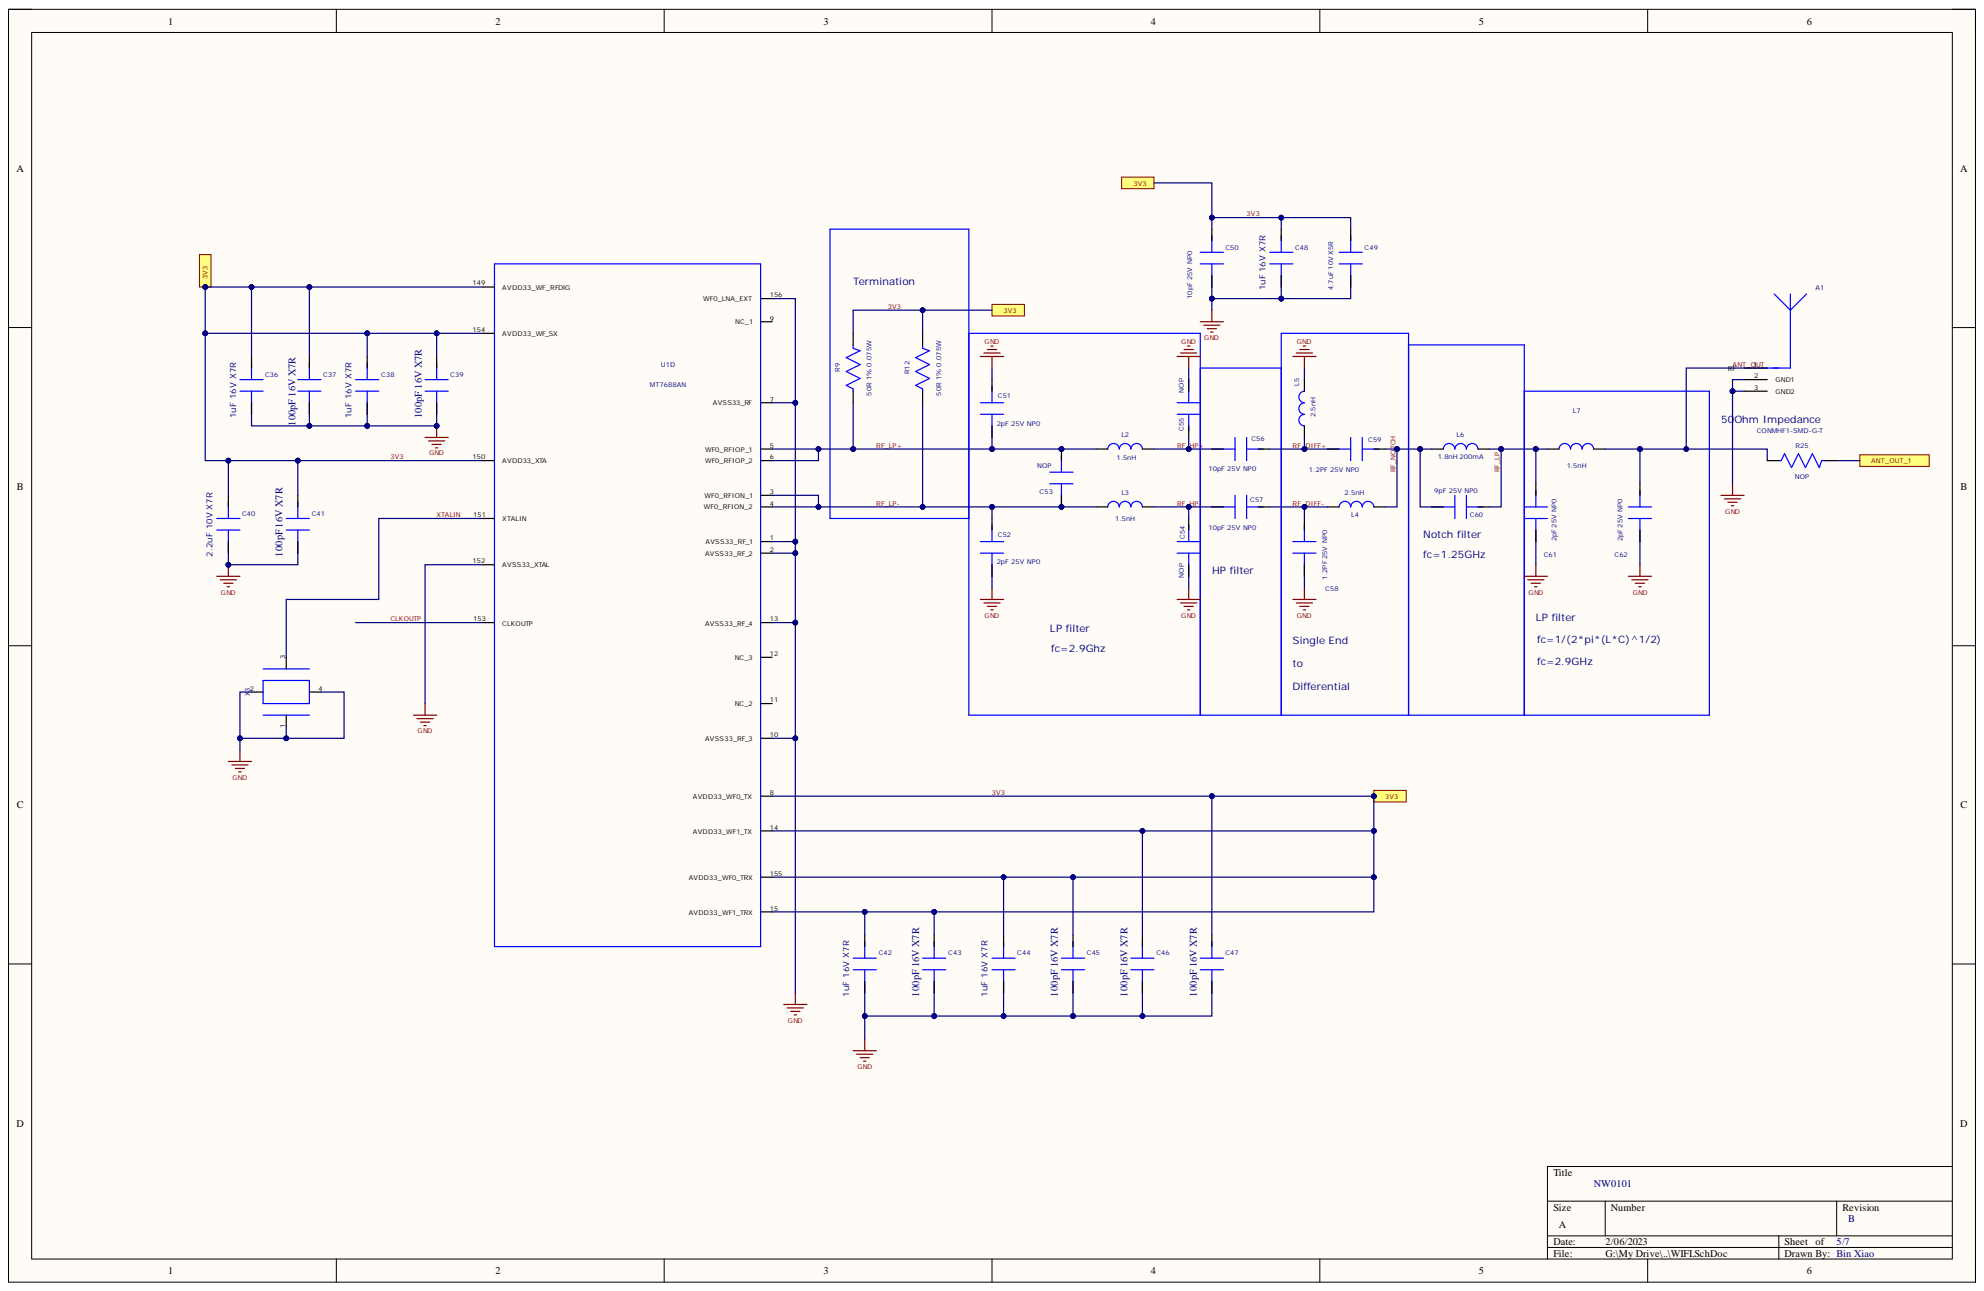
[picture p287: page 7]

GND1 2
GND2 3

Size A | Number | Revision B

Date: 2/06/2023 | Sheet of 5/7
File: G:\My Drive\..\WIFI.SchDoc | Drawn By: Bin Xiao

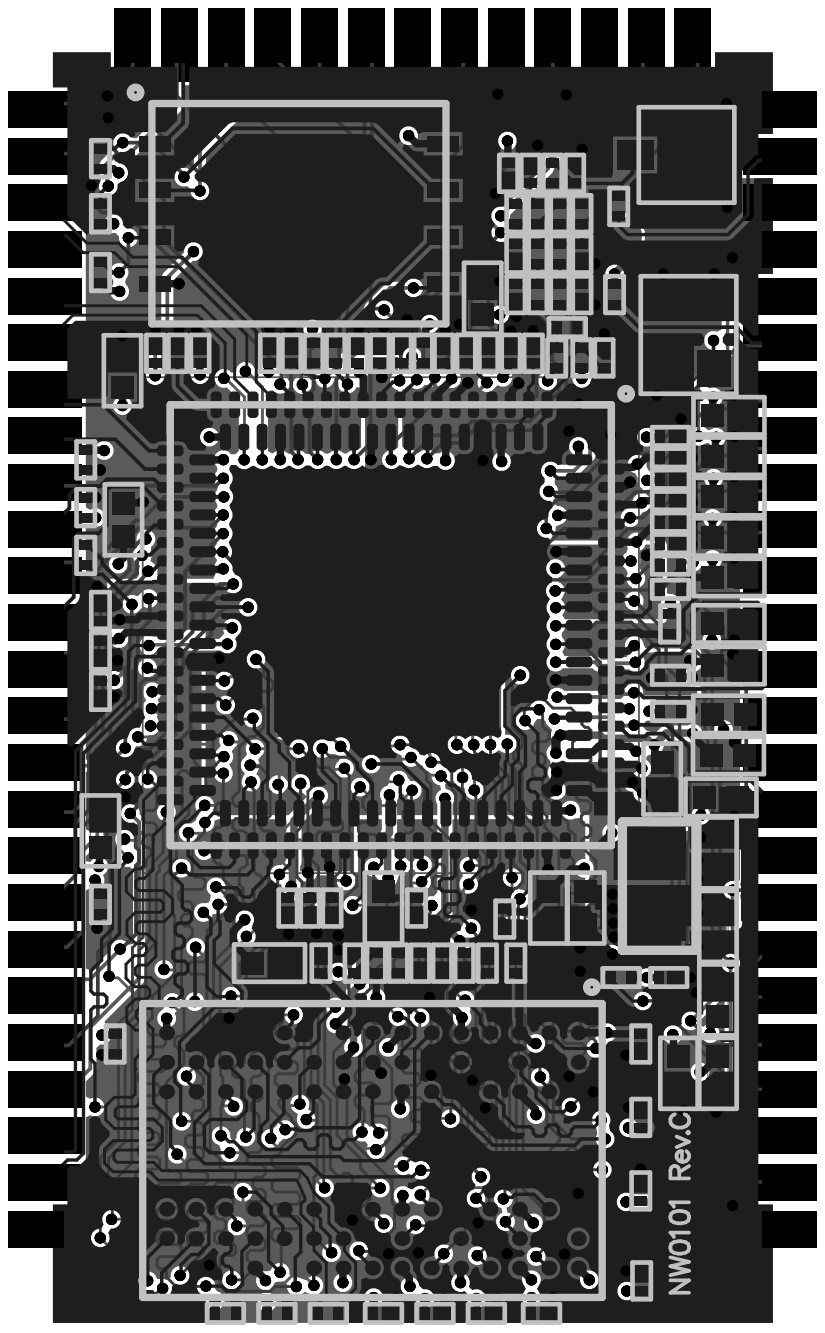
[picture p288: page 8]
