binphilxiao/AxisLabs/BLE0101/2022.05.27_TestingSocketRev.A/BLE0101_Socket_3D Location Drawing.pdf

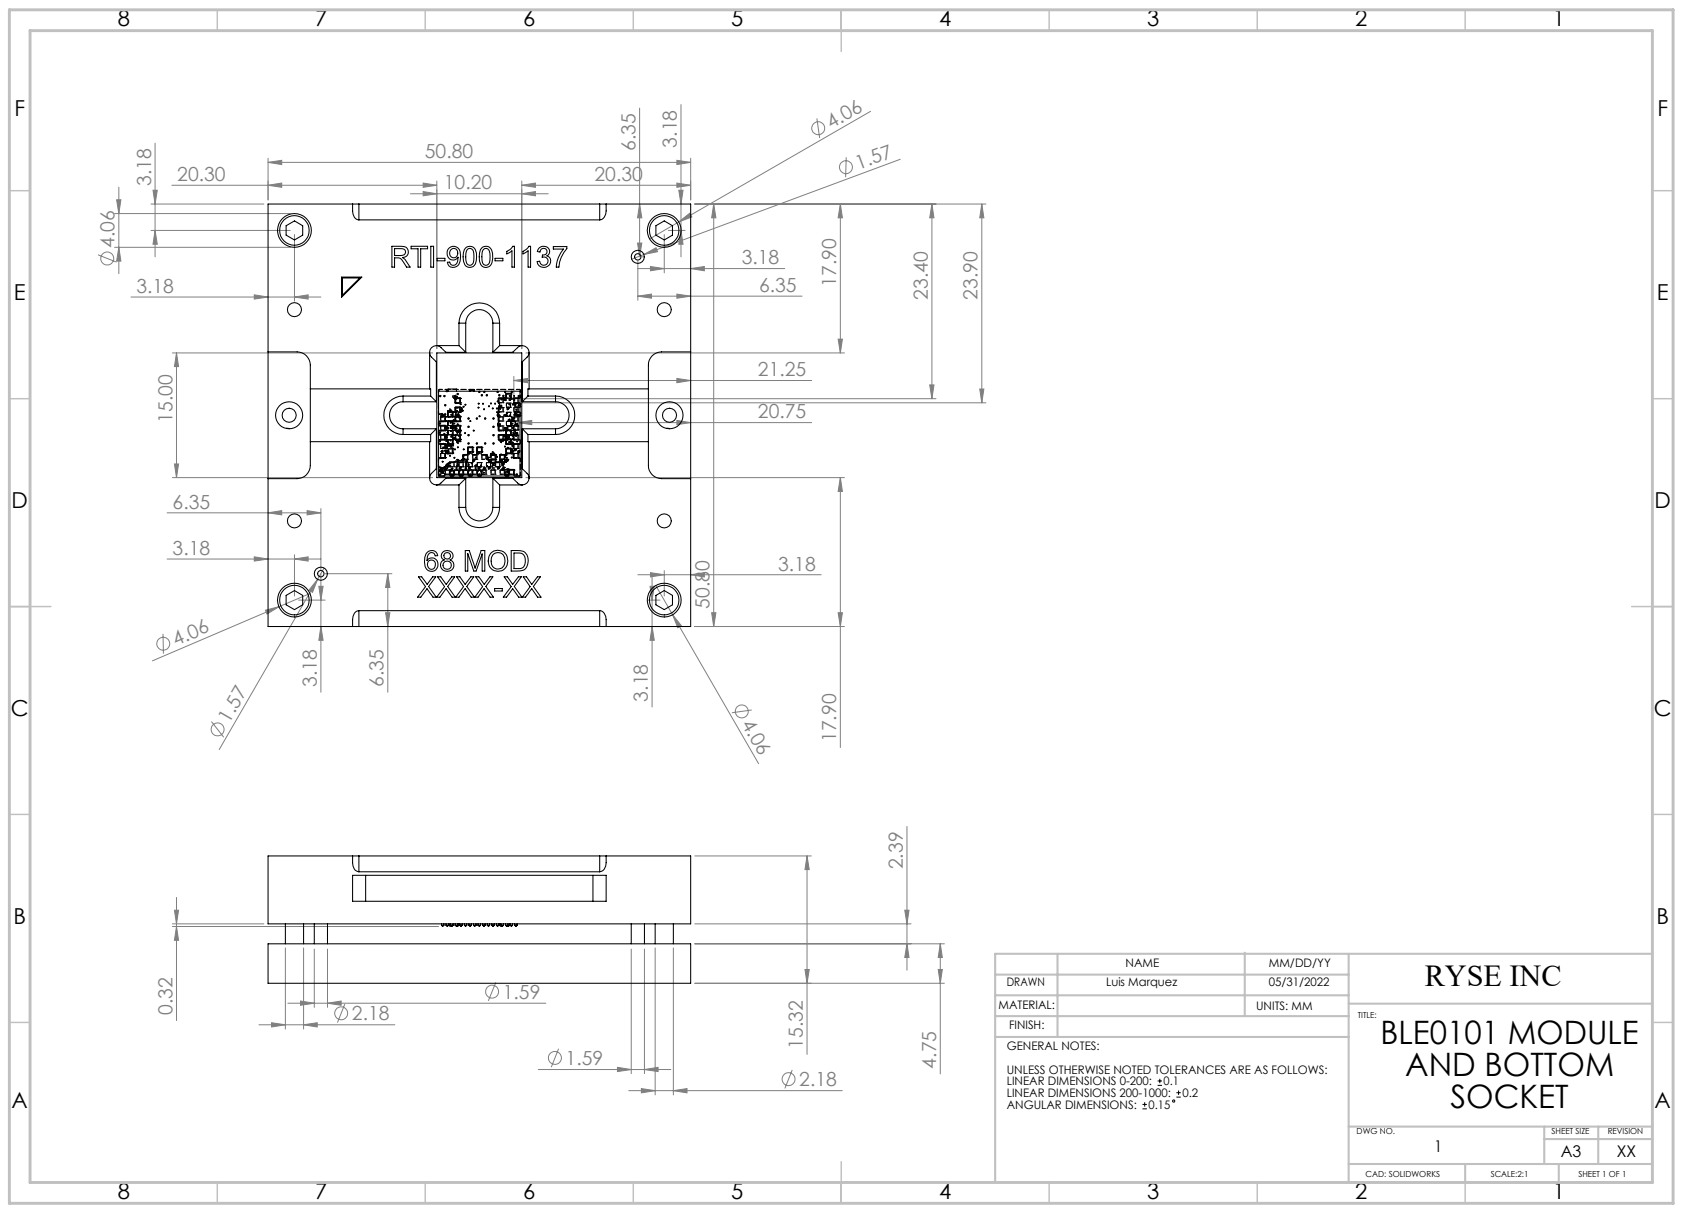
[picture p289: page 1]
BLE0101 MODULE AND BOTTOM

NAME | MM/DD/YY | RYSE INC

DRAWN | Luis Marquez | 05/31/2022
MATERIAL: | | UNITS: MM
FINISH:

GENERAL NOTES:
UNLESS OTHERWISE NOTED TOLERANCES ARE AS FOLLOWS:
LINEAR DIMENSIONS 0-200: 0.1
LINEAR DIMENSIONS 200-1000: 0.2
ANGULAR DIMENSIONS: 0.15

DWG NO. 1 | SHEET SIZE | REVISION

CAD: SOLIDWORKS | SCALE:2:1 | SHEET 1 OF 1
