binphilxiao/AxisLabs/GB0102/Drawing/PCBA-000028 (BP Main board Assembly) New Connector.pdf

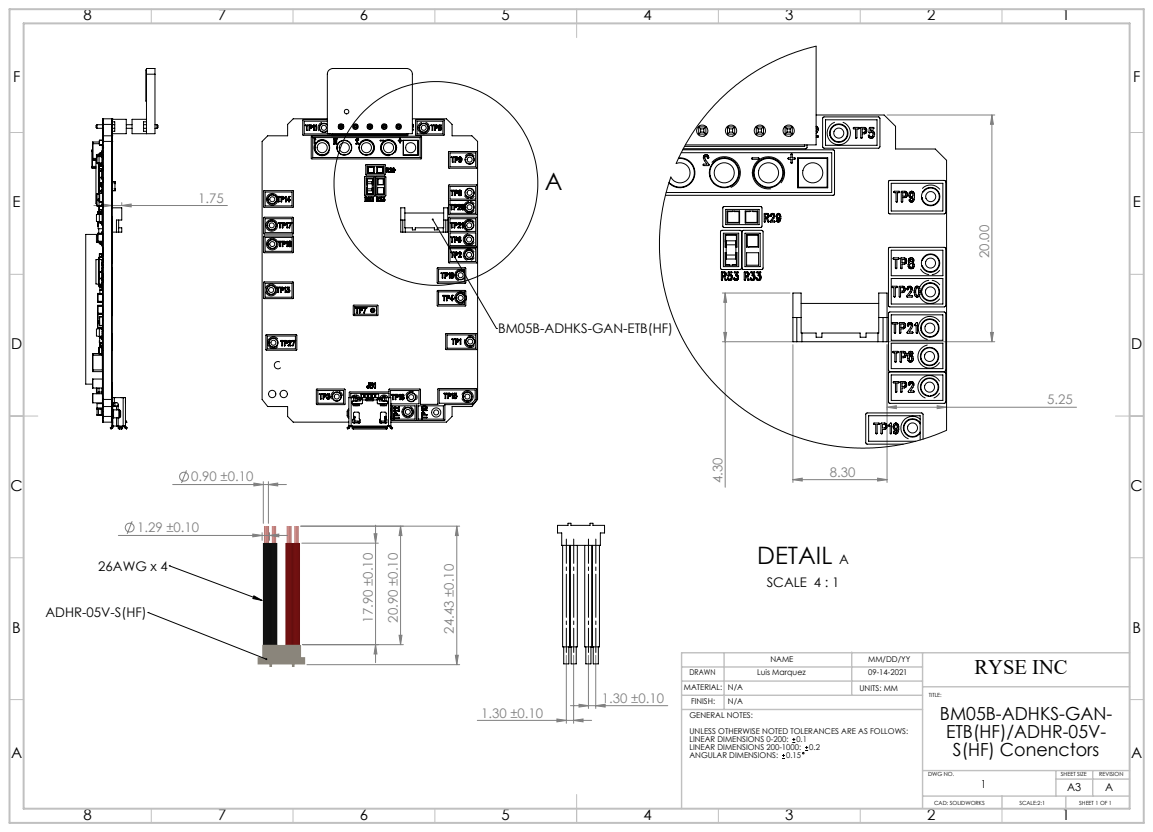
[picture p290: page 1]
DETAIL A; SCALE 4 : 1; 26AWG x 4

BM05B-ADHKS-GAN-ETB(HF)

NAME | MM/DD/YY | RYSE INC

DRAWN | Luis Marquez | 09-14-2021
MATERIAL: | N/A | UNITS: MM
FINISH: | N/A

TITLE:
BM05B-ADHKS-GAN-
ETB(HF)/ADHR-05V-
S(HF) Conenctors

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

DWG NO. 1 | SHEET SIZE | REVISION

CAD: SOLIDWORKS | SCALE:2:1 | SHEET 1 OF 1
