binphilxiao/AxisLabs/SC0101/2024.08_JigsRev.B_Manufacture/doc/PCB-000037 PCB-SC0101 Rev.B_SCH - With notes for test jig.pdf

D

6 | 5 | 4 | 3 | 2 | 1

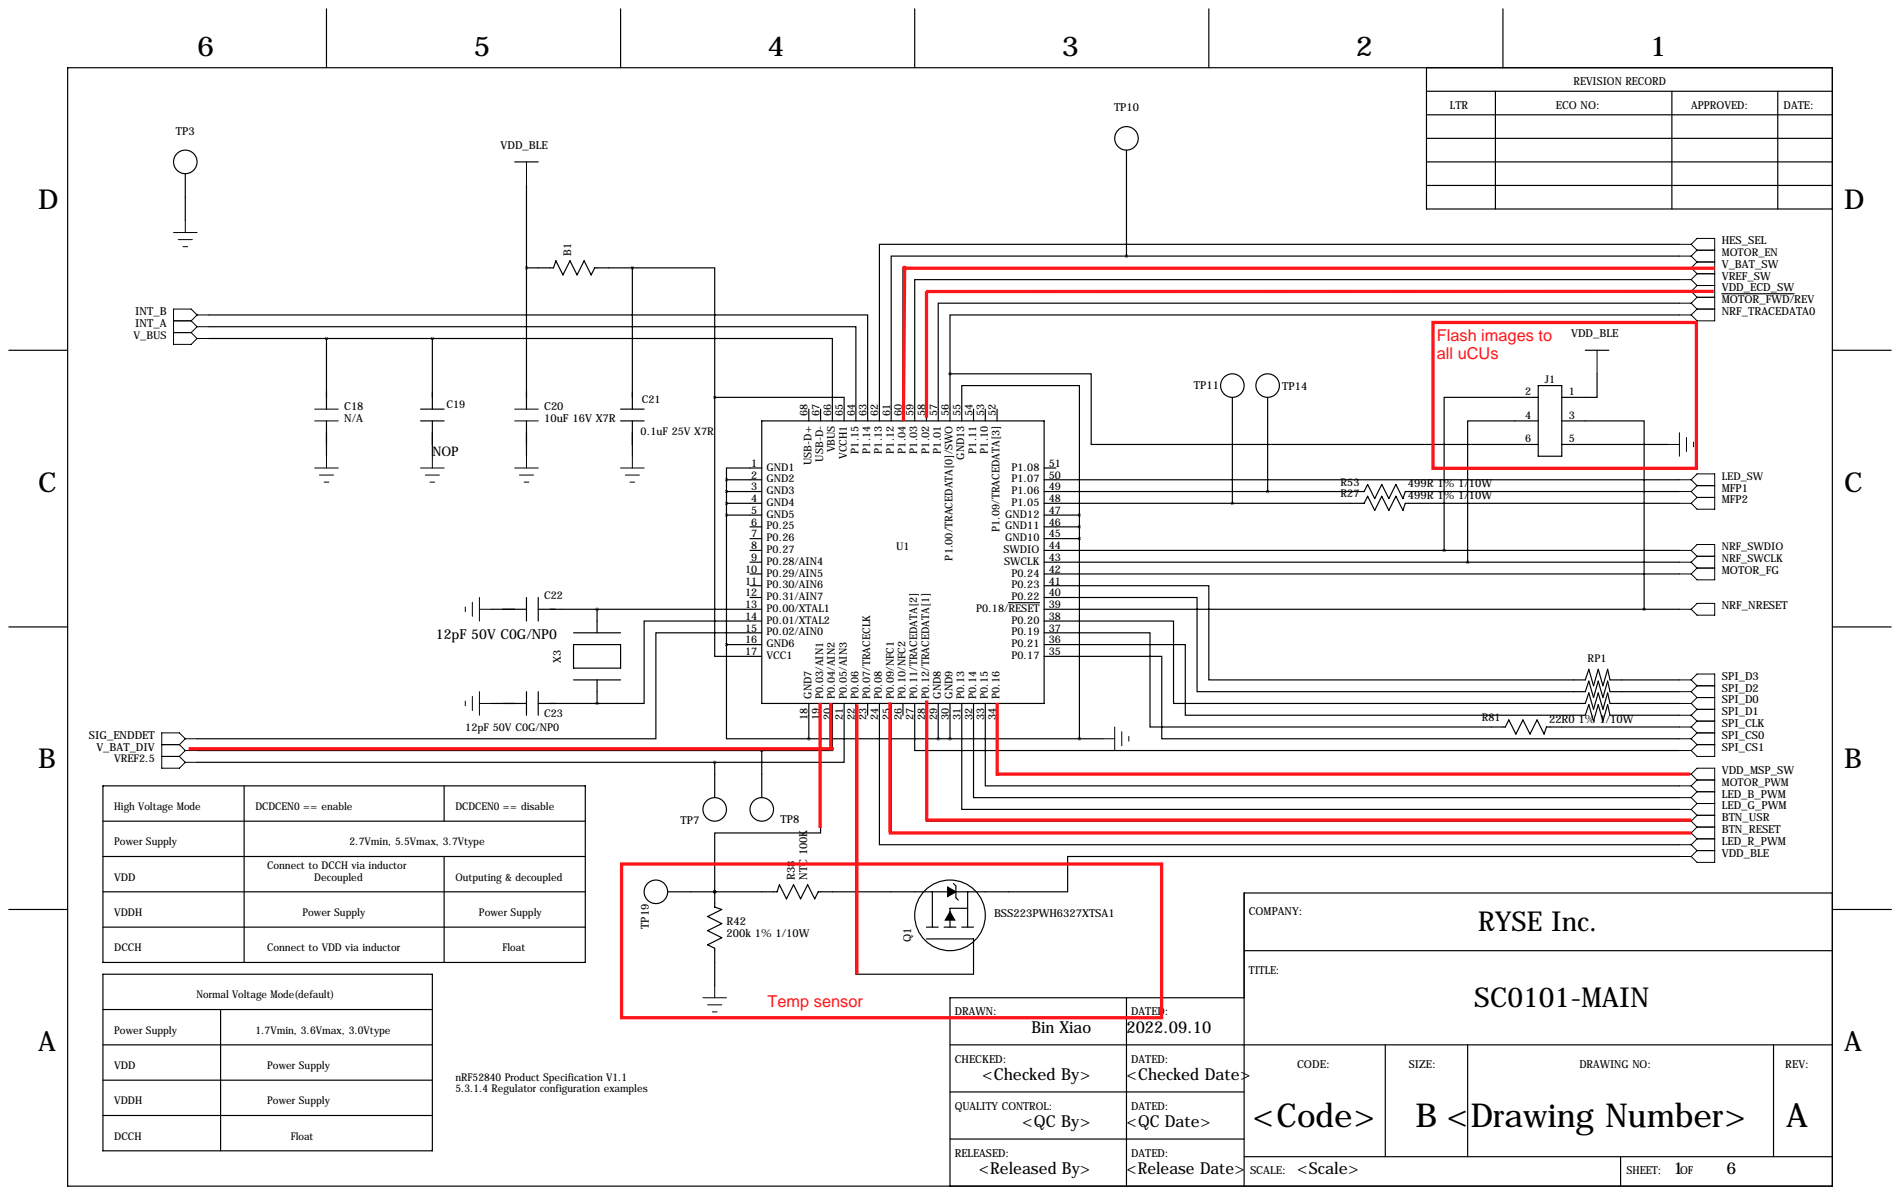
[picture p291: page 1]

REVISION RECORD

LTR | ECO NO: | APPROVED: | DATE:

43 SWCLK
42 P0.24
41 P0.23
40 P0.22

High Voltage Mode | DCDCEN0 == enable | DCDCEN0 == disable

Power Supply | 2.7Vmin, 5.5Vmax, 3.7Vtype

VDD | Connect to DCCH via inductor Decoupled | Outputing & decoupled

Connect to VDD via inductor

Normal Voltage Mode(default)

DRAWN: Bin Xiao | DATED: 2022.09.10

Power Supply | 1.7Vmin, 3.6Vmax, 3.0Vtype

VDDH | Power Supply

QUALITY CONTROL: <QC By> | DATED: <QC Date>

DCCH | Float

RELEASED: <Released By> | DATED: <Release Date>

<Scale> SCALE: | 1 6 SHEET: OF

D

D

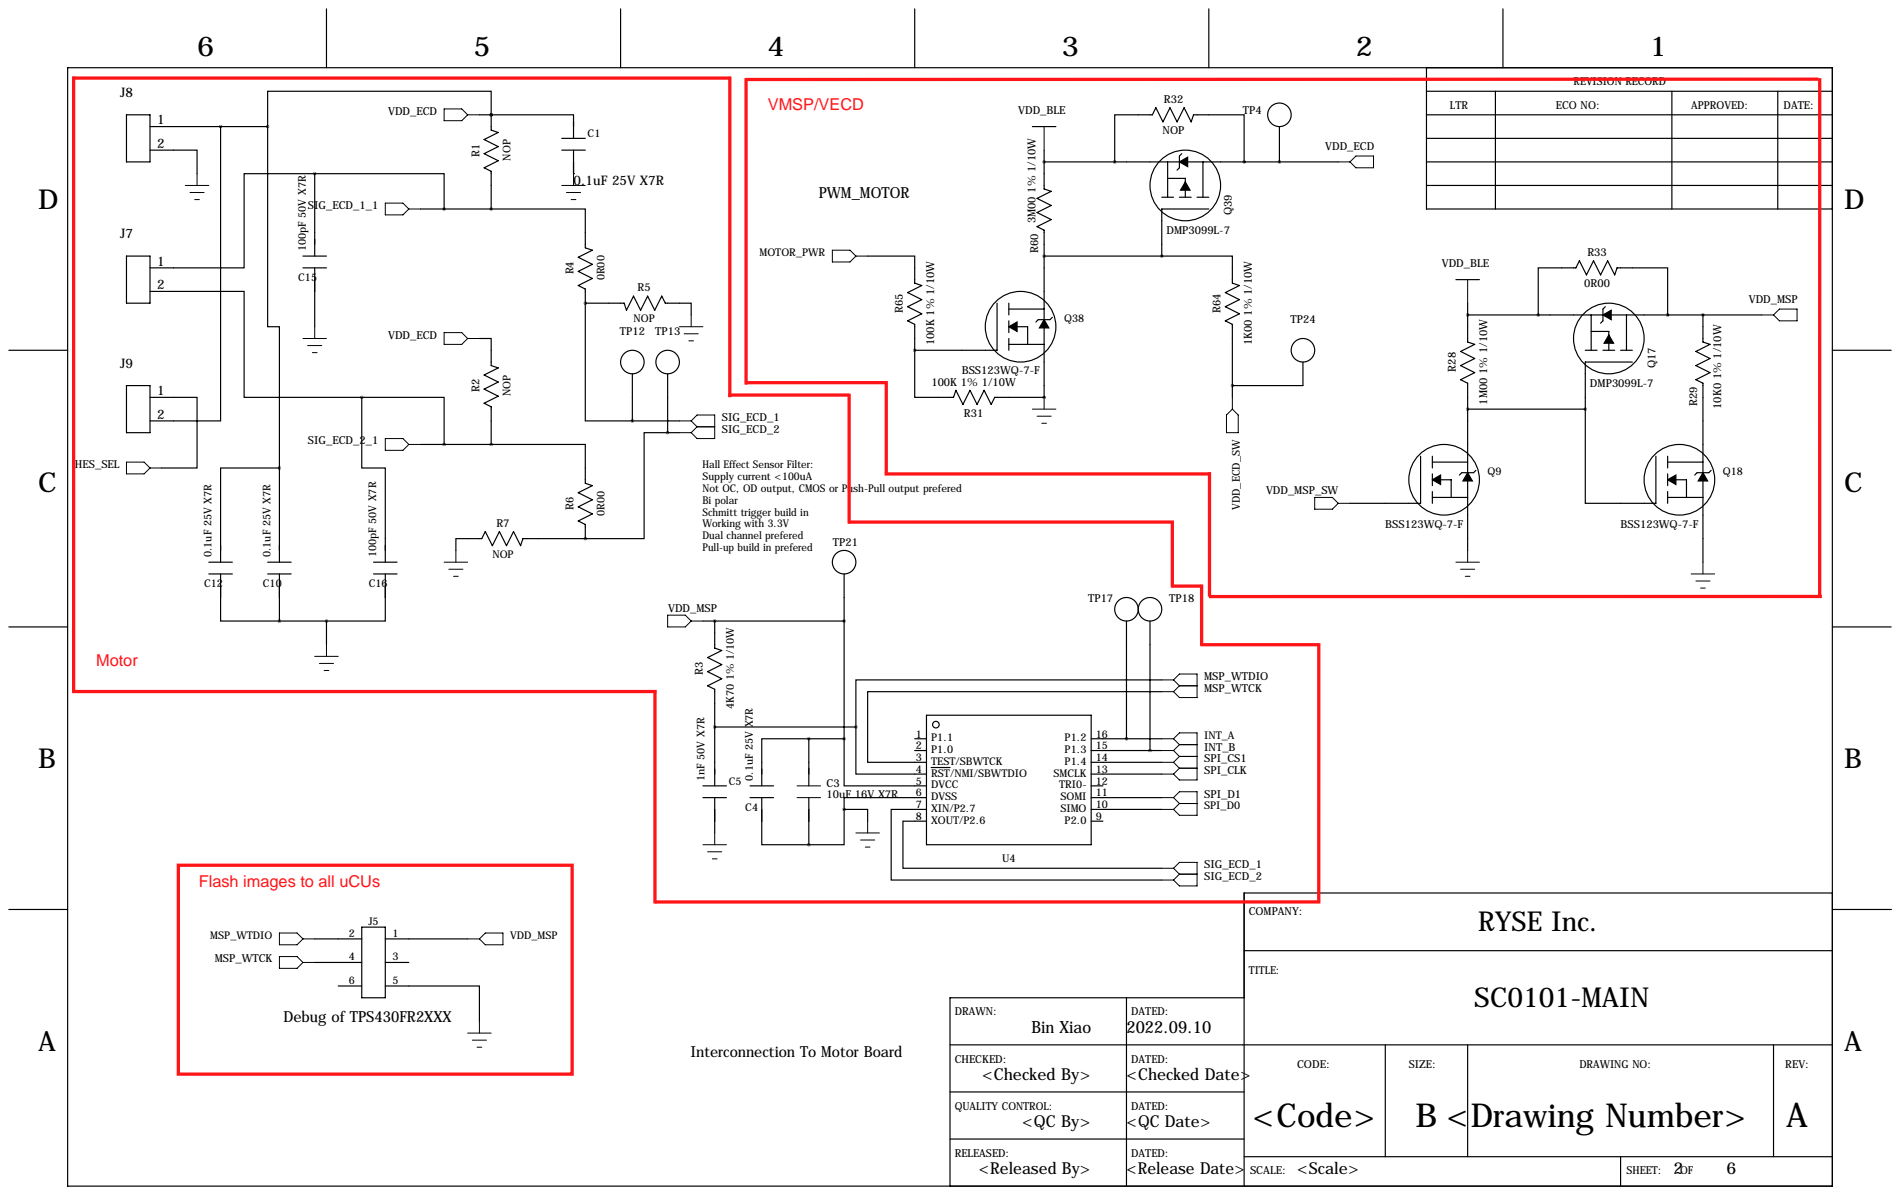
[picture p292: page 2]

REVISION RECORD

LTR | ECO NO: | APPROVED: | DATE:

Hall Effect Sensor Filter:
Supply current <100uA
Not OC, OD output, CMOS or Push-Pull output prefered
Bi polar
Schmitt trigger build in
Working with 3.3V
Dual channel prefered
Pull-up build in prefered

DRAWN: Bin Xiao | DATED: 2022.09.10
CHECKED: <Checked By> | DATED: <Checked Date> | CODE: <Code> | SIZE: B <Drawing Number> | DRAWING NO: | REV: A

Interconnection To Motor Board

QUALITY CONTROL: <QC By> | DATED: <QC Date>

D

D

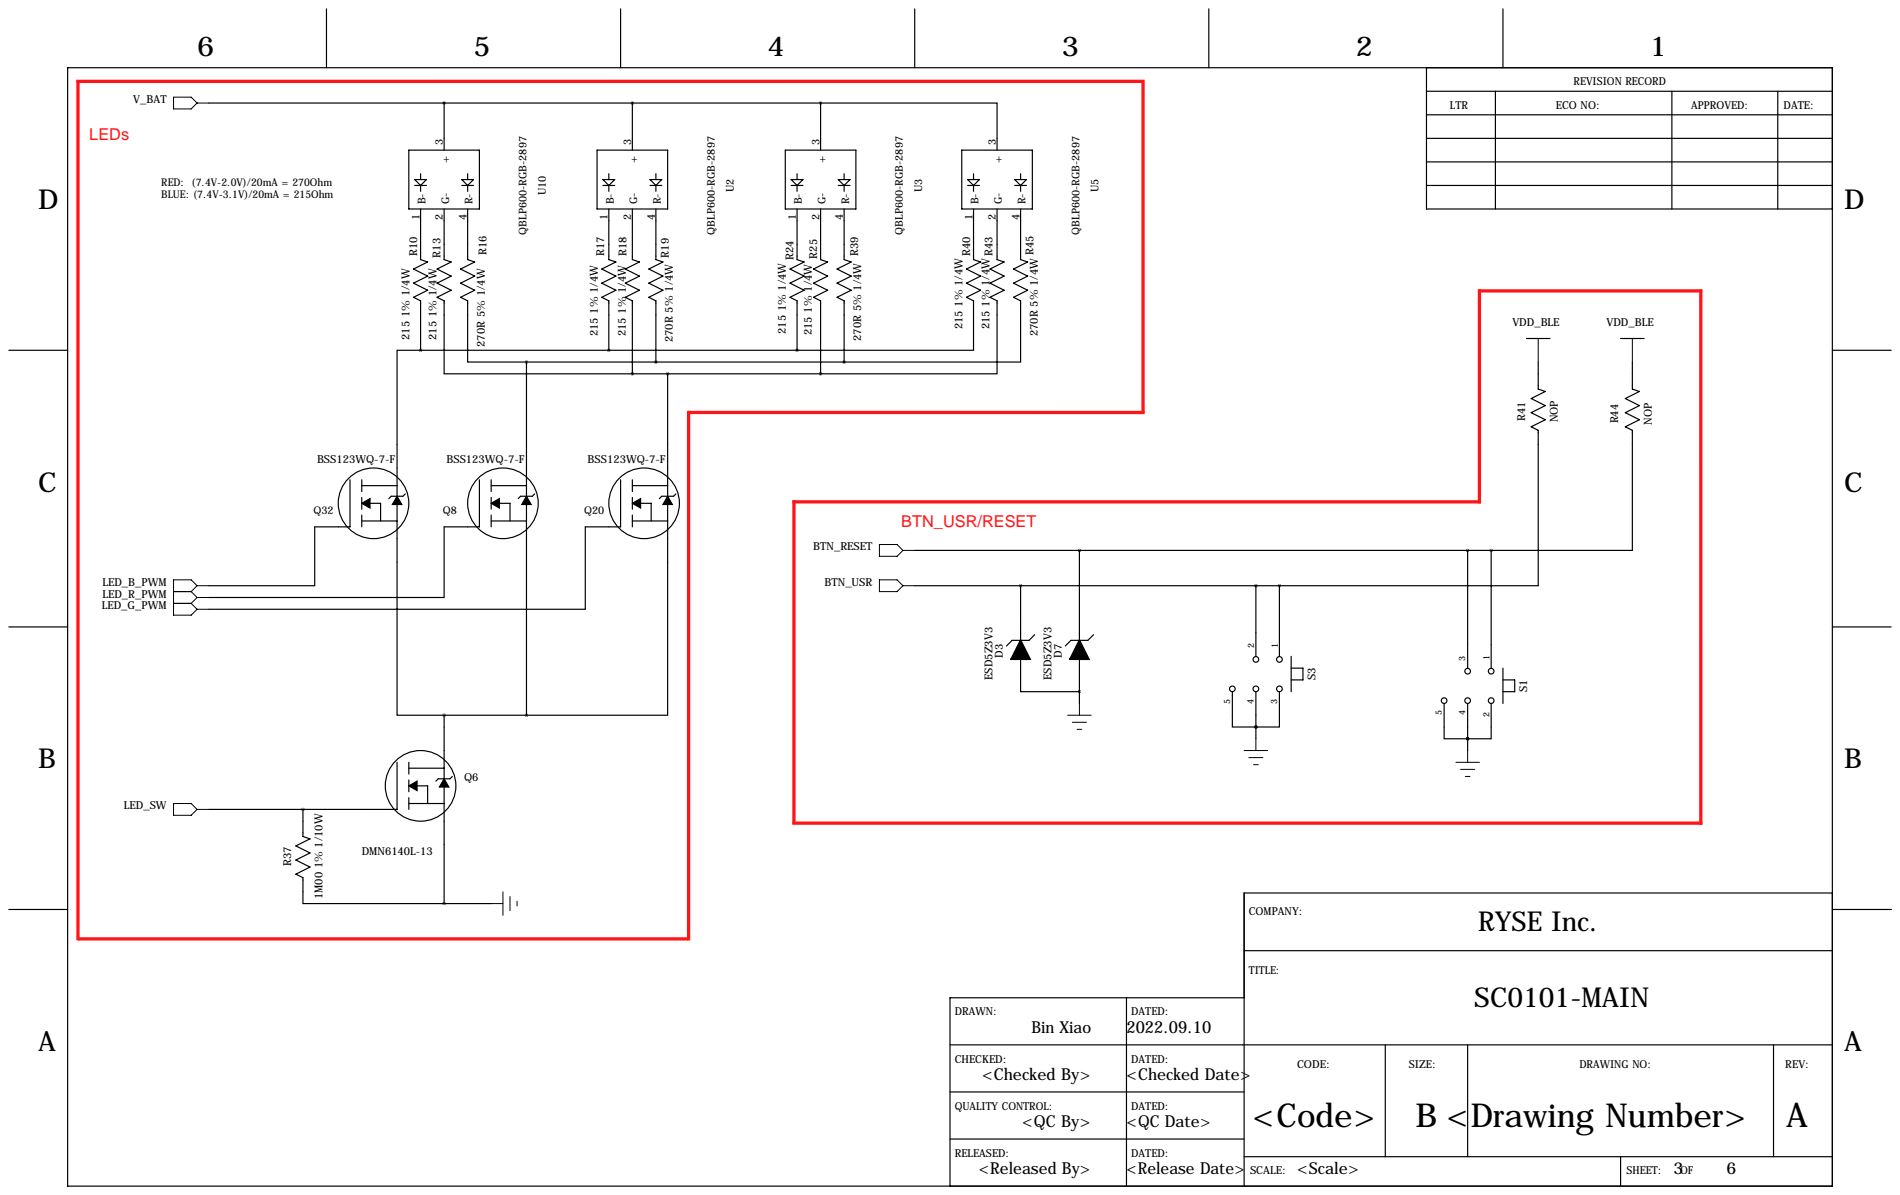
[picture p293: page 3]

REVISION RECORD

LTR | ECO NO: | APPROVED: | DATE:

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

QUALITY CONTROL: <QC By> | DATED: <QC Date>

# ABD

6

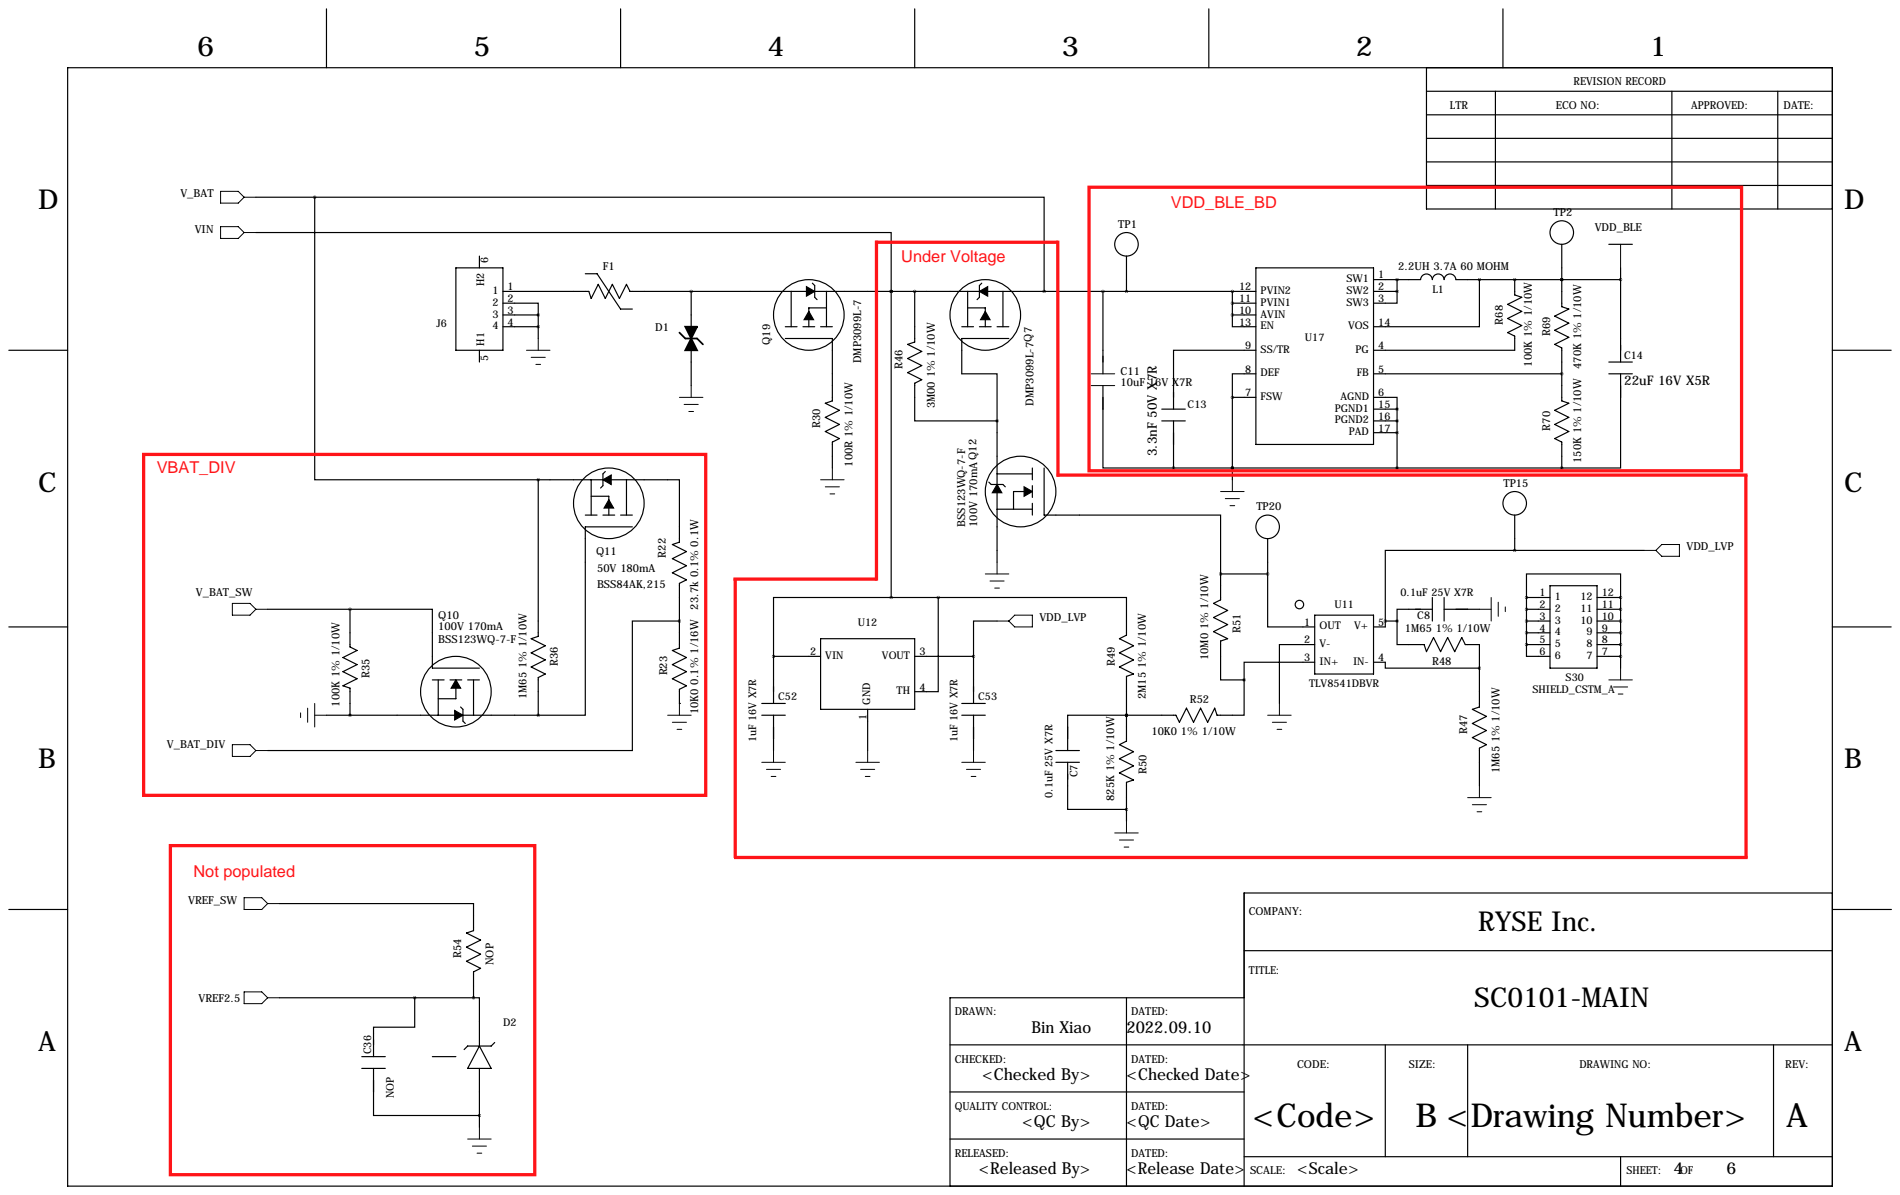
[picture p294: page 4]

REVISION RECORD

LTR | ECO NO: | APPROVED: | DATE:

3 | 10 10

DRAWN: Bin Xiao | DATED: 2022.09.10

CHECKED: <Checked By> | DATED: <Checked Date> | CODE: <Code> | SIZE: B <Drawing Number> | DRAWING NO: | REV: A

QUALITY CONTROL: <QC By> | DATED: <QC Date>

D

D

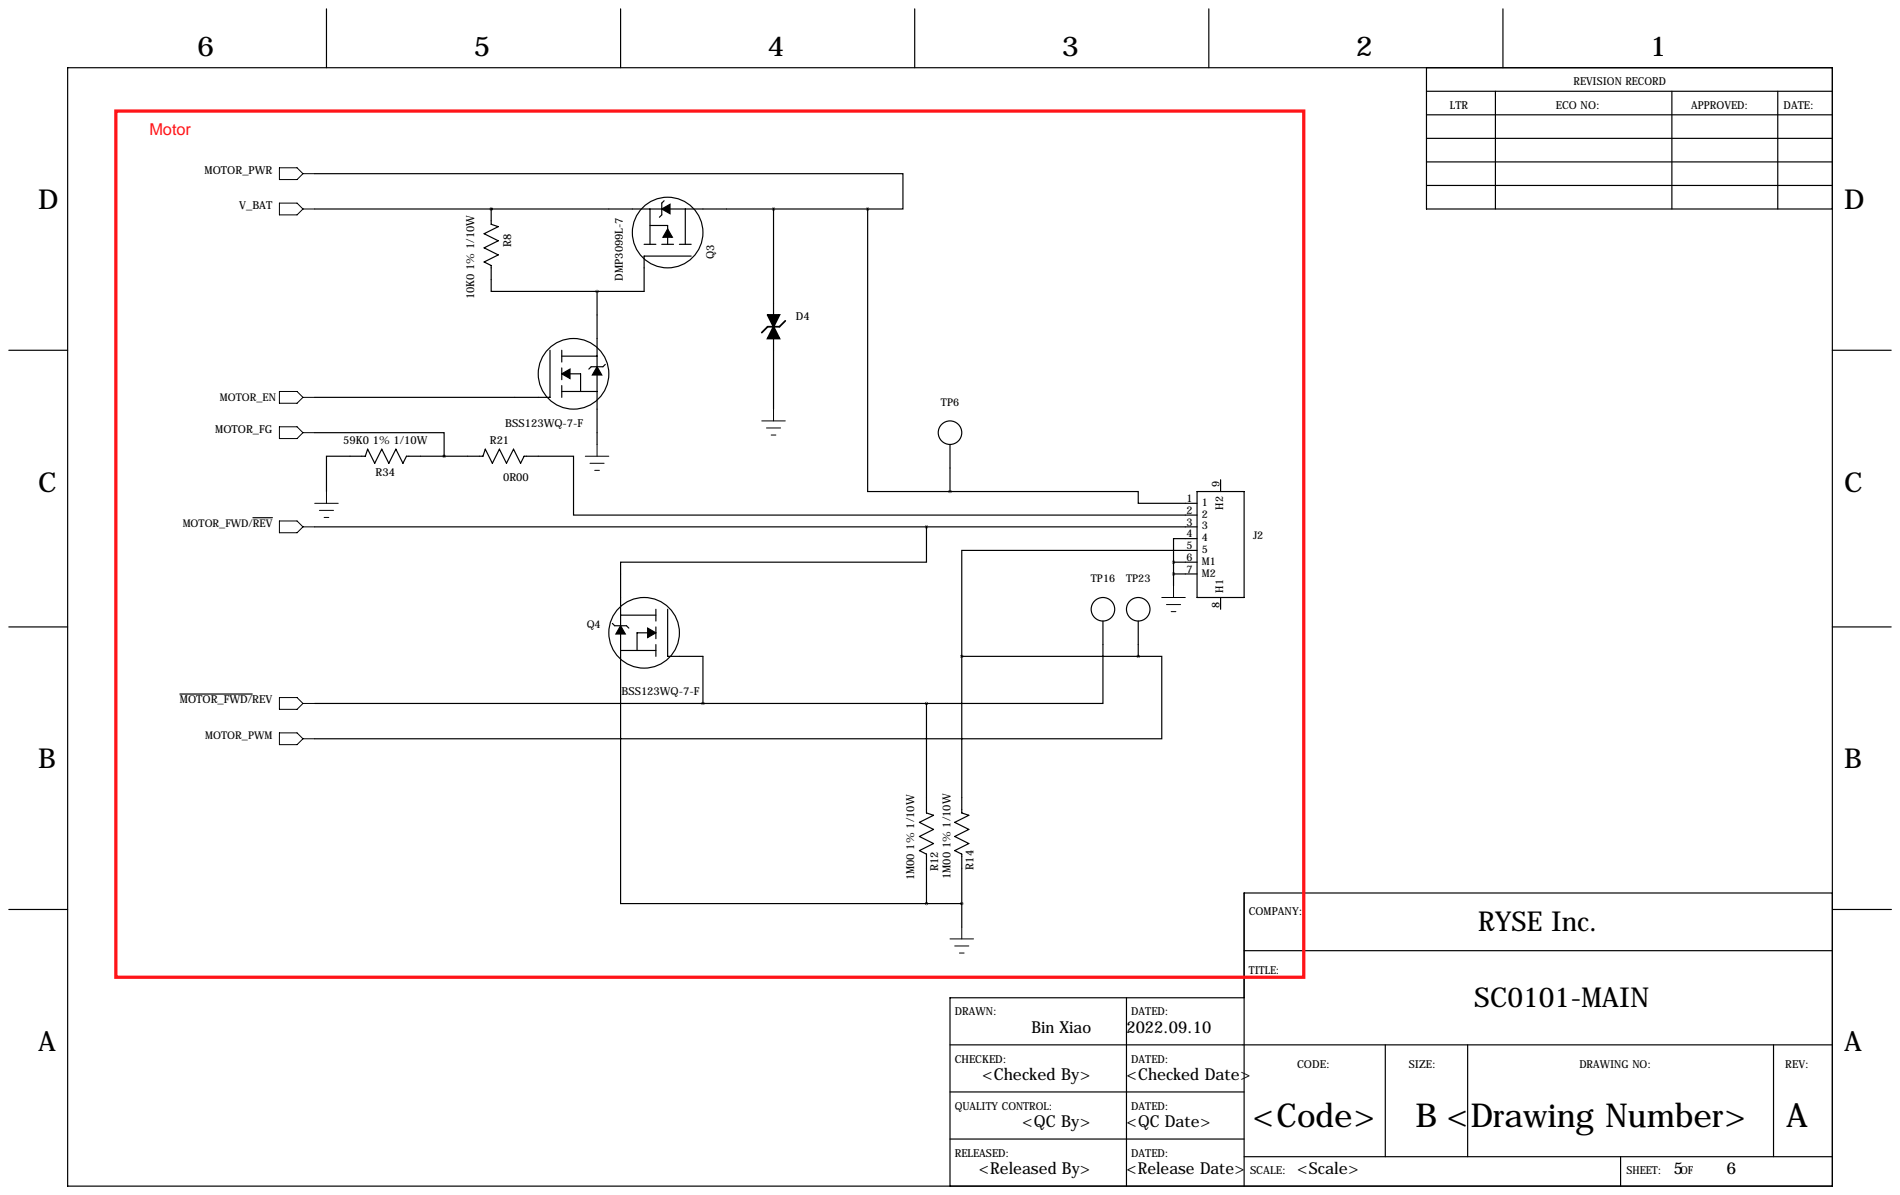
[picture p295: page 5]

REVISION RECORD

LTR | ECO NO: | APPROVED: | DATE:

DRAWN: Bin Xiao | DATED: 2022.09.10

CHECKED: <Checked By> | DATED: <Checked Date> | CODE: <Code> | SIZE: B <Drawing Number> | DRAWING NO: | REV: A

QUALITY CONTROL: <QC By> | DATED: <QC Date>

D

D

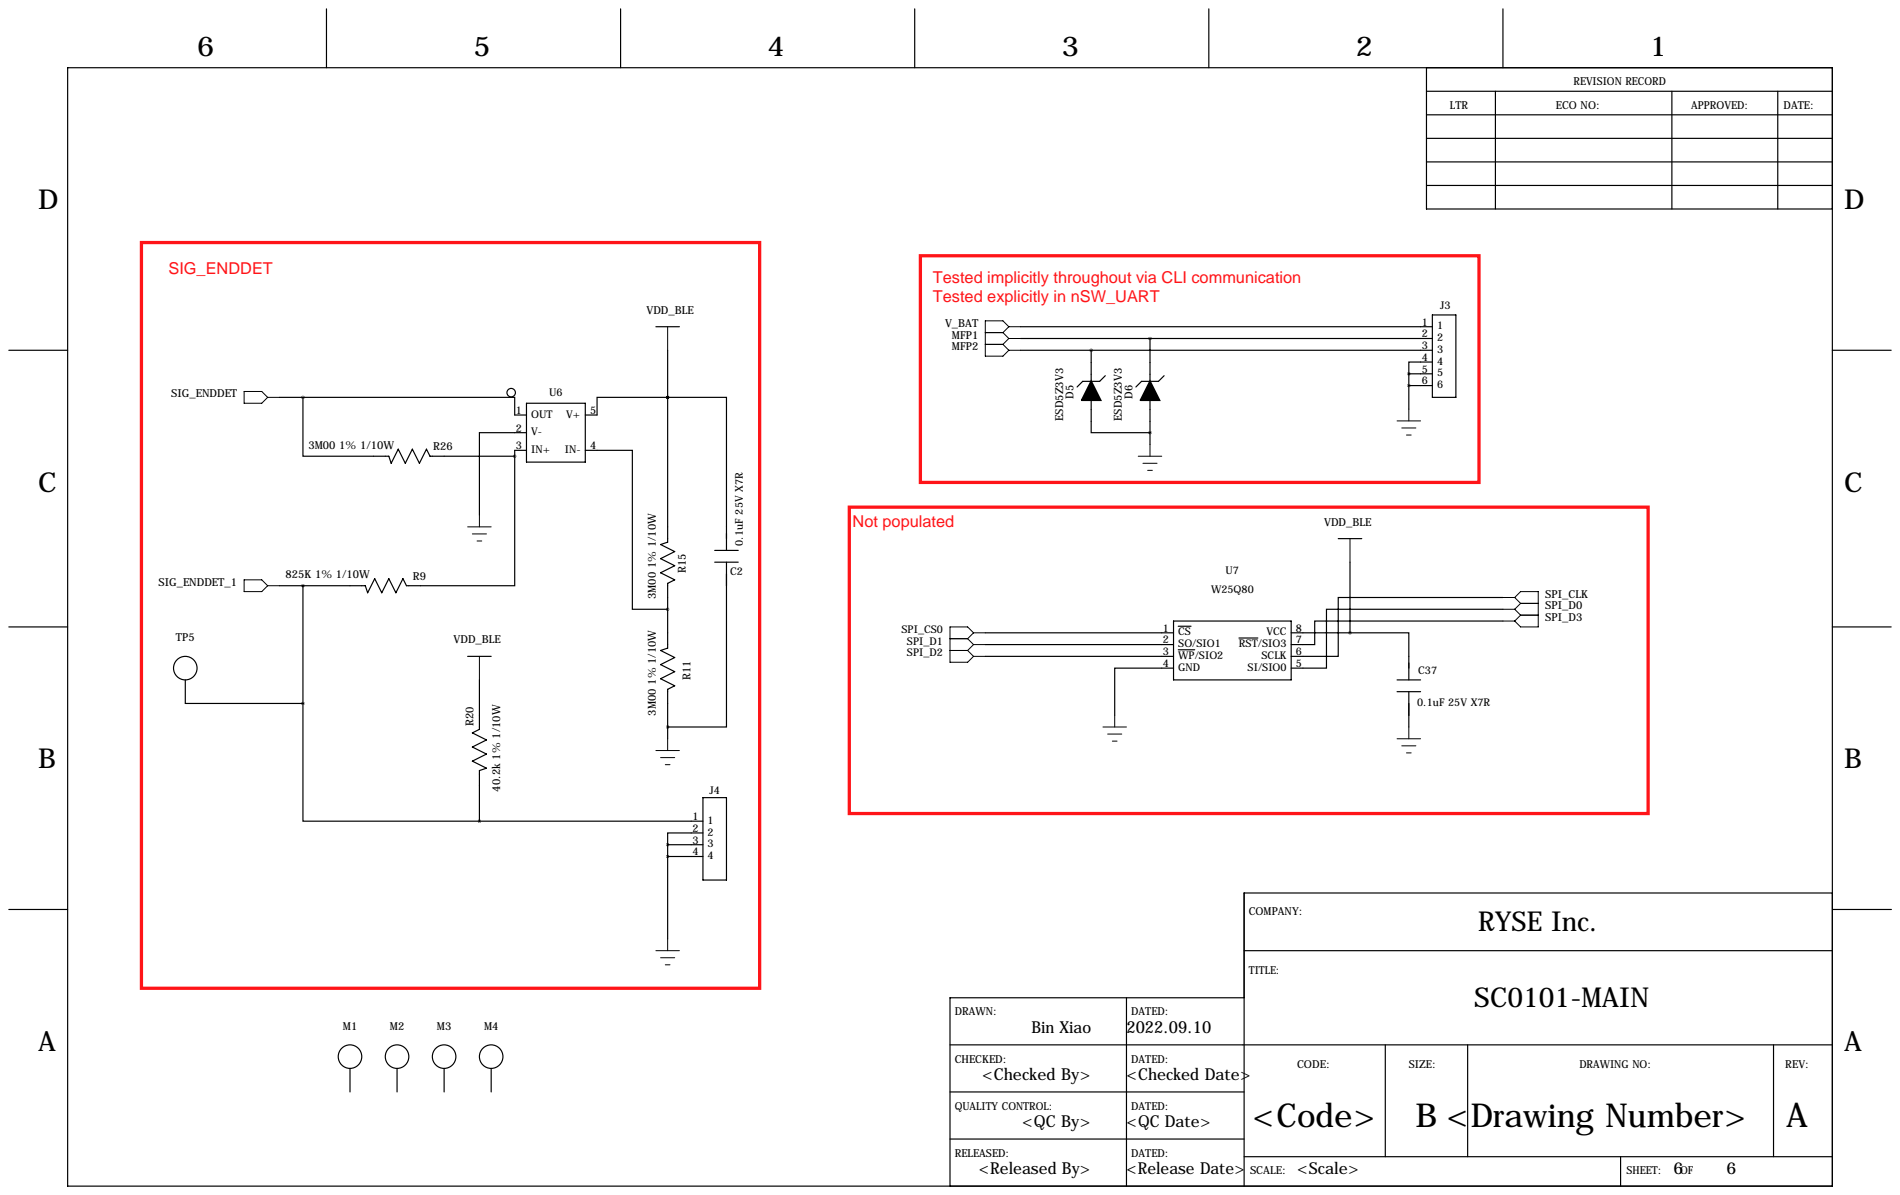
[picture p296: page 6]

VDD_BLE | REVISION RECORD

LTR | ECO NO: | APPROVED: | DATE:

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

QUALITY CONTROL: <QC By> | DATED: <QC Date>
