binphilxiao/AxisLabs/SC0101/2024.08_JigsRev.B_Manufacture/doc/Smartcurtain_test_station.pdf

# Dual Smartcurtain main PCB test station

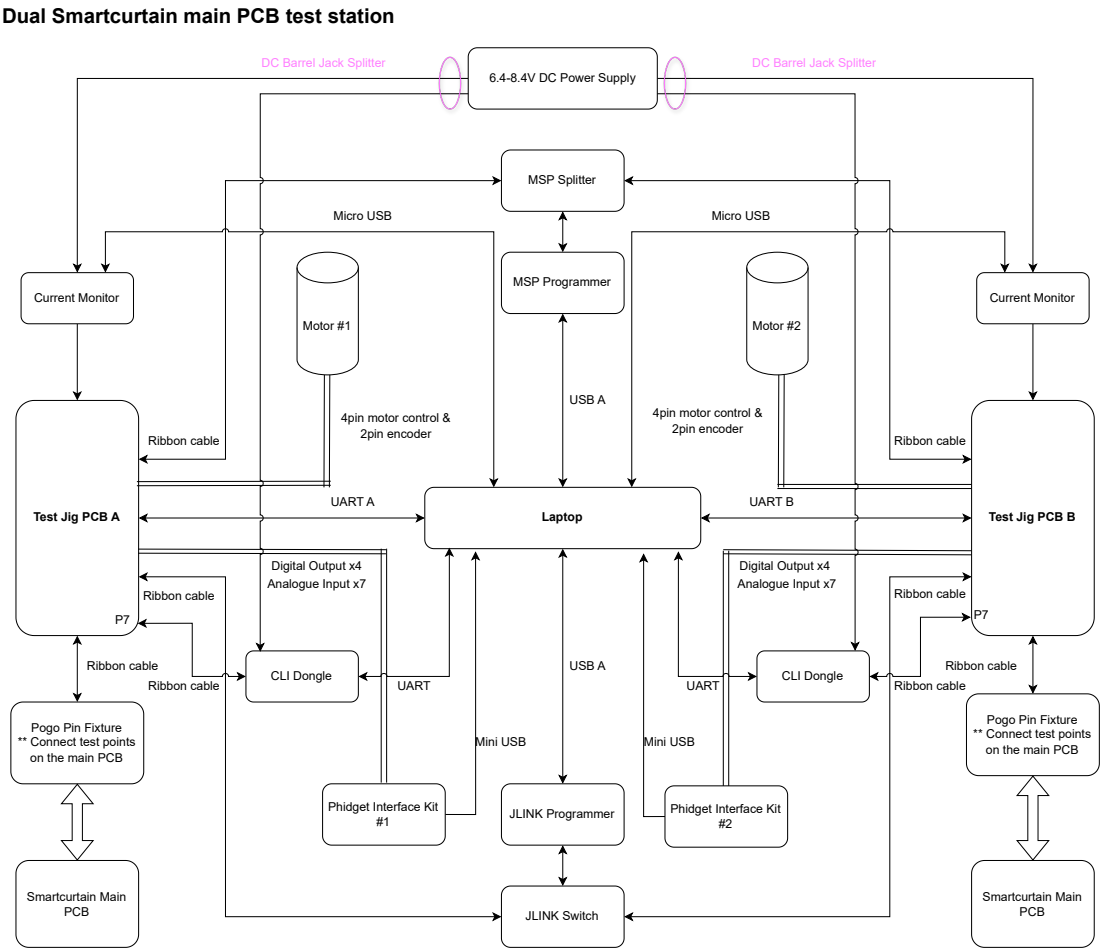
[picture p297: page 1]
Test Jig PCB A; Laptop; Test Jig PCB B; UART A; UART B; JLINK Programmer; MSP Programmer; JLINK Switch; USB A; Ribbon cable; MSP Splitter; Mini USB; Digital Output x4 Analogue Input x7; Motor #1; Motor #2; 4pin motor control & 2pin encoder; Smartcurtain Main PCB; Current Monitor; Micro USB; CLI Dongle; UART; DC Barrel Jack Splitter

6.4-8.4V DC Power Supply

Pogo Pin Fixture
** Connect test points
on the main PCB

Phidget Interface Kit
