binphilxiao/AxisLabs/GR0102/Certification/Doc provided/Submitted/SmartShade  Assembly.pdf

S5

R41

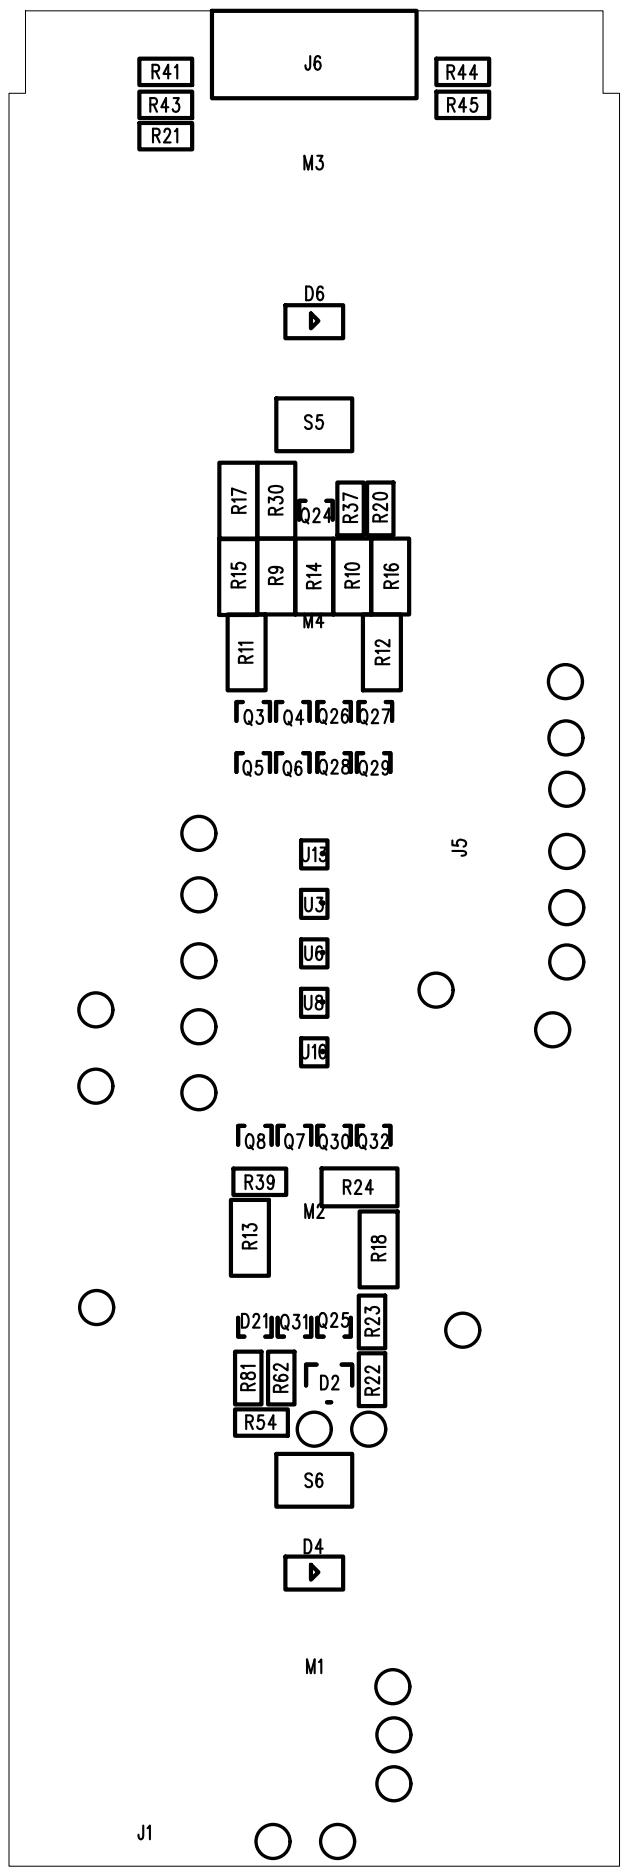
[picture p298: page 1]

# M3M³x1

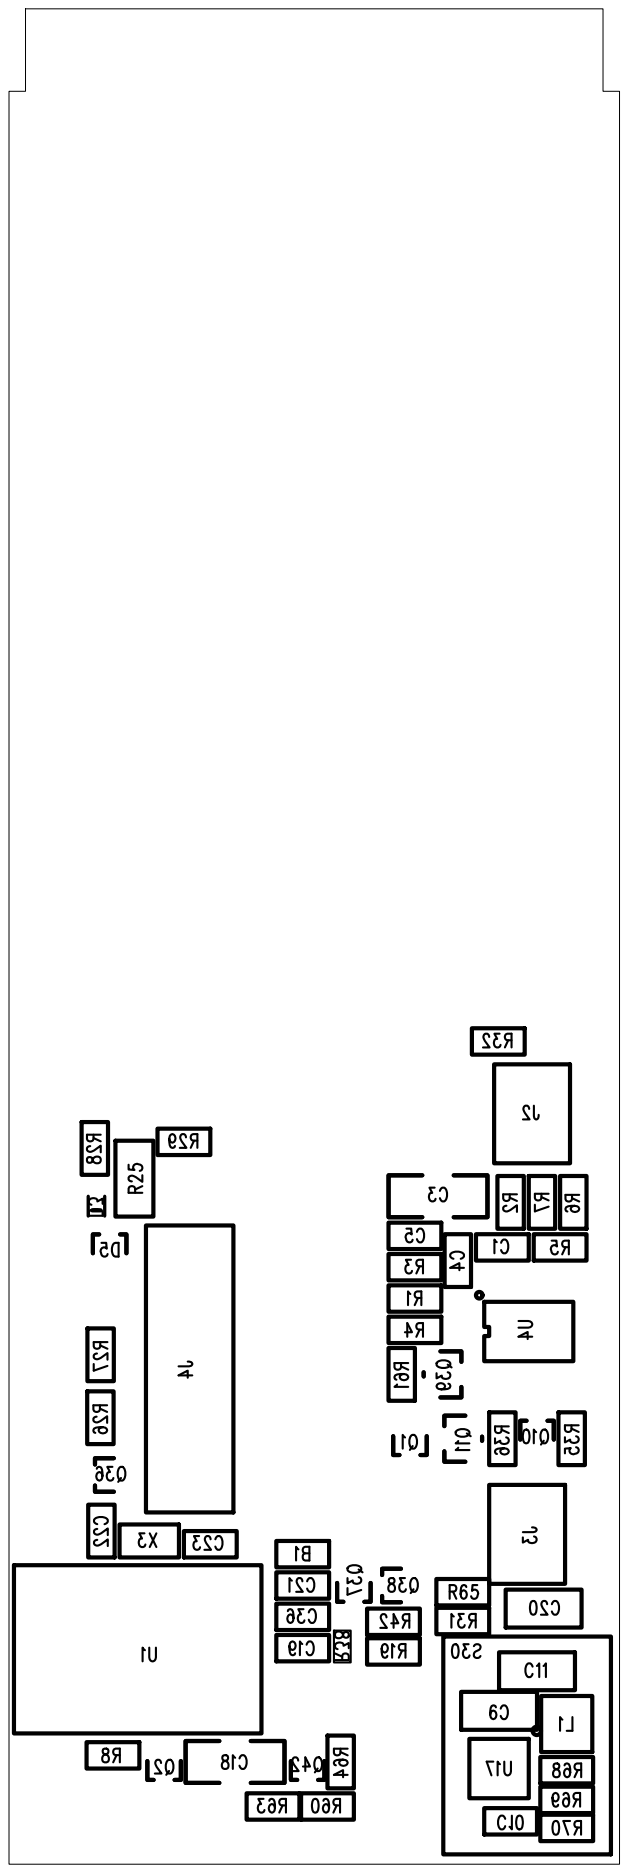
[picture p299: page 2]

17.50mm | 17.50mm
3.00mm ¹².50mm | 14.00mm ⁶.25mm 14.00mm 5.63mm

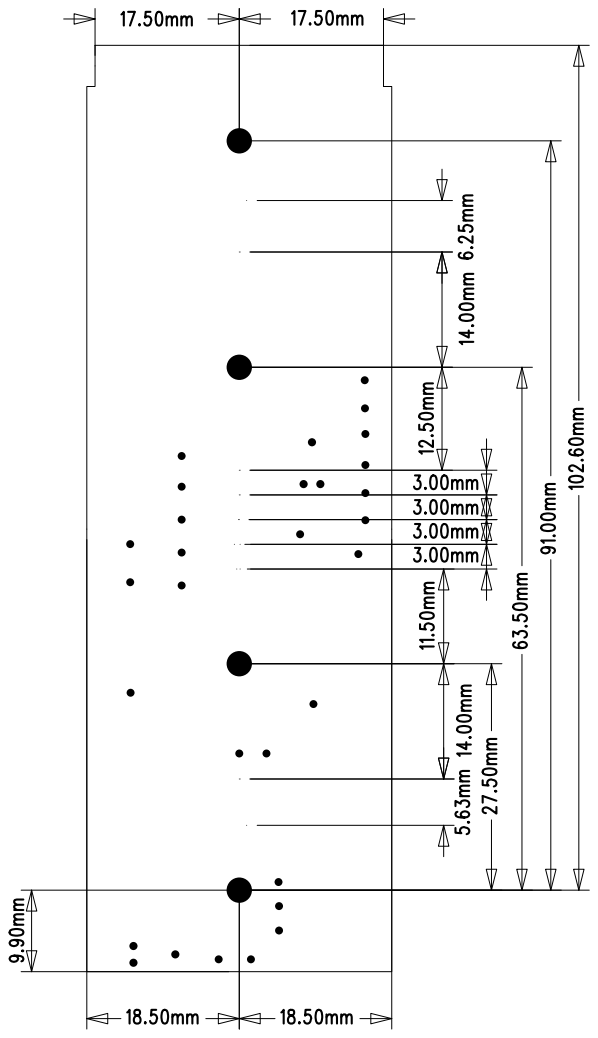
[picture p300: page 3]
