binphilxiao/AxisLabs/GR0102/Certification/Doc provided/Submitted/SmartShade Schematics.pdf

D

6 | 5 | 4 | 3 | 2 | 1

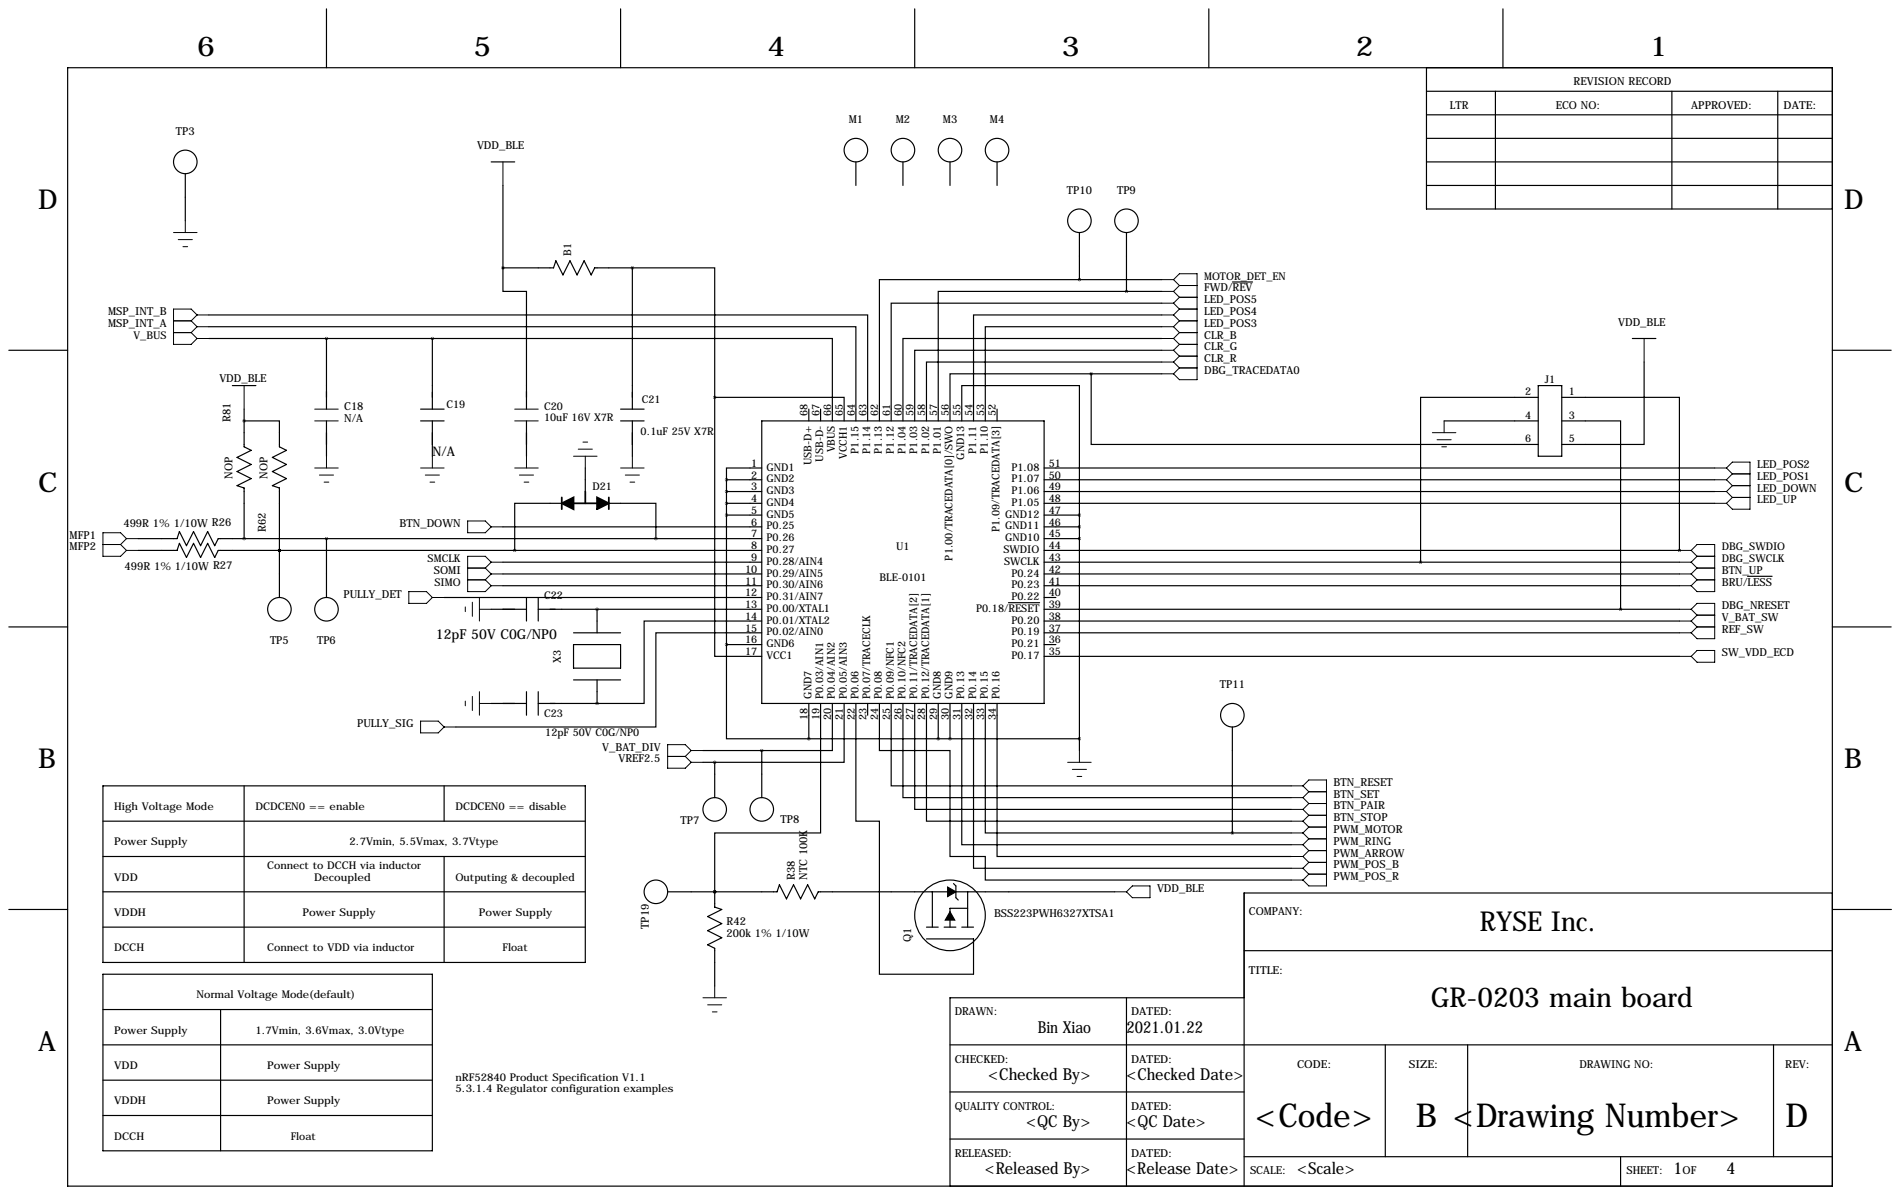
[picture p301: page 1]

REVISION RECORD

LTR | ECO NO: | APPROVED: | DATE:

High Voltage Mode | DCDCEN0 == enable | DCDCEN0 == disable

Power Supply | 2.7Vmin, 5.5Vmax, 3.7Vtype

VDD | Connect to DCCH via inductor Decoupled | Outputing & decoupled

Connect to VDD via inductor

Normal Voltage Mode(default)

DRAWN: Bin Xiao | DATED: 2021.01.22

Power Supply | 1.7Vmin, 3.6Vmax, 3.0Vtype

VDDH | Power Supply

QUALITY CONTROL: <QC By> | DATED: <QC Date>

DCCH | Float

RELEASED: <Released By> | DATED: <Release Date>

<Scale> SCALE: | 1 4 SHEET: OF

D

D

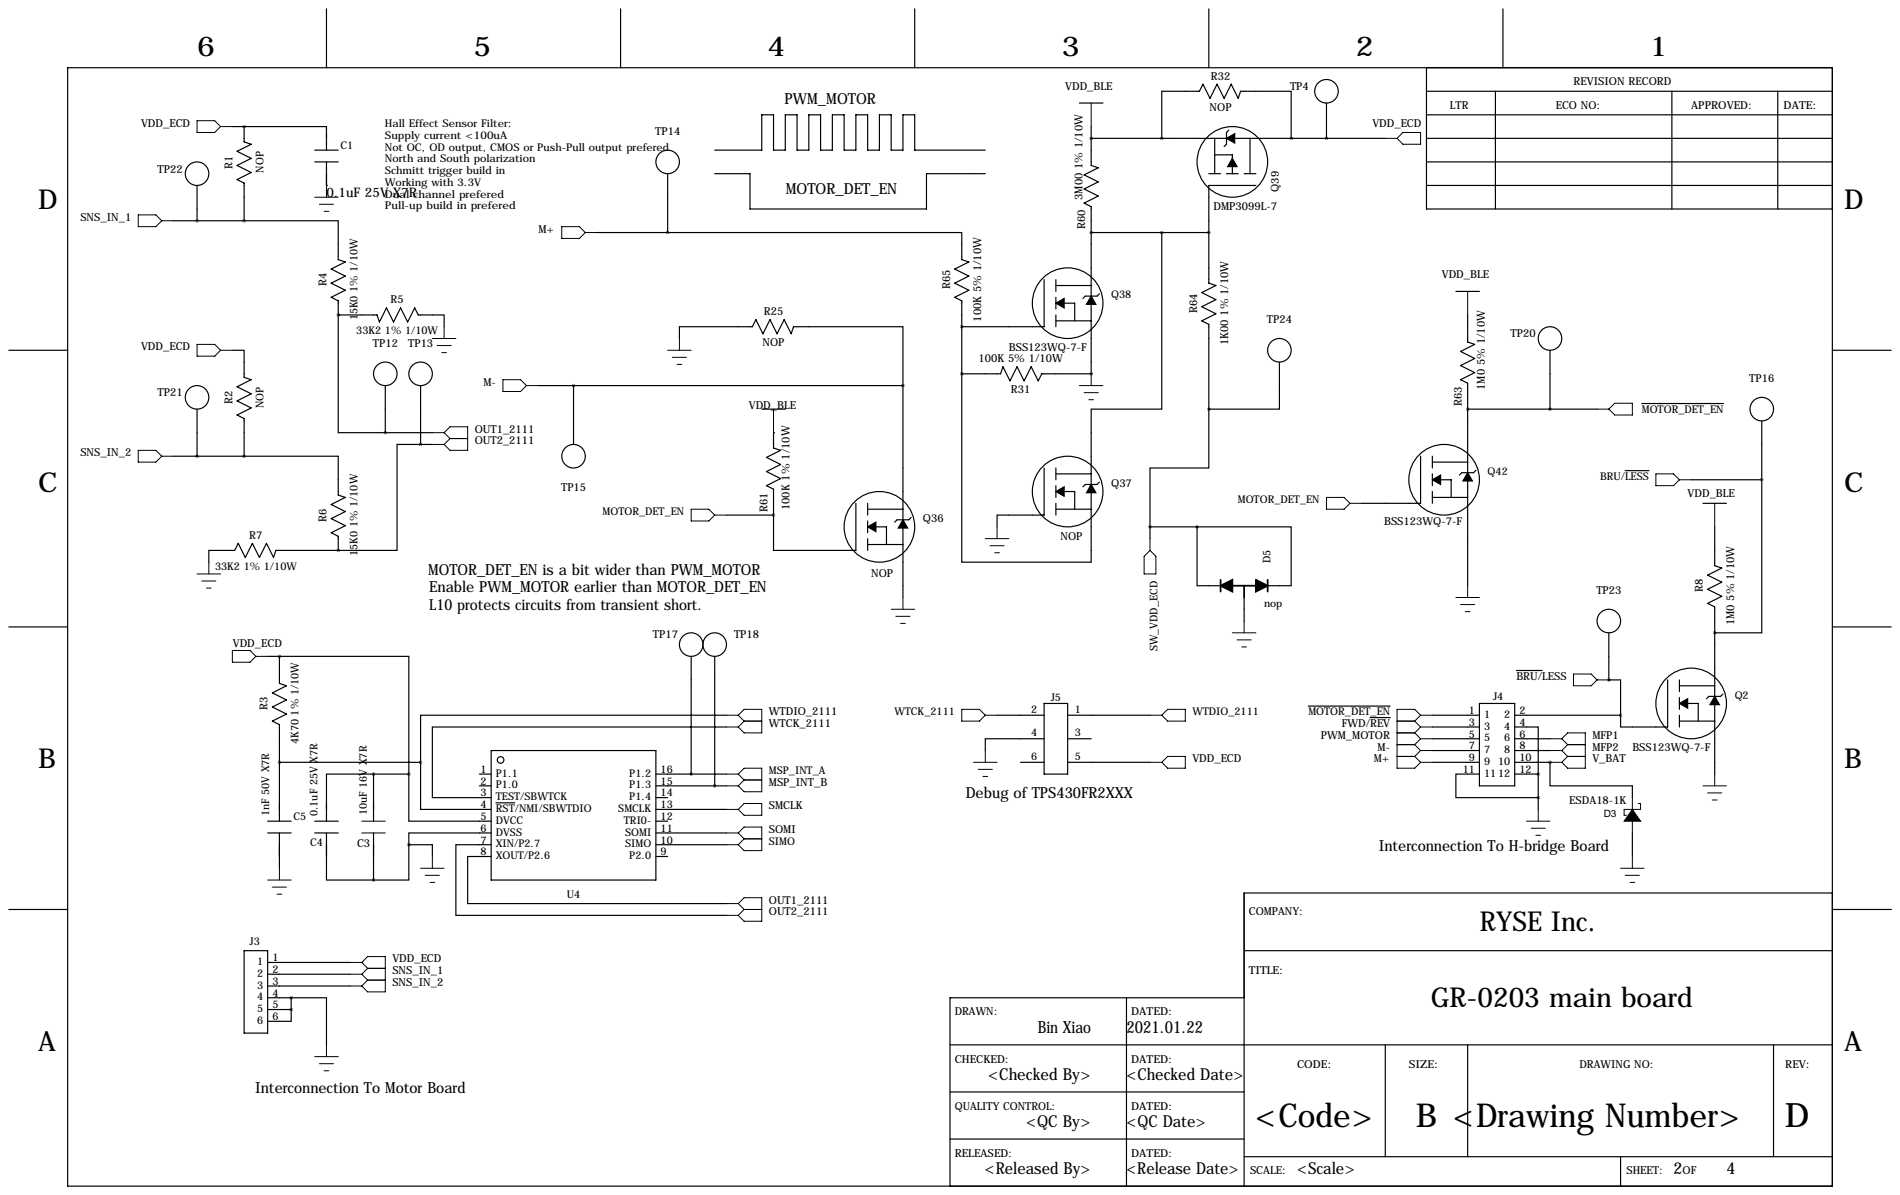
[picture p302: page 2]

R32 TP4 | REVISION RECORD

LTR | ECO NO: | APPROVED: | DATE:

Hall Effect Sensor Filter:
Supply current <100uA
Not OC, OD output, CMOS or Push-Pull output prefered
North and South polarization
Schmitt trigger build in
Working with 3.3V
Dual channel prefered
Pull-up build in prefered

MOTOR_DET_EN is a bit wider than PWM_MOTOR
Enable PWM_MOTOR earlier than MOTOR_DET_EN
L10 protects circuits from transient short.

Interconnection To H-bridge Board

CHECKED: <Checked By> | DATED: <Checked Date> | CODE: <Code> | SIZE: B <Drawing Number> | DRAWING NO: | REV: D

Interconnection To Motor Board

QUALITY CONTROL: <QC By> | DATED: <QC Date>

D

D

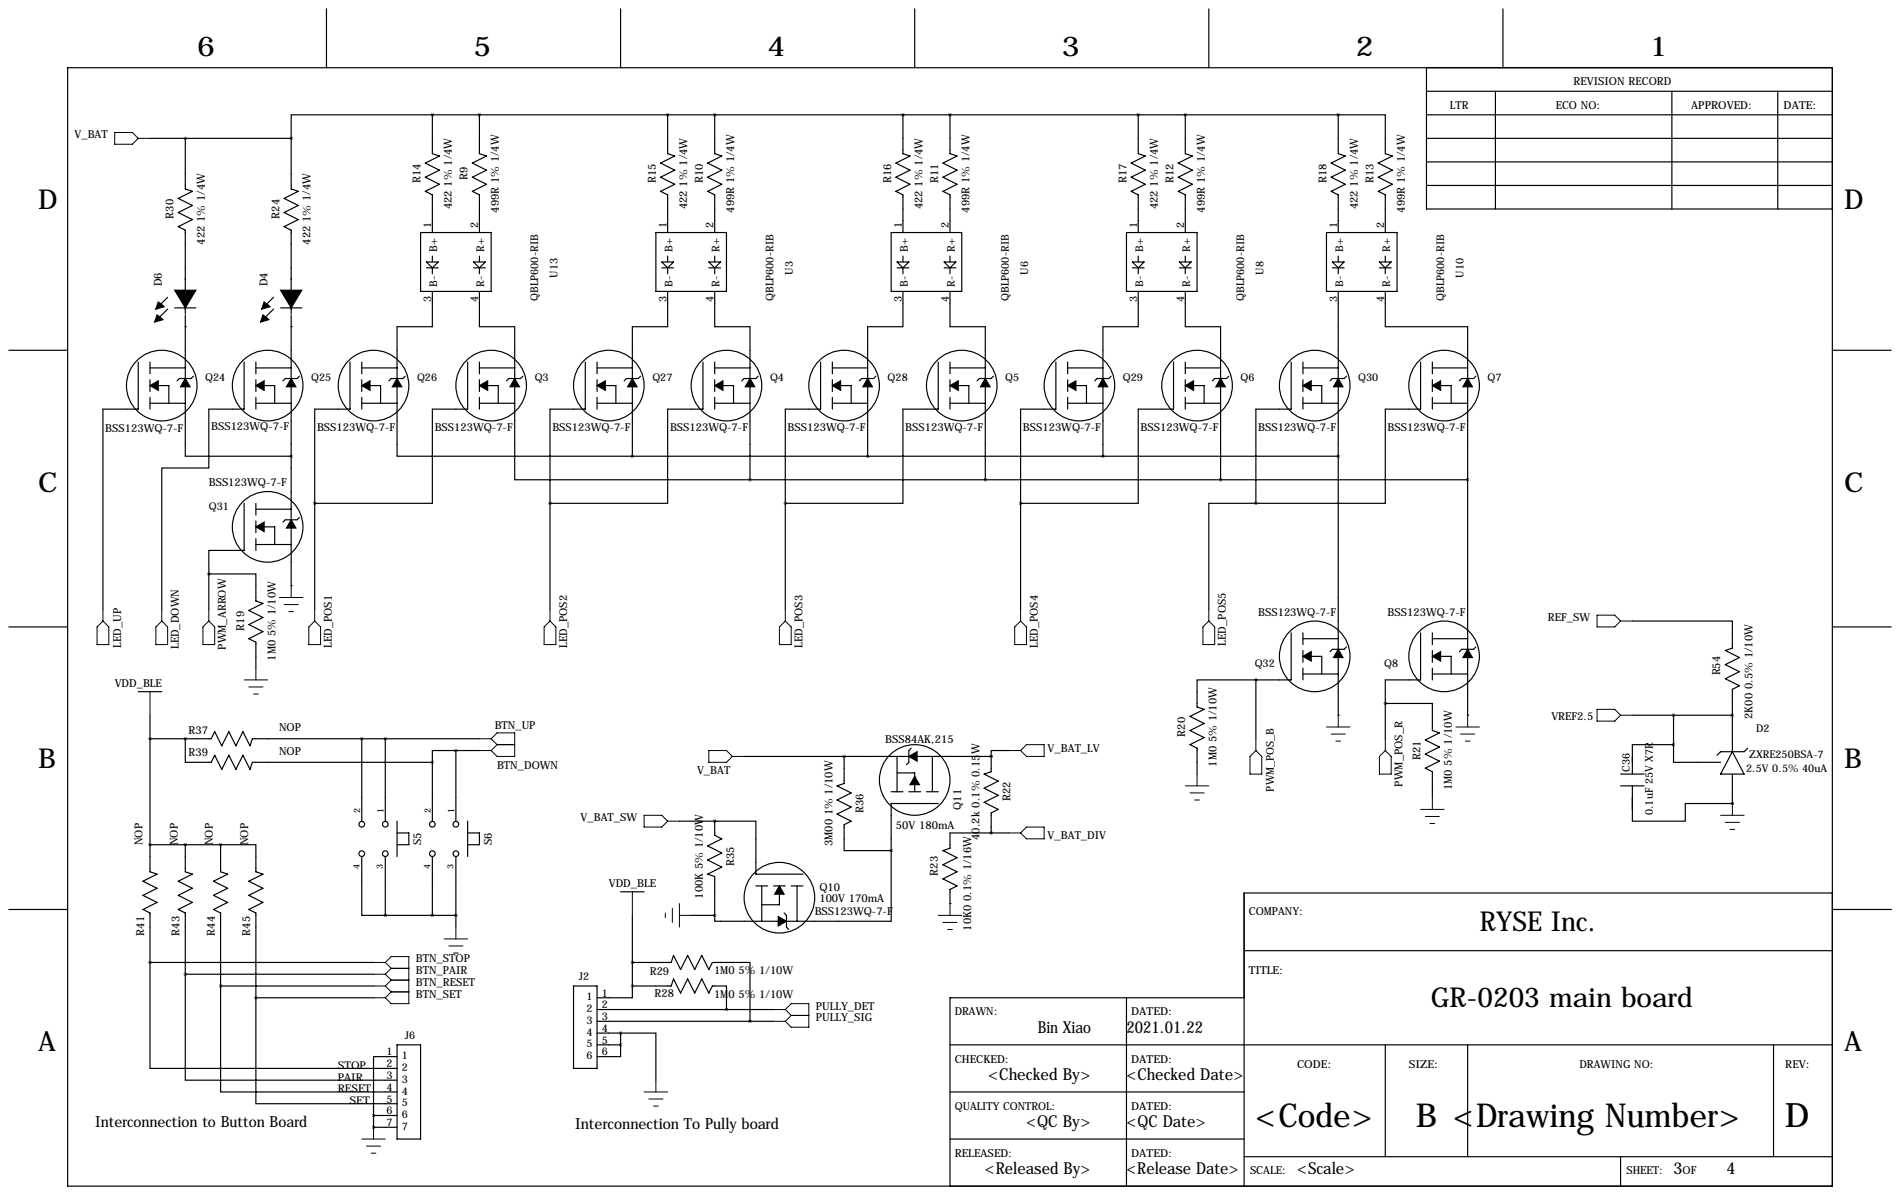
[picture p303: page 3]

REVISION RECORD

LTR | ECO NO: | APPROVED: | DATE:

D

D

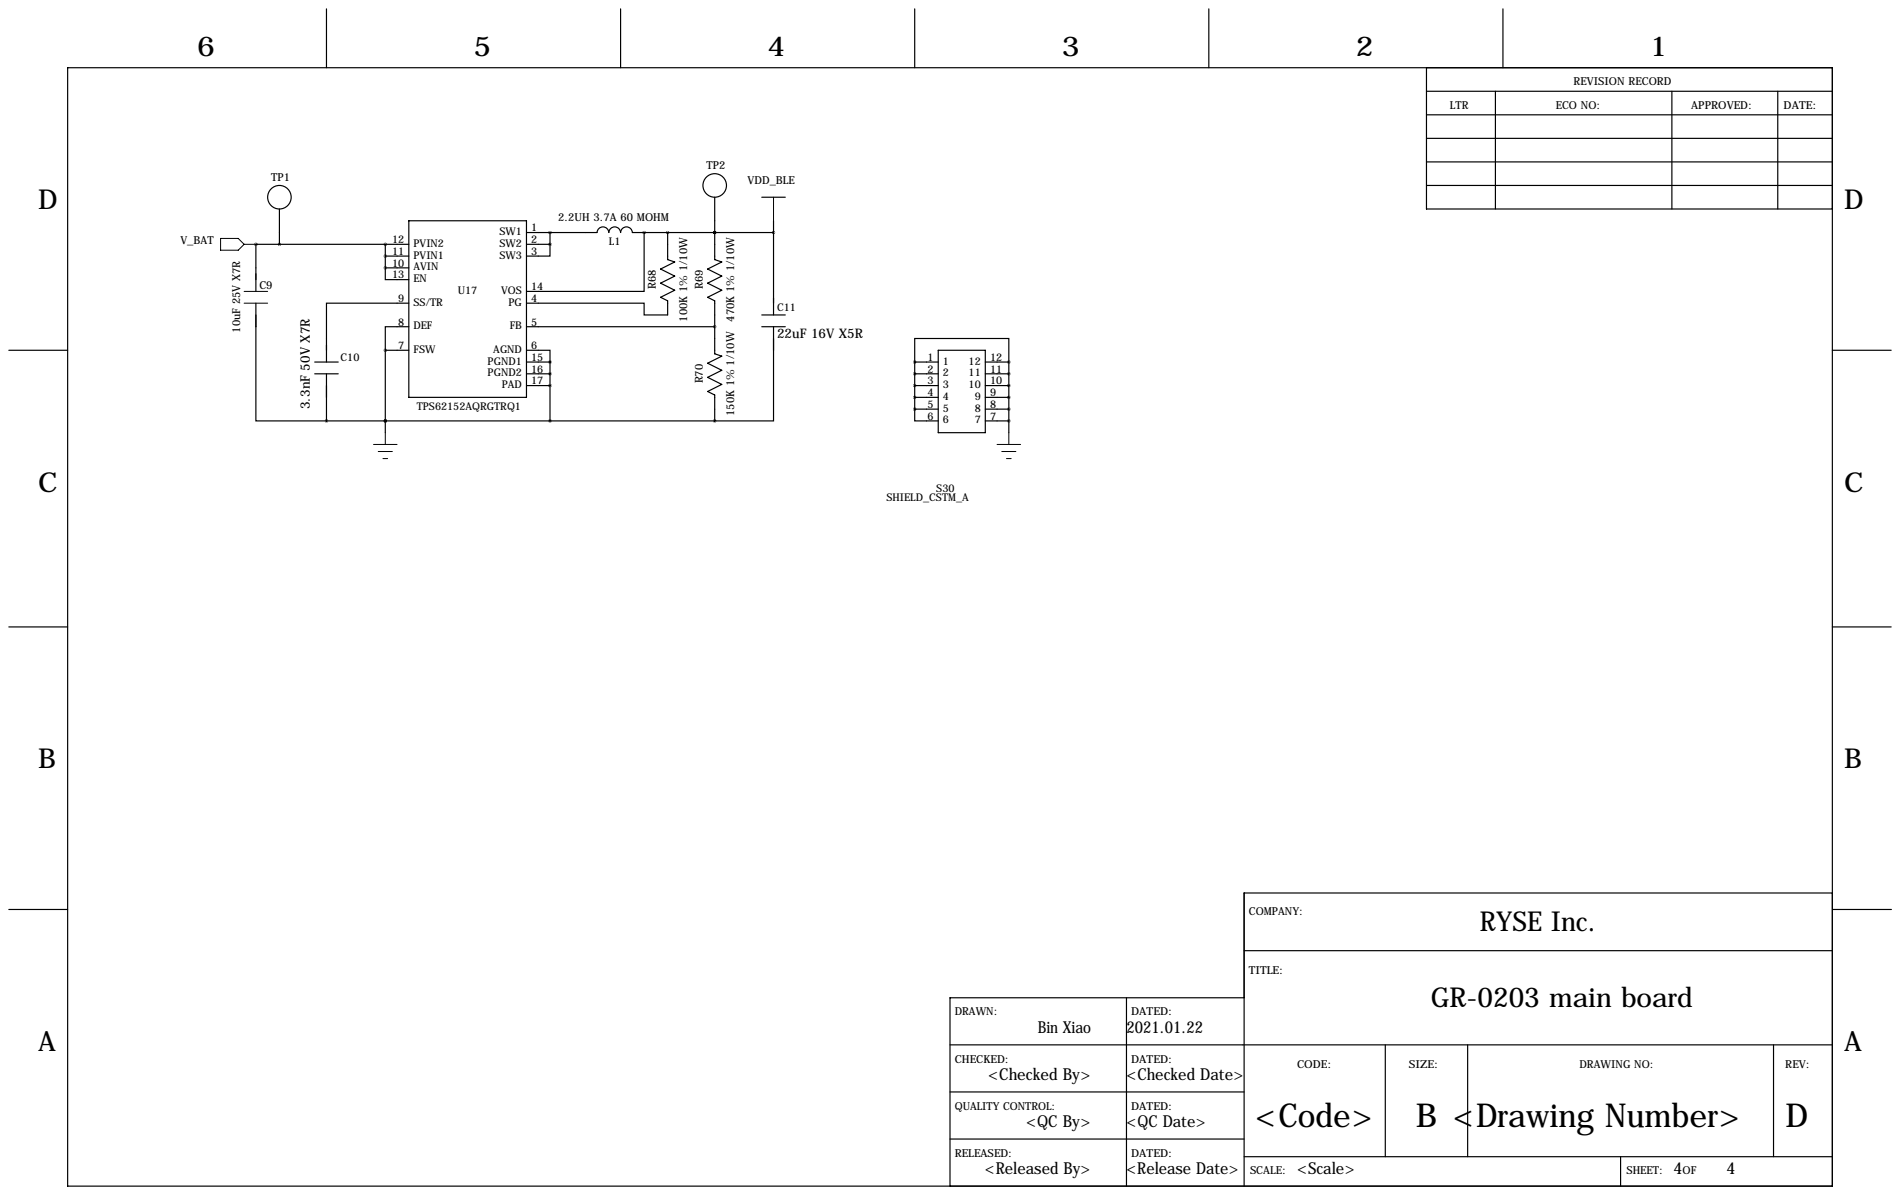
[picture p304: page 4]

REVISION RECORD

LTR | ECO NO: | APPROVED: | DATE:

DRAWN: Bin Xiao | DATED: 2021.01.22

CHECKED: <Checked By> | DATED: <Checked Date> | CODE: <Code> | SIZE: B <Drawing Number> | DRAWING NO: | REV: D

QUALITY CONTROL: <QC By> | DATED: <QC Date>
