binphilxiao/AxisLabs/BLE0201/Ref/nRF5340 Development Kit - Hardware files 2_0_0/PCA10095-nRF5340 Development Board 2_0_0/Schematic_Layout pdf files/PCA10095_Schematic_And_PCB.pdf

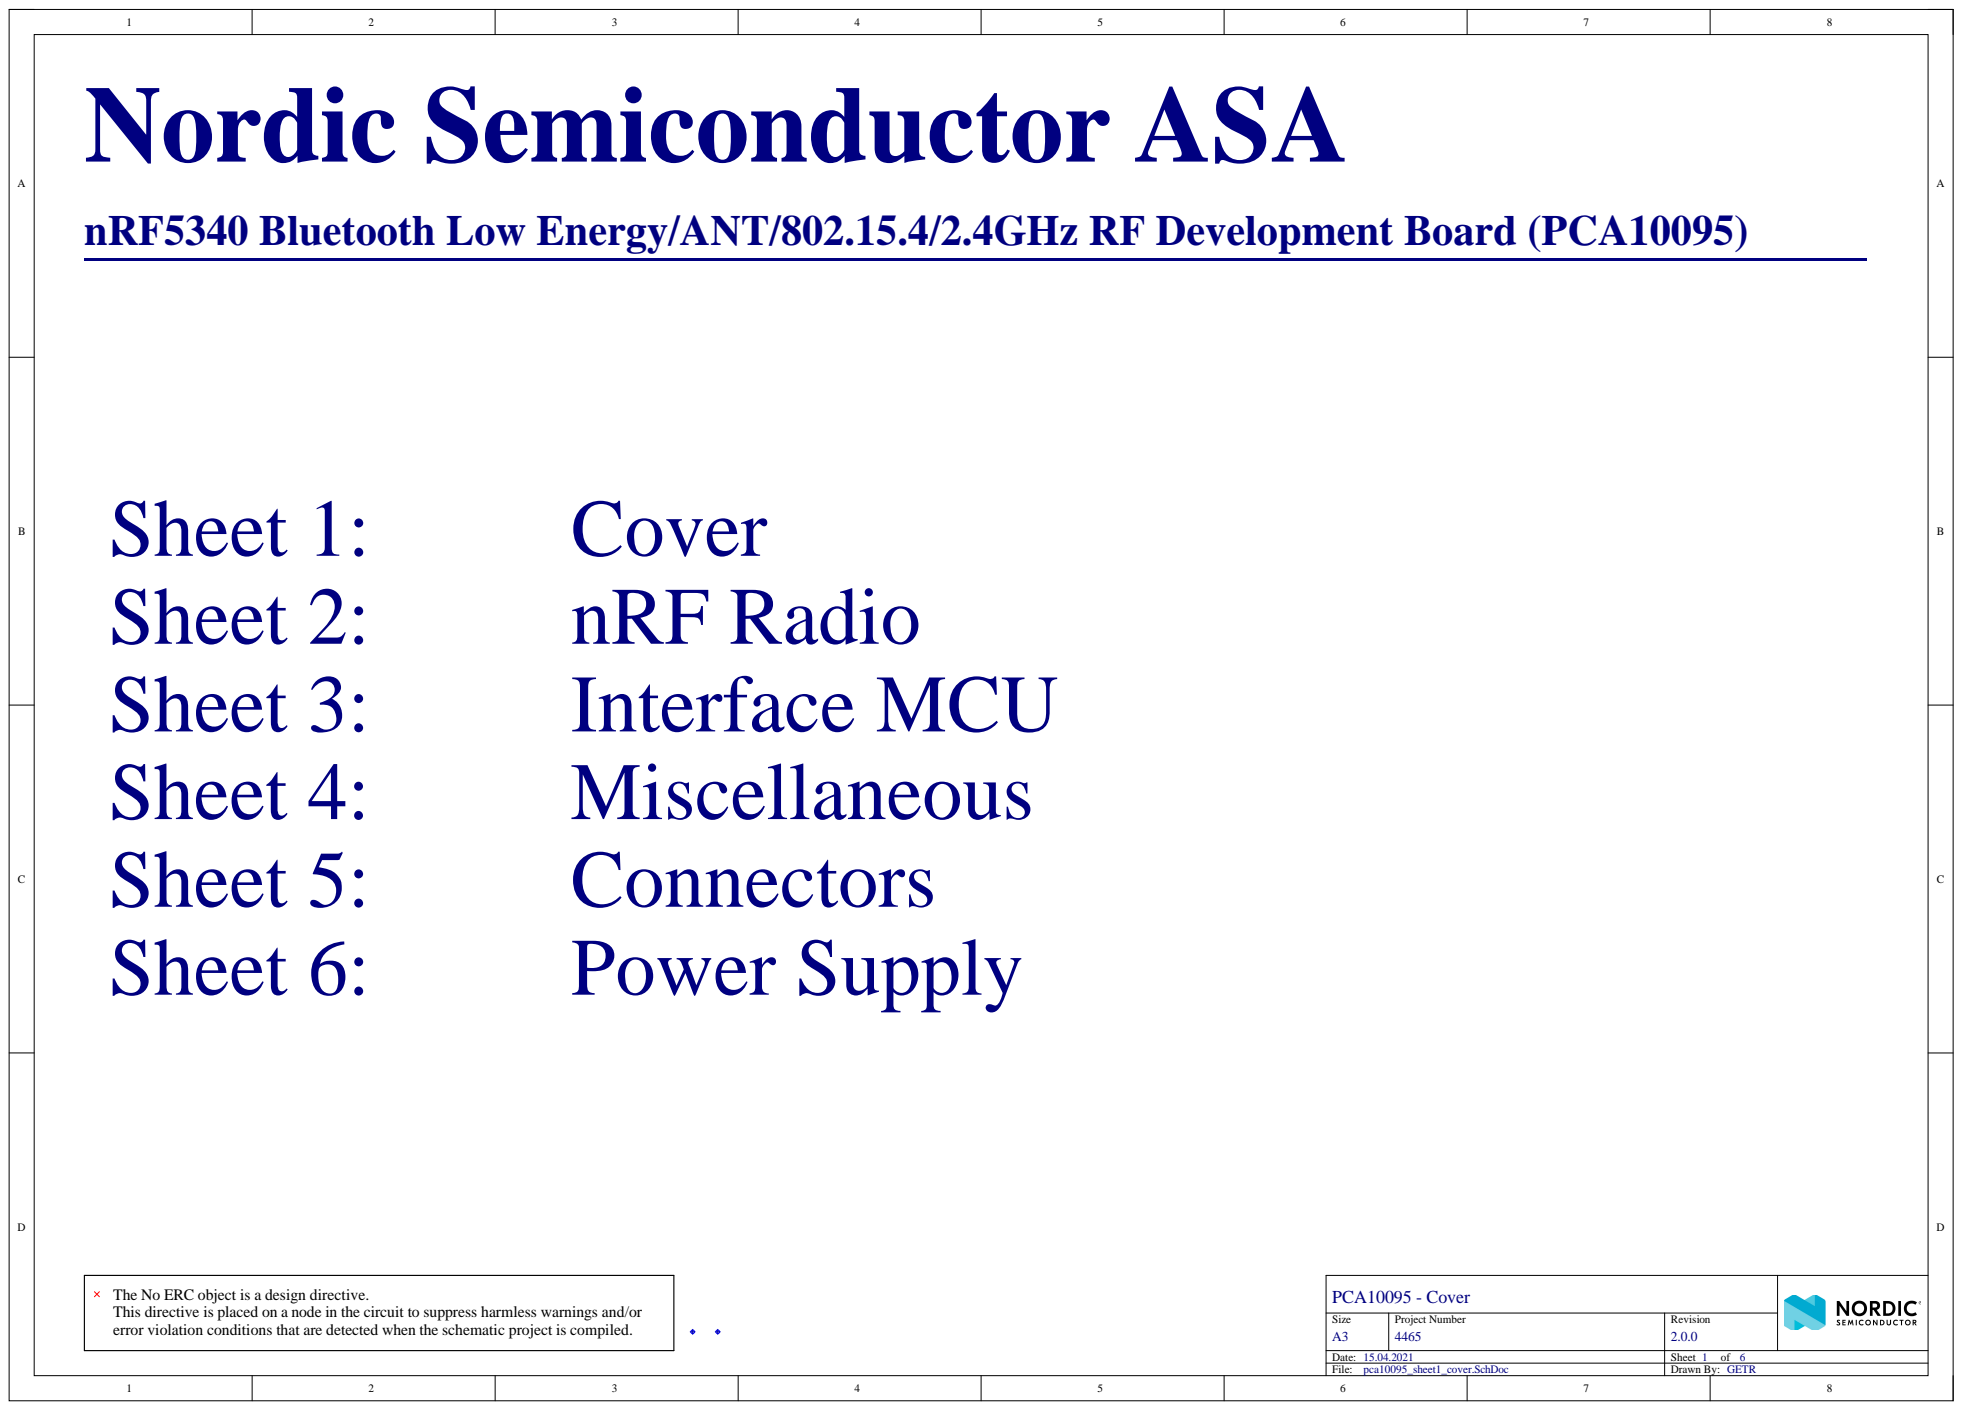
[picture p305: page 1]

nRF5340 Bluetooth Low Energy/ANT/802.15.4/2.4GHz RF ________________________________________________________________ Development Board (PCA10095)

The No ERC object is a design directive.
This directive is placed on a node in the circuit to suppress harmless warnings and/or
error violation conditions that are detected when the schematic project is compiled.

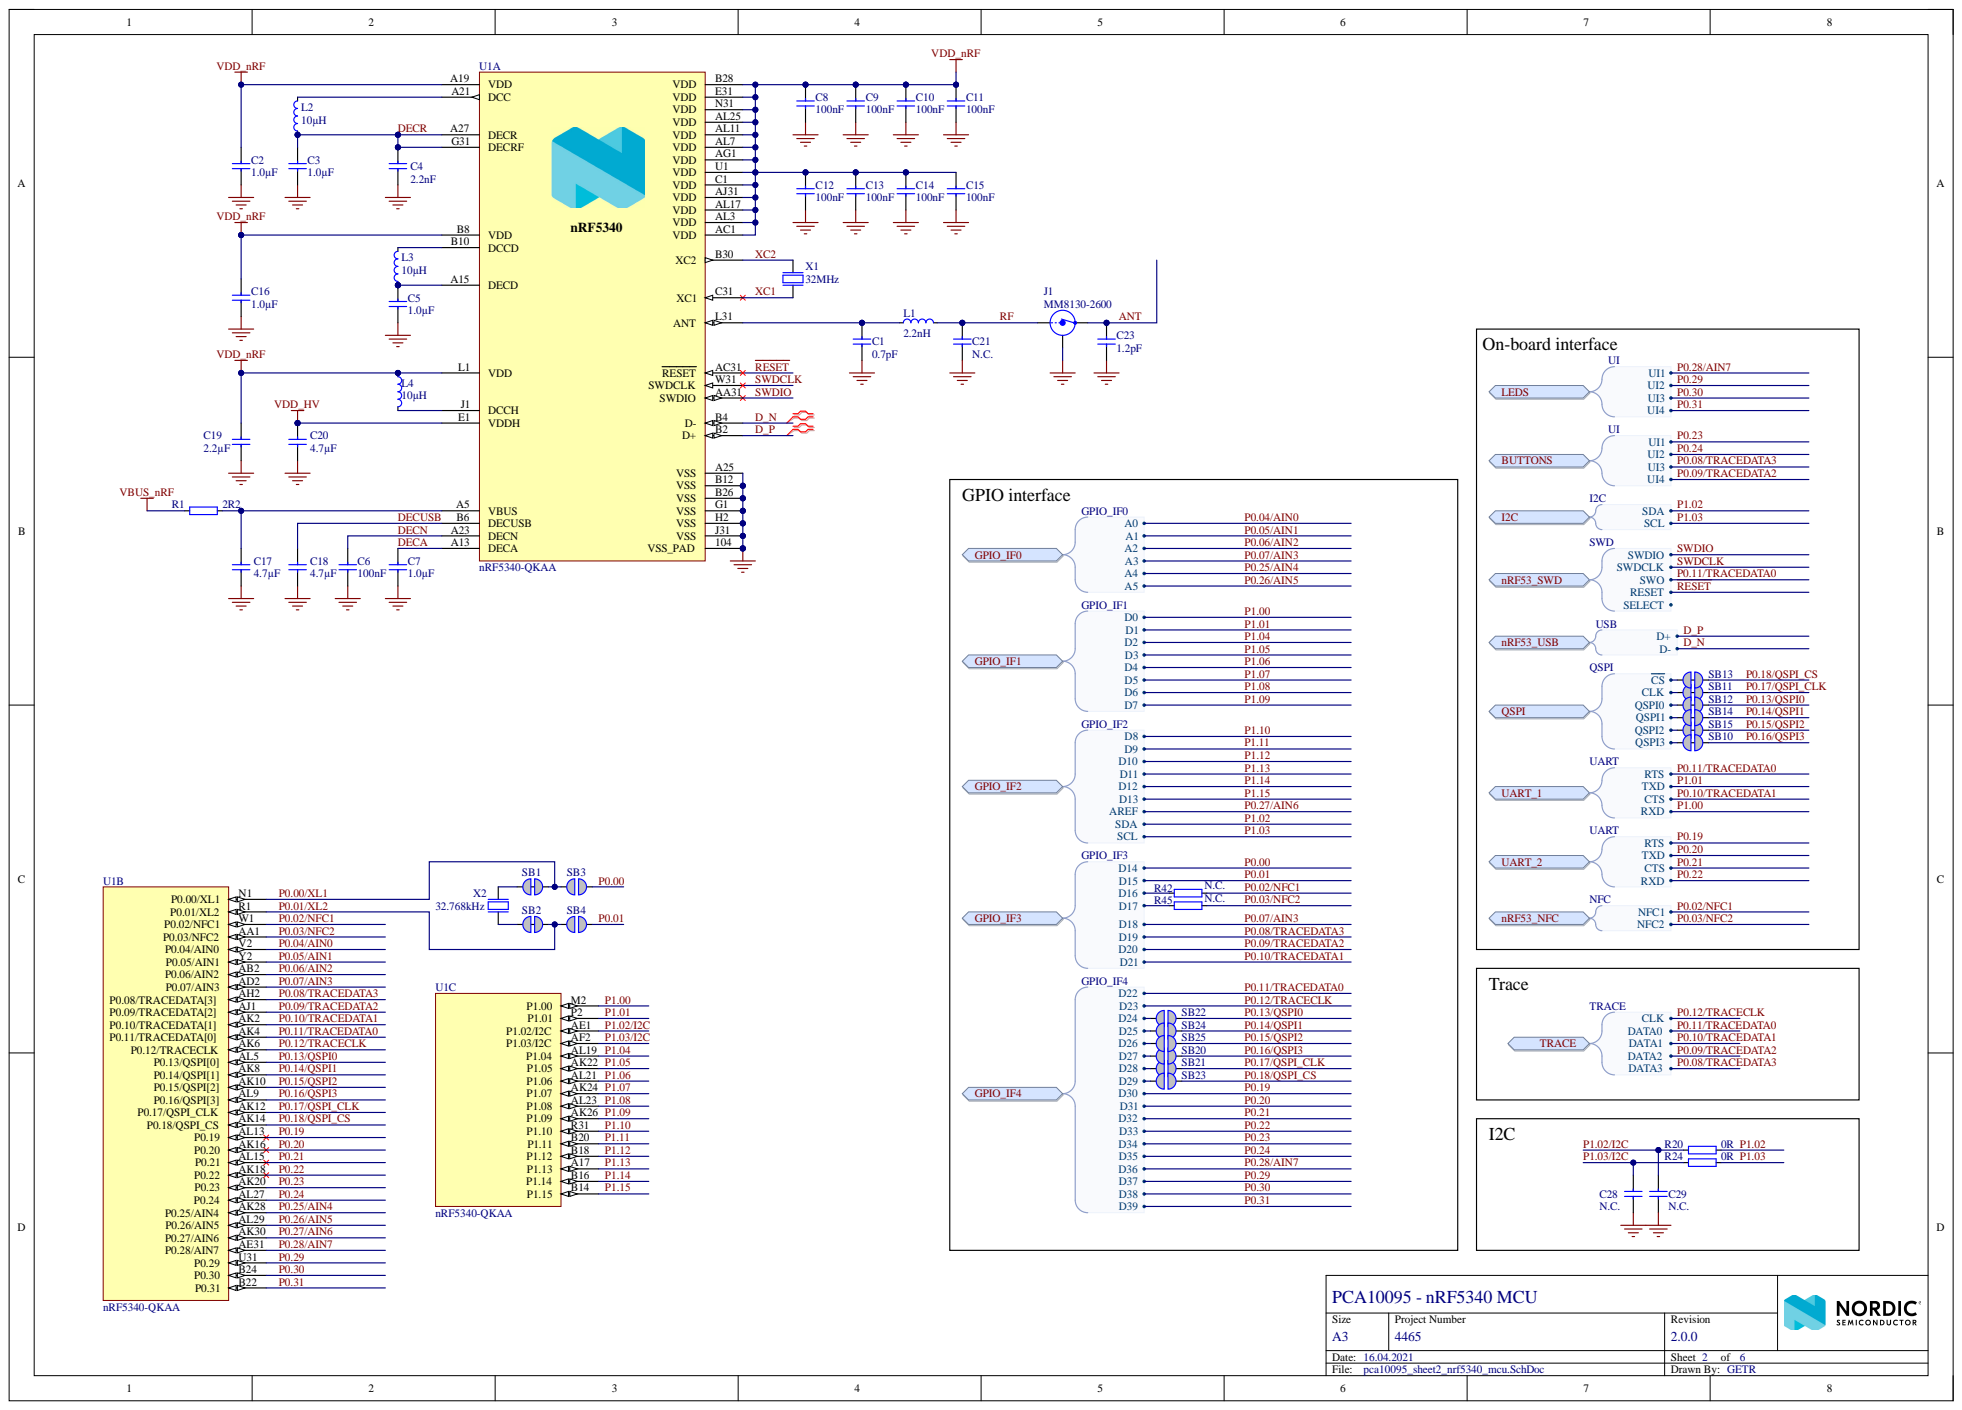
[picture p306: page 2]

DE C N | J 3 1
DE C A

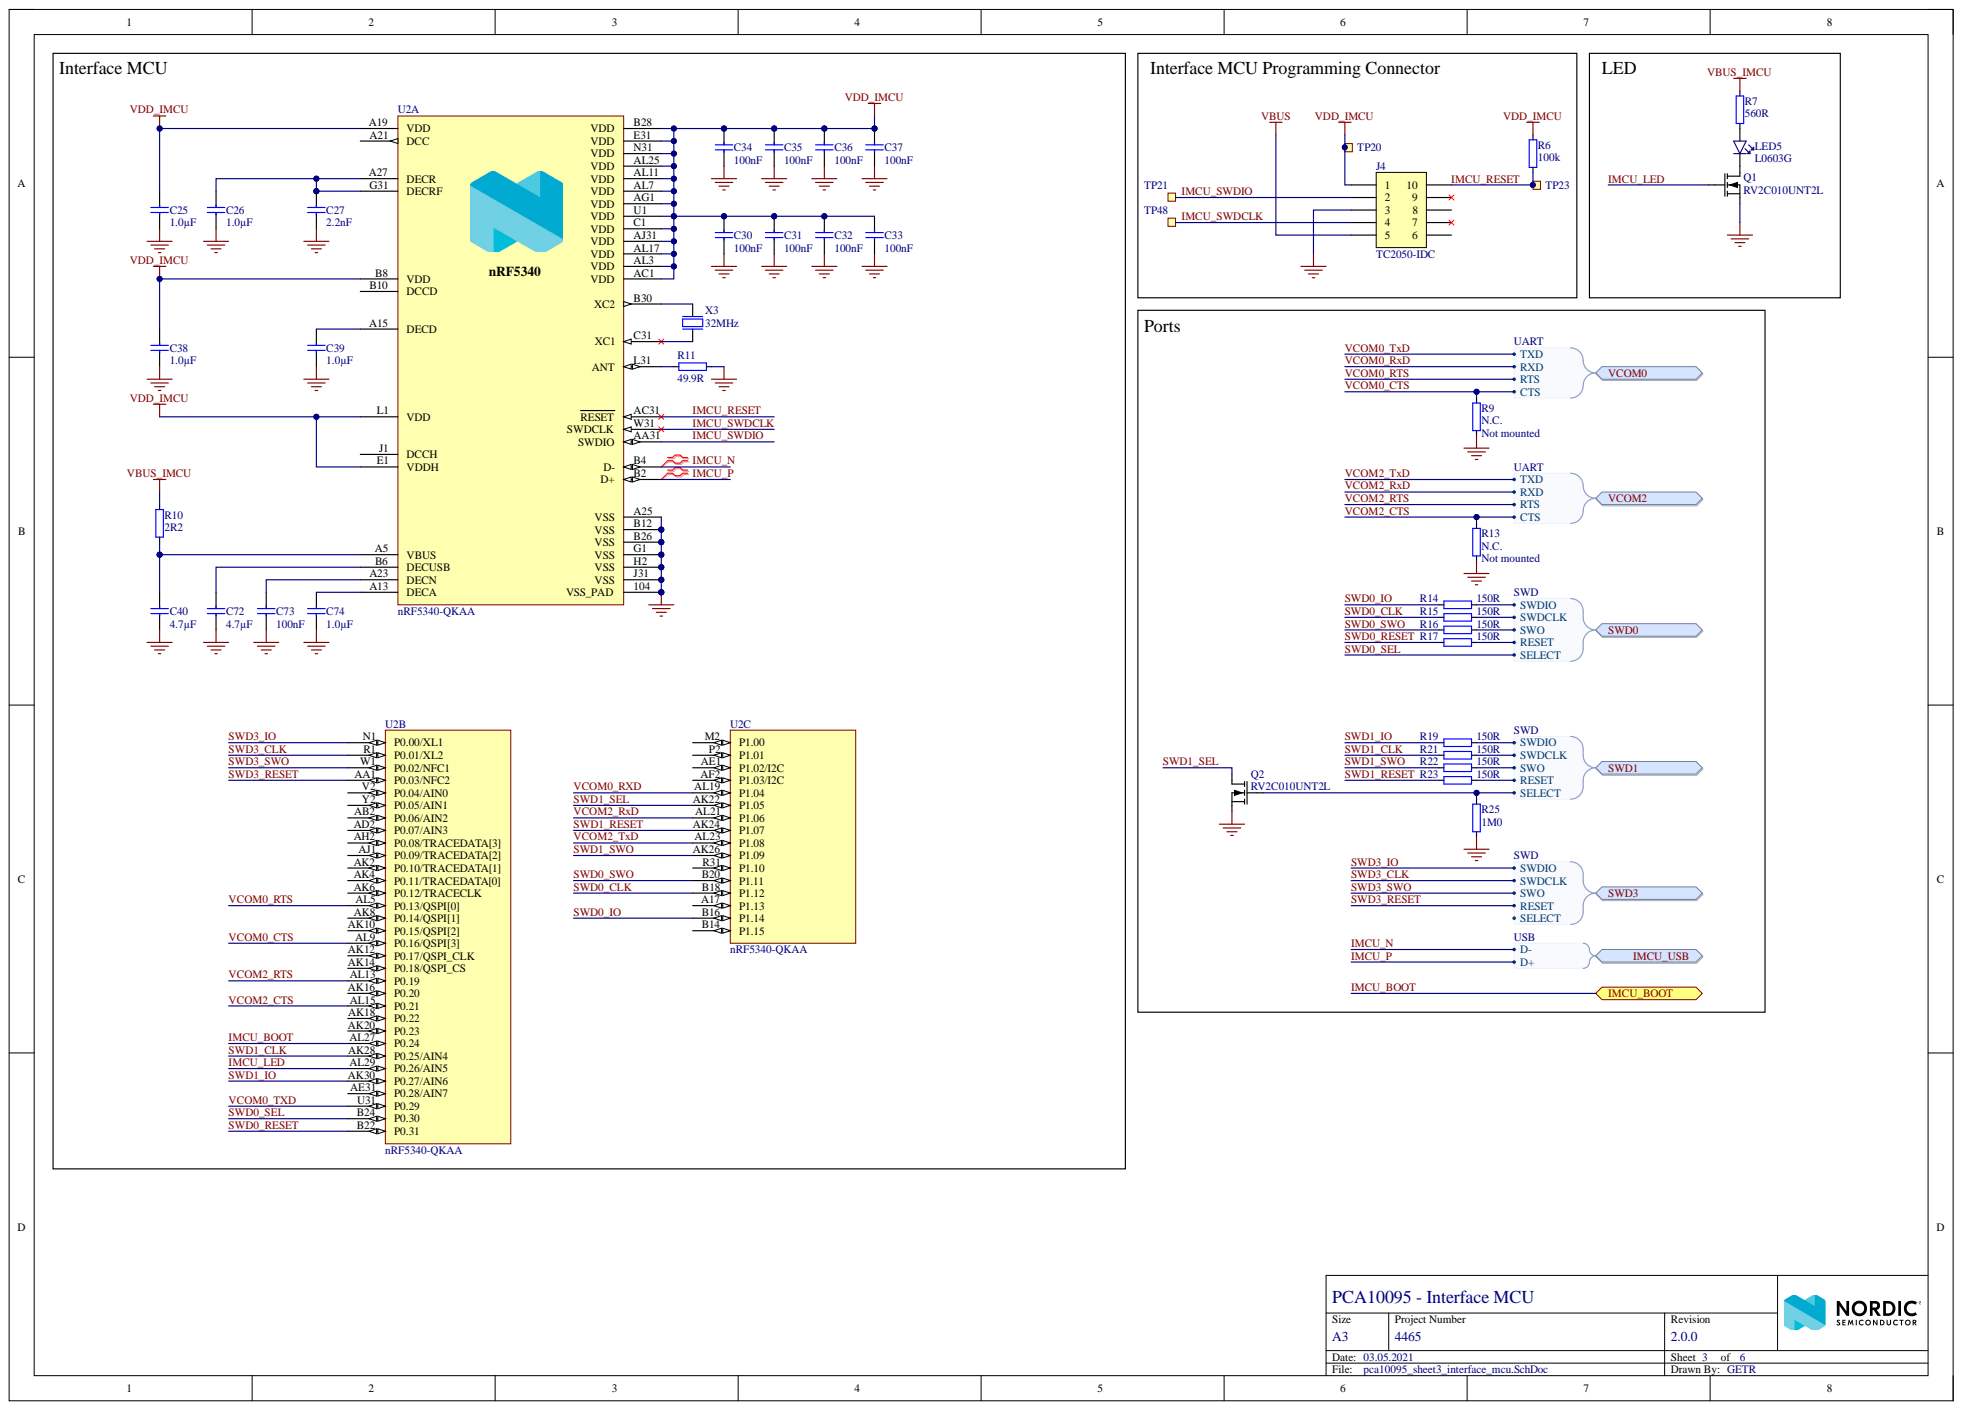
[picture p307: page 3]

Interface MCU Programming Connector

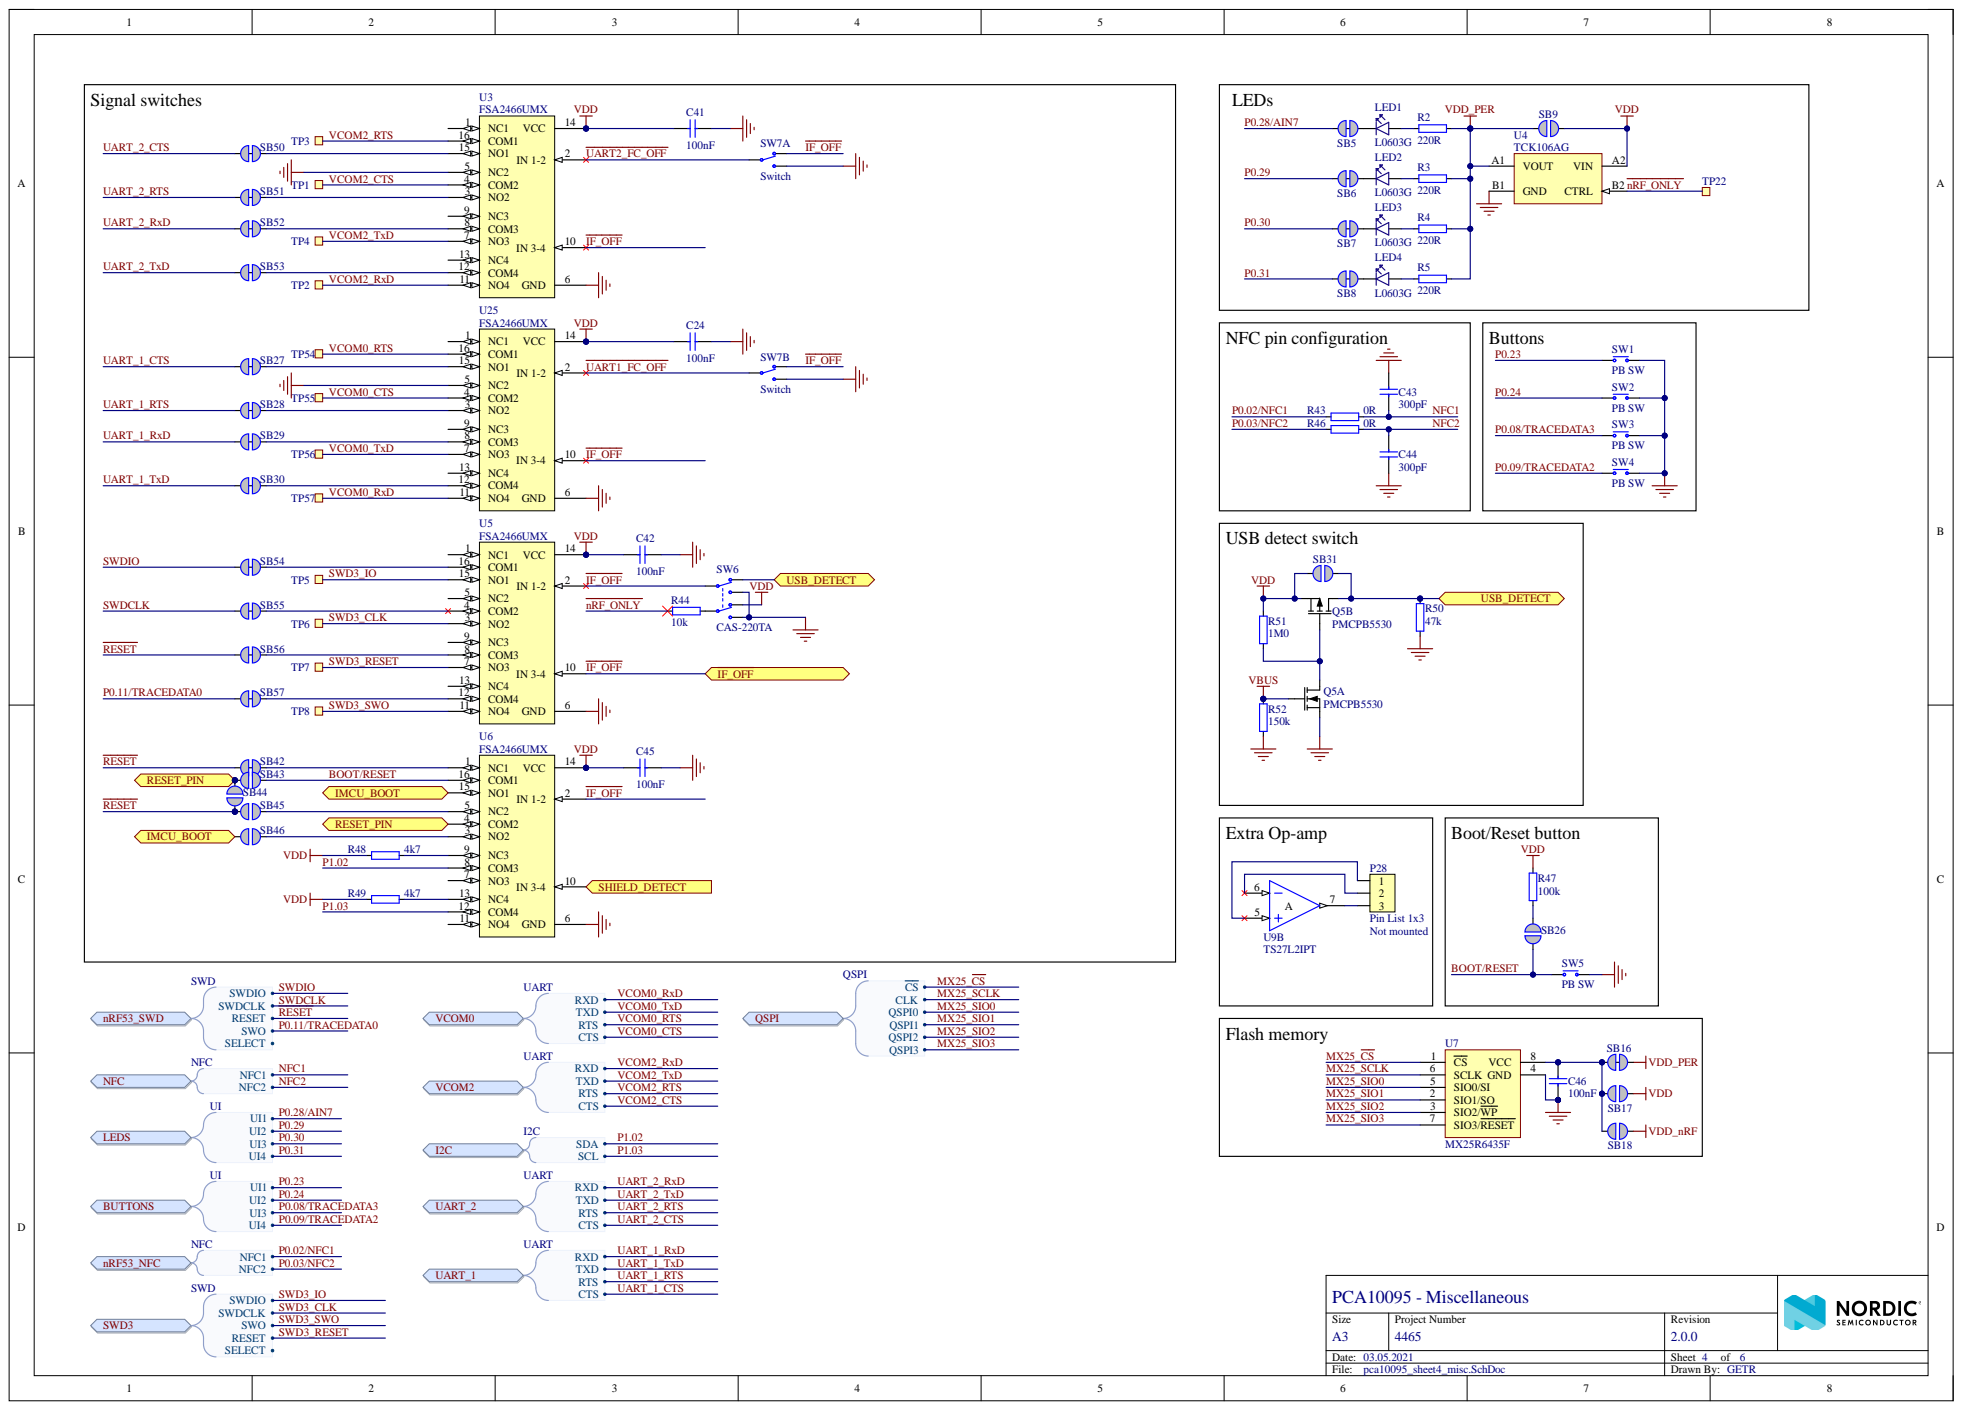
[picture p308: page 4]

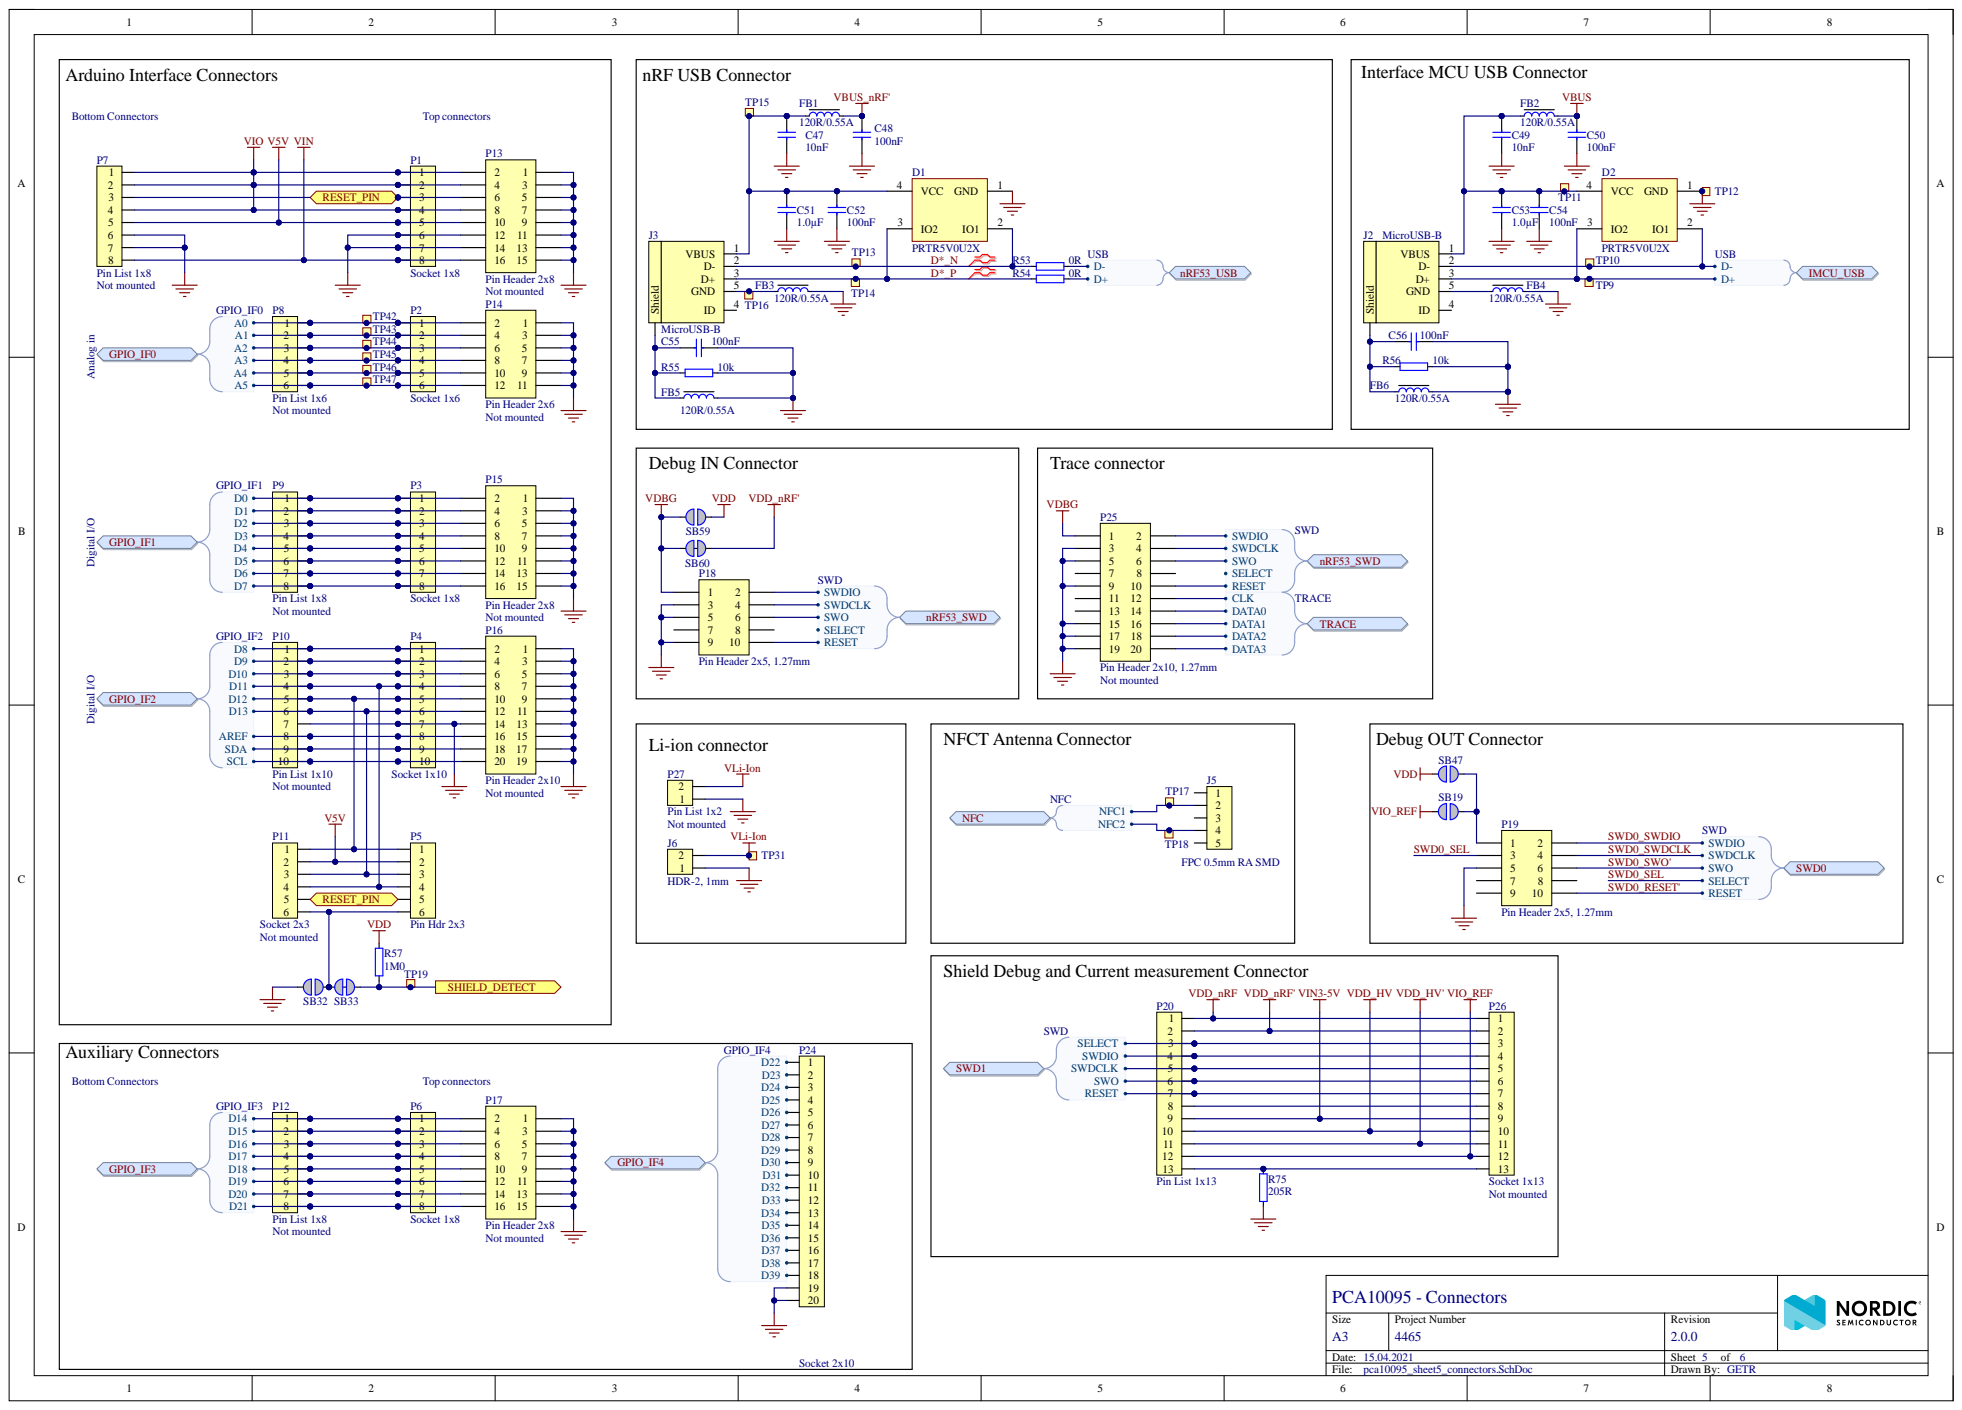
[picture p309: page 5]

Interface MCU USB Connector

6 7

Analog in Digital I/O Digital I/O
GPIO_IF0

6 7 | 6 7

5 6 | | 5 6

8 9 | | | 8 9

Shield Debug and Current measurement Connector

2 3 | 2 3

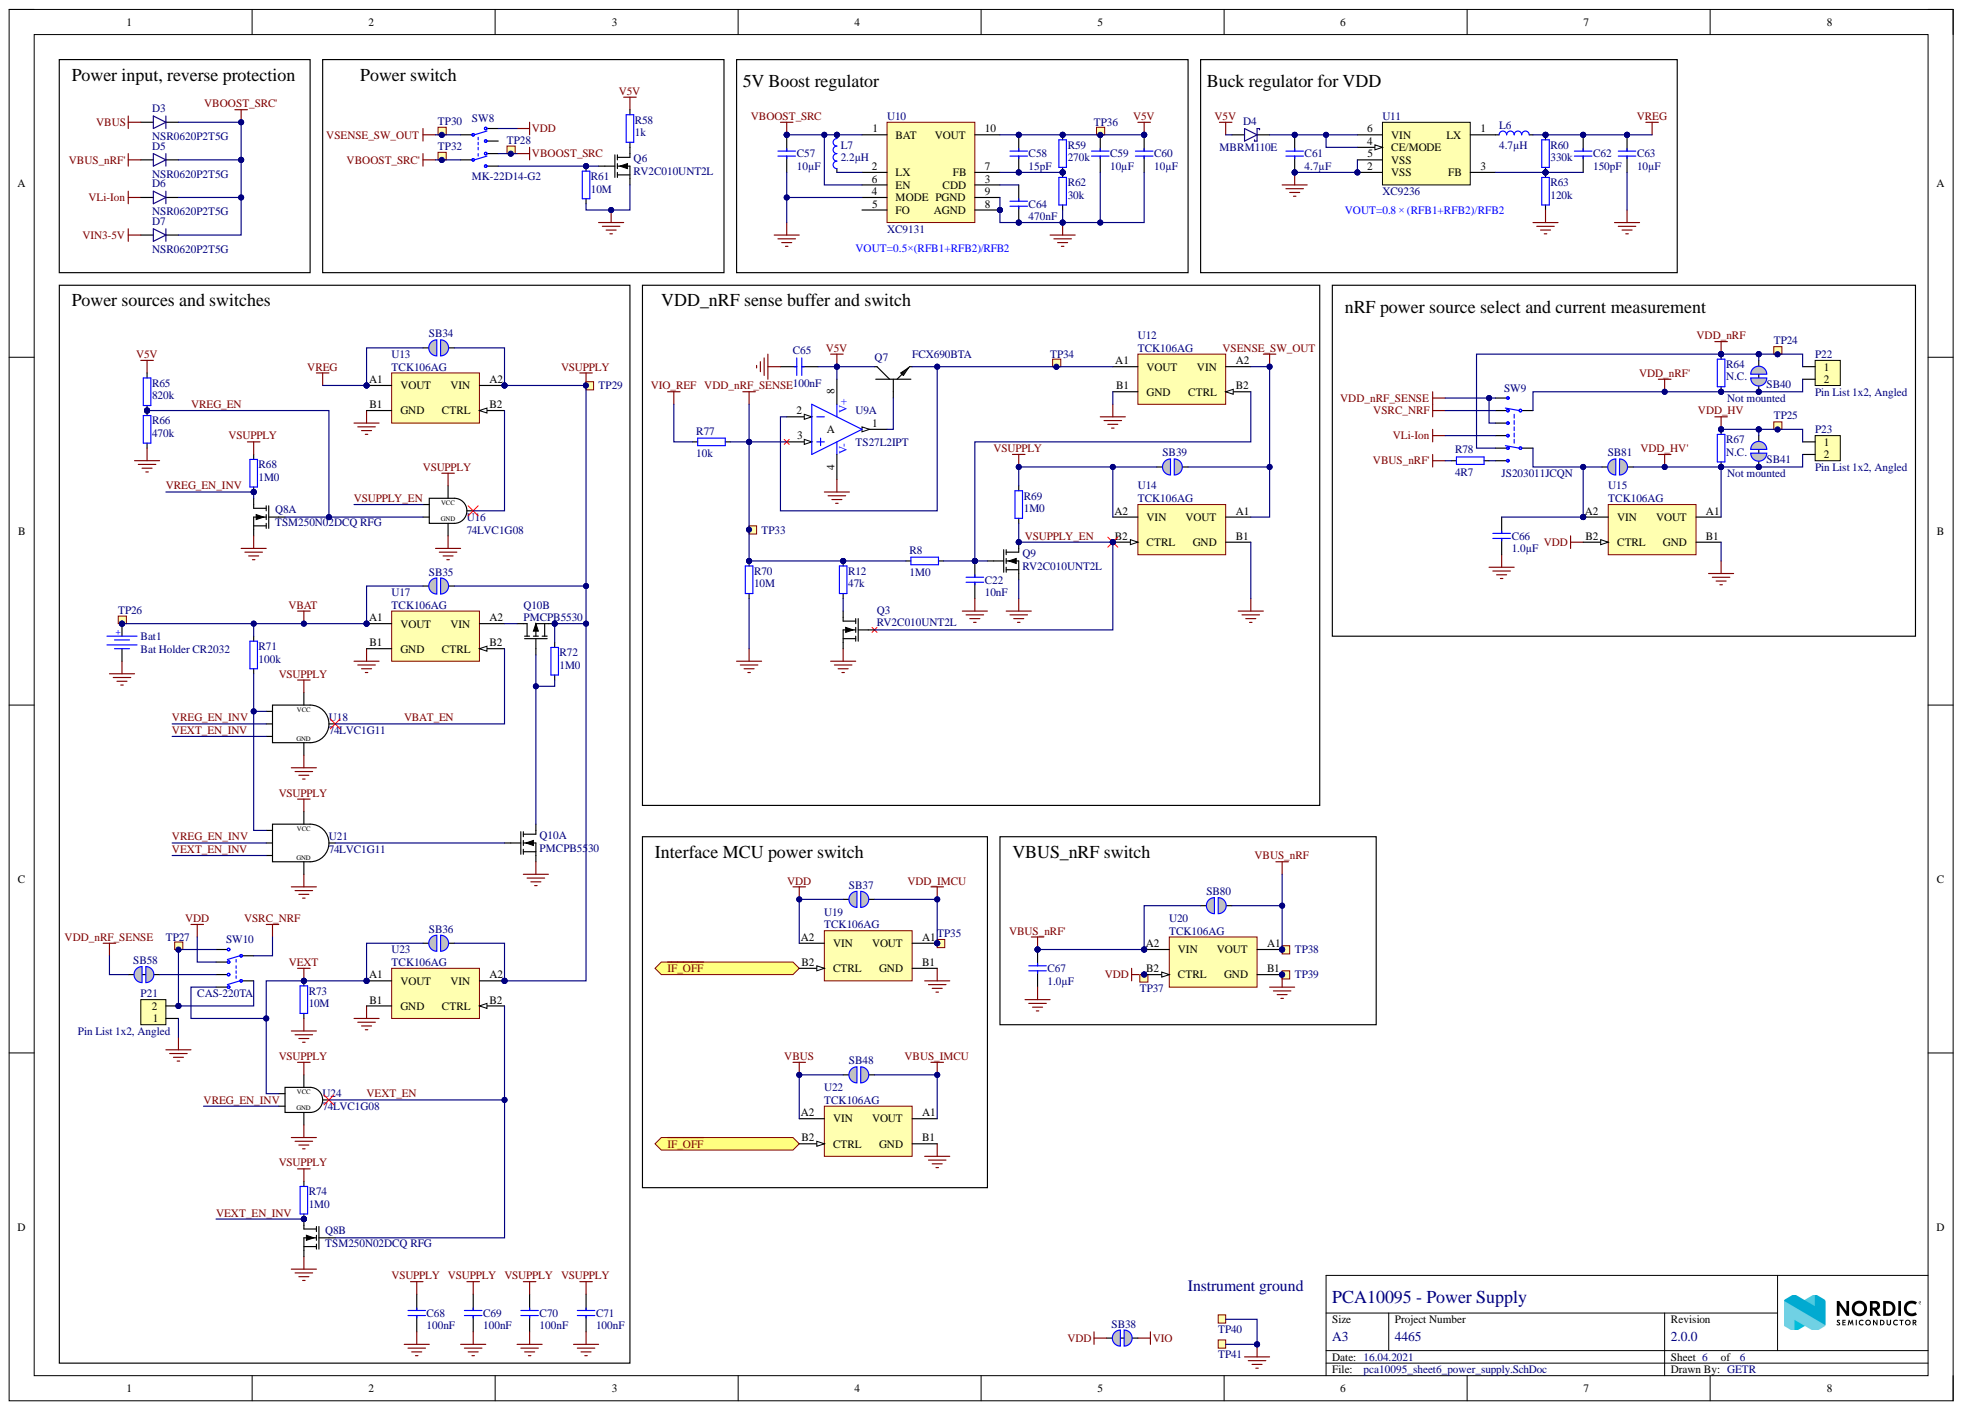
[picture p310: page 6]

Power input, reverse protection

Buck regulator for VDD

Power sources and switches

VDD_nRF sense buffer and switch

nRF power source select and current measurement

Interface MCU power switch

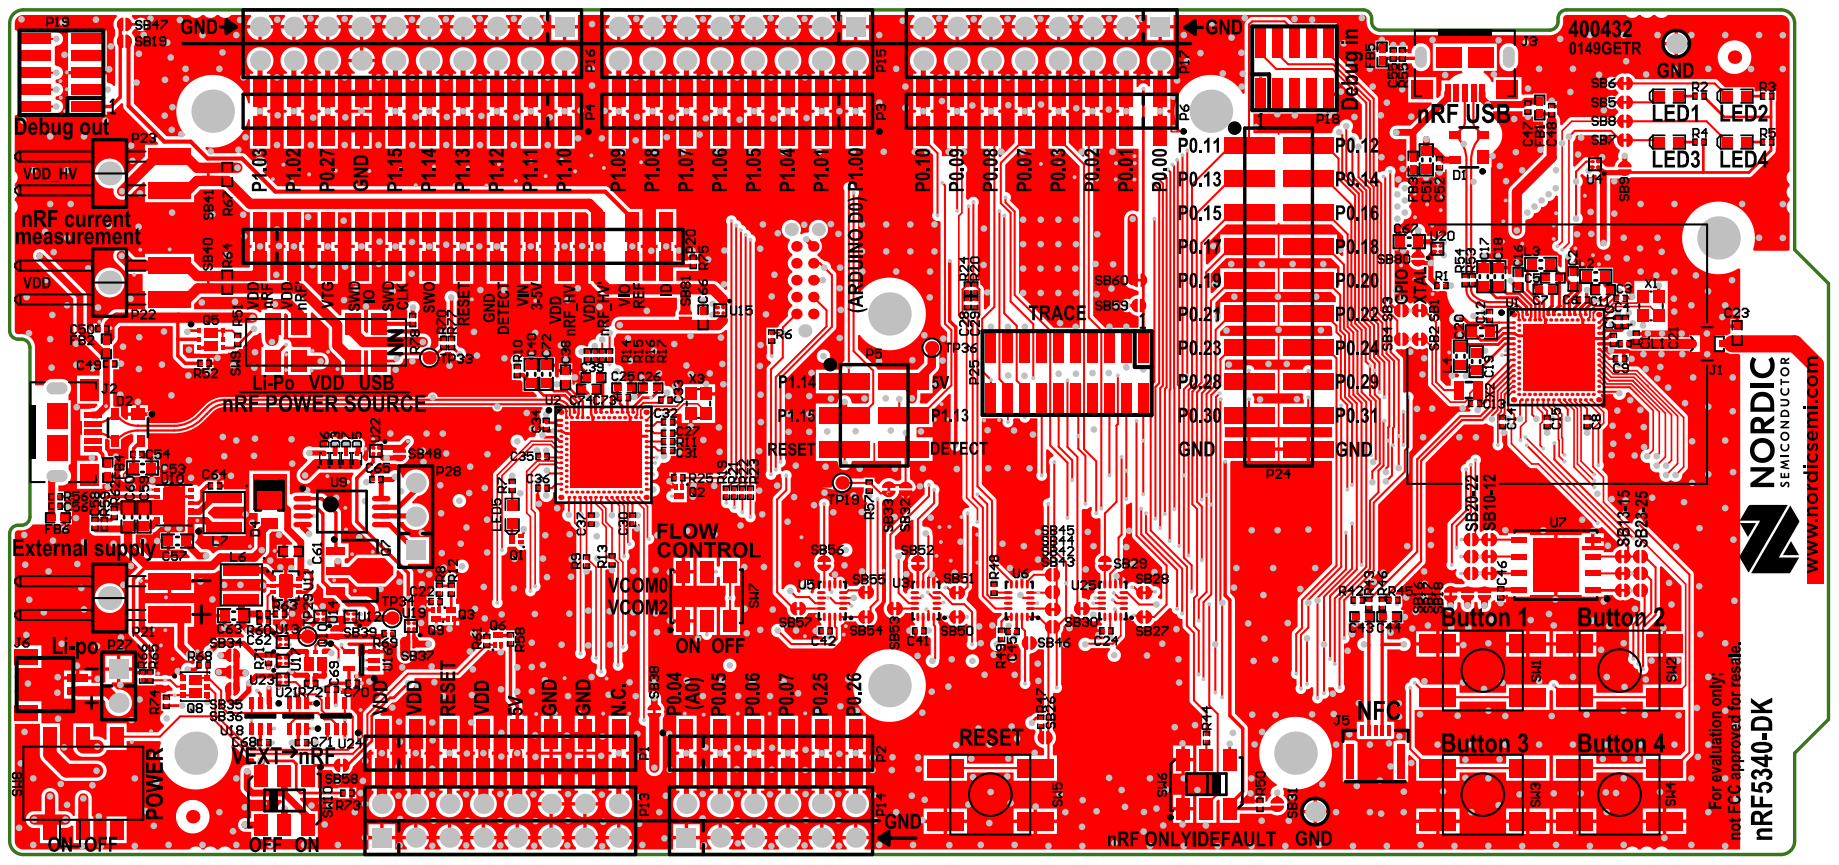
[picture p311: page 7]

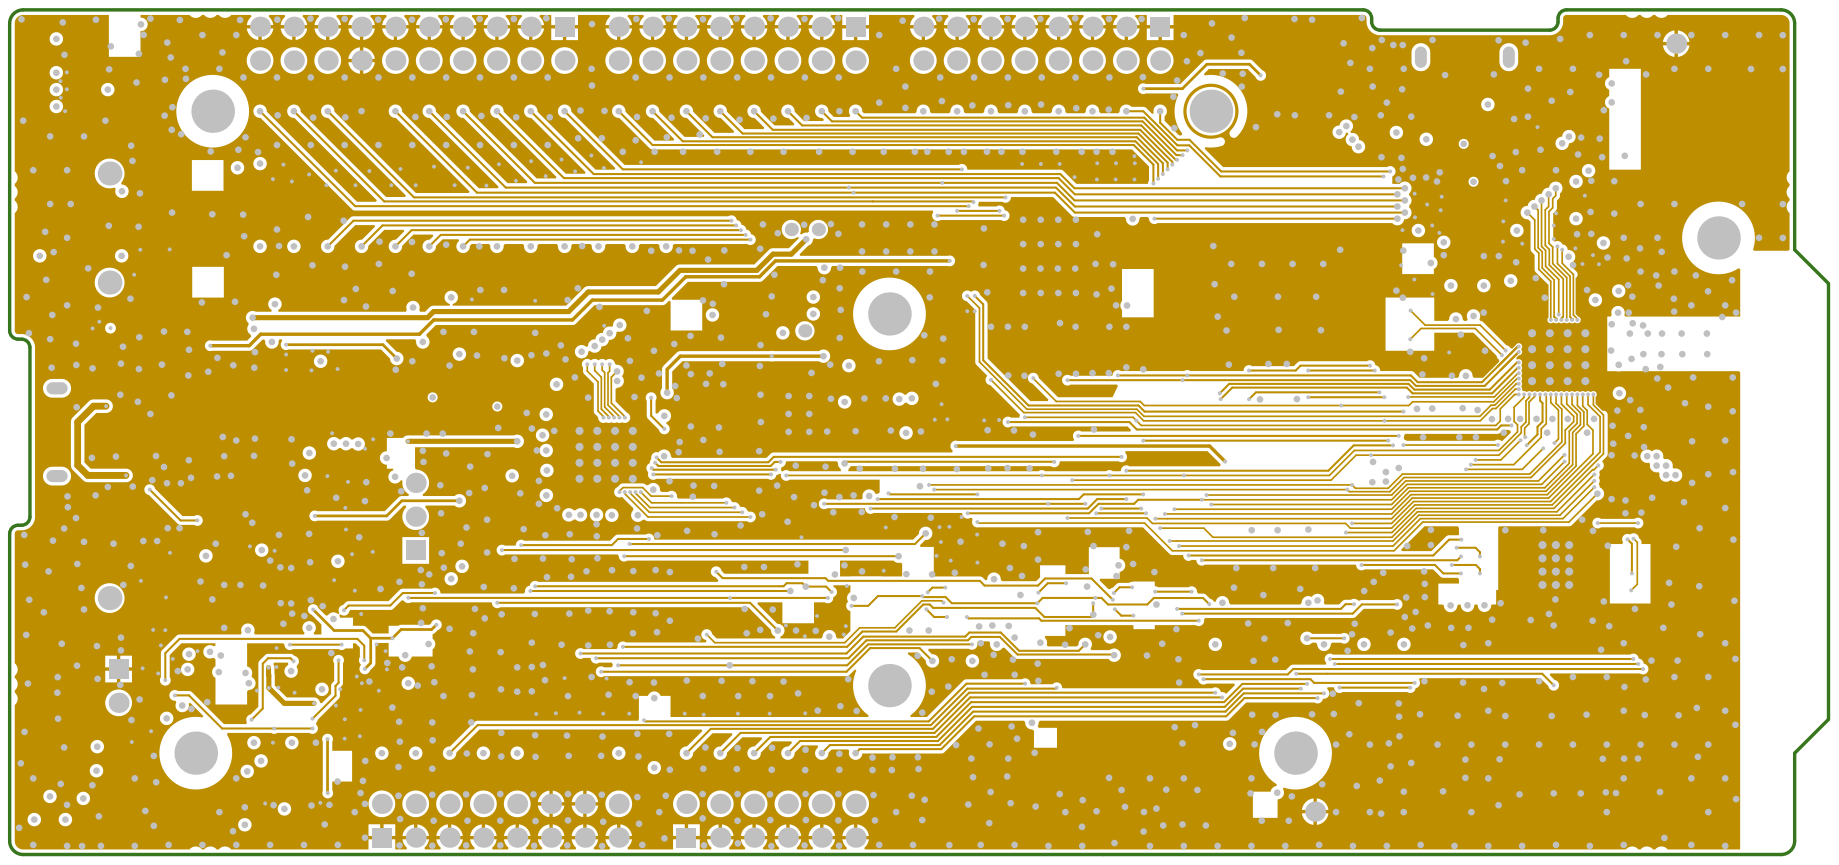
[picture p312: page 8]

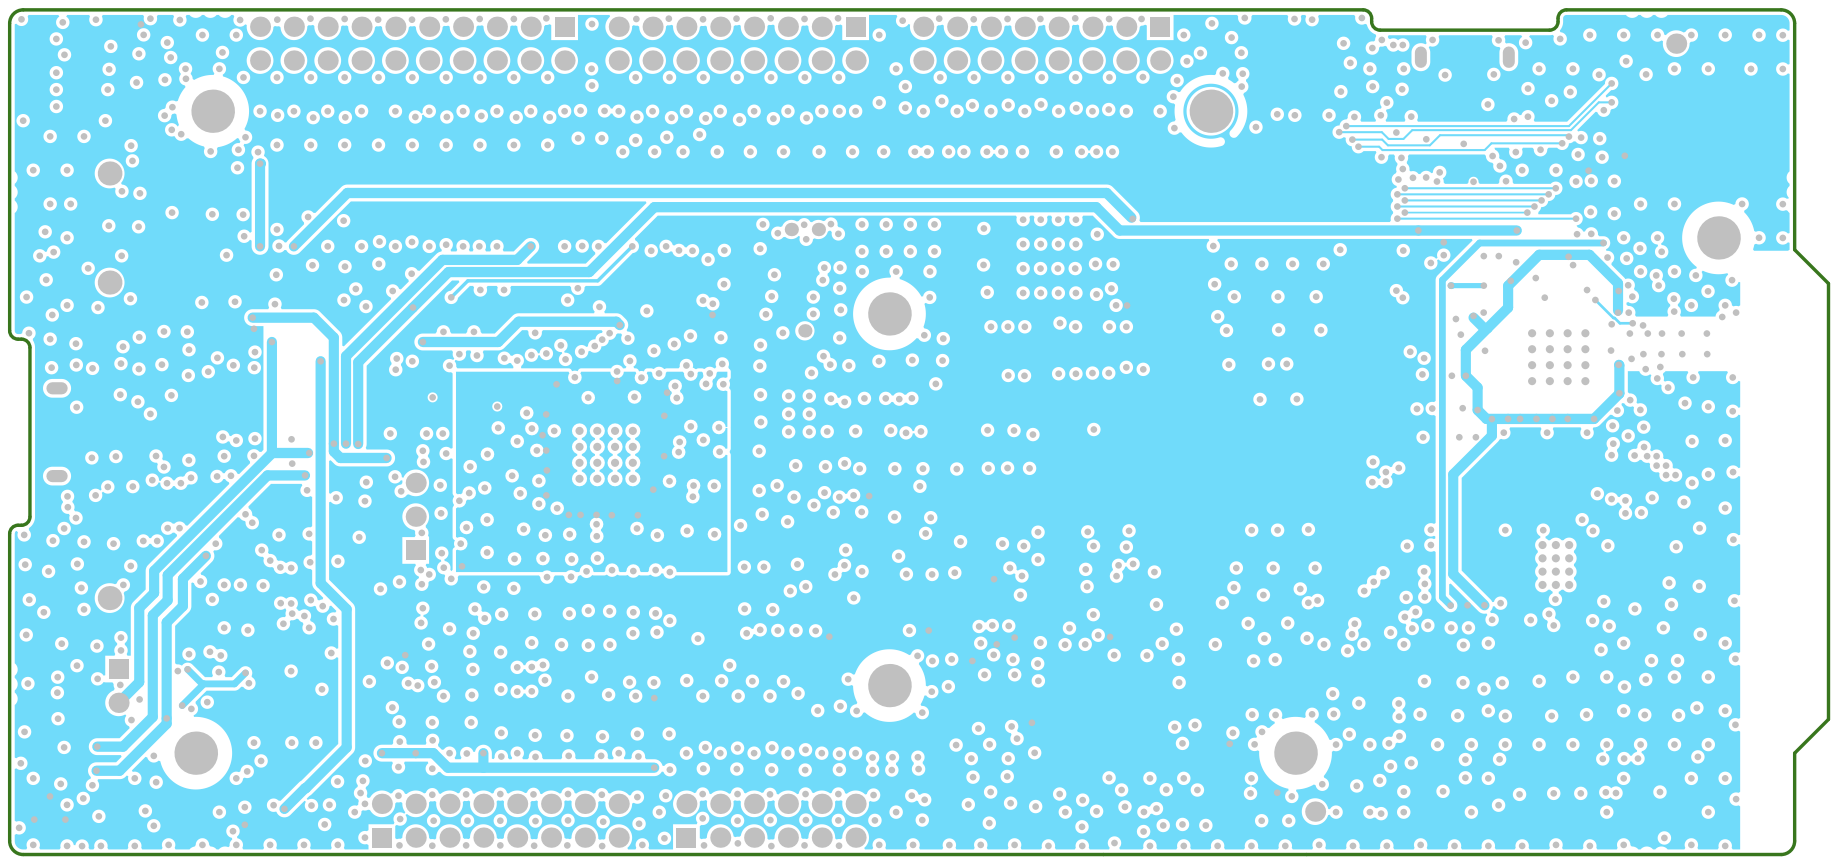
[picture p313: page 9]

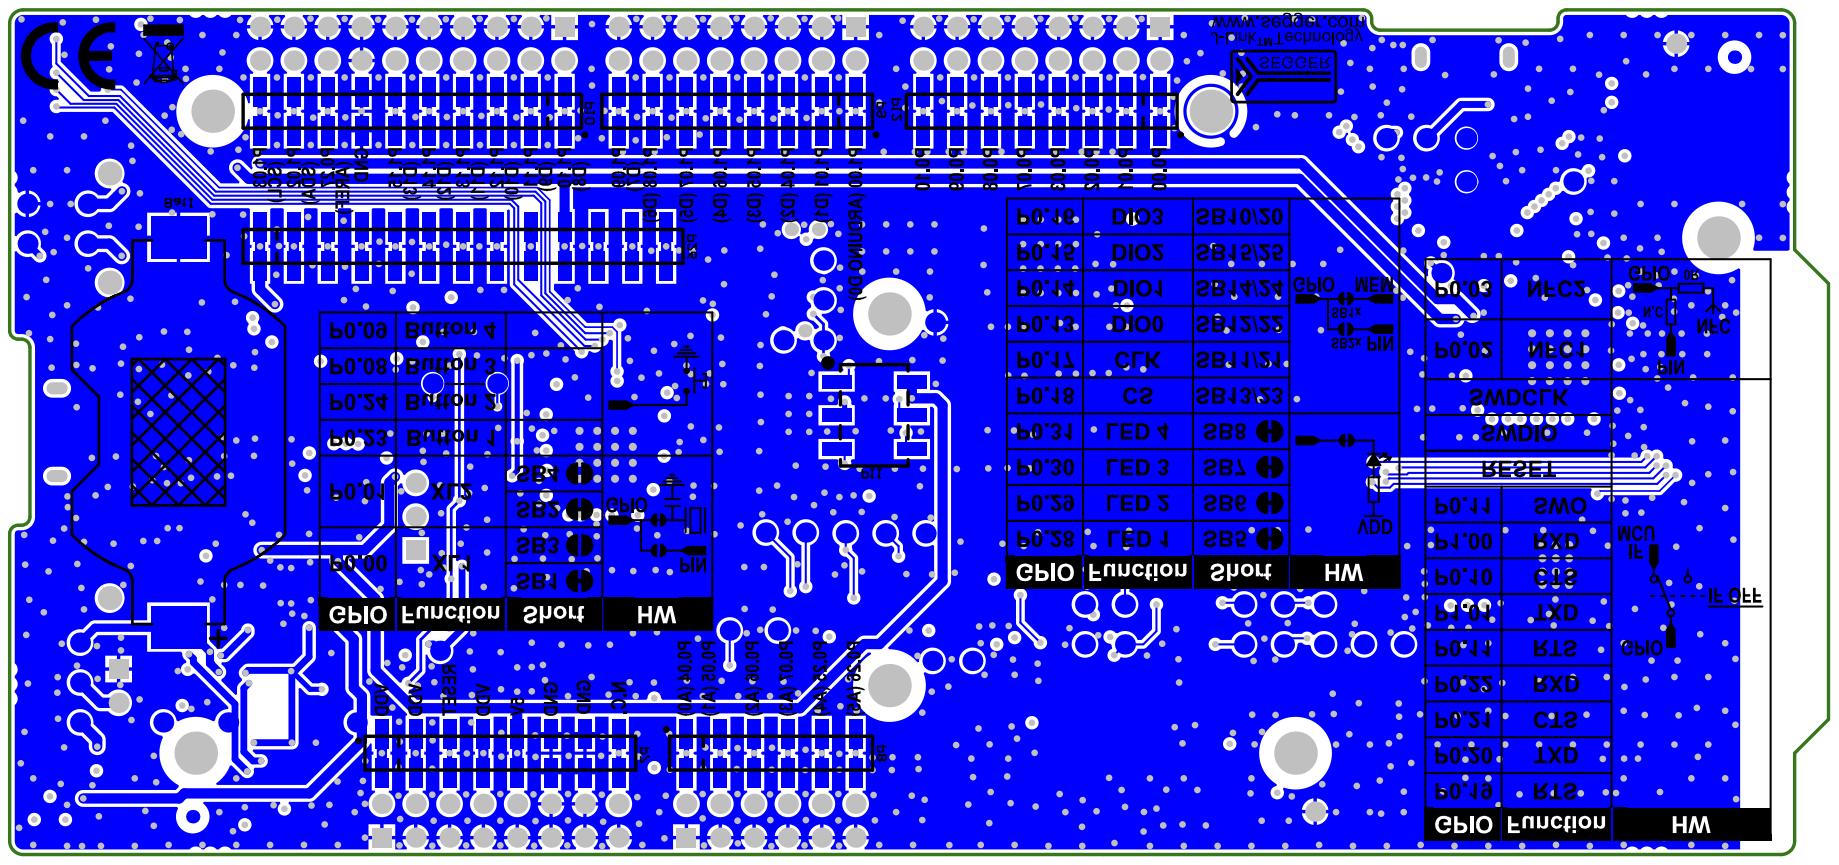
[picture p314: page 10]

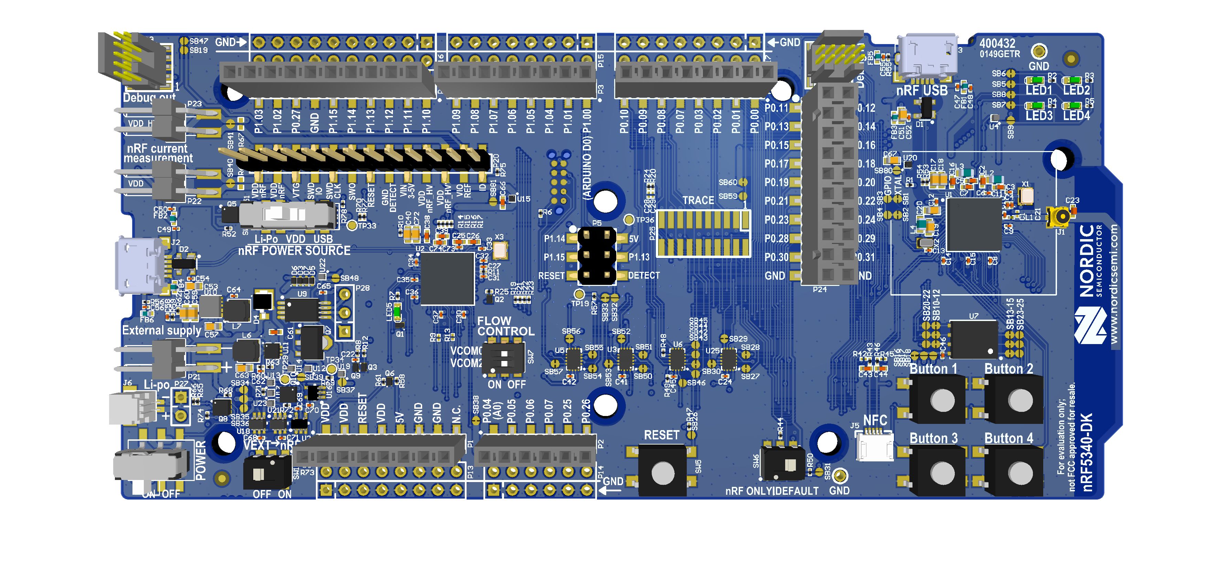
[picture p315: page 11]
