binphilxiao/AxisLabs/MAT0101/Ref/nRF7002 Development Kit - Hardware files 0_7_2/PCA10143-nRF7002 Development Kit 0_7_2/Schematic_Layout pdf files/PCA10143_Schematic_And_PCB.pdf

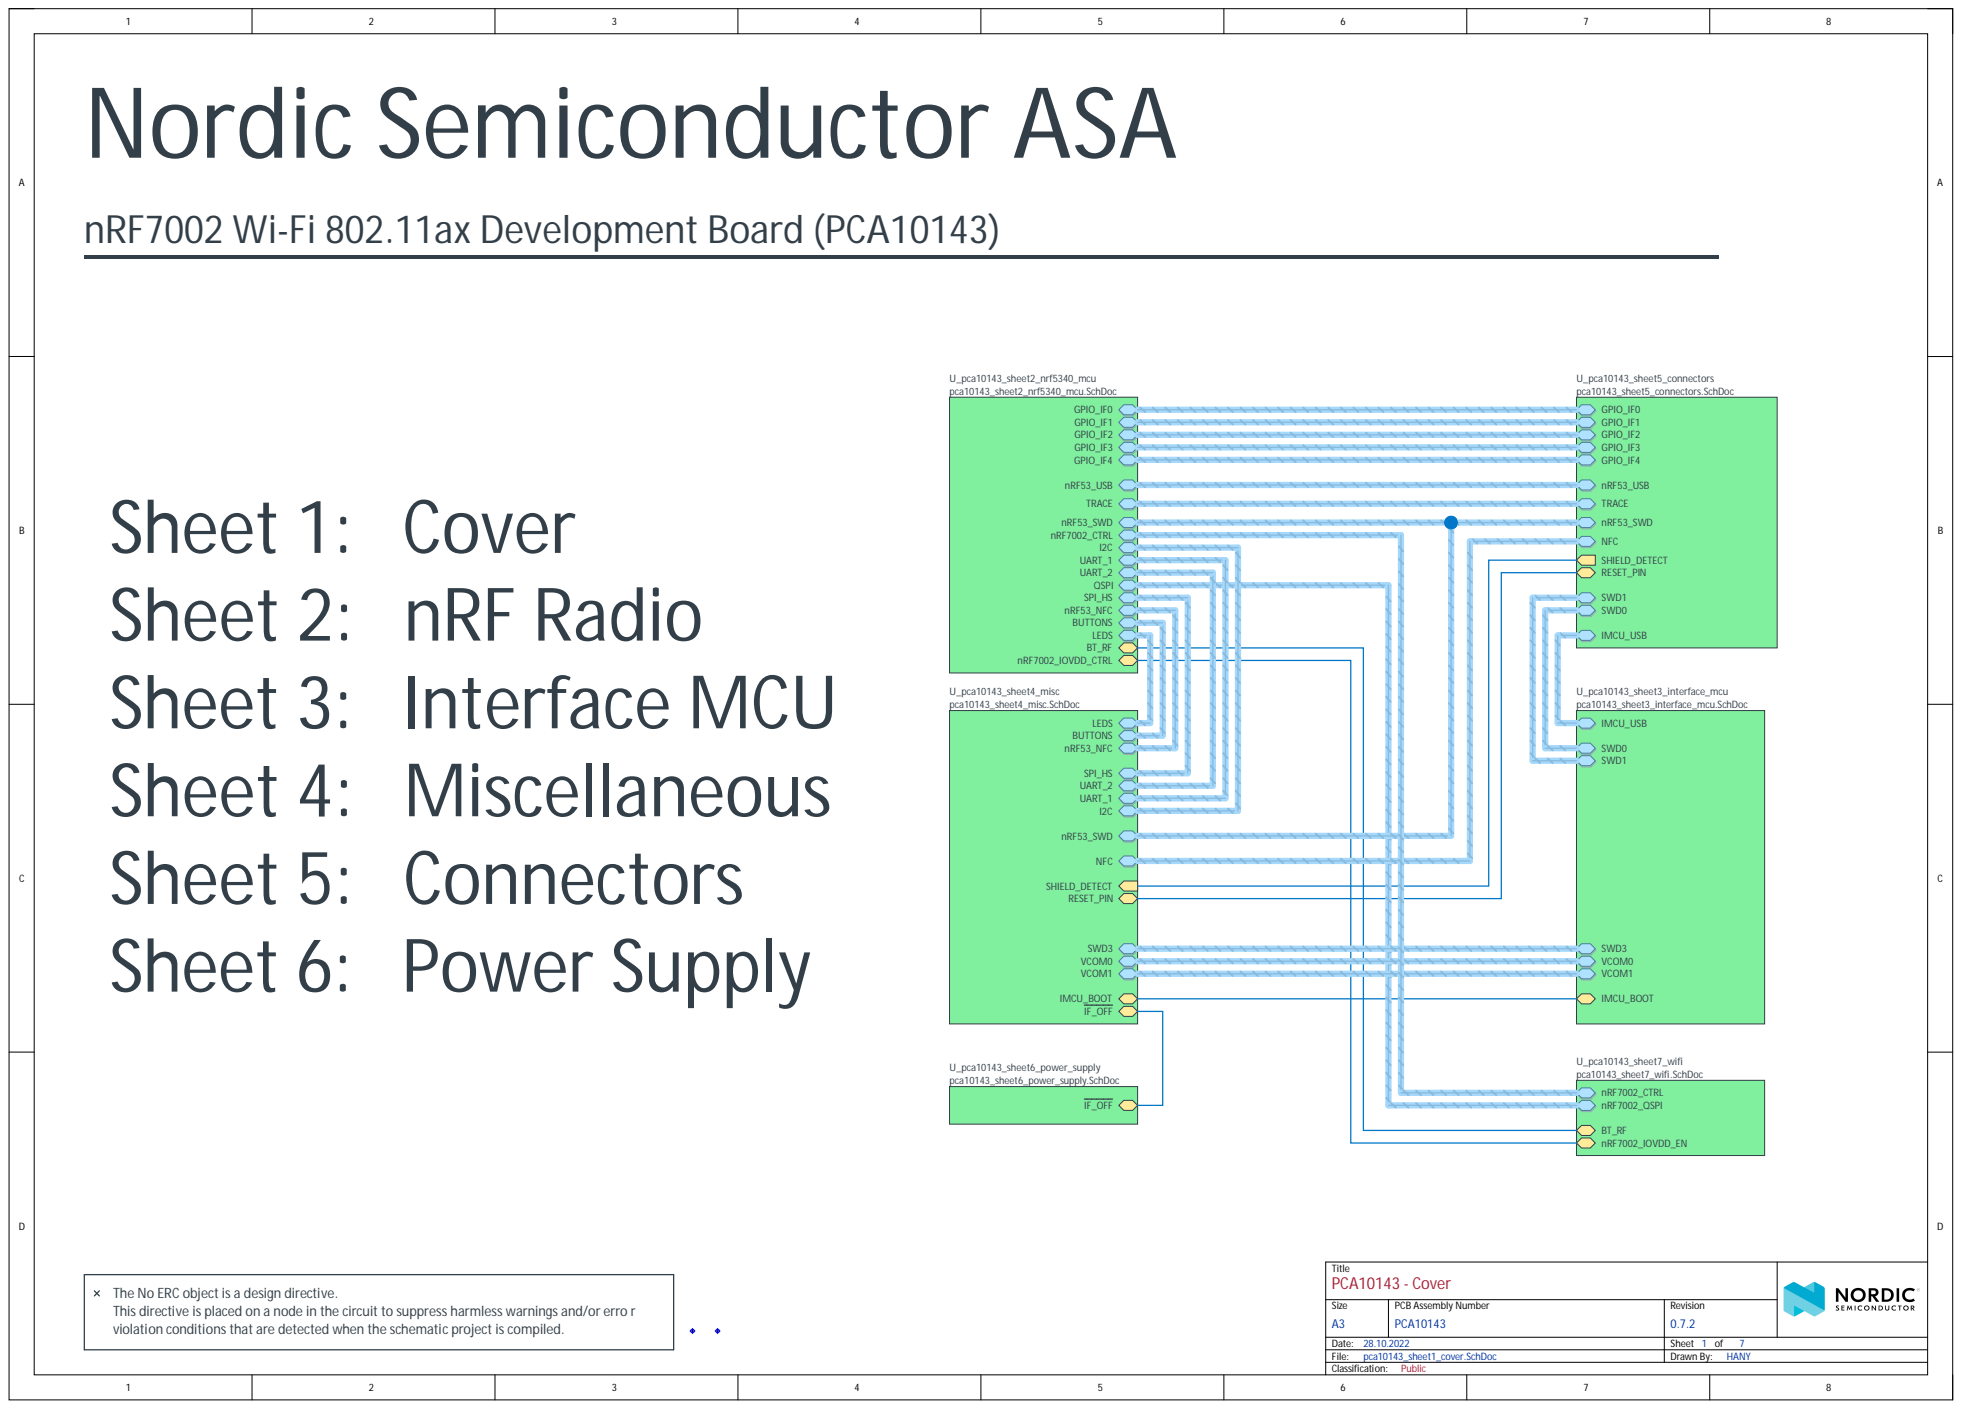
[picture p316: page 1]

________________________________________________________________ d (PCA10143)
nRF7002 Wi-Fi 802.11ax Development Boar

The No ERC object is a design directive.
This directive is placed on a node in the circuit to suppress harmless warnings and/or error
violation conditions that are detected when the schematic project is compiled.

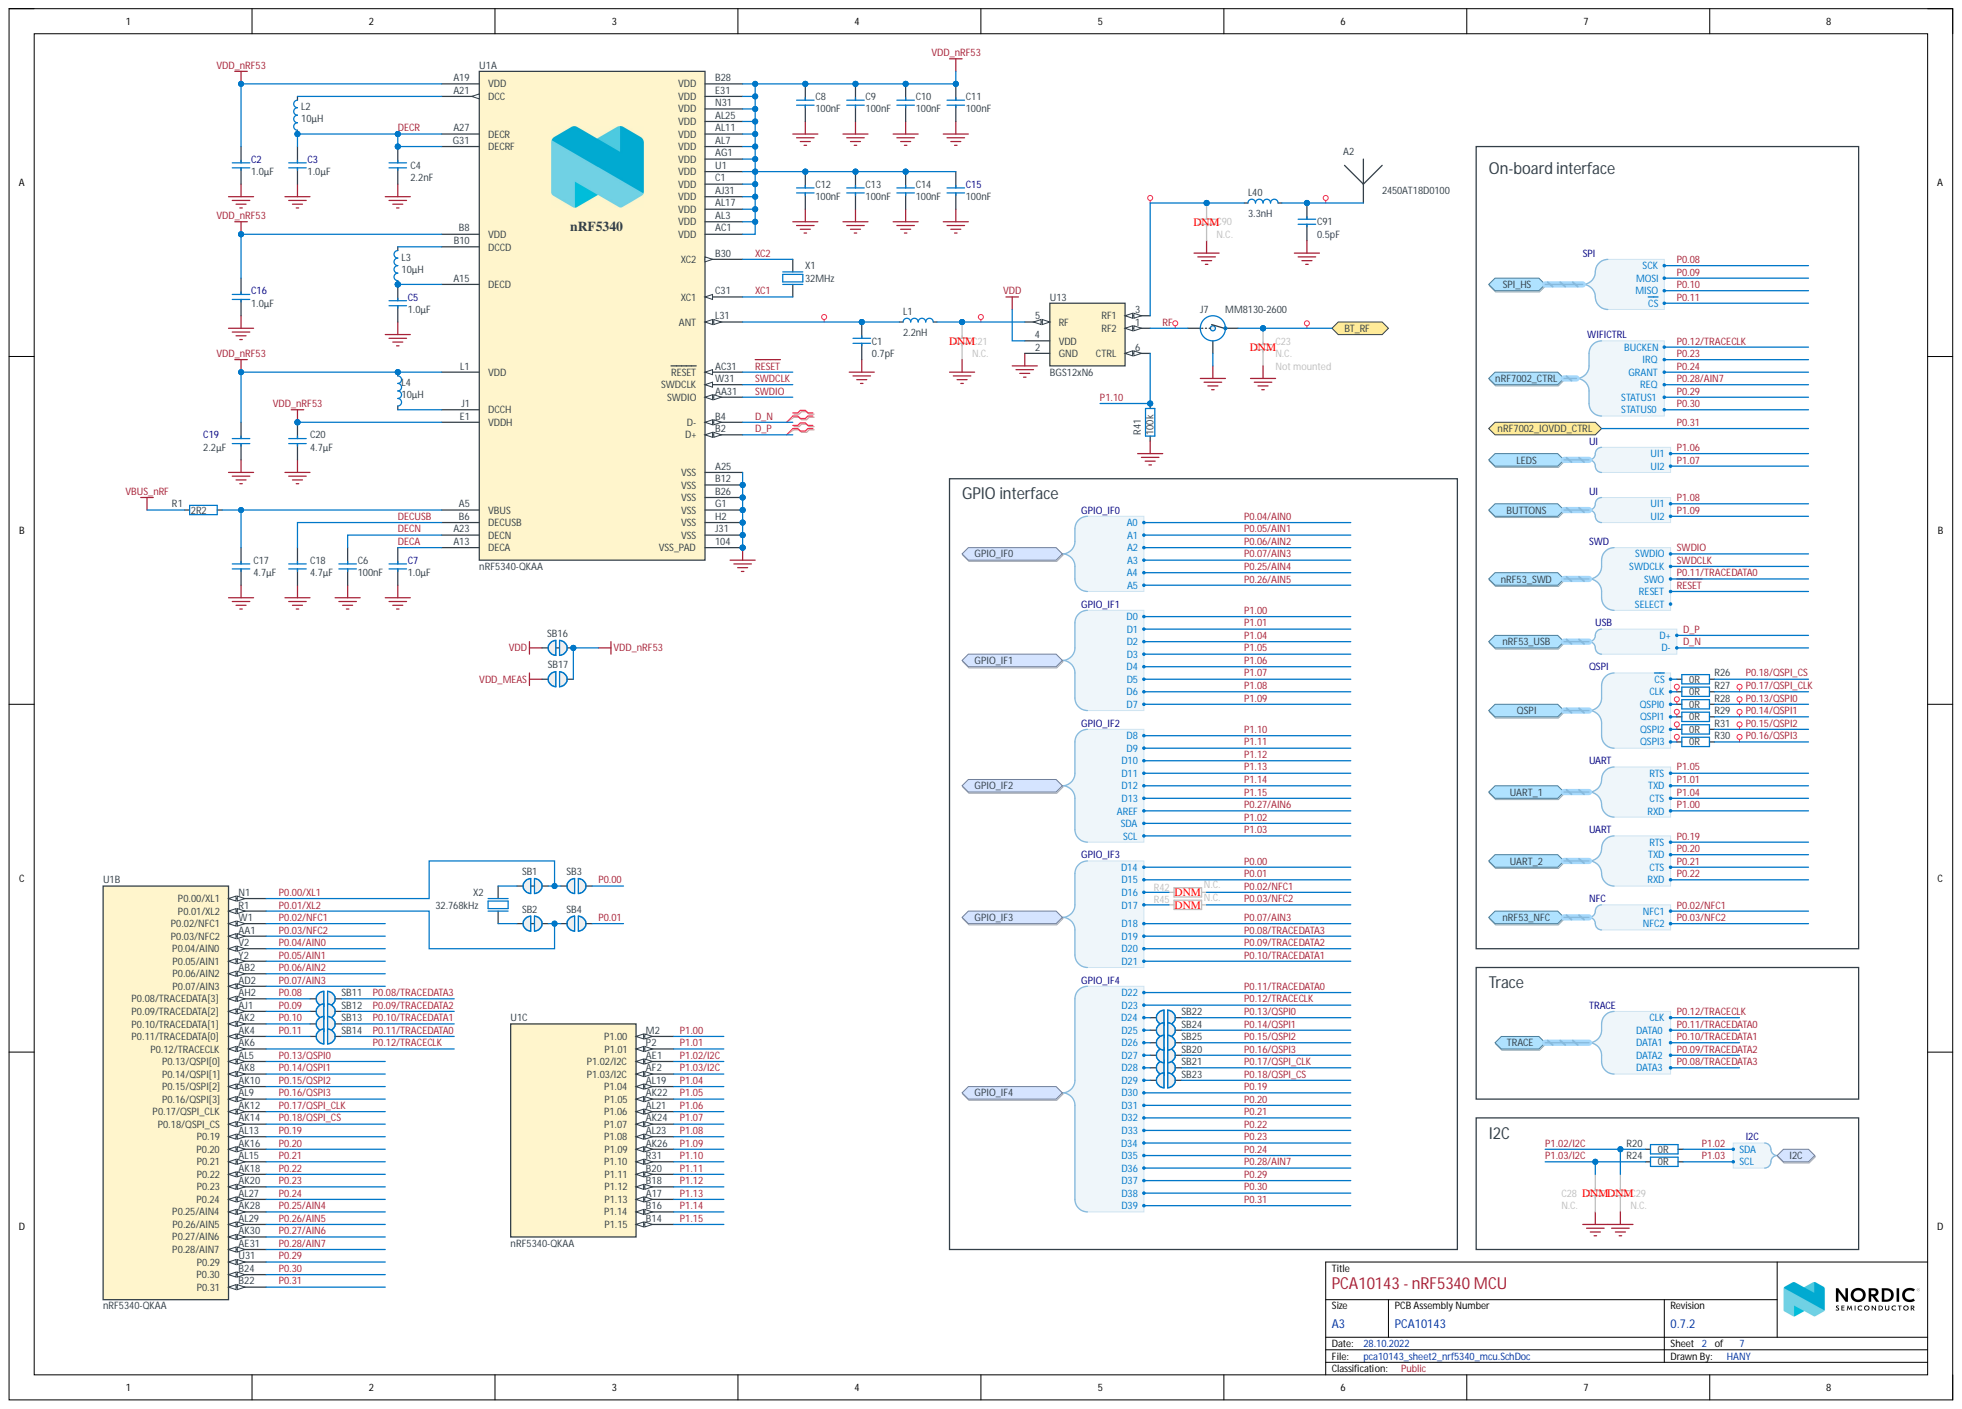
[picture p317: page 2]

DECN
DE CA

SWDIO
SWDCLK SWO RESET SELECT

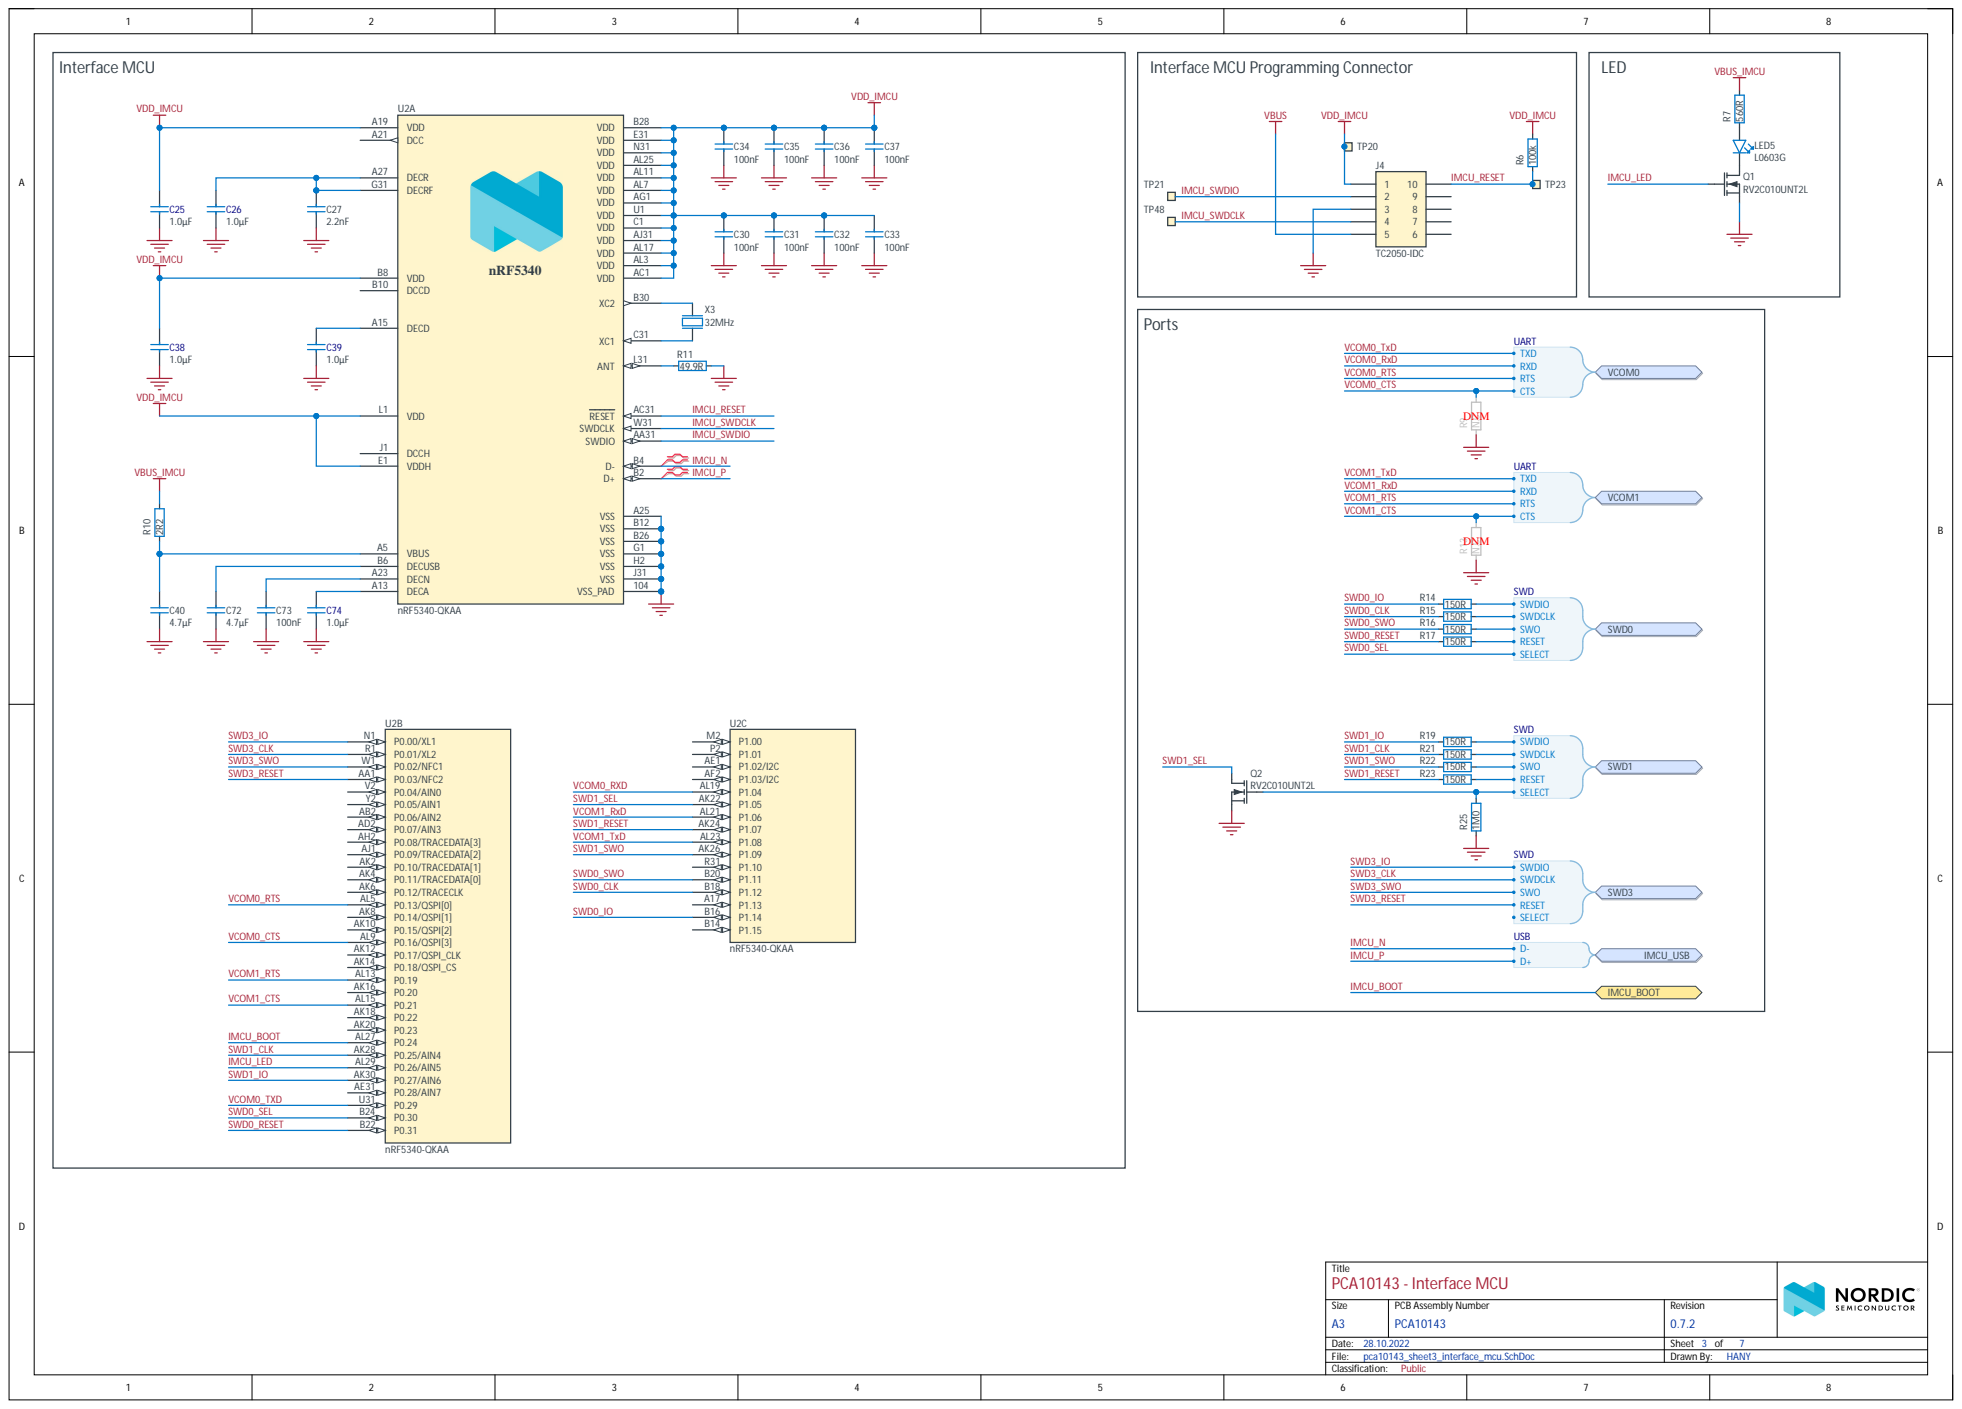
[picture p318: page 3]

Interface MCU Programming Connector VDD_IMCU

SWD
SWDIO SWDCLK SWO RESET SELECT

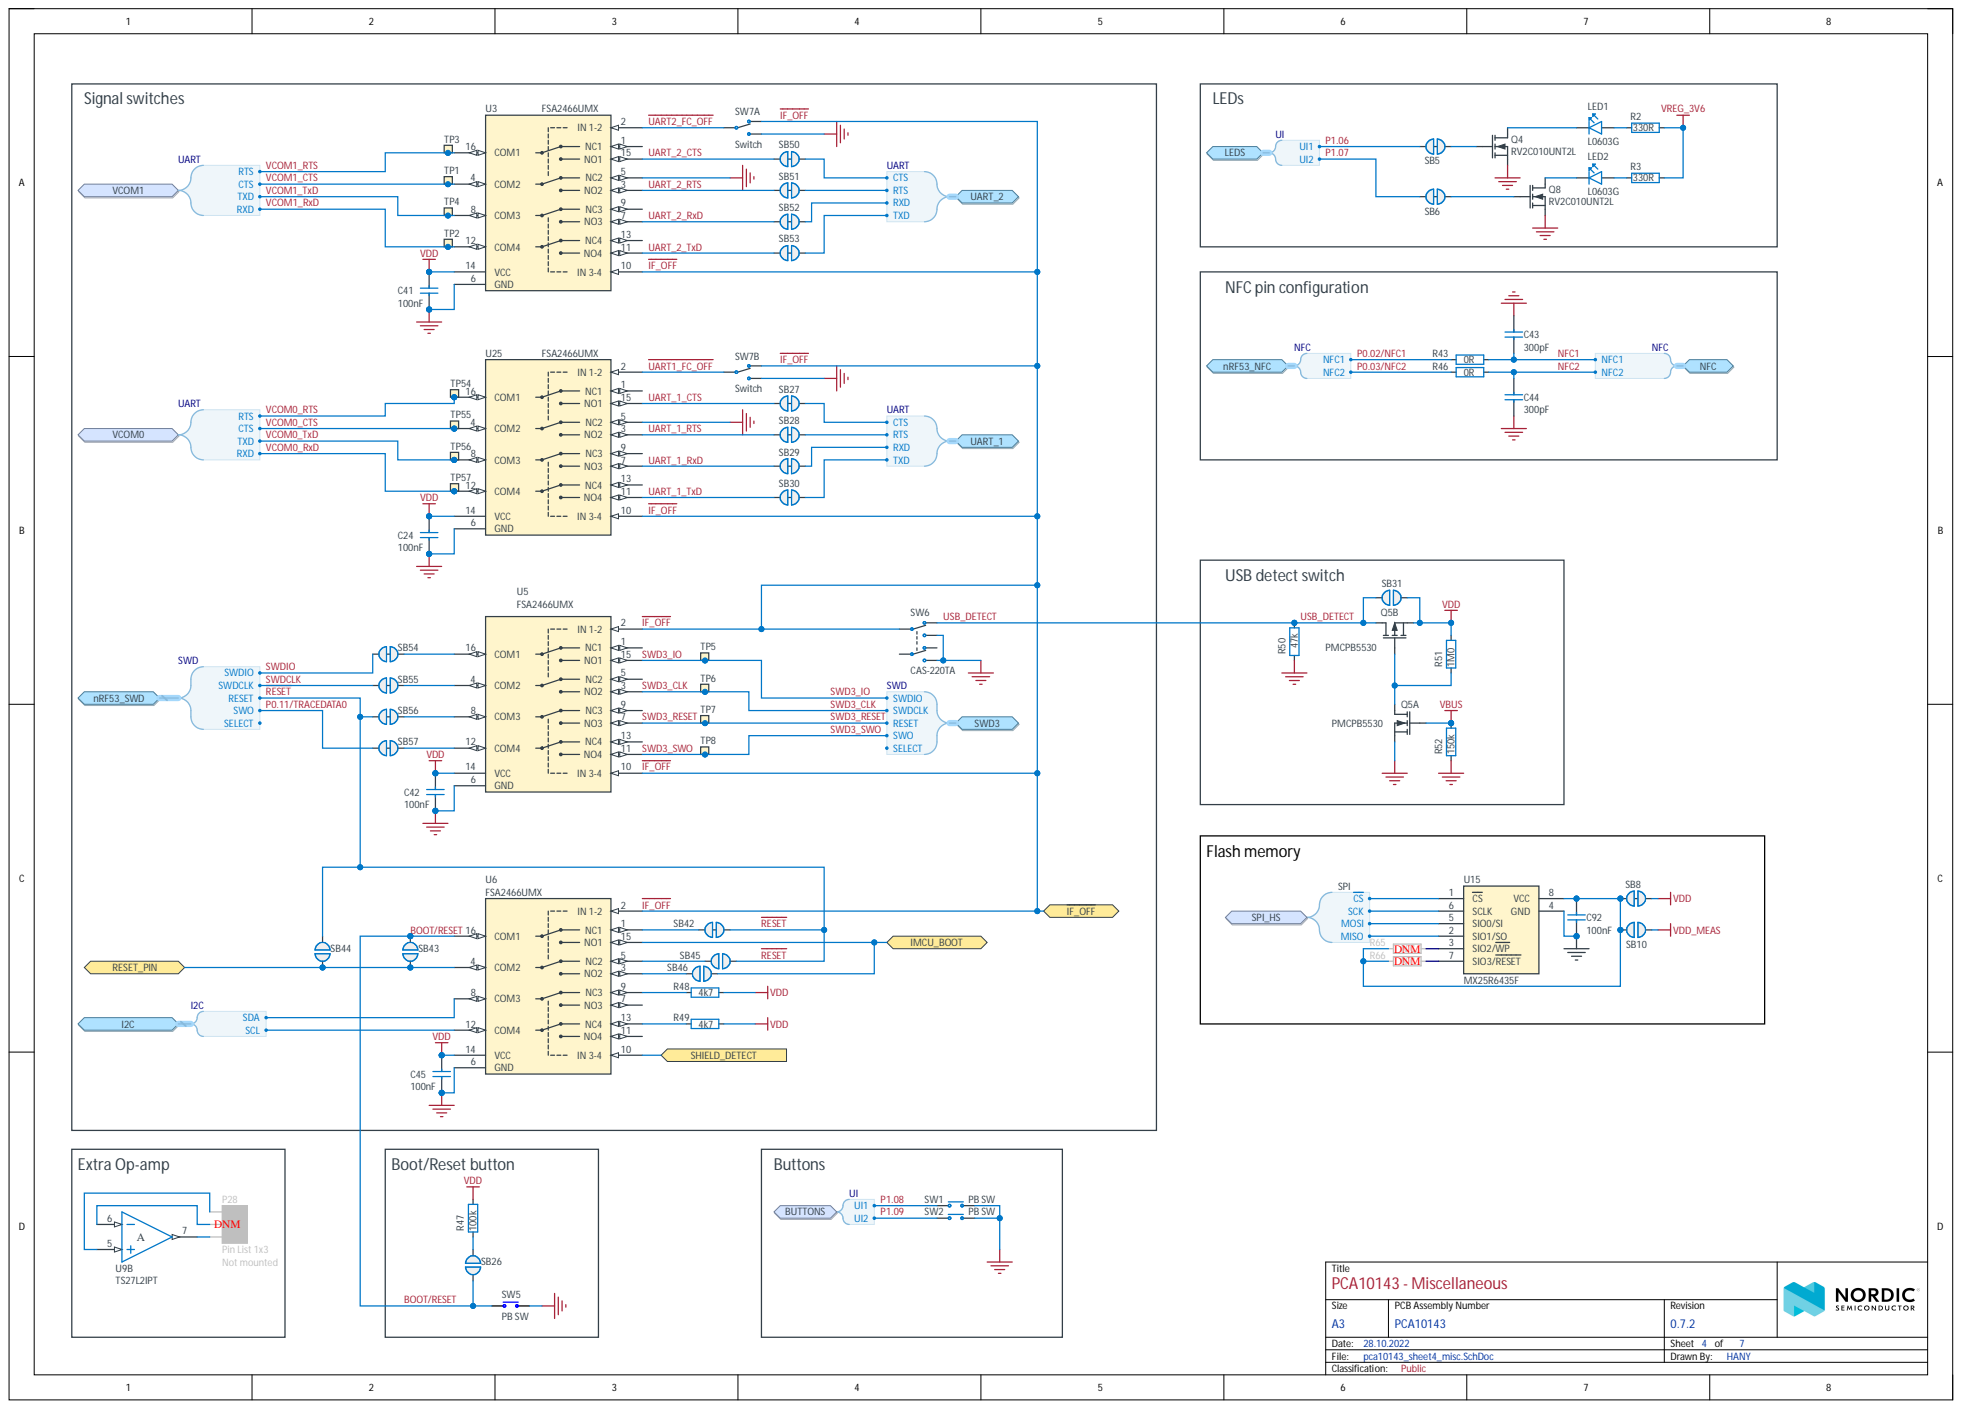
[picture p319: page 4]

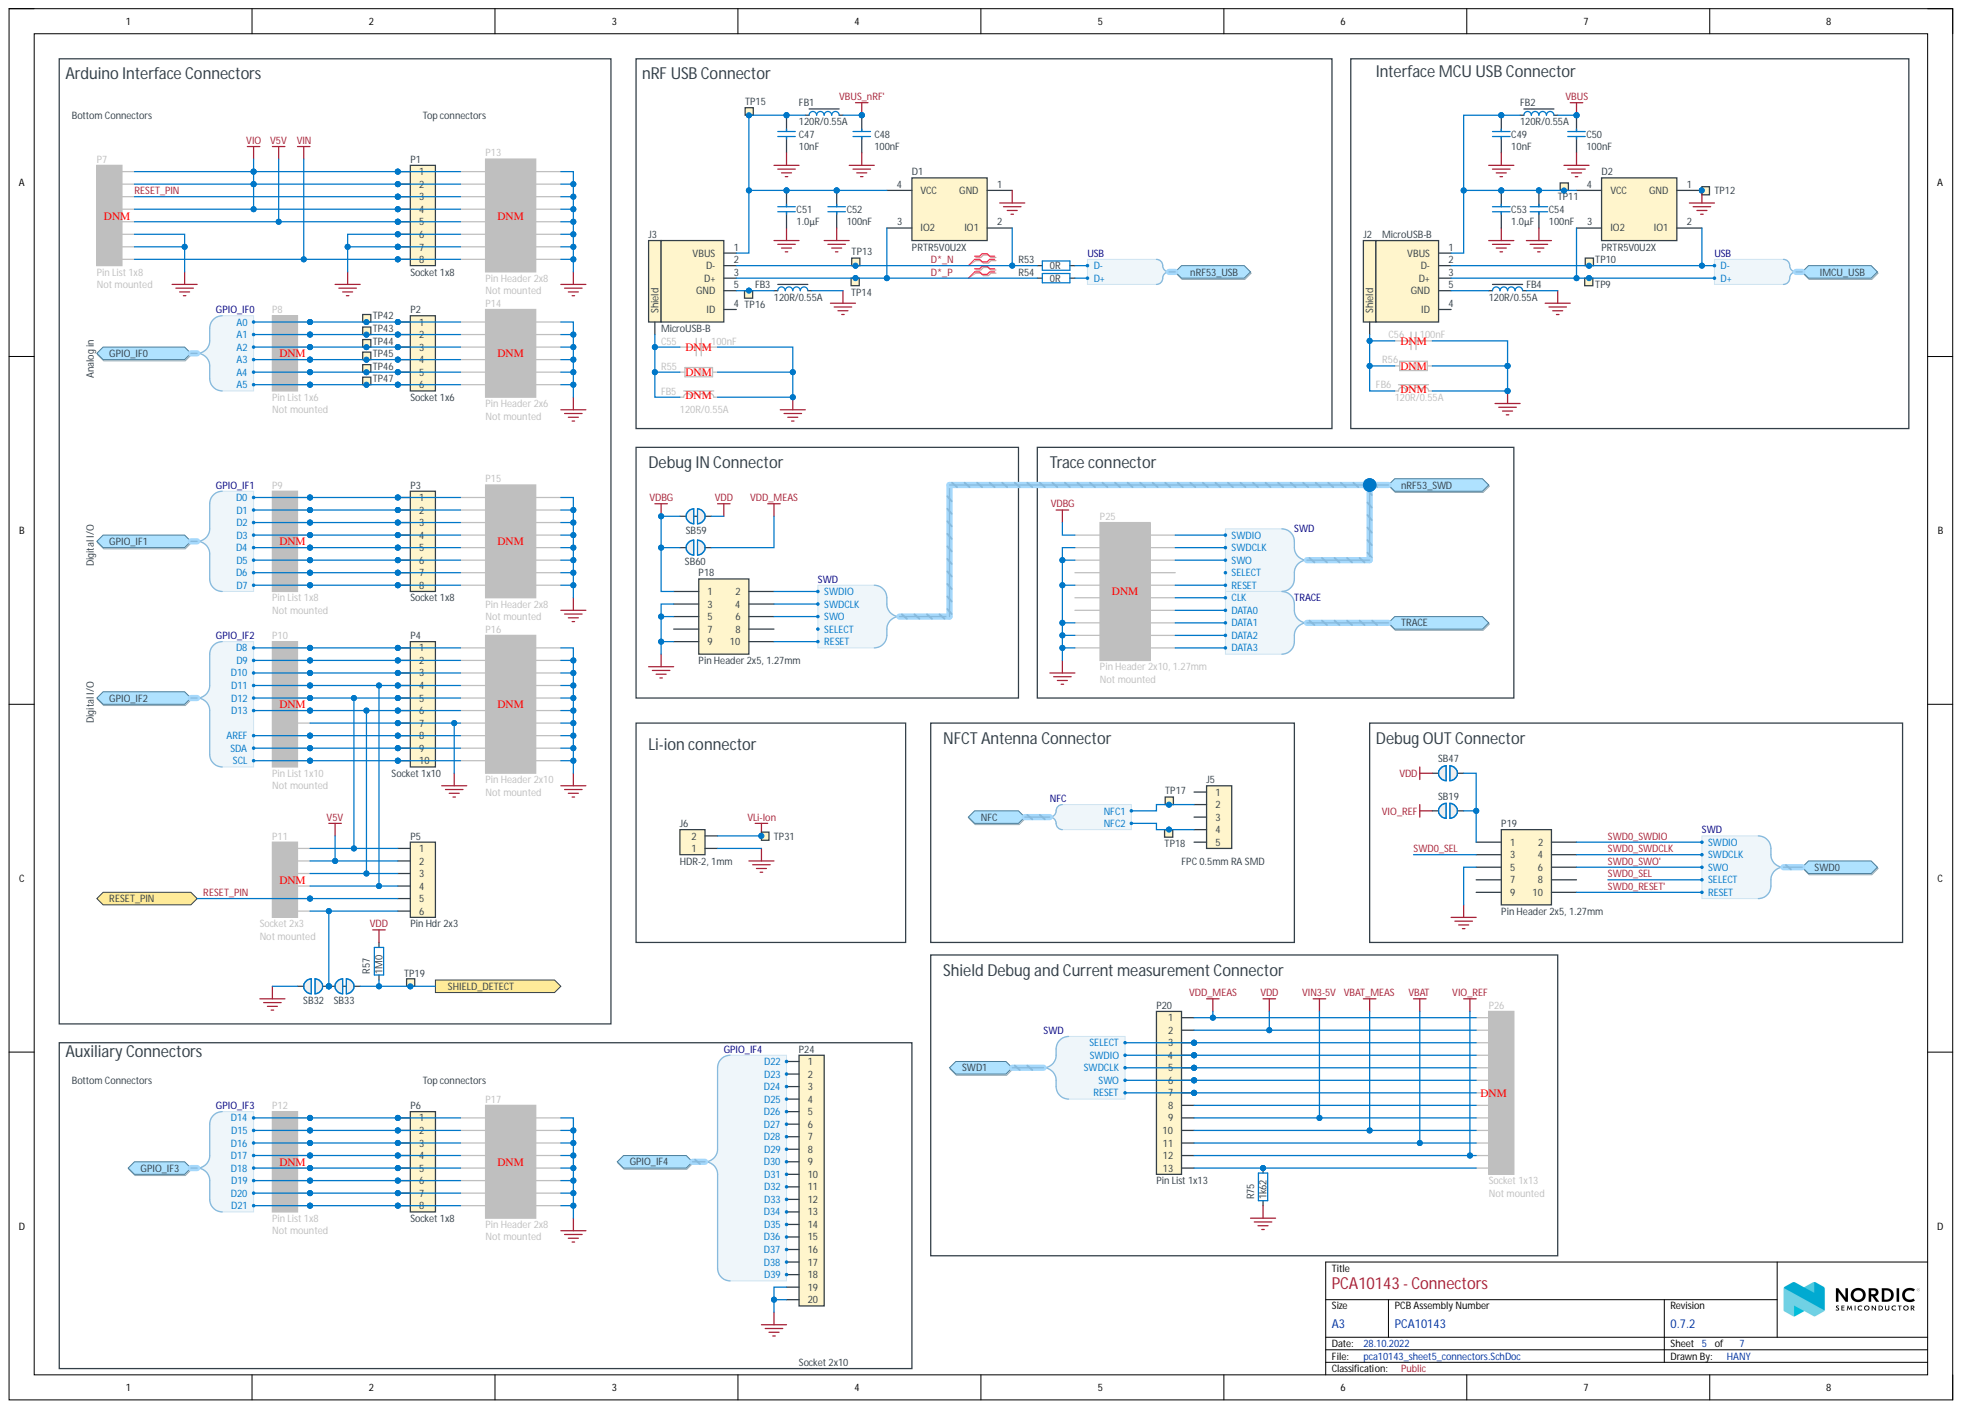
[picture p320: page 5]

Interface MCU USB Connector

6 7

Analog in Digital I/O Digital I/O
GPIO_IF0

2 3 | 2 3

DNM 5 | 5

DNM 6 | | 6
8 9 | | | 8 9

Shield Debug and Current measurement Connector

DNM
5 6 | 5 6

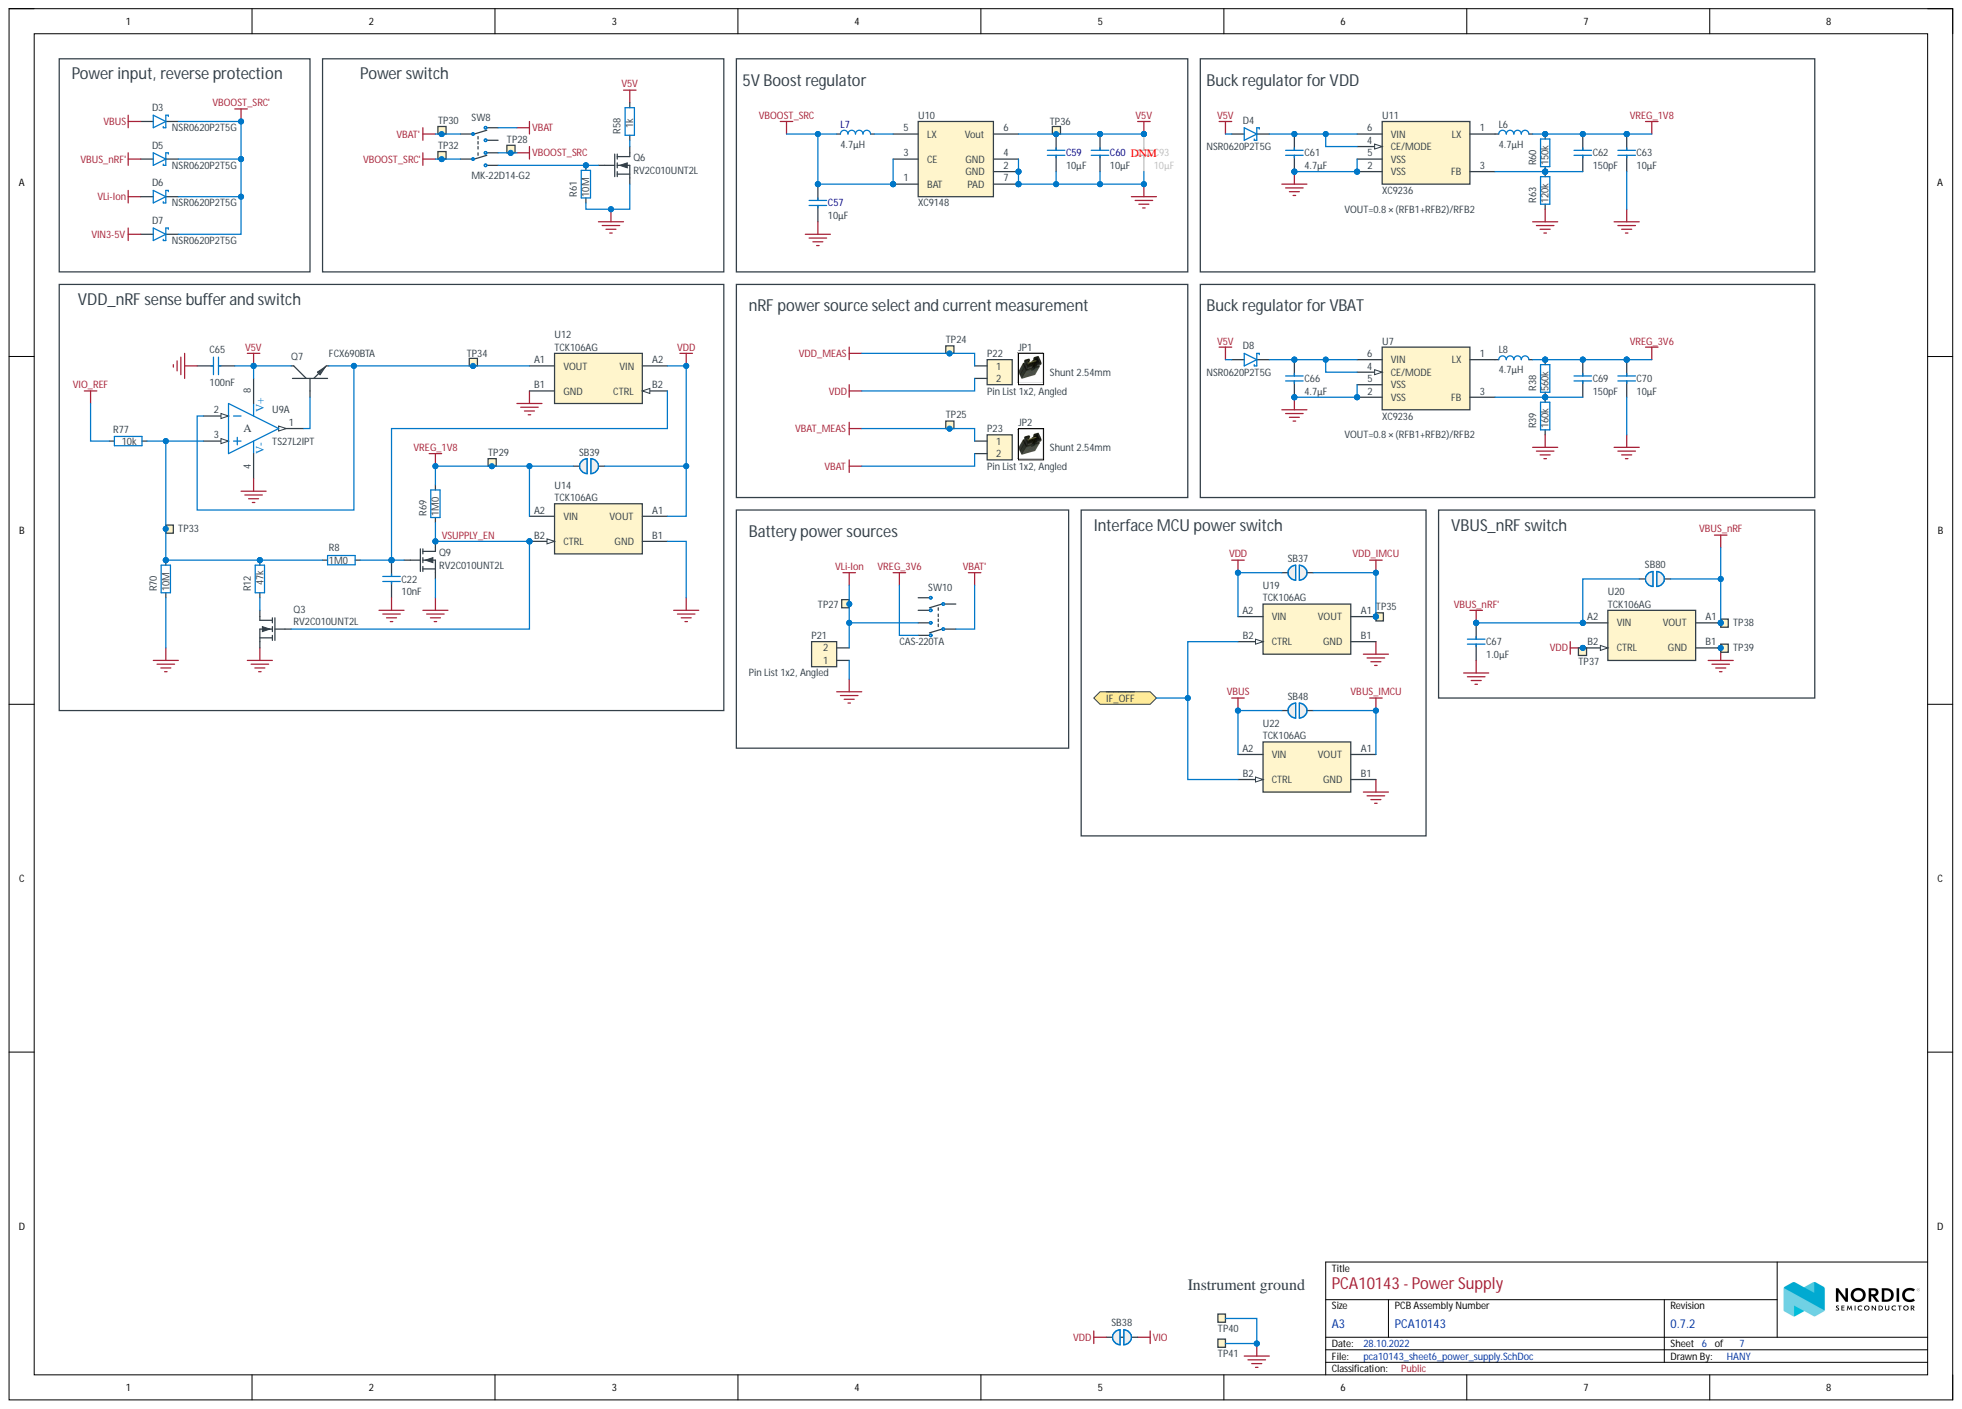
[picture p321: page 6]

Power input, reverse protection

Buck regulator for VDD

VDD_nRF sense buffer and switch

nRF power source select and current measurement

Buck regulator for VBAT

Interface MCU power switch

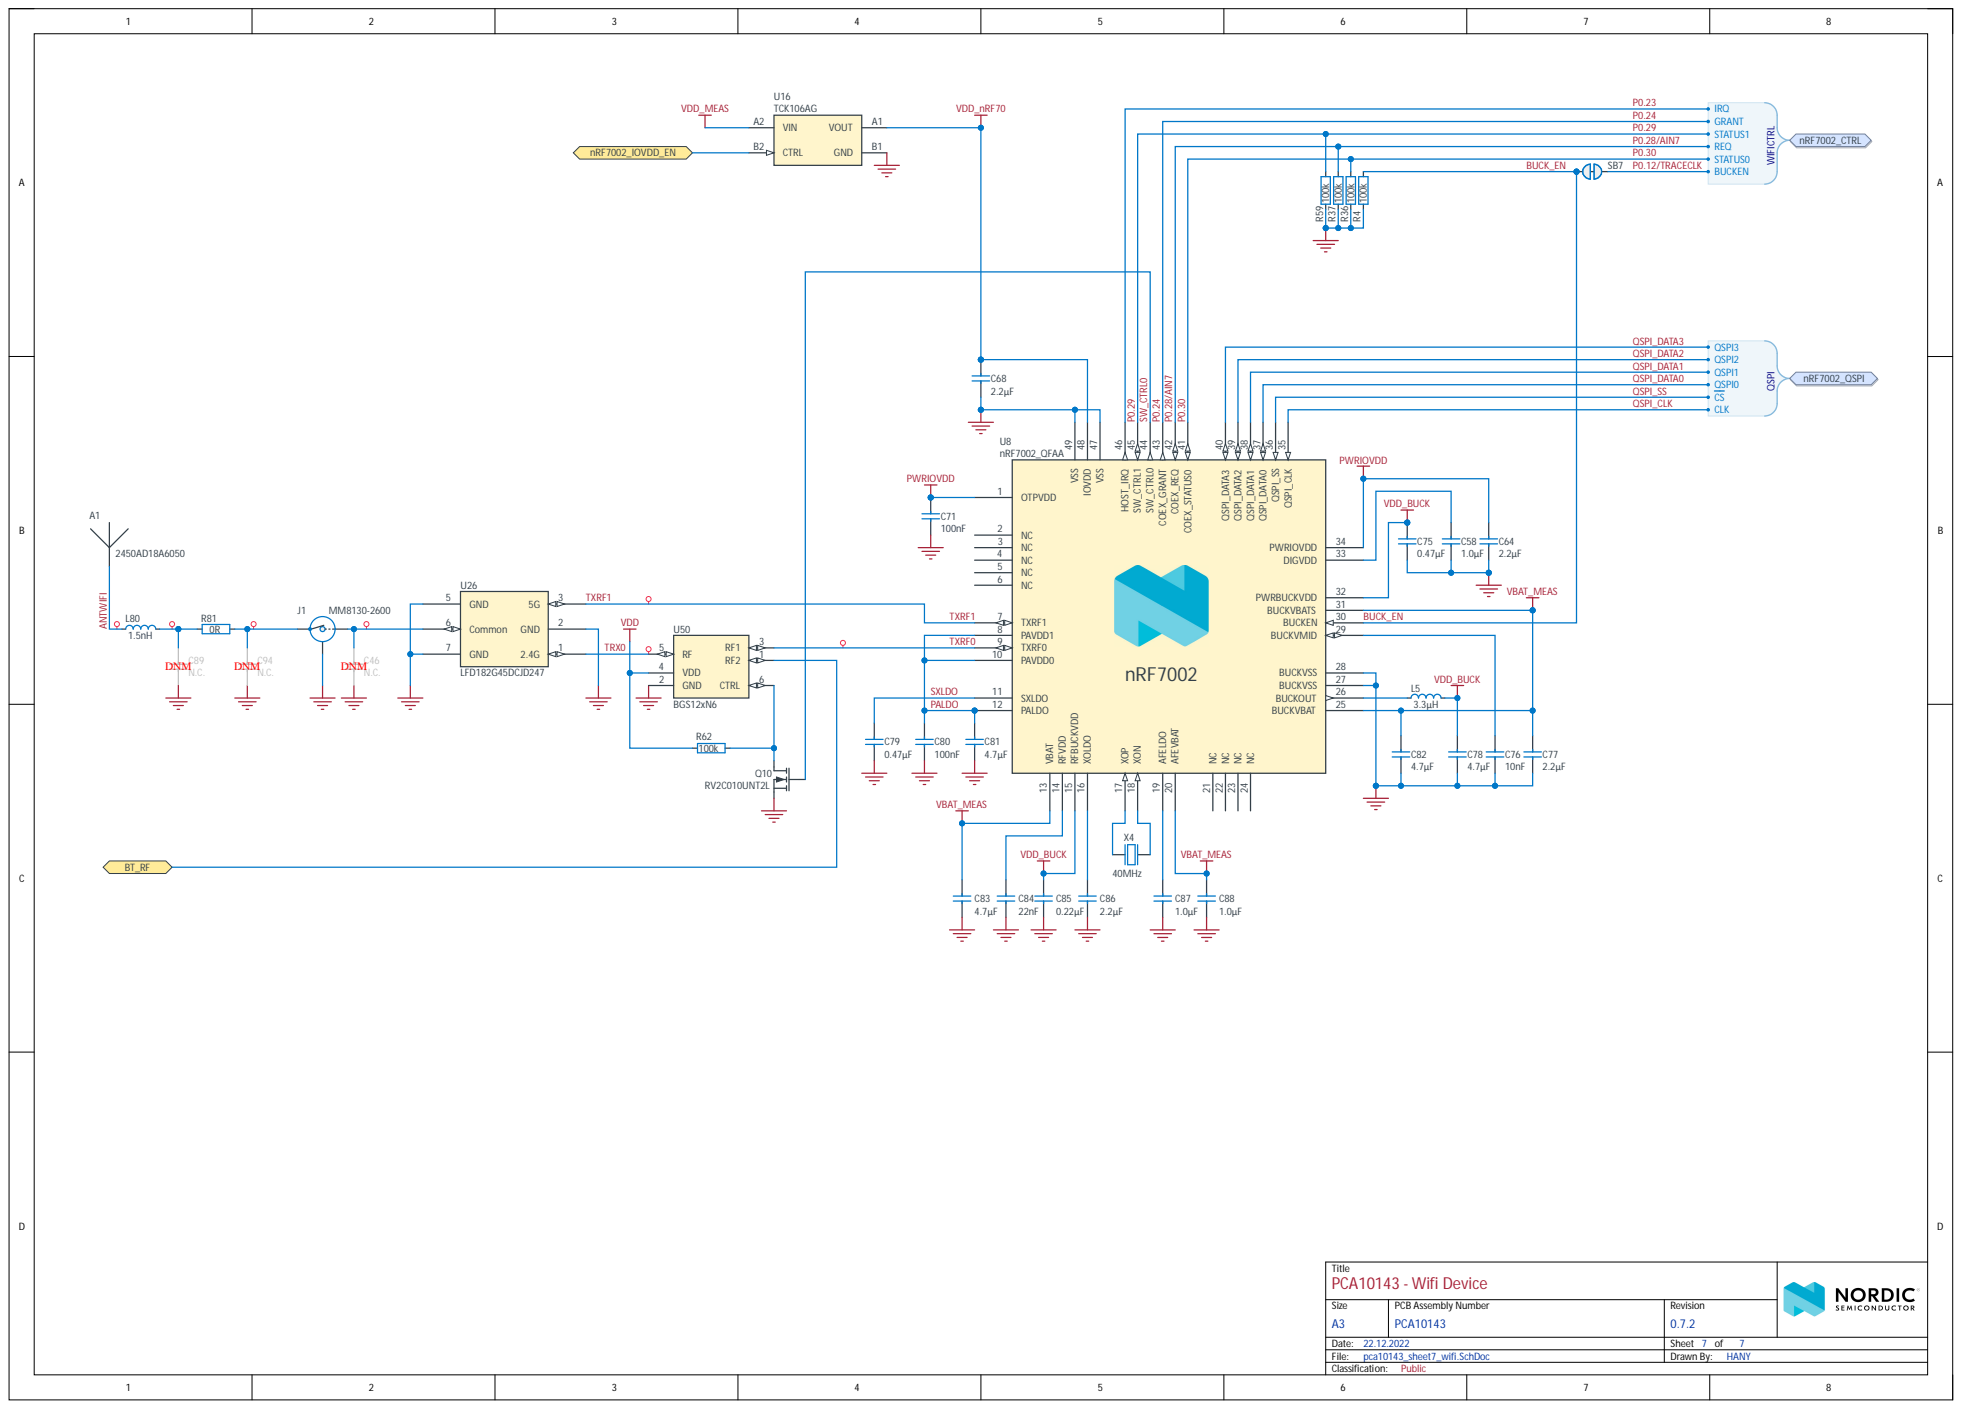
[picture p322: page 7]

P0.28/AIN7
P0.30

BUCK_EN

QSPI_DATA0
QSPI_SS
QSPI_CLK

Common 6 GND 7 | TXRF1

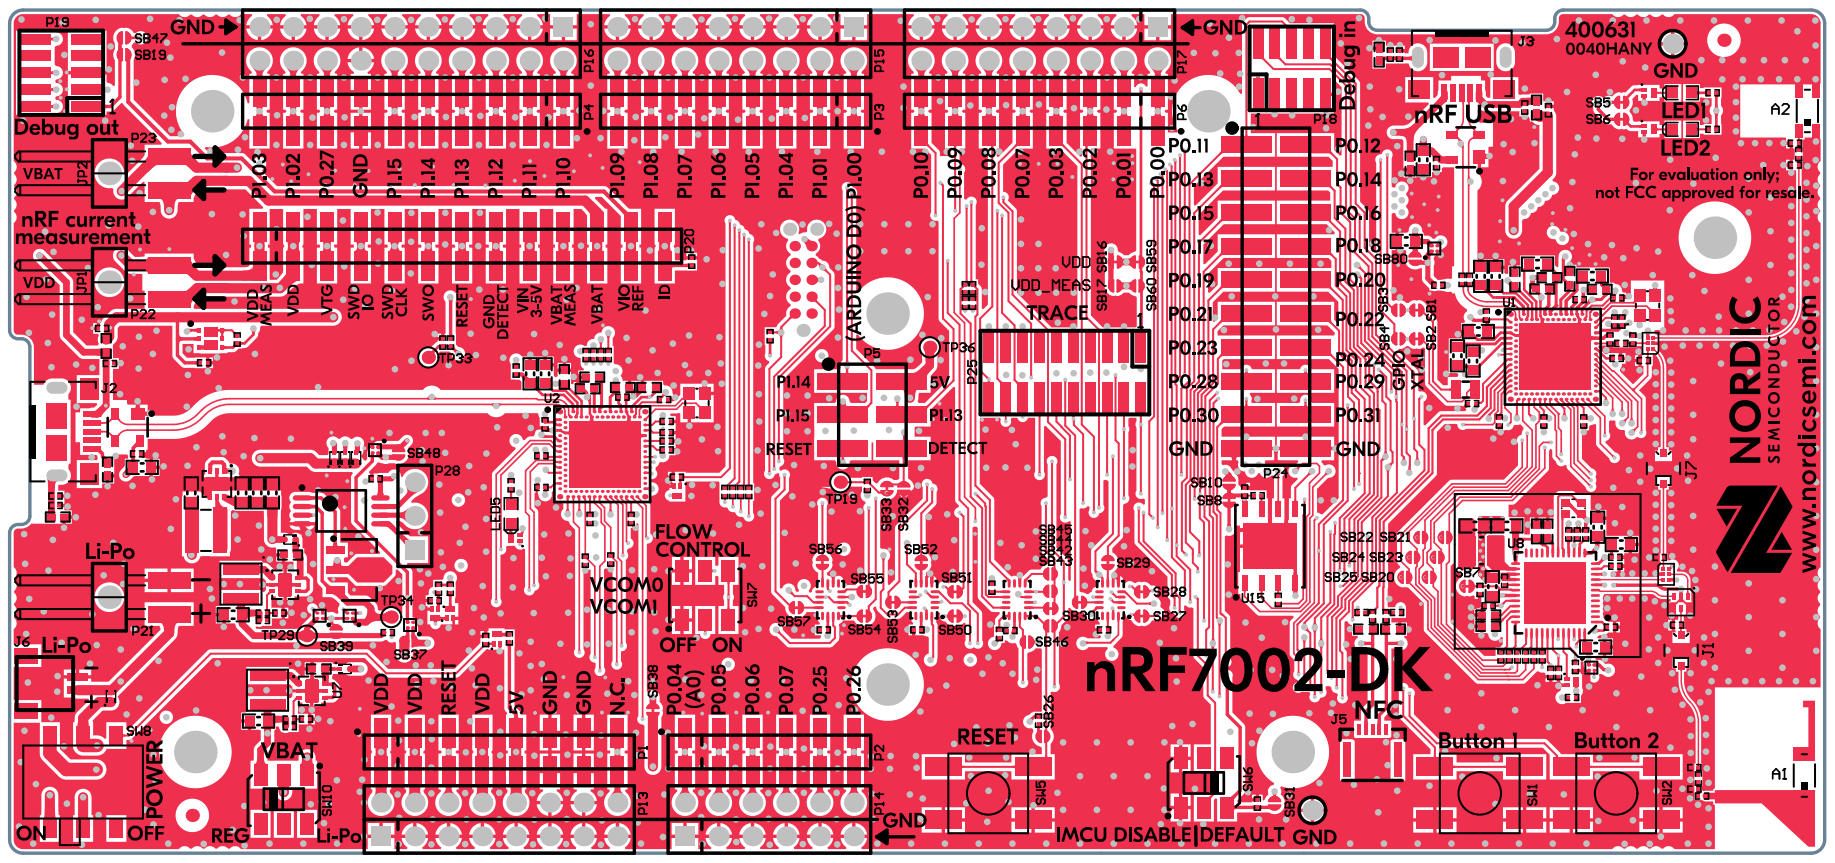
[picture p323: page 8]

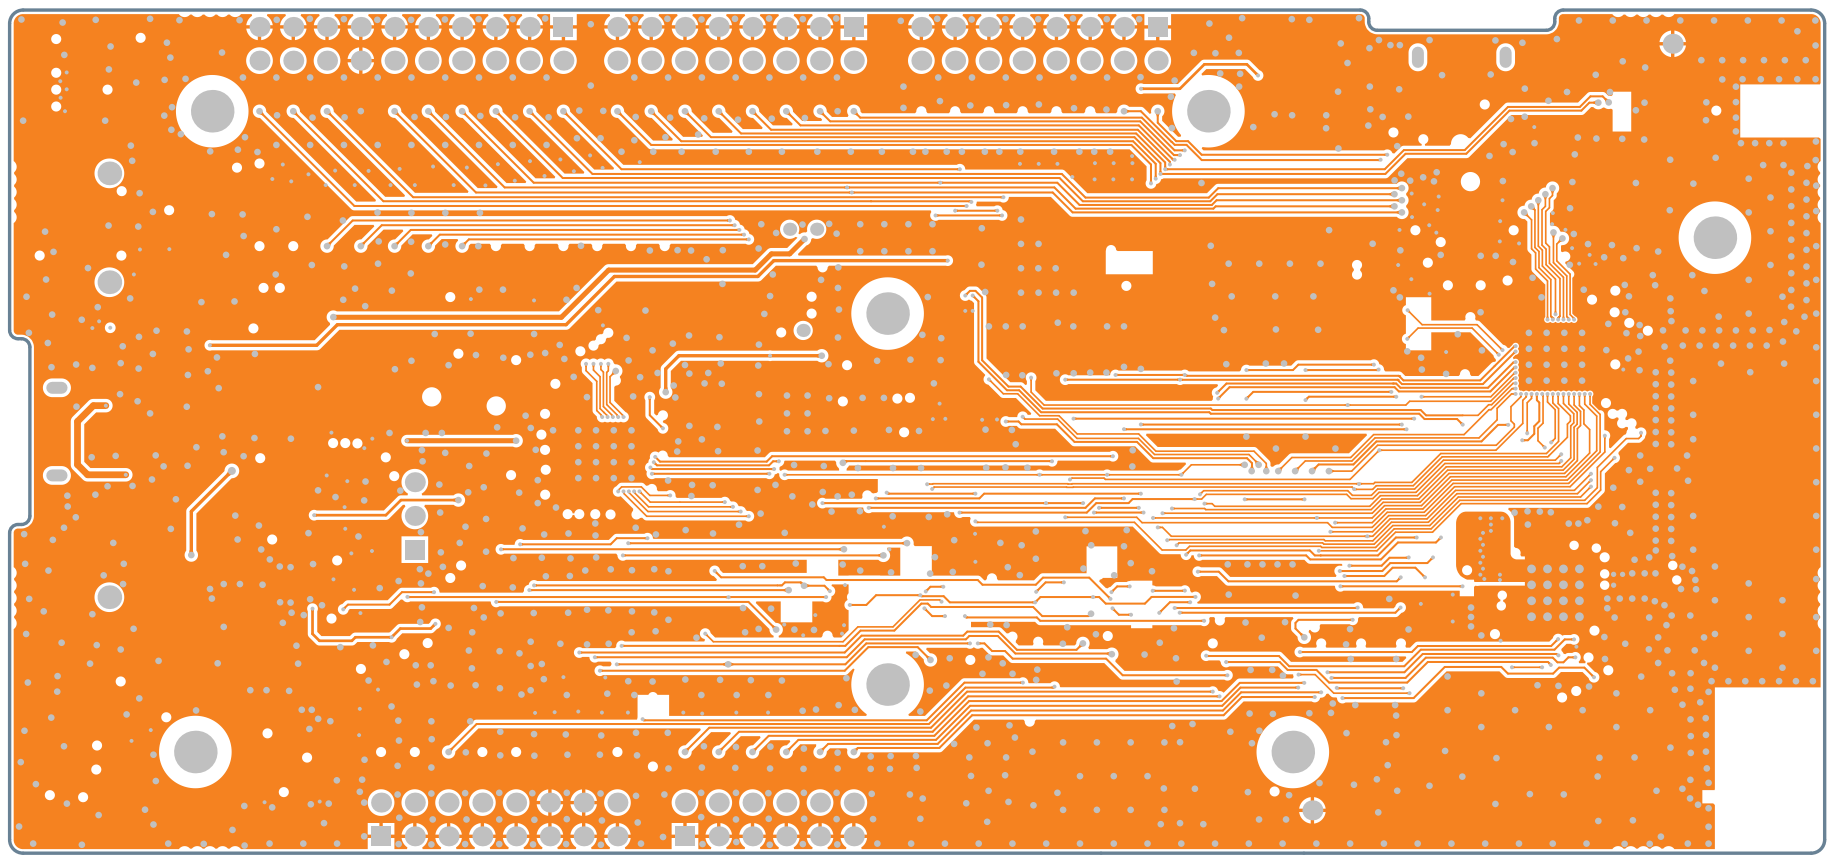
[picture p324: page 9]

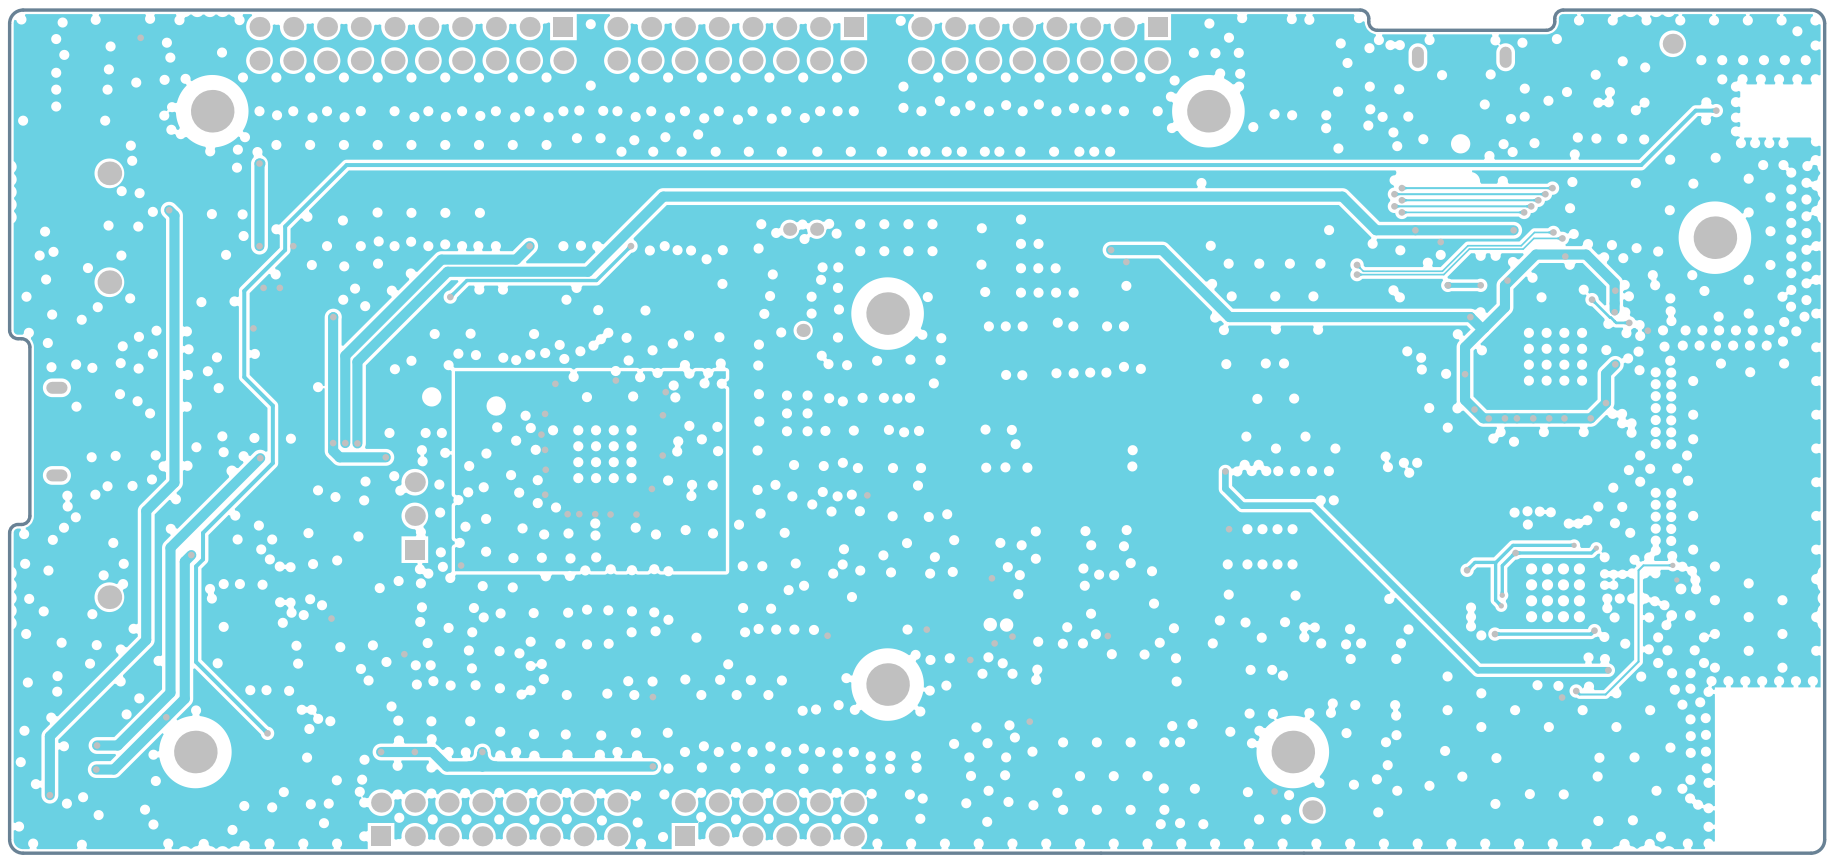
[picture p325: page 10]

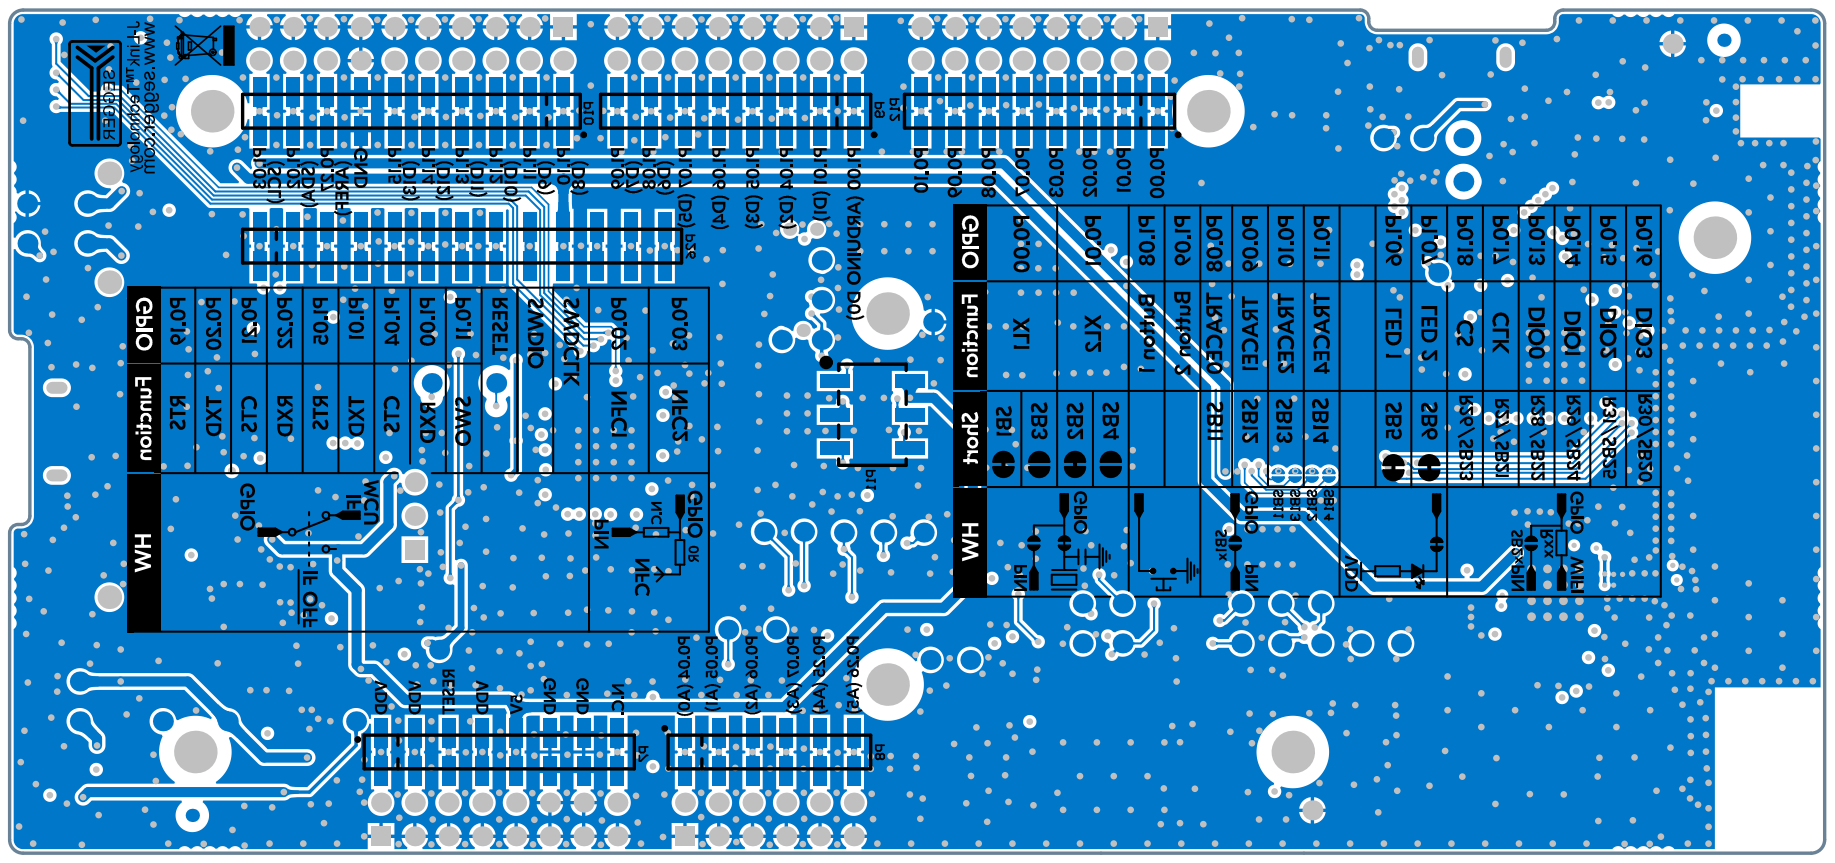
[picture p326: page 11]

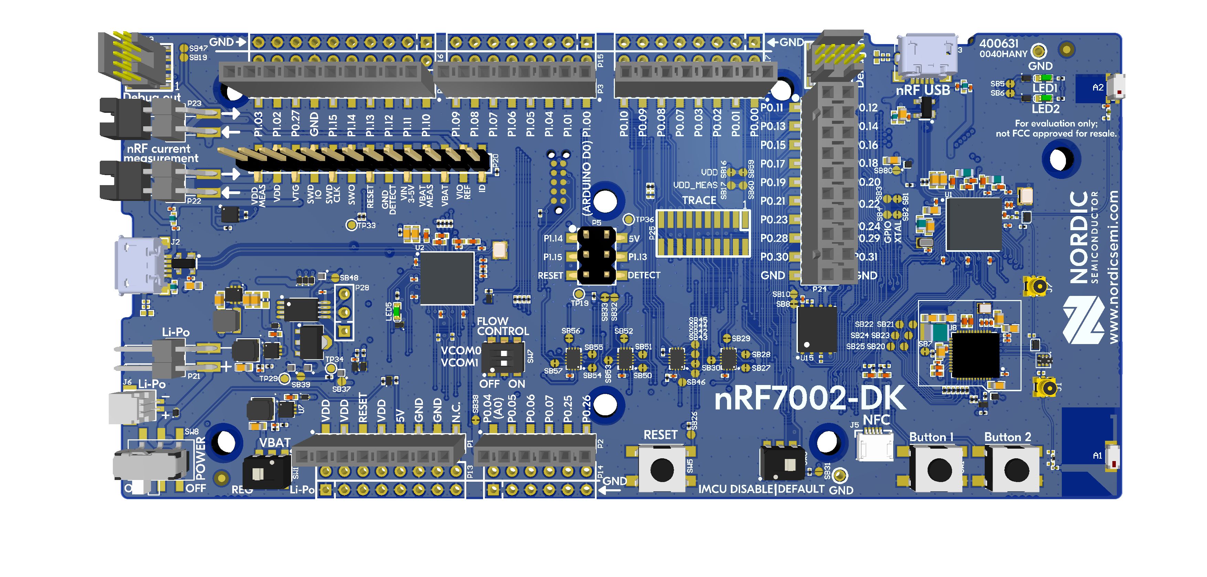
[picture p327: page 12]
