binphilxiao/AxisLabs/SB0101/LED PCB updates.pdf

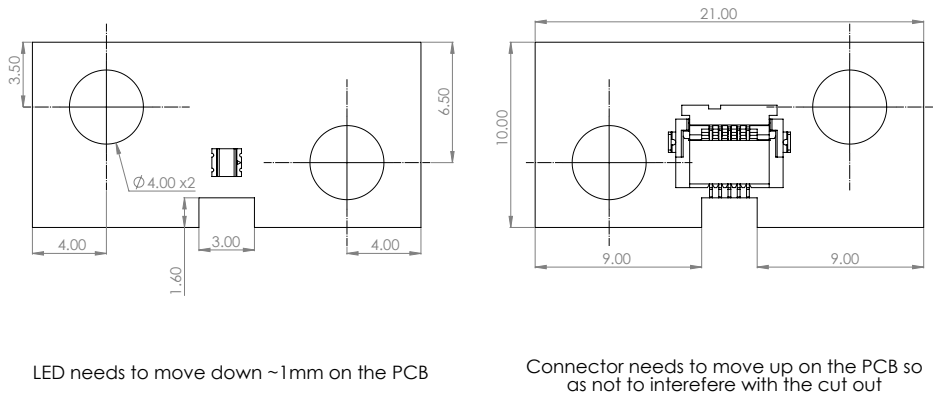
[picture p328: page 1]
LED needs to move down ~1mm on the PCB; Connector needs to move up on the PCB so

as not to interefere with the cut out
