binphilxiao/AxisLabs/SB0101/Button PCB assy v1.PDF

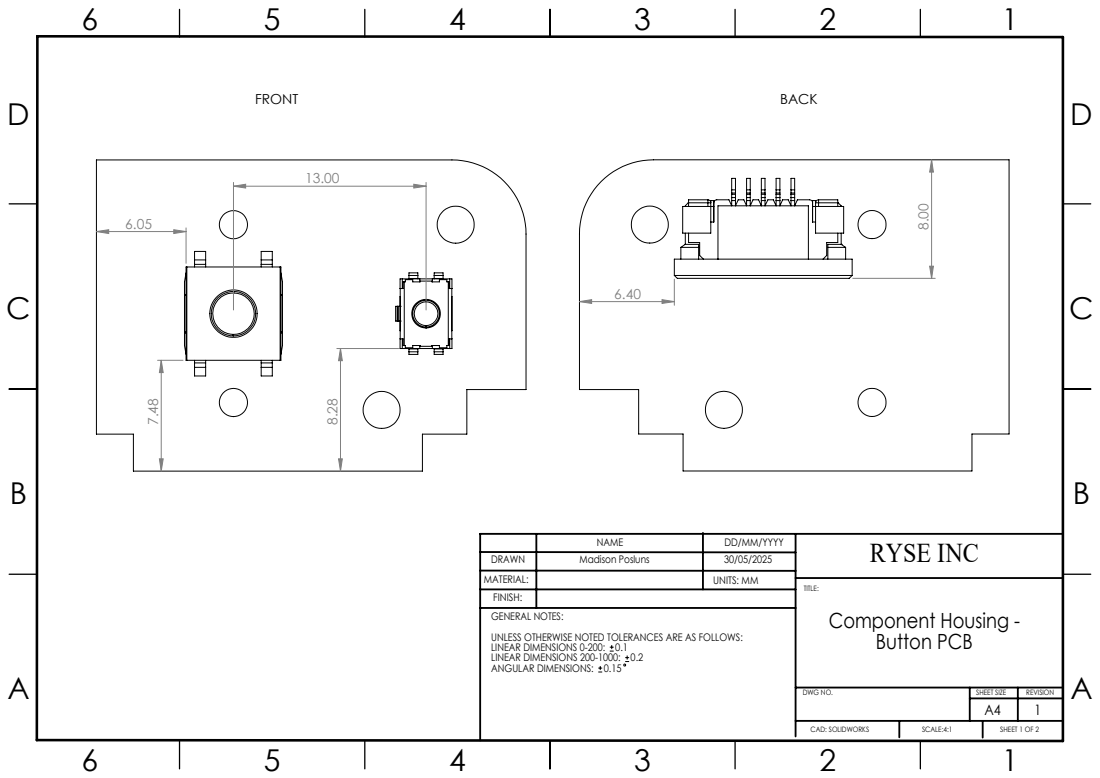
[picture p329: page 1]
Component Housing - Button PCB

NAME | DD/MM/YYYY | RYSE INC

DRAWN | Madison Posluns | 30/05/2025
MATERIAL: | | UNITS: MM
FINISH:

GENERAL NOTES:
UNLESS OTHERWISE NOTED TOLERANCES ARE AS FOLLOWS:
LINEAR DIMENSIONS 0-200: 0.1
LINEAR DIMENSIONS 200-1000: 0.2
ANGULAR DIMENSIONS: 0.15

DWG NO. | SHEET SIZE | REVISION

CAD: SOLIDWORKS | SCALE:4:1 | SHEET 1 OF 2

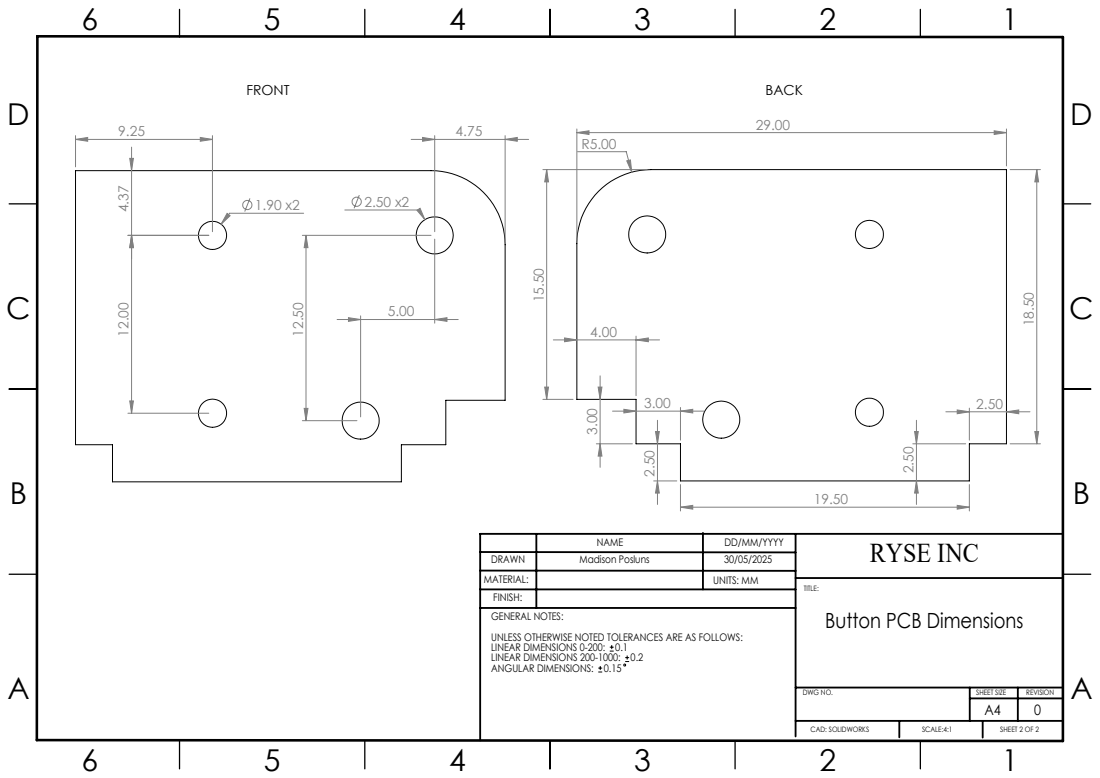
[picture p330: page 2]

NAME | DD/MM/YYYY | RYSE INC

DRAWN | Madison Posluns | 30/05/2025
MATERIAL: | | UNITS: MM
FINISH:

TITLE:
Button PCB Dimensions

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

DWG NO. | SHEET SIZE | REVISION

CAD: SOLIDWORKS | SCALE:4:1 | SHEET 2 OF 2
