binphilxiao/AxisLabs/SB0101/Button PCB assy.pdf

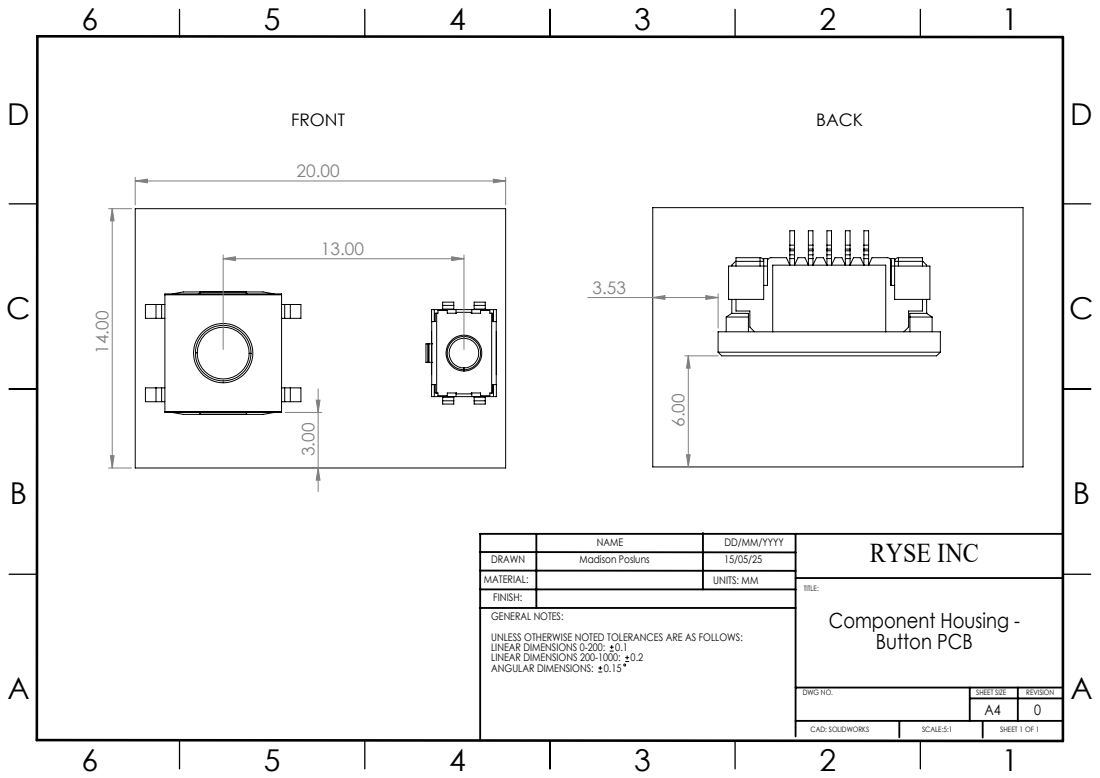
[picture p331: page 1]
Component Housing - Button PCB

NAME | DD/MM/YYYY | RYSE INC

DRAWN | Madison Posluns | 15/05/25
MATERIAL: | | UNITS: MM
FINISH:

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

DWG NO. | SHEET SIZE | REVISION

CAD: SOLIDWORKS | SCALE:5:1 | SHEET 1 OF 1
