binphilxiao/AxisLabs/SB0101/LS20R130SH-50-3.780(2) - English.pdf

# 深圳市立盛电机有限公司

电话：0755-21001719 | 传真：0755-21001089

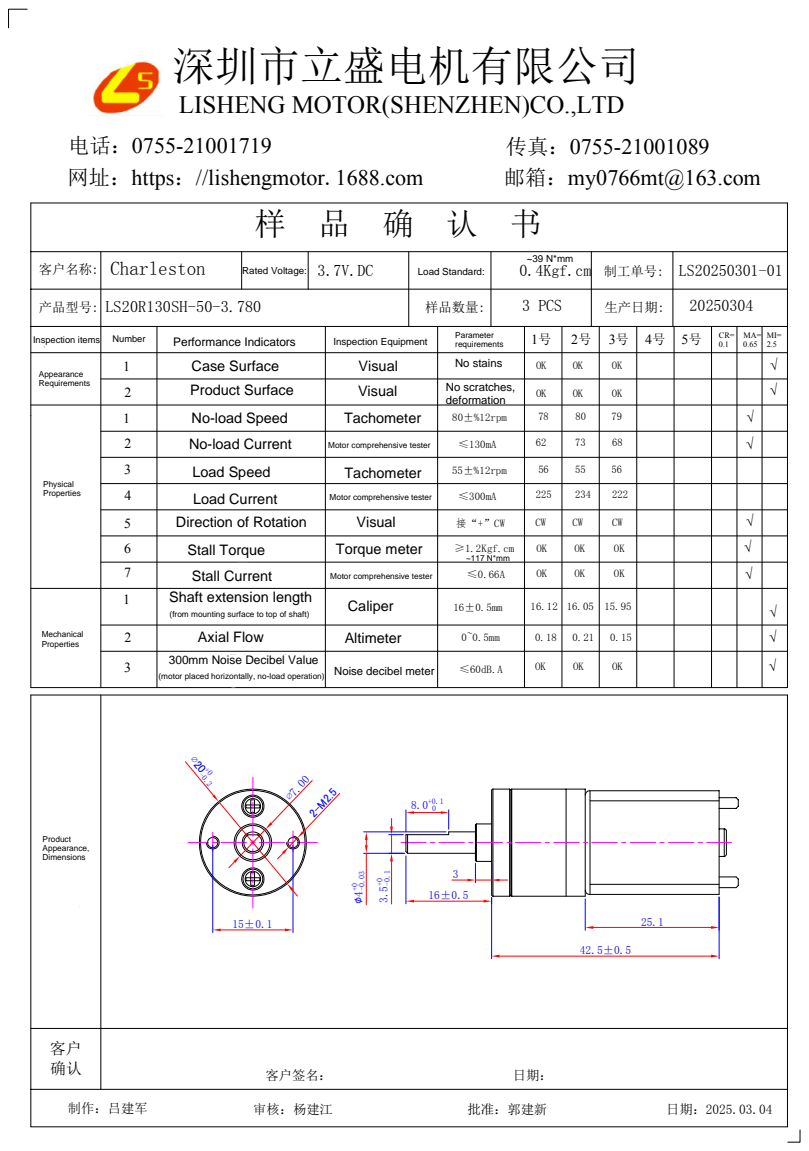
[picture p332: page 1]
网址：https：//lishengmotor.1688.com; 邮箱：my0766mt@163.com; 制作：吕建军; 审核：杨建江; 批准：郭建新; 客户签名：

LISHENG MOTOR(SHENZHEN)CO.,LTD

客户名称: | Charleston | 额定电压: | 3.7V.DC | 负载标准: | 0.4Kgf.cm | 制工单号: | LS20250301-01

产品型号: | LS20R130SH-50-3.780 | | | 样品数量: | 3 PCS | 生产日期: | 20250304

检查项目 | 序号 | 性能指标 | 检验器材 | 参数要求 | | 2号 | 3号 | 4号 | 5号 | CR= 0.1 | MA= 0.65 | 2.5 MI= 1号

外观要求 | 1 | 机壳表面 | 目视 | 无污渍 | OK | OK | OK | | | | | √

2 | 产品表面 | 目视 | 无划伤,刮伤,变形 | OK | OK | OK | | | | | √

物 理 性 能 | 1 | 空载转速 | 转速仪 | 80±%12rpm | 78 80 | | 79 | | | | √

2 | 空载电流 | 电机综合测试仪 | ≤130mA | 62 73 | | 68 | | | | √
3 | 负载转速 | 转速仪 | 55±%12rpm | 56 55 | | 56
4 | 负载电流 | 电机综合测试仪 | ≤300mA | 225 234 | | 222
5 | 旋转方向 | 目视 | 接“+”CW | CW | CW | CW | | | | √
6 | 堵转扭力 | 扭力计 | ≥1.2Kgf.cm | OK | OK | OK | | | | √
7 | 堵转电流 | 电机综合测试仪 | ≤0.66A | OK | OK | OK | | | | √

机 械 性 能 | 1 | 轴伸长度 （从安装面到轴顶端） | 卡尺 | 16±0.5mm | 16.12 16.05 | | 15.95 | | | | | √

2 | 轴向窜量 | 高度计 | 0~0.5mm | 0.18 0.21 | | 0.15 | | | | | √
3 | 300mm噪音分贝值 （电机水平放置，空载运转） | 噪音分贝仪 | ≤60dB.A | OK | OK | OK | | | | | √
