binphilxiao/AxisLabs/RB0101/Certification/PCK-000133_SmartButton_Certifications Laser Marking_Rev01.pdf

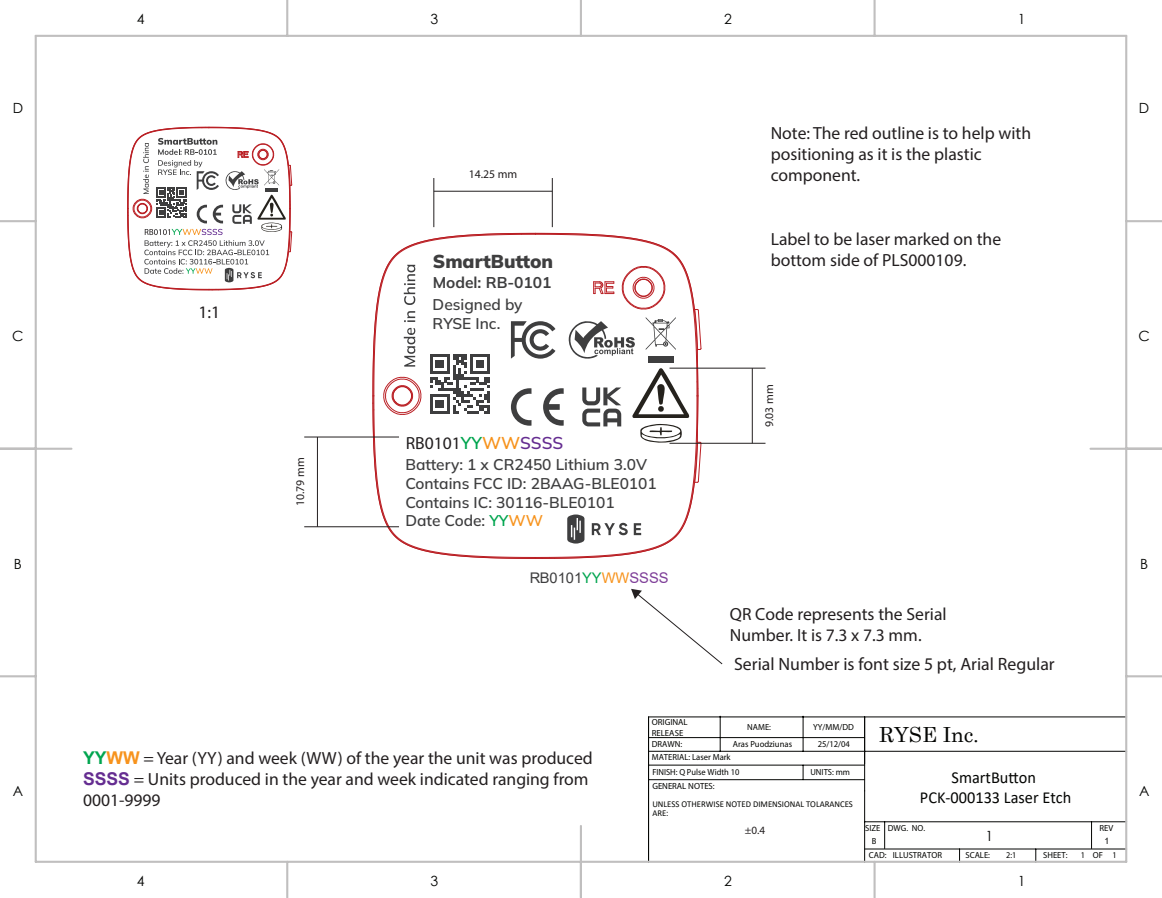
[picture p333: page 1]
SCALE:; SIZE; DWG. NO.; SHEET:; REV; CAD: ILLUSTRATOR; RB0101YYWWSSSS; SmartButton Model: RB-0101 Designed by RYSE Inc. 1:1

Note: The red outline is to help with
positioning as it is the plastic
component.

Label to be laser marked on the
bottom side of PLS000109.

RB0101YYWWSSSS
Battery: 1 x CR2450 Lithium 3.0V
Contains FCC ID: 2BAAG-BLE0101
Contains IC: 30116-BLE0101
Date Code: YYWW

QR Code represents the Serial
Number. It is 7.3 x 7.3 mm.
Serial Number is font size 5 pt, Arial Regular

RELEASE | NAME: | YY/MM/DD ORIGINAL | RYSE Inc. DRAWN:

Aras Puodziunas | 25/12/04

YYWW = Year (YY) and week (WW) of the year the unit was produced
SSSS = Units produced in the year and week indicated ranging from

MATERIAL: Laser Mark | | | SmartButton PCK-000133 Laser Etch
FINISH: Q Pulse Width 10 | | UNITS: mm

GENERAL NOTES:
UNLESS OTHERWISE NOTED DIMENSIONAL TOLARANCES
ARE:
