binphilxiao/AxisLabs/SC0101/Certification/PCB-000037 PCB-SC0101 Rev.C_ASM.pdf

J8 | J7

J9

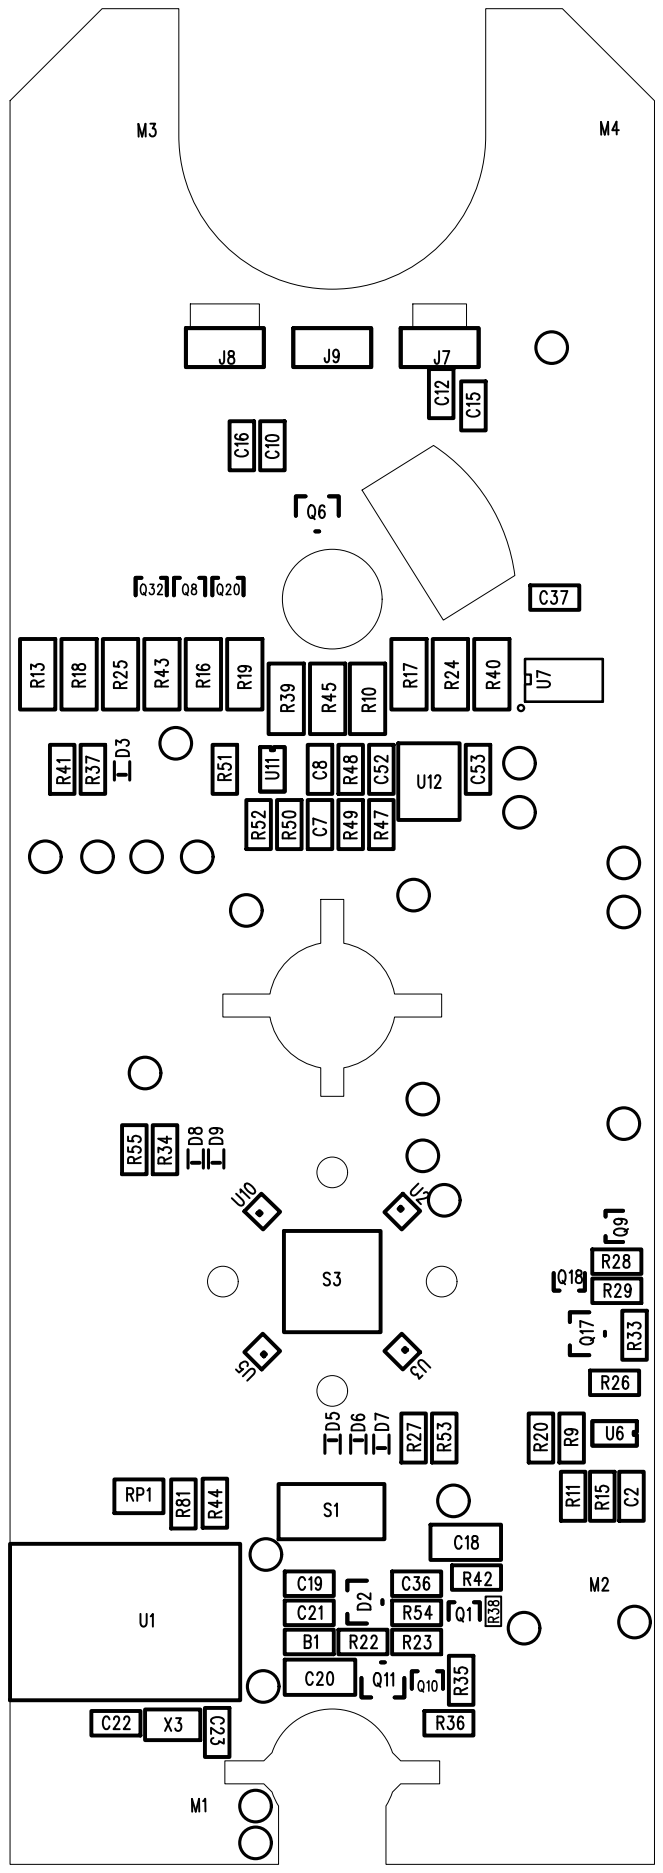
[picture p334: page 1]

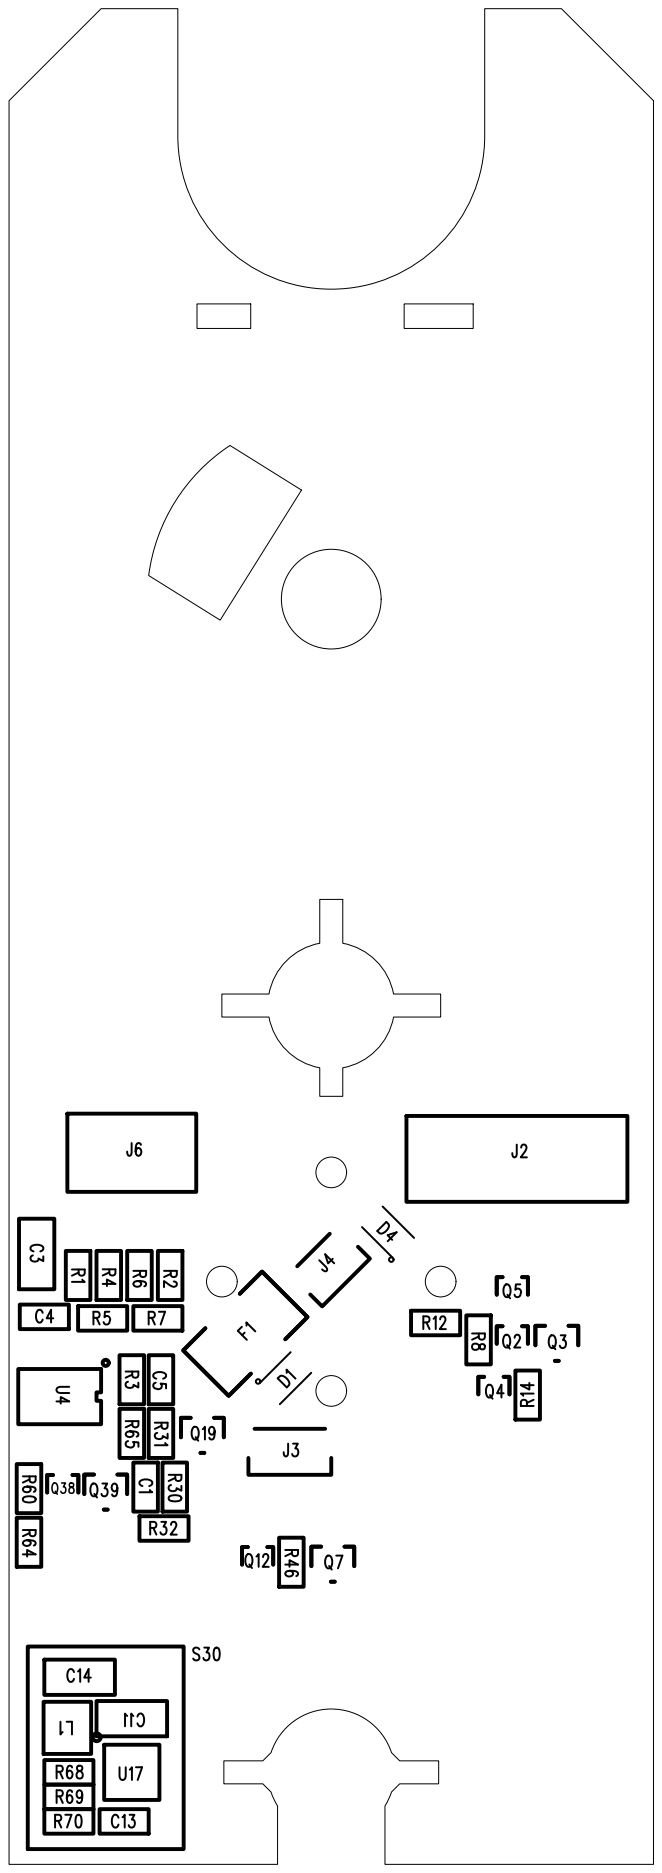
[picture p335: page 2]

42.00mm
15.00mm | 15.00mm

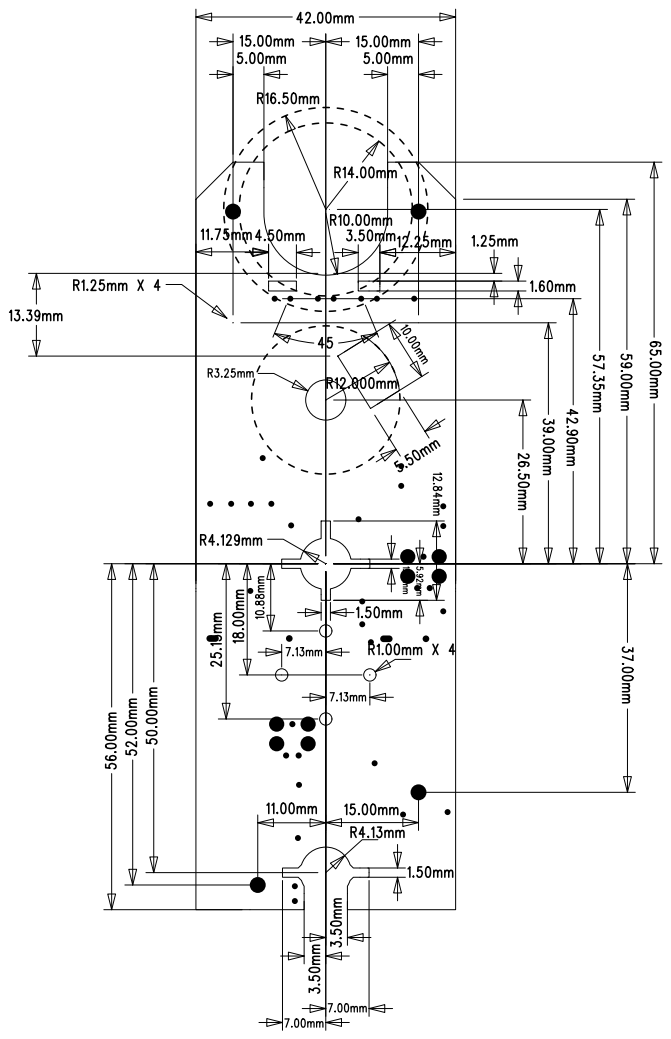
[picture p336: page 3]
