binphilxiao/AxisLabs/SC0101/Certification/PCB-000037 PCB-SC0101 Rev.C_SCH.pdf

D

6 | 5 | 4 | 3 | 2 | 1

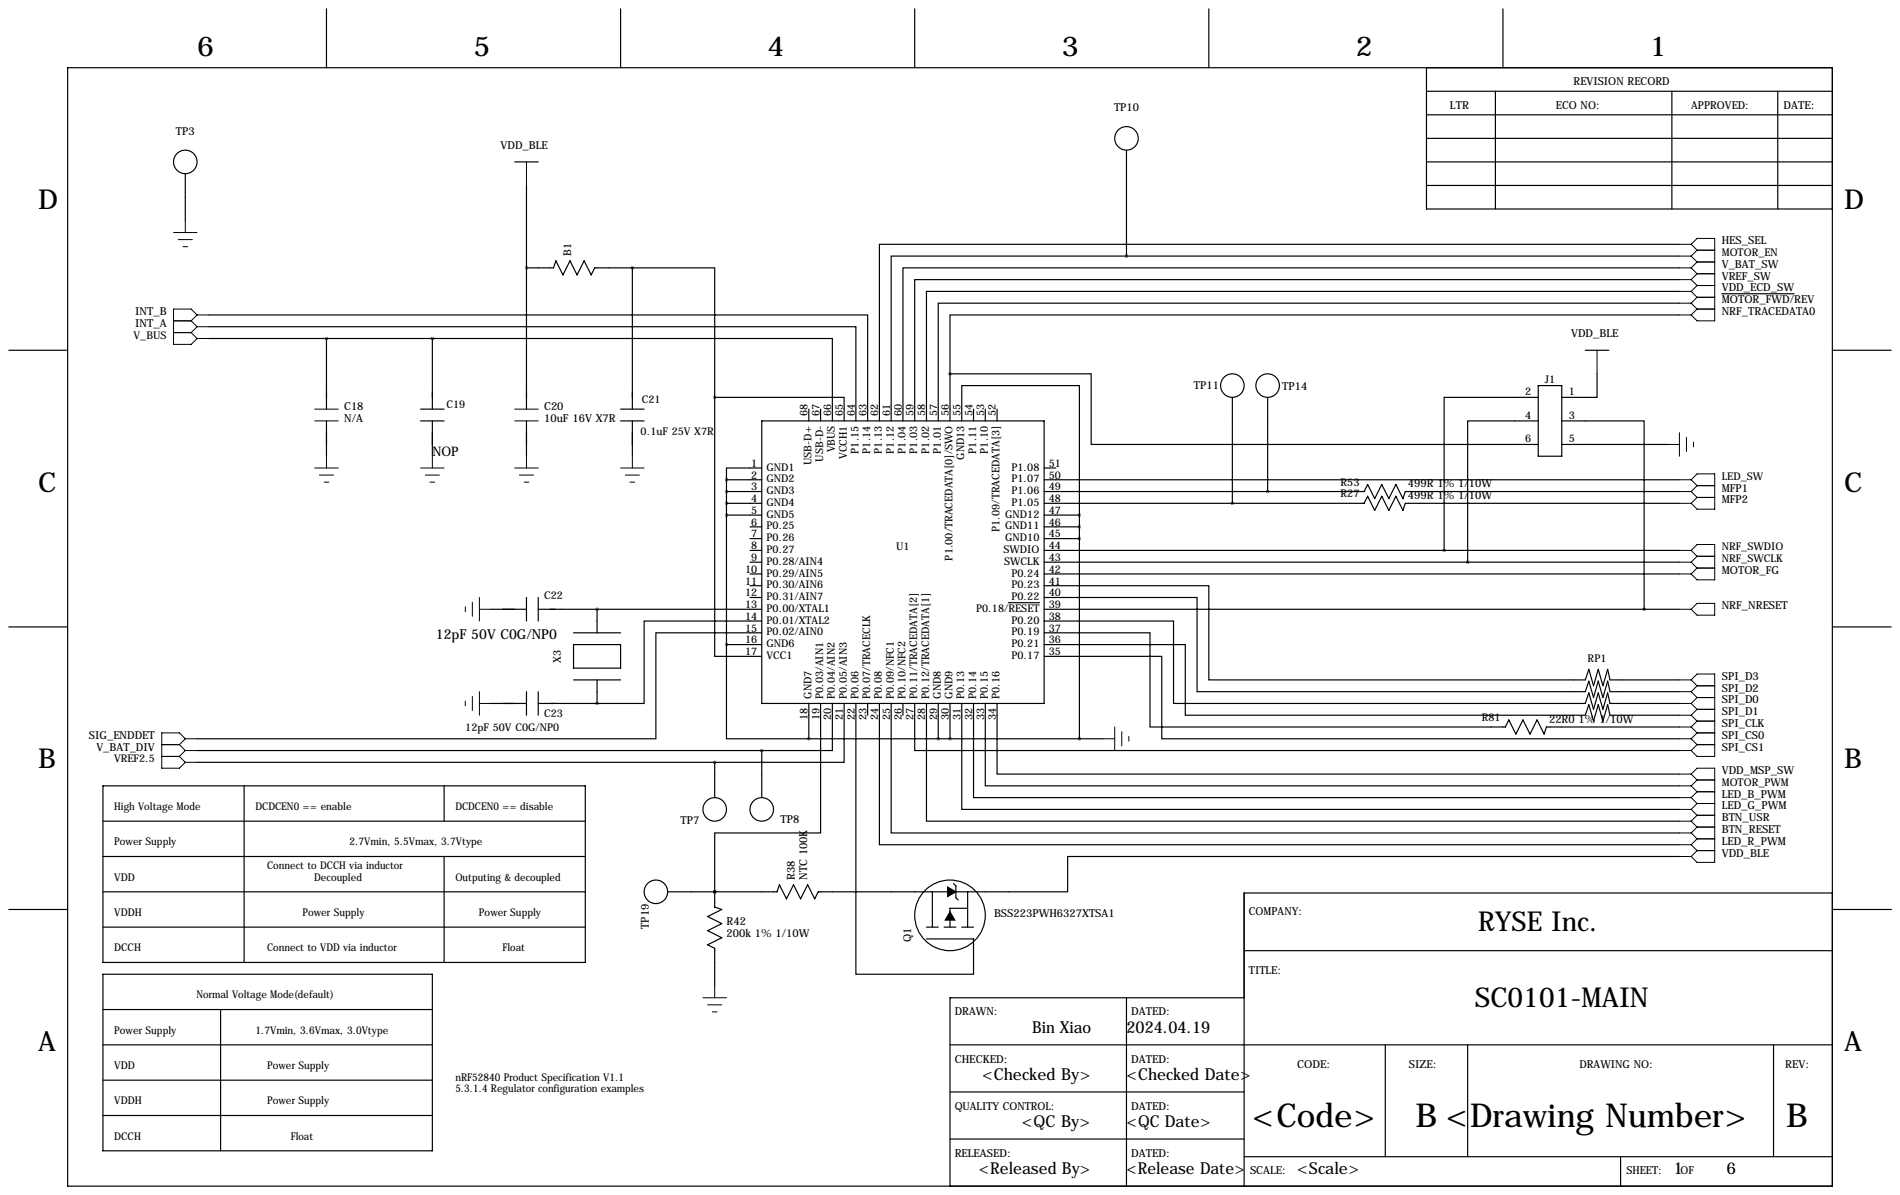
[picture p337: page 1]

REVISION RECORD

LTR | ECO NO: | APPROVED: | DATE:

43 SWCLK
42 P0.24
41 P0.23
40 P0.22

High Voltage Mode | DCDCEN0 == enable | DCDCEN0 == disable

Power Supply | 2.7Vmin, 5.5Vmax, 3.7Vtype

VDD | Connect to DCCH via inductor Decoupled | Outputing & decoupled

Connect to VDD via inductor

Normal Voltage Mode(default)

DRAWN: Bin Xiao | DATED: 2024.04.19

Power Supply | 1.7Vmin, 3.6Vmax, 3.0Vtype

VDDH | Power Supply

QUALITY CONTROL: <QC By> | DATED: <QC Date>

DCCH | Float

RELEASED: <Released By> | DATED: <Release Date>

<Scale> SCALE: | 1 6 SHEET: OF

D

D

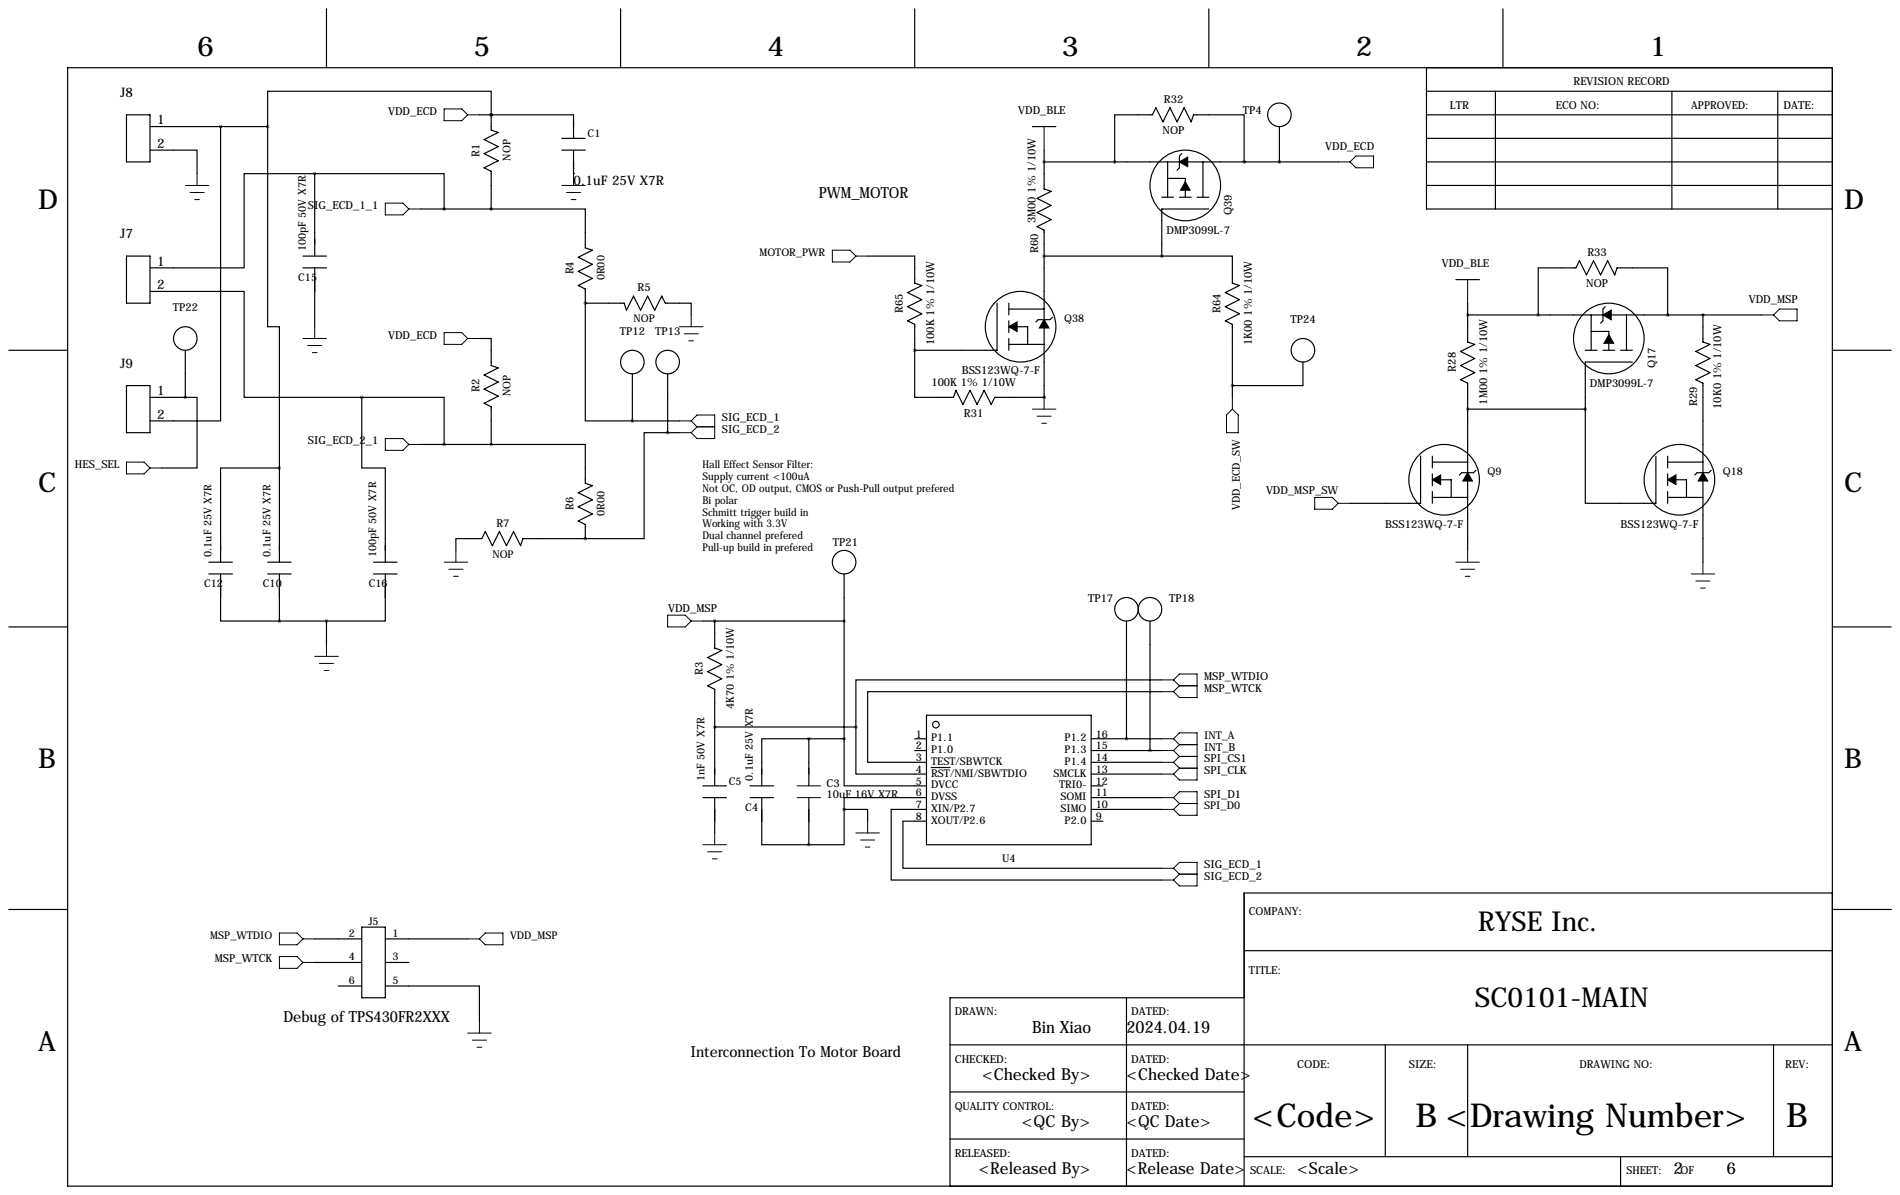
[picture p338: page 2]

REVISION RECORD

LTR | ECO NO: | APPROVED: | DATE:

Hall Effect Sensor Filter:
Supply current <100uA
Not OC, OD output, CMOS or Push-Pull output prefered
Bi polar
Schmitt trigger build in
Working with 3.3V
Dual channel prefered
Pull-up build in prefered

DRAWN: Bin Xiao | DATED: 2024.04.19
CHECKED: <Checked By> | DATED: <Checked Date> | CODE: <Code> | SIZE: B <Drawing Number> | DRAWING NO: | REV: B

Interconnection To Motor Board

QUALITY CONTROL: <QC By> | DATED: <QC Date>

D

D

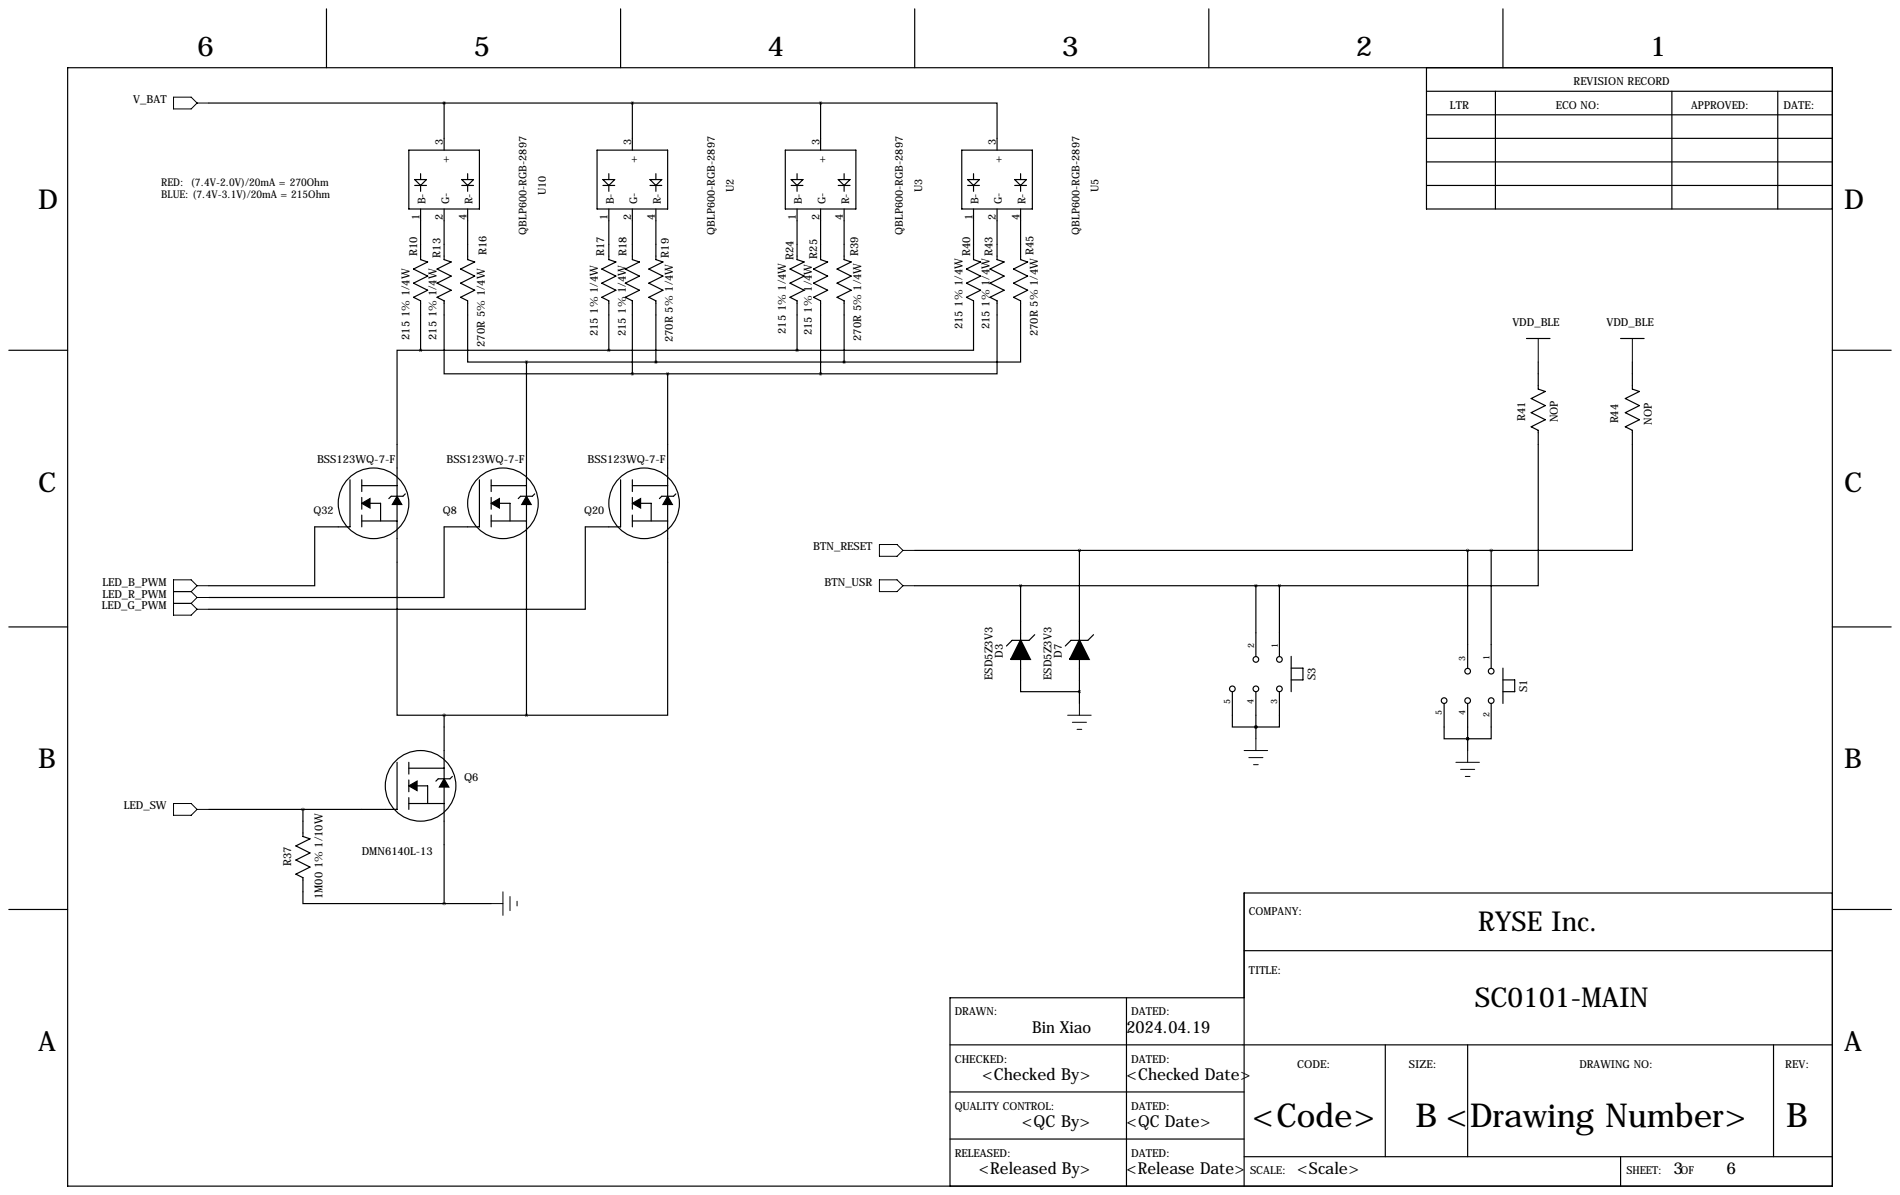
[picture p339: page 3]

REVISION RECORD

LTR | ECO NO: | APPROVED: | DATE:

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

QUALITY CONTROL: <QC By> | DATED: <QC Date>

# ABD

6

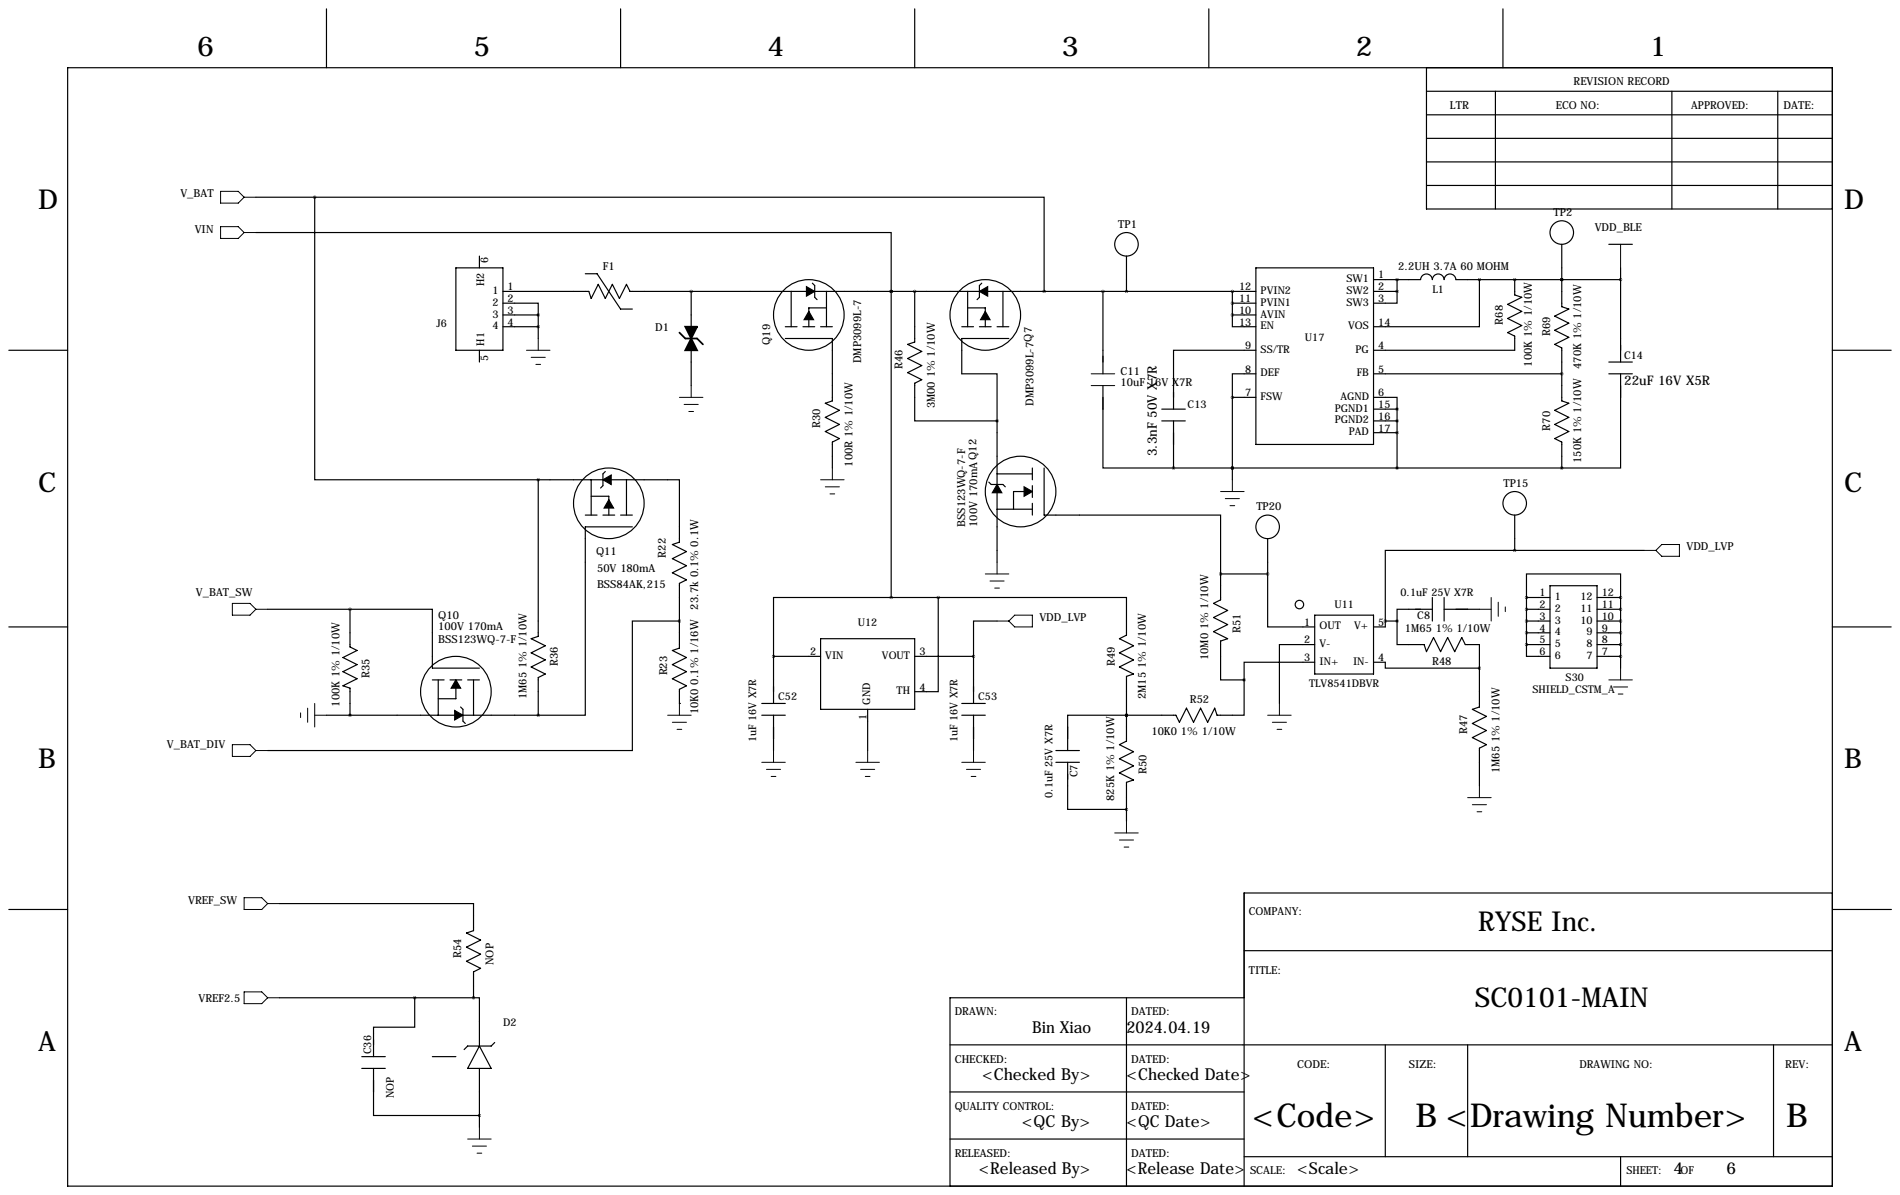
[picture p340: page 4]

REVISION RECORD

LTR | ECO NO: | APPROVED: | DATE:

3 | 10 10

DRAWN: Bin Xiao | DATED: 2024.04.19

CHECKED: <Checked By> | DATED: <Checked Date> | CODE: <Code> | SIZE: B <Drawing Number> | DRAWING NO: | REV: B

QUALITY CONTROL: <QC By> | DATED: <QC Date>

D

D

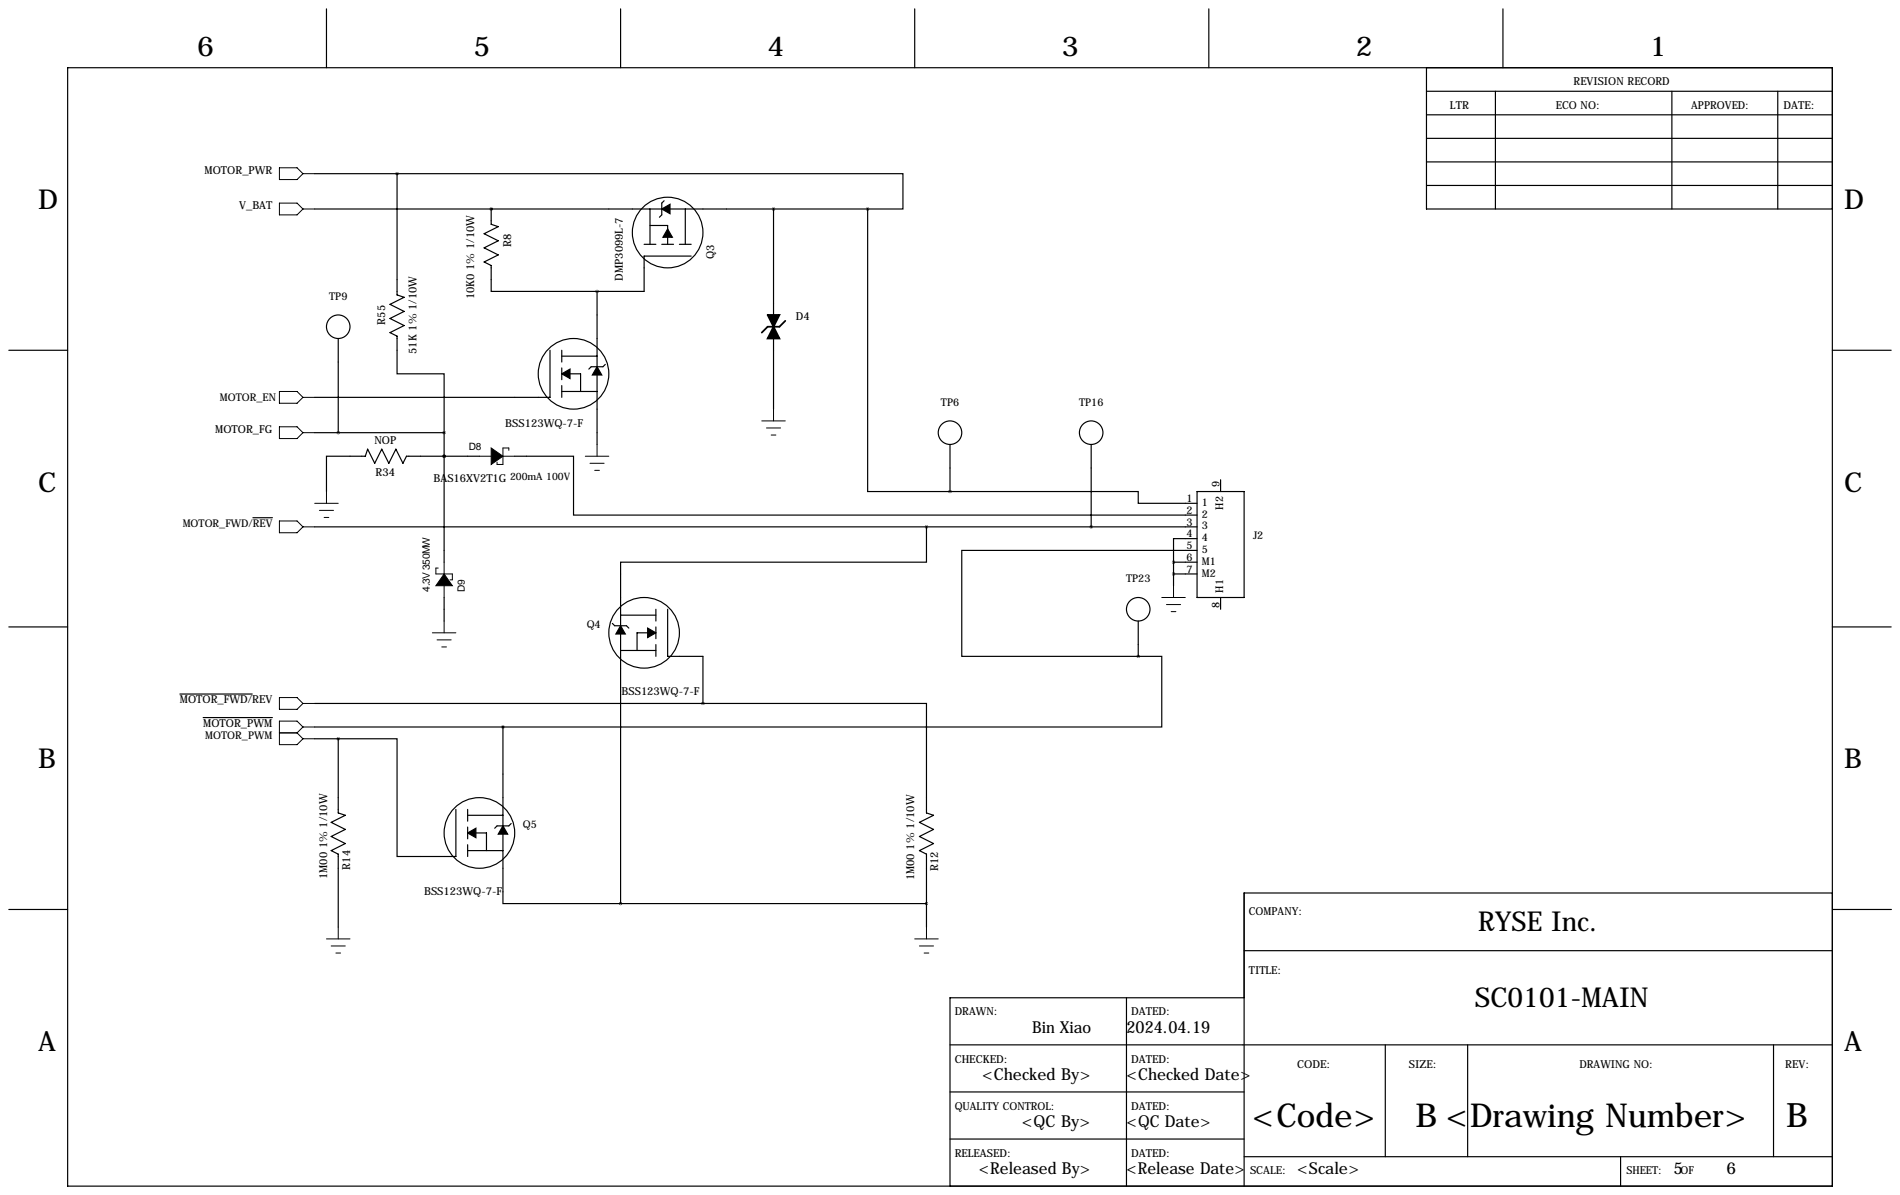
[picture p341: page 5]

REVISION RECORD

LTR | ECO NO: | APPROVED: | DATE:

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

QUALITY CONTROL: <QC By> | DATED: <QC Date>

D

D

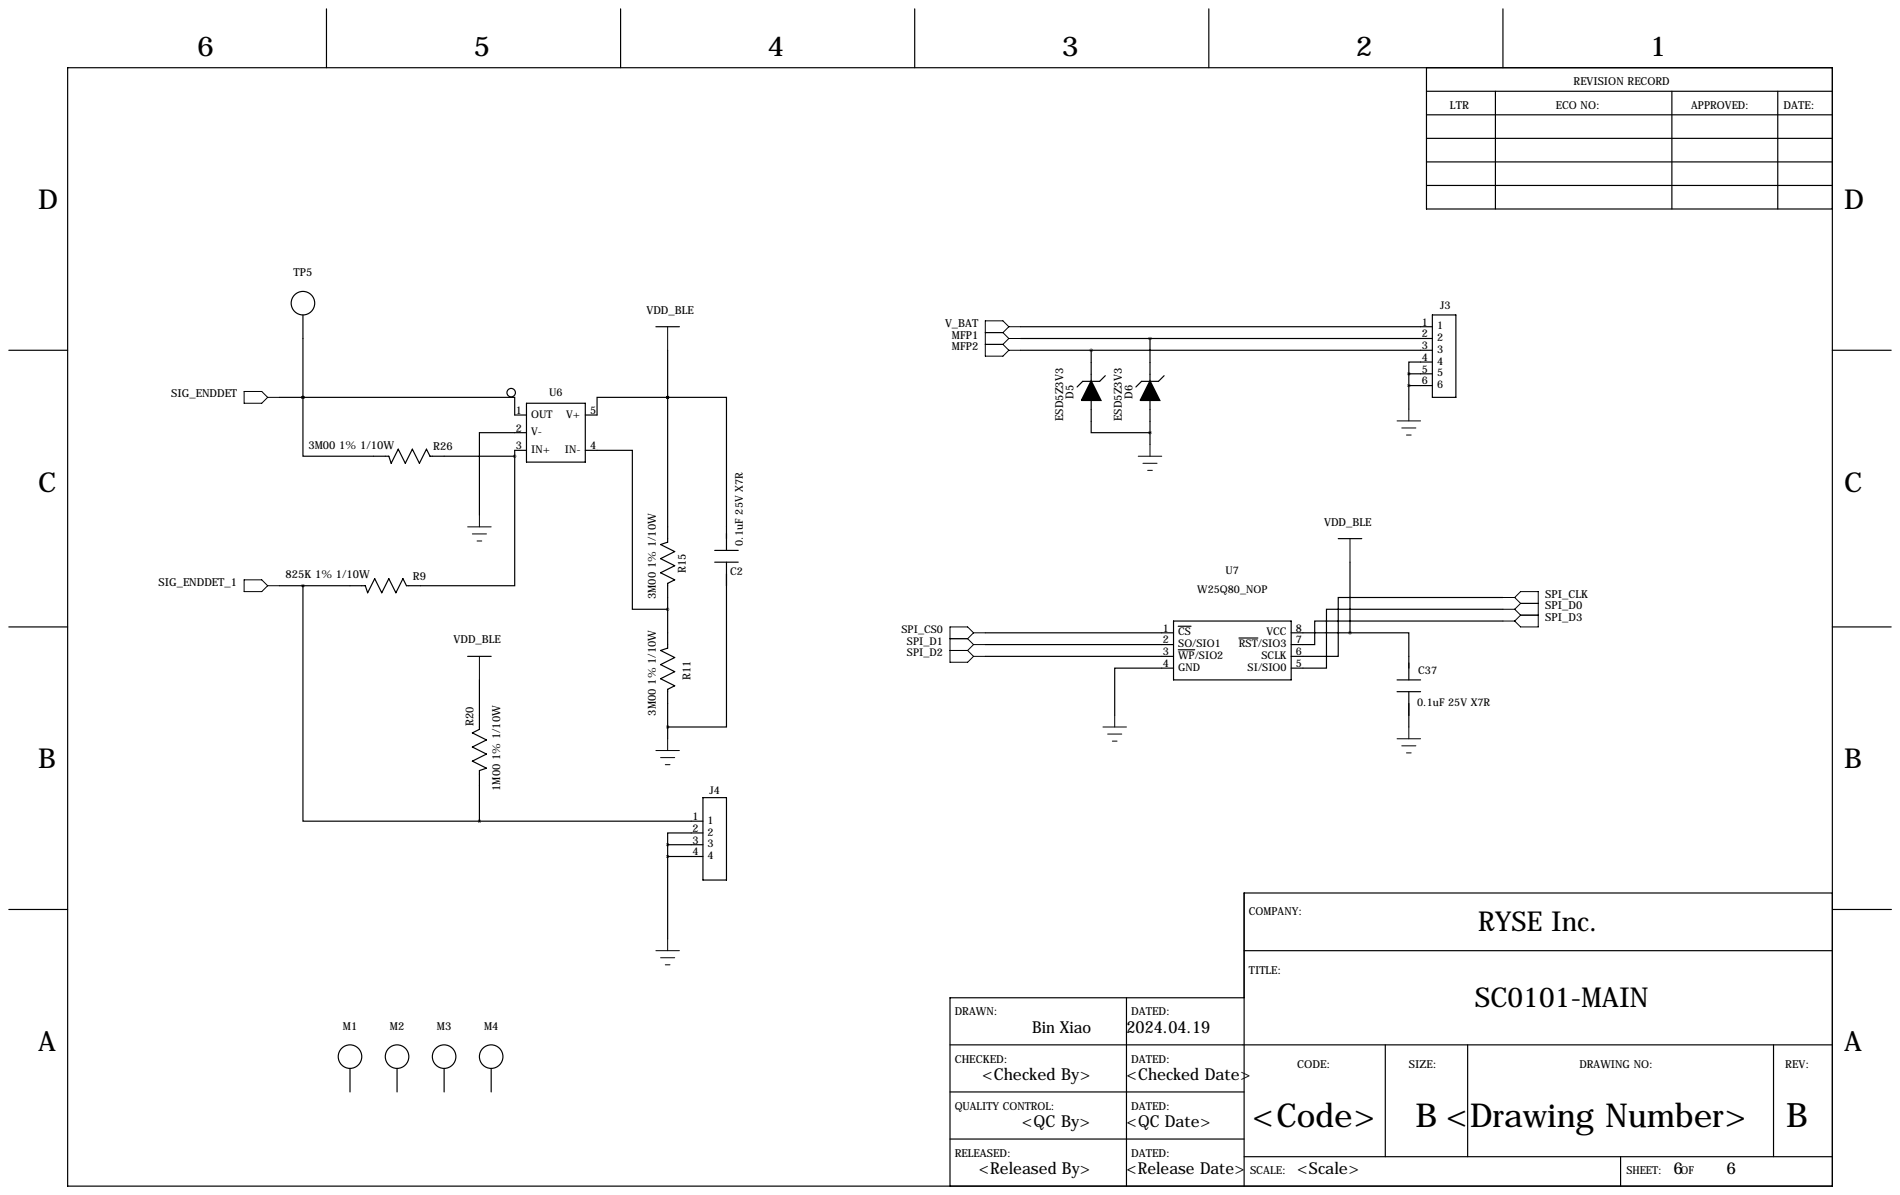
[picture p342: page 6]

VDD_BLE | REVISION RECORD

LTR | ECO NO: | APPROVED: | DATE:

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

QUALITY CONTROL: <QC By> | DATED: <QC Date>
