binphilxiao/AxisLabs/RC0101&DC0101/Docs/231108-PCBRevB Switch Locations.PDF

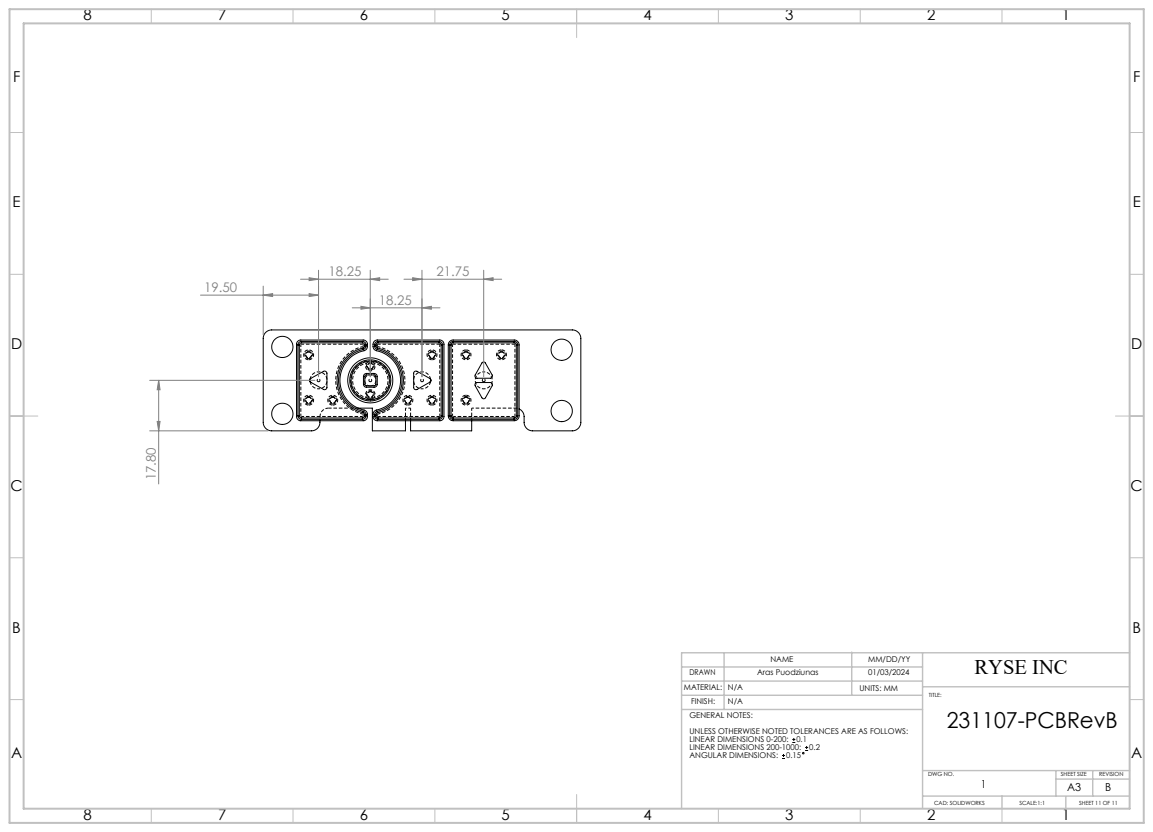
[picture p343: page 1]

NAME | MM/DD/YY | RYSE INC

DRAWN | Aras Puodziunas | 01/03/2024
MATERIAL: | N/A | UNITS: MM
FINISH: | N/A

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

DWG NO. 1 | SHEET SIZE | REVISION

CAD: SOLIDWORKS | SCALE:1:1 | SHEET 11 OF 11
