binphilxiao/AxisLabs/RC0101&DC0101/Docs/230209-RemoteController-Rev01.pdf

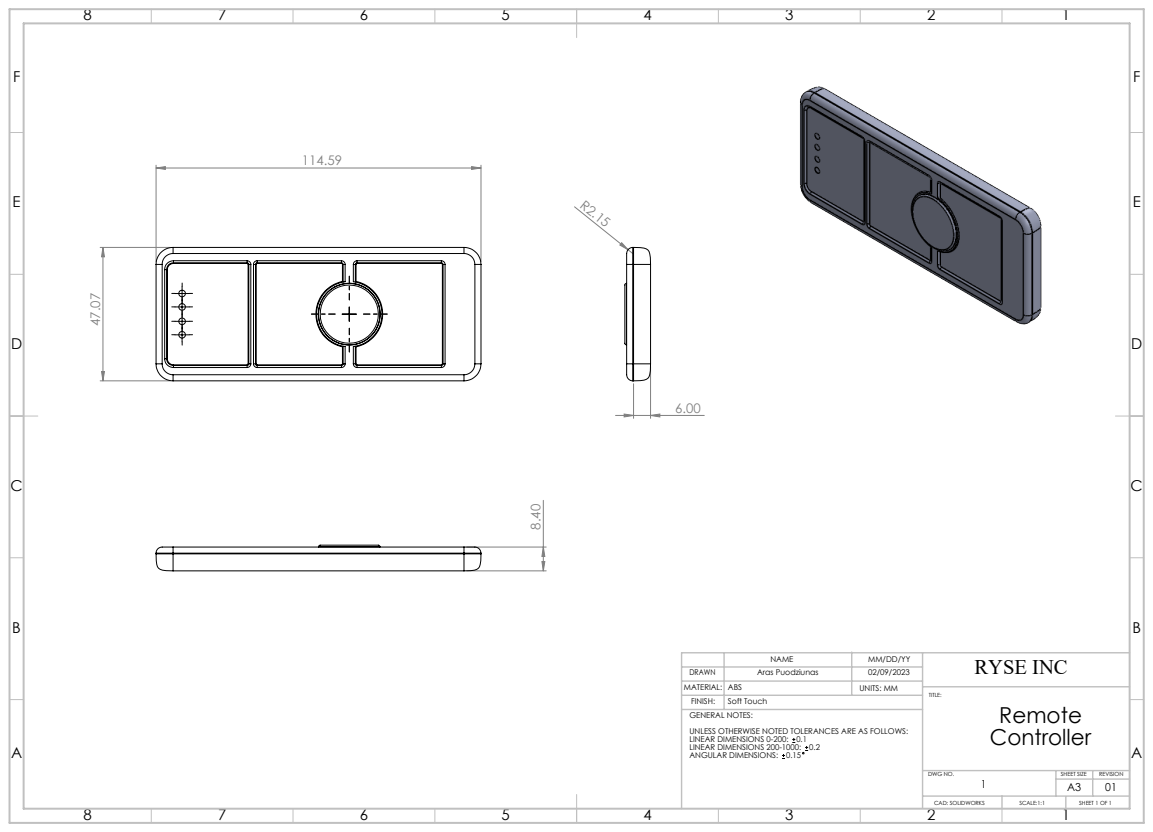
[picture p344: page 1]

NAME | MM/DD/YY | RYSE INC

DRAWN | Aras Puodziunas | 02/09/2023
MATERIAL: | ABS | UNITS: MM
FINISH: | Soft Touch

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

DWG NO. 1 | SHEET SIZE | REVISION

CAD: SOLIDWORKS | SCALE:1:1 | SHEET 1 OF 1
