binphilxiao/AxisLabs/GR0102/Drawing/Pulley Sensor PCBA.pdf

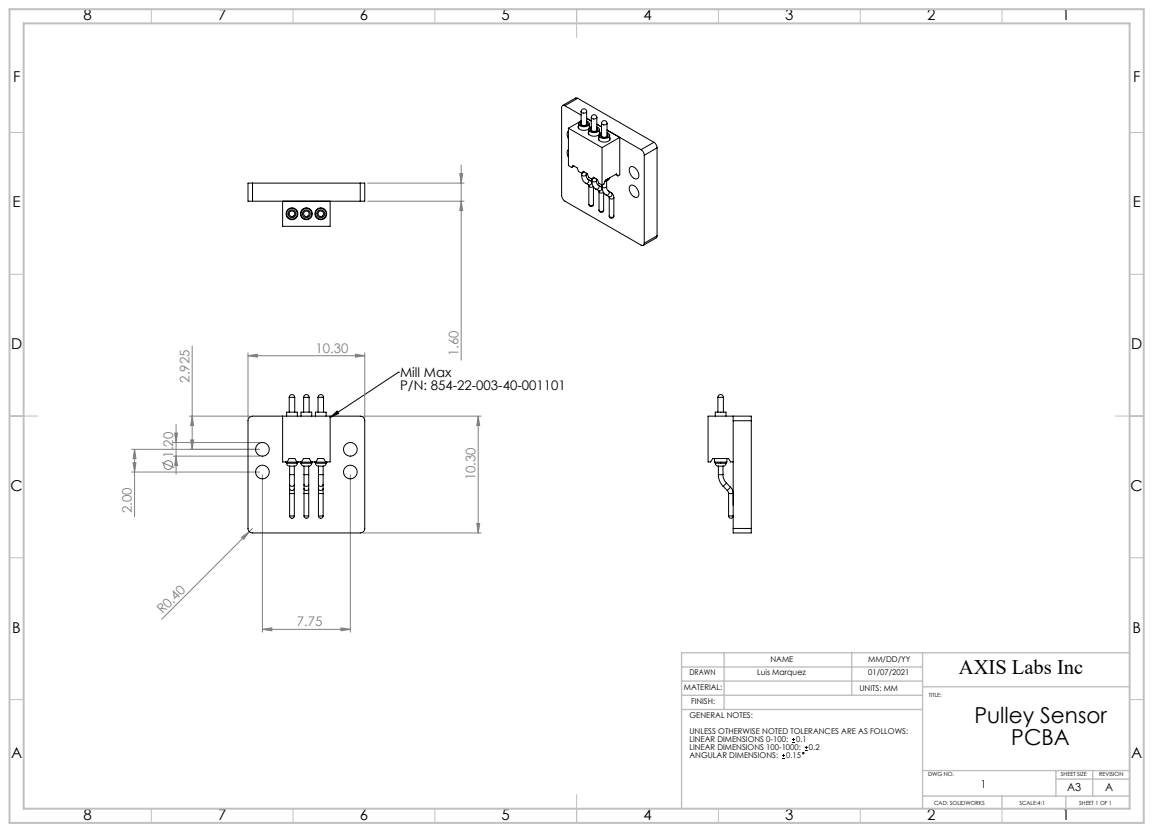
[picture p345: page 1]
Mill Max; Pulley Sensor

NAME | MM/DD/YY | AXIS Labs Inc

DRAWN | Luis Marquez | 01/07/2021
MATERIAL: | | UNITS: MM
FINISH:

GENERAL NOTES:
UNLESS OTHERWISE NOTED TOLERANCES ARE AS FOLLOWS:
LINEAR DIMENSIONS 0-100: 0.1
LINEAR DIMENSIONS 100-1000: 0.2
ANGULAR DIMENSIONS: 0.15

DWG NO. 1 | SHEET SIZE | REVISION

CAD: SOLIDWORKS | SCALE:4:1 | SHEET 1 OF 1
