binphilxiao/AxisLabs/GB0102/Drawing/PCB-GB-0102 Rev E (Pouch BP Front PCB).pdf

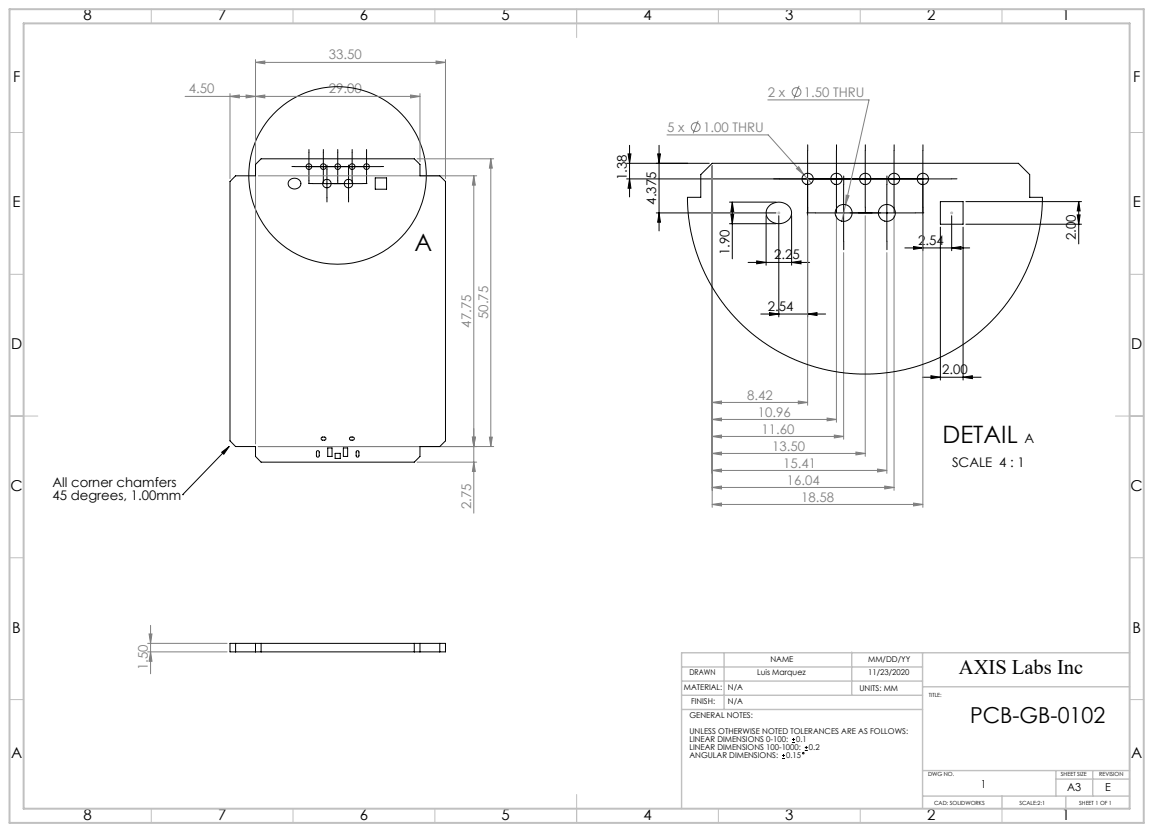
[picture p346: page 1]
5 x 1.00 THRU; DETAIL A; SCALE 4 : 1

33.50 29.00 2 x 1.50 THRU

All corner chamfers
45 degrees, 1.00mm 1.50

NAME | MM/DD/YY | AXIS Labs Inc

DRAWN | Luis Marquez | 11/23/2020
MATERIAL: | N/A | UNITS: MM
FINISH: | N/A

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

DWG NO. 1 | SHEET SIZE | REVISION

CAD: SOLIDWORKS | SCALE:2:1 | SHEET 1 OF 1
