binphilxiao/AxisLabs/GR0102/Drawing/PCB-000007 (Bottom PCB Board).pdf

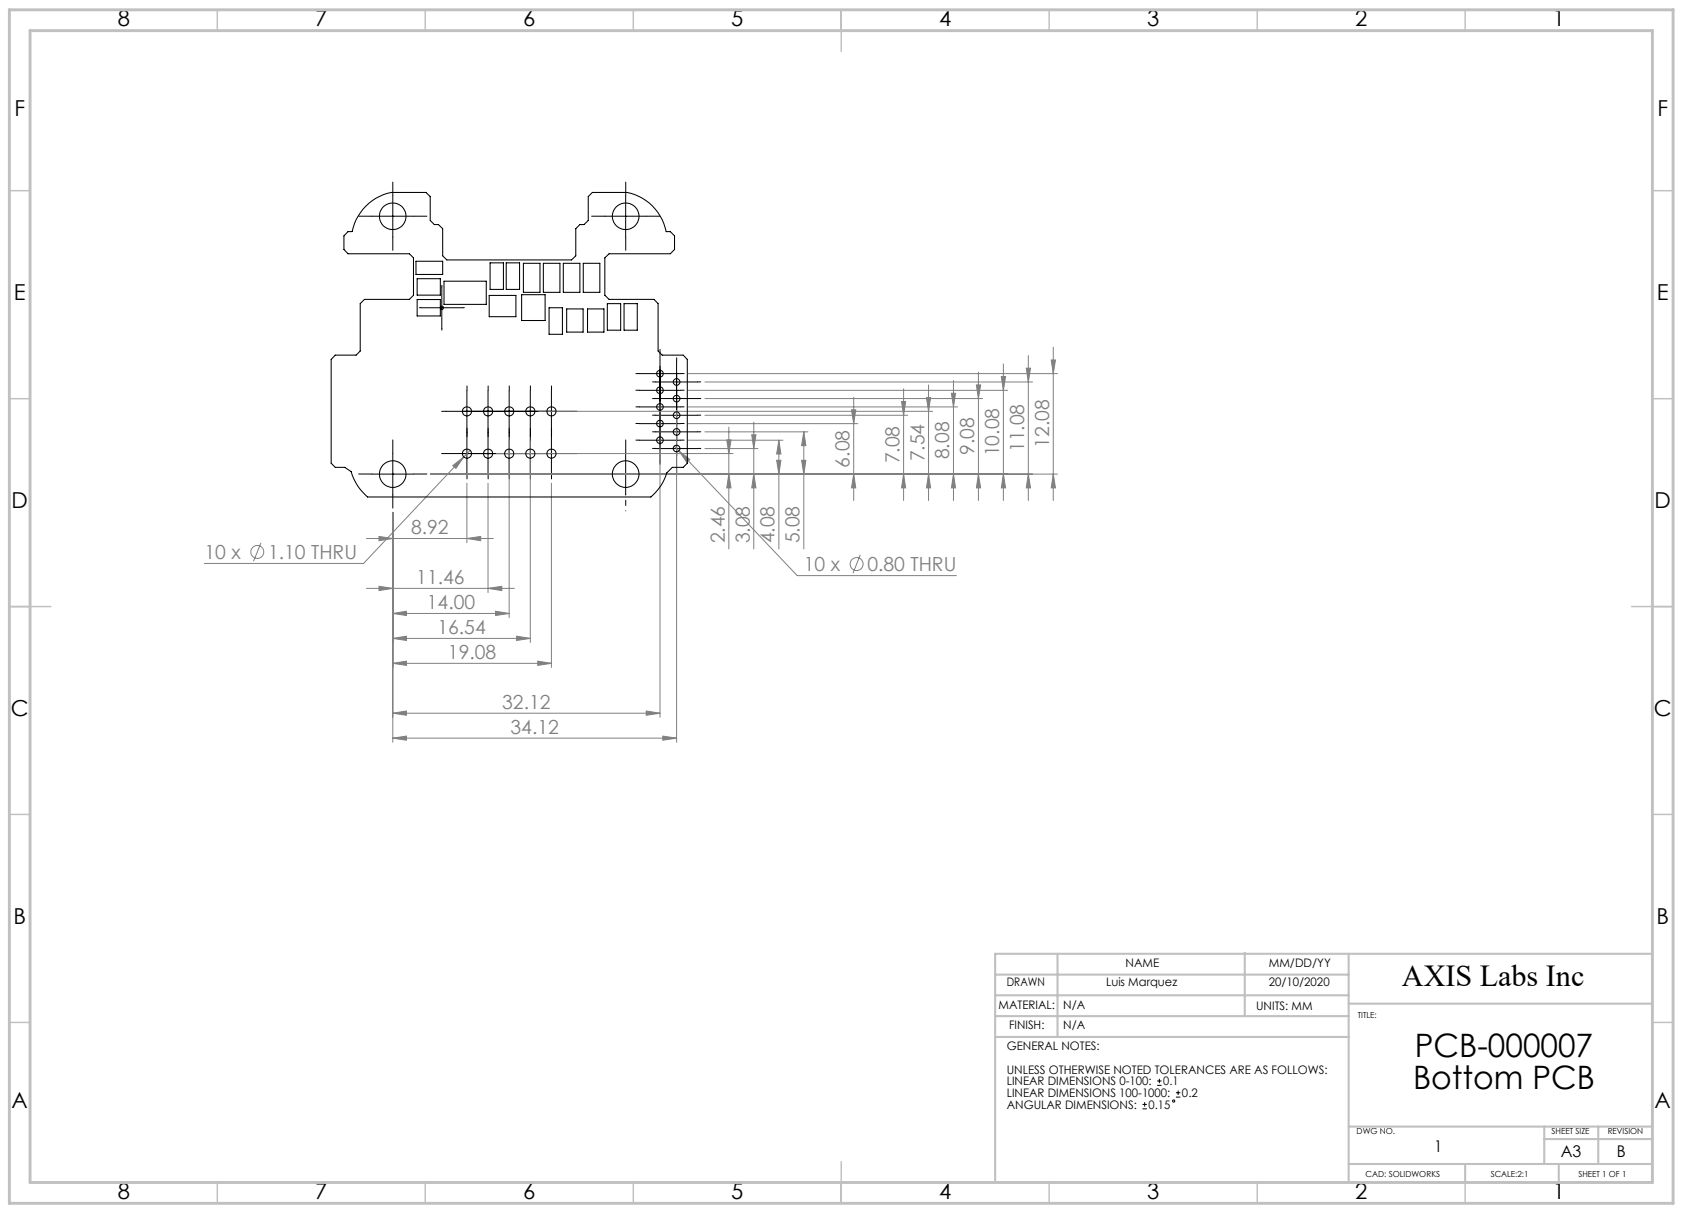
[picture p347: page 1]
10 x 1.10 THRU; 10 x 0.80 THRU; Bottom PCB

NAME | MM/DD/YY | AXIS Labs Inc

DRAWN | Luis Marquez | 20/10/2020
MATERIAL: | N/A | UNITS: MM
FINISH: | N/A

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

DWG NO. 1 | SHEET SIZE | REVISION

CAD: SOLIDWORKS | SCALE:2:1 | SHEET 1 OF 1
