binphilxiao/AxisLabs/GB0102/Drawing/PCB-000022 Rev B (Adapter PCB Insert).pdf

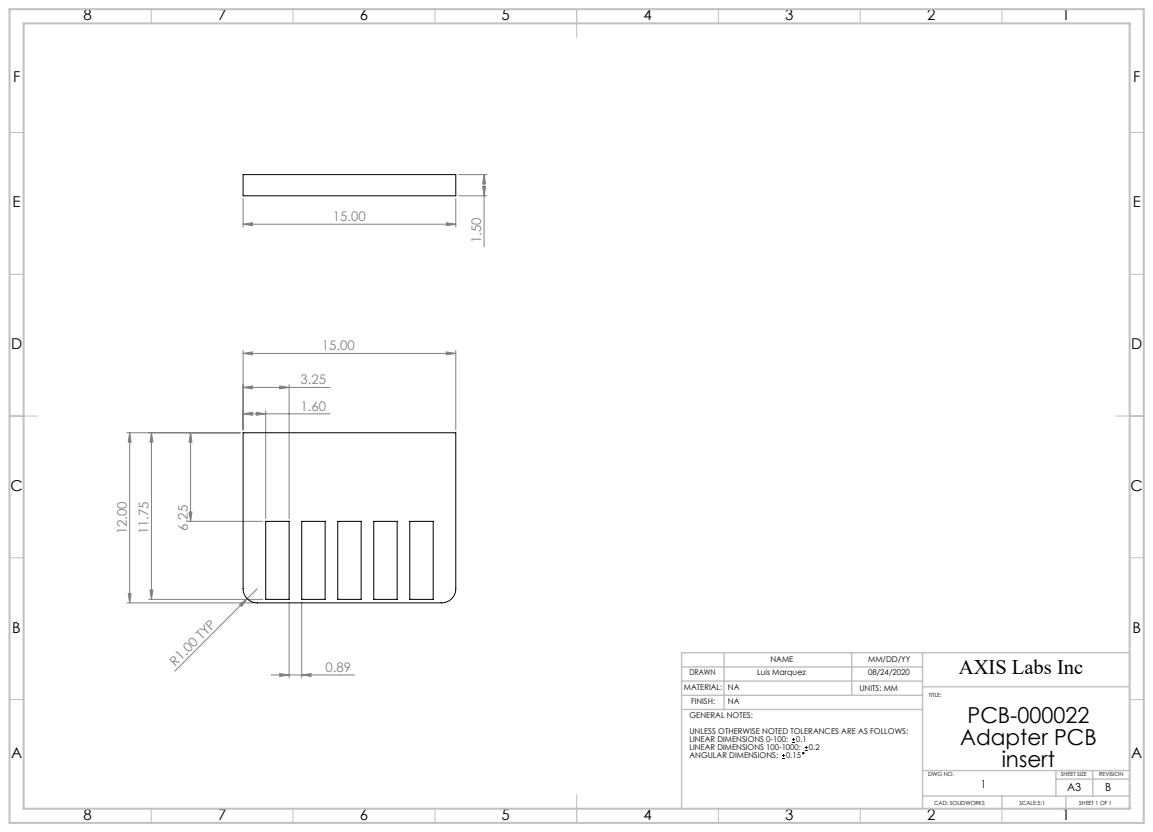
[picture p348: page 1]
R1.00 TYP; Adapter PCB

NAME | MM/DD/YY | AXIS Labs Inc
Luis Marquez | 08/24/2020

MATERIAL: | NA | UNITS: MM
FINISH: | NA

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

DWG NO. 1 | SHEET SIZE | REVISION

CAD: SOLIDWORKS | SCALE:5:1 | SHEET 1 OF 1
