binphilxiao/AxisLabs/GR0102/Drawing/PCB-000006 (Main PCB Board).pdf

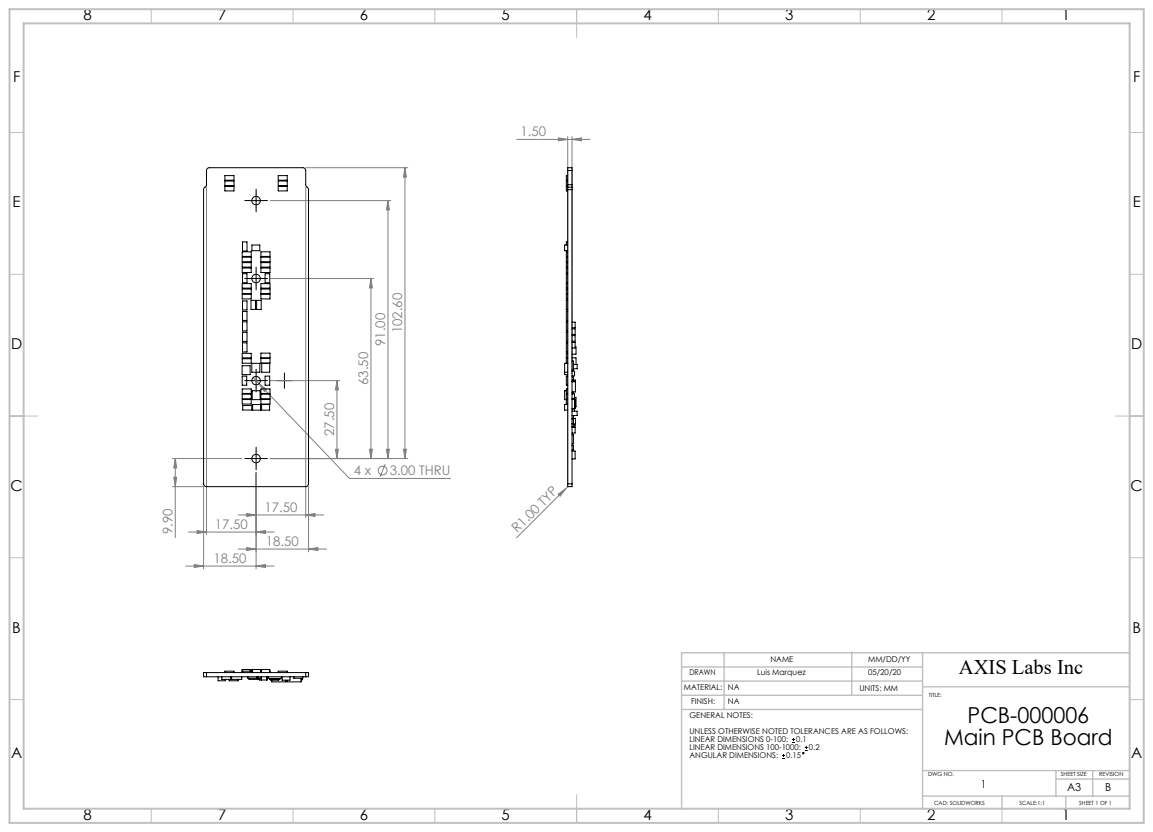
[picture p349: page 1]
4 x 3.00 THRU; R1.00 TYP

NAME | MM/DD/YY | AXIS Labs Inc

DRAWN | Luis Marquez | 05/20/20
MATERIAL: | NA | UNITS: MM
FINISH: | NA

TITLE:
PCB-000006
Main PCB Board

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

DWG NO. 1 | SHEET SIZE | REVISION

CAD: SOLIDWORKS | SCALE:1:1 | SHEET 1 OF 1
