binphilxiao/AxisLabs/NW0101/2022.09_ProgramingJigRev.B_Manufacture/TestSocketDrawing.pdf

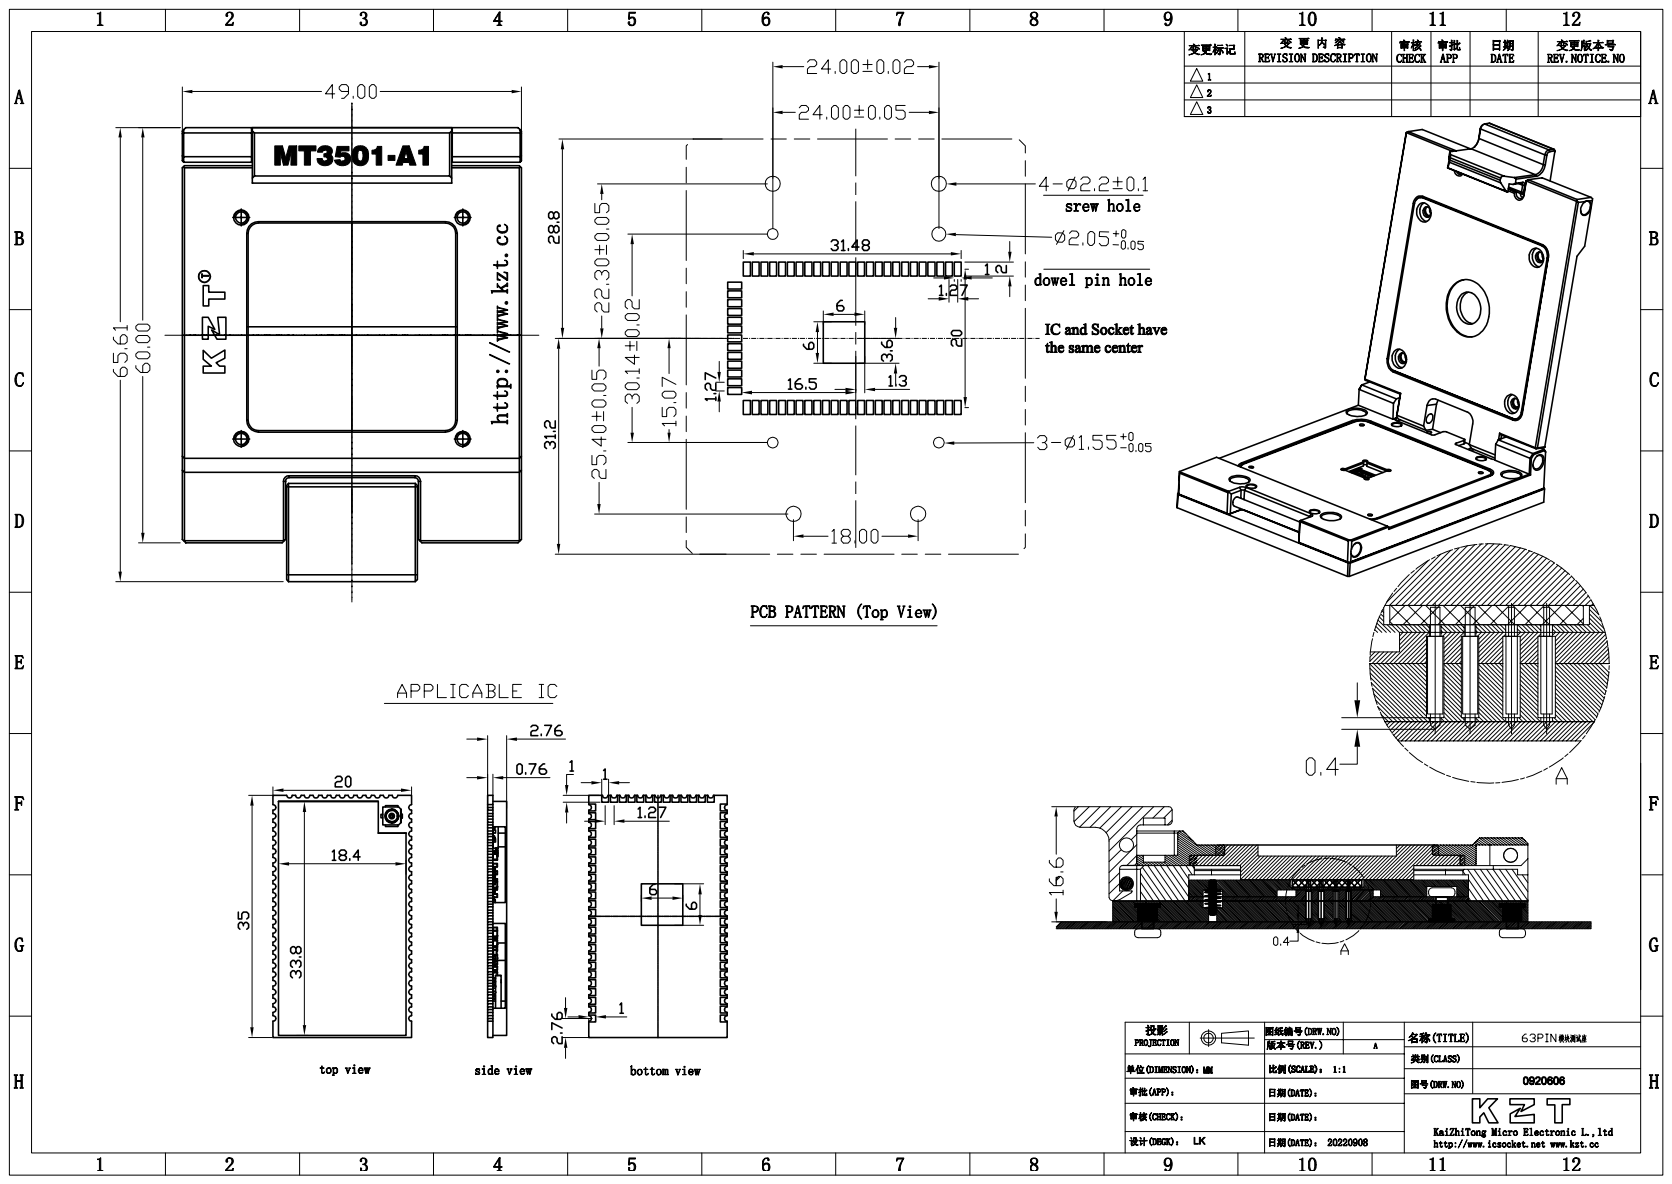
[picture p350: page 1]
