binphilxiao/AxisLabs/BLE0201/Ref/nRF5340 Development Kit - Hardware files 2_0_0/PCA10095-nRF5340 Development Board 2_0_0/Production files/ASSEMBLY/400432_Assembly_Drawing.pdf

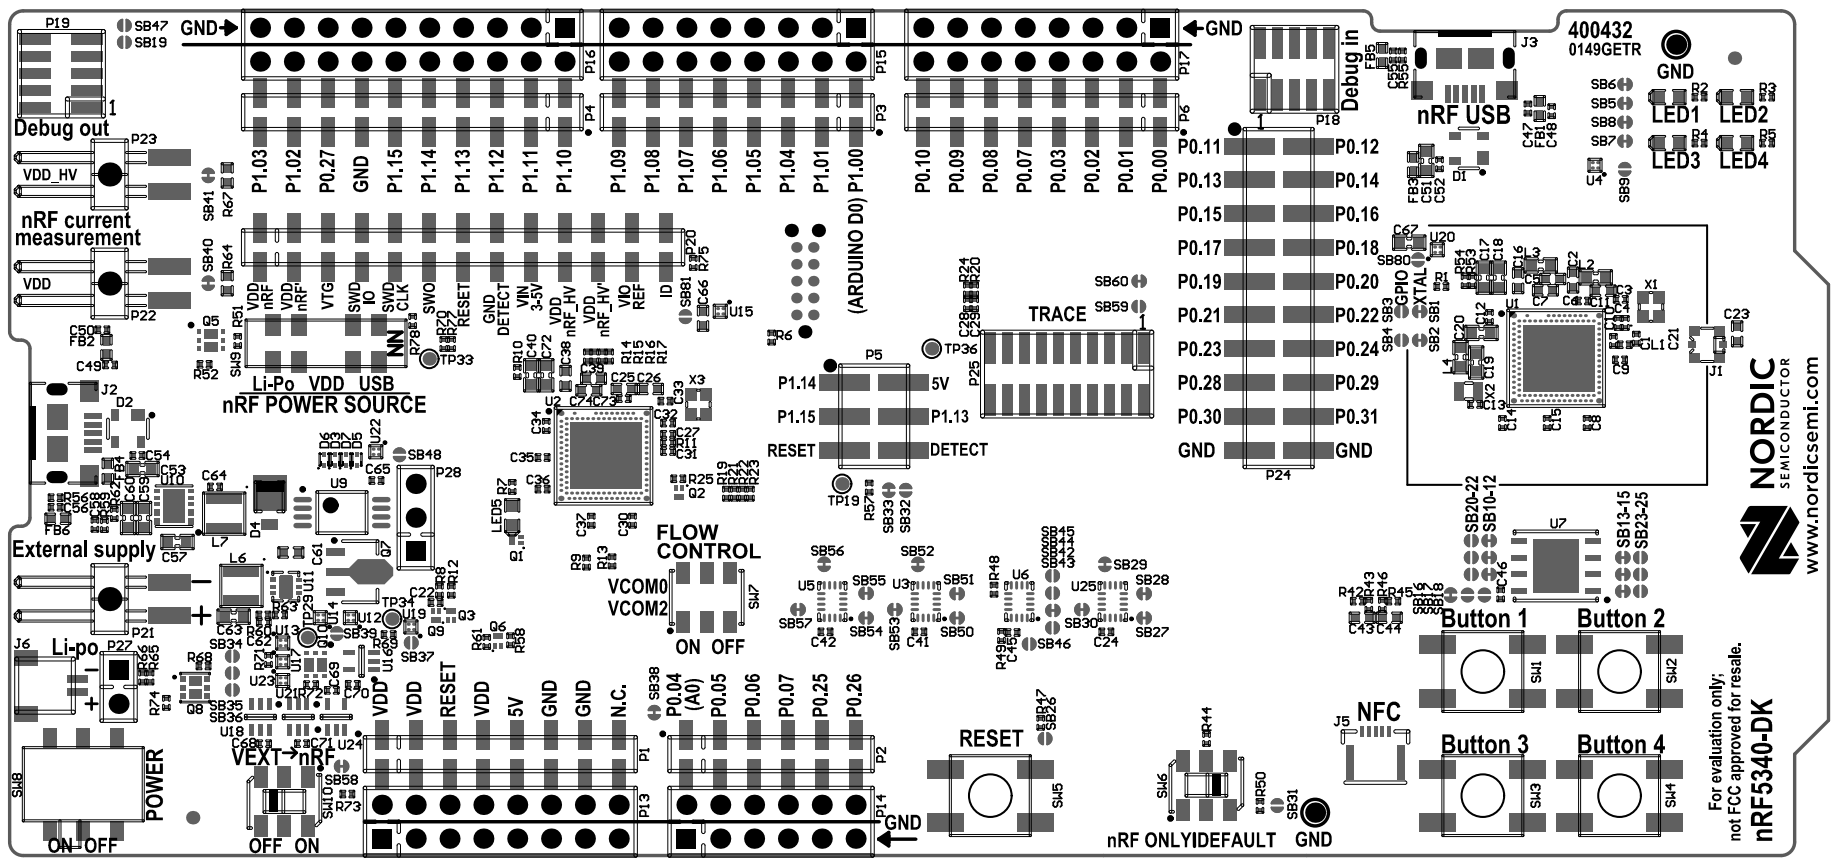
[picture p351: page 1]

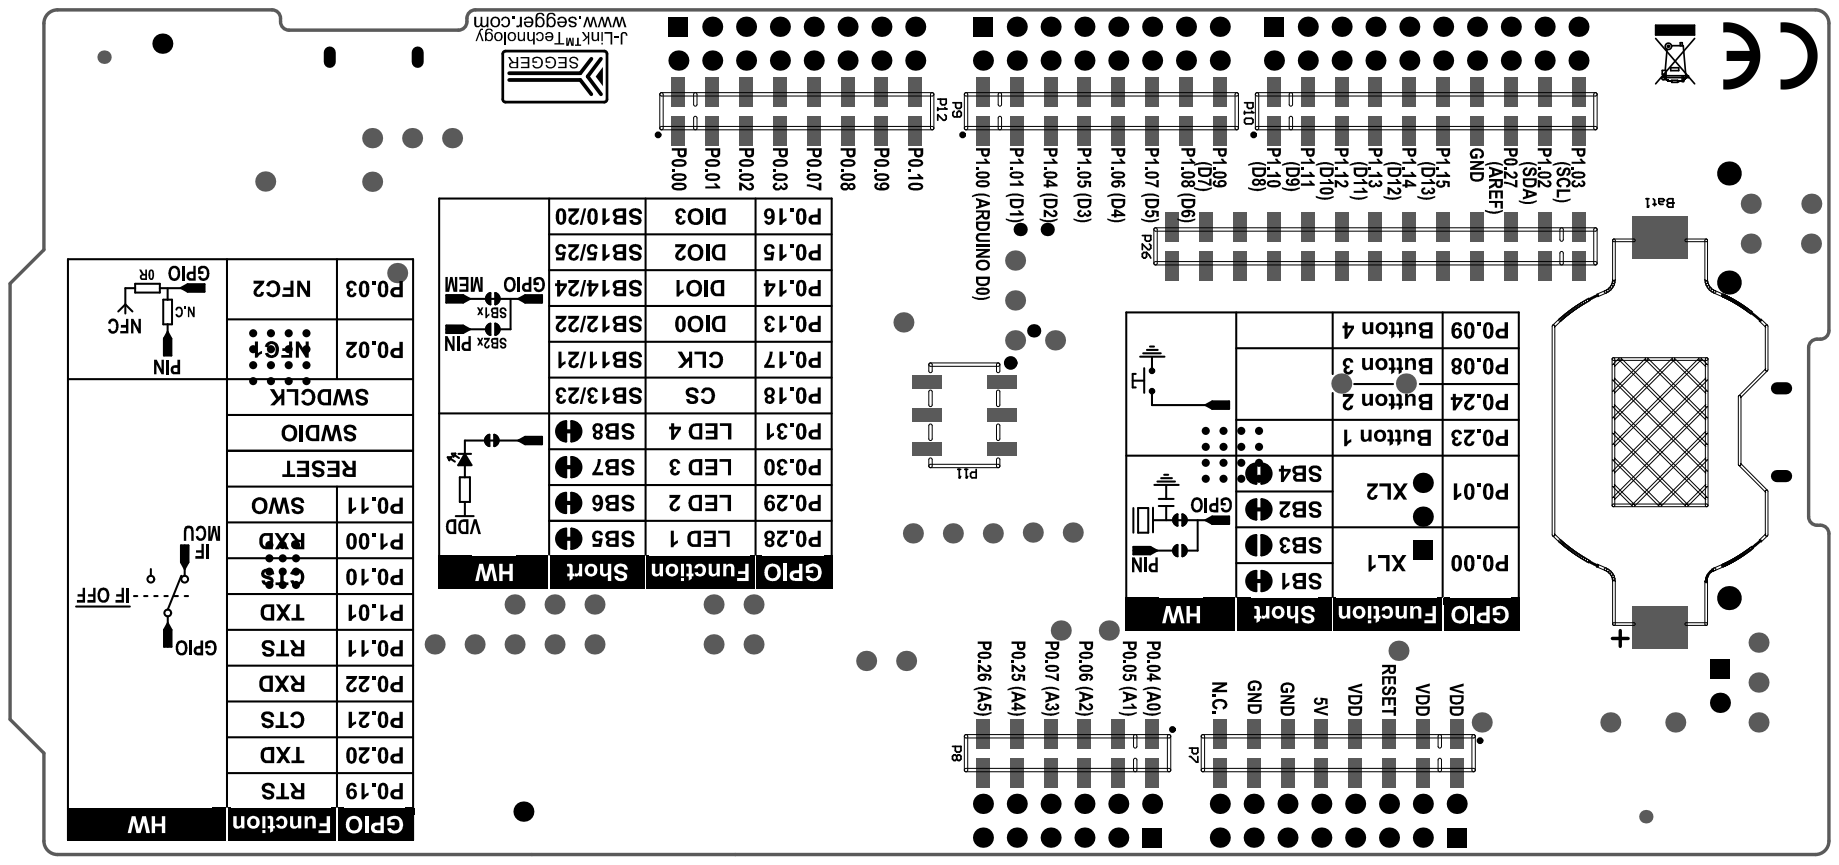
[picture p352: page 2]
