binphilxiao/AxisLabs/MAT0101/Ref/nRF7002 Development Kit - Hardware files 0_7_2/PCA10143-nRF7002 Development Kit 0_7_2/Production files/ASSEMBLY/400631_Assembly_Drawing.pdf

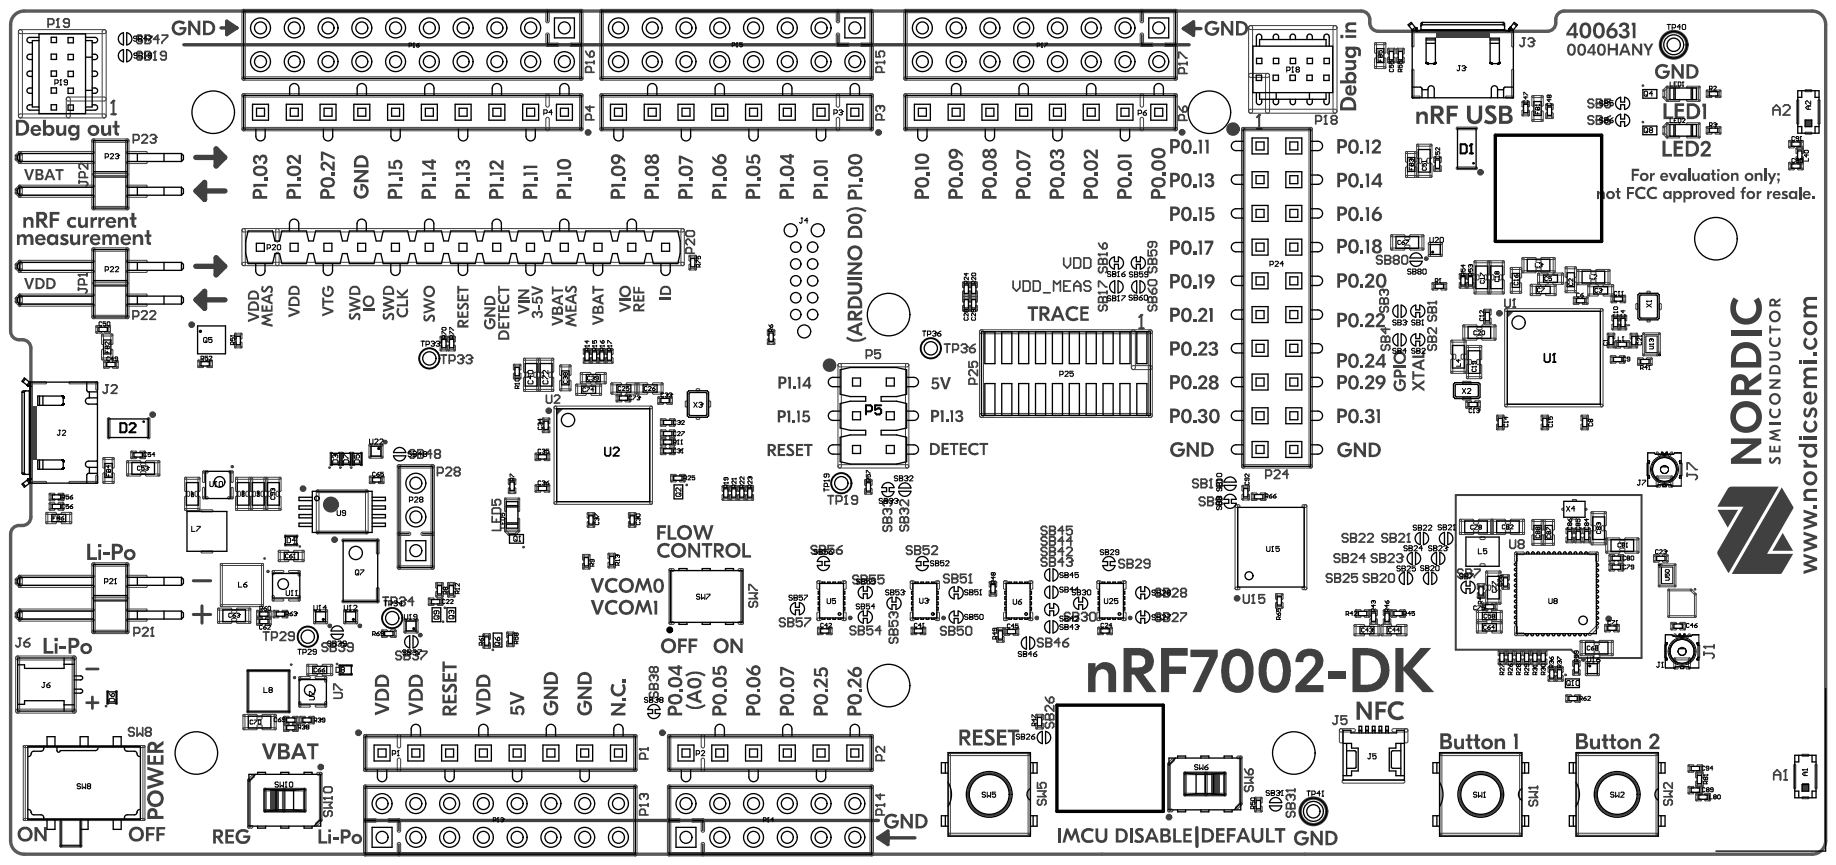
[picture p353: page 1]

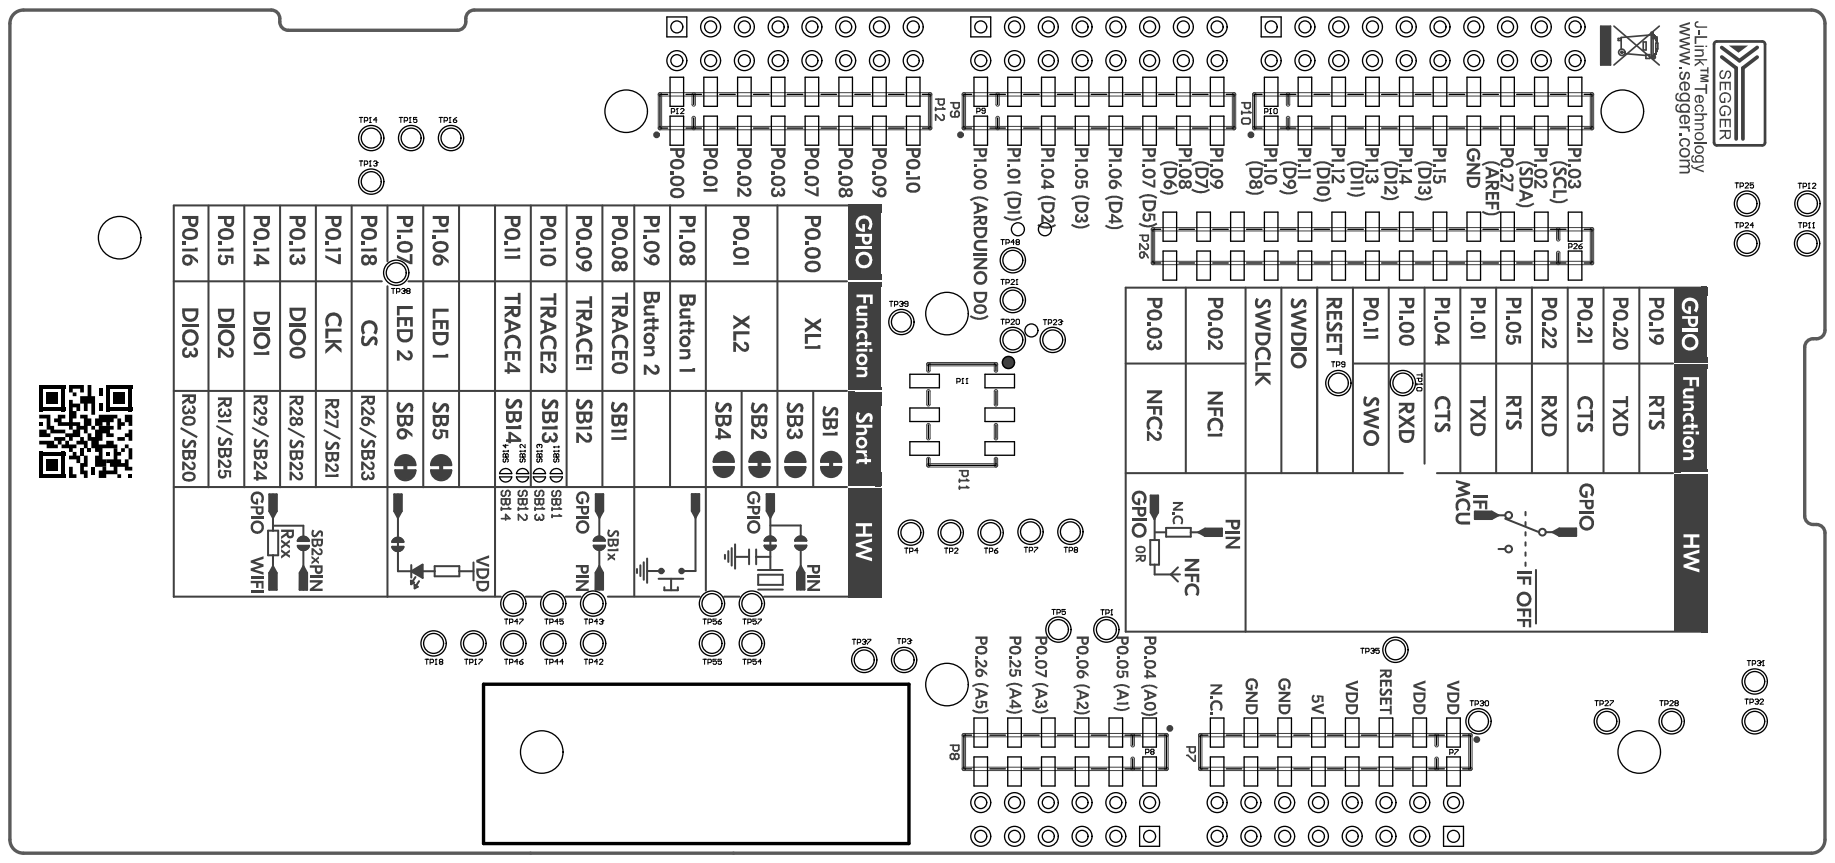
[picture p354: page 2]
