binphilxiao/AxisLabs/SB0101/130.pdf

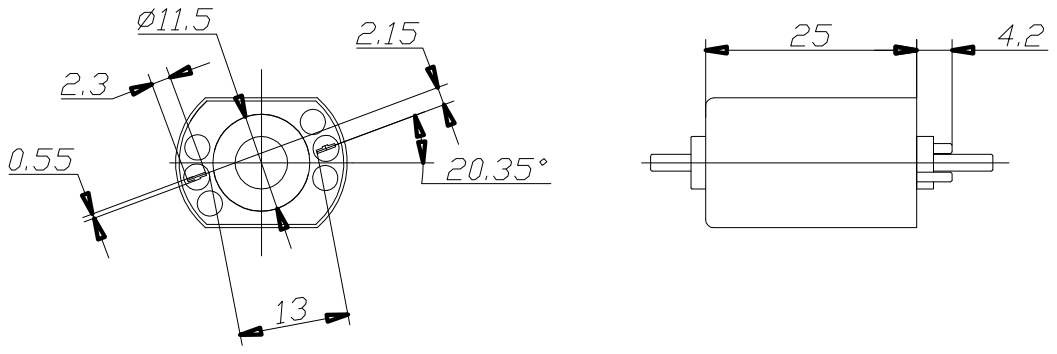
[picture p355: page 1]
