binphilxiao/AxisLabs/Button/SCiE5_SCH.pdf

A

1 | 2 | 3 | 4 | 5 | 6

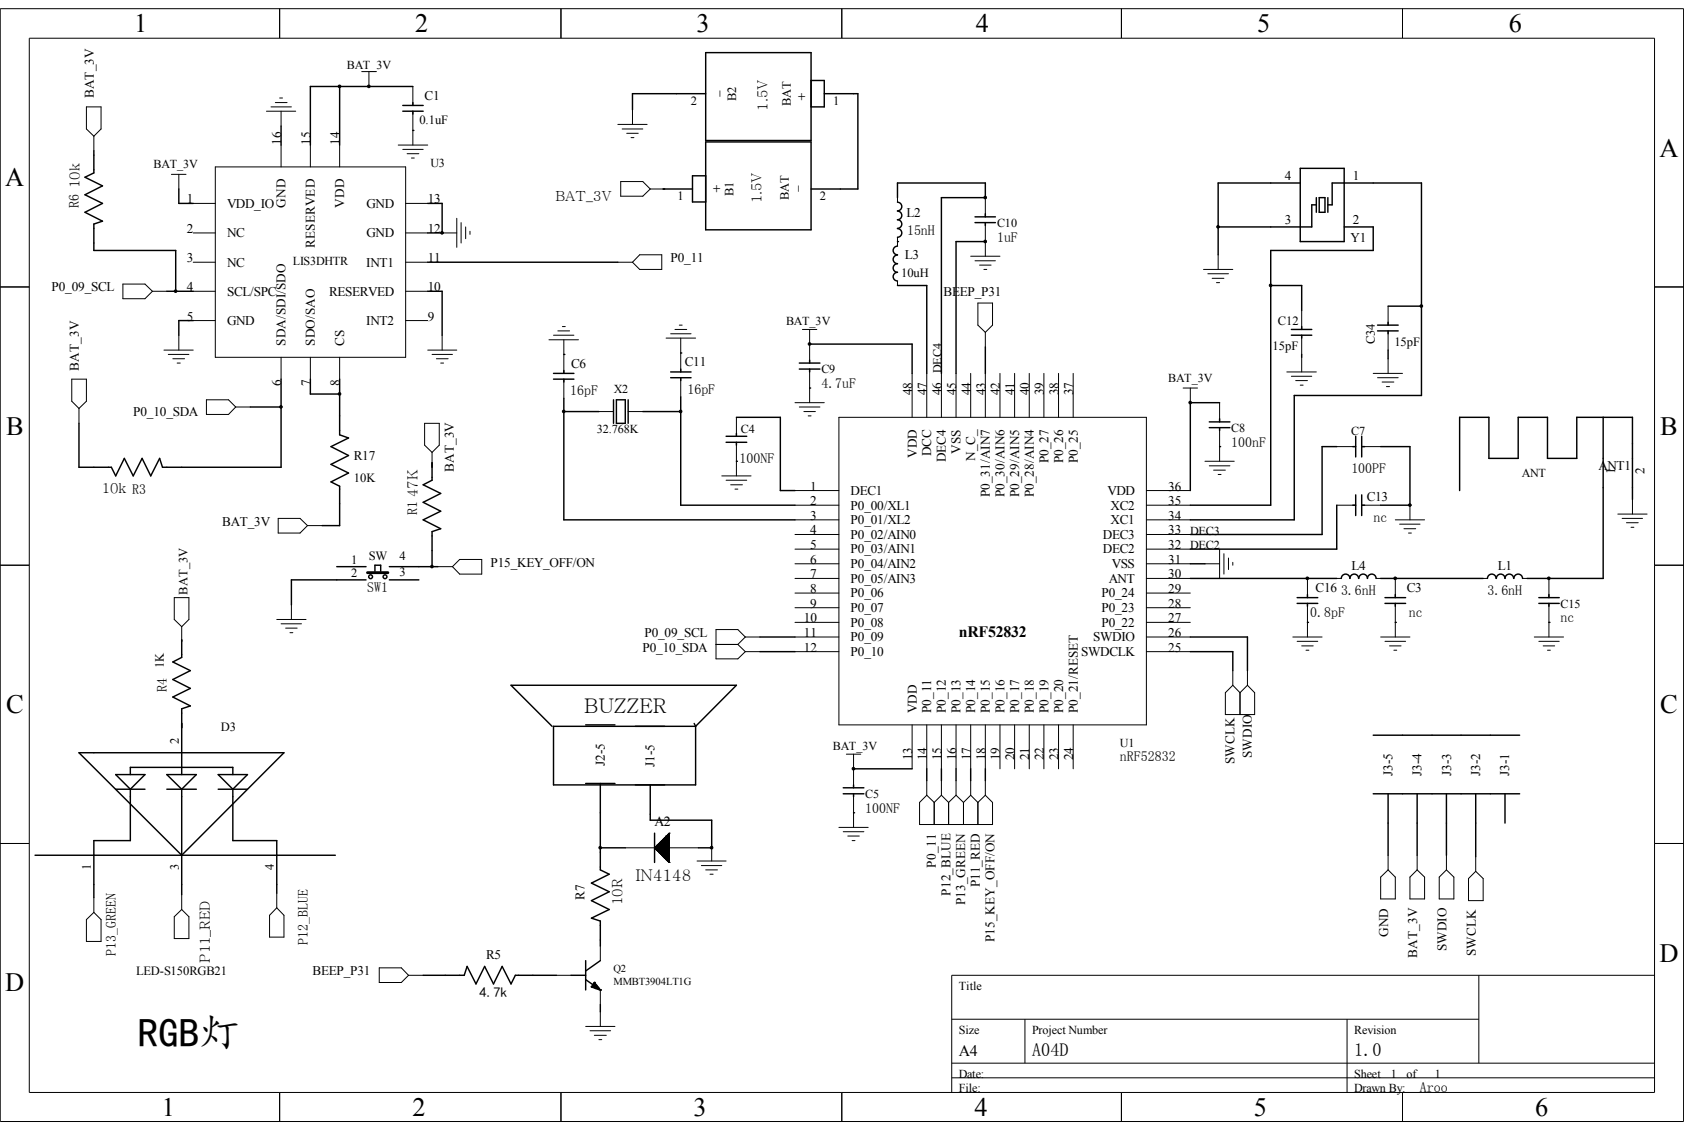
[picture p356: page 1]

Title

Size | Project Number | Revision 1.0

Date: | Sheet 1 of 1
File: | Drawn By: Aroo
