binphilxiao/AxisLabs/SB0101/BoardEdgeConnector/LB1090-Gxx-BxR (mec1).pdf

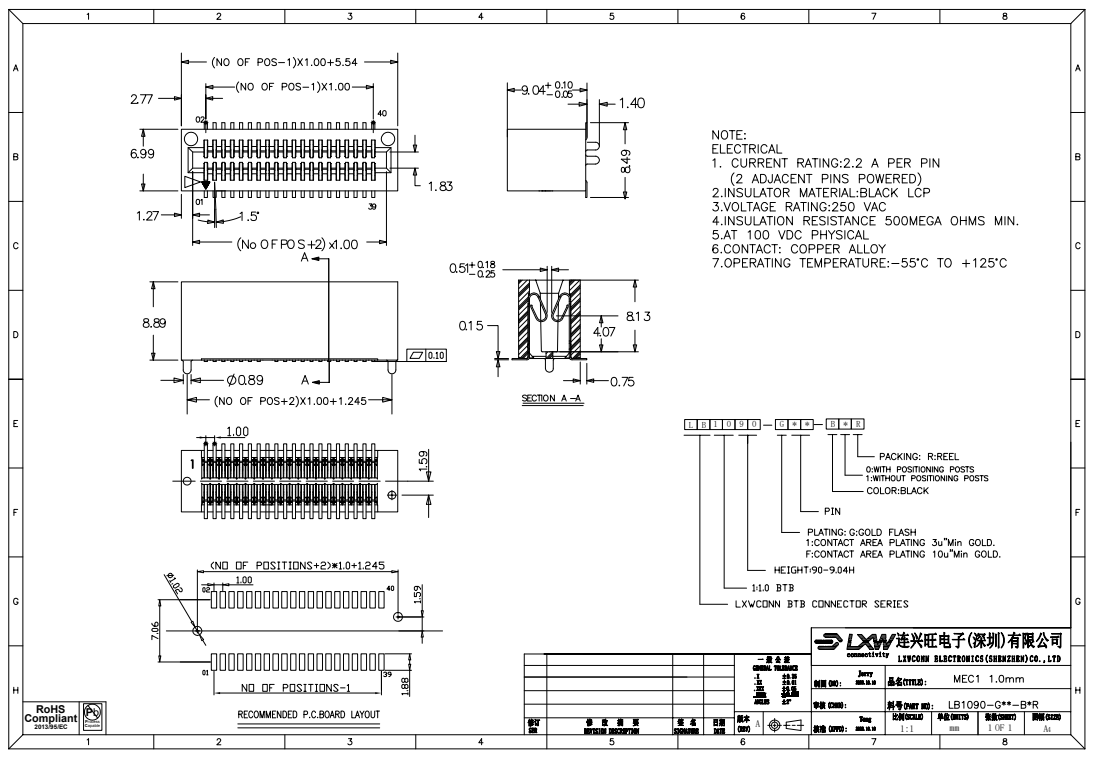
[picture p357: page 1]
1 RoHS Compliant 2013/95/EC; Capable Process Pb
