binphilxiao/AxisLabs/SC0101/Certification/SmartCurtain Diagram_2.pdf

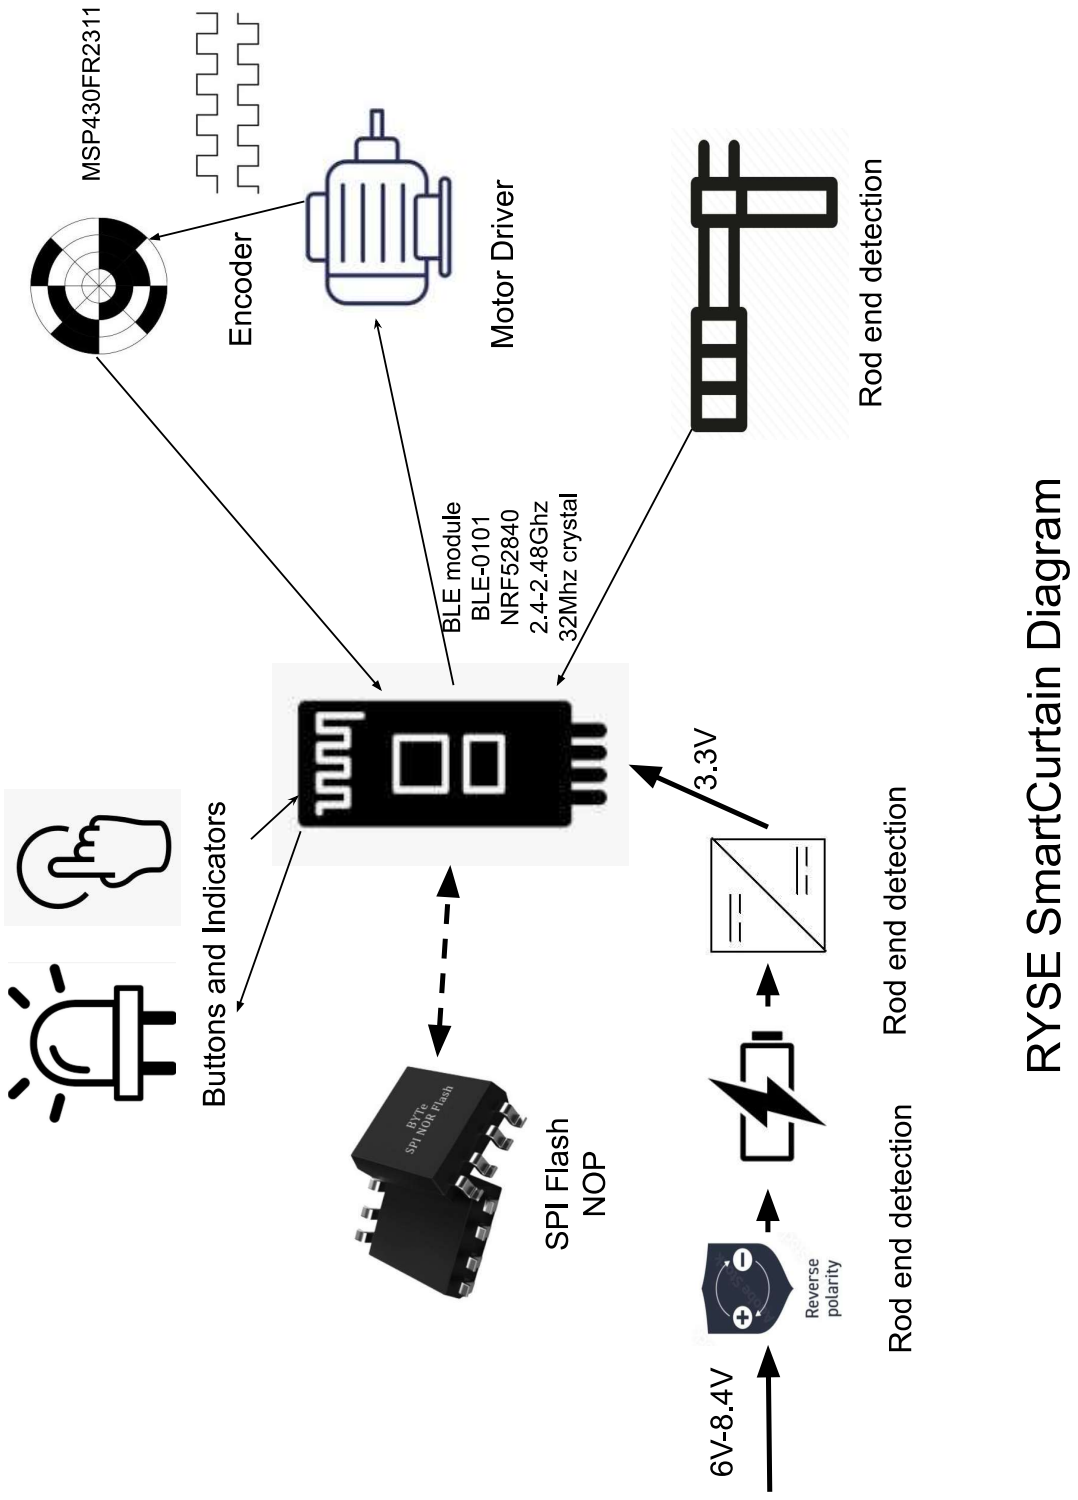
[picture p358: page 1]
