binphilxiao/AxisLabs/GR0102/Certification/Doc provided/SmartShade Diagram_1.pdf

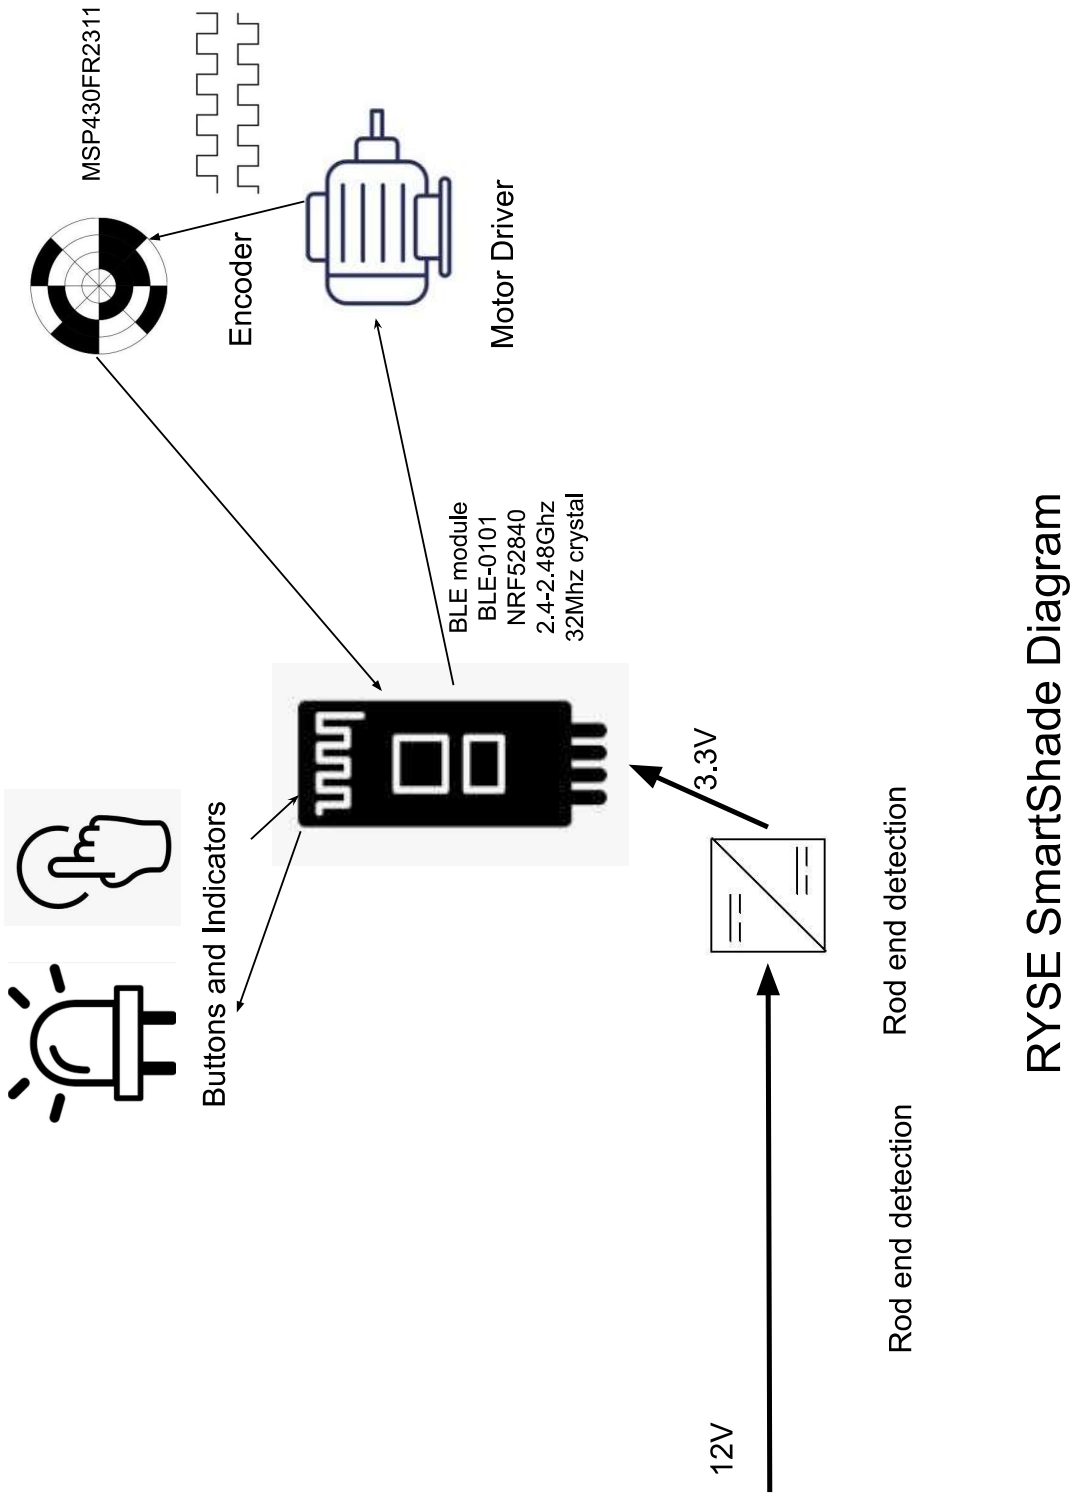
[picture p359: page 1]
