binphilxiao/AxisLabs/GB0101/Simulation/BoostConceptral.asc

C1: cap; 22µ; V=25 Irms=0 Rser=0.003 Lser=0 mfg="TDK" pn="C575OX5RIE226M" type="X5R"
C2: cap; 22µ; V=25 Irms=0 Rser=0.003 Lser=0 mfg="TDK" pn="C575OX5RIE226M" type="X5R"
C3: cap; 22µ; V=25 Irms=0 Rser=0.003 Lser=0 mfg="TDK" pn="C575OX5RIE226M" type="X5R"
C4: cap; 150µ; V=6.3 Irms=0 Rser=0 Lser=0 mfg="Murata" pn="GRM31CR60J157ME11" type="X5R"
C5: cap; 22µ; V=25 Irms=0 Rser=0.003 Lser=0 mfg="TDK" pn="C575OX5RIE226M" type="X5R"
C6: cap; 0.1µ; V=16 Irms=0 Rser=0 Lser=0 mfg="Murata" pn="GCM155R71C104KA55" type="X7R"
C7: cap; 0.1µ; V=16 Irms=0 Rser=0 Lser=0 mfg="Murata" pn="GCM155R71C104KA55" type="X7R"
L1: ind; 1.8µ; Ipk=10 Rser=0.0121 Rpar=0 Cpar=0
M1: nmos; BSO220N03MD
M2: nmos; BSO150N03MD
R3: res; 6
V1: voltage; 4; Rser=0.03
V2: voltage; PULSE(13.5 0 0 1p 1p 3.6u 5u 10000)
V3: voltage; PULSE(0 10 0.01u 1p 1p 3.58u 5u 10000)
Named nets: 0, Vout, sw1, sw2, sw, Vin
.tran 0 5.04m 4.99m startup uic
Rls = 27 mohm for TPS610891
Rls = 19 mohm for TPS610891
