binphilxiao/AxisLabs/GR0101/052350-9/Simulation/BoostConceptral.asc

C1: cap; 10µ
C2: cap; 10µ
C3: cap; 10µ
C4: cap; 10µ
C5: cap; 10µ
C6: cap; 10µ
C7: cap; 10µ
L1: ind; 20µ
M1: nmos; RJU002N06
M2: nmos; BSO150N03MD
R1: res; 0.1
R2: res; 0.07
R3: res; 7
R4: res; 0.07
R5: res; 0.07
R6: res; 0.07
R7: res; 0.07
R8: res; 0.07
R9: res; 0.07
V1: voltage; 3.5
V2: voltage; PULSE(13.5 0 0 1p 1p 1.25u 2.5u 10000)
V3: voltage; PULSE(0 10 0.05u 1p 1p 1.15u 2.5u 10000)
Named nets: 0, Vout, sw1, sw2
.tran 0 1m 0.99m startup uic
Sixe < 6mm*6mm*2.5mm
Isat > 250mA, Irate>250mA
Inductance > 100uH
Rdc < 5Ohm
Sixe < 6mm*6mm*2.5mm
X7R, 16V
Capacitance >10uF
Murata typical
Rls = 27 mohm for TPS610891
Rls = 19 mohm for TPS610891
