binphilxiao/AxisLabs/GB0102/sim/OV shutdown.asc

C1: cap; 10n
D1: zener; BZX84B11VLY
M1: nmos; BSS123
M2: pmos; RTL020P02
M3: nmos; BSS123
M4: pmos; RTL020P02
R1: res; 100k
R2: res; 3Meg
R4: res; 3Meg
V1: voltage; PWL(0 0 10 12.6 20 0); Rser=1
V2: voltage; PWL(0 1 10 13.6 20 1)
Named nets: 0, v_charger, v_bat, g, d
.tran 20
