binphilxiao/AxisLabs/GB0102/sim/USB-C OV protection.asc

D1: zener; 1N750
D2: zener; STZ5_6N
M1: nmos; BSS123
M2: pmos; RTL020P02
M3: nmos; BSS123
M4: pmos; RTL020P02
R1: res; 2k
R2: res; 3Meg
R3: res; 1k
R4: res; 3Meg
V1: voltage; PWL(0 0 1 12 2 0)
Named nets: 0, out, in, g, d
.tran 2
