binphilxiao/AxisLabs/SB0101/SIM/backDriveProtection.asc

M1: pmos; IRLML6402
M2: pmos; IRLML6402
M3: nmos; BSS123
M4: pmos; IRLML6402
M5: pmos; IRLML6402
M6: nmos; BSS123
M7: pmos; IRLML6402
M8: pmos; IRLML6402
M9: nmos; BSS123
R1: res; 10k
R2: res; 10k
R3: res; 100
R4: res; 10k
R5: res; 1k
R6: res; 1k
V1: voltage; 3.7
V2: voltage; PULSE(0 3.3 0 0 0 100u 200u 200)
V3: voltage; 20
V4: voltage; PULSE(0 3.3 0 0 0 100u 200u 200)
V5: voltage; 3.5
V6: voltage; 3.5
Named nets: 0, out_b, out1_b, in_b, out_f, out1_f, g_f, in_f, out_f1, out1_f1, g_f1, in_f1
.tran 50m
