binphilxiao/AxisLabs/SB0101/SIM/LV protection.asc

C4: cap; 1µ
M1: nmos; BSS123
M2: pmos; FDR840P
OP2: LT1672
R1: res; 1Meg
R3: res; 500k
R4: res; 300k
R5: res; 10Meg
R6: res; 3Meg
R7: res; 1Meg
R10: res; 10k
V1: voltage; PWL(0 4.2 1 4.2 11 0 21 4.2)
V2: voltage; 1.2
Named nets: 0, Vbatt, V3.3V, Vg, VOUT, REF, VDIV
.tran 0 20 0.1 0.1 startup uic
.dc V1 5.6 9 0.1
NCP551SN33
3.3V, 12Vmax
1uA quiescent current
$0.2
6.0V - 6.5V
delta = +- VDD*R10/R11
for non-inverting schmitt opamp
