binphilxiao/AxisLabs/SB0101/SIM/backdrive.asc

D1: diode; 1N4148
D2: diode; 1N4148
M1: nmos; BSS123
M2: nmos; BSS123
R1: res; 1Meg
R2: res; 1Meg
R3: res; 1Meg
R4: res; 1Meg
V1: voltage; SINE(0 1.8 100 0 0 0 100); Rser=1000
V2: voltage; 3.3
Named nets: 0, out1, out2, m+, m-
.tran 0 21m 0
