binphilxiao/AxisLabs/SB0101/SIM/motor_led.asc

D1: schottky; 1N5817
D2: schottky; 1N5817
M1: pmos; BSS84
M2: pmos; BSS84
R1: res; 100
R2: res; 100
R3: res; 1k
V1: voltage; SINE(0 3.3 100 0 0 0 100)
Named nets: 0
.tran 0.05
