binphilxiao/AxisLabs/SB0101/SIM/PLC.asc

C1: cap; 0.01µf
D1: schottky; BAT54
D2: schottky; BAT54
D3: schottky; BAT54
D4: schottky; BAT54
D5: schottky; BAT54
R1: res; 100k
R2: res; 50k
R3: res; 100K
R4: res; 3Meg
R5: res; 100k
U1: LTC6241
U2: LTC6241
V1: voltage; PULSE(0 4 0 1n 1n 1u 10u 1000)
V2: voltage; 3.3
V3: voltage; 2.5
Named nets: 0, V+, V-, V_R, V_F, V_D, out
.tran 0 1m 0.5m
V_MOTOR
4V or 5V
PWM 100kHz
duty 10%~90%
Bridge Rectification
Voltage divider
Follower
Peak Detection
Network
Schmitt
Comparator
