binphilxiao/AxisLabs/SB0101/SIM/PLC_power.asc

C2: cap; 100µ
D1: zener; 1N750
D2: schottky; BAT54
D3: schottky; BAT54
D4: schottky; BAT54
D5: schottky; BAT54
L1: ind; 1µ
R1: res; 1000
V1: voltage; PULSE(0 4 0 0 0 10u 100u 1000000); Rser=50
Named nets: 0, V+, V-, vout
.tran 0 100m 0.5m
V_MOTOR
4V or 5V
PWM 10k~100kHz
duty 10%~90%
Bridge Rectification
