binphilxiao/AxisLabs/PositionTracker/Sim/SW_DELAY.asc

C1: cap; 1µf
M1: nmos; BSS123
M2: pmos; BSS84
M3: nmos; BSS123
R1: res; 100k
R2: res; 1Meg
R3: res; 100k
R4: res; 1Meg
V1: voltage; 3.3
V2: voltage; PULSE(0 3.3 0 1n 1n 1s 5s 50)
Named nets: 0, out, int
.tran 0 20s 0
