binphilxiao/AxisLabs/SC0101/Sim/LV protection.asc

C1: cap; 1µ
C2: cap; 1µ
C4: cap; 1µ
M1: nmos; BSS123
M2: pmos; FDR840P
OP2: LT1672
R1: res; 1.65Meg
R2: res; 1.65Meg
R3: res; 2.15Meg
R4: res; 0.825Meg
R5: res; 10Meg
R6: res; 100k
R7: res; 10k
R10: res; 10K
U2: LT3009-3.3
V1: voltage; PWL(0 8.4 10 5 20 8.4)
Named nets: 0, Vbatt, V3.3V, Vg, VOUT
.tran 0 20 0.1 0.1 startup uic
.dc V1 5.6 9 0.1
NCP551SN33
3.3V, 12Vmax
1uA quiescent current
$0.2
6.0V - 6.5V
delta = +- VDD*R10/R11
for non-inverting schmitt opamp
