binphilxiao/AxisLabs/SC0101/Sim/Draft2.asc

C1: cap; 10µf
M1: nmos
M2: pmos
R1: res; 100k
R2: res; 1Meg
R3: res; 1Meg
V1: voltage; 3.3
V2: voltage
Named nets: 0
