binphilxiao/AxisLabs/Button/Simulation/Inrush current.asc

C1: cap; 200µ
L1: ind; 2.2µ
R1: res; 100k
V1: voltage; PULSE(0 3 0 10u 10u 100m 200m 30); Rser=50
Named nets: 0
.tran 500m
