binphilxiao/AxisLabs/RB0101/Simulation/LV protection_2.asc

C2: cap; 1µ
M1: nmos; BSS123
M2: pmos; FDR840P
R1: res; 1Meg
R2: res; 560k
R5: res; 10Meg
R6: res; 3Meg
R7: res; 1Meg
R10: res; 10K
U1: opamp2; tlv9042
V1: voltage; PWL(0 3.2 10 1.3 20 3.2)
V2: voltage; 1.22
Named nets: 0, Vbatt, Vg, VOUT
.tran 0 20 0.1 0.1 startup uic
.dc V1 5.6 9 0.1
delta = +- Vbatt*R10/R5
for non-inverting schmitt opamp
.include C:\\Program Files\\LTC\\LTspiceXVII\\lib\\sub\\tlv9042.lib
