binphilxiao/AxisLabs/SC0101/Sim/Draft1.asc

D1: diode; 1N4148
R1: res; 36k
R2: res; 17k
R3: res; 100k
V1: voltage; 3.3
V2: voltage; 5
Named nets: 0, v1, v2
.tran 0 100ms 0 1us
