binphilxiao/AxisLabs/SC0101/Sim/MotorDrive.asc

D1: diode; 1N4148
R1: res; 36k
R2: res; 17k
R3: res; 50k
V1: voltage; 8.4; Rser=50
V2: voltage; 5; Rser=50
Named nets: 0, out, V_BAT, 5V
.tran 0 10ms 0 1us
