binphilxiao/AxisLabs/SC0101/Sim/ENDDET.asc

R1: res; 3Meg
R2: res; 3Meg
R3: res; 3Meg
R4: res; 825k
R5: res; 1Meg
R6: res; 200k
U1: LTC6241
V1: voltage; 3.3
V2: voltage; PWL(0 0 3 3.3 6 0)
Named nets: 0, out, in
.tran 6
