binphilxiao/AxisLabs/NW0101/Sim/WIFI FrontEnd.asc

C1: cap; 3p; V=25 Irms=0 Rser=0 Lser=0
C2: cap; 3p; V=25 Irms=0 Rser=0 Lser=0
C3: cap; 9p; V=25 Irms=0 Rser=0 Lser=0 mfg="Murata" pn="GRM0335C1E9R0CA01" type="C0G"
C4: cap; 1.2p; V=25 Irms=0 Rser=0 Lser=0 mfg="Murata" pn="GCM0335C1E1R2CA16" type="C0G"
C5: cap; 10p; V=10 Irms=0 Rser=0.4945 Lser=367p mfg="Würth Elektronik" pn="885012005007 WCAP-CSGP 0402" type="NP0"
C6: cap; 10p; V=10 Irms=0 Rser=0.4945 Lser=367p mfg="Würth Elektronik" pn="885012005007 WCAP-CSGP 0402" type="NP0"
C7: cap; 1.2p; V=25 Irms=0 Rser=0 Lser=0 mfg="Murata" pn="GCM0335C1E1R2CA16" type="C0G"
C8: cap; 2p; V=25 Irms=0 Rser=0 Lser=0 mfg="Murata" pn="GCM0335C1E2R0CA16" type="C0G"
C9: cap; 2p; V=25 Irms=0 Rser=0 Lser=0 mfg="Murata" pn="GCM0335C1E2R0CA16" type="C0G"
L1: ind; 1.5n; Ipk=0 Rser=0.12 Rpar=0 Cpar=0
L2: ind; 1.8n; Rser=0.18
L3: ind; 2.5n; Rser=0.2
L4: ind; 2.5n; Rser=0.2
L5: ind; 10n; Rser=0.8
L6: ind; 1.5n; Rser=0.12
L7: ind; 1.5n; Rser=0.12 Cpar=0
L8: ind; 10n; Rser=0.8
R3: res; 50
R4: res; 50
R6: res; 50
R7: res; 50
V1: voltage; SINE(0 2.4 2.44G); AC 1.2; Rser=50
V2: voltage; 3.3
Named nets: 0, RF_LP2+, RF_LP2-, RF_LP, RF_NOTCH, RF_DIFF+, RF_DIFF-, RF_PI+, RF_PI-
.ac dec 10000 10 10G
