binphilxiao/AxisLabs/SC0101/Sim/ReverseProtection.asc

M1: pmos; RSL020P03
R1: res; 100
R2: res; 1k
V1: voltage; 8.4
Named nets: 0
.dc V1 -8.4 8.4 0.01
