binphilxiao/AxisLabs/GB0101/Simulation/Draft1.asc

M1: nmos; BSS123
M2: pmos; RRL035P03
M3: pmos; RRL035P03
R1: res; 12k
R2: res; 12k
R3: res; 10k
V1: voltage; 12
V2: voltage; 0
V3: voltage; 20
Named nets: 0
.tran 10ms
