binphilxiao/AxisLabs/GB0101/Simulation/Draft2.asc

C1: cap; 1µ
D1: schottky; MBR0520L
D2: schottky; MBR0520L
M1: nmos; BSS123
M2: nmos; BSS123
M3: pmos; FDS8962C_P
R1: res; 10Meg
R2: res; 10Meg
R3: res; 100k
U1: ADP122-3.3
V1: voltage; 12
V2: voltage; PWL(0 0 50m 0 150m 5 350m 5 450m 0 500m 0)
Named nets: 0, VBAT, VBUS, VBAT_SW, VOUT, VG1, VG2, V33
.tran 500m
