binphilxiao/AxisLabs/GB0101/Simulation/MFP.asc

D1: diode
D2: diode
I1: current; 40n
R1: res; 1Meg
R2: res; 2Meg
R3: res; 700K
R4: res; 3Meg
R5: res; 499
V1: voltage; 10
V2: voltage; 12.6
Named nets: 0, MFP, PRES, DIV
.tran 100m
