binphilxiao/AxisLabs/GB0101/Simulation/IndicatorOrg2.asc

A1: buf1; Vhigh =3.3
C2: cap; 4.7µ
C3: cap; 0.1µ
C6: cap; 10µ
M1: nmos; BSS123
M2: pmos; IRF7404
M3: pmos; IRF7404
M5: nmos; BSS123
R1: res; 5k
R2: res; 5k
R3: res; 20k
R4: res; 1Meg
R5: res; 10k
R6: res; R=if(V(button)>1,0.1,10G)
R7: res; 400k
R8: res; 1.7k
R9: res; 3.3K
R10: res; 15k
R11: res; 20k
R20: res; 100k
V2: voltage; PULSE(0 2 1 1p 1p 14m 12.5 8)
V3: voltage; PULSE(0 5 0 1p 1p 50 100 10)
V4: voltage; PULSE(0 3.3 0 0 0 0.5 1 10000)
V5: voltage; 3.7
Named nets: 0, BUTTON, V_BUS, D, A, V_BAT, F_FIL, VDD, VREF_2.0, B, F
.tran 0 100s 0 1m startup uic
HIGH: PRESSED,    LOW: NOT PRESSED
SN74LVC1G34
