binphilxiao/AxisLabs/GB0101/Simulation/IndicatorOrg.asc

C1: cap; 1µ
C2: cap; 4.7µ
C3: cap; 1µ
C6: cap; 10µ
OP3: LT1672
OP4: LT1672
OP5: LT1672
OP6: LT1672
R1: res; 10Meg
R2: res; 120k
R3: res; 1.7Meg
R4: res; 1Meg
R5: res; 350k
R6: res; R=if(V(button)>1,0.1,10G)
R7: res; 650k
R8: res; 3.3Meg
R9: res; 1Meg
R10: res; 2.45Meg
R11: res; 1.65Meg
R20: res; 1Meg
U1: LT3009-3.3
V1: voltage; 2
V2: voltage; PULSE(0 3.3 1 1p 1p 14m 12.5 8)
V3: voltage; PULSE(0 5 0 1p 1p 50 100 10)
V4: voltage; PULSE(0 3.3 0 0 0 0.5 1 10000)
V5: voltage; PULSE(3.6 4.4 0 1p 1p 25 50 4)
Named nets: 0, V3.3V, BUTTON, V_BUS, D, A, B, C, E, Vref1.0, Vref2.0, Vref1.65, V_BAT, F
.tran 0 100s 0 1m startup uic
CHARGING
NOT CHARGING
FAULT
LOW BAT
NOT LOW BAT
G,R
BLK(R)
NOT POSSIBLE
G,R
BLK(R)
G
HIGH: REGULAR BATTERY,    LOW: LOW BATTERY
PRESSED
NOT PRESSED
LOW BAT
FULL BAT
R
OFF
G
OFF
USB PLUGED IN
USB NOT PLUGED IN
HIGH: PRESSED,    LOW: NOT PRESSED
HIGH: PLUGED IN,    LOW: NOT PLUGED IN
B:       Button status, 1 pressed, 0 not pressed
A:       Battery level, 1 full, 0 not full
D:       USB status, 1 pluged in , 0 not pluged in
C,E      00, Blinking   01, Not charging   10, Charging   11, Not possible
Red table  R = !A!F + !AB!D + !C!E!F
NCP551SN33
3.3V, 12Vmax
1uA quiescent current
$0.2
000
001
011
0--00
0--01 plug USB
0--11
0--10
STAT--NEG,POS/
LEVEL,BUTTON,USB
010
~STAT(1)
1
x
1
1
x
1
x
1
x
x
a,x
a,x
a,x
a,x
F--C,E / A,B,D
110
111
101
100
x
x
0
x
x
0
a,x
a,x
a
a,x
~STAT(1)
X
x
0
1--10 unplug USB
1--11
1--01
1--00
~STAT(0)
0
x
x
0
x
x
x
x
1
x
a,x
a
a,x
a,x
0
x
x
0
x
x
a,x
a,x
a
a,x
~STAT(0)
0
x
x
~STAT(1)
~STAT(1)
~STAT(1)
~STAT(0)
~STAT(0)
~STAT(0)
Green table  G = !ACD + AC + AEF
000
001
011
0--00
0--01
0--11
0--10
STAT--NEG,POS/
LEVEL,BUTTON,USB
010
F--C,E / A,B,D
110
111
101
100
1--10
1--11
1--01
1--00
0
0
x
1
0
0
x
1
x
0
x
x
a,x
a
a,x
a,x
0
x
x
1
0
x
x
1
a,x
a,x
a
a,x
x
x
x
1
x
x
0
a,x
x
x
a,x
1
x
x
x
a,x
x
x
a,x
x
1
1
0
a
1
1
a
1
0
0
a,x
0
0
a,x
x = not possible
a = any
0
0
