binphilxiao/AxisLabs/GB0101/Simulation/Indicator.asc

C1: cap; 1µ
C2: cap; 4.7µ
C3: cap; 4.7µ
C4: cap; 10000µ
C5: cap; 10000µ
Dgreen: diode; 1N914
Dred: diode; 1N914
M2: nmos; BSS123
M3: nmos; BSS123
M4: nmos; BSS123
M5: nmos; BSS123
M6: nmos; BSS123
M7: nmos; BSS123
M8: nmos; BSS123
M9: nmos; BSS123
M10: nmos; BSS123
M12: nmos; BSS123
M13: nmos; BSS123
M14: nmos; BSS123
M15: nmos; BSS123
M16: nmos; BSS123
M17: nmos; BSS123
M18: nmos; BSS123
M19: nmos; BSS123
M20: nmos; BSS123
R1: res; 1Meg
R2: res; 50
R3: res; 1.7Meg
R4: res; 1Meg
R5: res; 50
R6: res; R=if(V(button)>1,0.1,10G)
R7: res; 1Meg
R8: res; 3.3Meg
R10: res; 1.35Meg
R11: res; 1.65Meg
R12: res; 3Meg
R13: res; 3Meg
R14: res; 3Meg
R15: res; 3Meg
R16: res; 3Meg
R17: res; 3Meg
R19: res; 3Meg
U1: LTC2063
U2: LTC2063
V1: voltage; 3.3
V2: voltage; PULSE(0 3.3 10 1p 1p 14m 20s 200)
V3: voltage; PULSE(0 5 0 1p 1p 20 40 1000)
V4: voltage; PULSE(0 3.3 0 1p 1p 5 10 10000)
V5: voltage; PULSE(2.5 4 0 1p 1p 10 20 1000)
Named nets: 0, V_33, V_BAT, REG1.65, BUTTON, V_BUS, C, D, A, nB, nD, nA, nCD, AB, AD, nAB, nAD
.tran 0 100s 0 1m startup uic
GREEN
RED
CHARGING
NOT CHARGING
FAULT
LOW BAT
NOT LOW BAT
G,R
BLK
NOT POSSIBLE
G,R
BLK
G
HIGH: REGULAR BATTERY,    LOW: LOW BATTERY
HIGH: NOT CHARGING,    LOW: CHARGING,    BLINK: FAULT
00
01
11
00
01
11
10
LEVEL,BUTTON  \\  STAT,USB
10
Green table  G = !CD + AB + AD = !(C+!D) + !(!A+!B) + !(!A+!D)
1
1
1
1
0
0
1
1
00
01
11
00
01
11
10
LEVEL,BUTTON  \\  STAT,USB
10
Red table  R = !CD + !AB + !AD = !(C+!D) + !(A+!B) + !(A+!D)
1
1
1
1
1
1
0
0
0
0
0
0
0
0
1
1
x
x
x
x
x
x
x
x
A,B / C,D
A,B / C,D
PRESSED
NOT PRESSED
LOW BAT
NOT LOW BAT
R
OFF
G
OFF
USB PLUGED IN
USB NOT PLUGED IN
HIGH: PRESSED,    LOW: NOT PRESSED
HIGH: PLUGED IN,    LOW: NOT PLUGED IN
NOT GATES *2 :      !A, !C
2 INPUTS AND GATES * 6
4 INPUTS OR GATES * 2
