binphilxiao/AxisLabs/GB0101/Simulation/Rladder.asc

B1: bv; V=-(V(vref2)-1.212)*1000000
B2: bv; V=-(V(vref1)-1.212)*1000000
C1: cap; 100p
C2: cap; 100p
I1: current; 100n
I2: current; 100n
R1: res; {R2}
R2: res; {R2}
R3: res; {R2}
R4: res; {R2}
R5: res; {R1}
R6: res; {R1}
R7: res; {R1}
R8: res; {R2}
R10: res; {Rdown}
R11: res; {Rup}
R12: res; {Rdown}
R13: res; {Rup}
R14: res; {R_inj}
Va0: voltage; PULSE(0 3.3 0 1p 1p 1m 2m 1000)
Va1: voltage; PULSE(0 3.3 0 1p 1p 2m 4m 1000)
Va2: voltage; PULSE(0 3.3 0 1p 1p 4m 8m 1000)
Va3: voltage; PULSE(0 3.3 0 1p 1p 8m 16m 1000)
Va6: voltage; PWL(0 0 20m 3.3)
Named nets: 0, Vref1, A0, A1, A2, A3, Vref2, Vout1, Vout2, Vdac
.tran 20m
.param R1=825k R2=1.65Meg
.param Rup=825k
.param R_inj=887k
.param Rdown=100k
