binphilxiao/AxisLabs/MainCharger/Interview/Sch.asc

C1: cap; 1µ
C2: cap; 1µ
D1: LT1389-2.5
M1: nmos; Si7540DP_N
OP1: LT1672
OP2: LT1672
OP3: LT1672
OP4: LT1672
R1: res; 2Meg
R2: res; 850K
R3: res; 1.65Meg
R4: res; 6.4Meg
R5: res; 1.65Meg
R6: res; 4.61Meg
R7: res; 1.65Meg
R8: res; 186k
R9: res; 9.814Meg
R10: res; 400k
R11: res; 10Meg
R12: res; 8Meg
U2: LT3009-3.3
V1: voltage; PWL(0 8.5 10 5.6 20 8.5)
Named nets: 0, Vbatt, V3.3V, Vref1.65, Input_1, Input_2
.tran 0 20 0
ZXRE330ASA-7DITR-ND
3.3V
1uA Cathode current
$0.3
.dc V1 5.6 9 0.1
TLV8544 QUAD OPAMP
3.6V max
0.5uA Supply current per channel
0.1pA Bias current
Rail-to-Rail
$0.3
NCP551SN33
3.3V, 12Vmax
1uA quiescent current
$0.2
