binphilxiao/AxisLabs/GR0101/052357-9/Sim/MovementDet-FET-Protection.asc

L1: ind; 2.2µ
M7: nmos; BSB012NE2LX
R1: res; 0.1
V2: voltage; PULSE(0 3.3 0 1p 1p 1.001m 2m 100)
V3: voltage; PULSE(12 0 0.5u 1p 1p 1m 2m 100)
Named nets: 0, Vmotor, EN
.tran 0 10m 0
