binphilxiao/AxisLabs/GR0101/052357-9/Sim/MovementDet-FET.asc

I1: current; SINE(0 1u 0.1 0 0 0 100)
L1: ind; 2.2µ
M1: nmos; BSS123
M2: pmos; AO6407
M3: nmos; BSS123
M4: nmos; BSC016N04LS
M5: nmos; BSC016N03LS
M6: nmos; BSS123
M7: nmos; BSS123
M8: nmos; BSS123
M9: nmos; BSC016N03LS
R1: res; 5Meg
R2: res; 1Meg
R3: res; 3Meg
R4: res; 3Meg
R5: res; 3Meg
R6: res; 1k
R7: res; 1k
Rsns: res; 330
V1: voltage; 3.3
V2: voltage; 3.3
V3: voltage; PULSE(0 3.3 0 1p 1p 1 2 1000)
V4: voltage; -12
Named nets: 0, V_33, Vg_p, M+, M-, V_OUT, MOTOR_DET_EN, PWM_MOTOR_OUT, PWM_MOTOR, Vg_n
.tran 50
M5 and M9 shut down the Rsns when MOTOR_DET_EN=0
M1 is open when I1 >0
M3 is open when I1 <0
M4 set M- to GND when MOTOR_DET_EN=1
M4 set M+ and M- floating when MOTOR_DET_EN=0
PWM_MOTOR_OUT = ~(~PWM_MOTOR | MOTOR_DET_EN)
R6 and R7 is current limitor
