binphilxiao/AxisLabs/GR0101/052357-9/Sim/MovementDet-Opamp.asc

D1: LT1389-2.5
I1: current; SINE(0 1 0.1 0 0 0 100)
M1: nmos; BSS123
M2: nmos; BSS123
M3: pmos; AO6407
OP1: LT1672
OP2: LT1672
OP3: LT1672
OP4: LT1672
R1: res; 500k
R2: res; 750k
R3: res; 1.55Meg
R4: res; 10Meg
R5: res; 10Meg
R6: res; 1Meg
R7: res; 1Meg
R12: res; 3Meg
R13: res; 0.1
R14: res; 100k
R15: res; 100k
R16: res; 100k
V1: voltage; PWL(0 9 10 5 20 9)
V2: voltage; 3.3
Named nets: 0, Vbatt, V3.3V, Vref1.65, Vout, neg, pos, Vref1.55, Vref1.75, Vg
ZXRE330ASA-7DITR-ND
3.3V
1uA Cathode current
$0.3
NCP551SN33
3.3V, 12Vmax
1uA quiescent current
$0.2
.tran 20
