binphilxiao/AxisLabs/GR0101/currentMonitorWithLED/LT Spice simulation/CurrentMonitorWithLED_DualMode.asc

C1: cap; 1µ
C2: cap; 1µ
D1: LED
D2: LED
I_bat: current; PWL(0 0 10 2m 20 0 30 -100m 40 0)
M1: nmos
M2: nmos
R11: res; 1Meg
R15: res; 1Meg
R17: res; 1Meg
R18: res; 866K; tol=1 pwr=0.1
R19: res; 143k; tol=1 pwr=0.1
R21: res; 1Meg; tol=1 pwr=0.1
R22: res; 100k
R23: res; 9k
R24: res; 1k
R25: res; 1k; tol=1 pwr=0.1
R26: res; 1Meg
R27: res; 1Meg
R28: res; 1k; tol=1 pwr=0.1
R29: res; 100k
R30: res; 1.5k
R31: res; 1.5k
R32: res; 1Meg
R33: res; 1Meg
Rsns1: res; 100m
U1: LTC2054
U7: LTC6241
U8: LTC6241
U9: LTC2054
U10: LTC2054
V1: voltage; 3
Named nets: 0, 3V, Vref_1.6V, Vref_0.9V, Vref_1.5V, Vout_stage1, Vout_stage2, Vout_red, Vout_green, Vsns+, Vsns-
.tran 0 20 0 1m startup uic
1mA * 0.1ohm ---x100---> 0.01V ---x10---> 0.1V
-60mA * 0.1ohm ---x100---> -0.6V
