binphilxiao/AxisLabs/GR0101/052350-9/Simulation/MyPlan.asc

C1: cap; 1µ
C2: cap; 1µ
C3: cap; 1µ
D1: LT1389-2.5
OP1: LT1672
OP2: LT1672
OP3: LT1672
OP4: LT1672
R1: res; 1Meg
R2: res; 845K
R3: res; 1.65Meg
R4: res; 6.19Meg
R5: res; 1.65Meg
R6: res; 4.64Meg
R7: res; 1.65Meg
R8: res; 186k
R9: res; 10Meg
R10: res; 402k
R11: res; 10Meg
R12: res; 1Meg
R13: res; 5Meg
R14: res; 51k
R15: res; 107k
R16: res; 100k
R17: res; 10Meg
U2: LT3009-3.3
V1: voltage; PWL(0 9 10 5 20 9)
Named nets: 0, Vbatt, V3.3V, Vref1.65, Vg, En
.tran 0 20 0 0.1 startup uic
ZXRE330ASA-7DITR-ND
3.3V
1uA Cathode current
$0.3
.dc V1 5.6 9 0.1
TLV8544 QUAD OPAMP
3.6V max
0.5uA Supply current per channel
0.1pA Bias current
Rail-to-Rail
$0.3
NCP551SN33
3.3V, 12Vmax
1uA quiescent current
$0.2
6.0V - 6.5V
7.9V - 8.2V
delta = +- VDD*R8/(R8+R9)
for inverting schmitt opamp
delta = +- VDD*R10/R11
for non-inverting schmitt opamp
R13 is the internal pull-up @ EN ofTPS54061
