binphilxiao/AxisLabs/GR0101/052350-9/Simulation/MarcPlan.asc

C1: cap; 10n
C2: cap; 10n
M1: nmos; Si1555DL_N
M2: nmos; Si1555DL_N
R1: res; 10Meg
R2: res; 10Meg
R3: res; 2.67Meg
R4: res; 6.19Meg
R5: res; 1.10Meg
R6: res; 365k
R7: res; 1Meg
U1: LT1672
U2: LT1672
V1: voltage; PWL(0 4.8 10 9 20 4.8)
V2: voltage; 2
Named nets: 0, Low, High, EN, Vg
.tran 20
2/8.2 = (R4+R5) / (20+R3+R4+R5)
2/6 = (R3+R4+R5)/(20+R3+R4+R5)
2/7.9 = (R4+R5+R6)/(20+R3+R4+R5+R6)
2/6.5 = (R3+R4)/(20+R3+R4)
Vds >  20V
Vgs > 10V
Ron < 500m
Price < $0.1
Rail-to-Rail
Vdd >12V
Ib < 1pA
offset < 1mV
I < 10uA
Gopen > 100db
Price < $1
Hystersis of AAT3663 is 0.4V-1.6V
Rating of En is Vdd+0.3
NCS3402DR2G
Issue!!
Leak current from Drain to Source of mosfet 
is higher than the current of voltage divider
