binphilxiao/AxisLabs/(list of files, drawings)

Other design files:
BLE0101/2022.02.25_Rev.A_Manufacture/BLEModule_Rev.A.1.pcb
BLE0101/2022.02.25_Rev.A_Manufacture/BLEModule_Rev.A.2.pcb
BLE0101/2022.03_Rev.B_Manufacture/BLEModule_Rev.B.pcb
BLE0101/2022.04.27_Rev.C_Manufacture/BLEModule_Rev.C.pcb
BLE0101/2022.06.23_TestJig_Rev.A_Manufacture/TJ-BLE0101_RevA.pcb
BLE0101/2022.12_Rev.D_Manufacture/PCB-BLE0101 Rev.D.pcb
BLE0101/2024.03.13_RFtest/PCB-RFTEST Rev.A.pcb
BLE0201/Ref/nRF5340 Development Kit - Hardware files 2_0_0/PCA10095-nRF5340 Development Board 2_0_0/Altium Designer files/400432.PcbDoc
BLE0201/Ref/nRF5340 Development Kit - Hardware files 2_0_0/PCA10095-nRF5340 Development Board 2_0_0/Altium Designer files/pca10095.PrjPCB
BLE0201/Ref/nRF5340 Development Kit - Hardware files 2_0_0/PCA10095-nRF5340 Development Board 2_0_0/Altium Designer files/pca10095_sheet1_cover.SchDoc
BLE0201/Ref/nRF5340 Development Kit - Hardware files 2_0_0/PCA10095-nRF5340 Development Board 2_0_0/Altium Designer files/pca10095_sheet2_nrf5340_mcu.SchDoc
BLE0201/Ref/nRF5340 Development Kit - Hardware files 2_0_0/PCA10095-nRF5340 Development Board 2_0_0/Altium Designer files/pca10095_sheet3_interface_mcu.SchDoc
BLE0201/Ref/nRF5340 Development Kit - Hardware files 2_0_0/PCA10095-nRF5340 Development Board 2_0_0/Altium Designer files/pca10095_sheet4_misc.SchDoc
BLE0201/Ref/nRF5340 Development Kit - Hardware files 2_0_0/PCA10095-nRF5340 Development Board 2_0_0/Altium Designer files/pca10095_sheet5_connectors.SchDoc
BLE0201/Ref/nRF5340 Development Kit - Hardware files 2_0_0/PCA10095-nRF5340 Development Board 2_0_0/Altium Designer files/pca10095_sheet6_power_supply.SchDoc
BLE0201/Ref/nRF5340 Development Kit - Hardware files 2_0_0/PCA64110-NFC Antenna Flexprint 1_0_0/Altium Designer files/400148.PcbDoc
BLE0201/Ref/nRF5340 Development Kit - Hardware files 2_0_0/PCA64110-NFC Antenna Flexprint 1_0_0/Altium Designer files/pca64110.PrjPCB
BLE0201/Ref/nRF5340 Development Kit - Hardware files 2_0_0/PCA64110-NFC Antenna Flexprint 1_0_0/Altium Designer files/pca64110.SchDoc
BR0101/2019.08.23_Rev.A_Manufacture/BR0101_Rev.A.pcb
BR0101/2020.05.21_Rev.B_Manufacture/BR0101_Rev.B.pcb
BR0101/2020.10.19_Rev.C_Manufacture/BR0101_Rev.C.pcb
BR0101/2020.10.19_Rev.C_Manufacture/BR0101_Rev.C_Testpoints.pcb
BR0101/2021.04.22_TestJigsRev.A_Manufacture/TJ-BR0101_RevA.pcb
BR0101/2021.06.09_TestJigsRev.B_Manufacture/TJ-BR0101_RevB.pcb
BR0101/2021.09.07_Rev.C.3_Manufacture/BR0101_Rev.C.2.pcb
BR0101/2021.09.07_Rev.C.3_Manufacture/BR0101_Rev.C.3.pcb
Button/2024.03_Manufacture/Button Rev.A.pcb
GB0101/2019.12.03_Rev.A_Manufacture/BatteryPackBottomRev.A.pcb
GB0101/2019.12.03_Rev.A_Manufacture/BatteryPackFrontRev.A.pcb
GB0101/2019.12.03_Rev.A_Manufacture/BatteryPackInsertRev.A.pcb
GB0101/2019.12.03_Rev.A_Manufacture/BatteryPackTopRev.A.pcb
GB0101/2020.03.26_Rev.B_Manufacture/BatteryPackBottomRev.B.pcb
GB0101/2020.03.26_Rev.B_Manufacture/BatteryPackFlxCabRev.A.pcb
GB0101/2020.03.26_Rev.B_Manufacture/BatteryPackFrontRev.B.pcb
GB0101/2020.03.26_Rev.B_Manufacture/BatteryPackInsertRev.B.pcb
GB0101/2020.03.26_Rev.B_Manufacture/BatteryPackTopRev.B.pcb
GB0101/2020.06.16_Manufacture/AdapterInsertRev.A.pcb
GB0101/2020.06.16_Manufacture/BatteryPackInsertRev.B.pcb
GB0102/2020.10.06_Rev.A_Manufacture/GB0102-INSERT_Rev.A.pcb
GB0102/2020.10.06_Rev.A_Manufacture/GB0102_Rev.A.pcb
GB0102/2020.10.06_Rev.A_Manufacture/GW0101_Rev.B.pcb
GB0102/2021.03.23_Rev.B_Manufacture/GB0102-INSERT_Rev.D.pcb
GB0102/2021.03.23_Rev.B_Manufacture/GB0102-INSERT_Rev.E.pcb
GB0102/2021.03.23_Rev.B_Manufacture/GB0102_RevB.pcb
GB0102/2021.05.04_TestJigRev.A_Manufacture/TJ-GB0102-SIMPLE_Rev.A.pcb
GB0102/2021.05.04_TestJigRev.A_Manufacture/TJ-GB0102_RevA.1.pcb
GB0102/2021.05.11_Rev.C_Manufacture/GB0102-INSERT_Rev.E.1.pcb
GB0102/2021.05.11_Rev.C_Manufacture/GB0102_RevC.pcb
GB0102/2021.06.09_TestJigRev.B_Manufacture/TJ-GB0102_RevB.pcb
GB0102/2021.08_Rev.D_Manufacture/GB0102-INSERT_Rev.F.pcb
GB0102/2021.08_Rev.D_Manufacture/GB0102_RevD.pcb
GB0102/2025.02_Rev.E_Manufacture/GB0102_RevE.pcb
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
