binphilxiao/AxisLabs/(commit log)

2018-11-23 new file: currentMonitorWithLED/CAM.zip new file: currentMonitorWithLED/CAM/currentMonitor-RevB.d1 new file: currentMonitorWithLED/CAM/currentMonitor-RevB.drl new file: currentMonitorWithLED/CAM/curr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
    [currentMonitorWithLED-RevA.pcb, currentMonitorWithLED-RevA.sch, currentMonitorWithLED-RevA_blz.pcb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]
2018-11-23 new file: currentMonitorWithLED/RevHis.txt
2018-11-27 modified: 052357-9A/Encoder.pcb modified: 052357-9A/Encoder.sch modified: 052357-9A/Encoder_blz.pcb
    SMT hall effect sensor applied
    [Encoder.pcb, Encoder.sch, Encoder_blz.pcb]
2018-11-27 modified: 052357-9A/Encoder.pcb modified: 052357-9A/Encoder.sch
    [Encoder.pcb, Encoder.sch]
2018-12-03 TestJigShieldRev E renamed: 052355-9G/Cam.zip -> 052355-9G/052355-9G Axis Apollo Proximity PCB CAM.zip modified: TestJigShield Rev D/Errors.txt modified: TestJigShield Rev D/TestJigShield-RevD.sch mo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
    [TestJigShield-RevD.sch, TestJigShield_RevD.pcb]
2018-12-04 currentMonitorWithLED-RevB deleted: currentMonitorWithLED/CAM/currentMonitor-RevB.d1 deleted: currentMonitorWithLED/CAM/currentMonitor-RevB.drl deleted: currentMonitorWithLED/CAM/currentMonitor-RevB.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
    [currentMonitorWithLED-RevA.pcb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]
2018-12-04 new file: currentMonitorWithLED/currentMonitorWithLED-RevA_CAM/currentMonitor-RevB.drl new file: currentMonitorWithLED/currentMonitorWithLED-RevA_CAM/currentMonitor-RevB.lst new file: currentMonitorW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
    [currentMonitor-RevB.drl]
2018-12-04 deleted: currentMonitorWithLED/LT Spice simulation/CurrentMonitorWithLED.asc deleted: currentMonitorWithLED/LT Spice simulation/CurrentMonitorWithLED_back.asc modified: currentMonitorWithLED/RevHis.t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
    [currentMonitorWithLED-RevA.pcb, currentMonitorWithLED-RevA.sch, currentMonitorWithLED-RevA_blz.pcb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]
2018-12-04 new file: currentMonitorWithLED/LT Spice simulation/CurrentMonitorWithLED_DualMode.asc new file: currentMonitorWithLED/LT Spice simulation/CurrentMonitorWithLED_SingleMode.asc new file: currentMonito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
    [currentMonitorWithLED.pcb, currentMonitorWithLED.sch, currentMonitorWithLED_blz.pcb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]
2018-12-04 modified: currentMonitorWithLED/currentMonitorWithLED.pcb modified: currentMonitorWithLED/currentMonitorWithLED.sch modified: currentMonitorWithLED/currentMonitorWithLED_CAM.zip modified: currentMoni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
    [currentMonitorWithLED.pcb, currentMonitorWithLED.sch, currentMonitorWithLED_blz.pcb]
2018-12-04 new file: currentMonitorWithLED/BillOfMaterials.rep.xlsx new file: currentMonitorWithLED/Production_2018.12.04/BillOfMaterials_DiffMode.xlsx new file: currentMonitorWithLED/Production_2018.12.04/curr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
    [BillOfMaterials.rep.xlsx, BillOfMaterials_DiffMode.xlsx]
2018-12-04 renamed: currentMonitorWithLED/BillOfMaterials.rep.xlsx -> currentMonitorWithLED/BillOfMaterials.xlsx
    [BillOfMaterials.xlsx]
2018-12-04 modified: TestJigShield Rev D/TestJigShield-RevD.sch modified: TestJigShield Rev D/TestJigShield_RevD.pcb modified: currentMonitorWithLED/Production_2018.12.04/BillOfMaterials_DiffMode.xlsx
    [BillOfMaterials_DiffMode.xlsx, TestJigShield-RevD.sch, TestJigShield_RevD.pcb]
2018-12-14 new file: MainCharger/ResistanceCal.m new file: MainCharger/ResistorEqu.png new file: MainCharger/ResistorEqu.txt
2018-12-14 modified: ResistanceCal.m
2018-12-14 new file: 052357-9A/ETONM WGM46- Modified - V2.step new file: 052357-9A/SGM25PCB(H15019).dwg
    [ETONM WGM46- Modified - V2.step, SGM25PCB(H15019).dwg]
2018-12-19 modified: 052357-9A/SGM25PCB(H15019).dwg modified: MainCharger/MarcPlan.asc modified: MainCharger/MyPlan.asc
    [SGM25PCB(H15019).dwg]
2018-12-20 modified: 052357-9A/CAM/052357-9A_Bottom.f2 modified: 052357-9A/CAM/052357-9A_SilkBottom.s2 modified: 052357-9A/CAM/052357-9A_SilkTop.s1 modified: 052357-9A/CAM/052357-9A_SolderMaskBottom.m2 modified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
    [Encoder.pcb, Encoder_blz.pcb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]
2018-12-21 TestJigShield Rev D & 052357-9A sent out to Seedstudio deleted: 052357-9A/CAM.zip deleted: 052357-9A/CAM/052357-9A_Bottom.f2 deleted: 052357-9A/CAM/052357-9A_SilkBottom.s2 deleted: 052357-9A/CAM/0523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
    [Encoder.pcb, TestJigShield-RevD.sch, TestJigShield_RevD.pcb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]
2018-12-21 new file: 052357-9A/052357-9_CAM.zip new file: 052357-9A/052357-9_CAM/052357-9A_Bottom.f2 new file: 052357-9A/052357-9_CAM/052357-9A_SilkBottom.s2 new file: 052357-9A/052357-9_CAM/052357-9A_SilkTop.s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
    [NCDrill.drl, TestJig-RevD-Drill.drl]
2018-12-21 renamed: TestJigShield Rev D/Errors.txt -> TestJigShield/Errors.txt renamed: TestJigShield Rev D/TestJigShield-RevD.sch -> TestJigShield/TestJigShield-RevD.sch renamed: TestJigShield Rev D/TestJigShi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
    [TestJigShield-RevD.sch, TestJigShield_RevD.pcb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]
2018-12-21 renamed: 052355-9G/052355-9G Axis Apollo Proximity PCB CAM.zip -> 052355-9/052355-9G Axis Apollo Proximity PCB CAM.zip renamed: 052355-9G/052355-9G Axis Apollo Proximity PCB.pcb -> 052355-9/052355-9G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
    [052355-9G Axis Apollo Proximity PCB.pcb, 052355-9G Axis Apollo Proximity PCB.sch, ETONM WGM46- Modified - V2.step, Encoder.pcb, Encoder.sch, Encoder_blz.pcb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]
2018-12-21 deleted: 052355-9/052355-9G Axis Apollo Proximity PCB_blz.bre new file: "052355-9/backup/052355-9GCam(\351\225\215\351\222\257\351\207\221\357\274\211gerber.zip" new file: 052355-9/backup/052355-9GCa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
2018-12-21 deleted: 052357-9/BillOfMaterials.rep.txt renamed: 052357-9/ETONM WGM46- Modified - V2.step -> 052357-9/CAD/ETONM WGM46- Modified - V2.step renamed: 052357-9/SGM25PCB(H15019).dwg -> 052357-9/CAD/SGM2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
    [ETONM WGM46- Modified - V2.step, Encoder_blz.pcb, SGM25PCB(H15019).dwg]
2018-12-21 renamed: TestJigShield/TestJigShield_RevD.pcb -> TestJigShield/TestJigShield.pcb renamed: TestJigShield/TestJigShield-RevD.sch -> TestJigShield/TestJigShield.sch
    [TestJigShield.pcb, TestJigShield.sch]
2018-12-21 deleted: 052355-9/Cam/052355-9G_Bottom.F2 deleted: 052355-9/Cam/052355-9G_DrillPhoto.D1 deleted: 052355-9/Cam/052355-9G_Outline.O1 deleted: 052355-9/Cam/052355-9G_SilkscreenBottom.S2 deleted: 052355-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
    [052355-9G_drill.drl, NCDrill.drl, TestJig-RevD-Drill.drl]
2018-12-21 renamed: 052355-9/052355-9G Axis Apollo Proximity PCB.pcb -> 052355-9/052355-9 Axis Apollo Proximity PCB.pcb renamed: 052355-9/052355-9G Axis Apollo Proximity PCB.sch -> 052355-9/052355-9 Axis Apollo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
    [052355-9 Axis Apollo Proximity PCB.pcb, 052355-9 Axis Apollo Proximity PCB.sch, 052355-9G Axis Apollo Proximity PCB BOM.xlsx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]
2018-12-21 deleted: 052355-9/Cam/052355-9G_Bottom.F2 deleted: 052355-9/Cam/052355-9G_DrillPhoto.D1 deleted: 052355-9/Cam/052355-9G_Outline.O1 deleted: 052355-9/Cam/052355-9G_SilkscreenBottom.S2 deleted: 052355-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
    [052355-9G_drill.drl]
2018-12-21 renamed: 052355-9/052355-9G_Manufacture/052355-9 Axis Apollo Proximity PCB CAM.zip -> 052355-9/052355-9G_Manufacture/052355-9G Axis Apollo Proximity PCB CAM.zip renamed: "052355-9/052355-9G_Manufactu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
2018-12-21 renamed: 052357-9/052357-9_CAM.zip -> 052357-9/052357-9 Encoder Manufacture/052357-9 Encoder CAM.zip new file: 052357-9/052357-9 Encoder Manufacture/BillOfMaterials.rep.txt renamed: 052357-9/Encoder.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
    [052357-9 Encoder.pcb, 052357-9 Encoder.sch, 052357-9 Encoder_blz.pcb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]
2018-12-21 deleted: 052357-9/052357-9 Encoder_blz.pcb deleted: 052357-9/052357-9_CAM/052357-9A_Bottom.f2 deleted: 052357-9/052357-9_CAM/052357-9A_SilkBottom.s2 deleted: 052357-9/052357-9_CAM/052357-9A_SilkTop.s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
    [052357-9 Encoder_blz.pcb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]
2018-12-21 deleted: currentMonitorWithLED/BillOfMaterials.xlsx deleted: currentMonitorWithLED/currentMonitorWithLED_CAM/currentMonitor-RevB.drl deleted: currentMonitorWithLED/currentMonitorWithLED_CAM/currentMo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
    [BillOfMaterials.xlsx, currentMonitorWithLED_blz.pcb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]
2018-12-21 new file: currentMonitorWithLED/Production_2018.12.04/BillOfMaterials.xlsx deleted: currentMonitorWithLED/currentMonitorWithLED_CAM.zip
    [BillOfMaterials.xlsx]
2018-12-21 deleted: Sim/Charger.asc deleted: Sim/MotorCurrentLimit.asc deleted: Sim/clean.bat
2019-01-08 new file: 052350-9/TPS54061_Cal.ods
    [TPS54061_Cal.ods]
2019-01-08 modified: TPS54061_Cal.ods new file: TestRec.odt
    [TPS54061_Cal.ods]
2019-01-08 modified: TPS54061_Cal.ods modified: TestRec.odt
    [TPS54061_Cal.ods]
2019-01-11 modified: 052350-9/TPS54061_Cal.ods modified: 052350-9/TestRec.odt modified: TestJigShield/ChangeLog.txt
    [TPS54061_Cal.ods]
2019-01-14 new file: BuckSim/BuckConceptral.asc modified: TPS54061_Cal.ods deleted: TestRec.odt
    [TPS54061_Cal.ods]
2019-01-14 modified: 052350-9/TPS54061_Cal.ods modified: 052350-9/TestRep.odt
    [TPS54061_Cal.ods]
2019-01-16 modified: TPS54061_Cal.ods
    [TPS54061_Cal.ods]
2019-01-16 modified: 052350-9/BuckSim/BuckConceptral.asc modified: 052350-9/TPS54061_Cal.ods modified: 052350-9/TestRep.odt modified: currentMonitorWithLED/LT Spice simulation/CurrentMonitorWithLED_DualMode.asc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
    [TPS54061_Cal.ods]
2019-01-18 modified: 052350-9/TPS54061_Cal.ods modified: 052350-9/TestRep.odt modified: 052355-9/052355-9 Axis Apollo Proximity PCB.sch modified: 052357-9/052357-9 Encoder.sch
    [052355-9 Axis Apollo Proximity PCB.sch, 052357-9 Encoder.sch, TPS54061_Cal.ods]
2019-01-22 new file: 052350-9/052350-9Q Axis Apollo Controller.pcb new file: 052350-9/052350-9Q Axis Apollo Main Schematic.sch
    [052350-9Q Axis Apollo Controller.pcb, 052350-9Q Axis Apollo Main Schematic.sch]
2019-01-30 modified: 052350-9/052350-9Q Axis Apollo Main Schematic.sch modified: 052350-9/TPS54061_Cal.ods
    [052350-9Q Axis Apollo Main Schematic.sch, TPS54061_Cal.ods]
2019-02-07 modified: 052350-9/052350-9Q Axis Apollo Main Schematic.sch modified: 052350-9/ChargerCtlSim/MyPlan.asc modified: 052350-9/TPS54061_Cal.ods modified: 052350-9/TestRep.odt
    [052350-9Q Axis Apollo Main Schematic.sch, TPS54061_Cal.ods]
2019-02-11 modified: 052350-9/052350-9Q Axis Apollo Main Schematic.sch modified: 052357-9/052357-9 Encoder.pcb modified: 052357-9/052357-9 Encoder.sch modified: 052357-9/ChangeLog.txt
    [052350-9Q Axis Apollo Main Schematic.sch, 052357-9 Encoder.pcb, 052357-9 Encoder.sch]
2019-02-21 modified: 052350-9/052350-9Q Axis Apollo Main Schematic.sch modified: 052350-9/TPS54061_Cal.ods modified: 052350-9/TestRep.odt modified: 052357-9/052357-9 Encoder.sch modified: 052357-9/ChangeLog.txt
    [052350-9Q Axis Apollo Main Schematic.sch, 052357-9 Encoder.sch, TPS54061_Cal.ods]
2019-02-21 deleted: .~lock.TPS54061_Cal.ods# deleted: .~lock.TestRep.odt# renamed: TPS54061_Cal.ods -> 052350-9R Axis Apollo Calculation.ods renamed: 052350-9Q Axis Apollo Controller.pcb -> 052350-9R Axis Apoll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
    [052350-9Q Axis Apollo Main Schematic.sch, 052350-9R Axis Apollo Calculation.ods, 052350-9R Axis Apollo Controller.pcb, 052350-9R Axis Apollo Main Schematic.sch]
2019-02-22 modified: 052350-9/052350-9R Axis ApolloTestRep.odt deleted: 052350-9/ChargerCtlSim/Interview/DATASHEET/NCP551-D.PDF deleted: 052350-9/ChargerCtlSim/Interview/DATASHEET/ZXRE330.pdf deleted: 052350-9/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
2019-02-25 modified: 052350-9/052350-9R Axis Apollo Main Schematic.sch modified: 052350-9/to do list.txt
    [052350-9R Axis Apollo Main Schematic.sch]
2019-02-25 modified: 052350-9/052350-9R Axis Apollo Controller.pcb modified: 052350-9/052350-9R Axis Apollo Main Schematic.sch
    [052350-9R Axis Apollo Controller.pcb, 052350-9R Axis Apollo Main Schematic.sch]
2019-02-26 modified: 052350-9R Axis Apollo Controller.pcb new file: 052350-9R Axis Apollo Controller_blz.pcb modified: 052350-9R Axis Apollo Main Schematic.sch modified: to do list.txt
    [052350-9R Axis Apollo Controller.pcb, 052350-9R Axis Apollo Controller_blz.pcb, 052350-9R Axis Apollo Main Schematic.sch]
2019-02-28 modified: 052350-9/052350-9R Axis Apollo Controller.pcb
    [052350-9R Axis Apollo Controller.pcb]
2019-03-05 modified: 052350-9/052350-9R Axis Apollo Controller.pcb modified: 052350-9/052350-9R Axis Apollo Controller_blz.pcb modified: 052350-9/052350-9R Axis Apollo Main Schematic.sch modified: currentMonito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
    [052350-9R Axis Apollo Controller.pcb, 052350-9R Axis Apollo Controller_blz.pcb, 052350-9R Axis Apollo Main Schematic.sch]
2019-03-07 modified: 052350-9/052350-9R Axis Apollo Controller.pcb modified: 052350-9/052350-9R Axis Apollo Controller_blz.pcb modified: 052350-9/052350-9R Axis Apollo Main Schematic.sch modified: 052350-9/to d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
    [052350-9R Axis Apollo Controller.pcb, 052350-9R Axis Apollo Controller_blz.pcb, 052350-9R Axis Apollo Main Schematic.sch]
2019-03-11 modified: 052350-9R Axis Apollo Controller.pcb modified: 052350-9R Axis Apollo Controller_blz.pcb modified: 052350-9R Axis Apollo Main Schematic.sch modified: to do list.txt
    [052350-9R Axis Apollo Controller.pcb, 052350-9R Axis Apollo Controller_blz.pcb, 052350-9R Axis Apollo Main Schematic.sch]
2019-03-12 modified: 052350-9/052350-9R Axis Apollo Controller.pcb modified: 052350-9/052350-9R Axis Apollo Controller_blz.pcb modified: 052350-9/052350-9R Axis Apollo Main Schematic.sch
    [052350-9R Axis Apollo Controller.pcb, 052350-9R Axis Apollo Controller_blz.pcb, 052350-9R Axis Apollo Main Schematic.sch]
2019-03-12 modified: 052350-9R Axis Apollo Controller.pcb modified: 052350-9R Axis Apollo Main Schematic.sch
    [052350-9R Axis Apollo Controller.pcb, 052350-9R Axis Apollo Main Schematic.sch]
2019-03-14 deleted: 052350-9R Axis Apollo Calculation.ods modified: 052350-9R Axis Apollo Controller.pcb modified: 052350-9R Axis Apollo Controller_blz.pcb deleted: 052350-9R Axis Apollo DesignThoughts.docx mod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
    [052350-9R Axis Apollo Calculation.ods, 052350-9R Axis Apollo Controller.pcb, 052350-9R Axis Apollo Controller_blz.pcb, 052350-9R Axis Apollo Main Schematic.sch]
2019-03-14 new file: Docs/052350-9R Axis Apollo Calculation.ods new file: Docs/052350-9R Axis Apollo DesignThoughts.docx new file: Docs/052350-9R Axis ApolloTestRep.odt new file: Docs/ReservedTestPointsList.txt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
    [052350-9R Axis Apollo Calculation.ods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]
2019-03-18 modified: 052350-9/052350-9R Axis Apollo Main Schematic.sch
    [052350-9R Axis Apollo Main Schematic.sch]
2019-03-18 modified: 052350-9/052350-9R Axis Apollo Controller.pcb modified: 052350-9/052350-9R Axis Apollo Main Schematic.sch modified: 052350-9/cam/052350-9R.a1 modified: 052350-9/cam/052350-9R.a2 modified: 0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
    [052350-9R Axis Apollo Controller.pcb, 052350-9R Axis Apollo Main Schematic.sch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]
2019-03-25 modified: 052350-9/052350-9R Axis Apollo Controller.pcb modified: 052350-9/052350-9R Axis Apollo Controller_blz.pcb modified: 052350-9/052350-9R Axis Apollo Main Schematic.sch new file: 052350-9/Manu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
    [052350-9R Axis Apollo Controller.pcb, 052350-9R Axis Apollo Controller_blz.pcb, 052350-9R Axis Apollo Main Schematic.sch, BillOfMaterials.rep.xlsx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]
2019-03-25 new file: 052350-9/Manufacture/052350-9R Axis Apollo Controller Gerber.zip
2019-03-28 modified: 052350-9/052350-9R Axis Apollo Controller.pcb deleted: 052350-9/052350-9R Axis Apollo Controller_blz.pcb modified: 052350-9/052350-9R Axis Apollo Main Schematic.sch deleted: 052350-9/Manufa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
    [052350-9R Axis Apollo Controller.pcb, 052350-9R Axis Apollo Controller_blz.pcb, 052350-9R Axis Apollo Main Schematic.sch, BillOfMaterials.rep.xlsx]
2019-03-28 new file: 052350-9/Manufacture/052350-9R Gerber.zip
2019-04-02 new file: CalSheetGearV2.ods
    [CalSheetGearV2.ods]
2019-04-03 modified: CalSheetGearV2.ods
    [CalSheetGearV2.ods]
2019-05-01 modified: PowerGearV2/BoostConceptral.asc modified: PowerGearV2/CalSheetGearV2.ods
    [CalSheetGearV2.ods]
2019-05-21 modified: PowerGearV2/CalSheetGearV2.ods new file: PowerGearV2/PowerModule.sch
    [CalSheetGearV2.ods, PowerModule.sch]
2019-05-21 new file: PowerGearV2/Docs/BQ24155/EV software/BQ24153_6_8 EVM.lnk new file: PowerGearV2/Docs/BQ24155/EV software/BQ24153_6_8Setup.zip new file: PowerGearV2/Docs/BQ24155/EV software/BQ2415xSetup.zip 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
    [PowerCordCal.ods]
2019-05-21 deleted: PowerGearV2/Docs/BQ24155/EV software/BQ24153_6_8 EVM.lnk deleted: PowerGearV2/Docs/BQ24155/EV software/BQ24153_6_8Setup.zip deleted: PowerGearV2/Docs/BQ24155/EV software/BQ2415xSetup.zip del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
2019-05-22 modified: PowerGearV2/PowerModule.sch
    [PowerModule.sch]
2019-05-24 modified: 052357-9/052357-9 Encoder.sch modified: PowerGearV2/PowerModule.sch
    [052357-9 Encoder.sch, PowerModule.sch]
2019-05-29 new file: PowerGearV2/PowerModule.pcb modified: PowerGearV2/PowerModule.sch
    [PowerModule.pcb, PowerModule.sch]
2019-06-03 modified: PowerGearV2/CalSheetGearV2.ods new file: PowerGearV2/IIC_CMD.txt new file: PowerGearV2/PCB/PowerModule.asc renamed: PowerGearV2/PowerModule.pcb -> PowerGearV2/PCB/PowerModule.pcb renamed: P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
    [CalSheetGearV2.ods, PowerModule.pcb, PowerModule.sch]
2019-06-04 modified: PowerGearV2/CalSheetGearV2.ods modified: PowerGearV2/PCB/PowerModule.asc modified: PowerGearV2/PCB/PowerModule.sch
    [CalSheetGearV2.ods, PowerModule.sch]
2019-06-06 modified: PowerGearV2/PCB/PowerModule.sch
    [PowerModule.sch]
2019-06-10 modified: PowerGearV2/PCB/PowerModule.asc modified: PowerGearV2/PCB/PowerModule.pcb modified: PowerGearV2/PCB/PowerModule.sch
    [PowerModule.pcb, PowerModule.sch]
2019-06-14 new file: PowerGearV2/PCB/PowerModule#2.pcb new file: PowerGearV2/PCB/PowerModule#2.sch new file: PowerGearV2/PCB/PowerModule#4.pcb new file: PowerGearV2/PCB/PowerModule#4.sch modified: PowerGearV2/P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
    [PowerModule#2.pcb, PowerModule#2.sch, PowerModule#4.pcb, PowerModule#4.sch, PowerModule.pcb, PowerModule.sch]
2019-06-25 modified: PowerGearV2/PCB/PowerModule#2.pcb modified: PowerGearV2/PCB/PowerModule#2.sch new file: PowerGearV2/PCB/PowerModule#3.pcb new file: PowerGearV2/PCB/PowerModule#3.sch new file: PowerGearV2/P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
    [PowerModule#2.pcb, PowerModule#2.sch, PowerModule#3.pcb, PowerModule#3.sch, PowerModule#3_blz.pcb, PowerModule#4.pcb, PowerModule#4.sch, PowerModule#4_blz.pcb]
2019-06-25 modified: PowerGearV2/PCB/PowerModule#2.pcb modified: PowerGearV2/PCB/PowerModule#2.sch modified: PowerGearV2/PCB/PowerModule#3.pcb modified: PowerGearV2/PCB/PowerModule#4.pcb
    [PowerModule#2.pcb, PowerModule#2.sch, PowerModule#3.pcb, PowerModule#4.pcb]
2019-07-08 new file: 052355-9/Firmware_20Sept17_V2.1/InterfaceBrd_V2.1.cprj new file: 052355-9/Firmware_20Sept17_V2.1/InterfaceBrd_V2.1.h new file: 052355-9/Firmware_20Sept17_V2.1/InterfaceBrd_V2.1.hex new file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
    [052350-9R Axis Apollo Main Schematic.sch, 052355-9 Axis Apollo Proximity PCB.sch, PowerModule#1.pcb, PowerModule#1.sch, PowerModule#1.step, PowerModule#2.pcb, PowerModule#2.sch, PowerModule#2.step]
2019-07-08 modified: PowerGearV2/PCB/PowerModule#4.pcb modified: PowerGearV2/PCB/PowerModule#4.sch deleted: PowerGearV2/PCB/~$PowerModule#2.sch.inf
    [PowerModule#4.pcb, PowerModule#4.sch]
2019-07-08 modified: PowerGearV2/PCB/PowerModule#4.pcb modified: PowerGearV2/PCB/PowerModule#4.sch
    [PowerModule#4.pcb, PowerModule#4.sch]
2019-07-11 modified: PowerGearV2/PCB/PowerModule#2.pcb modified: PowerGearV2/PCB/PowerModule#2.sch modified: PowerGearV2/PCB/PowerModule#4.pcb modified: PowerGearV2/PCB/PowerModule#4.sch
    [PowerModule#2.pcb, PowerModule#2.sch, PowerModule#4.pcb, PowerModule#4.sch]
2019-07-19 new file: Bridge/main.sch modified: PowerGearV2/PCB/PowerModule#2.sch
    [PowerModule#2.sch, main.sch]
2019-07-24 modified: 052350-9/052350-9R Axis Apollo Main Schematic.sch modified: Bridge/main.sch
    [052350-9R Axis Apollo Main Schematic.sch, main.sch]
2019-07-24 new file: Bridge/main.pcb
    [main.pcb]
2019-08-06 modified: Bridge/main.pcb modified: Bridge/main.sch modified: PowerGearV2/PCB/PowerModule#4.pcb
    [PowerModule#4.pcb, main.pcb, main.sch]
2019-08-09 modified: Bridge/main.pcb modified: Bridge/main.sch
    [main.pcb, main.sch]
2019-08-22 modified: main.pcb modified: main.sch
    [052350-9R Axis Apollo Controller.pcb, 052357-9 Encoder.sch, main.pcb, main.sch]
2019-08-22 modified: Bridge/main.pcb
    [main.pcb]
2019-09-03 modified: Bridge/main.pcb modified: Bridge/main.sch modified: PowerGearV2/PCB/PowerModule#4.sch
    [PowerModule#4.sch, main.pcb, main.sch]
2019-09-18 modified: Bridge/main.pcb modified: Bridge/main.sch new file: PowerGearV2/Sim/Indicator.asc new file: PowerGearV2/Sim/IndicatorOrg.asc new file: PowerGearV2/Sim/logic/indicator/compile.bat new file: 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
    [main.pcb, main.sch]
2019-10-02 modified: Bridge/main.pcb modified: PowerGearV2/PCB/PowerModule#4.sch modified: PowerGearV2/Sim/IndicatorOrg.asc modified: PowerGearV2/Sim/logic/indicator/indicator.v modified: PowerGearV2/Sim/logic/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
    [PowerModule#4.sch, main.pcb]
2019-10-23 modified: PowerGearV2/PCB/PowerModule#2.sch modified: PowerGearV2/PCB/PowerModule#3.pcb modified: PowerGearV2/PCB/PowerModule#3.sch modified: PowerGearV2/PCB/PowerModule#4.sch modified: PowerGearV2/S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
    [PowerModule#2.sch, PowerModule#3.pcb, PowerModule#3.sch, PowerModule#4.sch]
2019-10-23 new file: PowerGearV2/Sim/IndicatorOrg2.asc
2019-10-28 modified: PowerGearV2/Sim/IndicatorOrg2.asc
2019-10-28 new file: PowerGearV2/Sim/logic/indicator/LEDindicatorV1.gp3 new file: PowerGearV2/Sim/logic/indicator/LEDindicatorV2.gp3
2019-10-28 new file: PowerGearV2/PCB/PowerModule#3_2.sch modified: PowerGearV2/Sim/IndicatorOrg2.asc modified: PowerGearV2/Sim/logic/indicator/LEDindicatorV2.gp3
    [PowerModule#3_2.sch]
2019-10-29 modified: Bridge/main.sch modified: PowerGearV2/PCB/PowerModule#3_2.sch modified: PowerGearV2/Sim/logic/indicator/LEDindicatorV2.gp3
    [PowerModule#3_2.sch, main.sch]
2019-10-31 modified: PowerGearV2/PCB/PowerModule#3_2.sch deleted: PowerGearV2/Sim/logic/indicator/LEDindicatorV1.gp3 deleted: PowerGearV2/Sim/logic/indicator/LEDindicatorV2.gp3
    [PowerModule#3_2.sch]
2019-10-31 new file: PowerGearV2/Sim/logic/indicator/LEDindicator.gp3
2019-11-12 modified: Bridge/main.pcb modified: Bridge/main.sch deleted: PowerGearV2/PCB/PowerModule#1.pcb deleted: PowerGearV2/PCB/PowerModule#1.sch deleted: PowerGearV2/PCB/PowerModule#2.pcb deleted: PowerGear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
    [PowerModule#1.pcb, PowerModule#1.sch, PowerModule#2.pcb, PowerModule#2.sch, PowerModule#3.pcb, PowerModule#3_2.sch, PowerModule#4.pcb, PowerModule#4.sch]
2019-11-12 new file: PowerGearV2/PCB/PowerModuleBottom.pcb new file: PowerGearV2/PCB/PowerModuleBottom.sch new file: PowerGearV2/PCB/PowerModuleFront.sch new file: PowerGearV2/PCB/PowerModuleInsert.pcb new file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
    [PowerModuleBottom.pcb, PowerModuleBottom.sch, PowerModuleFront.sch, PowerModuleInsert.pcb, PowerModuleInsert.sch, PowerModuleSide.pcb, PowerModuleTop.pcb, PowerModuleTop.sch]
2019-11-12 renamed: PowerGearV2/PCB/PowerModuleBottom.pcb -> BatteryPackBottom.pcb renamed: PowerGearV2/PCB/PowerModuleBottom.sch -> BatteryPackBottom.sch renamed: PowerGearV2/PCB/PowerModuleSide.pcb -> Battery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
    [BatteryPackBottom.pcb, BatteryPackBottom.sch, BatteryPackFront.pcb, BatteryPackInsert.pcb, BatteryPackInsert.sch, BatteryPackTop.pcb, BatteryPackTop.sch]
2019-11-12 deleted: BatteryPackBottom.pcb deleted: BatteryPackBottom.sch deleted: BatteryPackFront.pcb deleted: BatteryPackInsert.pcb deleted: BatteryPackInsert.sch deleted: BatteryPackTop.pcb deleted: BatteryP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
    [BatteryPackBottom.pcb, BatteryPackBottom.sch, BatteryPackFront.pcb, BatteryPackInsert.pcb, BatteryPackInsert.sch, BatteryPackTop.pcb, BatteryPackTop.sch, PowerModule#3.sch]
2019-11-12 new file: PowerGearV2/PCB/BatteryPackBottom.pcb new file: PowerGearV2/PCB/BatteryPackBottom.sch new file: PowerGearV2/PCB/BatteryPackFront.pcb new file: PowerGearV2/PCB/BatteryPackFront.sch new file: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
    [BatteryPackBottom.pcb, BatteryPackBottom.sch, BatteryPackFront.pcb, BatteryPackFront.sch, BatteryPackInsert.pcb, BatteryPackInsert.sch, BatteryPackTop.pcb, BatteryPackTop.sch]
2019-11-13 modified: PowerGearV2/PCB/BatteryPackTop.pcb modified: PowerGearV2/PCB/BatteryPackTop.sch
    [BatteryPackTop.pcb, BatteryPackTop.sch]
2019-11-14 modified: PowerGearV2/PCB/BatteryPackBottom.pcb modified: PowerGearV2/PCB/BatteryPackBottom.sch modified: PowerGearV2/PCB/BatteryPackFront.pcb modified: PowerGearV2/PCB/BatteryPackFront.sch modified: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
    [BatteryPackBottom.pcb, BatteryPackBottom.sch, BatteryPackFront.pcb, BatteryPackFront.sch, BatteryPackTop.pcb, BatteryPackTop.sch]
2019-11-15 modified: PowerGearV2/PCB/BatteryPackBottom.sch modified: PowerGearV2/PCB/BatteryPackFront.pcb modified: PowerGearV2/PCB/BatteryPackFront.sch modified: PowerGearV2/PCB/BatteryPackTop.sch
    [BatteryPackBottom.sch, BatteryPackFront.pcb, BatteryPackFront.sch, BatteryPackTop.sch]
2019-11-18 modified: PowerGearV2/PCB/BatteryPackFront.pcb modified: PowerGearV2/PCB/BatteryPackTop.pcb modified: PowerGearV2/PCB/BatteryPackTop.sch
    [BatteryPackFront.pcb, BatteryPackTop.pcb, BatteryPackTop.sch]
2019-11-20 modified: PowerGearV2/PCB/BatteryPackBottom.pcb modified: PowerGearV2/PCB/BatteryPackBottom.sch modified: PowerGearV2/PCB/BatteryPackFront.pcb modified: PowerGearV2/PCB/BatteryPackFront.sch modified: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
    [BatteryPackBottom.pcb, BatteryPackBottom.sch, BatteryPackFront.pcb, BatteryPackFront.sch, BatteryPackTop.pcb]
2019-11-20 modified: PowerGearV2/PCB/BatteryPackFront.pcb modified: PowerGearV2/PCB/BatteryPackFront.sch modified: PowerGearV2/PCB/BatteryPackTop.pcb modified: PowerGearV2/PCB/BatteryPackTop.sch
    [BatteryPackFront.pcb, BatteryPackFront.sch, BatteryPackTop.pcb, BatteryPackTop.sch]
2019-11-20 modified: PowerGearV2/PCB/BatteryPackBottom.pcb modified: PowerGearV2/PCB/BatteryPackBottom.sch modified: PowerGearV2/PCB/BatteryPackFront.pcb modified: PowerGearV2/PCB/BatteryPackInsert.pcb modified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
    [BatteryPackBottom.pcb, BatteryPackBottom.sch, BatteryPackFront.pcb, BatteryPackInsert.pcb, BatteryPackInsert.sch, BatteryPackTop.pcb, BatteryPackTop.sch]
2019-11-20 deleted: PowerGearV2/PCB/3D/PowerModule#1.step deleted: PowerGearV2/PCB/3D/PowerModule#2.step deleted: PowerGearV2/PCB/3D/PowerModule#3.step deleted: PowerGearV2/PCB/3D/PowerModule#4.step modified: P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
    [BatteryPackBottom.pcb, BatteryPackBottom.sch, BatteryPackFront.pcb, BatteryPackInsert.pcb, BatteryPackTop.pcb, BatteryPackTop.sch, PowerModule#1.step, PowerModule#2.step]
2019-11-21 modified: PowerGearV2/PCB/BatteryPackBottom.pcb modified: PowerGearV2/PCB/BatteryPackBottom.sch modified: PowerGearV2/PCB/BatteryPackFront.pcb modified: PowerGearV2/PCB/BatteryPackFront.sch modified: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
    [BatteryPackBottom.pcb, BatteryPackBottom.sch, BatteryPackFront.pcb, BatteryPackFront.sch, BatteryPackInsert.pcb, BatteryPackInsert.sch, BatteryPackTop.pcb, BatteryPackTop.sch]
2019-11-21 modified: PowerGearV2/PCB/BatteryPackBottom.pcb modified: PowerGearV2/PCB/BatteryPackFront.pcb modified: PowerGearV2/PCB/BatteryPackTop.pcb
    [BatteryPackBottom.pcb, BatteryPackFront.pcb, BatteryPackTop.pcb]
2019-11-25 modified: PowerGearV2/PCB/BatteryPackFront.pcb modified: PowerGearV2/PCB/BatteryPackFront.sch modified: PowerGearV2/PCB/BatteryPackInsert.pcb modified: PowerGearV2/PCB/BatteryPackInsert.sch modified: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
    [BatteryPackFront.pcb, BatteryPackFront.sch, BatteryPackInsert.pcb, BatteryPackInsert.sch, BatteryPackTop.pcb]
2019-11-25 modified: PowerGearV2/PCB/BatteryPackTop.pcb
    [BatteryPackTop.pcb]
2019-11-26 modified: PowerGearV2/PCB/BatteryPackBottom.pcb modified: PowerGearV2/PCB/BatteryPackBottom.sch modified: PowerGearV2/PCB/BatteryPackTop.pcb
    [BatteryPackBottom.pcb, BatteryPackBottom.sch, BatteryPackTop.pcb]
2019-11-27 modified: Bridge/main.pcb modified: PowerGearV2/PCB/BatteryPackBottom.pcb modified: PowerGearV2/PCB/BatteryPackBottom.sch modified: PowerGearV2/PCB/BatteryPackInsert.pcb modified: PowerGearV2/PCB/Bat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
    [BatteryPackBottom.pcb, BatteryPackBottom.sch, BatteryPackInsert.pcb, BatteryPackInsert.sch, BatteryPackTop.pcb, BatteryPackTop.sch, main.pcb]
2019-12-03 modified: Bridge/main.pcb modified: Bridge/main.sch modified: PowerGearV2/PCB/BatteryPackBottom.pcb modified: PowerGearV2/PCB/BatteryPackBottom.sch modified: PowerGearV2/PCB/BatteryPackFront.pcb modi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
    [BatteryPackBottom.pcb, BatteryPackBottom.sch, BatteryPackFront.pcb, BatteryPackFront.sch, BatteryPackInsert.pcb, BatteryPackTop.pcb, BatteryPackTop.sch, main.pcb]
2019-12-09 modified: Bridge/main.pcb modified: Bridge/main.sch modified: PowerGearV2/PCB/BatteryPackFront.pcb modified: PowerGearV2/PCB/BatteryPackInsert.pcb modified: PowerGearV2/PCB/BatteryPackTop.pcb
    [BatteryPackFront.pcb, BatteryPackInsert.pcb, BatteryPackTop.pcb, main.pcb, main.sch]
2019-12-10 modified: Bridge/main.sch
    [main.sch]
2019-12-10 new file: Bridge/BridgeMainRev.B.pcb
    [BridgeMainRev.B.pcb]
2019-12-12 modified: Bridge/BridgeMainRev.B.pcb modified: Bridge/main.sch
    [BridgeMainRev.B.pcb, main.sch]
2019-12-12 modified: Bridge/BridgeMainRev.B.pcb
    [BridgeMainRev.B.pcb]
2020-01-03 modified: PowerGearV2/PCB/BatteryPackTop.sch
    [BatteryPackTop.sch]
2020-01-03 deleted: Bridge/main.pcb deleted: Bridge/main.sch
    [main.pcb, main.sch]
2020-01-03 new file: 052350-9/Docs/Diagram.jpg new file: Bridge/2019.8.23_Manufacture/BillOfMaterials.rep new file: Bridge/2019.8.23_Manufacture/BillOfMaterials.xlsx new file: Bridge/2019.8.23_Manufacture/Bridg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
    [BillOfMaterials.xlsx, BridgeMainRev.A.pcb, BridgeMainRev.A.sch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]
2020-01-03 new file: Bridge/BridgeMainRev.B.sch new file: Bridge/ImpedanceCal.m new file: Bridge/Sim/Indicator/BridgeIndicator.gp3 new file: Bridge/Sim/Indicator/LEDIndicatorBridge.asc
    [BridgeMainRev.B.sch]
2020-01-03 new file: PowerGearV2/Sim/logic/indicator/BACKUP/LEDindicatorV1.gp3 new file: PowerGearV2/Sim/logic/indicator/BACKUP/LEDindicatorV2.gp3 new file: PowerGearV2/Sim/logic/indicator/BACKUP/LEDindicatorV3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
2020-01-03 new file: PowerGearV2/2019.12.03_Manufacture/BatteryPackBottom.pcb new file: PowerGearV2/2019.12.03_Manufacture/BatteryPackBottom.sch new file: PowerGearV2/2019.12.03_Manufacture/BatteryPackFront.pcb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
    [BatteryPackBottom.pcb, BatteryPackBottom.sch, BatteryPackFront.pcb, BatteryPackFront.sch, BatteryPackInsert.pcb, BatteryPackInsert.sch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]
2020-01-03 deleted: PowerGearV2/PCB/PowerModule.asc
2020-01-03 new file: 052357-9/Sim/MovementDet-FET.asc new file: 052357-9/Sim/MovementDet-Opamp.asc
2020-01-03 new file: Bridge/Mechanical/BR-HK01_v3-PCB.DXF new file: Bridge/Rev History.txt
    [BR-HK01_v3-PCB.DXF]
2020-01-16 deleted: 052357-9/Firmware/OutOfBox_MSP430FR2311/main.c new file: PowerGearV2/AutoConf.py modified: PowerGearV2/IIC_CMD.txt modified: PowerGearV2/PCB/BatteryPackBottom.pcb modified: PowerGearV2/PCB/B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
    [BatteryPackBottom.pcb, BatteryPackFront.pcb, BatteryPackTop.pcb, BatteryPackTop.sch]
2020-01-28 modified: PowerGearV2/AutoConf.py modified: PowerGearV2/IIC_CMD.txt modified: PowerGearV2/PCB/BatteryPackBottom.pcb modified: PowerGearV2/PCB/BatteryPackBottom.sch modified: PowerGearV2/PCB/BatteryPa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
    [BatteryPackBottom.pcb, BatteryPackBottom.sch, BatteryPackFront.pcb, BatteryPackFront.sch, BatteryPackTop.pcb, BatteryPackTop.sch]
2020-01-30 modified: PowerGearV2/PCB/BatteryPackBottom.pcb modified: PowerGearV2/PCB/BatteryPackBottom.sch modified: PowerGearV2/PCB/BatteryPackFront.sch modified: PowerGearV2/PCB/BatteryPackTop.sch
    [BatteryPackBottom.pcb, BatteryPackBottom.sch, BatteryPackFront.sch, BatteryPackTop.sch]
2020-02-04 modified: 052357-9/052357-9 Encoder.pcb modified: 052357-9/Sim/MovementDet-FET.asc deleted: Bridge/2019.8.23_Manufacture/CAM/BridgeMain_A.lst deleted: Bridge/2019.8.23_Manufacture/CAM/BridgeMain_A.re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
    [052357-9 Encoder.pcb, BatteryPackTop.sch, BridgeMainRev.B.sch, GearV2BottomRevA.sch, GearV2EncoderRevA.sch, GearV2MainRevA.sch, GearV2TopRevA.sch]
2020-02-07 modified: 052357-9/Sim/MovementDet-FET.asc modified: Bridge/BridgeMainRev.B.sch deleted: GearV2Main/PCB/From Marc.txt modified: GearV2Main/PCB/GearV2BottomRevA.sch modified: GearV2Main/PCB/GearV2Main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
    [BatteryPackBottom.sch, BatteryPackTop.sch, BridgeMainRev.B.sch, GearV2BottomRevA.sch, GearV2MainRevA.sch, GearV2TopRevA.sch]
2020-02-11 modified: 052357-9/Sim/MovementDet-FET.asc modified: GearV2Main/PCB/GearV2BottomRevA.sch modified: GearV2Main/PCB/GearV2MainRevA.sch modified: GearV2Main/PCB/GearV2TopRevA.sch modified: PowerGearV2/P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
    [BatteryPackBottom.pcb, BatteryPackBottom.sch, BatteryPackFront.pcb, BatteryPackFront.sch, BatteryPackInsert.pcb, BatteryPackTop.pcb, BatteryPackTop.sch, GearV2BottomRevA.sch]
2020-02-11 modified: Bridge/BridgeMainRev.B.sch deleted: GearV2Main/PCB/GearV2EncoderRevA.sch modified: GearV2Main/PCB/GearV2MainRevA.sch modified: GearV2Main/PCB/GearV2TopRevA.sch modified: PowerGearV2/PCB/Bat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
    [BatteryPackBottom.sch, BatteryPackFront.sch, BatteryPackTop.pcb, BatteryPackTop.sch, BridgeMainRev.B.sch, GearV2EncoderRevA.sch, GearV2MainRevA.sch, GearV2TopRevA.sch]
2020-02-12 modified: Bridge/BridgeMainRev.B.pcb modified: Bridge/BridgeMainRev.B.sch modified: Bridge/Rev History.txt modified: GearV2Main/PCB/GearV2BottomRevA.sch modified: GearV2Main/PCB/GearV2MainRevA.sch mo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
    [BatteryPackFront.sch, BatteryPackTop.sch, BridgeMainRev.B.pcb, BridgeMainRev.B.sch, GearV2BottomRevA.sch, GearV2MainRevA.sch, GearV2TopRevA.sch]
2020-02-19 modified: 052357-9/Sim/MovementDet-FET.asc modified: GearV2Main/PCB/GearV2BottomRevA.sch modified: GearV2Main/PCB/GearV2MainRevA.sch modified: GearV2Main/PCB/GearV2TopRevA.sch modified: PowerGearV2/P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
    [BatteryPackFront.pcb, BatteryPackFront.sch, BatteryPackTop.pcb, BatteryPackTop.sch, GearV2BottomRevA.sch, GearV2MainRevA.sch, GearV2TopRevA.sch]
2020-02-20 modified: 052357-9/052357-9 Encoder.sch new file: GearV2Main/PCB/GearV2BottomRevA.pcb modified: GearV2Main/PCB/GearV2BottomRevA.sch new file: GearV2Main/PCB/GearV2MainRevA.pcb modified: GearV2Main/PC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
    [052357-9 Encoder.sch, GearV2BottomRevA.pcb, GearV2BottomRevA.sch, GearV2MainRevA.pcb, GearV2MainRevA.sch, GearV2TopRevA.pcb, GearV2TopRevA.sch]
2020-02-25 modified: GearV2Main/PCB/GearV2BottomRevA.pcb modified: GearV2Main/PCB/GearV2BottomRevA.sch modified: GearV2Main/PCB/GearV2MainRevA.pcb modified: GearV2Main/PCB/GearV2MainRevA.sch modified: GearV2Mai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
    [BatteryPackTop.pcb, GearV2BottomRevA.pcb, GearV2BottomRevA.sch, GearV2MainRevA.pcb, GearV2MainRevA.sch, GearV2TopRevA.pcb, GearV2TopRevA.sch]
2020-02-28 modified: GearV2Main/PCB/GearV2BottomRevA.pcb modified: GearV2Main/PCB/GearV2BottomRevA.sch modified: GearV2Main/PCB/GearV2MainRevA.pcb modified: GearV2Main/PCB/GearV2MainRevA.sch modified: GearV2Mai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
    [BatteryPackFront.pcb, BatteryPackTop.pcb, GearV2BottomRevA.pcb, GearV2BottomRevA.sch, GearV2MainRevA.pcb, GearV2MainRevA.sch, GearV2TopRevA.pcb, GearV2TopRevA.sch]
2020-03-03 modified: GearV2Main/PCB/GearV2BottomRevA.pcb modified: GearV2Main/PCB/GearV2MainRevA.pcb modified: GearV2Main/PCB/GearV2MainRevA.sch modified: PowerGearV2/PCB/BatteryPackTop.pcb modified: PowerGearV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
    [BatteryPackTop.pcb, BatteryPackTop.sch, GearV2BottomRevA.pcb, GearV2MainRevA.pcb, GearV2MainRevA.sch]
2020-03-04 modified: GearV2Main/PCB/GearV2BottomRevA.pcb new file: GearV2Main/PCB/GearV2InsertRevA.pcb new file: GearV2Main/PCB/GearV2InsertRevA.sch new file: GearV2Main/PCB/GearV2Main340RevA.pcb renamed: GearV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
    [GearV2BottomRevA.pcb, GearV2InsertRevA.pcb, GearV2InsertRevA.sch, GearV2Main340RevA.pcb, GearV2Main340RevA.sch, GearV2MainRevA.pcb, GearV2MainRevA.sch, GearV2MainRevA_tmp.pcb]
2020-03-12 modified: Bridge/2019.8.23_Manufacture/BridgeMainRev.A.sch deleted: Bridge/2019.8.23_Manufacture/CAM/art002.pho deleted: Bridge/2019.8.23_Manufacture/CAM/default/BatteryPackTopRevA.f1 deleted: Bridge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
    [BatteryPackBottom.pcb, BatteryPackBottom.sch, BatteryPackFront.pcb, BatteryPackFront.sch, BatteryPackTop.pcb, BatteryPackTop.sch, BridgeMainRev.A.sch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]
2020-03-12 new file: GearV2Main/PCB/GearV2BottomRevA_PCB/BoardSpec.txt new file: GearV2Main/PCB/GearV2BottomRevA_PCB/GearV2BottomRevA.tgz new file: GearV2Main/PCB/GearV2InsertRevA_PCB/BoardSpec.txt new file: Ge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
2020-03-12 deleted: PowerGearV2/2019.12.03_Manufacture/Gerber_Bottom/BatteryPackBottomRev.A.f1 deleted: PowerGearV2/2019.12.03_Manufacture/Gerber_Bottom/BatteryPackBottomRev.A.f2 deleted: PowerGearV2/2019.12.03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
    [BatteryPackFrontRevA.drl, BatteryPackInsertRevA.drl, NC.drl]
2020-03-12 new file: PowerGearV2/PCB/BatteryPackFlxCab.pcb new file: PowerGearV2/PCB/BatteryPackFlxCab.sch new file: PowerGearV2/Sim/logic/indicator/LEDindicator_Rev.A.gp3 new file: PowerGearV2/Sim/logic/indica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
    [BatteryPackFlxCab.pcb, BatteryPackFlxCab.sch]
2020-03-12 new file: Bridge/2019.8.23_Manufacture/CAM/BridgeMainRev.A.tgz new file: Bridge/2019.8.23_Manufacture/CAM/BridgeMainRev.AGerber.zip new file: GearV2Main/PCB/GearV2MainRevA.sch
    [GearV2MainRevA.sch]
2020-03-12 new file: GearV2Main/PCB/GearV2MainRevA_PCB/BoardSpec.txt new file: GearV2Main/PCB/GearV2MainRevA_PCB/GearV2MainRevA.tgz
2020-03-12 new file: PowerGearV2/2020.03.11_QuotationFlexRegid/BatteryPackBottom.pcb new file: PowerGearV2/2020.03.11_QuotationFlexRegid/BatteryPackBottom.sch new file: PowerGearV2/2020.03.11_QuotationFlexRegid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
    [BatteryPackBottom.pcb, BatteryPackBottom.sch, BatteryPackFlxCab.pcb, BatteryPackFlxCab.sch, BatteryPackFront.pcb, BatteryPackFront.sch, BatteryPackInsert.pcb, BatteryPackInsert.sch]
2020-03-12 renamed: Bridge/2019.8.23_Manufacture/BillOfMaterials.rep -> BG-XX01/2019.8.23_Manufacture/BillOfMaterials.rep renamed: Bridge/2019.8.23_Manufacture/BillOfMaterials.xlsx -> BG-XX01/2019.8.23_Manufact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
    [052350-9R Axis Apollo Calculation.ods, 052350-9R Axis Apollo Controller.pcb, 052350-9R Axis Apollo Main Schematic.sch, 052355-9 Axis Apollo Proximity PCB.pcb, 052355-9 Axis Apollo Proximity PCB.sch, 052355-9G Axis Apollo Proximity PCB BOM.xlsx, 052357-9 Encoder.pcb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]
2020-03-12 deleted: GR-XX02/GearV2BatteryPack/AutoConf.py deleted: GR-XX02/GearV2BatteryPack/AutoConf1.py deleted: GR-XX02/GearV2BatteryPack/CalSheetGearV2.ods deleted: GR-XX02/GearV2BatteryPack/IIC_CMD.txt del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
    [CalSheetGearV2.ods, PowerCordCal.ods]
2020-03-12 new file: GR-XX02/GearV2BatteryPack/DesignDocs/CalSheetGearV2.ods new file: GR-XX02/GearV2BatteryPack/DesignDocs/PowerCordCal.ods new file: GR-XX02/GearV2BatteryPack/Logic/BACKUP/LEDindicator.gp3 new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
    [CalSheetGearV2.ods, PowerCordCal.ods]
2020-03-12 renamed: GR-XX02/GearV2BatteryPack/2020.03.11_QuotationFlexRegid/Gerber_FlxCab/BatteryPackFlxCabRevBGerber.zip -> GR-XX02/GearV2BatteryPack/2020.03.11_QuotationFlexRegid/Gerber_FlxCab/BatteryPackFlxC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
2020-03-12 renamed: GR-XX02/GearV2BatteryPack/2020.03.11_QuotationFlexRegid/BatteryPackBottom.pcb -> GR-XX02/GearV2BatteryPack/2020.03.11_QuotationFlexRegid/BatteryPackBottomRev.B.pcb renamed: GR-XX02/GearV2Bat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
    [BatteryPackBottomRev.B.pcb, BatteryPackBottomRev.B.sch, BatteryPackFlxCabRev.A.pcb, BatteryPackFlxCabRev.A.sch, BatteryPackFrontRev.B.pcb, BatteryPackFrontRev.B.sch, BatteryPackInsert.pcb, BatteryPackInsert.sch]
2020-03-12 deleted: GR-XX02/GearV2Main/PCB/UpdateToServer.bat
2020-03-12 renamed: GR-XX02/GearV2BatteryPack/2019.12.03_Manufacture/BatteryPackBottom.pcb -> GR-XX02/GearV2BatteryPack/2019.12.03_Manufacture/BatteryPackBottomRev.A.pcb renamed: GR-XX02/GearV2BatteryPack/2019.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
    [BatteryPackBottomRev.A.pcb, BatteryPackBottomRev.A.sch, BatteryPackFrontRev.A.pcb, BatteryPackFrontRev.A.sch, BatteryPackInsertRev.A.pcb, BatteryPackInsertRev.A.sch, BatteryPackTopRev.A.pcb, BatteryPackTopRev.A.sch]
2020-03-13 modified: GR-XX02/GearV2Main/PCB/GearV2BottomRevA.pcb modified: GR-XX02/GearV2Main/PCB/GearV2BottomRevA.sch modified: GR-XX02/GearV2Main/PCB/GearV2MainRevA.pcb modified: GR-XX02/GearV2Main/PCB/GearV2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
    [GearV2BottomRevA.pcb, GearV2BottomRevA.sch, GearV2MainRevA.pcb, GearV2MainRevA.sch]
2020-03-13 modified: GR-XX02/GearV2Main/PCB/GearV2MainRevA.pcb modified: GR-XX02/GearV2Main/PCB/GearV2MainRevA.sch
    [GearV2MainRevA.pcb, GearV2MainRevA.sch]
2020-03-16 modified: GR-XX02/GearV2Main/PCB/GearV2BottomRevA.pcb modified: GR-XX02/GearV2Main/PCB/GearV2MainRevA.pcb modified: GR-XX02/GearV2Main/PCB/GearV2MainRevA.sch
    [GearV2BottomRevA.pcb, GearV2MainRevA.pcb, GearV2MainRevA.sch]
2020-03-16 modified: GR-XX02/GearV2Main/PCB/GearV2BottomRevA.sch
    [GearV2BottomRevA.sch]
2020-03-16 modified: GR-XX02/GearV2Main/PCB/GearV2BottomRevA.pcb modified: GR-XX02/GearV2Main/PCB/GearV2MainRevA.pcb modified: GR-XX02/GearV2Main/PCB/GearV2TopRevA.pcb
    [GearV2BottomRevA.pcb, GearV2MainRevA.pcb, GearV2TopRevA.pcb]
2020-03-17 modified: GR-XX02/GearV2BatteryPack/PCB/BatteryPackBottom.pcb modified: GR-XX02/GearV2BatteryPack/PCB/BatteryPackFront.pcb modified: GR-XX02/GearV2BatteryPack/PCB/BatteryPackTop.pcb modified: GR-XX02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
    [BatteryPackBottom.pcb, BatteryPackFront.pcb, BatteryPackTop.pcb, BatteryPackTop.sch, GearV2BottomRevA.pcb, GearV2BottomRevA.sch, GearV2MainRevA.pcb, GearV2MainRevA.sch]
2020-03-18 modified: GearV2BottomRevA.pcb modified: GearV2BottomRevA.sch modified: GearV2BottomRevA_PCB/GearV2BottomRevA.tgz modified: GearV2MainRevA.pcb modified: GearV2MainRevA.sch modified: GearV2MainRevA_PC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
    [GearV2BottomRevA.pcb, GearV2BottomRevA.sch, GearV2MainRevA.pcb, GearV2MainRevA.sch]
2020-03-18 modified: GR-XX02/GearV2Main/PCB/GearV2BottomRevA.pcb modified: GR-XX02/GearV2Main/PCB/GearV2BottomRevA.sch modified: GR-XX02/GearV2Main/PCB/GearV2BottomRevA_PCB/GearV2BottomRevA.tgz modified: GR-XX0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
    [GearV2BottomRevA.pcb, GearV2BottomRevA.sch, GearV2MainRevA.pcb]
2020-03-18 modified: GR-XX02/GearV2Main/PCB/GearV2MainRevA.pcb modified: GR-XX02/GearV2Main/PCB/GearV2TopRevA.sch
    [GearV2MainRevA.pcb, GearV2TopRevA.sch]
2020-03-18 modified: GR-XX02/GearV2Main/PCB/GearV2MainRevA.pcb modified: GR-XX02/GearV2Main/PCB/GearV2MainRevA.sch modified: GR-XX02/GearV2Main/PCB/GearV2MainRevA_PCB/GearV2MainRevA.tgz
    [GearV2MainRevA.pcb, GearV2MainRevA.sch]
2020-03-19 modified: GR-XX02/GearV2Main/PCB/GearV2BottomRevA.pcb modified: GR-XX02/GearV2Main/PCB/GearV2BottomRevA.sch modified: GR-XX02/GearV2Main/PCB/GearV2BottomRevA_PCB/GearV2BottomRevA.tgz modified: GR-XX0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
    [GearV2BottomRevA.pcb, GearV2BottomRevA.sch, GearV2MainRevA.pcb, GearV2MainRevA.sch]
2020-03-19 new file: GR-XX02/GearV2Main/Sim/H-bridge.asc
2020-03-23 modified: GR-XX02/GearV2Main/PCB/GearV2BottomRevA.pcb modified: GR-XX02/GearV2Main/PCB/GearV2BottomRevA.sch modified: GR-XX02/GearV2Main/PCB/GearV2BottomRevA_PCB/GearV2BottomRevA.tgz modified: GR-XX0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
    [GearV2BottomRevA.pcb, GearV2BottomRevA.sch, GearV2MainRevA.sch]
2020-03-24 modified: GR-XX02/GearV2BatteryPack/PCB/BatteryPackBottom.pcb modified: GR-XX02/GearV2Main/PCB/GearV2BottomRevA.pcb modified: GR-XX02/GearV2Main/PCB/GearV2BottomRevA.sch modified: GR-XX02/GearV2Main/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
    [BatteryPackBottom.pcb, GearV2BottomRevA.pcb, GearV2BottomRevA.sch, GearV2MainRevA.pcb, GearV2MainRevA.sch]
2020-03-25 modified: GR-XX02/GearV2Main/PCB/GearV2MainRevA.sch modified: GR-XX02/GearV2Main/PCB/GearV2MainRevA_PCB/GearV2MainRevA.tgz
    [GearV2MainRevA.sch]
2020-03-25 modified: GR-XX02/GearV2Main/PCB/GearV2MainRevA.pcb
    [GearV2MainRevA.pcb]
2020-03-25 deleted: GR-XX02/GearV2BatteryPack/Mechanical/Battery Pack Front PCB #15.PDF modified: GR-XX02/GearV2BatteryPack/PCB/BatteryPackBottom.pcb modified: GR-XX02/GearV2BatteryPack/PCB/BatteryPackFront.pcb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
    [BatteryPackBottom.pcb, BatteryPackFront.pcb, BatteryPackTop.pcb]
2020-03-26 new file: GR-XX02/GearV2Main/2020.03.25_Rev.AManufacture/GearV2BottomRevA.pcb new file: GR-XX02/GearV2Main/2020.03.25_Rev.AManufacture/GearV2BottomRevA.sch new file: GR-XX02/GearV2Main/2020.03.25_Rev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
    [BillOfMaterials..xlsx, BillOfMaterials.csv, BillOfMaterials.xlsx, GearV2BottomRevA.pcb, GearV2BottomRevA.sch, GearV2InsertRevA.pcb, GearV2InsertRevA.sch, GearV2MainRevA.pcb]
2020-03-26 modified: GearV2BatteryPack/PCB/BatteryPackBottom.pcb modified: GearV2BatteryPack/PCB/BatteryPackBottom.sch modified: GearV2BatteryPack/PCB/BatteryPackFront.pcb modified: GearV2BatteryPack/PCB/Batter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
    [BatteryPackBottom.pcb, BatteryPackBottom.sch, BatteryPackFront.pcb, BatteryPackFront.sch, BatteryPackTop.pcb, BatteryPackTop.sch]
2020-03-26 modified: GearV2BatteryPack/PCB/BatteryPackBottom.pcb modified: GearV2BatteryPack/PCB/BatteryPackTop.pcb
    [BatteryPackBottom.pcb, BatteryPackTop.pcb]
2020-03-26 modified: GearV2BatteryPack/PCB/BatteryPackTop.pcb
    [BatteryPackTop.pcb]
2020-03-27 renamed: PCB/BatteryPackBottom.pcb -> PCB/BatteryPackBottomRev.B.pcb renamed: PCB/BatteryPackBottom.sch -> PCB/BatteryPackBottomRev.B.sch renamed: PCB/BatteryPackFront.pcb -> PCB/BatteryPackFrontRev.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
    [BatteryPackBottom.pcb, BatteryPackBottomRev.B.pcb, BatteryPackBottomRev.B.sch, BatteryPackFront.sch, BatteryPackFrontRev.B.pcb, BatteryPackFrontRev.B.sch, BatteryPackInsert.pcb, BatteryPackInsertRev.B.pcb]
2020-03-27 modified: ../Logic/LEDindicator_Rev.A.gp3 deleted: BatteryPackFlxCab.pcb deleted: BatteryPackFlxCab.sch modified: BatteryPackFrontRev.B.pcb modified: BatteryPackFrontRev.B.sch modified: BatteryPackIn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
    [BatteryPackFlxCab.pcb, BatteryPackFlxCab.sch, BatteryPackFrontRev.B.pcb, BatteryPackFrontRev.B.sch, BatteryPackInsertRev.B.pcb]
2020-03-27 new file: 2020.03.26_QuotationFlexRigid/BatteryPackBottomRev.B.pcb new file: 2020.03.26_QuotationFlexRigid/BatteryPackBottomRev.B.sch new file: 2020.03.26_QuotationFlexRigid/BatteryPackFlxCabRev.A.pc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
    [BatteryPackBottomRev.B.pcb, BatteryPackBottomRev.B.sch, BatteryPackFlxCabRev.A.pcb, BatteryPackFlxCabRev.A.sch, BatteryPackFrontRev.B.pcb, BatteryPackFrontRev.B.sch, BatteryPackInsertRev.B.pcb, BatteryPackInsertRev.B.sch]
2020-03-27 new file: Logic/LEDindicator_Rev.C.gp3
2020-03-27 modified: GR-XX02/GearV2BatteryPack/PCB/BatteryPackFrontRev.B.pcb modified: GR-XX02/GearV2BatteryPack/PCB/BatteryPackFrontRev.B.sch modified: GR-XX02/GearV2BatteryPack/PCB/BatteryPackInsertRev.B.pcb 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
    [BatteryPackFrontRev.B.pcb, BatteryPackFrontRev.B.sch, BatteryPackInsertRev.B.pcb, GearV2InsertRevA.sch, GearV2MainRevA.pcb, GearV2MainRevA.sch]
2020-03-30 modified: GR-XX02/GearV2BatteryPack/Logic/LEDindicator_Rev.C.gp3 modified: GR-XX02/GearV2BatteryPack/PCB/BatteryPackFrontRev.B.pcb modified: GR-XX02/GearV2BatteryPack/PCB/BatteryPackFrontRev.B.sch
    [BatteryPackFrontRev.B.pcb, BatteryPackFrontRev.B.sch]
2020-03-30 new file: BatteryPackFlxCabRev.A.pcb new file: BatteryPackFlxCabRev.A.sch
    [BatteryPackFlxCabRev.A.pcb, BatteryPackFlxCabRev.A.sch]
2020-04-06 modified: GearV2BatteryPack/Logic/LEDindicator_Rev.C.gp3 modified: GearV2BatteryPack/PCB/BatteryPackFrontRev.B.sch modified: GearV2BatteryPack/PCB/BatteryPackTopRev.B.sch modified: GearV2Main/2020.03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
    [BatteryPackFrontRev.B.sch, BatteryPackTopRev.B.sch]
2020-04-07 modified: BG-XX01/BridgeMainRev.B.pcb modified: BG-XX01/BridgeMainRev.B.sch modified: GR-XX02/GearV2Main/PCB/GearV2MainRevA.sch
    [BridgeMainRev.B.pcb, BridgeMainRev.B.sch, GearV2MainRevA.sch]
2020-04-09 modified: BG-XX01/BridgeMainRev.B.sch modified: GR-XX02/GearV2Main/2020.03.25_Rev.AManufacture/GearV2InsertRevA_PCB/GearV2InsertRevACam.zip
    [BridgeMainRev.B.sch]
2020-04-09 modified: GR-XX02/GearV2Main/2020.03.25_Rev.AManufacture/GearV2InsertRevA.pcb
    [GearV2InsertRevA.pcb]
2020-04-09 modified: GR-XX02/GearV2Main/PCB/GearV2BottomRevA.pcb modified: GR-XX02/GearV2Main/PCB/GearV2MainRevA.pcb
    [GearV2BottomRevA.pcb, GearV2MainRevA.pcb]
2020-04-09 new file: GR-XX02/GearV2Main/2020.03.25_Rev.AManufacture/GearV2BottomRevA_PCB/GearV2BottomRevACam.zip new file: GR-XX02/GearV2Main/2020.03.25_Rev.AManufacture/GearV2MainRevA_PCB/GearV2MainRevACam.zip
2020-04-14 modified: BG-XX01/BridgeMainRev.B.pcb modified: BG-XX01/BridgeMainRev.B.sch modified: BG-XX01/Rev History.txt
    [BridgeMainRev.B.pcb, BridgeMainRev.B.sch]
2020-04-16 modified: BG-XX01/BridgeMainRev.B.pcb modified: BG-XX01/BridgeMainRev.B.sch modified: GR-XX02/GearV2BatteryPack/PCB/BatteryPackTopRev.B.sch
    [BatteryPackTopRev.B.sch, BridgeMainRev.B.pcb, BridgeMainRev.B.sch]
2020-04-22 modified: BG-XX01/BridgeMainRev.B.pcb modified: BG-XX01/BridgeMainRev.B.sch deleted: BG-XX01/Rev History.txt deleted: GR-XX02/GearV2BatteryPack/PCB/RevHistory.txt
    [BridgeMainRev.B.pcb, BridgeMainRev.B.sch]
2020-04-22 modified: BG-XX01/BridgeMainRev.B.pcb modified: BG-XX01/BridgeMainRev.B.sch
    [BridgeMainRev.B.pcb, BridgeMainRev.B.sch]
2020-04-27 modified: BG-XX01/BridgeMainRev.B.pcb modified: BG-XX01/BridgeMainRev.B.sch modified: GR-XX02/GearV2BatteryPack/PCB/BatteryPackTopRev.B.pcb modified: GR-XX02/GearV2BatteryPack/PCB/BatteryPackTopRev.B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
    [BatteryPackTopRev.B.pcb, BatteryPackTopRev.B.sch, BridgeMainRev.B.pcb, BridgeMainRev.B.sch]
2020-04-28 modified: BG-XX01/BridgeMainRev.B.pcb
    [BridgeMainRev.B.pcb]
2020-05-07 renamed: GR-XX02/GearV2BatteryPack/2020.03.26_QuotationFlexRigid/BatteryPackBottomRev.B.pcb -> GR-XX02/GearV2BatteryPack/2020.03.26_Manufacture/BatteryPackBottomRev.B.pcb renamed: GR-XX02/GearV2Batte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
    [BatteryPackBottomRev.B.pcb, BatteryPackBottomRev.B.sch, BatteryPackFlxCabRev.A.pcb, BatteryPackFlxCabRev.A.sch, BatteryPackFrontRev.B.pcb, BatteryPackFrontRev.B.sch, BatteryPackInsertRev.B.pcb, BatteryPackInsertRev.B.sch]
2020-05-07 new file: BG-XX01/2019.8.23_Manufacture/Issues.txt new file: GR-XX02/GearV2BatteryPack/2019.12.03_Manufacture/Issues.txt modified: GR-XX02/GearV2BatteryPack/PCB/BatteryPackRev.C.sch new file: GR-XX02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
    [BatteryPackRev.C.sch]
2020-05-07 deleted: GR-XX02/GearV2Main/PCB/GearV2BottomRevA_PCB/BoardSpec.txt deleted: GR-XX02/GearV2Main/PCB/GearV2BottomRevA_PCB/GearV2BottomRevA.tgz deleted: GR-XX02/GearV2Main/PCB/GearV2InsertRevA_PCB/Board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
2020-05-08 modified: GR-XX02/GearV2BatteryPack/PCB/BatteryPackRev.C.pcb modified: GR-XX02/GearV2BatteryPack/PCB/BatteryPackRev.C.sch modified: GR-XX02/GearV2BatteryPack/PCB/BatteryPackTopRev.B.pcb
    [BatteryPackRev.C.pcb, BatteryPackRev.C.sch, BatteryPackTopRev.B.pcb]
2020-05-11 modified: GR-XX02/GearV2BatteryPack/PCB/BatteryPackRev.C.pcb modified: GR-XX02/GearV2BatteryPack/PCB/BatteryPackRev.C.sch
    [BatteryPackRev.C.pcb, BatteryPackRev.C.sch]
2020-05-12 new file: GR-XX02/GearV2BatteryPack/2020.05_Manufacture/BatteryPackRev.C.Cam/BatteryPackRev.C.drl new file: GR-XX02/GearV2BatteryPack/2020.05_Manufacture/BatteryPackRev.C.Cam/BatteryPackRev.C.f1 new 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
    [BatteryPackRev.C.pcb, BatteryPackRev.C.sch, BillOfMaterials..xlsx, BillOfMaterials.csv, BillOfMaterials.xlsx, GearV2BottomRevA.pcb, GearV2BottomRevA.sch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]
2020-05-12 deleted: GR-XX02/GearV2BatteryPack/2020.05_Manufacture/BoardSpec.txt deleted: GR-XX02/GearV2Main/2020.05.12_Rev.AReManufacture/GearV2InsertRevA.pcb deleted: GR-XX02/GearV2Main/2020.05.12_Rev.AReManuf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
    [BillOfMaterials.csv, BillOfMaterials.xlsx, GearV2InsertRevA.pcb, GearV2InsertRevA.sch, GearV2MainRevA.pcb, GearV2MainRevA.sch, GearV2TopRevA.pcb, GearV2TopRevA.sch]
2020-05-12 modified: 2020.05_Manufacture/BatteryPackRev.C.Cam/BoardSpec.txt modified: PCB/BatteryPackInsertRev.B.pcb modified: PCB/BatteryPackRev.C.pcb modified: PCB/BatteryPackRev.C.sch
    [BatteryPackInsertRev.B.pcb, BatteryPackRev.C.pcb, BatteryPackRev.C.sch]
2020-05-12 new file: GR-XX02/GearV2BatteryPack/2020.05_Manufacture/BatteryPackRev.C.Cam/BatteryPackRev.C.a1 new file: GR-XX02/GearV2BatteryPack/2020.05_Manufacture/BatteryPackRev.C.Cam/BatteryPackRev.C.a2 modif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
    [10118194-0001LF--3DModel-STEP-56544.STEP, 15-21.STEP, 5025840270.stp, 877590614.stp, BatteryPackRev.C.pcb, BatteryPackRev.C.sch, LTST-C191TBKT-5A--3DModel-STEP-56544.STEP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]
2020-05-15 renamed: GR-XX02/GearV2BatteryPack/2020.05_Manufacture/BatteryPackRev.C.pdf -> GR-XX02/GearV2BatteryPack/2020.05_Manufacture/BatteryPackRev.C.Asm.pdf new file: GR-XX02/GearV2BatteryPack/2020.05_Manuf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
    [BatteryPackRev.C.pcb, BatteryPackRev.C.sch, thickCord-A-02.csv, thinCord-A-01.csv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]
2020-05-19 modified: GearV2Main/CordDet/CordDet.py
2020-05-20 new file: GearV2BatteryPack/2020.05.20_Manufacture/AdapterInsertRev.A.pcb new file: GearV2BatteryPack/2020.05.20_Manufacture/AdapterInsertRev.A.sch new file: GearV2BatteryPack/2020.05.20_Manufacture/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
    [AdapterInsertRev.A.pcb, AdapterInsertRev.A.sch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]
2020-05-21 new file: BG-XX01/2020.05.21Manufacture/BillOfMaterials.xlsx new file: BG-XX01/2020.05.21Manufacture/BridgeMainRev.B.pcb new file: BG-XX01/2020.05.21Manufacture/BridgeMainRev.B.sch new file: BG-XX01/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
    [10118194-0001LF--3DModel-STEP-56544.STEP, 15-21.STEP, BillOfMaterials.xlsx, BridgeMainRev.B.pcb, BridgeMainRev.B.sch, LTST-C191TBKT-5A--3DModel-STEP-56544.STEP, RB1-125BAG1A--3DModel-STEP-56544.STEP, USB-A1SSW6--3DModel-STEP-56544.STEP]
2020-05-21 modified: BG-XX01/2020.05.21Manufacture/BillOfMaterials.xlsx modified: BG-XX01/2020.05.21Manufacture/BridgeMainRev.B.pcb
    [BillOfMaterials.xlsx, BridgeMainRev.B.pcb]
2020-05-26 modified: GR-XX02/GearV2Main/CordDet/CordDet.py
2020-05-27 deleted: BG-XX01/2020.05.21Manufacture/BillOfMaterials.xlsx modified: BG-XX01/2020.05.21Manufacture/BridgeMainRev.B.pcb modified: BG-XX01/2020.05.21Manufacture/BridgeMainRev.B.sch
    [BillOfMaterials.xlsx, BridgeMainRev.B.pcb, BridgeMainRev.B.sch]
2020-05-28 modified: BridgeMainRev.B.pcb
    [BridgeMainRev.B.pcb]
2020-05-28 modified: BridgeMainRev.B.sch
    [BridgeMainRev.B.sch]
2020-05-29 modified: GR-XX02/GearV2BatteryPack/2020.05_Manufacture/BatteryPackRev.C.pcb modified: GR-XX02/GearV2BatteryPack/2020.05_Manufacture/BatteryPackRev.C.sch
    [BatteryPackRev.C.pcb, BatteryPackRev.C.sch]
2020-05-29 modified: GR-XX02/GearV2BatteryPack/2020.05_Manufacture/BatteryPackRev.C.Sch.pdf modified: GR-XX02/GearV2BatteryPack/2020.05_Manufacture/BatteryPackRev.C.sch
    [BatteryPackRev.C.sch]
2020-06-01 renamed: GR-XX02/GearV2Main/PCB/GearV2BottomRevA.pcb -> GR-XX02/GearV2Main/PCB/GearV2BottomBrushedRevA.pcb renamed: GR-XX02/GearV2Main/PCB/GearV2BottomRevA.sch -> GR-XX02/GearV2Main/PCB/GearV2BottomB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
    [GearV2BottomBrushedRevA.pcb, GearV2BottomBrushedRevA.sch, GearV2BottomBrushlessRevA.pcb, GearV2BottomBrushlessRevA.sch]
2020-06-02 new file: GR-XX02/GearV2Main/2020.06_Rev.AManufacture/GearV2BottomBrushlessRevA.pcb new file: GR-XX02/GearV2Main/2020.06_Rev.AManufacture/GearV2BottomBrushlessRevA.sch new file: GR-XX02/GearV2Main/20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
    [GearV2BottomBrushlessRevA.pcb, GearV2BottomBrushlessRevA.sch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]
2020-06-02 modified: 2020.06_Rev.AManufacture/GearV2BottomBrushlessRevA.pcb modified: 2020.06_Rev.AManufacture/GearV2BottomBrushlessRevA.sch new file: 2020.06_Rev.AManufacture/GearV2BottomBrushlessRevACam.zip m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
    [GearV2BottomBrushlessRevA.pcb, GearV2BottomBrushlessRevA.sch]
2020-06-02 modified: GR-XX02/GearV2Main/2020.06_Rev.AManufacture/GearV2BottomBrushlessRevA.sch deleted: GR-XX02/GearV2Main/2020.06_Rev.AManufacture/GearV2BottomBrushlessRevACam/BoardSpec.txt deleted: GR-XX02/Ge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
    [GearV2BottomBrushlessRevA.sch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]
2020-06-03 modified: GR-XX02/GearV2Main/2020.05.12_Rev.AReManufacture/Issues.txt modified: GR-XX02/GearV2Main/2020.06_Rev.AManufacture/GearV2BottomBrushlessRevA.pcb
    [GearV2BottomBrushlessRevA.pcb]
2020-06-03 modified: GearV2BottomBrushlessRevACam.zip
2020-06-15 deleted: BG-XX01/2019.8.23_Manufacture/BillOfMaterials.rep deleted: BG-XX01/2019.8.23_Manufacture/BillOfMaterials.xlsx deleted: BG-XX01/2019.8.23_Manufacture/BridgeMain_A.F5 deleted: BG-XX01/2019.8.2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
    [10118194-0001LF--3DModel-STEP-56544.STEP, 15-21.STEP, BatteryPackInsertRev.B.pcb, BatteryPackRev.C.pcb, BatteryPackRev.C.sch, BillOfMaterials.xlsx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]
2020-06-16 deleted: GR-XX02/GearV2BatteryPack/2020.05.20_Manufacture/AdapterInsertRev.ACam/AdapterInsertRev.A.drl deleted: GR-XX02/GearV2BatteryPack/2020.05.20_Manufacture/AdapterInsertRev.ACam/AdapterInsertRev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
    [AdapterInsertRev.A.pcb, AdapterInsertRev.A.sch, BatteryPackInsertRev.B.pcb, BatteryPackInsertRev.B.sch, BatteryPackRev.C.pcb, BatteryPackRev.C.sch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]
2020-06-19 deleted: BG-XX01/2020.05.21Manufacture/BridgeMainRev.B_ASM.pdf deleted: BG-XX01/2020.05.21Manufacture/BridgeMainRev.B_SCH.pdf deleted: BG-XX01/2020.05.21Manufacture/BridgeMainRev.B_SI.pdf deleted: GR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
    [BatteryPackBottomRev.B.pcb, BatteryPackBottomRev.B.sch, BatteryPackFlxCabRev.A.pcb, BatteryPackFlxCabRev.A.sch, BatteryPackFrontRev.B.pcb, BatteryPackFrontRev.B.sch, BatteryPackRev.C.pcb, BatteryPackRev.C.sch]
2020-06-19 deleted: GR-XX02/GearV2BatteryPack/2020.06_Manufacture/BatteryPackRev.C.Asm.pdf deleted: GR-XX02/GearV2BatteryPack/2020.06_Manufacture/BatteryPackRev.C.Cam.zip deleted: GR-XX02/GearV2BatteryPack/2020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
2020-08-18 modified: GR-XX02/GearV2BatteryPack/2020.03.26_Manufacture/RevHistory.txt modified: GR-XX02/GearV2BatteryPack/2020.06_Manufacture/BatteryPackRev.C.pcb modified: GR-XX02/GearV2BatteryPack/2020.06_Manu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
    [BatteryPackRev.C.pcb, BatteryPackRev.C.sch, BatteryPackRev.D.sch, CalSheetGearV2.ods]
2020-08-18 new file: GR-XX02/GearV2BatteryPack/Mechanical/Battery Pack Front PCB #16.pdf new file: GR-XX02/GearV2BatteryPack/Mechanical/Connector preliminary model Drawing v1.pdf new file: GR-XX02/GearV2Battery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
    [GearV2BottomBrushedRevB.pcb, GearV2BottomBrushedRevB.sch, GearV2BottomBrushlessRevB.pcb, GearV2BottomBrushlessRevB.sch, GearV2MainRevB.pcb, GearV2MainRevB.sch]
2020-08-18 new file: BG-XX01/Mechanical/BR-0101-PCB-PA (1).pdf new file: BG-XX01/Mechanical/BR-0101-PCB-PA Rev3.pdf new file: BG-XX01/Mechanical/BR-0101-PCB-PA.pdf new file: BG-XX01/Mechanical/MechanicalLib/101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
    [10118194-0001LF--3DModel-STEP-56544.STEP, 15-21.STEP, LTST-C191TBKT-5A--3DModel-STEP-56544.STEP, RB1-125BAG1A--3DModel-STEP-56544.STEP, USB-A1SSW6--3DModel-STEP-56544.STEP, c-1825027-8-g-3d.step]
2020-08-18 new file: GR-XX02/GearV2BatteryPack/Logic/Verilog/LEDindicator_Rev.A.gp3 new file: GR-XX02/GearV2BatteryPack/Logic/Verilog/LEDindicator_Rev.B.gp3 new file: GR-XX02/GearV2Main/CordDet/OrgData/thickCor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
    [thickCord-A-04.csv, thickCord-C-05.csv, thickCord-C-06.csv, thickCord-C-15.csv, thickCord-C-17_3MFoilTape.csv, thinCord-A-03.csv, thinCord-C-13.csv, thinCord-C-14.csv]
2020-08-18 deleted: GR-XX02/GearV2BatteryPack/PCB/AdapterInsertRev.A.pcb deleted: GR-XX02/GearV2BatteryPack/PCB/AdapterInsertRev.A.sch deleted: GR-XX02/GearV2BatteryPack/PCB/BatteryPackBottomRev.B.pcb deleted: 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
    [AdapterInsertRev.A.pcb, AdapterInsertRev.A.sch, BatteryPackBottomRev.B.pcb, BatteryPackBottomRev.B.sch, BatteryPackFrontRev.B.pcb, BatteryPackFrontRev.B.sch, BatteryPackInsertRev.B.pcb, BatteryPackInsertRev.B.sch]
2020-08-18 new file: GR-XX02/GearV2BatteryPack/2020.06.16_Manufacture/Issues.txt new file: GR-XX02/GearV2Main/Sim/MovementDet-FET.asc
2020-08-18 deleted: BG-XX01/BridgeMainRev.B.pcb deleted: BG-XX01/BridgeMainRev.B.sch modified: GR-XX02/GearV2BatteryPack/2020.06_Manufacture/BatteryPackRev.C.sch deleted: GR-XX02/GearV2Main/PCB/GearV2BottomBrus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
    [BatteryPackRev.C.sch, BridgeMainRev.B.pcb, BridgeMainRev.B.sch, GearV2BottomBrushedRevA.pcb, GearV2BottomBrushedRevA.sch, GearV2BottomBrushlessRevA.pcb, GearV2BottomBrushlessRevA.sch, GearV2InsertRevA.pcb]
2020-08-19 deleted: BG-XX01/2019.8.23_Manufacture/BridgeMainRev.AIssues.txt deleted: GR-XX02/GearV2BatteryPack/2019.12.03_Manufacture/Issues.txt deleted: GR-XX02/GearV2BatteryPack/2020.03.26_Manufacture/RevHist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
    [BatteryPackRev.D.sch]
2020-08-19 new file: GR-XX02/GearV2BatteryPack/2020.08_Manufacture/BatteryPackRev.D.pcb
    [BatteryPackRev.D.pcb]
2020-08-19 modified: BatteryPackRev.D.pcb modified: BatteryPackRev.D.sch
    [BatteryPackRev.D.pcb, BatteryPackRev.D.sch]
2020-09-01 modified: GR-XX02/GearV2BatteryPack/2020.08_Manufacture/BatteryPackRev.D.pcb modified: GR-XX02/GearV2BatteryPack/2020.08_Manufacture/BatteryPackRev.D.sch modified: GR-XX02/GearV2BatteryPack/TestingSc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
    [BatteryPackRev.D.pcb, BatteryPackRev.D.sch]
2020-09-02 new file: BG-XX01/HardwareTestOfRev.B.zip modified: GR-XX02/GearV2BatteryPack/2020.08_Manufacture/BatteryPackRev.D.pcb modified: GR-XX02/GearV2BatteryPack/2020.08_Manufacture/BatteryPackRev.D.sch
    [BatteryPackRev.D.pcb, BatteryPackRev.D.sch]
2020-09-24 modified: BG-XX01/2020.05.21Manufacture/BridgeMainRev.B.pcb modified: BG-XX01/2020.05.21Manufacture/BridgeMainRev.B.sch deleted: BG-XX01/HardwareTestOfRev.B.zip modified: GR-XX02/GearV2BatteryPack/20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
    [BatteryPackRev.D.pcb, BatteryPackRev.D.sch, BridgeMainRev.B.pcb, BridgeMainRev.B.sch, GearV2MainRevB.pcb, GearV2MainRevB.sch]
2020-09-24 modified: BG-XX01/2020.05.21Manufacture/BridgeMainRev.B.pcb
    [BridgeMainRev.B.pcb]
2020-09-24 modified: GR-XX02/GearV2BatteryPack/2020.08_Manufacture/BatteryPackRev.D.pcb modified: GR-XX02/GearV2BatteryPack/2020.08_Manufacture/BatteryPackRev.D.sch
    [BatteryPackRev.D.pcb, BatteryPackRev.D.sch]
2020-09-30 modified: GR-XX02/GearV2BatteryPack/2020.08_Manufacture/BatteryPackRev.D.pcb modified: GR-XX02/GearV2BatteryPack/2020.08_Manufacture/BatteryPackRev.D.sch deleted: GR-XX02/GearV2BatteryPack/Mechanical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
    [BatteryPackRev.D.pcb, BatteryPackRev.D.sch, GearV2MainRevB.pcb, GearV2MainRevB.sch]
2020-09-30 new file: GR-XX02/GearV2BatteryPack/Mechanical/MechanicalLib/LTST-S326KGJRKT--3DModel-STEP-56544.STEP new file: GR-XX02/GearV2BatteryPack/Mechanical/PCB-000022 Rev B (Adapter PCB Insert).pdf new file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
    [LTST-S326KGJRKT--3DModel-STEP-56544.STEP]
2020-09-30 new file: BG-XX01/Mechanical/BR-0101-PCB-PA Rev4.PDF new file: GR-XX02/GearV2BatteryPack/2020.08_Manufacture/AdapterInsertRev.B.pcb new file: GR-XX02/GearV2BatteryPack/2020.08_Manufacture/AdapterInse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
    [AdapterInsertRev.B.pcb, AdapterInsertRev.B.sch, SimplifiedBatteryPackInsertRev.C.pcb, SimplifiedBatteryPackInsertRev.C.sch]
2020-10-09 deleted: BG-XX01/Mechanical/BR-0101-PCB-PA (1).pdf deleted: BG-XX01/Mechanical/BR-0101-PCB-PA Rev3.pdf deleted: BG-XX01/Mechanical/BR-0101-PCB-PA.pdf deleted: BG-XX01/Mechanical/BR-HK01_v3-PCB.DXF de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
    [AdapterInsertRev.B.pcb, AdapterInsertRev.B.sch, BR-HK01_v3-PCB.DXF, BatteryPackRev.D.pcb, BatteryPackRev.D.sch, GearV2BottomBrushedRevB.pcb, GearV2BottomBrushedRevB.sch, GearV2BottomBrushlessRevB.pcb]
2020-10-21 new file: GR-XX02/GearV2Main/Mechanical/PCB-000007 REv B 2 (Bottom PCB Board).pdf new file: GR-XX02/GearV2Main/Mechanical/PCB-000007 Rev B (Bottom PCB Board).pdf
2020-10-27 new file: BG-XX01/2020.05.21Manufacture/Firmware/Bridge_FCCTest.zip new file: BG-XX01/2020.05.21Manufacture/Firmware/UartEcho&LEDTestOfBLE.Rev.B.zip new file: BG-XX01/2020.10.19Manufacture/BridgeMain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
    [BR-HK01_v3-PCB.DXF, BridgeMainRev.C.pcb, BridgeMainRev.C.sch, LTST-S270TBKT.STEP]
2020-10-27 new file: GR-XX02/GearV2Main/2020.10_Rev.BManufacture/GearV2BottomBrushedRevB.pcb new file: GR-XX02/GearV2Main/2020.10_Rev.BManufacture/GearV2BottomBrushedRevB.sch new file: GR-XX02/GearV2Main/2020.1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
    [GearV2BottomBrushedRevB.pcb, GearV2BottomBrushedRevB.sch, GearV2BottomBrushlessRevB.pcb, GearV2BottomBrushlessRevB.sch, GearV2MainRevB.pcb, GearV2MainRevB.sch]
2020-12-09 modified: BG-XX01/2020.10.19Manufacture/BridgeMainRev.C.sch deleted: GR-XX02/GearV2BatteryPack/Mechanical/PCB-0000XX Rev 01 (Pouch BP Front PCB).pdf modified: GR-XX02/GearV2Main/2020.10_Rev.BManufact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
    [BridgeMainRev.C.sch, GearV2BottomBrushlessRevB.pcb, GearV2BottomBrushlessRevB.sch, GearV2MainRevB.pcb, GearV2MainRevB.sch]
2020-12-17 new file: GR-XX02/GearV2BatteryPack/2020.12_Manufacture/GB0102RevB.pcb new file: GR-XX02/GearV2BatteryPack/2020.12_Manufacture/GB0102RevB.sch
    [GB0102RevB.pcb, GB0102RevB.sch]
2020-12-17 new file: GR-XX02/GearV2BatteryPack/Mechanical/PCB-GB-0102 Rev E (Pouch BP Front PCB).pdf new file: GR-XX02/Shield/BatteryPackRevDShield.DWG new file: GR-XX02/Shield/BatteryPackRevDShield.STEP new fi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
    [BatteryPackRevDShield.DWG, BatteryPackRevDShield.STEP, GearV2MainRevBShield.DWG, GearV2MainRevBShield.STEP]
2020-12-17 deleted: BG-XX01/Mechanical/BR-0101-PCB-PA Rev4.PDF deleted: BG-XX01/Mechanical/MechanicalLib/10118194-0001LF--3DModel-STEP-56544.STEP deleted: BG-XX01/Mechanical/MechanicalLib/15-21.STEP deleted: BG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
    [10118194-0001LF--3DModel-STEP-56544.STEP, 15-21.STEP, BR-HK01_v3-PCB.DXF, LTST-C191TBKT-5A--3DModel-STEP-56544.STEP, LTST-S270TBKT.STEP, RB1-125BAG1A--3DModel-STEP-56544.STEP, USB-A1SSW6--3DModel-STEP-56544.STEP, c-1825027-8-g-3d.step]
2020-12-17 new file: BG-XX01/Drawing/BR-0101-PCB-PA Rev4.PDF new file: BG-XX01/Drawing/backup/BR-0101-PCB-PA (1).pdf new file: BG-XX01/Drawing/backup/BR-0101-PCB-PA Rev3.pdf new file: BG-XX01/Drawing/backup/BR-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
    [10147606-4p.igs, 15-21.STEP, 5025840270.stp, 76341-305LF.stp, 877590614.stp, 9774010243R (rev1).stp, BM04B-PASS-1-TFT(LF)(SN).STEP, BMD-340-A-R.STEP]
2020-12-17 new file: BG-XX01/2020.12Manufacture/BridgeMainRev.C.sch new file: GR-XX02/GearV2Main/2020.12_Rev.BManufacture/GearV2BottomBrushlessRevB.pcb new file: GR-XX02/GearV2Main/2020.12_Rev.BManufacture/Gear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
    [BridgeMainRev.C.sch, GearV2BottomBrushlessRevB.pcb, GearV2BottomBrushlessRevB.sch, GearV2MainRevB.pcb, GearV2MainRevB.sch]
2020-12-17 new file: GR-XX02/GearV2BatteryPack/2020.08_Manufacture/AdapterInsertRev.B.pcb new file: GR-XX02/GearV2BatteryPack/2020.08_Manufacture/AdapterInsertRev.B.sch new file: GR-XX02/GearV2BatteryPack/2020.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
    [AdapterInsertRev.B.pcb, AdapterInsertRev.B.sch, BatteryPackRev.D.pcb, BatteryPackRev.D.sch, SimplifiedBatteryPackInsertRev.C.pcb, SimplifiedBatteryPackInsertRev.C.sch]
2020-12-17 new file: Lib.sch
    [Lib.sch]
2020-12-17 new file: BridgeFCCTest.zip new file: Bridge_UartEco&LED.zip
2020-12-18 modified: GR-XX02/GearV2BatteryPack/2020.12_Manufacture/GB0102RevB.pcb modified: GR-XX02/GearV2BatteryPack/2020.12_Manufacture/GB0102RevB.sch renamed: GR-XX02/Shield/BatteryPackRevDShield.DWG -> GR-X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
    [BatteryPackRevDShield.DWG, BatteryPackRevDShield.STEP, GB0102RevB.pcb, GB0102RevB.sch, GearV2BottomBrushlessRevB.pcb, GearV2BottomBrushlessRevB.sch, GearV2MainRevBShield.DWG, GearV2MainRevBShield.STEP]
2020-12-18 deleted: GR-XX02/GearV2BatteryPack/Mechanical/BatteryPackRevDShield/BatteryPackRevDShield.DWG deleted: GR-XX02/GearV2BatteryPack/Mechanical/BatteryPackRevDShield/BatteryPackRevDShield.STEP deleted: G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
    [10118194-0001LF--3DModel-STEP-56544.STEP, 15-21.STEP, 5025840270.stp, 877590614.stp, BatteryPackRevDShield.DWG, BatteryPackRevDShield.STEP, GearV2MainRevBShield.DWG, GearV2MainRevBShield.STEP]
2020-12-18 new file: GR-XX02/GearV2BatteryPack/Drawing/BatteryPackRevDShield/BatteryPackRevDShield.DWG new file: GR-XX02/GearV2BatteryPack/Drawing/BatteryPackRevDShield/BatteryPackRevDShield.STEP new file: GR-X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
    [10147606-4p.igs, 9774010243R (rev1).stp, BM04B-PASS-1-TFT(LF)(SN).STEP, BMD-340-A-R--3DModel-STEP-56544.STEP, BUT-000003 Rev 01 (Interface Button).STEP, BatteryPackRevDShield.DWG, BatteryPackRevDShield.STEP, C0603_090.step]
2020-12-18 new file: CADModels/Connectors/CONN10_2x05_DRXN_SUL.step new file: GR-XX02/GearV2BatteryPack/2020.12_Manufacture/issue.txt
    [CONN10_2x05_DRXN_SUL.step]
2020-12-18 new file: CADModels/FET&Diode/SOD-123F.step
    [SOD-123F.step]
2021-01-20 modified: GR-XX02/GearV2BatteryPack/2020.12_Manufacture/GB0102RevB.pcb modified: GR-XX02/GearV2BatteryPack/2020.12_Manufacture/GB0102RevB.sch modified: GR-XX02/GearV2BatteryPack/2020.12_Manufacture/i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
    [GB0102RevB.pcb, GB0102RevB.sch, GearV2BottomBrushlessRevB.pcb, GearV2BottomBrushlessRevB.sch]
2021-01-20 new file: GR-XX02/GearV2BatteryPack/20200908_HOWELL 3x113647-2200mAh+NTC only _ Specification.pdf new file: GR-XX02/GearV2BatteryPack/UL2054.pdf new file: GR-XX02/GearV2BatteryPack/UL2595.pdf new fil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
    [GearV2PullyARevA.pcb, GearV2PullyBRevA.pcb, GearV2PullyBRevA_TMP.pcb]
2021-02-04 deleted: BG-XX01/2019.8.23_Manufacture/BridgeMainRev.A.pcb deleted: BG-XX01/2019.8.23_Manufacture/BridgeMainRev.A.sch deleted: BG-XX01/2020.12Manufacture/BridgeMainRev.C.sch deleted: BG-XX01/Drawing/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
    [10147606-4p.igs, 9774010243R (rev1).stp, BM04B-PASS-1-TFT(LF)(SN).STEP, BMD-340-A-R--3DModel-STEP-56544.STEP, BR-HK01_v3-PCB.DXF, BUT-000003 Rev 01 (Interface Button).STEP, BridgeMainRev.A.pcb, BridgeMainRev.A.sch]
2021-02-04 new file: BG-XX01/2019.08.23Manufacture/BridgeMainRev.A.pcb new file: BG-XX01/2019.08.23Manufacture/BridgeMainRev.A.sch new file: BG-XX01/2021.01PilotProduction/BridgeMainRev.C.sch deleted: GR-XX02/G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
    [BridgeMainRev.A.pcb, BridgeMainRev.A.sch, BridgeMainRev.C.sch, FuseProtectionRevA.sch, GearV2BottomBrushedRevB.pcb, GearV2BottomBrushedRevB.sch, GearV2BottomBrushlessRevB.pcb, GearV2BottomBrushlessRevB.sch]
2021-02-04 deleted: GR-XX02/GearV2BatteryPack/2020.12_Manufacture/GB0102RevB_back.pcb deleted: GR-XX02/GearV2BatteryPack/2020.12_Manufacture/GB0102RevB_back.sch deleted: GR-XX02/GearV2BatteryPack/2020.12_Manufa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
    [GB0102RevB_back.pcb, GB0102RevB_back.sch, GB0102RevB_back12.pcb, GB0102RevB_back12.sch]
2021-02-04 new file: CADModels/Connectors/mill-max-854-22-003-40-001101.STEP
    [mill-max-854-22-003-40-001101.STEP]
2021-02-04 deleted: GR-XX02/GearV2BatteryPack/2020.06_Manufacture/BatteryPackRev.C.pcb deleted: GR-XX02/GearV2BatteryPack/2020.06_Manufacture/BatteryPackRev.C.sch deleted: GR-XX02/GearV2BatteryPack/2020.08_Manu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
    [AdapterInsertRev.B.pcb, AdapterInsertRev.B.sch, BatteryPackRev.C.pcb, BatteryPackRev.C.sch, BatteryPackRev.D.pcb, BatteryPackRev.D.sch, SimplifiedBatteryPackInsertRev.C.pcb, SimplifiedBatteryPackInsertRev.C.sch]
2021-02-04 deleted: GR-XX02/GearV2Main/2021.01_Rev.BManufacture/GearV2PullyBRevA_TMP.pcb deleted: GR-XX02/GearV2Main/CordDet/CordDet.py deleted: GR-XX02/GearV2Main/CordDet/OrgData/thickCord-A-02.csv deleted: GR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
    [GearV2PullyBRevA_TMP.pcb, thickCord-A-02.csv, thickCord-A-04.csv, thickCord-C-05.csv, thickCord-C-06.csv, thickCord-C-15.csv, thickCord-C-17_3MFoilTape.csv, thinCord-A-01.csv]
2021-02-04 modified: GR-XX02/GearV2Main/2021.01_Rev.BManufacture/GearV2BottomBrushlessRevD.pcb modified: GR-XX02/GearV2Main/2021.01_Rev.BManufacture/GearV2BottomBrushlessRevD.sch new file: python/stock/StockLST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
    [GearV2BottomBrushlessRevD.pcb, GearV2BottomBrushlessRevD.sch]
2021-02-11 modified: GR-XX02/GearV2BatteryPack/2020.12_Manufacture/GB0102RevB.pcb modified: GR-XX02/GearV2BatteryPack/2020.12_Manufacture/GB0102RevB.sch deleted: GR-XX02/GearV2Main/2021.01_Rev.BManufacture/Gear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
    [GB0102RevB.pcb, GB0102RevB.sch, GearV2BottomBrushlessRevD.pcb, GearV2BottomBrushlessRevD.sch, GearV2MainRevC.pcb, GearV2MainRevC.sch, GearV2MainTestJigRevA.pcb, GearV2MainTestJigRevA.sch]
2021-03-12 modified: BG-XX01/2020.10.19Manufacture/BridgeMainRev.C.pcb modified: GR-XX02/GearV2BatteryPack/2020.12_Manufacture/GB0102RevB.pcb modified: GR-XX02/GearV2BatteryPack/2020.12_Manufacture/GB0102RevB.s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
    [BridgeMainRev.C.pcb, GB0102RevB.pcb, GB0102RevB.sch, GearV2TopRevA.pcb]
2021-03-26 modified: BG-XX01/2020.10.19Manufacture/BridgeMainRev.C.pcb new file: BG-XX01/2021.01PilotProduction/BridgeV1MainTestJigRevA.sch new file: GR-XX02/GearV2BatteryPack/2020.12_Manufacture/BatteryPackTes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
    [BatteryPackTestJigRevA.sch, BridgeMainRev.C.pcb, BridgeV1MainTestJigRevA.sch, GB0102InsertRev.D.pcb, GB0102InsertRev.E.pcb, GB0102RevB.pcb, GB0102RevB.sch, GearV2BottomBrushlessRevB.pcb]
2021-03-26 modified: BG-XX01/2020.10.19Manufacture/BridgeMainRev.C.pcb renamed: BG-XX01/2021.01PilotProduction/BridgeMainRev.C.sch -> BG-XX01/2021.03.23PilotProduction/BridgeMainRev.C.sch renamed: BG-XX01/2021.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
    [BatteryPackTestJigRevA.sch, BridgeMainRev.C.pcb, BridgeMainRev.C.sch, BridgeV1MainTestJigRevA.sch, GB0102InsertRev.D.pcb, GB0102InsertRev.E.pcb, GB0102RevB.pcb, GB0102RevB.sch]
2021-03-26 new file: CADModels/Chips/NCV8170AXV330T2G.STEP new file: CADModels/Connectors/CFE Pogo Pin Asembly.STEP new file: GR-XX02/GearV2BatteryPack/Simulation/MFP.asc
    [CFE Pogo Pin Asembly.STEP, NCV8170AXV330T2G.STEP]
2021-03-29 modified: BG-XX01/2021.04Manufacture/BridgeV1MainTestJigRevA.sch modified: GR-XX02/GearV2Main/2021.04._Rev.CManufacture/GearV2BottomTestJigRevA.sch modified: GR-XX02/GearV2Main/2021.04._Rev.CManufact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
    [BridgeV1MainTestJigRevA.sch, GearV2BottomTestJigRevA.sch, GearV2MainTestJigRevA.pcb, GearV2MainTestJigRevA.sch]
2021-03-29 new file: BG-XX01/2021.04Manufacture/BridgeMainTestJigRevA.pcb
    [BridgeMainTestJigRevA.pcb]
2021-04-16 new file: GR-XX02/GearV2Main/2021.03.17_Rev.CManufacture/GearV2BottomRevD.pcb new file: GR-XX02/GearV2Main/2021.04._Rev.CManufacture/GearV2BottomRevE.pcb renamed: GR-XX02/GearV2Main/2021.03.17_Rev.CM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
    [GearV2BottomBrushlessRevD.sch, GearV2BottomRevD.pcb, GearV2BottomRevE.pcb, GearV2BottomRevE.sch, GearV2BottomTestJigRev.A.pcb, GearV2PullyARevC.pcb, GearV2PullyARevD.pcb, MotorEnclosureTestJigRevA.pcb]
2021-04-16 new file: GR-XX02/GearV2Main/2021.03.17_Rev.CManufacture/GearV2BottomRevD.sch
    [GearV2BottomRevD.sch]
2021-05-03 modified: BG-XX01/2020.10.19Manufacture/BridgeMainRev.C.pcb modified: BG-XX01/2021.04Manufacture/BridgeMainTestJigRevA.pcb modified: BG-XX01/2021.04Manufacture/BridgeV1MainTestJigRevA.sch modified: G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
    [BridgeMainRev.C.pcb, BridgeMainTestJigRevA.pcb, BridgeV1MainTestJigRevA.sch, GearV2BottomTestJigRev.A.pcb, GearV2BottomTestJigRevA.sch, GearV2MainTestJigRevA.pcb, GearV2MainTestJigRevA.sch, MotorEnclosureTestJigRevA.pcb]
2021-05-04 modified: BG-XX01/2019.08.23Manufacture/BridgeMainRev.A.sch modified: BG-XX01/2020.05.21Manufacture/BridgeMainRev.B.sch modified: BG-XX01/2020.10.19Manufacture/BridgeMainRev.C.sch deleted: BG-XX01/20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
    [AdapterInsertRev.A.sch, AdapterInsertRev.B.sch, BatteryPackBottomRev.A.sch, BatteryPackBottomRev.B.sch, BatteryPackFlxCabRev.A.sch, BatteryPackFrontRev.A.sch, BatteryPackFrontRev.B.sch, BatteryPackInsertRev.A.sch]
2021-05-04 new file: BG-XX01/2020.10.19Manufacture/BridgeMainRev.Ctestpoints.pcb new file: BG-XX01/2021.03.23PilotProduction/BridgeMainRev.C.1.sch new file: CADModels/Chips/User Library-xdfn.STEP new file: CADM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
    [1825027-8-g-3d.stp, 2-644803-4.stp, BatteryPackSimpleTestJig.pcb, BatteryPackTestJigRevA.1.sch, BatteryPackTestJigRevA.pcb, BatteryPackTestJigRevA.sch, BridgeMainRev.C.1.sch, BridgeMainRev.Ctestpoints.pcb]
2021-05-04 deleted: BG-XX01/2020.05.21Manufacture/Firmware/Bridge_FCCTest.zip renamed: BG-XX01/2021.04Manufacture/BridgeMainTestJigRevA.pcb -> BG-XX01/2021.04.22Manufacture/BridgeMainTestJigRevA.pcb renamed: BG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
    [BatteryPackFlxCabRev.A.sch, BatteryPackSimpleTestJig.pcb, BatteryPackTestJigRevA.1.pcb, BatteryPackTestJigRevA.1.sch, BatteryPackTestJigRevA.pcb, BatteryPackTestJigRevA.sch, BridgeMainTestJigRevA.pcb, BridgeV1MainTestJigRevA.sch]
2021-09-21 folder orgnized
    [052350-9R Axis Apollo Calculation.ods, 052350-9R Axis Apollo Controller.pcb, 052350-9R Axis Apollo Main Schematic.sch, 052355-9 Axis Apollo Proximity PCB.pcb, 052355-9 Axis Apollo Proximity PCB.sch, 052355-9G Axis Apollo Proximity PCB BOM.xlsx, 052357-9 Encoder.pcb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]
2021-09-21 deleted: BG-XX01/2019.08.23Manufacture/BridgeMainRev.A.pcb deleted: BG-XX01/2019.08.23Manufacture/BridgeMainRev.A.sch deleted: BG-XX01/2020.05.21Manufacture/BridgeMainRev.B.pcb
    deleted: BG-XX01/2020.05.21Manufacture/BridgeMainRev.B.sch
    deleted: BG-XX01/2020.05.21Manufacture/Firmware/UartEcho&LEDTestOfBLE.Rev.B.zip
    deleted: BG-XX01/2020.10.19Manufacture/BridgeMainRev.C.pcb
    deleted: BG-XX01/2020.10.19Manufacture/BridgeMainRev.C.sch
    deleted: BG-XX01/2020.10.19Manufacture/BridgeMainRev.Ctestpoints.pcb
    deleted: BG-XX01/2021.03.23PilotProduction/BridgeMainRev.C.1.sch
    deleted: BG-XX01/2021.04.22Manufacture/BridgeMainTestJigRevA.pcb
    deleted: BG-XX01/2021.04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
    [052350-9R Axis Apollo Calculation.ods, 052350-9R Axis Apollo Controller.pcb, 052350-9R Axis Apollo Main Schematic.sch, 052355-9 Axis Apollo Proximity PCB.pcb, 052355-9 Axis Apollo Proximity PCB.sch, 052355-9G Axis Apollo Proximity PCB BOM.xlsx, 052357-9 Encoder.pcb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]
2021-09-21 renamed: BR0101/2019.08.23Manufacture/BridgeMainRev.A.pcb -> BR0101/2019.08.23_Rev.A_Manufacture/BR0101_Rev.A.pcb renamed: BR0101/2019.08.23Manufacture/BridgeMainRev.A.sch -> BR0101/2019.08.23_Rev.A_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
    [BR0101_Rev.A.pcb, BR0101_Rev.A.sch, BR0101_Rev.B.pcb, BR0101_Rev.B.sch, BR0101_Rev.C.1.sch, BR0101_Rev.C.pcb, BR0101_Rev.C.sch, BridgeMainRev.Ctestpoints.pcb]
2021-09-21 new file: BR0101/2020.10.19_Rev.C_Manufacture/BR0101_Rev.C_Testpoints.pcb renamed: BR0101/2021.04.22_JigsRev.A_Manufacture/TJ-BR0101_RevA.pcb -> BR0101/2021.04.22_TestJigsRev.A_Manufacture/TJ-BR0101_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
    [BR0101_Rev.C_Testpoints.pcb, BatteryPackRevDShield.DWG, BatteryPackRevDShield.STEP, GB0102-INSERT_Rev.A.pcb, GB0102-INSERT_Rev.A.sch, GB0102-INSERT_Rev.D.pcb, GB0102-INSERT_Rev.E.1.pcb, GB0102-INSERT_Rev.E.pcb]
2021-12-17 modified: GB0102/2021.08_Rev.D_Manufacture/GB0102-INSERT_Rev.F.pcb modified: GB0102/2021.08_Rev.D_Manufacture/GB0102_RevD.pcb modified: GB0102/2021.08_Rev.D_Manufacture/GB0102_RevD.sch deleted: Lib.s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
    [GB0102-INSERT_Rev.F.pcb, GB0102_RevD.pcb, GB0102_RevD.sch, Lib.sch, pi_gpio.cfg]
2022-01-10 new file: BLEModule/BLEModule.pcb new file: BLEModule/BLEModule.sch new file: BLEModule/nRF52840Pinout.csv new file: WIFIModule/NetworkModule.sch new file: WIFIModule/Sim/SI/MT47H32M16NF-25E_hspice.z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
    [BLEModule.pcb, BLEModule.sch, NetworkModule.sch, W971GG6KBpinout.csv, mt7688pinout.csv, nRF52840Pinout.csv]
2022-01-28 deleted: BLEModule/BLEModule.pcb deleted: BLEModule/BLEModule.sch deleted: BLEModule/nRF52840Pinout.csv modified: BR0101/2021.03.23_Rev.C.1_PilotProduction/BR0101_Rev.C.1.sch deleted: WIFIModule/Netw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
    [BLEModule.pcb, BLEModule.sch, BR0101_Rev.C.1.sch, NetworkModule.sch, W971GG6KBpinout.csv, mt7688pinout.csv, nRF52840Pinout.csv, pi_gpio.cfg]
2022-01-28 new file: BLE0101/2.4GAntenna/InvertedF.aedt new file: BLE0101/2.4GAntenna/MeanderedInvertedF.aedt new file: BLE0101/BLEModule.pcb new file: BLE0101/BLEModule.sch new file: BLE0101/Docs/nRF52840Pinou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
    [BLEModule.pcb, BLEModule.sch, NetworkModule.sch, W971GG6KBpinout.csv, mt7688pinout.csv, nRF52840Pinout.csv]
2022-01-31 modified: BLE0101/2.4GAntenna/MeanderedInvertedF.aedt modified: BLE0101/BLEModule.pcb modified: BLE0101/BLEModule.sch
    [BLEModule.pcb, BLEModule.sch]
2022-02-01 modified: BLE0101/BLEModule.pcb modified: BLE0101/BLEModule.sch
    [BLEModule.pcb, BLEModule.sch]
2022-02-01 new file: BR0101/2021.09.07_Rev.C.2_Manufacture/BR0101_Rev.C.2.pcb new file: BR0101/2021.09.07_Rev.C.2_Manufacture/BR0101_Rev.C.3.pcb new file: CADModels/Chips/NRF52840-QIAA-R.STEP new file: CADModel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
    [BM05B-ADHKS-GAN-ETB(HF).STEP, BR0101_Rev.C.2.pcb, BR0101_Rev.C.3.pcb, GB0102-INSERT_Rev.F.1.pcb, NRF52840-QIAA-R.STEP, W971GG6KB.step, WBGA-84.step, res_1812.stp]
2022-02-01 modified: BLE0101/BLEModule.pcb modified: BLE0101/BLEModule.sch modified: BR0101/2021.03.23_Rev.C.1_PilotProduction/BR0101_Rev.C.1.sch deleted: BR0101/2021.09.07_Rev.C.2_Manufacture/BR0101_Rev.C.2.pc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
    [BLEModule.pcb, BLEModule.sch, BR0101_Rev.C.1.sch, BR0101_Rev.C.2.pcb, BR0101_Rev.C.3.pcb]
2022-02-01 new file: BR0101/2021.09.07_Rev.C.3_Manufacture/BR0101_Rev.C.2.pcb new file: BR0101/2021.09.07_Rev.C.3_Manufacture/BR0101_Rev.C.3.pcb
    [BR0101_Rev.C.2.pcb, BR0101_Rev.C.3.pcb]
2022-02-02 modified: BLE0101/BLEModule.pcb modified: BLE0101/BLEModule.sch new file: GR0102/2022.02.02_BottomRev.EManufacture/GR0102-BOTTOM_Rev.E.pcb new file: GR0102/2022.02.02_BottomRev.EManufacture/GR0102-BO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
    [BLEModule.pcb, BLEModule.sch, GR0102-BOTTOM_Rev.E.pcb, GR0102-BOTTOM_Rev.E.sch]
2022-02-02 modified: BLE0101/BLEModule.pcb modified: BLE0101/BLEModule.sch modified: GR0102/2022.02.02_BottomRev.EManufacture/GR0102-BOTTOM_Rev.E.sch new file: SC0101/2020.02/Encoder.pcb new file: SC0101/2020.0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
    [BLEModule.pcb, BLEModule.sch, Encoder.pcb, Encoder.sch, GR0102-BOTTOM_Rev.E.sch]
2022-02-09 modified: BLE0101/BLEModule.pcb modified: BLE0101/BLEModule.sch deleted: NW0101/Docs/Jlink by RaspberryPi/pi_gpio.cfg.txt
    [BLEModule.pcb, BLEModule.sch]
2022-02-11 modified: ../BLE0101/BLEModule.sch modified: NetworkModule.sch new file: NetworkModule_tmp.pcb
    [BLEModule.sch, NetworkModule.sch, NetworkModule_tmp.pcb]
2022-02-22 new file: NW0101.PrjPcb/NetworkModule.PcbDoc new file: NetworkModule.pcb modified: NetworkModule_tmp.pcb
    [NetworkModule.PcbDoc, NetworkModule.pcb, NetworkModule_tmp.pcb]
2022-02-22 modified: ../BLE0101/BLEModule.pcb modified: ../BLE0101/BLEModule.sch new file: NW0101.PrjPcb/ETH_JTAG_SD.SchDoc new file: NW0101.PrjPcb/INTERFACE.SchDoc new file: NW0101.PrjPcb/MEMORY.SchDoc new fil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
    [BLEModule.pcb, BLEModule.sch, ETH_JTAG_SD.SchDoc, INTERFACE.SchDoc, MEMORY.SchDoc, MISC.SchDoc, NetworkModule.PcbDoc, NetworkModule.PrjPcb]
2022-02-23 modified: BLE0101/BLEModule.pcb modified: NW0101/NW0101.PrjPcb/NetworkModule.PcbDoc modified: NW0101/NW0101.PrjPcb/NetworkModule.PrjPcb deleted: NW0101/NW0101.PrjPcb/NetworkModule_highspeed V3.PcbDoc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
    [BLEModule.pcb, NetworkModule.PcbDoc, NetworkModule.PrjPcb, NetworkModule.pcb, NetworkModule_highspeed V3.PcbDoc]
2022-02-24 modified: NW0101/NetworkModule.pcb
    [NetworkModule.pcb]
2022-02-24 modified: NW0101/NW0101.PrjPcb/NetworkModule.PcbDoc modified: NW0101/NW0101.PrjPcb/NetworkModule.PrjPcb modified: NW0101/NetworkModule.pcb modified: NW0101/NetworkModule.sch
    [NetworkModule.PcbDoc, NetworkModule.PrjPcb, NetworkModule.pcb, NetworkModule.sch]
2022-03-02 modified: NW0101/NW0101.PrjPcb/ETH_JTAG_SD.SchDoc modified: NW0101/NW0101.PrjPcb/MEMORY.SchDoc modified: NW0101/NW0101.PrjPcb/MISC.SchDoc modified: NW0101/NW0101.PrjPcb/NetworkModule.PcbDoc modified: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
    [ETH_JTAG_SD.SchDoc, MEMORY.SchDoc, MISC.SchDoc, NetworkModule.PcbDoc, NetworkModule.PrjPcb, NetworkModule.pcb, NetworkModule_highspeed V4.PcbDoc, POWER.SchDoc]
2022-03-03 modified: NW0101/NW0101.PrjPcb/NetworkModule.PcbDoc modified: NW0101/NW0101.PrjPcb/NetworkModule.PrjPcb modified: NW0101/NW0101.PrjPcb/WIFI.SchDoc
    [NetworkModule.PcbDoc, NetworkModule.PrjPcb, WIFI.SchDoc]
2022-03-03 modified: NW0101/NW0101.PrjPcb/MEMORY.SchDoc modified: NW0101/NW0101.PrjPcb/MISC.SchDoc modified: NW0101/NW0101.PrjPcb/NetworkModule.PcbDoc modified: NW0101/NW0101.PrjPcb/NetworkModule.PrjPcb modifie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
    [MEMORY.SchDoc, MISC.SchDoc, NetworkModule.PcbDoc, NetworkModule.PrjPcb, POWER.SchDoc]
2022-03-07 modified: BLE0101/BLEModule.pcb modified: GR0102/2022.02.02_BottomRev.EManufacture/GR0102-BOTTOM_Rev.E.pcb modified: GR0102/2022.02.02_BottomRev.EManufacture/GR0102-BOTTOM_Rev.E.sch modified: NW0101/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
    [BLEModule.pcb, GR0102-BOTTOM_Rev.E.pcb, GR0102-BOTTOM_Rev.E.sch, NetworkModule.PcbDoc, NetworkModule.PrjPcb]
2022-03-09 new file: BLE0101/BLEModule_Rev.A.1.pcb renamed: BLE0101/BLEModule.sch -> BLE0101/BLEModule_Rev.A.1.sch renamed: BLE0101/BLEModule.pcb -> BLE0101/BLEModule_Rev.A.2.pcb new file: BLE0101/BLEModule_Rev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
    [BLEModule.pcb, BLEModule.sch, BLEModule_Rev.A.1.pcb, BLEModule_Rev.A.1.sch, BLEModule_Rev.A.2.pcb, BLEModule_Rev.A.2.sch, NetworkModule.PcbDoc, NetworkModule.PrjPcb]
2022-03-09 modified: BLE0101/BLEModule_Rev.A.2.pcb modified: BLE0101/BLEModule_Rev.A.2.sch
    [BLEModule_Rev.A.2.pcb, BLEModule_Rev.A.2.sch]
2022-03-10 modified: BLE0101/BLEModule_Rev.A.2.pcb modified: NW0101/NW0101.PrjPcb/NetworkModule.PcbDoc modified: NW0101/NW0101.PrjPcb/NetworkModule.PrjPcb
    [BLEModule_Rev.A.2.pcb, NetworkModule.PcbDoc, NetworkModule.PrjPcb]
2022-03-10 renamed: BLEModule_Rev.A.1.pcb -> 2022.02.25_Rev.A.1_Manufacture/BLEModule_Rev.A.1.pcb renamed: BLEModule_Rev.A.1.sch -> 2022.02.25_Rev.A.1_Manufacture/BLEModule_Rev.A.1.sch renamed: BLEModule_Rev.A.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
    [BLEModule_Rev.A.1.pcb, BLEModule_Rev.A.1.sch, BLEModule_Rev.A.2.pcb, BLEModule_Rev.A.2.sch]
2022-03-10 renamed: NW0101/NW0101.PrjPcb/ETH_JTAG_SD.SchDoc -> NW0101/2022.03_Rev.A_Manufacture/ETH_JTAG_SD.SchDoc renamed: NW0101/NW0101.PrjPcb/INTERFACE.SchDoc -> NW0101/2022.03_Rev.A_Manufacture/INTERFACE.Sc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
    [ETH_JTAG_SD.SchDoc, INTERFACE.SchDoc, MEMORY.SchDoc, MISC.SchDoc, NetworkModule.PcbDoc, NetworkModule.PrjPcb, NetworkModule.pcb, NetworkModule.sch]
2022-03-11 new file: NW0101/2022.03_ProgramingJigManufacture/TJ-NW0101_RevA.sch
    [TJ-NW0101_RevA.sch]
2022-03-15 modified: 2.4GAntenna/MeanderedInvertedF.aedt renamed: 2022.02.25_Rev.A.1_Manufacture/BLEModule_Rev.A.1.pcb -> 2022.02.25_Rev.A_Manufacture/BLEModule_Rev.A.1.pcb renamed: 2022.02.25_Rev.A.1_Manufactu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
    [BLEModule_Rev.A.1.pcb, BLEModule_Rev.A.1.sch, BLEModule_Rev.A.2.pcb, BLEModule_Rev.B.pcb, BLEModule_Rev.B.sch, BR0101_Rev.C.1.sch, TJ-NW0101_RevA.sch]
2022-03-15 modified: BLE0101/2022.03_Rev.B_Manufacture/BLEModule_Rev.B.pcb modified: NW0101/2022.03_Rev.A_Manufacture/MISC.SchDoc modified: NW0101/2022.03_Rev.A_Manufacture/NetworkModule.PcbDoc
    [BLEModule_Rev.B.pcb, MISC.SchDoc, NetworkModule.PcbDoc]
2022-03-16 modified: NW0101/2022.03_Rev.A_Manufacture/MEMORY.SchDoc modified: NW0101/2022.03_Rev.A_Manufacture/MISC.SchDoc modified: NW0101/2022.03_Rev.A_Manufacture/NetworkModule.PcbDoc modified: NW0101/2022.0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
    [MEMORY.SchDoc, MISC.SchDoc, NetworkModule.PcbDoc, POWER.SchDoc, USB_PCIE.SchDoc]
2022-03-17 modified: NW0101/2022.03_Rev.A_Manufacture/ETH_JTAG_SD.SchDoc modified: NW0101/2022.03_Rev.A_Manufacture/INTERFACE.SchDoc modified: NW0101/2022.03_Rev.A_Manufacture/MEMORY.SchDoc modified: NW0101/202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
    [ETH_JTAG_SD.SchDoc, INTERFACE.SchDoc, MEMORY.SchDoc, MISC.SchDoc, NetworkModule.PcbDoc, POWER.SchDoc, USB_PCIE.SchDoc, WIFI.SchDoc]
2022-03-18 modified: GR0102/2022.02.02_BottomRev.EManufacture/GR0102-BOTTOM_Rev.E.pcb new file: GR0102/2022.03_TopRev.BManufacture/GR0102-PULLYA_Rev.E.pcb new file: GR0102/2022.03_TopRev.BManufacture/GR0102-TOP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
    [GR0102-BOTTOM_Rev.E.pcb, GR0102-PULLYA_Rev.E.pcb, GR0102-TOP_Rev.B.pcb, GR0102-TOP_Rev.B.sch, NetworkModule.PcbDoc]
2022-03-18 modified: GR0102/2022.03_TopRev.BManufacture/GR0102-PULLYA_Rev.E.pcb modified: NW0101/2022.03_Rev.A_Manufacture/MEMORY.SchDoc modified: NW0101/2022.03_Rev.A_Manufacture/MISC.SchDoc deleted: NW0101/20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
    [GR0102-PULLYA_Rev.E.pcb, MEMORY.SchDoc, MISC.SchDoc, NetworkModule.PcbDoc]
2022-03-18 new file: NW0101/2022.03_Rev.A_Manufacture/PCB-NW0101 Rev.A.PcbDoc
    [PCB-NW0101 Rev.A.PcbDoc]
2022-03-22 modified: GR0102/2022.03_TopRev.BManufacture/GR0102-PULLYA_Rev.E.pcb modified: NW0101/2022.03_ProgramingJigManufacture/TJ-NW0101_RevA.sch modified: NW0101/2022.03_Rev.A_Manufacture/PCB-NW0101 Rev.A.P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
    [GR0102-PULLYA_Rev.E.pcb, PCB-NW0101 Rev.A.PcbDoc, TJ-NW0101_RevA.sch]
2022-04-04 modified: BLE0101/2022.02.25_Rev.A_Manufacture/BLEModule_Rev.A.1.sch modified: BR0101/2021.03.23_Rev.C.1_PilotProduction/BR0101_Rev.C.1.sch
    [BLEModule_Rev.A.1.sch, BR0101_Rev.C.1.sch]
2022-04-19 modified: BLE0101/2022.02.25_Rev.A_Manufacture/BLEModule_Rev.A.1.sch new file: BLE0101/2022.03_Rev.B_Manufacture/BLEModule_Rev.C.pcb modified: BLE0101/2022.04_R&DTestJig_Rev.A_Manufacture/TJ-BLE0101_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
    [3020-20-0200-00.igs, BLEModule_Rev.A.1.sch, BLEModule_Rev.C.pcb, PCB-NW0101 Rev.A.2.PcbDoc, TJ-BLE0101_RevA.pcb, TJ-NW0101_RevA.pcb, TJ-NW0101_RevA.sch]
2022-04-20 modified: BLE0101/2022.03_Rev.B_Manufacture/BLEModule_Rev.C.pcb renamed: NW0101/2022.03_Rev.A_Manufacture/PCB-NW0101 Rev.A.2.PcbDoc -> NW0101/2022.04_Rev.B_Manufacture/PCB-NW0101 Rev.B.PcbDoc
    [BLEModule_Rev.C.pcb, PCB-NW0101 Rev.A.2.PcbDoc, PCB-NW0101 Rev.B.PcbDoc]
2022-05-18 deleted: BLE0101/2022.03_Rev.B_Manufacture/BLEModule_Rev.C.pcb modified: NW0101/2022.03_ProgramingJigManufacture/TJ-NW0101_RevA.pcb modified: NW0101/2022.03_ProgramingJigManufacture/TJ-NW0101_RevA.sc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
    [BLEModule_Rev.C.pcb, PCB-NW0101 Rev.B.PcbDoc, TJ-NW0101_RevA.pcb, TJ-NW0101_RevA.sch]
2022-06-01 deleted: BLE0101/2022.04_R&DTestJig_Rev.A_Manufacture/TJ-BLE0101_RevA.pcb deleted: BLE0101/2022.04_R&DTestJig_Rev.A_Manufacture/TJ-BLE0101_RevA.sch deleted: NW0101/2022.03_ProgramingJigManufacture/TJ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
    [ETH_JTAG_SD.SchDoc, INTERFACE.SchDoc, MEMORY.SchDoc, MISC.SchDoc, NetworkModule.sch, PCB-NW0101 Rev.A.PcbDoc, PCB-NW0101 Rev.B.PcbDoc, POWER.SchDoc]
2022-06-23 deleted: BLE0101/2022.06_TestJig_Rev.A_Manufacture/LogFiles/3DModels.log deleted: BLE0101/2022.06_TestJig_Rev.A_Manufacture/TJ-BLE0101_RevA.pcb deleted: BLE0101/2022.06_TestJig_Rev.A_Manufacture/TJ-B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
    [BR0101_Rev.C.1.sch, TJ-BLE0101_RevA.pcb, TJ-BLE0101_RevA.sch, TJ-NW0101_RevA.pcb]
2022-09-12 modified: BLE0101/2022.04.27_Rev.C_Manufacture/BLEModule_Rev.C.pcb new file: BLE0101/2022.04.27_Rev.C_Manufacture/TestResult_BLE0101(No Match Network)_Bridge.jpg new file: BLE0101/2022.04.27_Rev.C_Ma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
    [10147606-2p.stp, 5055670281.stp, BLEModule_Rev.C.pcb, BR0101_Rev.C.1.sch, ETH_JTAG_SD.SchDoc, Encoder.pcb, Encoder.sch, GT010A-MAIN_Rev.A.sch]
2022-09-27 modified: GR0102/2020.10.30_Rev.BManufacture/GR0102-MAIN_Rev.B.sch modified: GR0102/2021.03.17_Rev.CManufacture/GR0102-MAIN_Rev.C.sch deleted: NW0101/2022.05.18_Jlink/Doc/.~lock.How to Make a J-LINK 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
    [GR0102-MAIN_Rev.B.sch, GR0102-MAIN_Rev.C.sch, SC0101-MAIN_Rev.A.pcb, SC0101-MAIN_Rev.A.sch, SC010A-MAIN_Rev.A.sch, TJ-NW0101_RevB.pcb, TJ-NW0101_RevB.sch]
2022-10-19 modified: SC0101/2022.06_Rev.A/SC0101-MAIN_Rev.A.pcb modified: SC0101/2022.06_Rev.A/SC0101-MAIN_Rev.A.sch
    [SC0101-MAIN_Rev.A.pcb, SC0101-MAIN_Rev.A.sch]
2022-11-22 new file: BLE0101/2022.04.27_Rev.C_Manufacture/MatchNetwork_BLE0101_SmartShade.jpg new file: CADModels/Chips/DFN10_NXP.step new file: CADModels/Chips/dfn10.stp new file: CADModels/Connectors/66530412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
    [665304124022_Download_STP_665304124022_rev1.stp, BM02B-PASS-1-TFT_LF_SN_eec.STEP, BM02B-PASS-TFT_LF__SN_.stp, BM02B-SRSS-TB_LF__SN_.stp, BM04B-SRSS-TB-LF--SN---3DModel-STEP-56544.STEP, BM05B-PASS-TFT_LF_SN_eec.STEP, DFN10_NXP.step, ETH_JTAG_SD.SchDoc]
2022-12-10 new file: BLE0101/2022.12_Rev.D_Manufacture/PCB-BLE0101 Rev.D.pcb new file: BLE0101/2022.12_Rev.D_Manufacture/PCB-BLE0101 Rev.D.sch modified: BLE0101/ISSUE.txt modified: NW0101/2022.05.18_Jlink/MT768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
    [PCB-BLE0101 Rev.D.pcb, PCB-BLE0101 Rev.D.sch, PCB-SC0101 Rev.A.pcb, PCB-SC0101 Rev.A.sch, PCB-SC0101-SENSOR Rev.A.pcb, PCB-SC0101-SENSOR Rev.A.sch, TJ-NW0101_RevB.pcb]
2023-03-07 deleted: BLE0101/2022.04.27_Rev.C_Manufacture/MatchNetwork_BLE0101_SmartShade.jpg deleted: BLE0101/2022.04.27_Rev.C_Manufacture/TestResult_BLE0101(No Match Network)_Bridge.jpg deleted: BLE0101/2022.0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
    [BLE-0101_BOM.csv, CONN10_2x05_DRXN_SUL.step, GR0102-Dongle_Rev.A.pcb, GR0102-Dongle_Rev.A.sch, PCB-SC0101 Rev.A.sch, PCBA-NW0101_BOM.csv, Remote_Rev.A.sch, SH-10.2MM9.8MM1.4MM-AL 3D Rev.A.STEP]
2023-05-30 modified: BLE0101/Docs/Certification/BLE-0101 Application Sheet.doc modified: BLE0101/Docs/Certification/BLE-0101 Datasheet V1.0.pdf modified: BLE0101/Docs/Certification/org/BLE-0101 Datasheet V1.0.d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
    [74033000.CSV, 74033001.CSV, 74033002.CSV, 74033003.CSV, DryContact Rev.A.pcb, DryContact_Rev.A.sch, GR0102-BOTTOM_Rev.F.pcb, GR0102-BOTTOM_Rev.F.sch]
2023-06-06 modified: BLE0101/2022.04.27_Rev.C_Manufacture/BLEModule_Rev.C.pcb modified: BLE0101/2022.12_Rev.D_Manufacture/PCB-BLE0101 Rev.D.pcb new file: BLE0101/Docs/Certification/PCB-BLE0101 Rev.C_Antenna.pdf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
    [1824440000.stp, 230209-RemoteController-Rev01.STEP, B04B-PASK-1.step, BLEModule_Rev.C.pcb, BM02B-NSHSS-TBT.STEP, BM04B-NSHSS-TBT.STEP, DC-0101 Rev.A.pcb, DC-0101 Rev.A.sch]
2023-06-06 modified: RC0101&DC0101/2023.02_Rev.A/DC-0101 Rev.A.pcb modified: RC0101&DC0101/2023.02_Rev.A/RC-0101 Rev.A.pcb modified: RC0101&DC0101/2023.02_Rev.A/RC-0101 Rev.A.sch
    [DC-0101 Rev.A.pcb, RC-0101 Rev.A.pcb, RC-0101 Rev.A.sch]
2023-06-28 new file: .gitignore new file: CADModels/Chips/DMR0004A.stp new file: GR0102/2023.02.27_Dongle/questions.txt new file: NW0101/2022.07_Rev.B&C_Manufacture/NetworkModule.PrjPcb new file: NW0101/2022.07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
    [DC-0101 Rev.A.pcb, DC-0101 Rev.A.sch, DMR0004A.stp, NetworkModule.PrjPcb, PCB-SC0101 Rev.B.pcb, PCB-SC0101 Rev.B.sch, PCB-SC0101-SENSOR Rev.B.pcb, PCB-SC0101-SENSOR Rev.B.sch]
2023-07-24 modified: .gitignore deleted: BLE0101/2022.06.23_TestJig_Rev.A_Manufacture/BLE0101 Test fixture firmware.hex deleted: BLE0101/Docs/Drawing/BLE0101_Socket_3D Location Drawing.pdf deleted: BLE0101/Docs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
    [DC-0101 Rev.A.pcb, PCB-SC0101 Rev.B.pcb, PCB-SC0101 Rev.B.sch, PCB-SC0101-SENSOR Rev.B.pcb, PCB-SC0101-SENSOR Rev.B.sch, RC-0101 Rev.A_tmp.pcb, SH-10.2MM9.8MM1.4MM-AL 3D Rev.A.STEP]
2023-08-02 modified: SC0101/2022.06_Rev.A/PCB-SC0101 Rev.A.pcb modified: SC0101/2023.06_Rev.B/PCB-SC0101 Rev.B.pcb modified: SC0101/2023.06_Rev.B/PCB-SC0101 Rev.B.sch
    [PCB-SC0101 Rev.A.pcb, PCB-SC0101 Rev.B.pcb, PCB-SC0101 Rev.B.sch]
2024-01-03 new file: BLE0101/BLE0101 Test fixture firmware.hex new file: BLE0101/Docs/BLE0101_Socket_3D Location Drawing.pdf new file: BLE0101/Docs/Shield/SH-10.2MM9.8MM1.4MM-AL 2D Rev.A.pdf new file: BLE0101/D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
    [231107-PCB.STEP, DC-0101 Rev.B.pcb, DC-0101 Rev.B.sch, DRV5012AEDMRT.stp, GR0102-BOTTOM_Rev.G.sch, PCB-SC0101 Rev.A.pcb, PCB-SC0101 Rev.B.pcb, PCB-SC0101 Rev.B.sch]
2024-01-10 modified: RC0101&DC0101/2024.01_Rev.B/DC-0101 Rev.B.pcb modified: RC0101&DC0101/2024.01_Rev.B/DC-0101 Rev.B.sch modified: RC0101&DC0101/2024.01_Rev.B/RC-0101 Rev.B.pcb modified: RC0101&DC0101/2024.01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
    [DC-0101 Rev.B.pcb, DC-0101 Rev.B.sch, RC-0101 Rev.B.pcb, RC-0101 Rev.B.sch]
2024-01-15 modified: RC0101&DC0101/2024.01_Rev.B/RC-0101 Rev.B.pcb
    [RC-0101 Rev.B.pcb]
2024-01-24 modified: RC0101&DC0101/2023.02_Rev.A/DC-0101 Rev.A.pcb deleted: RC0101&DC0101/2023.02_Rev.A/ISSUE.txt modified: RC0101&DC0101/2024.01_Rev.B/RC-0101 Rev.B.pcb modified: RC0101&DC0101/2024.01_Rev.B/RC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
    [DC-0101 Rev.A.pcb, PCB-SC0101 Rev.B.sch, RC-0101 Rev.B.pcb, RC-0101 Rev.B.sch]
2024-01-31 modified: RC0101&DC0101/2024.01_Rev.B/RC-0101 Rev.B.pcb modified: RC0101&DC0101/2024.01_Rev.B/RC-0101 Rev.B.sch modified: RC0101&DC0101/Docs/image (1).png
    [RC-0101 Rev.B.pcb, RC-0101 Rev.B.sch]
2024-03-25 deleted: IMG_5707.MOV deleted: IPCJEDEC J-STD-033A(Moisture Sensitive Level).pdf modified: RC0101&DC0101/2024.01_Rev.B/DC-0101 Rev.B.pcb modified: SC0101/2023.06_Rev.B/PCB-SC0101 Rev.B.pcb deleted: S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
    [DC-0101 Rev.B.pcb, PCB-SC0101 Rev.B.pcb]
2024-03-25 new file: BLE0101/2024.03.13_RFtest/PCB-RFTEST Rev.A.pcb new file: BLE0101/2024.03.13_RFtest/PCB-RFTEST Rev.A.sch new file: Button/2024.03_Manufacture/Button Rev.A.pcb new file: Button/2024.03_Manufa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
    [Button Rev.A.pcb, Button Rev.A.sch, JB15FP.stp, PCB-RFTEST Rev.A.pcb, PCB-RFTEST Rev.A.sch]
2024-07-24 new file: CADModels/Connectors/10129378-902003BLF.STEP new file: CADModels/Connectors/CON2_1X2_TU_TSW.step new file: Fabric Tracker/2023.04.01_Rev.A/FabricTracker Rev.A.pcb new file: Fabric Tracker/2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
    [10129378-902003BLF.STEP, CON2_1X2_TU_TSW.step, FabricTracker Rev.A.pcb, FabricTracker_RevA.sch, GB0102-INSERT_Rev.F.1.pcb, GB0102-INSERT_Rev.F.pcb, PCB-SC0101 Rev.B.pcb, PCB-SC0101 Rev.C.pcb]
2024-08-21 modified: ../BR0101/2021.03.23_Rev.C.1_PilotProduction/BR0101_Rev.C.1.sch modified: ../Fabric Tracker/2023.04.01_Rev.A/FabricTracker Rev.A.pcb modified: ../Fabric Tracker/2023.04.01_Rev.A/FabricTrack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
    [BR0101_Rev.C.1.sch, FabricTracker Rev.A.pcb, FabricTracker_RevA.sch, GR0102-Dongle_Rev.A.pcb, PCB-SC0101 Rev.C.pcb]
2024-08-21 modified: .gitignore new file: CADModels/Chips/MMA8652FCR1.step new file: CADModels/Chips/VL53L0 3D Model.step new file: CADModels/Connectors/BS-2450.step new file: CADModels/Modules/ESP32-C3-WROOM-0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
    [BS-2450.step, ESP32-C3-WROOM-02-H4.step, MMA8652FCR1.step, PCB-000037 PCB-SC0101 Rev.C.1_BOM.csv, TJ-SC0101_Rev.B.pcb, TJ-SC0101_Rev.B.sch, TJ-zwave_Rev.A.pcb, TJ-zwave_Rev.A.sch]
2024-08-22 modified: GR0102/2021.07_Rev.DManufacture/GR0102-MAIN_Rev.D.sch modified: SC0101/2024.08_JigsRev.B_Manufacture/TJ-SC0101_Rev.B.pcb modified: SC0101/2024.08_JigsRev.B_Manufacture/TJ-SC0101_Rev.B.sch m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
    [GR0102-MAIN_Rev.D.sch, TJ-SC0101_Rev.B.pcb, TJ-SC0101_Rev.B.sch, TJ-zwave_Rev.A.pcb, TJ-zwave_Rev.A.sch, Z-WAVE-POGO-PIN MAP.xlsx]
2024-08-30 modified: Button/2024.03_Manufacture/Button Rev.A.sch new file: CADModels/Chips/KXTJ3-1057.step new file: CADModels/Connectors/395-010-559-212 - EDAC Card Edge Connector.STEP modified: Fabric Tracker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
    [395-010-559-212 - EDAC Card Edge Connector.STEP, Button Rev.A.sch, FabricTracker Rev.A.pcb, FabricTracker_RevA.sch, KXTJ3-1057.step, PCB-SC0101 Rev.C.pcb, PCB-SC0101-SENSOR Rev.B.pcb, RC-0101 Rev.B.sch]
2024-09-04 modified: Fabric Tracker/2023.04.01_Rev.A/FabricTracker Rev.A.pcb modified: Fabric Tracker/2023.04.01_Rev.A/FabricTracker_RevA.sch
    [FabricTracker Rev.A.pcb, FabricTracker_RevA.sch]
2024-09-04 new file: CADModels/Modules/ESP32-C3-MINI-1-N4.step new file: GR0102/Certification/Doc provided/BLE Fixed Frequence Test Instructions.pdf new file: SC0101/Certification/SmartShade Diagram.pdf
    [ESP32-C3-MINI-1-N4.step]
2024-10-10 new file: Fabric Tracker/fabrictracker_fw
    [GR0102-MAIN_Rev.D.sch, PCB-SC0101 Rev.C.sch, SmartShade BOM.csv]
2025-02-07 new file: CADModels/Connectors/UJC-HP2-3-SMT-TR.step deleted: Fabric Tracker/fabrictracker_fw new file: GB0102/2025.02_Rev.E_Manufacture/GB0102_RevE.pcb new file: GB0102/2025.02_Rev.E_Manufacture/GB0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
    [DC-0101 Rev.B.pcb, DC-0101 Rev.B.sch, FabricTracker Rev.A.pcb, FabricTracker_RevA.sch, GB0102_RevE.pcb, GB0102_RevE.sch, PCB-SC0101-SENSOR Rev.C.pcb, RC-0101 Rev.B.sch]
2025-04-29 modified: Button/2024.03_Manufacture/Button Rev.A.pcb modified: Button/2024.03_Manufacture/Button Rev.A.sch new file: Button/SmartButton V2 PCB.dxf new file: Button/smartbutton-plastic-parts-V3_PCBRe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
    [Button Rev.A.pcb, Button Rev.A.sch, CG-Lip-Tape-C-D.pcb, DRV8214.stp, FFC3B07-05-T.STEP, GB0102_RevE.pcb, GB0102_RevE.sch, GR0102-MAIN_Rev.D.sch]
2025-06-10 new file: Button/140525-SBv2Assy PCB-battery-clip-check-rev-1.DXF new file: Button/140525-SBv2Assy PCB-battery-clip-check-rev-1.DXF.STEP modified: Button/2024.03_Manufacture/Button Rev.A.pcb modified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
    [112TR.STEP, 122TR.STEP, 140525-SBv2Assy PCB-battery-clip-check-rev-1.DXF, 140525-SBv2Assy PCB-battery-clip-check-rev-1.DXF.STEP, BK-950.STEP, BM05B-SRSS-TB.STEP, Button Rev.A.pcb, Button Rev.A.sch]
2025-06-17 deleted: SB0101/2025.02.14/ElementsOnLayersReport.txt modified: SB0101/2025.02.14/PCB-SB0101 Rev.B.pcb modified: SB0101/2025.02.14/PCB-SB0101 Rev.B.sch modified: SB0101/2025.02.14/PCB-SB0101-BUTTON R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
    Changes not staged for commit:
    modified: GB0102/GB0102_firmware (modified content)
    mod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
    [PCB-SB0101 Rev.B.pcb, PCB-SB0101 Rev.B.sch, PCB-SB0101-BUTTON Rev.A.pcb, PCB-SB0101-BUTTON Rev.A.sch, PCB-SB0101-Encoder Rev.A.pcb, PCB-SB0101-Encoder Rev.A.sch, PCB-SB0101-LED Rev.A.pcb, PCB-SB0101-LED Rev.A.sch]
2025-06-18 modified: SB0101/2025.02.14/PCB-SB0101-BUTTON Rev.A.sch modified: SB0101/2025.02.14/PCB-SB0101-Encoder Rev.A.pcb modified: SB0101/2025.02.14/PCB-SB0101-Encoder Rev.A.sch
    modified: GR0101/EncoderTest (modified content, untracked content)
    modified: ZW0101/zwave_ft_program (modified content, untracked content)
    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
    [PCB-SB0101-BUTTON Rev.A.sch, PCB-SB0101-Encoder Rev.A.pcb, PCB-SB0101-Encoder Rev.A.sch]
2025-06-23 modified: PCB-SB0101-MOTOR Rev.B.pcb modified: PCB-SB0101-MOTOR Rev.B.sch
    modified: ../../GB0102/GB0102_firmware (modified content)
    modified: ../../GR0101/EncoderTest (modified content, untracked content)
    modified: ../../ZW0101/zwave_ft_program (modified content, untracked content)
    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
    [PCB-SB0101-MOTOR Rev.B.pcb, PCB-SB0101-MOTOR Rev.B.sch]
2026-03-16 new file: BLE0101/2022.02.25_Rev.A_Manufacture/BLEModule_Rev.A.1.sch
    [0.5K-DX-5PWB.stp, 052350-9R Axis Apollo Calculation.ods, 0805 LED.STEP, 10118194-0001LF.STEP, 103670-2-t-3d.stp, 112TR.STEP, 1824440000.stp, 1825027-8-g-3d.stp]
