binphilxiao/AxisLabs/(notices)

Notices in the files:
CADModels/Buttons/JF15RP2CC.stp:
author */ ('License CC BY-ND 4.0'),
